parkourlrc/pcb-yilv1982--duck-robot-89dbc81d6d/docs/schematics/README.md

# 已确认硬件原理图档案

> **2026-10-31 IMU 更新**：新制 v0.3 双口板已上线；AP2210 推荐输入上限 13.2V、绝对最大 15V，旧“只能 5V”说明已纠正。原厂手册、BOM 与 5V/7.4V 现象分析见[专题](../references/惯性单元输入电压复核/research.md)。

存放本项目在手硬件的原理图/设计源文件；**实物修订已对应与仅有同源参考须按每行依据区分**。每块板一个子目录，来源与版本钉死在上游提交。查证分析记录另见 `docs/references/`（那里保留研究过程，这里只放权威文件副本）。

| 子目录 | 硬件 | 确认依据 | 权威文件 | 上游来源与版本 |
|---|---|---|---|---|
| `imu-to-dxl-scrapmeta-v0.3/` | 绿色 IMU 板（imu_to_dxl v0.3，32×22mm，STM32G031F8P6 + LSM6DSV16X） | 2026-10-09 用户确认对应 [ScrapMeta/microduck-diy](https://github.com/ScrapMeta/microduck-diy/tree/main/imu_to_dxl) | `*.eprj2`（嘉立创EDA专业版工程，真源） | `main @ aa4c32d`（hardware/ 最后改动，2026-09-10）；MIT |
| `microduck-hat-v1.0-sch/` | 白色鸭图案 HAT（实物丝印 **V1.2**，2026-10-10 照片更正；Radxa Zero / Pi Zero 形态） | 2026-10-09 用户供图并确认 | `SCH_..._2026-10-06.pdf`（5 页原理图，图版本 **V1.0**） | 社区改绘版（嘉立创EDA，原理图 V1.0，2026-09-03~09-20）；派生自官方 pollen-robotics/elec_RPI_Robot_HAT（Apache-2.0）。⚠️ V1.2 与 V1.0 未逐网对应（背面 MCU 类器件未对应，超级电容说法已撤回）；[10-27 共总线分析](../references/扩展板双口惯性缺答复核/research.md)核到 DATA 串阻 1 kΩ 对比官方 150 Ω，实装待核 |

**上游设计资料已取得、实物修订对应仍待核的硬件**：

| 硬件 | 来源与边界 |
|---|---|
| [Pollen HAT C1 / D1 PCB 参考](pollen-hat-pcb-reference/README.md) | 2026-10-27 沿用户提供的 ScrapMeta 地址取得：其文档锁定官方 C1 `88d51fa`，已下载 KiCad PCB/工程/原理图、PCB PDF、Gerber、BOM/POS；另有 D1 `6de8628` PCB/装配图。**都未核准对应白色鸭图案 V1.2**；官方 R33=150Ω 不能直接映射实物。 |
| [kissqy HAT REVA 工程](kissqy-hat-reva-reference/README.md) | **2026-11-02用户确认本机HAT/IMU来源**；实物EH2.5/AMP2.0版仍待核。11-04已取得上游411878f当前工程，TH1改0Ω、U6改C23654，旧发布BOM未同步；[元件/成本与版本核查](../references/自主扩展板与社区版成本比较/research.md)。旧旁路定位图仅对应存档版本，不能据新远端修改推定实物。 |
| jyg9 / community-kit 单 3P GD32 IMU（10-31 已下线，旧故障存档） | 本地只读参考目录已有[KiCad 工程](../../references/microduck-community-kit/hardware/imu_to_dxl/imu_to_dxl.kicad_pro)、[PCB 布局](../../references/microduck-community-kit/hardware/imu_to_dxl/imu_to_dxl.kicad_pcb)、[原理图](../../references/microduck-community-kit/hardware/imu_to_dxl/imu_to_dxl.kicad_sch)。KiCad 9，布局标 `imu2dxl 0.2 / 2026/9/27`；2026-10-26 上游 API 亦确认文件存在，但当前上游 blob 与本地快照不同，未同步覆盖。实物修订尚未逐网核对，来源、指纹及生产文件入口见[记录](../references/惯性单元三版来源对比/research.md#single-port-pcb-20261026)。 |
| 微雪 Waveshare Bus Servo Adapter (A)，实物丝印 v1.1 | 2026-10-25 从官方 Wiki 取得[含 CH343P/USB 的单页原理图](../references/舵机网页工具惯性显示/waveshare-bus-servo-adapter-a-schematic-20261025.pdf)；图中未标版本号，不能宣称已与实物逐件对应。供电网络核对、SHA256 及旧无 USB 图的区别见[供电研究](../references/舵机网页工具惯性显示/research.md#waveshare-usb-20261025)。更正此前“无公开原理图”的记录。 |

**尚未取得原理图的到位硬件**（只留定位信息）：

| 硬件 | 说明 |
|---|---|
| 黑色降压模块（XT60，丝印 7.2-16V） | 通用商品模块，无公开原理图；用前实测输入下限/输出（见 PROGRESS 待办） |

> 同源参考：fanhao375 replica 的 imu_to_dxl 原理图 PDF（STM32G031 同引脚布局的另一块板）在参考库 `references/microduck-replica/hardware/imu_to_dxl/imu_to_dxl-原理图.pdf`，可作对照，但**不是本档案板的图**。
