parkourlrc/pcb-yilv1982--duck-robot-89dbc81d6d/docs/references/README.md

# 调研专题索引

本目录是**证据库**，不是教程。共 70 个专题（61 个现行、9 个归档），另有 1 份参考库导入记录。
先读本页的「说明」，再打开专题的 `research.md`；正文保留原始证据、勘误与未收口项。

- **现行**：结论仍可作为当前依据，引用前仍要看日期与勘误。
- **未收口**：问题没有最终结论，原文保留证据与下一步。
- **讨论稿**：流程或设计建议尚未确认，不代表已经实现或验收。
- **归档**：已被后续报告取代，只作历史追溯，不用于接线、下单或当前结论。

> **2026-11-05 起，自主扩展板线路已暂停**；扩展板设计/制造类专题保留为证据，不代表仍在推进。

旧目录名见[目录改名对照](目录改名对照.md)（2026-11-05 改名）。

## 扩展板设计与制造

| 专题 | 说明 | 状态 | 更新 | 体积 |
|---|---|---|---|---|
| [自主扩展板阶段复盘](自主扩展板阶段复盘/research.md) | 自主HAT阶段复盘与通用研发流程提炼 | 现行 | 2026-11-05 | 14 KB |
| [扩展板全现货改版](扩展板全现货改版/research.md) | 自主HAT：嘉立创全现货改版调研 | 现行 | 2026-11-04 | 2.1 MB |
| [扩展板乙版降本](扩展板乙版降本/research.md) | 自主HAT Rev B.0：降本实施记录 | 现行 | 2026-11-04 | 129 MB |
| [两套扩展板订单与报价](两套扩展板订单与报价/research.md) | 两套HAT各5片含贴片：订单与报价进度 | 现行 | 2026-11-04 | 2.9 MB |
| [社区作者仓库完整核查](社区作者仓库完整核查/research.md) | kissqy完整仓库：头部IMU与HAT版本核查 | 现行 | 2026-11-04 | 747 KB |
| [自主扩展板与社区版成本比较](自主扩展板与社区版成本比较/research.md) | 自主HAT与kissqy HAT元件及成本比较 | 现行 | 2026-11-04 | 4.4 MB |
| [自主扩展板下单记录](自主扩展板下单记录/research.md) | 自主HAT：5块含贴片下单执行 | 现行 | 2026-11-03 | 13.7 MB |
| [扩展板邮票孔与电源修复](扩展板邮票孔与电源修复/research.md) | HAT：邮票孔、BMI088电源支路与双联规则继承修复 | 现行 | 2026-11-02 | 10.8 MB |
| [扩展板嘉立创询价](扩展板嘉立创询价/research.md) | HAT A.1 嘉立创询评提交记录 | 现行 | 2026-10-31 | 161 KB |
| [扩展板电路仿真工具](扩展板电路仿真工具/research.md) | HAT 仿真工具选择与 ngspice 下载 | 现行 | 2026-10-29 | 419 MB |
| [扩展板设计来源盘点](扩展板设计来源盘点/research.md) | HAT 设计盘点与首版需求依据 | 现行 | 2026-10-28 | 11 KB |
| [自主设计扩展板流程](自主设计扩展板流程/research.md) | 自设计 HAT → 嘉立创制板流程 | 现行 | 2026-10-28 | 6 KB |
| [扩展板焊盘脱落修复](扩展板焊盘脱落修复/research.md) | HAT R31 拆除后两侧焊盘脱落：修复分支 | 未收口 | 2026-10-27 | 129 KB |
| [扩展板双口惯性缺答复核](扩展板双口惯性缺答复核/research.md) | HAT 双 3P 口接入舵机后 IMU 缺答：原理图复核 | 未收口 | 2026-10-27 | 45.0 MB |
| [扩展板舵机总线排障](扩展板舵机总线排障/research.md) | HAT→舵机总线联调排障（2026-10-16/17） | 现行 | 2026-10-16 | 6 KB |
| [白色扩展板原理图查证](白色扩展板原理图查证/research.md) | Microduck-Hat-for-Radxa-Zero 原理图查证记录 | 现行 | 2026-10-06 | 883 KB |

## 电源 / 惯性 / 总线

| 专题 | 说明 | 状态 | 更新 | 体积 |
|---|---|---|---|---|
| [瞬态电压电流测量](瞬态电压电流测量/research.md) | 激烈运动时的瞬态电压/电流测量方案（2026-11-02） | 现行 | 2026-11-02 | 8 KB |
| [惯性单元输入电压复核](惯性单元输入电压复核/research.md) | IMU v0.3：7.4V 正常、两路 5V 接法失败的电气复核 | 现行 | 2026-10-31 | 10.2 MB |
| [单口惯性单元五伏供电](单口惯性单元五伏供电/research.md) | jyg9 imu_to_dxl（板②）BOM/原理图电源分析——5V 供电可否 | 现行 | 2026-10-26 | 24 KB |
| [惯性单元固件代码分析](惯性单元固件代码分析/research.md) | imu_to_dxl 固件 v1 代码分析 | 现行 | 2026-10-26 | 28 KB |
| [社区惯性单元通讯核查](社区惯性单元通讯核查/research.md) | Microduck 复刻项目 IMU 通讯故障与修复记录核查 | 现行 | 2026-10-26 | 3.6 MB |
| [惯性单元嘉立创下单](惯性单元嘉立创下单/research.md) | 双口 IMU 板（imu_to_dxl v0.3）嘉立创开板下单调研（2026-10-25） | 现行 | 2026-10-25 | 12 KB |
| [总线风暴与惯性闪断](总线风暴与惯性闪断/research.md) | 总线风暴与 IMU 闪断排查（2026-10-25，硬件根因未隔离） | 未收口 | 2026-10-25 | 23 KB |
| [舵机堵转烧板风险](舵机堵转烧板风险/research.md) | 问题是否存在：舵机堵转过流会烧 HAT 吗？ | 现行 | 2026-10-10 | 19 KB |
| [供电与扩展板实物复核](供电与扩展板实物复核/research.md) | 当前供电与 HAT V1.2 实物复核 | 现行 | 2026-10-10 | 18 KB |
| [配电与保护方案对比](配电与保护方案对比/research.md) | EH 接口与其他方案的配电/保护对照 | 现行 | 2026-10-10 | 27 KB |
| [惯性单元三版来源对比](惯性单元三版来源对比/research.md) | imu_to_dxl 三版来源对比查证记录 | 现行 | 2026-10-09 | 46 KB |
| [电池取电结构查证](电池取电结构查证/research.md) | Microduck NP-F550 取电结构：GitHub 查证记录 | 现行 | 2026-10-08 | 173 KB |

## 整机 / 舵机 / 软件适配

| 专题 | 说明 | 状态 | 更新 | 体积 |
|---|---|---|---|---|
| [众灵总线舵机替代评估](众灵总线舵机替代评估/research.md) | 众灵 10kg 总线舵机能否替代飞特 HD-1910-C001（2026-11-06） | 现行 | 2026-11-06 | 8 KB |
| [舵机编号对齐上游](舵机编号对齐上游/research.md) | 舵机 ID 对齐上游 microduck_feetech（EEPROM 改号 + 软件层回退，2026-10-24） | 现行 | 2026-10-24 | 13 KB |
| [舵机网页工具惯性显示](舵机网页工具惯性显示/research.md) | servo-web 3D 里 IMU 无表现的原因核查（2026-10-24） | 未收口 | 2026-10-24 | 7.7 MB |
| [舵机网页工具校准下垂](舵机网页工具校准下垂/research.md) | servo-web CAL 后读数不是 2048 的问题诊断（2026-10-23） | 现行 | 2026-10-23 | 9 KB |
| [舵机网页工具关节映射](舵机网页工具关节映射/research.md) | servo-web 数据来源与关节映射核查（2026-10-22） | 现行 | 2026-10-22 | 24 KB |
| [整机装配与中位校准](整机装配与中位校准/research.md) | 机械装配与中位校准调研（2026-10-17；2026-10-20 复核） | 现行 | 2026-10-17 | 347 KB |

## 训练 / 仿真

训练相关的 5 个专题（本机训练环境、自主训练平台、强化学习训练流程拆解、动作训练软件研究、真机训练与仿真迁移）已于 2026-11-10 迁至 [duck-robot-training](https://gitee.com/yilv1982/duck-robot-training/tree/main/docs/references)。

| 专题 | 说明 | 状态 | 更新 | 体积 |
|---|---|---|---|---|
| [飞特策略模型上机核对](飞特策略模型上机核对/research.md) | 飞特已训练模型盘点与上机核对 | 现行 | 2026-10-24 | 62.9 MB |
| [物理仿真查看工具优化](物理仿真查看工具优化/research.md) | MuJoCo 实时查看工具优化：实施记录与原方案 | 现行 | 2026-10-21 | 554 KB |
| [乐鑫芯片跑多层感知机](乐鑫芯片跑多层感知机/research.md) | ESP32 能否跑 microduck 的 MLP 策略 | 现行 | 2026-10-14 | 7 KB |
| [运行时策略模型调研](运行时策略模型调研/research.md) | runtime 策略模型调研：是不是 MLP、和 VLA 有什么区别 | 现行 | 2026-10-13 | 7 KB |

## 环境 / 工具 / 流程

| 专题 | 说明 | 状态 | 更新 | 体积 |
|---|---|---|---|---|
| [项目目录结构治理](项目目录结构治理/research.md) | 项目目录结构分析与治理建议 | 现行 | 2026-11-05 | 11 KB |
| [全量提交与托管同步](全量提交与托管同步/research.md) | 2026-11-02 全量提交与 Gitee 同步检查 | 现行 | 2026-11-02 | 4 KB |
| [代码编辑器安装记录](代码编辑器安装记录/research.md) | Windows VS Code 安装记录 | 现行 | 2026-11-01 | 3 KB |
| [电路设计工具智能插件](电路设计工具智能插件/research.md) | KiCad PCB 设计 Agent Skill / MCP 调研 | 现行 | 2026-10-30 | 19 KB |
| [串口桥接瑞莎调试口](串口桥接瑞莎调试口/research.md) | FT232H 转接板 ↔ Radxa Zero 3W 串口接线与使用（2026-10-16） | 现行 | 2026-10-16 | 7 KB |
| [调试器连接故障定性](调试器连接故障定性/research.md) | DAPLink（克隆）"总连不上"故障定性（2026-10-14） | 现行 | 2026-10-14 | 8 KB |
| [两款瑞莎开发板对比](两款瑞莎开发板对比/research.md) | Radxa Cubie A7Z 与 Zero 3W 对比调研 | 现行 | 2026-10-14 | 3 KB |
| [两种串口桥芯片区别](两种串口桥芯片区别/research.md) | FT232H 与 FT232RL 区别调研（2026-10-14） | 现行 | 2026-10-14 | 7 KB |
| [瑞莎开发板软件环境](瑞莎开发板软件环境/research.md) | Radxa Zero 3 机器人软件环境核查（2026-10-14） | 现行 | 2026-10-14 | 8 KB |
| [瑞莎开发板系统镜像](瑞莎开发板系统镜像/research.md) | Radxa Zero 3 系统镜像核查（2026-10-14） | 现行 | 2026-10-14 | 2 KB |
| [智能终端运行时升级](智能终端运行时升级/research.md) | DSH 运行时更新：0.1.6-alpha.1 → 0.2.1-alpha.2（2026-10-14） | 现行 | 2026-10-14 | 7 KB |
| [瑞莎开发板存储卡烧录](瑞莎开发板存储卡烧录/research.md) | Radxa Zero 3W 系统烧录记录（2026-10-13） | 现行 | 2026-10-13 | 5 KB |
| [瑞莎开发板存储线刷](瑞莎开发板存储线刷/research.md) | Radxa Zero 3W eMMC 线刷记录（路线 A，2026-10-13） | 现行 | 2026-10-13 | 90 KB |
| [进展与计划复核](进展与计划复核/research.md) | 进展与计划复核（2026-10-12） | 现行 | 2026-10-12 | 6 KB |
| [上游参考资料目录整理](上游参考资料目录整理/research.md) | 上游参考资料目录整理 | 现行 | 2026-10-10 | 5 KB |
| [雷蛇八岐大蛇V2无线连接](雷蛇八岐大蛇V2无线连接/research.md) | Orochi V2 双模：蓝牙不占 USB 口、2.4G 才需接收器 | 现行 | 2026-11-09 | 3.5 KB |

## 外部调研 / 采购

| 专题 | 说明 | 状态 | 更新 | 体积 |
|---|---|---|---|---|
| [端子压接采购调研](端子压接采购调研/research.md) | EH 压接端子采购调研（2026-10-12） | 现行 | 2026-10-12 | 7 KB |
| [消费电子玩具市场研究](消费电子玩具市场研究/research.md) | 全球消费电子玩具：行业中立商业机会研究 | 现行 | 2026-10-10 | 4.9 MB |

## 归档

已被后续报告取代，只作历史追溯。

| 专题 | 说明 | 状态 | 更新 | 体积 |
|---|---|---|---|---|
| [归档扩展板钢网分窗审查](归档扩展板钢网分窗审查/research.md) | HAT：U301分窗设计、制造规格选择及双联审查包 | 归档 | 2026-11-02 | 9.5 MB |
| [归档扩展板钢网与裸露焊盘](归档扩展板钢网与裸露焊盘/research.md) | HAT：TI裸露焊盘/钢网核对与印刷几何检查 | 归档 | 2026-11-02 | 20.0 MB |
| [归档扩展板机械适配复核](归档扩展板机械适配复核/research.md) | HAT机械适配：官方参考CAD、J301朝向修复和板间距 | 归档 | 2026-11-02 | 84.6 MB |
| [归档扩展板极性与装配资料](归档扩展板极性与装配资料/research.md) | HAT：极性标记完成与原厂装配资料补齐 | 归档 | 2026-11-02 | 14.6 MB |
| [归档扩展板嘉立创规则自查](归档扩展板嘉立创规则自查/research.md) | 嘉立创国内规则自查与HAT制造问题勘误 | 归档 | 2026-11-02 | 4.1 MB |
| [归档扩展板热焊盘回写](归档扩展板热焊盘回写/research.md) | HAT 22个热焊盘修复正式回写 | 归档 | 2026-11-02 | 6.0 MB |
| [归档扩展板贴片规范复查](归档扩展板贴片规范复查/research.md) | HAT：SMT规范复查、双联拼板及工艺修复 | 归档 | 2026-11-02 | 16.4 MB |
| [归档扩展板贴片与层叠复核](归档扩展板贴片与层叠复核/research.md) | HAT：剩余热焊盘、物料工艺与层叠复核 | 归档 | 2026-11-02 | 14.8 MB |
| [归档扩展板音频芯片焊盘](归档扩展板音频芯片焊盘/research.md) | U701.7焊接面铜盘收敛与正式回写 | 归档 | 2026-11-02 | 11.7 MB |

## 参考库导入记录

- [microduck-replica-import.json](microduck-replica-import.json) — 固定上游提交、哈希与迁移记录（2026-09-28；116 KB）。

---
维护：目录名用纯中文、不加日期；新增专题时在对应分类加一行，日期写入 research.md 与「更新」列；归档专题放进「归档」表；改名时同步更新本页与《目录改名对照》。
