parkourlrc/pcb-yilv1982--duck-robot-89dbc81d6d/docs/schematics/microduck-hat-v1.0-sch/README.md

# Microduck-Hat-for-Radxa-Zero — 原理图存档（图版本 V1.0）

- **实物**：白色鸭图案 HAT，PCB 丝印 **V1.2**（2026-10-10 照片更正，此前误记 V1.1；正反面照片与元件标注见 `../../photos/`，hat-v1.2-*.jpg）
- **原理图**：`SCH_Microduck-Hat-for-Radxa-Zero_2026-10-06.pdf`（5 页，2026-10-06 导出，图版本 **V1.0**——**与实物 V1.2 图物差异大**：背面 MCU 类器件未在旧图对应；正面圆柱件标记 10/50V，旧“超级电容”误判已撤回，接线/上电前须向板卡来源索取 V1.2 图或改动说明）
- 结构：官方 RPI Robot HAT 的嘉立创EDA 派生版（Radxa Zero 3W 适配 + 新增 BNO085）；逐页分析见 `../../references/白色扩展板原理图查证/research.md`

- **2026-10-27 DATA 复核**：V1.0 两口共用 R31=1 kΩ/F1 的 DATA 路径；官方图对应 R33=150 Ω。V1.2 实装未核，详见[原理图对比与缺答分析](../../references/扩展板双口惯性缺答复核/research.md)。

- **2026-10-27 PCB 检索**：沿用户提供的 ScrapMeta 地址取得其文档引用的[官方 C1 PCB 工程、Gerber 与 BOM](../pollen-hat-pcb-reference/README.md)，固定 `88d51fa`。**当时尚未找到这块白色 V1.2 的专用工程。**
- **2026-11-02 用户确认来源**：本机在用的 HAT 与 IMU 均来自 [kissqy/Microduck-kissqy hardware](https://github.com/kissqy/Microduck-kissqy/tree/main/hardware)（HAT REVA，10-07 EH2.5 / 10-15 AMP2.0 两版，实物版本待核）。因此本目录的 V1.0 PDF **不是当前板的图纸**，只能作拓扑参考，不能用于针序/供电判断；见[kissqy 参考工程](../kissqy-hat-reva-reference/README.md)。
