parkourlrc/pcb-yilv1982--duck-robot-89dbc81d6d/hardware/custom_hat/panels/README.md

# HAT 制造拼板工作区

2026-11-03当前86654c03，[r18](a1-smt-2up-20261102-r18/README.md)。新增BMI088 0.5mm/0.2mm F.Cu电源支路；邮票孔居中、X108/160分板带局部退铜；修复第二单元Power映射。原生主板/拼板全0，两个0.175mm探针均被Power0.2规则拒绝。旧r1～r17退出制造入口；实际工艺/制造/完整机械与首板未验。见[证据](../../../docs/references/扩展板邮票孔与电源修复/research.md)。

**旧r1～r17及其制造副本均不作当前制造依据**。第二单元Power映射不足，原DRC0不能说明规则等价；旧r14完整PCBA ZIP保留历史，不覆写。旧单板资料按源SHA审查，无B2错误。

所有文件均是制造准备/候选，不授权下单或上电。源板未解决的问题不会因为复制进拼板而消失。
