parkourlrc/pcb-yilv1982--duck-robot-89dbc81d6d/hardware/custom_hat/panels/a1-smt-2up-20261102-r12/README.md

# HAT A.1同源双联r12

> **2026-11-03撤出现行，仅历史。** 此拼板缺第二单元Power类别映射；旧DRC0不代表规则完整。使用[r18](../a1-smt-2up-20261102-r18/README.md)并见[勘误](../../../../docs/references/扩展板邮票孔与电源修复/research.md)，本目录及派生文件不再用于制造。

2026-11-02，源9daf71d88e45a442966ac42eb058be4cbe444ffce6327bc2b79c6cdb19b470b5。J301改为B面后焊，针孔/针网/铜不变，丝印注明1:2S+、2:GND；不可复用旧r11装配面。

85×82mm、8mm边、R2角、双面PFID、4定位孔和40邮票孔。原生DRC0/未连接0，原焊盘/线网、单元隔离、逐层via和位号实际绘制样式核查通过。

实际SMT准备副本为[fabrication-candidate-bmi81-mechanical](fabrication-candidate-bmi81-mechanical/manifest.json)：116拟装/104SMT/12THT/12POFV，BMI08832开口81%，C307/B2_C307 DNP/无Paste。附材料矩阵和工序说明；J301/B2_J301为B面THT，两面SMT结束后装。

用户尚未锁高度；参考名义11.6～13.33mm板间距筛查不含公差/线束/头壳，不作为实装通过或隔离柱采购值。来源与剩余项见[报告](../../../../docs/references/归档扩展板机械适配复核/research.md)。未制造放行。
