parkourlrc/pcb-yilv1982--duck-robot-89dbc81d6d/hardware/custom_hat/panels/a1-smt-2up-20261102-r14/README.md

# HAT A.1同源双联r14

> **2026-11-03勘误／仅历史阶段：** 当前源86654c03/r18见[现行报告](../../../../docs/references/扩展板邮票孔与电源修复/research.md)。旧r1～r17拼板漏继承第二单元Power规则，旧“DRC0/完整复制”不作现行交付依据；旧r14 PCBA包已撤出，原件保留。下文源版本、待办与检查仅指当时阶段。U301设计选择已定，主单板本身不含B2规则问题。

源b610f1dcd136f6266f21e1568da76f2457573475137de31431d06c72c5eafc3a，拼板SHA256：5a39680007cab13338a7751e92153bfe9f702d3d8c832817ba34165b114ceb69。

85×82mm/8mm边/双面PFID、4定位孔/40邮票孔；J301/B2_J301仍B面后焊。原生DRC0/未连接0，原连接/隔离/逐层via/位号样式复制通过。

[制造副本](fabrication-candidate-bmi81-buck4/manifest.json)保留104SMT/12THT/12POFV；U301四窗69.63%、U701四窗、U702十六窗、BMI08832开口81%，C307/B2_C307不装无Paste。全双联402个Paste flash，名义钢网0.125mm，几何比值筛查通过。

[完整双联PCBA审查包](../../release-review/HAT-A1-JLC-PCBA-b610f1dcd136-20261102.zip)另含12THT/116全坐标、含DNP的全位号映射、清晰源单元装配图及制造规格。材料矩阵按单板列，BOM按双联；不混淆数量。

未制造放行，U301方案为项目工艺选择，实际焊接/供料/工厂接受/完整机械和首板未验。来源与边界见[本轮报告](../../../../docs/references/归档扩展板钢网分窗审查/research.md)。
