parkourlrc/pcb-yilv1982--duck-robot-89dbc81d6d/hardware/custom_hat/panels/a1-smt-2up-20261102-r7/README.md

# HAT A.1 当前双联制造候选 r7

> **2026-11-03撤出现行，仅历史。** 此拼板缺第二单元Power类别映射；旧DRC0不代表规则完整。使用[r18](../a1-smt-2up-20261102-r18/README.md)并见[勘误](../../../../docs/references/扩展板邮票孔与电源修复/research.md)，本目录及派生文件不再用于制造。

主板源`3b1d903c776ec0975a15524962775c9ae288800421b583ea9c7e7ae0e592f145`。85×82mm，8mm边、R2角、四个2mm定位孔、双面各3不对称Mark、8组0.6mm邮票孔。原生DRC0、未连接0；两单元原焊盘/走线/连接和逐层via直径复制通过，单元之间无电气串接。

使用`fabrication-candidate-bmi81-final-r2/`：RS-274-X、PTH/NPTH、116拟装件BOM、104SMT坐标、12THT、12POFV与单位映射。C307/B2_C307不装；BMI08832开口面积81%；U701两单元B面via铜盘0.25mm、其它层0.35mm，孔0.15mm，CSV逐层记录且要求填孔盖铜。此前导出子目录为历史，不能混用说明或钢网。

**候选未制造放行。** C305/C310热平衡、全部物料/极性/层叠及实物功能仍未完成。每单元6通孔件双面回流后后焊；MEMS清洗/二次回流限制见[工艺说明](ASSEMBLY-NOTES.txt)。不可因DRC0直接下单或宣称实测通过。

[完整修复与验证](../../../../docs/references/归档扩展板音频芯片焊盘/research.md)；主板变化后须重生成并核同源关系。r5/r6对应旧源，不能当本版。
