parkourlrc/pcb-yilv1982--duck-robot-89dbc81d6d/hardware/custom_hat/release-review/HAT-A1-JLC-RS274X-0263ba2110ca-20261102-smt/README.md

# HAT A.1：两电容热连接及极性补标版

源SHA256：0263ba2110caf0b65c01bbe57da508f84549e9c0c64422bdc816ba0851697347。单板65×30mm，四层，标称1.6mm；这是制造准备资料，尚未放行。

C305移至F面(138.5,108.5)mm，C310移至B面(147.32,112.65)mm；两地焊盘0.25mm热连接臂、0.2mm间隙，原22项保持。仅修改两RESET段端点并新增一条9.18768mm、1.2mm宽的C305供电支路。U301补“1”、D301补“K”；其余极性推荐尺寸仍有细化空间。

层叠设计参考官方JLC041611-7628：外铜35µm、内铜30µm；两层PP各0.203mm，芯介质1.030mm，结构合计1.566mm，官网标成品1.57mm±10%。这是公开结构选型基线，不代表实际接单或实测。Dk/Df未取得，PCB默认Gerber Job不作为此结构的厂家确认。

U701.7贯通孔0.15mm，F/In1/In2铜盘0.35mm，B铜盘0.25mm；焊接面名义环宽0.05mm，处公开最小组合。U301五个热孔与U701.7共6处必须填孔并电镀盖帽，不用普通盖油代替。PTH159/NPTH4，逐孔CSV列明坐标和各层铜盘。

58拟装件，52SMT、6THT；C307不装且无锡膏。该单板包的BMI088原生Paste仍100%，实际SMT候选使用同源双联r8的81%开口制造副本。底面装配图镜像，坐标、Gerber和钻孔不再镜像。

U702精确料号为75支管装，需匹配送料方式；U701与U702均MSL2，不能统一当MSL1。具体35个MPN工艺依据及缺口见material-process-matrix.csv。尚无整板回流实测曲线、来料批次或新板实物，不下单、不付款、不上电。
