parkourlrc/pcb-yilv1982--duck-robot-89dbc81d6d/hardware/custom_hat/release-review/HAT-A1-JLC-RS274X-153bd0dbb225-20261102-smt-final/README.md

# HAT A.1：153bd0db最后C310修正版

PCB SHA256：153bd0dbb225da81893b6ed492aec6e907bc77ac9cd045918129621ae76d7495。65×30mm、四层、标称1.6mm。仅制造准备，尚未放行。

C305为F面(138.5,108.5)mm，C310为B面(147.6,114.4)mm；24个地焊盘采用热连接，原连接和I2S参考铜保持。U301新增1脚文字，D301新增K。0263ba21/r8中间版存在C310吸锡风险，已经撤出候选，不混用。

层叠设计参考JLC041611-7628：外铜35µm、内铜30µm，两PP各0.203mm，芯介质1.030mm；结构1.566mm，官网标成品1.57mm±10%。未接单，无成品测量，Dk/Df未知；默认Gerber Job不作已确认层叠。

U701.7孔0.15mm，F/In1/In2铜盘0.35mm、B铜盘0.25mm；B面名义环宽0.05mm为公开极限。U301五个热孔与U701.7共6处填孔并电镀盖帽，不能用普通盖油替代。159PTH+4NPTH，逐孔CSV含各层铜盘尺寸。

58拟装件：52SMT、6THT；C307不装且不印锡膏。单板原始BMI088开口仍100%；实际SMT准备用同源双联r9的81%开口副本。双联116拟装件、104SMT、12THT及12处填孔盖铜。

U702为75支管装，需管料送料/转托盘/人工贴装；U701/U702为MSL2、260C分类，按实物标签管理。各MPN完整回流窗口及整板曲线尚有未核项。6个THT每单元后焊；底面装配图镜像，原生坐标/Gerber/钻孔不再次镜像。

没有新板实物，尚有极性尺寸、材料曲线、实际层叠及实装验收事项。不据此下单、付款或上电。
