parkourlrc/pcb-yilv1982--duck-robot-89dbc81d6d/hardware/custom_hat/release-review/HAT-A1-JLC-RS274X-3b1d903c776e-20261102-padstack/README.md

# HAT A.1 当前分层via铜盘版：RS-274-X准备资料

PCB SHA256：3b1d903c776ec0975a15524962775c9ae288800421b583ea9c7e7ae0e592f145。65×30mm、四层、标称1.6mm；内外层1oz为准备意向，实际层叠未锁定。此包尚未制造放行。

U701.7仍为0.15mm机械贯通孔并要求填孔盖铜；F/In1/In2铜盘0.35mm，B面铜盘0.25mm，B面名义环宽0.05mm。原QFN焊接land0.875×0.25mm不变，B面via盘在其内部。其它99via规则不降。逐孔CSV新增各层铜盘列，必须按文件而不是全层统一0.35mm理解。

6处填孔盖铜：U301五个热孔+U701.7；树脂/铜浆填孔且电镀盖帽，普通盖油不替代。独立PTH/NPTH钻孔159/4。22个地焊盘已改0.25mm热连接臂，C305/C310尚直接接铜。

58拟装件（52SMT+6THT），C307不装且不印锡膏。此单板原生Paste未缩BMI088，最终SMT请用同源拼板的81%开口制造副本。底面装配图镜像，CPL/Gerber/钻孔不再次镜像。

当前局部规则/原连接/参考铜检查通过不代表完整装配、材料或实际功能通过。不得混用旧源包，不直接下单、付款或安排生产。
