parkourlrc/pcb-yilv1982--duck-robot-89dbc81d6d/hardware/custom_hat/release-review/HAT-A1-JLC-RS274X-4440b22f542e-20261102-stencil/README.md

# HAT A.1：4440b22f TI中央land/钢网版

源4440b22f542e3af735c1a8d0ffcd272cac5cb8e9fdb9d668ff0c7cd77c589149。65×30mm四层、标称1.6mm，未制造放行。

U701 EP3.45mm/R0.05，四个1.49mm窗；U702按TI示例十六窗、取消可选中间脚Paste。原针网/走线保持；J301为B面插接，B面40P孔在上时左端pin1，标1:2S+/2:GND。旧9daf/r12不能作当前钢网。

单板58拟装=52SMT+6THT，C307不装无Paste。单板BMI088原始100%开口不作最终SMT钢网，实际使用同源双联r13的81%副本；双联104SMT/12THT/12POFV。设计钢网基线0.125mm，实际印刷/回流未验；U301单大开口工艺仍需处理。

6POFV每单元保持，U701.7贯通孔0.15、F/In1/In2盘0.35、B盘0.25mm；159PTH/4NPTH，逐层CSV明确。官方层叠设计基线JLC041611-7628外35/内30µm，官网成品1.57mm±10%；未接单/实测，Dk/Df未知。

附材料矩阵和装配执行依据。实际供料/曲线/机械及新板功能未验，未外发/下单/付款/上电。
