parkourlrc/pcb-yilv1982--duck-robot-89dbc81d6d/hardware/custom_hat/release-review/HAT-A1-JLC-RS274X-86654c03b6c1-20261103-panel-edge/README.md

# HAT A.1：86654c03 BMI088电源支路与拼板边缘修正版

PCB SHA256：86654c03b6c1c8f51f7d5a4bef469aceed2ddfc73433b3e50426940c2a23164a。单板65×30mm，四层，未制造放行。

U301保持四个1.45×1.10mm/R0.05窗，铜land覆盖69.63%；这是项目选择，不是Diodes原厂专属钢网。相对前版主板只加BMI088 0.5mm/0.2mm的同网F面支路，原线和针网不变；制造拼板额外在分板带局部退铜。U701/U702的TI中央窗口及J301 B面保持；不可混用旧r13钢网。

58拟装=52SMT+6THT，C307不装无Paste。单板BMI088原始100%不可直接作为实际钢网；使用同源双联r18的81%开口副本，104SMT/12THT/12POFV。名义钢网0.125mm，实际印刷/回流未验。

本包新增明确制造选项：FR-4四层、标称1.6mm、JLC041611-7628基线、沉金/绿色阻焊/白字、6处/单元树脂塞孔+盖铜。详见manufacturing-spec.md/JSON；不是订单接受或付款。U701.7孔0.15mm、B盘0.25/其余0.35mm保持。

J301为B面后焊，B端子视角40P孔在上时pin1在左，标1:2S+/2:GND。工艺、供料、SH应用回流、线束/机械和首板功能仍待实际条件验证。未外发/建单/付款/上电。

本次关键勘误：r18将40个邮票孔中心放在单元名义边线上，连接带中心X=108/160mm，每组5孔，孔边到孔边0.4mm。仅在分板带缩进约0.6mm清除zone铜，全部原焊盘/走线不变，孔铜/连接/I2S参考铜核查通过。两单元Power类别完整复制；旧r17及以前拼板不能作为当前合格交付。
