parkourlrc/pcb-yilv1982--duck-robot-89dbc81d6d/hardware/custom_hat/release-review/HAT-A1-JLC-RS274X-96dcce92ca42-20261102-polarity-r2/README.md

# HAT A.1：96dcce92极性标记版制造准备

PCB SHA256：96dcce92ca42bbfcee423ef8590e3e1318c5e10c660d5d688f634b0924fa7036。65×30mm、四层，标称1.6mm。当前仅制造准备，未放行下单或上电。

18个方向器件已有明确外侧标记，IC圆点1mm（SOT-23为0.8mm）、连接器“1”高1mm、D301“K”高1.27mm。只改丝印，9个非丝印层与153bd0db源绘图一致；C305/C310、24热连接、针网和分层via不变。

U701.7贯通孔0.15mm；F/In1/In2铜盘0.35mm，B铜盘0.25mm，B面名义环宽0.05mm处公开极限。与U301五热孔合计6处填孔盖铜，普通盖油不能代替。159PTH+4NPTH，CSV列各层尺寸。

官方结构设计基线JLC041611-7628：外35µm、内30µm，两PP各0.203mm，芯介质1.030mm；结构合计1.566mm、官网成品1.57mm±10%。不是实际接单或成品测量，Dk/Df未知，默认Job不作为已确认层叠。

58拟装=52SMT+6THT，C307 DNP/无Paste。单板BMI088原始Paste100%；实际SMT准备使用r11同源双联81%开口副本，104SMT、12THT、12POFV。r10因复制文字角度失败，r8因C310吸锡风险撤出，都不用于制造。

U702为管装，U701/U702为MSL2；精确原厂工艺依据及缺口见附带物料矩阵和装配执行依据。THT后焊，MEMS不超声/干冰清洗；完整回流工艺需按实际锡膏和来料/热容量评估。底面装配图镜像，CSV/Gerber/钻孔不再次镜像。无新板实物，未外发、建单、付款。
