parkourlrc/pcb-yilv1982--duck-robot-89dbc81d6d/hardware/custom_hat/release-review/HAT-A1-JLC-RS274X-9daf71d88e45-20261102-mechanical/README.md

# HAT A.1：9daf71d8外侧电源接口版

PCB SHA256：9daf71d88e45a442966ac42eb058be4cbe444ffce6327bc2b79c6cdb19b470b5。65×30mm、四层、标称1.6mm，尚未制造放行。

**J301由F面改为B面安装**，同8个针孔/针网不变。B插接面40P孔在上时，J301针1在左端、针2向右；标签1:2S+、2:GND。F焊尾面方向相反。不可混用96dcce92/r11旧装配面。其它THT座保持F面，全部THT安排双面SMT后焊。

本轮只改J301安装面和3条丝印，四铜/双Mask/Paste/板框几何不变；24热连接、C310避孔、U701分层via以及原针网保持。159PTH+4NPTH，6处填孔盖铜；U701.7孔0.15mm，F/In1/In2盘0.35mm、B盘0.25mm。

58拟装件=52SMT+6THT，C307不装无Paste。单板BMI088原生100%开口不作实际钢网；实际SMT采用r12的81%开口副本，104SMT/12THT/12POFV。附35MPN工艺矩阵与装配执行依据。

官方层叠基线JLC041611-7628：外35/内30µm，两PP各0.203mm、芯介质1.030mm，官网成品1.57mm±10%；未接单或实测，Dk/Df未知。默认Job不作为实际层叠。

板间距尚未锁定；参考名义筛查11.6～13.33mm不含线材弯曲、公差和附件，未指定隔离柱。实际回流/保持、供料、机械与首板功能仍待验。不下单、付款或上电。
