parkourlrc/pcb-yilv1982--duck-robot-89dbc81d6d/hardware/custom_hat/release-review/HAT-A1-JLC-RS274X-b369f9fc2cfb-20261102-thermal-r2/README.md

# HAT A.1 热焊盘版：RS-274-X准备资料

日期2026-11-02，PCB SHA256 b369f9fc2cfbe7ff64dc2a4aa62fac9a6fa7a2c2f6c7bce5a0347e3479dbf738。

65×30mm、四层、标称1.6mm、内外层1oz意向；72封装、1130线段、100贯通via。单板58拟装件（52SMT+6THT），C307不装，两个F.Paste开口已去掉。22个阻容地焊盘改为0.25mm热连接臂，其余铜/针网不变。

本包为RS-274-X准备资料，独立PTH/NPTH圆孔159/4。6处填孔盖铜仍按via-process-requirements.csv逐孔要求；不能把普通盖油作为替代。底面装配图镜像，CSV/Gerber/钻孔不再次镜像。

此单板内部原生Paste尚保留BMI088的100%开口，因此不作为最终SMT钢网；符合Bosch建议的81%开口将在同源拼板制造副本中提供。实际工艺入口见项目panels/README.md。U701扇出、C305/C310热平衡及完整物料/层叠/装配验证未完成，当前不可直接投产，未上传/下单/付款。
