parkourlrc/pcb-yilv1982--duck-robot-89dbc81d6d/hardware/custom_hat/release-review/HAT-A1-JLC-RS274X-b610f1dcd136-20261102-buck4/README.md

# HAT A.1：b610f1dc U301分窗版

PCB SHA256：b610f1dcd136f6266f21e1568da76f2457573475137de31431d06c72c5eafc3a。单板65×30mm，四层，未制造放行。

U301仅Paste由单大开口改四个1.45×1.10mm/R0.05窗，铜land覆盖69.63%；这是项目选择，不是Diodes原厂专属钢网。所有铜/Mask/板框/其他Paste/原针网与走线保持。U701/U702的TI中央窗口及J301 B面保持；不可混用旧r13钢网。

58拟装=52SMT+6THT，C307不装无Paste。单板BMI088原始100%不可直接作为实际钢网；使用同源双联r14的81%开口副本，104SMT/12THT/12POFV。名义钢网0.125mm，实际印刷/回流未验。

本包新增明确制造选项：FR-4四层、标称1.6mm、JLC041611-7628基线、沉金/绿色阻焊/白字、6处/单元树脂塞孔+盖铜。详见manufacturing-spec.md/JSON；不是订单接受或付款。U701.7孔0.15mm、B盘0.25/其余0.35mm保持。

J301为B面后焊，B端子视角40P孔在上时pin1在左，标1:2S+/2:GND。工艺、供料、SH应用回流、线束/机械和首板功能仍待实际条件验证。未外发/建单/付款/上电。
