parkourlrc/pcb-yilv1982--duck-robot-89dbc81d6d/hardware/custom_hat/rev_b/quote-84362651/README.md

# Rev B.0 焊接空间调整版：5片全焊重新报价资料

**2026-11-05 自主HAT线路暂停：** [用户确认] Y10／SMT2611051346已付款，84362651版5片，等待收货。最后合并支付页金额891.79元（含运费5.50）；未另核支付回执或发货状态。停止继续降本、设计修改、订单操作及主动跟进，等待用户明确恢复；首板尚未验收，原750元目标未达成。 以下内容保留为暂停前历史记录，其中未付款及下一步指示不再作为现行操作要求。

日期：2026-11-05。PCB SHA256：`84362651a5dc57338a24f6b0d7a642267d32f4bc81888ccc2809bb129fc1bcf0`。

本包用于**重新报价及工厂审核**，不是制造放行，也未支付。全部69件（63 SMT＋6 THT）、30组BOM保持；不能沿用旧Y9的Gerber或CPL，也不能只把旧订单的间距选项改成“≥3mm”便称新布局已报价。

- [Gerber与钻孔ZIP](CUSTOM-HAT-B0-84362651-5PCS.zip)
- [BOM.csv](BOM.csv) / [CPL.csv](CPL.csv)
- [顶面装配图](../review-output/assembly-top.svg) / [底面装配图](../review-output/assembly-bottom.svg)
- [源与导出校验](quote-manifest.json)
- [布局、空间和验证报告](../../../../docs/references/扩展板乙版降本/layout-spacing/research.md)

原生ERC/DRC/未连接/原理图一致性均0。按当前Fab包络与高度类别计算，低件最紧3.31mm、高件最紧5.46mm；工厂须按实物模型、焊锡与治具核实工艺接受和费用。3mm/5mm筛查不代替热、电气、线束/母座机械及首板验收。

旧`quote-99ecc45d/`只对应旧Y9快照。新布局的完整报价、贴插费是否取消、治具费及备损/库存变化仍待确认。

本包Gerber已在2026-11-05上传，平台生成Y10，PCB初步33元、待审核未付。根据解锁后的页面记录，BOM.csv与CPL.csv均已显示；当前由用户继续核对5片全焊设置并进入物料匹配，完整新报价待取得。本目录BOM.csv及配套CPL.csv为当前Y10报价文件；详见[询价停止点及回执](../../../../docs/references/扩展板乙版降本/layout-spacing/y10-quotation-status.md)。
