parkourlrc/pcb-yilv1982--duck-robot-89dbc81d6d/hardware/custom_hat/rev_b/review-output/README.md

# Rev B.0审查输出：禁止下单或制造

此处是同源审查件，成本和制造准入尚未验收，**不是可付款/可制造交付包**。`manifest.json`记录源哈希、69个拟装件、30个归并组和检查状态。

- `gerbers/`为两层RS-274X、钻孔及当前制造层，用于DFM复查。未完成最终工厂接单和封装/丝印核准，不上传旧Y6/Y7/Y8替换文件。
- `bom-grouped.csv`按精确MPN/C编号/封装/厂商归并，功能单独列；数量为每板数量，下单数量仍5片。30组中尚有精确货号/厂商规范待复核，不代表锁料。
- `cpl-all-fitted.csv`包括63个SMT和6个THT的全部69位号；THT含底面J101母座，需工厂在SMT后插装焊接。不能把同一面SMT坐标等同于经济型接单批准。
- `schematic.pdf`为主图加8个功能页；`erc.json`、`drc.json`为原生检查报告。
- 数量、备损、最低上机数、焊接工序、税费和价格必须由新B版完整报价确认。无付款授权；自由文本备注留空。
