parkourlrc/pcb-yilv1982--duck-robot-89dbc81d6d/hardware/custom_hat/release-review/HAT-A1-CAM-review-90f270910175-status-confirmed/README.md

# HAT Rev A.1 CAM与装配评审资料（未生产放行）

设计身份：A.1；PCB SHA256：90f27091017525a22f45c8818c973c317ed6262387a98fdf06bdc26337dac2a6。
本包在本机准备，未发送；用途是制造/装配可行性评估，不是生产、采购或付款指令。

- fabrication/含同版Gerber、独立PTH/NPTH钻孔、BOM、坐标、装配图及6处POFV要求。
- 58拟装件、52 SMT、6 THT；C307 DNP，当前钢网已排除其两个开口。
- A.1 J502为1=GND、2=3V3、3=SDA、4=SCL，旧Rev A不同。工程文件名保留rev_a系列。
- 板面标识DUCK HAT A.1。底面装配图已镜像，CPL/CAM坐标不再次镜像。
- 未附不明确层叠的默认Gerber Job，也未附临时候选、旧钢网或私有本机运行路径。

请按CAM-QUESTIONS.csv逐项反馈接受、条件接受或需修改，并给出条件/理由。
尤其核0.15mm机械孔、0.1mm名义环宽、6处填孔盖铜及QFN联合land。
当前BOM按MPN给出，料源/库存/贴装服务未确认，不能默许替代器件或直接形成贴装订单。

原生规则、连通与一致性检查通过不等于制造接受或实物功能验证。
整板供电/热/并发负载、保护/线束、实际音频/I2S/TTL/IMU/ToF与装配仍待验证。
需要实物才能完成的验收在制造之后进行，不能提前标为通过。
MANIFEST.json记录包内文件SHA，仅用于身份/完整性核对。
