parkourlrc/pcb-yilv1982--duck-robot-89dbc81d6d/software/servo-web/poses/upstream-2026-09-20/README.txt

上游 servo-web 2026-09-20 的原始读数，关节名按上游 20-24=左腿。
不是本机姿态，勿发到本机舵机；留作来源记录。
