parkourlrc/pcb-yilv1982--duck-robot-89dbc81d6d/docs/power-architecture-v2.md

# 整机供电架构 v2（飞特路线，2026-10-10 更新）

> **2026-11-01 当前装机更新**：新单 3P 口 IMU 已换上，软件身份为 ft6/legacy；servo-web 混合 SYNC_READ 已通过只读验收，见[当前记录](references/飞特策略模型上机核对/restore-mixed-sync-read-20261101.md)。下文旧 GD32/v0.3 的电气、固件和故障数据只适用于所标版本，不自动套给新板；本轮未更改供电、刷写或做动作。

> **2026-10-31 历史更新**：当时为新制 v0.3 双口板，用户确认 3P 直挂 7.4V 正常。原厂 AP2210 VIN/EN 推荐上限 13.2V、绝对最大 15V，原“只能 5V”限制撤回；补充条件：DATA/GND 始终接总线；pin4 5V 使主控启动不了，DAPLink 5V 则因只接正极、未接自身 GND 而缺明确负极回路（实际间接地路径未核），两个窗口分开解释。见[原理图与参数复核](./references/惯性单元输入电压复核/research.md)。下方单口 GD32 板通信排障属于此前窗口；不要求重跑已完成的基础测试。

> **用户决定（2026-10-10）：继续按 v2 推进，先做基础测试，实际发现问题再评估调整。** 不预先增加配电板，不把理论最坏电流当作已发生的烧板问题。实物 V1.2、存档图纸 V1.0，基本针序/电源网络需先确认；路线确定不等于已通过整机上电或带载验收。
> **2026-10-26 历史实物接法**：用户确认单口 GD32 IMU 已接回 HAT 的另一个口；00:11 只读快照显示 servo-web 运行，缺答待定位，下一步 FT232H 读 H1 日志，见[计划](./references/舵机网页工具惯性显示/debug-plan-20261026.md)。微雪台架为历史窗口，独立舵机也无字节，未证明其正常。其他支路、电源入口及当前电压未完整重核，不以旧意向图代替实物；历史首版 [v1](./power-architecture-v1.md) 不再作为操作依据。

## 当前执行安排

1. **2026-10-10 的 v2 连接图是历史意向**：图中曾画电池取电/保护 → HAT A 口、B 口 → 单条舵机链 → 末端 IMU、C 排母 → Radxa。10-25 单口 IMU 移口后曾接微雪，10-26 已回 HAT 另一个口；不将口述位置直接映射为旧图 A/B。微雪只用于台架，独立稳压板不作为整机必需件。
2. **暂不新增架构任务**：dxl_hub、电子保险或独立动力支路都是备选，不因前述风险讨论自动采购或实施。
3. **问题驱动排查**：10-26 单口板换口后严重缺答是历史结果；10-31 新 v0.3 在 7.4V 下已恢复可用，两路 5V 接法失败另见顶部专题。不因此重跑已完成的基础检查或新增改造。
4. **问题驱动排查**：若发现持续限流、明显压降/重启、异常发热、动作异常，或已确认负载超过实际通路额定，停止本阶段、查明原因，再决定修线/参数/配电等措施；不以“试到烧坏”为依据。
5. **测试范围分清**：基础检查用于排除明显错误和供电/通信问题，不保证堵转、故障短路或所有步态峰值都安全；不做故意堵转/短路，不未经回读擅改保护。

## 风险判断先于配电改造（2026-10-10 补充）

**目前没有证据证明本机 HAT 会因一次短促堵转烧坏。** 舵机电流按现有图纸走电池直通接头/铜箔，不经过 5V/2A 降压输出；EH 的参考额定也不是瞬时烧毁阈值。损坏取决于总电流、持续时间、重复率及实际通路耐受，不能只用 3A 与社区 3–5A 比较作结。

更直接的待核点：HD-1910-C001 厂商规格书明确过流保护**出厂默认关闭**，描述为超阈值持续 2s 后关输出，且新位置指令可清除标志；社区回读与工具默认配置也说明不能假定过流卸载已经启用。这不是用户实物回读结果。先核实保护位/阈值/延时/运行模式及 V1.2 电流路径，暂不把加 hub 当作既定任务。详见[堵转风险核查](./references/舵机堵转烧板风险/research.md)。

## 2026-10-10 用户所述流程（历史意向，已被 2026-10-24 实物描述取代）

**当时的功能拓扑评估（2026-10-10）**：电池原电压进入 HAT 的电池网络；HAT 接舵机链和链末 IMU；HAT 背面 40P 对插主控并提供 5V 与 UART 链路。该评估针对当时的单链意向，不是对 2026-10-24 外部分叉焊点的验收结论。

当时“直接进 HAT”仅指**不经过独立稳压器**，不是省略取电连接、合适的线材/接头和保护；当时的候选接法将一个 SERVOS 口用作电源入口，不代表当前已核对电池接入位置。

## 历史意向图：拟采用的两口分工（不是当前实物图）

```
NP-F550 2S 电池（满电 8.4V；型号/能力待实测）
  │ + / −
banana_pcb 取电 → 适配线材、接头及保护（正极保险靠近电池）
  │ + / −；不接 DATA
  ▼
HAT 的 SERVOS A 口（候选入口；针序和载流待确认）
  ├─ 电池网络 → 板内降压 → 5V → 40P C 排母 → Radxa Zero 3W
  │                              同时连接 UART 等逻辑信号
  └─ SERVOS B 口 → 舵机 1 → 舵机 2 → … → 舵机 15 → IMU J1
                    共用 +BATT / GND / DATA            │
                                               U3 → 3.3V
                                               J3 留空
```

- A/B/C 是示意图编号，不是实物 CN 编号或出厂输入/输出定义。只有核验两座电源同网、针序一致及路径合格，才可交换 A/B。
- V1.0 图上 SERVOS 是 1=GND、2=+BATT、3=DATA。**本图没有根据照片指定上/下针的极性**，不同插合视角分别核清。电池两线仅接已确认的 +BATT 与 GND；DATA 留空、绝缘。
- 舵机虽物理串成菊花链，电气负载是并联、数据按 ID 寻址；末端不用返回 HAT。IMU 放末端避免其小板承载整条舵机链电流。
- 电池不能接主控 USB、HAT 40P 的 5V、IMU J2 的 3V3 或 DATA。两组 4Pin 空焊位本方案不用，不凭照片认定为备用电池入口。

## 与社区原方案的区别

上述单链是本会话针对用户流程的最小功能意向，**不是社区 C 已公布的配电路径**。社区实际 README 使用 `电池 → banana_pcb → dxl_hub → 头部/左右腿/IMU`；本轮 PCB 核对确认 hub 有独立两线 J3 电源焊盘，但未见板载保险，载流/温升报告仍缺。若 HAT 入口额定不足，优先评估独立动力配电，让 HAT 不再承担全舵机电流；**这不要求把微雪/独立稳压板装回去**。不可把普通小 3Pin 输入分线板当作已解决总入口瓶颈，详见[方案比较](./references/配电与保护方案对比/research.md)。

## 各件的角色

| 对象 | 功能与当前判断 |
|---|---|
| banana_pcb、U6068 与取电线 | 保留；只取出电池原电压，不是稳压/充电/BMS。插针、极性、绝缘及载流需验证。 |
| HAT V1.2 | 拟同时承担主控降压供电与 UART 半双工总线适配。存档 V1.0 为 AP63205 5V/2A 与 74LVC 驱动；实物对应性和可用电流需验证。2A 是芯片级额定，不保证实际板子满载可用。 |
| Radxa Zero 3W | 断电后正确对插 40P，防反向/错位；从 HAT 5V 取电。未核准 OR-ing/防倒灌前，不同时 USB 供电。 |
| HD-1910-C001 ×15 | 工作电压规格 4–8.4V，2S 直供在范围内；不是通过 HAT 5V 降压给舵机。手头型号/线序仍待核实。 |
| IMU 板②（已下线） | jyg9 GD32 社区成品版，另一套开关降压前端；不与 AP2210 参数混用，旧故障尚未唯一定位。 |
| 新制 v0.3（当前使用；旧板①损伤保留） | J1/J3 VBATT 经 AP2210K-3.3 转 3.3V；原厂推荐输入上限 13.2V，7.4V 未超限。实装料号/温升未独立复测；J2 的 3V3 不是电池入口。 |
| 微雪 Bus Servo Adapter (A) | HAT 数据链通过后不装入正常整机；保留用于单舵机设置/台架调试或另行设计的替代方案。 |
| BUS SERVO POWER SUPPLY V1.3 | 不再需要其稳压功能，可从整机删除；仅在转接方便时可选用 PWR OUT，但不能据空载测试认定其载流或保护合格。 |
| 保护、匹配充电器 | 电池过流保护须核验，但**外置主保险不预设必需**：先查电池内置 BMS/保护的短路与过流切断规格，确认能保护外部取电线束后可不另加；无或不明再评估外置保险。充电器规格也待核对；不用 HAT/USB 给 NP-F550 充电。 |

## 过流保护入口

先闭环确认电池输出的短路/过流保护：**若电池内置保护的阈值、响应和切断能力经资料核实足以保护外部取电线束，可不另加主保险；若没有或无法确认，再考虑电池正极近端串外置保险**，之后接已核准的电源入口，负极接 GND。当前收到的 NP-F550 电池品牌、准确型号及 BMS 规格尚未登记，因此暂不买保险，也不能据此认定可以无保险接入。外置保险安数、动作曲线与最弱通路尚未完成协调，不能直接指定 5A，也不能靠保险升级 3A 接头的载流。详情见[过流保护方案](./overcurrent-protection.md)与[必要性复核](./references/供电与扩展板实物复核/research.md#2026-10-12-主保险是否必要)。

## 待核风险：入口电流与持续时间

**10-24 旧接法中，HAT 单口到外部分叉的 V/G 路径承载两腿与 IMU 支路合计电流；10-25 晚 IMU 已移至第二口。** 两腿若仍沿用原公共线，该段仍承载两腿合计电流，但本次未完整核对其他线束变化。EH 约 3A 与社区“正常 3–5A”只是待核线索，不是本机实测或瞬时损坏判据；须结合实物连接器、线材和电流波形判断，本轮没有做带载验证。

HD-1910-C001 规格书 7.4V 工况：单颗静态 20mA、空载运行 ≤210mA、额定负载 900mA、堵转 2A±10%。15 颗简单相加分别为 0.30A、≤3.15A、13.5A、名义 30A；**不代表实际步态电流，也不是 8.4V 的测量值**，还未计主控。

- 若实际连接器/主入口能力不足，先换成经核准的配电或大电流输入设计；“保留独立稳压板”不自动改善最后经过的 HAT 小接头。
- 不把两个 HAT 口直接并接当作安全增流办法，也不能在 A 已作电池入口时再画成“两口各一条舵机链”。
- 主保险 5A 仅是原候选值，若最终确需外置保险，必须重新匹配最弱导线/接头、正常峰值和动作曲线；不是超过 5A 就立即断开，不能保证保护 3A 座。
- 电池 BMS 及过流阈值尚未验证，所以目前既不能声称整机已有充分保护，也不能断定一定需要另加保险。V1.0 的 F1/D3 位于数据链而非动力链，不能当电源保险；V1.2 元件及网络另核。
- 未找到 robotd 将整机限制在 5A/6A 的硬限流证据；扭矩使能/降低 Kp 不替代硬件保护。
- 同源电压跌落可能令主控/IMU 复位。6.6V 仅是沿用的待校准低电量阈值，不是电池天然最低电压；需测启动/动态压降及低电量停机。

## 接线与版本边界

1. 照片只确认两个已焊接 SERVOS 3Pin 口和背面 40P 排母；未识别出独立 BAT/VIN 座。八焊盘对应两组 4Pin 空位，网络待核；圆柱电容不能称为超级电容。
2. C001 厂商规格书写 AMP2.0-3P，而旧记录写 5264；实际系列/批次与 HAT EH 的转接线逐针核对，不靠“试插能进”判断兼容。
3. 2026-10-31 已取得 AP2210 原厂 PDF，确认 VIN/EN 推荐上限 13.2V、绝对最大 15V；3.3V 版线性调整率覆盖 4.3–13.2V。此前“手册未取得”为历史状态，“5.5V 上限”错误已撤回；仍不将芯片额定当作整板/整机全工况验收。
4. 主控 +3V3 可能反向供给 HAT 总线驱动，空 HAT 未接主控时 DATA 不必已是 3.3V；相关验证顺序见测试单。

## 验证顺序

断电确认网络/针序 → HAT 空板台架限流测 5V → 对插主控测启动及逻辑轨 → 单独 IMU 取电/刷机验收 → 单舵机通信 → 在核准额定内逐级测负载/保护。**单节点 ping 通不等于整机载流通过。**

## 版本与原始数据

- v1：历史首版，包含已撤回的 IMU 5.5V 限制与 HAT F1 位置判断，不作施工依据。
- v2 初版：改为总线原压、IMU 板载 LDO；独立稳压板退为可选。
- 2026-10-10 实物复核：入口未知时不直接要求两个口分两支；撤回八焊盘独立入口与超级电容推断。
- 2026-10-10 接线图更新：将用户提出的简化流程画为 A 进电 / B 单链+末端 IMU / C 对插主控的**条件式方案**，独立列出载流验收与 HAT 功能验收。
- 电源模块原始空载测量仍见 [buck-module-test.md](./buck-module-test.md)；这些测量与 v1 历史文件保留，不改写为整机实测。
