parkourlrc/pcb-yilv1982--duck-robot-89dbc81d6d/docs/references/扩展板邮票孔与电源修复/design-review.md

# HAT A.1 / r18 kicad-happy审查

日期：2026-11-03 +08:00；当前源86654c03，拼板fd6cd170。固定工具版本2fd9aa0fe2d620f36627d9221e8b1393987ae38e。结论：文件侧本轮修复通过；制造与实物验收未完成，不能直接下单或上电。

续查已明确6THT/单元在双面SMT及支撑切断分板后逐点手工焊接，不使用整板波峰焊或通孔再流焊；每个连接器均存在5mm内反面SMT。20261103-assembly包仅更新工序附件，13份Gerber/钻孔与先前包逐字节一致，kicad-happy最终包Gerber复审仍4项相同告警；证据见depanel-package-comparison.json、gerbers-pcba-r18-assembly.json。当前元件间距统计为27对而非早期25对，最小Fab框0.405mm；手焊/吸嘴真实可达性仍未验收。

## 覆盖与验证依据

新增实际Mask专项见[mask-review.md](mask-review.md)：642个导出开窗的几何/外扩与原生pad匹配；最小间隙0.228554mm，无异网铜或未填孔外露；12个开窗内孔与POFV清单一致。这是自动kicad-happy报告之外的原生/制造文件交叉检查，不改变其已有告警统计，也不冒充成品LDI对位或桥宽实测。

已运行schematic、PCB full、cross、EMC、thermal、单板Gerber、SPICE、schematic delta；最终PCBA Gerber另跑。前轮器件身份未变，沿用lifecycle.json的2026-10-31审计：35项全部unknown、没有可用生命周期数据源；不是35项有生命周期问题，也不是现售状态确认。原理图/PCB/cross/EMC finding集合相对b610无增删，见review-delta-summary.json；本轮布局变化见独立几何核对。

主板72封装、1132线段、100via、65×30mm，原生完整工程规则加载有效、DRC/ERC/parity/未连接/网表全0。拼板85×82mm、两单元同Power规则；逐对象/网络复制、隔离、参考铜、钻孔/坐标另核。不能依赖工具自评high代替证据分级。

原厂资料仍归档在metadata-repair、passive/footprint、mechanical、stencil、buck-stencil等专题，材料汇总见material-process-matrix.csv。自动capability_mode显示提取覆盖0、LLM deep review disabled；DS-002仍出现。资料URL字段100%不等于脚本读过原厂PDF；自动电气/热/引脚结论按一致性提示处理，只有具体人工核对项沿用对应原厂页依据。

## 告警统计与裁决

| 分析 | 原始结果 | 本轮判读 |
|---|---|---|
| schematic | 0 error / 3 warning / 41 info | DS-002为自动资料提取缺口；+5V_FB是反馈节点、SERVO_VBAT经铜跳线供电，不能以source检测缺口宣布无电源 |
| PCB full | 3 error / 15 warning / 41 info | 边缘FID/J101包络与通用边距提示不等于铜/板边违规；实际上机使用工艺边PFID，机械实装仍待验 |
| cross | 2 error / 2 warning | +3V3/+5V plane split提示不能当DC断线；原生连接与实际参考铜已核，完整高频回流仍未实测 |
| EMC | 8 error / 33 warning / 13 info，score7 | 启发式回流、换层、端口滤波、时钟位置、buck热回路提示保留，未取得EMI/波形验收 |
| thermal | 自动0告警、仅评估2件 | 默认负载得到0.028W与26.8°C不是实板功耗/温升；不作为额定或热通过 |
| SPICE | 12/12算例pass | 仅支持对应理想子电路，不覆盖完整IC控制环、回流、电源瞬态、音频或实际负载 |
| 单板Gerber | 2 warning | GR-004铜flash与Paste数量不可一比一：via/THT不印锡、DNP排除、EP窗口独立 |
| 最终PCBA Gerber | 0 error / 4 warning | 两个GR-002为各层覆盖范围差异，两个GR-004为同类铜/Paste数量提示；按原生对象和导出契约裁决 |
| lifecycle | 35 unknown | 未取得可用状态，保留采购阶段核验，不写当前库存/可采购通过 |

## 关键电路与真实剩余风险

电源路径仍为2S输入→AP64350 Buck→5V主控/负载；同一输入经R309铜跳线到舵机，Buck保护不覆盖该直通支路。+3V3从主控进入本板，LP38691提供codec1.8V。输入保护、配对线束、并发负载与5V使用判据仍按供电专题边界，不以单器件目录电流叠加整板额定。USB与HAT带电双源并供不在支持范围。

原针网/所有旧焊盘、走线及via均保持，新增BMI088 0.5mm支路只改善制造重铺条件下的明确连通。此前R308.2↔U701.7、I2C上拉、TTL/功放去耦、RESET通路、Qwiic针序等修复均保留；固定软件产物重新绑定当前PCB，未实机加载。J504低阻耳机用途未确认，不能凭假定新增功能验收或宣称已满足。

## 误报与保留项

- VS-002“无地孔”与原生17个POWER_GND孔不符，属于命名/识别局限；真实高频阻抗仍未测。
- TV-001按通用封装面积要求U701 9孔/U702 18孔，不能覆盖具体TI封装/功耗依据；U701分析器“1孔”计数不是原生EP内同网热孔，原生核对仍0。没有据该计数盲目加孔。
- DFM通用0.125mm环宽/0.2mm孔径阈值不等于国内公开最小能力。U701.7为0.15mm孔、F/内0.35与B0.25铜盘；B单边0.05处最小边界，6POFV/单元必须填孔盖铜，实际制造成品仍需验收。
- GR-002比较Edge85×82、外铜77×74和内铜64.2×61.2的范围，外层含PFID，内层不铺工艺边，尺寸不同是设计内容差异；原生各层焊盘中心与Gerber、全部370孔与Excellon另行比对，排除整体坐标偏移。此检查不等于逐多边形CAM全验收。
- GR-004最终F124/B278共402开口，与同源单板F62/B139的双倍一致；32 BMI08881%开口、U3018窗/U7018窗/U70232窗及2个DNP排除均有导出证据。几何筛查不替代印刷锡量、空洞或焊接质量。
- EMC GP/RP/IO/CK/SW/DP类全部原始记录保留。原生DC连通与4421点参考铜保持只能排除已检查几何退步，不能排除耦合/串扰/线束噪声；实际负载、走线参考和模型简化是尚未分离的因素，未当已发生故障或全误报清除。

## 装配、制造与未执行项

35MPN/58件材料矩阵、104SMT/12THT全坐标和装配面、12POFV及402Paste齐备；U30169.63%是项目选择，非Diodes认证钢网。0.125mm只是名义设计，实际厚度/孔壁/锡膏与回流条件未测。J301为B面，其余5THT为F面，全部THT后焊；B面SMT先回流、F面后回流。

未执行：自动结构化datasheet deep review；有效实时生命周期/库存审计；整板场求解、EMI/温升/波形；工厂生产稿接受、来料MSL、实际回流/SPI/空洞；完整线束/头壳试装；首板供电/I2S/音频/TTL/IMU/ToF。没有用本轮新增铜线重跑无关软件功能测试，也没有部署或上电。

本轮可交付的是有同源证据的本地审查包。仍需实际制造准备和首板条件，见remaining-actions.md；旧拼板r1～r17不恢复使用。
