parkourlrc/pcb-yilv1982--duck-robot-89dbc81d6d/docs/references/扩展板邮票孔与电源修复/requirements-status.md

# 嘉立创22项SMT规范：当前源覆盖表

2026-11-03 +08:00，当前86654c03…；原文全部已在归档扩展板嘉立创规则自查/sources归档，编号对应实际文章。**文件检查、设计选择、实际制造验收分开。** “设计侧完成”不代表工厂已执行或新板实测通过。

| 条款 | 当前事实与处置 | 剩余条件 |
|---|---|---|
| 62681工艺边 | 同源r18、85×82双联，8mm四周边、R2角、4定位孔 | 实际夹具/板翘过程验收 |
| 62691 Mark | 双面各3非对称全局点，1mm铜/2mm窗、距边4mm、3mm周边铜筛查 | 机器识别与成品质量 |
| 62703 V割 | 本拼板不用V割，采用铣槽/邮票孔 | 不套V割铜距规则 |
| 62704邮票孔 | 40个0.6mm孔居中、5孔/组、0.4mm孔边距、2mm槽；局部退铜保持原连接/参考铜。8切线距SMT Fab框最小5.32635mm，先支撑切断分板再装THT，不手掰 | 实际刀具/夹具、板弯/振动、毛刺与机械实装；距离筛查不等应变合格 |
| 62692镂空/加强 | 无单板大开窗，拼板框/桥按候选形成 | 回流平整度未实测 |
| 62705极性 | 18方向器件尺寸/避让已核，J301 B面数字明确 | 来料本体标记、贴装偏移与印字成品 |
| 62731封装一致性 | 58件35MPN有来源；TI中央land/Paste与U301项目分窗已明确 | 实际批次封装和替代料仍须对应 |
| 62694焊盘间距 | 原生不同网及封装规则保持；实际642个Mask开窗已核，最小名义间隙约0.229mm，无异网铜或未填孔外露；未套QFP/BGA到所有QFN | 实际Mask/钢网制造公差和生产稿，不以名义值担保成品 |
| 62741盘中孔 | 6处/单元POFV清单，U701焊接面盘收进land；C310新增风险已修 | 实际填孔/盖铜/平整度 |
| 62751热连接 | 24处0.25mm臂/0.2mmgap采用，原连接与I2S参考铜保持 | 焊接热平衡和良率未实测 |
| 62761机械干涉 | 59THT孔对反面SMT Fab框最小0.809mm，6个连接器均有<5mm邻近件；明确双面SMT后逐点手工焊接，禁整板波峰/通孔再流；J301朝外 | 烙铁可达性/热影响、线束/公差/附件/头壳和首板实装 |
| 62744器件间隔 | 当前86654c03重新筛查为27对低于1/3mm参考值，最小Fab框0.405mm，无<0.3mm；旧25对统计不作现行值 | 该脚本按U位号粗筛，不能代精确本体/吸嘴/返修包络；小于建议值不是已测冷焊，也非全部已接受 |
| 62771大重件 | L301在第二回流F面；THT全部后焊，不计回流悬挂重量 | 第一面U702/SH保持与必要工装须实际工艺决定 |
| 62772半孔 | 无镀铜半孔，不适用；鼠咬NPTH不是半孔 | 无新增条件 |
| 62712引脚氧化/变形 | 精确料号/供料形式已列，尚无来料 | 实际批次外观/共面度验收 |
| 62745湿敏 | U701/U702 MSL2，其余按具体原厂资料；未列不自填MSL1 | 来料标签/开封/储存/烘烤记录 |
| 62781耐温 | Diodes/TI/Bosch/Vishay/AVX/JST原件矩阵已补 | SH精确窗口或应用评估、整板实测profile |
| 62746清洗 | MEMS禁超声/干冰；电感免清洗优先，材料相容明确 | 实际助焊剂/清洗剂/干燥工艺 |
| 62801备损 | 数量未下单，BOM双联104SMT+12THT已核 | 按未来批次数量计算，不能虚构已备损 |
| 62802双面固定脚 | SMT无贯穿固定脚；6THT回流后后焊，避免顶钢网 | 尾针/成品装配检验 |
| 62811包装 | U702管装、SH顶插1500/reel等具体形式已核，不伪报全编带 | 实际送料/转托盘/短带余量及库存 |
| 62841原厂/翻新 | 设计MPN与来源保留，未采购 | 渠道、批次和实际物料真实性 |

钢网补充：U701约75%四窗、U702十六窗已按精确TI图；BMI08881%在SMT副本。0.125mm为设计基线，几何比例筛查不等SPI/回流通过。U301已选择四窗69.63%项目方案，原铜保持；未将该选择冒充Diodes专属工艺或已测良率。沉金/绿油/白字/树脂盖铜等已写为明确本地制造规格；实际工厂过程、来料与首板未完成。

具体制造选择见[规格](manufacturing-spec.md)，设计已定与真实阶段未完成分列在[剩余事项](remaining-actions.md)。

本轮勘误与规则负对照见[报告](research.md)：r1～r17拼板的第二单元Power映射不完整，已退出现行；不以旧DRC0恢复使用。两单元规则、局部填铜差异与制造包同源检查均有记录，实际过程验收仍需真实条件。
