parkourlrc/pcb-yilv1982--duck-robot-89dbc81d6d/docs/specs/20261028-custom-hat/design-plan.md

# 设计方案：KiCad 自设计 HAT 首版

> **2026-10-29 续接审计停用：下文整体为历史草案，不作现行制造、采购或上电指导。** 原需求与阶段批准保留；实施中出现电路、封装和状态偏差，现行修复步骤已另行形成。下方包含已取消的功能及旧候选，仅供追溯。 现行见 [修复方案](recovery-plan.md) 和 [审计证据](../../references/扩展板电路仿真工具/audit-20261029/review.md)。

## 历史正文（已失效）

- 日期：2026-10-28
- 状态：**方案草案，待用户批准后进入原理图阶段**。
- 范围：只产出可评审的电路/接口/机械/验证方案；本轮不画原理图、PCB，不下单，不上电。
- 需求来源：[spec](./spec.md)、[HAT 设计盘点](../../references/扩展板设计来源盘点/research.md)。

## 1. 推荐总体架构

以 Radxa ZERO 3W 的 40P 作为低速控制、音频和 SPI 的信号入口；动力舵机仍走电池电压支路，主控和逻辑由独立 5V 降压供电。**[推断/待核]** 头部 IMU 与 ToF 可候选共用一条 I2C 总线，但器件地址尚未确认；若地址冲突，再评估第二条 I2C（复用和 Linux 支持也尚未确认）或地址选择，不在未核对前并联。

**2026-10-29 变更：摄像头与屏幕已由用户决定去掉，本节保留为历史记录，不再作为实施依据。** 摄像头不通过 40P GPIO“模拟”。**[官方文档]** Radxa 官方资料显示 ZERO 3W 有一个 4-lane、22-pin、0.5 mm pitch MIPI CSI 接口，支持 OV5647、IMX219 和 Radxa Camera 8M（IMX219）。**[推断/待核]** 可候选在 HAT 上设置一个同规格 22P CSI 连接器，并用一条短的 22P FPC 将 Radxa 主板 CSI 引到 HAT，再由 HAT 的另一段可插拔 FPC 接到摄像头。该中继需要双连接器、FPC 链路、差分阻抗/SI 和机械验证；在这些验证完成前不算可制造方案，也不写成“直接兼容任意摄像头”。如果 HAT 叠装会遮挡 Radxa 原生 CSI，必须在机械评审时确认转接 FPC 的弯折半径和接触面方向。

**2026-10-29 变更：屏幕已去掉，本节保留为历史记录。** 屏幕建议采用 **LCDwiki MSP3525 无触摸版 3.5-inch IPS SPI Module ST7796** 作为首版候选。其资料列出 320×480、4-wire SPI、5 V 输入、约 95 mA 背光、14P 0.5 mm FPC 与 14P 2.54 mm 排针；无触摸 SKU 为 MSP3525。它是带控制板的模块，不是裸 LCD；HAT 只放与模块相配的 14P FPC 座和必要的 SPI/控制/5 V/地，不把裸屏针序混用。该候选需在投板前取得固定版本规格书、确认 FPC 接触面/插座方向和 3.3 V 信号兼容性；若资料或供货批次不一致，暂停屏幕部分投板。触摸相关的 CTP 引脚留空，不设计触摸电路。

屏幕型号仍是**[推断/候选]**，投板前必须固定模块版本、FPC 接触面和逻辑电平。

## 2. 建议管脚分配（待原理图逐网核对）

| Radxa ZERO 3W 40P | 复用信号 | 首版用途 | 备注 |
|---|---|---|---|
| 8/10 | UART2_TX/RX_M0 | 现有飞特 TTL/外置 IMU 半双工总线 | 官方标为默认 U-Boot/调试串口；保留是为兼容本机现状，必须在软件阶段核对关闭 console/启动日志，不宣称可直接当普通 UART |
| 19/21/23/24 | SPI3_MOSI/MISO/CLK/CS0_M1 | 3.5 寸屏幕 SPI（CS、SCK、MOSI；MISO 可选） | 屏幕另需 DC、RST、背光使能 GPIO；CS0 可作为屏幕片选。若使用 MISO 不够或冲突，屏幕读回可不接 |
| 29/31 | I2C5_SCL/SDA_M0 | 头部 IMU + ToF/I2C 扩展主总线 | 地址、上拉、电平和总线电容须在原理图阶段核对；扩展座不默认与头部 IMU 同址 |
| 12/13/35/38/40 | I2S3_SCLK/MCLK/LRCK/SDI/SDO 复用组 | 音频编解码器/功放数字音频链 | 实际声卡方向、I2S 主从和驱动需软件验证；麦克风/扬声器模拟部分按选定 codec 资料设计 |
| 11、15、22、33（候选） | GPIO3_A1、GPIO3_B0、GPIO3_C1、GPIO3_C3 | 屏幕 DC、RST、背光 EN、头部 IMU INT/ToF INT 等控制 | 只是候选 GPIO；需查设备树占用、电平和启动状态后定稿 |
| 27/28 | I2C4_SDA/SCL 或可改 USB2 DP/DM | 预留第二 I2C/调试扩展，不作为首版屏幕/相机必需信号 | Radxa 文档说明默认未启用 USB 功能且有电阻改装步骤；避免依赖此复用完成首版核心功能 |
| CSI 22P（非 40P） | MIPI CSI RX D0–D3、CLK、I2C2、PDN、CLKOUT、3V3 | 摄像头通道 | 按官方 22P/0.5 mm 针序布置，差分阻抗、等长、参考平面、ESD/连接器方向须由 PCB 阶段核验；不从 40P 引出 |

**串口边界：** UART2_M0 是本机现有 HAT 的兼容背景，但 Radxa 官方不建议把它作为普通 UART。方案批准前要决定软件是否关闭 U-Boot console；若不能关闭，应为舵机/IMU 总线寻找可行 UART 复用并重新审核。

## 3. 电源与保护边界

- 电池入口按当前 2S 背景设计为“动力母线输入”，实际最低/最高电压、连接器载流、保险与线宽必须以实物和器件数据核算。
- 动力母线直通舵机接口；5 V 降压给 Radxa、屏幕模块（若其 5 V 输入确认）和音频功放等负载。另设 3.3 V LDO/DC-DC 给头部 IMU、I2C 上拉和必要逻辑。
- AP63205、LM5050-1 等仅作为官方 C1 的候选参考，不把 C1 额定或本机负载能力当成已验证结论；最终器件必须按输入范围、峰值电流、热、布局和 JLC 可供性复核。
- 用料事实（2026-10-29 核）：官方 C1 的 U9 与 kissqy REVA 都是 **AP63205（2 A，TSOT-26）**；**用户已选定 AP64350（3.5 A，SO-8EP，40 V）**作为本板 5 V 降压，取代早期候选 AP64501。SO-8EP 同封装但第 4 脚不同（AP64501=SS，AP64350=RT/CLK），原理图与 PCB 必须按新引脚重画。模型与仿真边界见[电源芯片对比](../../references/扩展板电路仿真工具/research.md)。
- 估算预算仅用于方案排序：Radxa 5 V 约 2 A 级建议按官方“5V/2A 或更高适配器”作为起点；屏幕模块背光资料给出约 95 mA；音频功放属于独立的功率负载，其峰值和供电压降尚未核定。首版不把屏幕/音频峰值并入已证实的总额定，须在原理图/BOM阶段补齐。
- 首版保留入口、5 V、3.3 V、GND、UART DATA 测试点；不设计充电、UPS、RS485、识别 EEPROM。

## 4. 头部 IMU 与音频建议

- 头部 IMU 首选 BMI088（官方 C1 原理图/功能参考较完整），接口优先 I2C；若需要更高频率再评估 SPI。D1 的 LSM6DSV16XTR 只作为第二候选，不能把 D1 PCB 当可直接复用的完整原理图。
- 选型必须提供安装方向、量程、ODR、INT 引脚和 Linux 驱动/用户态读取路径。若 Radxa 现有镜像没有所选器件驱动，需在投板前改为可用器件或明确自写驱动工作量。
- 音频沿用官方 C1 的 codec+功放分块作为参考，候选 TLV320AIC3104 + PAM8406；该组合的 I2S 管脚、模拟麦克风偏置、扬声器阻抗和软件声卡配置未在本轮验证，不得宣称即插即用。

## 5. 机械、层数与生产文件

- 首版用 4 层 PCB：顶层放连接器，内层连续地和电源，底层放低速与局部器件；音频与开关电源分区，避免跨分割。屏幕与 CSI 已去掉，2 层也可评估。
- 机械基线沿现有 HAT 外形、Radxa 40P 孔位和装配高度；在 KiCad 中建立 Radxa 板外形、40P 排母、CSI FPC、屏幕 FPC、音频/舵机插座的 3D/禁布区。现有白色 V1.2 的实际孔位和连接器方向仍需照片/卡尺确认。
- 方案获批后交付：KiCad 工程、锁定符号/封装库、原理图 PDF、PCB、DRC/ERC 报告、Gerber/钻孔、BOM、CPL、装配图、DNP/自焊清单、线束针序表和验收单。嘉立创贴片前必须锁定具体屏幕模块和所有 FPC 接触方向。

## 6. 实施顺序与验收门

1. 锁定 Radxa 40P 与 CSI 官方针序、板框/孔位和连接器方向。
2. 锁定屏幕模块 MSP3525 的版本、14P FPC 规格、5 V/逻辑电平和 Linux SPI 驱动路径；若不能核实，保留屏幕专用转接小板方案，不投裸屏口。
3. 锁定头部 IMU 与音频器件、供电峰值和软件支持边界。
4. 画原理图并完成 ERC；逐网复核 UART、I2C、SPI、I2S、CSI、供电和所有未连接脚。
5. 画 PCB，完成机械检查、阻抗/差分/间距规则、热和回流路径检查，再做 DRC。
6. 先只导出生产文件做离线审阅；用户确认后再交嘉立创。
7. 到货按现行 HAT 最短测试单：目视针序/极性→限流上电→5 V 轨→主控单节点；随后按功能顺序接头部 IMU、屏幕、摄像头、音频、舵机/外置 IMU，总线功能与整机同时运行作为最后验收，不做堵转测试。

## 7. 阻塞项与回退

- **投板阻塞（2026-10-29 更新）：** UART2 启动串口冲突未解决；2S 输入和 5 V/3.3 V 负载预算未完成；头部 IMU/音频驱动未确认。**屏幕模块与 CSI 转接已不再是阻塞项（两项功能已去掉）。**
- **回退：** ~~屏幕转接小板 / 摄像头直插~~ 已随功能去掉而失效；头部 IMU 先放可替换连接器，保留 BMI088/LSM6DSV16X 两种封装评估；音频先保留接口与测试点，待软件核实后贴装。

## 8. 仿真与模型可用性（2026-10-29）

本轮查找厂商模型后的可用范围，详见[模型与工具记录](../../references/扩展板电路仿真工具/research.md)：

| 功能块 | 模型状态 | 可做的验证 |
|---|---|---|
| TTL 缓冲（SN74LVC1G125 候选） | TI PSpice + IBIS 已取得，ngspice 最小检查通过 | 缓冲器级电平/三态；不等于整条舵机总线 |
| 音频 codec 数字侧（TLV320AIC3104 候选） | TI IBIS 已取得，未运行 IBIS 仿真 | 数字 I/O 电气特性；不含 ADC/DAC 与驱动 |
| 5 V 降压（AP64501 候选） | 无公开模型；TPS565201 备选模型在 ngspice 不收敛 | 暂无器件级仿真，只能实测 |
| 音频功放（PAM8406 候选） | 无公开模型；TI 备选为加密格式 | 暂无器件级仿真，只能实测 |
| 头部 IMU（BMI088） | 无模型，且 SPICE 不适用 | I²C 时序/寄存器与实机采样 |
| ToF | 无模型 | 接口规则检查与实机验证 |

这条限制直接影响验收口径：**首版的电源与音频不能宣称“已通过仿真”**，只能按“实测兜底”处理；是否需要换用有可运行模型的电源/功放型号，待用户选定后再改方案。

本方案已获用户批准并进入 KiCad 原理图阶段；它不构成投板或上电许可，投板阻塞项见第 7 节。
