parkourlrc/pcb-yilv1982--duck-robot-89dbc81d6d/docs/specs/20261028-custom-hat/recovery-plan.md

# HAT Rev A 修复计划（2026-10-31 更新）

本轮用户授权：先核对历史问题真实性、更新文档，再实施确有必要的流程改进。原功能范围沿用 [spec](spec.md)，不再征集已确认需求；主会话执行，不用 subagent。

**[用户确认] 无新板，高度未定，先列范围。** 当前86654c03/r18。新增BMI088 0.5mm/0.2mm F.Cu电源支路；邮票孔居中、X108/160分板带局部退铜；修复第二单元Power映射。原生主板/拼板全0，两个0.175mm探针均被Power0.2规则拒绝。旧r1～r17退出制造入口；实际工艺/制造/完整机械与首板未验。既有U301方案、制造选项及机械基线保持，见[报告](../../references/扩展板邮票孔与电源修复/research.md)。

## 依据与已经完成的修正

[现行复核及原始数据](../../references/扩展板电路仿真工具/audit-20261030/review.md)逐项列出证据。旧[10-29 审计](../../references/扩展板电路仿真工具/audit-20261029/review.md)仅描述当时文件，不能忽略后续第46–56节直接套用。

| 项目 | 已核实状态 | 仍需区分 |
|---|---|---|
| U301 | EP已有5个同网热孔，C303移近VIN，FB/COMP改为邻近顶层短线 | 真实热能力、有效电容/稳定性及额定载流未完成 |
| U501 | 已改 Bosch LGA-16、CSB2 DNC，C319/C320及keepout修复已完成 | 本板I2C上拉已补；外部并联上拉、实际波形/去耦回流仍待核 |
| TTL/动力 | U801/U802、R309、EH 1=GND/2=VBAT/3=DATA 已补 | GPIO 控制 DXL_DIR；通信方向时序尚未验证 |
| 音频 | I2S_SDO/U701.7已连，LDO与本地去耦已修，I2C5上拉/麦克风/功放已补，Pin33可控RESET已接，原R308/C310 RC保留 | 当前驱动、实际RESET波形、播放/录音与J504负载仍待核 |
| 机械与测点 | 65×30 mm、pin1参考依据、TP802板内位置及文件冲突已修 | 装配高度、实体配接与堆叠仍待验 |
| 平面 | F/B地、In1地、In2 +3V3四铜区保留，原生连接检查通过 | 高频回流与介质层叠尚未核准 |

现行版本以[Rev A入口](../../../hardware/custom_hat/rev_a/README.md)为准。通孔及有效规则修复保留；已完成补偿公式的理想网络核对、J301输入标识及保护职责说明。当前仍需实际主控/外围负载、输入配对/线束条件、制造工艺接受及首板验证，不因缺完整SPICE模型反复阻塞已可按手册推进的部分。见[现行电源复核](../../references/扩展板电路仿真工具/power-acceptance-20261031/research.md)。

## 本轮确认改进的流程

详细方案与验收见 [workflow-improvement.md](workflow-improvement.md)。

1. 完整副本包含工程设置、规则、原理图和库；记录源指纹、工具版本、执行命令。
2. pipeline 默认检查副本，不重建主 PCB、不自动补孔、不放宽规则。
3. 自动路由显式请求、独立目录；校验 DSN/SES 本次产生、返回码及导入结果，失败不覆盖。
4. 原理图导出网表是连接核对依据；停止旧双来源生成器默认改板，契约仅用于比对期望。
5. 分别记录违规、未连接、一致性；每次新报告，命令失败即报失败，不拿旧报告凑“通过”。
6. 现行入口只留确认问题；历史记录保留并标出适用状态。

## 流程落实后的设计任务

- D01：**已完成局部修复**，移除两段错误顶层短线和一个禁布区过孔，无新增违规或焊盘连接丢失；见 [U501检查点](../../references/扩展板电路仿真工具/u501-repair-20261030/research.md)。
- D02：**已完成局部修复**，J506保持型号/朝向移动至已核对区域，两条喇叭线重接，无新增违规/焊盘连接丢失；见 [J506检查点](../../references/扩展板电路仿真工具/j506-repair-20261030/research.md)。
- D03：**文件连通已完成**，原焊盘连接无丢失。原通过微孔闭合的U701.7现已在D13改为同尺寸贯通孔；当前工艺事项是小机械孔/POFV接受，不再要求激光盲孔。历史尝试见[U701.7复核](../../references/扩展板电路仿真工具/u701-power-20261030/research.md)。
- D04：悬空线/孔及丝印已处理；双面 fiducial 已加入并通过 DRC，剩余装配厂工艺确认。
- D05：**已完成文件级修复**，107项parity清零、同版生产审查包重出；关键IC MPN与U702型号已修，功能铜几何及连接保留。
- D06：反馈/补偿、Buck/LDO电容及支路阻尼已改，C307保持DNP，C311并联已计入。U701直流孤岛误判已澄清；此前补回局部参考铜，原I2S线路保持。几何分片/完整回流不能仅由PadGroup合一关闭；入口/载流/保护、热、电气与首板验收仍需继续。
- D07：共用电池入口及SERVO_VBAT主路径已由0.6mm加宽至1.2mm；接口/板边避让通过，其他原连接保留，铜损模型范围已写明。后续主控5V路径已在D08处理；整板额定、保护与制造条件仍不能仅由加宽推定。
- D08：主控5V公共主干、排母入口及pin2→pin4线已改1.2mm；R301反馈支路及原连接保持，模型明确未计接触/回程/瞬态。官方V1.11供电图已核，本自设计HAT不支持USB带电并供。该阶段发现的C323远置缺口已在D09处理；旧+5V断网info另有原生反证，二者不混同。
- D09：已把C323移近并改22µF，新增C328=2.2µF、局部VDD/地通孔与短线；全部原连接保留，U803去耦告警消失但实际性能未测。图纸显示、阻容标注与装配资料已改；板内BMI088/AIC3104地址已补核，无需凭默认地址猜测改总线。
- D10：按TI资料新增100nF C329/C330与局部地孔，VCC线3.135/1.441mm；原有铜对象、焊盘、连接和I2S参考铜取样保留，原生检查全0，U801去耦告警消失。完整平面高频回流与TTL实物性能未验，不把局部地线长度冒充整个回路。
- D11：补DUCK HAT Rev A丝印并避开FID3开窗，原生检查全0；制造门禁的数量差异按10个board-only件与1个DNP澄清，原始FAIL保留。新增0402立碑提示需结合钢网/回流工艺判断，未当作实际故障或自动删件。
- D12：按公开制造文字要求修正板名/位号及间距，采用工程内置限制并用故意违规副本验证实际拦截；C309仅改图形分配并同步本地库。铜/焊盘/连接不变，原生全0；指定孔距预核通过，送审参数提案已形成但未发送。
- D13：**原尺寸贯通方案已采用**。保留U701.7位置/铜盘/孔径，以公开小机械孔能力制定严格限定的0.35/0.15mm、0.1mm环宽规则；其它99孔仍≥0.125mm。全连接及尺寸反例已核，100via均贯通；QFN land/POFV加工仍需接受。
- D14：修复DRU缺单位的解析错误，pipeline用临时完整副本的9mm孔径哨兵证明加载成功，回写要求新证明与DRU哈希一致。旧CLI零计数不能代表全部自定义规则通过；align_rules默认入口已禁用。
- D15：对照确认U501 courtyard规则会影响整片zone，退役两条原型规则，恢复Default 0.15mm/Power 0.2mm；按孔型明确0.20/0.30/0.25mm孔铜距。652项名义几何检查通过，I2S取样与c6c09b33版一致；旧“铺铜增加”不当作回流改善。
- D16：已核图27理想反馈/补偿网络，Eq12印刷系数不作为选值依据；14k/3.3n符合名义选值基线，未宣称真实环路/瞬态通过。J301 2S+/GND标识及8P针序说明已补，保护职责分开列出；输入/负载情景不升级为整板额定，不因未测风险默认新采购。
- D17：已补J101.33/GPIO3_C3至CODEC_RST的可控复位通路，原R308=10k/C310=100nF保持，撤回漏读C310的“只有上拉”描述。复位线43.787mm、F层3.3V补连8.772mm，无新via，原铜/连接及5条I2S参考铜取样保持，原生全0。Pin15/36及无供电补连方案是拒绝历史；不能以搜索失败要求扩板。当前内核/复位波形未验，主控只读连接超时。
- D18：J101及TTL电源/OE/地/DATA/连接器显示已整理，网表契约未变，原生图已查看；生成器默认入口已拒绝执行且源指纹不变。完整工程内加载/保存避免丢失项目设置的流程已记录。[同版复审](../../references/扩展板电路仿真工具/codec-reset-20261031/review.md)与生产审查包完成；制造/实物边界继续保留。
- D19：已核历史内核同版本官方nocsf包的驱动缺项，按精确源码/headers补codec模块和I2C5/I2S3/Pin33声卡overlay，完成离线ABI/两种官方DTB合并核验。当前主控状态、ALSA mixer和实际音频仍未验收，未自动部署。
- D20：已补BMI088双端点Linux I2C适配代码/ARM64静态程序，固定本板0x19/0x68，先双ID再配置并读回；原生针序/源SHA与7项host错误路径核验通过。初始100Hz是诊断设置，不是整机性能合同或硬件同步；目标执行、六轴数据/安装方向与首板仍待验证，见[适配记录](../../references/扩展板电路仿真工具/bmi088-adapter-20261031/research.md)。
- D21：已提供音频mixer工具和78项精确源控件目录；70项实际使用控件写前匹配、4组先静音、设置路由/增益后再启用，错误或中断尝试静音。主扬声器L+R混音、J504立体声和LINE1L差分录音均有计划，10项host模拟/8种组合及原生针网绑定通过。真实ALSA控制、PCM/时钟及声学效果仍未验证，详见[路由记录](../../references/扩展板电路仿真工具/audio-routing-20261031/research.md)。
- D22：已修C307 DNP钢网遗漏。原生绘图副本只移除其2个F.Paste成员，原铜/阻焊保留，其余开口及同基线9个非paste层几何一致。BOM总审计加入实际Gerber/DNP名单对照，不能靠改manifest字段伪通过。
- D23：已核并修J502标准针序，A.1为GND/3V3/SDA/SCL；5段旧B线换6段，一枚普通3.3V via移0.1mm，无元件/板框/规则变化。非目标连接、I2S取样、全部原生检查通过；源90f27091…，已重出并复审。旧Rev A不可混用，制造/实测仍待外部证据，见[A.1记录](../../references/扩展板电路仿真工具/qwiic-pinout-20261031/research.md)。

设计按功能回路布局、关键电源地/去耦/扇出优先、普通信号随后。保留四层65×30作为已确认起点；有限候选搜索失败不能推出必须六层、删音频或从零重排。需要改变功能/尺寸/接口时再说明实际冲突。

制造工艺、器件型号/采购、载流边界、装配高度、驱动和首板功能属于交付核查，不自动升级为已知故障。最终严重DRC和未连接清零、一致性差异解决或有明确解释后，才从同一版生成生产资料。默认不提交、不下单、不上电。
