parkourlrc/pcb-yilv1982--duck-robot-89dbc81d6d/docs/specs/20261028-custom-hat/spec.md

# Spec：KiCad 自设计 HAT 首版

- 日期：2026-10-28。
- 状态：**持续推进，整板未完成**。A.1已通过原生文件检查并创建5片Y6订单，最后回执未付款；2026-11-04用户要求全部嘉立创现货，[A.2改版方案](../20261104-hat-jlc-stock-redesign/spec.md)已准备待批准实施。制造/首板验收仍未完成；本spec后续历史段落只描述对应检查点，当前源及任务状态从[HAT入口](../../../hardware/custom_hat/README.md)进入。
- 用户明确需求：用户不会画板、已有 KiCad，希望自行设计 HAT 并走通嘉立创制板全流程；本轮要求先盘点现有参考设计并整合一版需求。
- 当前授权（2026-10-30）：用户先要求核实旧问题并改进流程，随后分别对U501及J301/J506局部修复回复“继续”。依下方方案完成局部PCB修改及验证；既有功能、原理图和制造规则不变，不使用subagent。流程记录见 [workflow-improvement.md](workflow-improvement.md)。
- 依据：[HAT 设计盘点](../../references/扩展板设计来源盘点/research.md)、[现行项目概览](../../../README.md)、[进度](../../../PROGRESS.md)、[BOM](../../../BOM.md)。

## 目标与边界

### 2026-10-31 Rev A.1接口与钢网

继续按用户持续修复授权，核实旧J502与既有Qwiic/STEMMA类接口意图不一致，以及C307 DNP仍出锡膏开口的问题。A.1仅纠正该4针顺序、局部引线及必要via间距，保留板框/接口型号/元件位置/其它功能，不把标准针序当成任意外设都兼容。板面修订标记和图纸rev用于区分旧版本。钢网在完整绘图副本中只排除DNP paste，不删原铜/阻焊。候选按原规则、非目标连接、I2S参考铜和原生预览验收后回写，再重出同版包并用kicad-happy复审；详见[记录](../../references/扩展板电路仿真工具/qwiic-pinout-20261031/research.md)。[用户确认，2026-10-31] 尚未送厂、没有自主新板实物；原“制造状态待答复”已失效。未上传或下单。

### 2026-10-31 主控驱动缺项修复

继续执行用户“解决所有已知问题”的授权，核实到本机历史内核同版本官方包未编入AIC3104/BMI088驱动。针对真实缺项增加离线codec模块构建与设备树候选，不换芯片、不改PCB接口、不用上游整套固件覆盖主控。匹配源码/headers、ARM64/vermagic/符号CRC以及官方DTB合并/引脚核验是本轮离线验收范围；当前主控版本、加载、音频功能与BMI088实际运行仍单列未完成。成果与来源见[驱动记录](../../references/扩展板电路仿真工具/driver-compatibility-20261031/research.md)，不自动安装、重启、提交或操作实物。

后续已补BMI088的Linux i2c-dev双端点适配：固定本板0x19/0x68，先读两ID再配置/回读，初始100Hz、±6g/±500°/s诊断配置，输出原始值/SI量与各自读取时间区间；不假定同步、机器人坐标或标定完成。已严格编译ARM64静态程序并用host虚拟系统调用核7项错误身份/传输防护，原厂源码及许可保留。此步骤解决“没有适配代码”，不将未实施的目标板运行或六轴实测替换为编译成功，见[适配记录](../../references/扩展板电路仿真工具/bmi088-adapter-20261031/research.md)。

音频mixer步骤也已补出：按已锁定驱动源码与原生PCB，提供主扬声器L+R混音、J504独立立体声、J505 LINE1L差分录音配置。默认只生成计划，真实应用须先匹配声卡/控件、保存新报告，先静音/再配置/最后启用；异常或Ctrl-C尝试静音并报告结果。已做10项host模拟及8种组合核查，没有真实ALSA/PCM测试；没有定义J504低阻负载为已支持，也未添加功放GPIO或改板。见[路由记录](../../references/扩展板电路仿真工具/audio-routing-20261031/research.md)。

### 2026-10-31 codec复位与图纸整理

用户持续授权解决已确认问题、不中途停下并使用kicad-happy复审；本轮在完整副本中增加空闲Pin33/GPIO3_C3至CODEC_RST，保留R308/C310 RC及现有功能，未扩大板框、降低制造规则、下单或操作实物。先前“只有上拉”的分析漏读C310，已更正为“原RC存在、实际时序待验、新增可控复位能力”。候选增加复位线及同网3.3V补连，保留全部原铜/连接与I2S参考铜取样；40P/TTL纯显示调整通过原网表契约。原生检查、图像审阅和同版kicad-happy复审后已回写，详见[证据](../../references/扩展板电路仿真工具/codec-reset-20261031/research.md)。实际内核、复位波形与新板功能尚未验证，默认不提交/推送。

### 2026-10-30 +3V3与地连接修复

用户对继续处理剩余+3V3和地连接回复“继续”。保持元件位置、原理图、引脚/网络、板框和制造规则；先在完整副本重铺铜核连通组，修旧电容错层短线，再以有几何依据的短引线/过孔连接现有平面或同网已连对象。每个候选经同规则DRC判定，无新增违规且未连接减少才保留；不凭总数忽略新错误。最终核全板原有焊盘连接保留，图像和差异审核后保存检查点；未通过部分如实保留，不下单、不上电。

实施：接受25个小步骤，修4段旧短线、供电扇出及两个地岛；为落地孔局部绕开BCLK/MCLK和+1V8_CODEC短段，未改网络端点或器件。全板193个有网焊盘原连接保留，无新增普通DRC/parity；未连接22→1，warning15→11。最后U701.7联动规划未成功，未采用；已验证部分源指纹核对后更新主PCB。[证据与限制](../../references/扩展板电路仿真工具/power-repair-20261030/research.md)，未提交/推送。

### 2026-10-30 I2S_SDO及相邻扇出修复

用户对继续处理I2S_SDO回复“继续”。保留原理图、引脚/器件位置与制造规则，完整副本内完成U701.4到J101.40。几何搜索确认现有SDI/LRCK/BCLK扇出挤占出线区，允许这些相关网络联动重布，但必须保留各自端点连接；不改其他网络。候选采用现有规则允许的0.15 mm线、0.5/0.3 mm过孔，经约束搜索后简化为45/90°路径，再由完整工程重铺铜DRC及焊盘连通性验收；无新增违规、I2S_SDO未连接消失、原有连接不丢失后才审阅回写。有限搜索失败不作为“板面无空间”的结论；0.5 mm孔盘符合当前工程但不等于新制造工艺已放行。

实施：四网联动候选通过完整DRC和连接分组核验，I2S_SDO两端连通、193个有网焊盘原连接无丢失；普通warning16→15，未连接23→22，parity101不变。元件/其他铜对象不变；源摘要核对后已回写主PCB。[完整证据](../../references/扩展板电路仿真工具/i2s-sdo-repair-20261030/research.md)保存搜索失败、采用路径和前后报告；未提交/推送。

### 2026-10-30 J301/J506 局部修复

用户对继续处理连接器冲突回复“继续”。按现有几何，J506为垂直SH 2P座，保持B.Cu、0°朝向与型号/针序，中心由(113.43,126.05)移至(113.0,122.3)；courtyard范围(110.055,119.655)–(115.945,124.945)，避开J301通孔、R309及相邻底层器件，J402位于另一面，仅其贯穿孔/铜作为底层障碍。移动同时修改SPK_P/SPK_N接座短线，保留其他网络。先完整副本同规则检查，不增加短路/间距/机械问题或焊盘连接丢失，层图检查后再决定回写主板。该局部布局不代表整机装配高度已验证。

实施：第一条SPK_N斜线碰固定焊盘，候选拒绝；改走插座两固定焊盘间通道后通过。普通DRC从24降至16（无普通error），23未连接与101一致性项不变，193个有网焊盘原有连接均保留。源指纹核对后已回写主板；[证据与失败记录](../../references/扩展板电路仿真工具/j506-repair-20261030/research.md)。

### 2026-10-30 U501 局部修复授权与方案

用户在确认下一步为 U501 局部修复后回复“继续”。本轮实施 D01：在完整副本核对几何后，仅移除 U501 周边两段错误 F.Cu 短线和一个 keepout 内 GND 过孔；保留 +1V8_CODEC 的 B.Cu/内层路径，不改元件、网络、规则或其他区域。验收为同规则重铺铜后消除对应短路/keepout/间距问题，不新增违规或未连接，原理图/焊盘赋网无新增差异；检查层图并保存检查点。通过后审阅差异，源指纹未变才更新主PCB；否则仅保留候选。无需重新确认已有功能或实物操作。

实施结果：删除3个对象（24行），消除4个error及1个悬空线warning，未新增DRC问题；193个有网络焊盘原连接均保留。一个未连接报告的端点UUID变化已核为同一连通组，不是新增断线。验证和图像复核后已更新主PCB，源SHA256等于候选；[检查点](../../references/扩展板电路仿真工具/u501-repair-20261030/research.md)保留前后文件、报告及图。未提交/推送。

目标候选：为当前 C 线 Radxa Zero 3W、HD-1910-C001 舵机和外置 GD32 IMU 设计一块可制造、可装配、可测试的 HAT。以现有 HAT 功能为参照，用 KiCad 交付完整设计与嘉立创生产文件。

不承诺复刻未知 V1.2 全部电路，也不把新板视为现有 IMU 缺答的已验证修复。只读参考库不修改；不在需求阶段指定保护器件安数、电源线宽、阻值或最终层数。现行 v2 供电决定继续有效，新板路线不自动变更现有设备接线或采购。

## 首版功能需求

2026-10-28 用户对需求汇总回复“这些不用。确认”，明确排除 RS485、识别 EEPROM、充电和 UPS。汇总中的基础功能与新增需求作为后续方案基线；具体芯片、电路参数和实现方式尚未批准。

用户于 2026-10-28 表示需求已提完。此后不要求用户补齐芯片、接口、分辨率等专业选型参数；由设计方在后续资料核对与方案中给出建议。以下按用户最新确认更新，不把本次确认扩展为其他额外功能的删减或实施授权。

| 编号 | 功能需求 | 建议范围 | 设计前需确认 |
|---|---|---|---|
| R01 | Radxa Zero 3W 40P 对插与机械安装 | 汇总确认保留 | 逐针 UART/I2C/I2S 复用；排母朝向/高度、孔位、头壳/排线干涉；不能只看 40P 外形 |
| R02 | 电池输入与主控 5V 稳压 | 汇总确认保留，沿当前 2S 使用背景 | 输入最低/最高电压、主控+外围功耗、连接器和铜箔电流预算；不借官方宽输入宣传推定整板额定 |
| R03 | 舵机/外置 IMU 半双工总线 | 汇总确认保留；一条 UART 总线、至少两个 3P 插座为待核方案 | 飞特与当前 IMU 报文/波特率、物理电平、接口系列/针序；两插座不等于独立两路 |
| R04 | 音频播放与录音 | 汇总确认保留 | 板载/外接麦克风、扬声器、声道、座型与 Radxa 驱动/I2S 适配由方案明确 |
| R05 | ToF/其他 I2C 外设扩展 | 汇总确认保留 | 传感器型号、接口数量、供电/电平/针序；接口不包含 ToF 模块本体 |
| R06 | HAT 板载头部 IMU | **用户已确认需要（2026-10-28）** | 不代替身体 IMU；器件型号、接口、安装方向、采样需求和驱动在后续阶段确定 |
| R07 | RS485 舵机口 | **用户明确不需要（2026-10-28）** | 首版不设计此功能 |
| R08 | 掉电检测、反向电流控制与保护边界 | 建议保留必要功能并核实 | 区分掉电提示/自动关机/持续供电；USB/HAT 同供条件；反接和过流保护职责，不默认额外改配电 |
| R09 | 电源指示和测量点 | 建议加入便于调试 | 入口、5V、GND、UART/DATA 测点的位置，避免相邻大焊点引起误短接 |
| R10 | HAT 识别 EEPROM | **用户明确不需要（2026-10-28）** | 首版不设计此功能 |
| R11 | 板载充电/UPS | **用户明确不需要（2026-10-28）** | 首版不设计这两项功能；电量计与额外控制 MCU 未被提出为需求，仍不默认加入，不将其冒充本次明确排除项 |
| R12 | 摄像头排线接口 ×1 | **已取消（2026-10-29 用户决定去掉摄像头）** | 本条不再实施；原待确认项（型号、协议、针数、驱动）不再跟进 |
| R13 | 3.5 寸屏幕排线接口 ×1 | **已取消（2026-10-29 用户决定去掉屏幕）** | 本条不再实施；原待确认项（型号、分辨率、接口）不再跟进 |

## 交付与验收草案

1. 可在约定 KiCad 版本打开的工程：原理图、PCB、所需自定义符号/封装、来源和许可说明；工程放本项目可写目录，路径待方案阶段确定。
2. 生产文件同版本导出：Gerber/钻孔、BOM、贴片坐标（选择 SMT 时）、装配图与明确 DNP/自焊清单；元件替代不能仅凭封装一致批准。
3. 制造前必要核查：电源和接口逐网核对、封装/1 脚/极性核对、机械适配、ERC/DRC 的严重问题处理；制造规则按选定工艺确定。
4. 到货验收：先目视极性/短路风险、单板限流上电与 5V 轨，再接主控和单节点；若定义整机替代目标，则最终在批准条件下验证 15 舵机+当前 IMU 共线通信。成功判据与时长待方案阶段明确；不做整机堵转。
5. 若选音频、ToF、板载 IMU 等功能，将对应实际功能验收写入后续方案；不将“有器件”当“已能使用”。
6. ~~摄像头与屏幕须作为可工作的接口验收~~ **已取消（2026-10-29）**：两项功能移出范围，不再作为验收项。

## 后续方案需解决的事项

- 功能范围（2026-10-29 更新）：基础供电/总线、音频、ToF 扩展、头部 IMU；**摄像头与屏幕已去掉**；RS485、识别 EEPROM、充电、UPS 明确不做。
- 摄像头/屏幕：2026-10-29 用户决定整体去掉，选型与接口讨论终止。
- 接口方向：继续兼容现有 EH 线束，或统一到实物核准的飞特接口；后者会涉及线束变化。
- 装配：嘉立创 SMT 或用户焊接；预算/尺寸优先级及层数在功能范围确定后细化。

## 已确认的汇总与设计依据

- 已明确：使用 KiCad 自设计 HAT、走通嘉立创制板流程；头部 IMU。（摄像头与屏幕已于 2026-10-29 去掉。）
- 汇总确认的基础功能：Radxa Zero 3W 适配、主控 5V 供电、飞特舵机及外置身体 IMU 总线、音频播放/录音、ToF/I2C 扩展。具体接口数量、保护电路与测量点作为后续方案内容。
- 明确排除：RS485、识别 EEPROM、充电、UPS。电量计及额外控制 MCU 未被提出为需求，不默认增加。
- 现有依据：官方 C1 可作为完整 KiCad 参考，社区 V1.0 用于 Radxa 映射线索、kissqy 用于精简设计参考；白色 V1.2 尚缺准确完整工程。摄像头与屏幕接口可行性尚未核定，不能以加插座替代信号来源/驱动核对。
- 预计涉及文档：本 spec、docs/specs/README.md、PROGRESS.md；后续方案再确定工程目录、生产文件及装配说明。只有功能或采购状态实际变化时才同步根 README/BOM，当前不新增采购。
- 需求汇总已确认；下一步形成器件/接口/机械/电源与验证的具体修改方案，核对并注明待确认资料，方案获批后画板；不自动提交或下单。

## 2026-10-29 续接结论

[审计](../../references/扩展板电路仿真工具/audit-20261029/review.md)及 2026-10-30 KiCad CLI 核查表明：当前主 PCB 已有实验性布线，但 AP64350/BMI088/TTL/音频修复后的布局仍未收敛，存在 `I2S_SDO`、+3V3、U501 keepout、J301/J506 机械冲突和 DRC 未连接。建议按 [修复方案](recovery-plan.md) 做同一主文件的局部重排/重布线，不默认升六层。当前未制造、未上电、未提交。

## 阶段记录（历史，不能代替上方现状）

2026-10-28：完成参考设计盘点与第一版需求草案。推荐以官方 KiCad C1 学习/核对模块、结合 Radxa 适配图与 kissqy 两层精简版评估，但未批准最终基线。文档确认、修改方案、画板与生产均未开始。

提交：未提交，保留工作区。

2026-10-28 追加：用户明确要求保留头部 IMU，并询问 RS485 与识别 EEPROM 的用途。本轮仅确认 R06；RS485/EEPROM 的解释和建议见[研究补充](../../references/扩展板设计来源盘点/research.md#rs485-eeprom)。未默认视为用户同意删减其他功能。

2026-10-28 再追加：用户要求增加一个摄像头和一个屏幕的排线口，记录为 R12/R13 必需功能。尚未指定器件型号或接口协议，未承诺可通过主控 40P 直接实现，也未默认需要桥接芯片；本轮只更新需求，不画板或新增采购。

2026-10-28 屏幕需求补充：用户指定 3.5 寸小屏，显示简单表情，不支持触摸。更新 R13，不据尺寸或用途直接选定分辨率、接口或屏幕型号；尚未开展选型或画板。

2026-10-28 需求征集结束：用户表示需求已提完。完成汇总确认稿，将具体选型留给后续方案；保留未明确同意的功能取舍，尚未启动画板。

2026-10-28 汇总确认：用户对“RS485、识别 EEPROM、充电和 UPS”批注“这些不用。确认”。更新首版范围和状态，需求汇总已确认；尚未批准具体电路方案或开始画板。此前待确认记录仅作历史过程。

2026-10-28 设计方案草案：见 [design-plan.md](./design-plan.md)。推荐 CSI 22P 中继、SPI 无触摸屏模块接口、I2C 头部 IMU/ToF、保留 UART2 兼容现有总线但先解决启动串口冲突；RS485、识别 EEPROM、充电、UPS 明确排除。用户批准后已生成 Rev A 功能页接口草案，但尚未进入 PCB 或投板。

2026-10-28 用户批准方案后进入编码：在 `hardware/custom_hat/rev_a/` 建立独立 KiCad 10 工程，生成 Radxa、屏幕、电源、TTL、BMI088/ToF、CSI、音频、测试点八个功能页和 `net-contract.json`。KiCad 10.0.7 CLI ERC 已执行：报告 171 条违规，当前不能视为通过；主要为生成页坐标/连接器占位和孤立接口标签。Rev A 尚无 PCB、封装锁定、BOM、CPL、DRC 或 Gerber。
