parkourlrc/pcb-yilv1982--duck-robot-89dbc81d6d/docs/specs/20261101-restore-mixed-sync-read/spec.md

# 回滚记录：单口 IMU 恢复混合 SYNC_READ

- 日期：2026-11-01。
- 状态：已交付通信回滚与真实 servo-web 只读验收；新板动作未测试。
- 用户指示：把 IMU 和舵机恢复到一起 SYNC_READ，先用 servo-web 测试，回滚此次相关外部修改；用户随后确认已换上新的单口板。
- 范围：撤回 v0.3 的主机通信适配，恢复已留存原件；不是新增通信方案。包括 servo-web 的单播分拆、v0.3 状态位自动分流、配套页面版本，以及 robotd 的单播/改序实验源码与部署二进制。保留原端口锁、错误检查、舵机标定、模型、Studio 数据显示适配；固件不刷写。
- 现状证据：servo-web 本地三个文件相对 Git HEAD 的差异仅为上述 0.15.4 修改，板上 0.15.3 备份哈希可核对；robotd 存在固定 control.47 原版备份，SHA256 `725b74cd93660a312970a44879abe5b75e8becf108499a1b8798961e48ca5f00`。WSL 是无 Git 的解包工作副本，必须按已存逐文件哈希撤回，不能使用仓库整体 reset。
- 执行方案：先保存当前源码/哈希与运行状态；确认现有 robotd 报卸力、无动作后停止 Studio 和 robotd；安装回滚文件并启动 servo-web，保持原 10 Hz/20 ms/端口锁/降级判据。通过真实 WebSocket 采集约 30 秒，打开现有总线日志开关，核对一条请求是否同时包含 200 和 15 舵机，以及成功数、校验/超时、IMU 状态。不会发舵机目标或上力。
- robotd：部署恢复原版但本轮保持停止，先交由 servo-web 验收；WSL 工作源码恢复原件，旧补丁/实验日志和二进制备份作为历史保留，不再作为当前构建入口。原来自动启动设置本轮不变，避免另增常驻服务冲突。
- 验收：本地/远端回滚 SHA 一致，原始 SYNC_READ 请求包含全体 IDs；真实页面回读而非只测离线解析；只读结果不能升级为站姿/模型验收。
- 说明：本次按用户指定原版本执行排障回滚，需求与回滚方式已明确授权，不另创功能或扩大系统变更；若原件不匹配则暂停该文件覆盖并记录。
- 提交：未提交，保留工作区。

## 首轮验收后的补充回滚

- [实测] 30 秒混读无超时或坏校验，但页面把新板连续返回的 `0x08` 解释成 kit 的 sensor_err。
- [源码核验] 原始 servo-web 的状态判据为 legacy：bit0=未就绪、bit1/2=故障、bit3=读取慢；当前 `imu_bus.py` 还残留 10-24 的 kitbits 补丁。新板身份为 `06 00 00 00 f2`，与原 robotd 的 Ft6 身份匹配；不能把旧单口板的 kit 状态定义套给新板。
- 按用户“相关外部修改全部回滚”的范围，继续撤回 kitbits 解析及相应 Fake 数据改动，逐段恢复只读参考库原有判据；页面 ready/configured 修复、日志、统计保留。单纯恢复已有原件，不增加自动识别或新固件分支。之后重做真实网页只读验收；原始失败窗口保留。

## 交付结果

本地/板侧恢复一致，robotd 原版 binary 与 WSL 原源码已恢复；第二轮 30 秒真实采集 296/296 帧舵机全在线、IMU live 约 9.9 Hz，0 超时/坏校验/错 ID。保留 servo-web 运行，Studio/robotd 停止，自启配置不变。完整统计边界、首轮 kitbits 误判、依赖不齐导致旧单测未能启动及未做动作的边界见[验收记录](../../references/飞特策略模型上机核对/restore-mixed-sync-read-20261101.md)。
