parkourlrc/pcb-yilv1982--duck-robot-89dbc81d6d/docs/specs/20261101-servo-first-imu-read/spec.md

# 2026-11-01 先舵机后 IMU：三次复现与顺序对照

> **历史任务**：2026-11-01 换上新单口板后，相关通信补丁已撤回，见[当前回滚 Spec](../20261101-restore-mixed-sync-read/spec.md)。以下实验、安装与验收按原日期保留；环境及 Studio 显示适配不在撤回范围。

## 需求与授权

用户当轮明确要求：“先再试三次……对比跟 servo-web 在等待时间和判错的逻辑……然后尝试跟 servo-web 一样，先发舵机的，再发 IMU 的。”沿用此前已托稳的现场条件。本指示已明确给出三次基线、比较内容和修改方向，作为本任务需求、文档依据及具体顺序修改的授权，不重复询问已授权步骤。

目标：在原 robotd 上再采三次 `hold-home`，核对失败阶段和原始校验字节；随后仅把 v0.3 遥测顺序换成舵机 SYNC_READ → IMU 单播 READ，做一次同样原生动作对照。

不扩大：不改变零位、HOME、方向、扭矩/位置写法、3 秒过渡、50 Hz、20 ms 总遥测截止、错误后卸力条件、固件或接线；暂不照搬 servo-web 放宽后的逐帧等待和缺失容忍。三次基线后先分析；对照只授权本任务必要的一次，遇异常结束并卸力。

验收：所有尝试有独立防重复标记、原始串口记录、RPC 结果、前后诊断与卸力回读；报告是否同阶段/同字节，并区分样本事实和独立性限制。新顺序通过相关传输测试及构建后部署，先检查启动状态，动作结束确认卸力和 Studio 可用；若对照无改善则恢复已知旧版，并保留试验补丁/二进制来源记录。

## 文档与现行事实

- [研究记录](../../references/飞特策略模型上机核对/research.md)：11:51 一次原生动作在两次插值后，收到 21 字节坏帧，0.867 ms 内已到主机，最终等待超时卸力；取消回复计数无增量。
- [原生补丁](../../../software/robotd-v03/patches/v03-unicast.patch)：当前 IMU 先读、舵机后读；同一 control 线程，20 ms 共用截止。
- [servo-web](../../../software/servo-web/feetech.py)、[轮询实现](../../../software/servo-web/server.py)：逐事务 `_io` 锁、舵机先读、IMU 后读；每次底层读取有独立 timeout，坏校验即报错，外围记录缺失。
- 原安装 SHA256 `9f9fa71723339b80f97d7be065dec04855bb0d31a3ed7c5978e8605c22db3e5b`；参考库只读，构建使用既有可写 WSL 副本与固定依赖。

## 修改方案

1. 基线三次复用已执行的一次性 RPC 采集器，仅输出名／授权计数不同；每次前后原始 READ 回读与服务恢复，必要失败即中止，不重跑已发送尝试。
2. 在 v0.3 专用 `imu_to_dxl_telemetry` 的严格完整读取入口（当前 commissioning / read-only 实际路径）中先发舵机 `sync_read_window`，随后发 `imu_to_dxl_read`；两半共享原始 started/deadline。合并双方统计，最终只有完整且满足现有数据检查的结果可用。**保留允许部分舵机反馈的另一路旧顺序**：该路原先可在预算末尾接受缺舵机，若直接倒序会在预算耗尽后才读 IMU，混入保护语义变化；当前站姿复现不走它。不将部分/坏帧变成成功，不改其他板分支。
3. 使用独立增量补丁与 build 标识，留存原版；只运行覆盖顺序、坏帧、超时/统计的必要测试及 arm64 编译。服务停启和程序替换在卸力状态执行。
4. 新顺序做一次 bounded `hold-home` 对照，保持和基线相同采集。若没有改善则恢复旧版；成功一次也只报告样本成功，不宣称可靠性验收。

## 状态

- 需求／文档／顺序方案：用户当轮具体指示已授权，已按上列边界落盘。
- 编码／实验：已完成，真机故障未修复，已恢复原单播版 `duck-v03.1`。
- 三次基线已完成：分别在第 2、3、2 次起身插值目标后收到坏帧，实收 checksum 为 4C、41、56；完整数据见关联研究。顺序试验仅覆盖当前实际严格读取路径，是为避免修改未启用的部分反馈策略逻辑而做的实现收窄。
- 改序对照已执行一次：15 颗舵机反馈先完整收齐，随后 IMU READ 在第一次插值目标后收到 21 字节坏帧（checksum 期望 8C、实收 0C），原生报超时并卸力。只改变顺序未解决此次故障，没有继续动作尝试。
- 验证：传输测试 7/7 通过，arm64 编译通过；全部四次都有 15 颗卸力回读。12:31 最终只读核对两服务 active/enabled、Studio health 200、commissioning/ready/off；配置和标定 SHA 前后不变，10 份远端原始记录与本地一致。服务在线不代表通信零错误，后台仍有失败。
- 交付：[实验增量补丁](../../../software/robotd-v03/patches/v03-servo-first-experiment.patch)、[部署与回退记录](../../references/飞特策略模型上机核对/servo-first-deployment-20261101.json)、[对比汇总](../../references/飞特策略模型上机核对/hold-repetitions-comparison-20261101.json)、[最终状态](../../references/飞特策略模型上机核对/hold-repetitions-final-20261101.json)。WSL 可写源码保留实验，板上已回退；实验补丁不作为生产修复。
- 提交：默认保留工作区，不 commit/push。
