parkourlrc/pcb-yilv1982--duck-robot-89dbc81d6d/docs/specs/20261104-hat-jlc-stock-redesign/spec.md

# Spec：自主HAT Rev A.2嘉立创全现货改版方案

- 日期：2026-11-04（Asia/Shanghai）。
- 状态：**方案待补充选料并待用户批准实施；尚未修改原理图、PCB或工厂订单资料。** 11-04与kissqy逐料号核价发现C308/C309/C328仍有C编号误匹配，原“全现货”覆盖不成立，详见下条及[成本对比](../../references/自主扩展板与社区版成本比较/research.md)。
- 同日实际报价后的补充：本方案偏重缺料替代，**不是已完成降本的方案**；现仍保留0.15mm孔、6POFV、内层1oz、沉金以及高价连接器。用户询问优化后已建立[降本优先级](../../references/两套扩展板订单与报价/cost-optimization.md)，尚未批准其功能/布局范围；不可直接据旧表宣称低成本或全部现货。
- 用户决定：全部使用嘉立创现货，准备改版方案。目标仍为5块HAT、双面SMT；外采/邮寄路线不采用。
- 基线：`hardware/custom_hat/rev_a/custom_hat_rev_a.kicad_pcb`，SHA256 `86654c03b6c1c8f51f7d5a4bef469aceed2ddfc73433b3e50426940c2a23164a`；当前自主A.1为Y7，旧Y6保留未付历史单，不作为现行支付/改版入口；kissqy比较单为Y8，两PCB单待付款且SMT只有草稿，见[订单记录](../../references/两套扩展板订单与报价/research.md)。
- 依据：[本轮调研与原厂证据](../../references/扩展板全现货改版/research.md)、[此前逐料号替代审查](../../references/自主扩展板下单记录/substitution-review.md)。
- 提交：未提交，保留工作区；方案批准不包含付款或上电。

## 需求、范围与验收

将9组缺料改成嘉立创国内SMT库现货料，并让所有拟装物料有明确C编号和5板加备损的供料记录。保持65×30mm、4层、Radxa40P和外部接口位置/针序、TTL、BMI088、I2C/ToF、codec、麦克风和扬声器功能。目标不是增加5V输出电流，不扩大板框、不删功能，不降低DRC阈值或用豁免消除新违规。

**新增待补选料组（2026-11-04）**：C308/C309/C328锁定KEMET C0805C225K5RACTU，旧草稿C377773却是Samsung CL21A225KBQNNNE/X5R。精确KEMET在本轮SMT搜索未找到自营结果，不能沿用¥0.24或其库存。需补查精确现货替代并重新核C308/C309有效容量、C309＋R703＋C311联合ESR以及C328旁路；未批准直接换三星。下表10组原方案仍是候选，不能据此宣称全部58件已具备现货。

“全部嘉立创现货”同时纳入6件/板THT连接器的供料核对。其原工序仍是双面SMT、支撑切断分板、再逐点手焊；有库存不等于已确认嘉立创完成全部THT。实施阶段须把工厂手焊承接及费用纳入成品报价，不把裸SMT板称为全装成品。

实施验收：原生ERC/DRC/未连接/原理图PCB一致性均无新增或残留错误；逐针网表契约、非目标电路、钢网及机械范围核对通过；BOM/CPL/Gerber源哈希一致；所有实际使用料库存满足5板及网页明确备损；kicad-happy按适用项目复审并区分启发式误报、计算与实测边界。完整首板功能/温升只能在制造后验收。

## 推荐选料

以下库存为2026-11-04国内嘉立创SMT元件库页面观察，未锁货。安装数量为5板净用量，备损必须在新版SMT草稿按精确型号重新取得；不把净用量当最终采购数量。

| 位号 | 拟用型号 / 嘉立创编号 | 5板净用量 | 页面库存 | 改动 |
|---|---|---:|---:|---|
| U301 | **AP64351SP-13 / C3192339** | 5 | 34 | 代替AP64350；4脚由RT/CLK改SS，固定570kHz |
| 原R303位置 → C331 | **C0805C223K5RACTU / C452753** | 5 | 1231 | 200kΩ调频电阻换22nF/50V/X7R/0805软启动电容，不能保留R303装配项 |
| U803 | **PAM8302AASCR / C113367** | 5 | 2977 | 原SOIC-8改MSOP-8，同功能、同针号，局部重布线 |
| C301 | C0805C332J5GACTU / C2181569 | 5 | 28 | 3.3nF/50V/C0G/±5%/0805保持 |
| R304 | ERJ6ENF1402V / C2077244 | 5 | 9153 | 14kΩ/±1%/0805保持 |
| C303/304/305/306/323 | GRM32ER71E226KE15L / C21397 | 25 | 70360 | 22µF/25V/X7R/±10%/1210，已核典型DC偏压与尺寸 |
| L301 | IHLP4040DZER5R6M01 / C845079 | 5 | 52 | 同焊盘5.6µH；温度上限155→125°C，DCR最大17.6→19.3mΩ |
| U702 | LP38690DT-1.8/NOPB / C2862452 | 5 | 17 | 同NDP0003B/1.8V；保持codec专用负载边界 |
| R703 | WSLP0603R0500FEB / C2094520 | 5 | 100 | 47→50mΩ电容支路阻尼，同结构封装/0.4W |
| C317/318 | GRJ155R60J106ME11D / C469527 | 10 | 17304 | 10µF/6.3V/X5R/0402；仍按高阻线输出用途 |

拟装总数预计仍为52SMT＋6THT＝58件/板；R303移除、C331新增一换一。位号/组数须以实施后的实际导出核准，不从表格推定全部制造文件已经一致。

原7组候选的资料限制继续有效：电容联合偏压/温度/老化和闭环稳定性没有实测；R304当前IPC焊盘与厂商示例不同但端子覆盖有依据；L301温度范围降低；U702限流较高，不能把1A芯片额定作为整板新增供电能力。详细证据见此前审查及本轮调研。

## 电路与布局改法

### 1. 降压支路

选择AP64351而不是前轮AP64500。依据Diodes DS41977 Rev4-2：AP64351峰值限流4.25/5/5.75A，与原AP64350同档；AP64500上限9.2A会明显改变故障条件。本轮选AP64351，保留原3.5A级芯片能力与既有板级功率限制。

U301外形及SO-8EP焊盘尺寸相同，1BST/2VIN/3EN/5FB/6COMP/7GND/8SW/9EP-GND保持。**4脚改SS，BUCK_RT改为BUCK_SS；移除R303=200kΩ，新增C331=22nF到地。** 不能只换U301型号；若留下200kΩ，4µA名义电流在该电阻上仅形成约0.8V，启动行为不符合新芯片要求。

C331优先放在原R303的F面(126.0,122.5)mm区域，使用真实0805电容焊盘并接到SS/POWER_GND；必要时只缩短该局部路径。22nF按4µA/0.8V估算软启动约4.4ms，厂家最低10nF/2ms；该值是设计计算，非实测启动时间。软启动不声称解决未知电池/主控带载问题。

先保留52.3k/10k反馈、14k＋3.3nF外部补偿和5.6µH；名义电压4.984V。固定频率从约500→570kHz，最低频率/抖频/电感容差及偏压条件重新核算；补偿模型常数仍gm0.15mS、RT0.089V/A，但不能据常数相同宣称全环路稳定。实现时复算电源/纹波/损耗与启动边界，确需变更补偿数值则回到方案记录，不静默采用厂商示例中不同的反馈阻值。

保留当前5个EP热孔、4窗69.63%锡膏设计的几何基线；复核AP64351手册焊盘与输出的对应关系后再沿用。库存34颗较少，准备实施/上传前再次查5板加备损，不先买整盘锁货。

### 2. 音频功放支路

PAM8302AASCR与原AADCR是同器件不同封装，采用原厂MSOP-8推荐焊盘：pitch0.65mm、每盘1.35×0.45mm、两侧总跨度5.30mm，项目库拟命名`duck:Diodes_MSOP8_PAM8302A`，不是把原SOIC焊盘整体缩放。

U803保持B面，优先以原中心(147.72,126.05)mm为起点，逐针重接1=AUDIO_AMP_EN、2=NC、3=AUDIO_AMP_INP、4=AUDIO_AMP_INN、5=SPK_P、6=+5V、7=POWER_GND、8=SPK_N。保留逻辑使能、codec路由、差分BTL输出及J506针序；核B面镜像和CPL角度，禁止用软件翻板补偿错误针序。

C323/C328继续就近供电旁路；按新pin6/7回路复核或调整局部via和短线。保持SPK输出离麦克风输入有界分离，检查附近C325/C326/C327等非目标网络，无理由不移动其它接口或全板重铺布局。

MSOP热阻手册值180°C/W，原SOIC为115°C/W。**同芯片不代表同散热能力。** 2.5W输出/85%效率情景算得约0.441W耗散、MSOP约79°C温升，只是热阻示意，非本板预测或保证。保留音频功能，首板需核实际音量/负载温升；不承诺2.5W持续低失真输出。0.125mm钢网下矩形面积比估算1.35、宽厚比3.6，仍须按圆角/开口实物导出重核，不能仅据此宣称生产通过。

### 3. 其余选料、版本与工厂文件

同步修改原理图/PCB的Value、MPN、Manufacturer、Datasheet、LCSC编号及备注，R703必须同时改值为0.05Ω；L301/U702物理不变但库名/描述与适用型号一致。C331采用新位号，BOM排除R303，网表契约显式记录BUCK_RT→BUCK_SS。板面和图纸修订拟升级**Rev A.2**以区分已上传A.1。

继续使用工作目录`hardware/custom_hat/rev_a/`，不因为板面修订另造Git分支。在完整隔离副本完成并通过检查后再回写；原A.1资料作为停用历史保存，不覆盖唯一证据。

## 六件THT供料

| 位号 | 原MPN保持 / C编号 | 5板净用量 | 本轮SMT库观察 |
|---|---|---:|---:|
| J101 | SSW-120-01-G-D / C6302732 | 5 | 8 |
| J301 | TSW-108-07-G-S / C3335496 | 5 | 134 |
| J401/J402 | B3B-EH-A(LF)(SN) / C160259 | 10 | 83852 |
| J403 | TSW-103-07-G-S / C3335811 | 5 | 1862 |
| J802 | TSW-102-07-G-S / C7402729 | 5 | 1285 |

J101只有8件；原C0402C105K4PACTU/C172740也仅43颗，旧草稿需39颗。两者标为最终备料检查点，不能提前承诺全部料已锁定。后续成本对比已逐项核价并发现上文C377773误匹配，撤回未改物料可直接沿用旧匹配表的假定；新版提交前必须按真实C编号完整复核MPN、实际库存及系统备损。

## 实施文件、核查与交接顺序

1. 在隔离副本改`power.kicad_sch`、`audio.kicad_sch`、项目符号/封装库、`custom_hat_rev_a.kicad_pcb`、`net-contract.json`；先核U301.4、C331和U803八脚，后做局部重布线。更新板修订和相关电源模型参数。
2. KiCad10 CLI在完整副本重填铜，运行ERC、DRC、未连接和schematic parity；逐项比对新旧网表及非目标pad/net，不放宽规则。检查5V功率路径、局部地回流、音频去耦、丝印、贴装边界及3D/高度。
3. 重出单板Gerber/钻孔/POFV、BOM/CPL、双面装配图、THT工序和钢网；保持5个成品口径、0.15mm孔/6POFV/既定4层层叠/沉金/0.125mm钢网，核BMI08881%、C307 DNP与U301/U701/U702窗口。新增功放封装使旧钢网和CPL失效。
4. 用固定版本aklofas/kicad-happy完成适用schematic、pcb、cross、Gerber、EMC、thermal、SPICE及与前版delta审查，明确模型范围，不以自动分数替代手册/原生检查。若需因设计变化扩大范围，先更新方案。
5. 本地包合格且获得相应实施/上传授权后，以当前自主Y7为入口更新为新哈希A.2（以网页是否支持修改为准）；旧Y6保持历史地位，kissqy Y8不改。若只能重建，先明确处理旧单并避免重复生产；不上传未完成方案。
6. 重新上传精确MPN BOM及原生B面CPL、复核全料现货/备损和6THT手焊承接，核工厂实际拼板及钢网稿、取得PCB＋器件＋SMT/THT＋运费的新总报价；旧¥820.47/¥1859.60不能作为新版应付价。费用确定后按既有约定再确认付款。

## 回退及阶段

本轮仅准备方案；主PCB及已上传资料均保持原SHA。用户此次已明确供料目标和允许准备改版方案，足以完成以上调研和文档；按项目AGENTS.md第四节第8条“修改方案经用户批准后方可编码”，**需批准本具体方案后才实施CAD和制造文件改动**。实施失败只舍弃隔离候选，保留原A.1证据；未通过新版核查前不混用旧订单和新BOM。
