parkourlrc/pcb-yilv1982--duck-robot-89dbc81d6d/docs/specs/20261104-hat-revb-cost/spec.md

# Spec：自主HAT Rev B.0，5片全包不超过750元

- 日期：2026-11-04，Asia/Shanghai。
- 状态：2026-11-05用户确认已付款、等待收货，并明确暂停自主HAT线路；停止继续实施与降本，等待用户明确恢复。原实施授权及下列预算/验收条款保留追溯，未达成项不标完成。
- 数量/成本：5块工厂全部焊好的成品；PCB、元件、备损、贴片、插件、必要工程/钢网/税合计≤750元，运费另列。不依赖临时优惠券，不减少数量或缺装达标。
- 工程：继续自主KiCad路线，建立独立`hardware/custom_hat/rev_b/`；A.1源86654c03及生产文件保持历史可追溯。不是直接使用kissqy EDA工程替代KiCad交付。
- 功能：以公开kissqy 411878f HAT为参考，保留Radxa40P、双总线口、ToF/I2C、板载/外接麦克风和扬声器；删板载BMI088及专用外围/焊盘/中断口，保留I2C外扩；删独立线输出、额外UART/电源排针。接口调整以兼容线束、针序和机械为前提。
- 电源：AP63205WU-7＋6.8µH，按2A级器件设计核算；舵机动力从电池母线取电。保留LM5050＋MOS的5V防反灌路线，1.8V改小封装LDO，避免原大电感、外补偿、TO252及散热填孔结构。
- 音频：TLV320AIC3104优先，若明确不能经济型或超预算，可更换codec并适配软件；保持所需音频功能，不以驱动支持代替新硬件验收。
- 制造：首选2层/1.6mm/1oz/绿白/常规孔；过孔目标0.3/0.6mm，无0.15mm或焊盘内填孔；优先OSP，必要时经济型允许的无铅喷锡。全部SMT同面，通孔连接器工厂后焊。
- 装配准入：必须核实全BOM的经济型支持、温度/潮敏/插件要求；codec为MSL2，不据“单面”直接宣布经济型可用。优先基础库和正常现货，核实际备损/最低数量，排除私有库0库存与预订整盘。
- 预算分配：PCB50、物料300、全部加工350、余量50；分项可调，总额不超过750。
- 执行：先核产线/BOM→锁具体料号及预算→改电路及布局布线→同源生产资料→实际完整报价。超过预算按换料组/连接器/工序/codec顺序优化，仍失败则报告真实最低价和差额，不付款。
- 验收：原生ERC/DRC/未连线/一致性干净，不放宽规则凑通过；物理40P镜像针序、电池极性、反灌、功率铜路、codec电源/时钟与I2C逐项复核；适用kicad-happy审查，区分计算和实测；资料同源、库存足够、全工序报价≤750元。
- 边界：不修改/支付旧Y6/Y7/Y8，不操作实机，不使用subagent；默认不commit/push。

## 当前依据

- [实单/草稿记录](../../references/两套扩展板订单与报价/research.md)：旧A.1 3076.10元/5片、kissqy 1160.39元/5片，均含缺料限制。
- [完整kissqy核查](../../references/社区作者仓库完整核查/research.md)：公开HAT无板载IMU，头部BMI088代码继承自官方，不是新板实装证据。
- [降本归因](../../references/两套扩展板订单与报价/cost-optimization.md)：旧制造/物料费用，不是B.0实际报价。
- 计划阶段实读Y8加工费：工程300、SMT焊盘13.70、插件焊盘6、包装3.02、插件工程20、钢网100、换料256、治具100、特殊器件2.50、DFM确认3、钢网确认20，合计824.22元。是否能消除各项需根据新文件重新计价。

## 实施台账

- **2026-11-05暂停决定：** 用户确认Y10／SMT2611051346已付款，等待收货；最后展示金额891.79元含运费5.50，付款依据为用户确认而非支付回执。5片84362651版，未确认发货、未收货验收。自主HAT线路暂停，不继续订单操作、降本/设计修改或自动跟进；原750元目标仍未达成，待用户明确恢复。下列未付款和继续实施文字均为暂停前阶段记录。

- **2026-11-05平台续接：** 新Gerber通过Y9重传入口生成Y10，PCB初步33元、待审核未付；SMT入口显示5片。用户解锁后页面已显示BOM.csv及CPL.csv；用户随后停止界面控制并选择自行操作，待核对全焊设置和物料匹配。未取得新SMT完整报价或免贴插费确认，见[当前状态](../../references/扩展板乙版降本/layout-spacing/y10-quotation-status.md)。

- **2026-11-05最新：** 已完成用户确认的焊接空间调整。新源84362651保留69件/30组，28个对象移动或旋转；3/5mm空间及额外0.2mm名义余量筛查通过，原生ERC/DRC/未连接/一致性全0。40P、4安装孔、板框、局部焊盘/针网和规则均保持，VBATT/GND各1.6mm、5V主干1.0mm路径连续性已核；同源报价包、CPL及装配图已导出。未付款或制造放行；新工厂报价及贴插费是否免除仍待确认。下列11-04报价过程仅对应99ecc45d，不能当作新版本完成记录。详见[本轮结果](../../references/扩展板乙版降本/layout-spacing/research.md)。

- 方案已获用户明确实施授权，不再重复询问同一阶段批准。
- 已建立独立B.0候选；原生ERC/DRC/未连接/一致性全0，同源审查导出与音频离线配置已完成。续接Y9已取得并保存30组/69位号全部拟装的SMT草稿1107.71元，含工厂极性复核10元；加此前PCB初步33元暂合计1140.71元，超目标390.71元。未提交正式SMT、未付款、未制造放行。
- 订单料号/位号/5板净量与备损、最低用量已核，页面元件266.44元；目录净量238.1055元保留历史比较。仅顶层1057.11元排除J101，已恢复全层并保存30/30核对状态。经济型提示钢网确认不支持，不直接归因codec。
- 下一步沿既有授权处理贴插间距、治具与换料，必要时替换codec；当前CAD包络筛出J101的19个焊盘及J401/J402各1个＜3mm，须核真实高度后设计3mm/5mm空间再重报价。即使假设贴插233.50与治具100全部免除，仍暂计807.21元，尚超57.21元；不把假设节省写成新报价。详见[报价与降本依据](../../references/扩展板乙版降本/y9-quotation.md)。
- 复审余项仍包括目标TTL/音频实测、MLCC有效容量/2A级热预算、线束机械互配和工厂装配审核。11-04源99ecc45d在当次报价核对前后不变，未重复运行无关原生/纯软件测试。
- 工作记录见[Rev B.0研究](../../references/扩展板乙版降本/research.md)。

## 提交

## 2026-11-04 贴插焊接空间调整（用户已确认实施）

用户明确选择“通过调整布局、留出焊接空间来争取消除费用”，承接既有已批准的降本实施方案。需求：调整B.0布局，保留全部69拟装器件/功能、40P物理针序与位置、板框/安装孔，按元件真实高度核通孔焊接面3mm/5mm间距；在独立候选内移动与重布受影响器件，检查通过后才替换现行源。无换codec、改电路拓扑、缺装、付款或实机操作；继续不使用子代理。

基线为99ecc45d，现有BOM/原图/网页选项和空间筛查已核；旧报价包保留追溯。实施验收为：实际本体/焊盘空间筛查无未解释违规、原生DRC/未连接/一致性通过，器件与网络/40P和安装孔对照一致，同源生产资料与装配图重新导出；费用是否消除以新资料重新计价为准，不先扣掉旧费用。实施记录在现有成本专题的`layout-spacing/`，重要结果同步现行入口。

未提交，保留工作区。
