parkourlrc/pcb-yilv1982--duck-robot-89dbc81d6d/hardware/templates/pcb-project/requirements.md

# PCB 模块需求卡

> 填完本页即可启动流程；不确定项写“待确认”，不要留空。

## 1. 项目
- 模块/版本：
- 日期/负责人：
- 宿主/系统版本：

## 2. 功能
- 必须功能：
- 明确不做：
- 验收标准（首板）：
- 不覆盖条件：

## 3. 接口
- 连接器/针序/观察方向：
- 电平/通信/时钟/复位：
- 输入电源/电流/保护/上下电顺序：

## 4. 机械
- 板框/孔位/高度：
- 插拔/线束/工具/治具空间：

## 5. 制造
- 数量：
- 装配范围：PCB only / SMT / 全焊（含 THT）
- 层数/铜厚/表面处理/特殊工艺：
- 整批预算（含 PCB/元件/加工/运费/税费口径）：

## 6. 证据与风险
- 参考工程/手册/许可：
- 关键未知：
- 用户确认（日期）：
