parkourlrc/pcb-yilv1982--duck-robot-89dbc81d6d/docs/references/飞特策略模型上机核对/hd1910-spec-power-excerpt-20261101.txt

Source: references\microduck-replica\tools\FeeTech_HD1910M_Servo\HD-1910-C001串型规格书20260907.pdf
PDF page 3, printed page 2/7
深圳飞特模型有限公司          
SHENZHEN FEETECH RC MODEL CO.,LTD.
版本EDITION：
A/0
型号/MODEL:
HD-1910-C001
产品规格书
PRODUCT SPECIFICATION
日期/Date：
2026-09-07
页    码 Page：2/7
1.使用环境条件 Apply Environmental Condition：
No. 项目(Item) 规格(Specification)
1-1 保存温度Storage Temperature Range -30℃～80℃
1-2 运行温度Operating Temperature Range -20℃～60℃
2.测试环境 Standard Test Environment：
No. 项目(Item) 规格(Specification)
2-1 温度 Temperature Range 25℃ ±5℃
2-2 湿度 Humidity Range 65%±10%
3.安全特性与认证 Secure Performance and Certificate
No. 项目/Item 认证Certificate 备注（remarks）
3-1 ASTM F963 No 美国玩具检测标准
3-2 EN71 No 欧盟市场玩具类产品的规范标准
3-3 FCC No 对电子、电器中的电磁干扰，管理和控制无线电频率范
围，保护电信网络、电器产品的正常工作。
3-4 ROHS Yes 电子，电器设备中对人体有害物质的含量。
3-5 REACH NO 欧盟法规《化学品的注册、评估、授权和限制》
4.外观检查 Appearance Inspection：
No. 项目(Item) 规格(Specification)
4-1 外观尺寸OutlineDrawing 尺寸见附件(第9项) See the appendix
4-2 外观Appearance 无损坏，不允许影响功能
No damage and mustn’t affect functions.
5.电气特性 Electrical Specification
No. 项目(Item) 规格(Specification)
5-1 工作电压范围 Working Voltage Range 4V-8.4V
5-2 典型工作电压 Operating Voltage 4.8V 6V 7.4V
5-3 空载速度 No Load Speed±10% 0.137sec/60°
(73RPM)
0.109sec/60°
(92RPM)
0.088sec/60°
(113RPM)
5-4 空载电流 Running Current ( no load) ≤160mA ≤180mA ≤210mA
5-5 堵转扭力±10% Stall Torque (at locked)
9kg.cm 12kg.cm 15kg.cm
124.99oz.in 166.65oz.in 208.32oz.in
5-6 堵转电流±10% Stall Current (at locked) 1.2A 1.6A 2A
5-7 静态电流 Idle Current (at stopped) 20mA 20mA 20mA
5-8 额定负载 Rated Torgue 2.2kg.cm 3kg.cm 3.7kg.cm
5-9 额定电流 Rated Current 500mA 690mA 900mA
5-10 Kt常数 7.5kg.cm/A

PDF page 5, printed page 4/7
深圳飞特模型有限公司          
SHENZHEN FEETECH RC MODEL CO.,LTD.
版本EDITION：
A/0
型号/MODEL:
HD-1910-C001
产品规格书
PRODUCT SPECIFICATION
日期/Date：
2026-09-07
页    码 Page：4/7
7-2. 控制特性Control Specification：
No. 项目(Item) 规格(Specification) 备注（remarks）
7-11 电子保护 Electronic Protection
过流 Over Current
运行中电流大于0.5A并持续
2s后，关闭输出并进入过流保
护，重新发位置指令，会清除过
流保护标志,可自定义设定电流
值和持续时间
(出厂默认关闭)
过压 Over Voltage
大于10V或者小于4V进入保护，
电压恢复正常范围后，自动解除
保护,可自定义设定电压值范围
(出厂默认关闭)
过热 Over Hot 大于80℃关闭扭矩输出
(出厂默认开启)
7-12 运行模式 Operating Modes
模式0：角度伺服模式 0-360度绝对位置可基于目标电
流进行限力控制
模式1：电机恒速模式 电机恒速模式，随负载增加，速
度维持不减速。
模式2：电机恒流模式 电机恒流模式，随负载增加，电
流维持不减
模式3：PWM开环调速度模式 占空比调压调速，无速度闭环，
转速随负载波动，无恒速特性
模式4：纯位置PD模式 
（Sim2Real )
采用比例-微分（P-D）位置闭环
控制(出厂默认此模式)
7-13 多圈模式 Multi-Loop Mode
最高精度下可以正负7圈绝
对位置控制，但掉电圈数不
保存
扩大分辨率，圈数可翻倍
