parkourlrc/pcb-yilv1982--duck-robot-89dbc81d6d/docs/references/舵机网页工具惯性显示/waveshare-bus-servo-adapter-a-schematic-20261025.txt

1
1
2
2
3
3
4
4
D D
C C
B B
A A
GND A1/B12VBUS A4/B9
CC1 A5DN2 B7DP1 A6DN1 A7
SBU1 A8
GND A12/B1
VBUS A9/B4
CC2 B5
DP2 B6
SBU2 B8
GND MTB
GND
C7
10uF
GND
IP1
IP0
R2 5.1K
R3
5.1K
GND
VDDUSB
VDDUSB
1
2
3
H3
1
2
3
H5
GND
DATA
GND
DATA
DC_IN0
DC_IN0
GND
TXD4
RXD5
UD+7
UD-8
GND0
V36
GND2
CTS 15
DTR 12
DCD 11
DSR 14
RI 16
VDD53
VIO1
VBUS 9
RTS 13
ACT# 10
U1
CH343P
GND
GND
3V3_OP
3V3_OP
CH_TXD
CH_RXD
VBUS
3V3_OP
C6
104
C2
1uFGND
GND
DTR
RTS
C1
1uFGND
C5
104
GND
USBD_N
USBD_P
USBD_N
USBD_P
G1
Vo2
Vi3
U2 AMS1117-3.3
GND
VDDUSB 3V3_OP
C3
10uF
C4
10uF
GND GND
1
2
3
DC1
DC005 5.5*2.1mm
1
2
H1
KF350-2P
GND
GND
DC_IN0
TXD
RXD
GND
R4
10K
R8
10K
Q1
MMBT3906R6
10K
R7
20K
GND
3V3
U1TXD
TXEN
3V3
R5
10K
OE1
A2
GND3 Y 4
VCC 5
U4
SN74LVC1G125DBV
U1TXD
TXEN
GND
DATA
TXEN
DATA
GND
U1RXD
3V3
3V3
C8
0.1uF
C9
0.1uF
GND
OE1
A2
GND3 Y 4
VCC 5
U3
SN74LVC1G126DBV
C10
1uF
MAX:6A
3V3
1
3
5
2
4
6
H4
1
2
3
H2
TXDRXD
U1TXDU1RXD
CH_TXDCH_RXD
S 1
S 2
S 3
G 4D5 D6 D7 D8
AO4407
M1
R1
2K
GND A1 K 2 D1 BZT52C6V8S
1 2
D4
B5819WS
1 2
D3
B5819WS
5V
DC_IN0
11
LS1
11
LS2
11
LS3
11
LS4
1 2
D2
B5819WS
Bus Servo Adapter (A)
VDDUSB
R9
1KΩ
A K
LED1
Red 0402
GND3V3
C14
0.1uF
C11
1uF
R10
10R
R11
56K
R14
10K
C1522uF/10V
4.7UH
L1
10uF/25V
C12
FB1:0.8V
C16
0.1uF
R12
100K
SWPA6020S4R7MT
SW 2
Vin1
GND3
BST 4
FB 6EN5
U5
R13
25K
C13
10pF
GND
GND
GND
DC_IN0 5V
C17
1uF
GND
1 2
D5
SMAJ15CA
GND
DC_IN0
PIC101PIC102COC1
PIC201PIC202COC2PIC301
PIC302
COC3
PIC401
PIC402
COC4
PIC501
PIC502COC5
PIC601
PIC602COC6
PIC701
PIC702
COC7
PIC801
PIC802
COC8
PIC901
PIC902
COC9
PIC1001
PIC1002
COC10
PIC1101
PIC1102COC11
PIC1201
PIC1202COC12
PIC1301
PIC1302COC13PIC1401
PIC1402
COC14
PIC1501
PIC1502COC15
PIC1601
PIC1602COC16
PIC1701
PIC1702
COC17
PID101
PID102
COD1
PID201
PID202
COD2
PID301 PID302
COD3
PID401 PID402
COD4
PID501
PID502
COD5
PIDC101
PIDC102
PIDC103
CODC1
PIH101
PIH102
COH1
PIH201
PIH202
PIH203
COH2
PIH301
PIH302
PIH303
COH3
PIH401 PIH402
PIH403 PIH404
PIH405 PIH406
COH4
PIH501
PIH502
PIH503
COH5
PIL101 PIL102
COL1
PILED10A PILED10K
COLED1
PILS101
COLS1
PILS201
COLS2
PILS301
COLS3
PILS401
COLS4
PIM101
PIM102
PIM103
PIM104PIM105
PIM106
PIM107
PIM108
COM1
PIQ101
PIQ102
PIQ103
COQ1
PIR101
PIR102
COR1
PIR201PIR202
COR2
PIR301PIR302
COR3
PIR401
PIR402
COR4 PIR501
PIR502
COR5
PIR601 PIR602
COR6
PIR701
PIR702
COR7 PIR801
PIR802
COR8
PIR901PIR902
COR9
PIR1001
PIR1002
COR10
PIR1101
PIR1102
COR11
PIR1201
PIR1202
COR12
PIR1301PIR1302
COR13
PIR1401
PIR1402
COR14
PIU100
PIU101
PIU102
PIU103
PIU104
PIU105PIU106PIU107PIU108
PIU109
PIU1010
PIU1011
PIU1012
PIU1013PIU1014PIU1015PIU1016COU1
PIU201PIU202PIU203
COU2
PIU301
PIU302
PIU303 PIU304
PIU305
COU3
PIU401
PIU402
PIU403 PIU404
PIU405
COU4
PIU501
PIU502
PIU503
PIU504
PIU505
PIU506
COU5
PIÌùÆ¬Ä¸×ù type C 16P0A10B12
PIÌùÆ¬Ä¸×ù type C 16P0A40B9
PIÌùÆ¬Ä¸×ù type C 16P0A5
PIÌùÆ¬Ä¸×ù type C 16P0A6
PIÌùÆ¬Ä¸×ù type C 16P0A7
PIÌùÆ¬Ä¸×ù type C 16P0A8
PIÌùÆ¬Ä¸×ù type C 16P0A90B4
PIÌùÆ¬Ä¸×ù type C 16P0A120B1
PIÌùÆ¬Ä¸×ù type C 16P0B5
PIÌùÆ¬Ä¸×ù type C 16P0B6
PIÌùÆ¬Ä¸×ù type C 16P0B7
PIÌùÆ¬Ä¸×ù type C 16P0B8
PIÌùÆ¬Ä¸×ù type C 16P0MTB
COÌùÆ¬Ä¸×ù type C 16P
PIC101
PIC201
PIC401
PIC602
PIC802PIC902PIC1002
PIQ102
PIR401
PIR502
PIR802
PIR902
PIU101
PIU103
PIU106
PIU202
PIU305
PIU405
NL3V30OP
PIC1302
PIC1502PIC1602
PID301
PIL102
PIR1101
PIH405
PIU105NLCH0RXD
PIH406
PIU104NLCH0TXD
PIH301
PIH501
PIR501PIU304
PIU402
NLDATA
PIC1202PIC1401
PID102
PID202
PID502PIDC101
PIH302
PIH502
PIM101
PIM102
PIM103
PIR1202
PIU501
PIU1012 NLDTR
PIC1301PIR1102
PIR1302
PIR1401
NLFB1:008V
PIC102
PIC202
PIC302 PIC402
PIC501
PIC601
PIC702
PIC801PIC901PIC1001
PIC1201PIC1402
PIC1501PIC1601
PIC1702
PID201
PID501
PIDC102
PIDC103
PIH101
PIH201
PIH303
PIH503
PILED10K
PIR102
PIR201
PIR301
PIR701
PIR1402
PIU100
PIU102
PIU201
PIU303
PIU403
PIU503
PIÌùÆ¬Ä¸×ù type C 16P0A10B12
PIÌùÆ¬Ä¸×ù type C 16P0A120B1
PIÌùÆ¬Ä¸×ù type C 16P0MTB
NLGND
PIR302PIÌùÆ¬Ä¸×ù type C 16P0A5NLIP0
PIR202PIÌùÆ¬Ä¸×ù type C 16P0B5NLIP1
PIC301PIC1701
PID302
PID402
PIU203
PIC1101
PIL101
PIU502
PIC1102PIR1001
PID101
PIM104
PIR101
PIH102
PIM105
PIM106
PIM107
PIM108
PILED10APIR901
PILS101 PILS201 PILS301 PILS401
PIQ101 PIR601
PIR1002
PIU504
PIR1201PIU505
PIR1301PIU506
PIU1010
PIU1011
PIU1014PIU1015PIU1016
PIÌùÆ¬Ä¸×ù type C 16P0A8
PIÌùÆ¬Ä¸×ù type C 16P0B8
PIU1013
NLRTS
PIH202
PIH401
NLRXD
PIH203
PIH402 NLTXD
PIQ103
PIR702
PIU301
PIU401
NLTXEN
PIH403
PIR801PIU404 NLU1RXD
PIH404
PIR402PIR602
PIU302NLU1TXD
PIU108
PIÌùÆ¬Ä¸×ù type C 16P0A7
PIÌùÆ¬Ä¸×ù type C 16P0B7
PIU107
PIÌùÆ¬Ä¸×ù type C 16P0A6
PIÌùÆ¬Ä¸×ù type C 16P0B6
PIC502
PIC701
PID401
PIU109
PIÌùÆ¬Ä¸×ù type C 16P0A40B9
PIÌùÆ¬Ä¸×ù type C 16P0A90B4
NLVBUS
