parkourlrc/pcb-yilv1982--duck-robot-89dbc81d6d/docs/references/扩展板电路仿真工具/qwiic-pinout-20261031/external-dependencies.md

# 外部依赖核查（2026-10-31）

> **2026-11-03状态更新：** 本页整体为历史审计/依赖记录；当前86654c03/r18与20261103-assembly包见[全目标审计](../../扩展板邮票孔与电源修复/full-goal-audit.md)、[22项](../../扩展板邮票孔与电源修复/requirements-status.md)与[真实剩余](../../扩展板邮票孔与电源修复/remaining-actions.md)。旧r1～r17拼板及b610/r14不作现行交付。历史blocked轮次不继承为当前计数，最新实际进展为Mask专项；不能以本页旧待办或旧审核状态覆盖当前。

## 当前阻塞及本轮分类

原目标仍为解决全部已知问题，包含制造条件和新板实际功能，不能只以CAD修复作为完成标准。

| 连续目标轮 | 工作分类 | 阻塞条件 |
|---|---|---|
| 1：用户确认状态后的整理轮 | 有进展：更新未送厂/无新板状态，补首板草案，生成只更新说明的CAM包 | 未落实工厂接受/装配条件，无新板；制造文件保持不变 |
| 2：外部依赖复核轮 | 无进展：公开资料补查未解决GPIO 5V电压窗口，已询问送审方式 | 没有新增工厂接受材料、实测或送审授权 |
| 3：本次阻塞审计 | 无进展：重新检查本地入口/包记录和当前对话，PCB及ZIP身份未变，送审问题仍未答复 | 同一外部条件未变；仍无新板，无可继续执行的已授权制造/实测步骤 |

同一真实外部条件已连续出现三个目标轮，且当前没有可独立推进的必要设计修复，满足blocked门槛；目标不能标为完成。没有已确认存活的制造、连接或实测任务句柄，因此这些轮次不计“已验证等待”。状态复述、写审计日志或重复相同CAD检查不计进展。本次将目标置为blocked，待实际输入变化后恢复；不是缩减目标，也不是认定剩余事项已通过。

历史上曾向用户请求选择送审方式；现已收到仅向嘉立创提交固定A.1包询评的明确授权，沿用即可，不重复询问。具体文件见[本地CAM包入口](../../../../hardware/custom_hat/release-review/README.md)；不将该授权扩大到建单、付款、公开发布或其他接收方。

首板实际功能还需要制造后的新板和实际供电/负载条件。现有白色HAT V1.2的测试不能代替A.1验证；此前两个SSH目标已终态超时，没有理由重复轮询或重新启动同一查询。

## Radxa官方页面补查

来源：[Radxa ZERO 3 hardware interface](https://docs.radxa.com/en/zero/zero3/hardware-design/hardware-interface)，2026-10-31读取，定位为Power、Debug Serial Port、GPIO voltage及GPIO interface。另核[资源下载页](https://docs.radxa.com/en/zero/zero3/download)Hardware Design段。来源类别为厂商公开文档，不是本机实测。两页原HTML归档为radxa-interface-20261031.html、radxa-download-20261031.html；HTTP 200、URL、SHA及定位摘录见[external-source-probe.json](external-source-probe.json)。

1. Power段写USB-C 1供电、仅支持5V，建议5V/2A或更高供电能力；没有在该段给出输入电压公差。不能把建议电源的电流额定当成本HAT输入端的台架限流设定。
2. GPIO表将pin2/4列为+5.0V；GPIO voltage段3.3V/3.63V针对逻辑GPIO，不能当作5V电源针的允许范围。
3. Debug Serial Port段再次确认UART2_M0兼作默认U-Boot console；这支持首板草案先核实际占用的要求，不说明用户现行系统仍占用，也不授权更改bootloader。
4. 资源页同时列3W V1.11与V1.12 AIC8800版图纸，不能只由网页推定用户板版本。本轮不重新下载或声称逐页核验这些PDF。

检索`site:docs.radxa.com "ZERO 3" "4.75"`、`site:radxa.com "ZERO 3W" "5.25"`及官方GPIO供电资料，网页工具未给出可用的补充电压窗口证据；后续直接读取以上两个厂商页面成功。此前“工具未返回页面”的失败记录仍作为当时历史事实，现行证据缺口应表述为“成功读取官方页面，仍未取得明确电压窗口”，不能再说所有网页均不可访问。没有据此声称已搜遍所有资料。

## 恢复推进所需的实际变化

当前无需恢复全量人工咨询：已修的窄land/拼板/格式不再列待办，继续核精确料号工艺缺口和极性尺寸，落实实际制造选择。新板到手后按最短验收执行，模拟和工艺自查不替代实物功能。
