parkourlrc/pcb-yilv1982--duck-robot-89dbc81d6d/docs/references/扩展板电路仿真工具/qwiic-pinout-20261031/review.md

# Rev A.1最终文件审查：J502与钢网

日期2026-10-31。PCB：`90f27091017525a22f45c8818c973c317ed6262387a98fdf06bdc26337dac2a6`。KiCad 10.0.7；kicad-happy固定提交`2fd9aa0fe2d620f36627d9221e8b1393987ae38e`。

**结论：[文件/原厂图/工具核对] J502针序和C307钢网遗漏已修正，A.1同版输出通过原生与逐项审计。制造/装配接受及实物功能仍未放行。** 下述自动告警有误报、条件风险和未验事项，不能把数量或分数直接当真实缺陷数。

## 本轮关闭的实际问题

1. 原J502为3V3/GND/SCL/SDA，不能当标准Qwiic直插。现改为GND/3V3/SDA/SCL，依据SparkFun原图第1/2页的直角/垂直接口针号，均已打开核对。四针连到J101/codec/BMI088正确网络，旧版与A.1有明确板面标记区别。
2. C307虽为DNP，旧F.Paste仍有两个开口。现按不贴装意图排除它们；同一A.1基线的其它拟装开口、铜/阻焊/丝印/板框输出几何保持。不能将这项“仅改paste”的比较误说成J502改线也没有铜变化。

旧连接检查已明确允许J502四针改网、5段局部旧线移除、6段新线和一枚3.3V via移动0.1mm。其它焊盘/元件位置、旧铜对象、旧焊盘连接、项目/DRU及6处POFV要求保持；I2S参考铜逐点无损失且覆盖长度差均0。当前72封装、1130线段、100贯通via，17地via，无盲/埋/微孔。

## 运行与核查清单

| 项目 | 结果 | 覆盖范围/限制 |
|---|---|---|
| KiCad完整工程 | DRC0、未连接0、parity0、ERC0、netlist mismatch0 | 重铺铜保存，DRU哨兵加载证据/规则SHA匹配 |
| 原生几何/连接 | 通过 | 除明确J502修改外，原对象/非J502连接保持；不代表实际阻抗 |
| schematic analyzer | 44项：0 error/3 warning/41 info | 与前次相同，不能检查接口标准是否选错 |
| PCB full | 59项：3 error/15 warning/41 info | 主要剩余项与前次相同，后述分类 |
| cross | 2 warning | 平面图与地via的近似识别限制保持 |
| EMC | 53项：7 error/33 warning/13 info | 与前次相同，是风险提示而非EMI测量 |
| thermal | 无自动告警，模型0.028W | 只涉及两个元件且负载假设不足，不能作为整板热验收 |
| Gerber | 2 warning | F paste比例从61/225变为59/225；DNP去开口导致，不是拟装件漏印 |
| SPICE/ngspice | 12个理想子电路pass | 不覆盖整体稳压环、实际RESET/I2S、功放/传感器功能 |
| 生命周期 | 相同35个MPN身份复用既有unknown结果 | 没有新查询或库存/在产保证 |
| prior delta | 已运行 | 自动发现计数未捕获全部针网变化，四针差异以原生契约/原厂图对照为准 |
| fab gate | 10 pass/1 warn/1 fail | 原始数量口径FAIL与工艺warn保留，不能当生产放行 |
| 钻孔 | 163圆孔逐项匹配，159 PTH+4 NPTH | 包含本次普通via移动，6处POFV坐标保持 |
| BOM/装配/源绑定 | 58拟装、38组、35唯一MPN；52 SMT+6 THT，C307 DNP | 由final-audit.json核字段、坐标、源/产物SHA与钢网策略；不等于实装 |

已运行全部上述适用分析器；deep_review记录本轮接口/钢网发现。原器件型号/数值、主电源架构和其它关键管脚没有改动，既有[电源分析](../power-acceptance-20261031/research.md)、[制造规则](../npth-clearance-20261031/research.md)和[此前复审](../codec-reset-20261031/review.md)按相同条件继续作为依据，不冒称本轮重新逐页验证所有元件。

deep_review gate接收2项、0隔离；该gate只核证据锚点/脚本路径等，不代表工厂或硬件通过。原厂接口图、原生图纸、双面装配图与C307前后锡膏局部均已打开检查。

## 自动提示分类与剩余边界

- **DS-002**：PDF在专题sources目录，工具默认datasheets目录未识别。人工声明只覆盖实际核对的资料/页码，不能用MPN覆盖率替代电气验证。
- **RS-001**：+5V_FB为反馈分压，SERVO_VBAT由铜跳线供电，不由缺power_out符号判成真实断电。
- **PS-002/VS-002**：原生3.3V焊盘同组，17地via存在；不按近似岛数/“没有stitch”说电源断网，也不把直流同组当高频回流通过。
- **CC-002**：0.15mm信号线符合现行规则。需按信号/负载判断，不机械改所有细线以清除通用提示。
- **DFM-001/002**：codec唯一0.15mm机械小孔、0.1mm名义环宽和6处POFV是真实工艺条件，待工厂接受；其余99via常规规则不降低。
- **PM-002**：FID/排母等距边触发工具默认阈值；原生边距规则和已核实体外形分别成立，夹持/拼板/实装高度仍待接受。
- **TV-001**：不对codec/TO-252套用统一5/18孔最低数。真实功耗与温升仍待验证。
- **GR-004**：当前F59/B128开口已逐项与原native图去DNP后对照，拟装件未丢失。225个F铜flash包含via/THT/其它对象，比例不是SMT覆盖率。
- **EMC error/warning**：仍保留参考铜/外部接口/层转换风险；Class-D扬声器对不能只按普通数据差分对评分判坏。没有EMI试验或场求解。
- **fab gate数量**：原理图/PCB因board-only件及DNP统计口径不同；逐位号/坐标对照无缺失。门禁原始FAIL保留，不修改计数或关闭规则来伪造放行。

## 软件适用性

J101、U701、U501及音频模拟链没有改网，变化仅在外部J502四针及其局部引线。旧软件审计保留于software-before-a1/；codec overlay已重新核当前net-contract，模块、IMU及音频路由工具的只读适用性审计绑定A.1完整源指纹和原生检查。编译/ABI/模拟场景不升级为实际加载或功能验收。

## 尚未完成

制造商对孔/land/POFV/层叠/铜厚及装配的接受，输入配对/保护/并发负载条件，实际主控环境、I2S/RESET波形、音频/TTL/IMU/ToF/供电/温升与装配验证仍缺实际证据。R05仅是外设扩展，不含板载ToF模块本体；J504耳机用途未确认，不当作已明确的性能要求或已测故障。

[用户确认，2026-10-31] 自主HAT尚未送厂、没有新板实物；此答复替代此前待确认状态。原目标核对见[完成情况审计](completion-audit.md)，制造后验收见[最短首板草案](../../../specs/20261028-custom-hat/first-article-a1.md)。没有发出上传/下单/上电操作，本次改动保留工作区，未提交或推送。
