parkourlrc/pcb-yilv1982--duck-robot-89dbc81d6d/docs/references/社区惯性单元通讯核查/sources/jyg9--hardware--imu_to_dxl--README.md

# "imu_to_dxl" IMU转舵机协议板

> "imu_to_dxl"固定在电池背面，提供精确的机器鸭身体姿态反馈数据

3d view

功能如下：
- **供电电压**：5~36V
- **通讯方式**：舵机单总线TTL串口，3.3V电平
- **电源转换效率**：>90%

对应固件在firmware/v1目录下

## 其他信息
 - 使用KiCAD 9设计。
