parkourlrc/pcb-yilv1982--duck-robot-89dbc81d6d/docs/references/扩展板电路仿真工具/metadata-repair-20261030/sources/radxa_zero_3w_schematic_v1.11_20250116.txt

PAGE 1
Radxa ZERO 3W
V1.11
Schematic

PAGE 2
5
5
4
4
3
3
2
2
1
1
D
D
C
C
B
B
A
A
01.cover
02.Index
03.Block Diagram
04.RK3566_SARADC/GPIO
05.RK3566_USB/PCIe/SATA PHY
06.RK3566_OSC/PLL/PMUIO
07.RK3566_Power/GND
08.RK3566_DDR PHY
09.RK3566_VI Interface
10.RK3566_VO Interface_1
11.RK3566_VO Interface_2
12.RK3566_Audio Interface
13.RK3566_Flash/SD
14.LPDDR4_1X32bit
15.SPI Flash/eMMC
16.MicroSD Card
17.TYPEC_USB3.0
18.HDMI2.0 TX
19.WIFI/BT-SDIO
20.CONNECTOR
21.Power_PMIC
22.Power_DC IN
Table of Content
Size
REV
Date:
Sheet
of
Title:
Page Name:
Index
V1.11
 Zero 3W
A4
02
22
Thursday, September 21, 2023
Size
REV
Date:
Sheet
of
Title:
Page Name:
Index
V1.11
 Zero 3W
A4
02
22
Thursday, September 21, 2023
Size
REV
Date:
Sheet
of
Title:
Page Name:
Index
V1.11
 Zero 3W
A4
02
22
Thursday, September 21, 2023

PAGE 3
5
5
4
4
3
3
2
2
1
1
D
D
C
C
B
B
A
A
SDMMC0 x 4bit
5V DC IN
RK817-5
PMIC+Codec
32.768KHz
Power for RK3566
WIFI/BT
USB2_OTG
Micro 
TF Card
eMMC
UART2
LPDDR4
HDMI2.0 
TX
MICRO HDMI2.0 TX 
ROCK 3 Zero W Ref Block Diagram
Rockchip
RK3566
MIPI
DSI
TX0
MIPI
CSI
RX
VCCIO6
PMUIO1
PMUIO2
OSC
SDMMC1
USB2
OTG
VCCIO3
VCCIO4
VCCIO2
DDR
DQ8-15
_B
DDR
DQ0-7
_B
DDR
PHY 
CA/CLK
DDR
DQ0-7
_A
DDR
DQ8-15
_A
USB2
HOST2
HDMI
24MHz
USB
HOST3
32.768KHz OUT
I2C0/Sleep/INT
RESETn
x 8bit
22PIN FPC
4 Lane MIPI CSI _RX
PCIE2.0
USB
HOST1
40pin Connecting Base
I/O
USB2.0
OTG
USB3.0
I/O
TYPEC
USB3.0
SS
MIPI_CSI_RX
40MHz
Size
REV
Date:
Sheet
of
Title:
Page Name:
Block Diagram
V1.11
Zero 3W
A3
03
22
Thursday, January 16, 2025
Size
REV
Date:
Sheet
of
Title:
Page Name:
Block Diagram
V1.11
Zero 3W
A3
03
22
Thursday, January 16, 2025
Size
REV
Date:
Sheet
of
Title:
Page Name:
Block Diagram
V1.11
Zero 3W
A3
03
22
Thursday, January 16, 2025

PAGE 4
5
5
4
4
3
3
2
2
1
1
D
D
C
C
B
B
A
A
RK3566_K(VCCIO4 Domain)
RK3566_O(SARADC/OTP)
RK3566_N(VCCIO7 Domain)
BOM_ID
HW_ID
VCCA_1V8
VCCA_1V8
VCC_3V3
VCCIO_WL
VCCA_1V8
VCCA_1V8
VCC_3V3
VCC_1V8
SDMMC1_CLK
GPIO4_D1_3V3
HDMITX_SCL
HDMITX_SDA
SDMMC1_D0
SDMMC1_D1
SDMMC1_D2
SDMMC1_D3
SDMMC1_CMD
UART1_RX_M0
UART1_TX_M0
UART1_CTSn_M0
I2S2_SCLK_TX_M0
I2S2_LRCK_TX_M0
I2S2_SDO_M0
I2S2_SDI_M0
SARADC_VIN1
SARADC_VIN2
UART1_RTSn_M0
GPIO4_C2_3V3
GPIO4_C3_3V3
GPIO4_C5_3V3
GPIO4_C6_3V3
SARADC_VIN1
SARADC_VIN2
SARADC_VIN0_KEY/RECOVERY
Size
REV
Date:
Sheet
of
Title:
Page Name:
RK3566_SARADC/GPIO
V1.11
Zero 3W
A3
04
22
Thursday, September 21, 2023
Size
REV
Date:
Sheet
of
Title:
Page Name:
RK3566_SARADC/GPIO
V1.11
Zero 3W
A3
04
22
Thursday, September 21, 2023
Size
REV
Date:
Sheet
of
Title:
Page Name:
RK3566_SARADC/GPIO
V1.11
Zero 3W
A3
04
22
Thursday, September 21, 2023
R9
NC
C53
100nF
10V
SARADC
OTP
Recovery/
RK3566
U1O
SARADC_VIN0
1D17
SARADC_VIN1
1C17
SARADC_VIN2
1B18
SARADC_VIN3
1A19
SARADC_AVDD_1V8
1D16
OTP_VCC18
1D15
C55
1nF
TP1
R90728
NC
R25
10K
1%
C54
100nF
10V
C56
100nF
10V
R24
22R
VCCIO7 Domain
Operating Voltage=1.8V/3.3V
HDMITX_SDA
PWM13_M1
/
I2S3_SCLK_M1
PWM12_M1
I2S3_MCLK_M1
I2S3_SDO_M1
/
/
UART9_RX_M1
/
/
/
/
/
I2C5_SCL_M1
/
HDMITX_CEC_M0
/
I2S3_SDI_M1
/
/
PWM14_M1
SPDIF_TX_M2
/
/
/
EDP_HPDIN_M0
SPI3_CLK_M1
/
/
/
HDMITX_SCL
SPI3_CS1_M1
I2S3_LRCK_M1
SPI3_CS0_M1
SPI3_MISO_M1
/
SATA0_ACT_LED
/
/
SPI3_MOSI_M1
/
SATA2_ACT_LED
/
PWM15_IR_M1
/
SATA1_ACT_LED
UART9_TX_M1
/
I2C5_SDA_M1
/
RK3566
U1N
GPIO4_C2_d
1U7
GPIO4_C3_d
AP12
GPIO4_C4_d
1V6
GPIO4_C5_d
1U6
GPIO4_C6_d
1T6
GPIO4_C7_u
AR12
GPIO4_D0_u
AP11
GPIO4_D1_u
1V5
VCCIO7
1N8
R28
10K
1%
R27
51K
1%
Operating Voltage=1.8V/3.3V
VCCIO4 Domain
SPI2_CLK_M0
I2C4_SDA_M1
/
/
SPI2_CS0_M0
/
/
SDMMC1_PWREN
/
I2S2_LRCK_RX_M0
UART6_RTSn_M0
/
/
/
/
/
SPI2_CS1_M0
SPI1_CS1_M0
UART8_CTSn_M0
UART6_RX_M0
/
/
SDMMC1_D3
I2S2_SDI_M0
UART9_RX_M0
SPI1_MOSI_M0
UART9_CTSn_M0
SPI2_MOSI_M0
/
/
/
I2C4_SCL_M1
/
UART6_TX_M0
/
CLK32K_OUT1
UART1_TX_M0
SDMMC1_CMD
SDMMC1_D0
/
/
/
UART1_RX_M0
/
SPI2_MISO_M0
SDMMC1_D1
UART9_RTSn_M0
/
/
UART9_TX_M0
UART6_CTSn_M0
/
UART7_RTSn_M0
SDMMC1_D2
I2S2_MCLK_M0
SPI1_CLK_M0
I2S2_SCLK_TX_M0
UART8_RX_M0
SDMMC1_CLK
UART7_CTSn_M0
I2S2_SDO_M0
/
UART7_RX_M0
I2S2_LRCK_TX_M0
SPI1_CS0_M0
UART8_TX_M0
UART1_CTSn_M0
UART1_RTSn_M0
/
/
SPI1_MISO_M0
/
UART8_RTSn_M0
/
/
UART7_TX_M0
SDMMC1_DET
/
I2S2_SCLK_RX_M0
/
/
/
/
/
/
/
/
/
/
/
/
/
/
/
/
/
/
/
/ ETH0_REFCLKO_25M
RK3566
U1K
GPIO2_A3_u
1C19
GPIO2_A4_u
1E18
GPIO2_A5_u
1D18
GPIO2_A6_u
1A20
GPIO2_A7_u
B35
GPIO2_B0_d
B37
GPIO2_B1_d
A35
GPIO2_B2_u
B34
GPIO2_B3_u
1C20
GPIO2_B4_u
F38
GPIO2_B5_u
F37
GPIO2_B6_u
G37
GPIO2_B7_d
D38
GPIO2_C0_d
A37
GPIO2_C1_d
B36
GPIO2_C2_d
C37
GPIO2_C3_d
1D19
GPIO2_C4_d
1B20
GPIO2_C5_d
D37
GPIO2_C6_d
B38
VCCIO4
1E16
C65
NC
10V
R10
0R
R30
NC
1%
R29
51K
1%

PAGE 5
5
5
4
4
3
3
2
2
1
1
D
D
C
C
B
B
A
A
RK3566_U
RK3566_V
USB3_AVDD_1V8
USB3_AVDD_3V3
USB3_AVDD_0V9
VDDA_0V9
VCCA_1V8
VCC_3V3
VDDA_0V9
VCCA_1V8
USB3_AVDD_1V8
USB3_AVDD_0V9
USB3_AVDD_3V3
USB_OTG0_DP
USB_OTG0_DM
USB_OTG0_VBUSDET
USB3_HOST1_DP
USB3_HOST1_DM
USB3_HOST1_SSTXP
USB3_HOST1_SSTXN
USB3_HOST1_SSRXP
USB3_HOST1_SSRXN
USB_OTG0_ID
USB2_HOST2_DP
USB2_HOST2_DM
Size
REV
Date:
Sheet
of
Title:
Page Name:
RK3566_USB/PCIe/SATA PHY
V1.11
Zero 3W
A4
05
22
Thursday, September 21, 2023
Size
REV
Date:
Sheet
of
Title:
Page Name:
RK3566_USB/PCIe/SATA PHY
V1.11
Zero 3W
A4
05
22
Thursday, September 21, 2023
Size
REV
Date:
Sheet
of
Title:
Page Name:
RK3566_USB/PCIe/SATA PHY
V1.11
Zero 3W
A4
05
22
Thursday, September 21, 2023
R19
1R 1%
R21
0R
C44
100nF
10V
C46
100nF
10V
C49
DNP
10V
USB2.0 OTG_0
HS/FS/LS
USB2.0 Power
HS/FS/LS
USB2.0 HOST_1
(Download Port)
MULTI PHY U_S
MULTI PHY P_S
MULTI PHY Power
(DP/DM for USB3.0 HOST)
(SS for USB3.0 HOST or SATA3_1)
(PCIE2.0 or SATA3_2)
(for OTG_0 and HOST_1)
(for MULTI PHY U_S and P_S)
RK3566
U1U
USB_OTG0_DP
R37
USB_OTG0_DM
R38
USB_OTG0_VBUSDET
T38
USB_OTG0_ID
T37
USB_HOST1_DP
1J19
USB_HOST1_DM
1J20
USB_AVDD1_0V9
1J17
USB_AVDD1_1V8
1H16
USB_AVDD1_3V3
1H18
USB3_HOST1_SSTXp/SATA1_TXp
W37
USB3_HOST1_SSTXn/SATA1_TXn
W38
USB3_HOST1_SSRXp/SATA1_RXp
V38
USB3_HOST1_SSRXn/SATA1_RXn
V37
MULTI_PHY_AVDD_0V9
1K16
MULTI_PHY_AVDD_1V8
1K17
PCIE20_TXp/SATA2_TXp
AA37
PCIE20_TXn/SATA2_TXn
AA38
PCIE20_RXp/SATA2_RXp
AB37
PCIE20_RXn/SATA2_RXn
AB38
PCIE20_REFCLKp
1K19
PCIE20_REFCLKn
1K20
C50
DNP
10V
R20
1R 1%
USB2.0
(for HOST_2 and HOST_3)
RK3566
U1V
USB_HOST2_DP
V2
USB_HOST2_DM
V1
USB_HOST3_DP
Y2
USB_HOST3_DM
Y1
USB_AVDD2_0V9
1J4
USB_AVDD2_1V8
1J3
USB_AVDD2_3V3
1J2
C45
100nF
10V
C47
100nF
10V
C48
DNP
10V
C51
100nF
10V
C52
100nF
10V

PAGE 6
5
5
4
4
3
3
2
2
1
1
D
D
C
C
B
B
A
A
RK3566(OSC/PLL/PMUIO1/2)
VCCA1V8_PMU
VDDA0V9_PMU
VDDA_0V9
VCCA_1V8
PMUIO1
VCC3V3_PMU
VDDA0V9_PMU
VCCA1V8_PMU
VCCA1V8_PMU
VCCA1V8_PMU
VCC3V3_PMU
VCCA1V8_PMU
VCC3V3_PMU
VCC3V3_PMU
RESETn
FLASH_VOL_SEL
PMIC_SLEEP_H
PMIC_INT_L
SDMMC0_DET_L
I2C0_SCL_PMIC
I2C0_SDA_PMIC
PMIC_32KOUT_SOC
USER_LED2
WIFI_WAKE_HOST_H_GPIO2_B2
WIFI_REG_ON_H_GPIO2_B1
BT_REG_ON_H_GPIO2_B7
BT_WAKE_HOST_H_GPIO2_C0
USB3.0_EN_H
HOST_WAKE_BT_H_GPIO2_C1
UART2_RX_MO
UART2_TX
UART2_TX_MO
FLASH_VOL_SEL
UART2_RX_MO
UART2_RX
UART2_TX_MO
WIFI_IO
WIFI_RESET
Size
REV
Date:
Sheet
of
Title:
Page Name:
RK3566_OSC/PLL/PMUIO
V1.11
Zero 3W
A3
06
22
Thursday, September 21, 2023
Size
REV
Date:
Sheet
of
Title:
Page Name:
RK3566_OSC/PLL/PMUIO
V1.11
Zero 3W
A3
06
22
Thursday, September 21, 2023
Size
REV
Date:
Sheet
of
Title:
Page Name:
RK3566_OSC/PLL/PMUIO
V1.11
Zero 3W
A3
06
22
Thursday, September 21, 2023
R2
0R
ED2
BTR04G02
R8
2.2K
C39
100nF
10V
ED1
BTR04G02
Q2
2SK3018
3
1
2
R4
1M
R11
10K
C30
100nF
10V
R14
10K
R104
10K
R3
22R
Q1
2SK3018
3
1
2
C34
100nF
10V
R6
0R
R7
2.2K
C37
100nF
10V
R12
22K
R15
22K
R106
NC
R5
0R
R13
100R
C41
1uF
10V
C35
1uF
10V
C32
100nF
10V
C28
18pF
50V
C31
1uF
10V
C36
100nF
10V
C33
1uF
10V
Y1
24MHz
X1
1
GND
2
X2
3
GND
4
C27
100nF
10V
C40
100nF
10V
R16
100R
C38
1uF
10V
C29
18pF
50V
/
/
/
TSADC_SHUT_M0
SDMMC0_DET
/
/
REFCLK_OUT
FLASH_VOL_SEL
SATA_MP_SWITCH
TSADC_SHUT_M1
/
/ SATA_CP_DET
/
SATA_CP_POD
/
TSADC_SHUT_ORG
SDMMC0_PWREN
/
PCIE20_CLKREQn_M0
/
/
PCIE20_WAKEn_M0
UART0_TX
I2C0_SDA
/
SPI0_CLK_M0
MCU_JTAG_TRSTn
I2C1_SCL
/
/
/
GPUAVS
UART0_CTSn
NPUAVS
SPI0_CS0_M0
MCU_JTAG_TCK
/
/
/
MCU_JTAG_TDI
/
/
UART2_RX_M0
SPI0_MOSI_M0
UART2_TX_M0
/
CPUAVS
/
CLK32K_OUT0
MCU_JTAG_TDO
I2C1_SDA
/
/
/
I2C2_SCL_M0
/
SPI0_MISO_M0
/
PCIE20_PERSTn_M0
/
/
I2C0_SCL
I2C2_SDA_M0
PCIE20_BUTTONRSTn
/
SPI0_CS1_M0
UART0_RX
/
UART0_RTSn
VOP_PWM_M0
/
/
/
/
MCU_JTAG_TMS
HDMITX_CEC_M1
CLK32K_IN
/
PMU PLL
SYS PLL
OSC
PMUIO1 Domain
Operating Voltage=3.3V Only
PMUIO2 Domain
Operating Voltage=1.8V/3.3V
PMIC_SLEEP
Operating Voltage=0.9V
PMUIO1/2/OSC Domain Logic Power
/
/
/
/
EDP_HPDIN_M1
/
/
PWM2_M1
PWM1_M1
PWM3_IR
PWM4
PWM7_IR
PWM2_M0
PWM5
PWM0_M1
PWM0_M0
PWM1_M0
PWM6
/
/
/
/
/
/
/
/
/
/
/
/
/
/
/
/
/
/
/
/
/
GPU_PWREN
(PMUPLL_AVDD_1V8)
Operating 
Voltage
=1.8V Only
RK3566
U1G
XOUT24M
AD38
XIN24M
AD37
PMUPLL_AVDD_0V9
1P17
PMUPLL_AVDD_1V8
1N18
PMUPLL_AVSS
1N17
SYSPLL_AVDD_0V9
1H5
SYSPLL_AVDD_1V8
1H4
nPOR_u
AG38
TVSS
1M18
SYSPLL_AVSS
1J5
GPIO0_A7_u
AF38
GPIO0_A0_d
1P18
GPIO0_A1_z
1R20
GPIO0_A2_d
1P19
GPIO0_A3_u
1R19
GPIO0_A4_u
AF37
GPIO0_A5_d
AG37
GPIO0_A6_d
AJ38
PMUIO1
1P16
GPIO0_B0_u
1T20
GPIO0_B1_u
AJ37
GPIO0_B2_u
AK38
GPIO0_B3_u
AK37
GPIO0_B4_u
AM38
GPIO0_B5_u
1U20
GPIO0_B6_u
1R16
GPIO0_B7_d
1R17
GPIO0_C0_d
1T19
GPIO0_C1_d
1R18
GPIO0_C2_d
AM37
GPIO0_C3_d
AN38
GPIO0_C4_d
AN37
GPIO0_C5_d
1U19
GPIO0_C6_d
1T18
GPIO0_C7_d
1V20
GPIO0_D0_u
1V19
GPIO0_D1_u
1U18
PMUIO2
1N15
PMU_VDD_LOGIC_0V9
1N16
GPIO0_D3_d
1N19
GPIO0_D4_d
1M19
GPIO0_D5_d
1N20
GPIO0_D6_d
1P20
XOUT24M
XIN24M
DFTJTAG_TRSTn_d
TSADC_SHUT_M0
I2C0_SCL_PMIC
I2C0_SDA_PMIC

PAGE 7
5
5
4
4
3
3
2
2
1
1
D
D
C
C
B
B
A
A
RK3566_ABCDE
(Power&GND)
VDD_CPU
VDD_LOGIC
VDD_GPU_NPU
VDD_GPU_NPU
Size
REV
Date:
Sheet
of
Title:
Page Name:
RK3566_Power/GND
V1.11
Zero 3W
A4
07
22
Thursday, September 21, 2023
Size
REV
Date:
Sheet
of
Title:
Page Name:
RK3566_Power/GND
V1.11
Zero 3W
A4
07
22
Thursday, September 21, 2023
Size
REV
Date:
Sheet
of
Title:
Page Name:
RK3566_Power/GND
V1.11
Zero 3W
A4
07
22
Thursday, September 21, 2023
RK3566
U1C
VSS_51
1E17
VSS_52
1F6
VSS_53
1F7
VSS_54
1F8
VSS_55
1F9
VSS_56
1F10
VSS_57
1F15
VSS_58
1F16
VSS_59
1G3
VSS_60
1G6
VSS_61
1G7
VSS_62
1G8
VSS_63
1G9
VSS_64
1G10
VSS_65
1G11
VSS_66
1G12
VSS_67
1G14
VSS_68
1H1
VSS_69
1H2
VSS_70
1H6
VSS_71
1H11
VSS_72
1H12
VSS_73
1H13
VSS_74
1J1
VSS_75
1J6
VSS_76
1J8
VSS_77
1J9
VSS_78
1J11
VSS_79
1J12
VSS_80
1J13
VSS_81
1K2
VSS_82
1K3
VSS_83
1K4
VSS_84
1K5
VSS_85
1K6
VSS_86
1K8
VSS_87
1K9
VSS_88
1K11
VSS_89
1K12
VSS_90
1K13
VSS_91
1K14
VSS_92
1K15
VSS_93
1L3
VSS_94
1L6
VSS_95
1L10
VSS_96
1L11
VSS_97
1L12
VSS_98
1L13
VSS_99
1L14
VSS_100
1L15
C12
22uF
6.3V
C4
4.7uF
6.3V
RK3566
U1A
VDD_CPU_1
1C12
VDD_CPU_2
1D11
VDD_CPU_3
1D12
VDD_CPU_4
1E11
VDD_CPU_5
1E12
VDD_CPU_6
1E13
VDD_CPU_7
1F11
VDD_CPU_8
1F12
VDD_LOGIC_1
1H7
VDD_LOGIC_2
1H8
VDD_LOGIC_3
1H9
VDD_LOGIC_4
1H10
VDD_LOGIC_5
1J7
VDD_LOGIC_6
1J10
VDD_LOGIC_7
1K7
VDD_LOGIC_8
1K10
VDD_LOGIC_9
1L7
VDD_NPU_1
1G15
VDD_NPU_2
1H14
VDD_NPU_3
1H15
VDD_NPU_4
1J14
VDD_NPU_5
1J15
VDD_GPU_1
1L8
VDD_GPU_2
1L9
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
CIF_D13
/
/
/
/
/
GMAC1_RXD1_M1
/
VOP_BT656_D0_M1
SDMMC2_CMD_M0
CIF_D3
CIF_D9
/
ISP_FLASHTRIGOUT
/
/
/
/
EBC_SDCLK
/
EBC_SDDO8
/
GMAC1_RXD3_M1
EBC_SDCE2
/
/
/
SDMMC2_PWREN_M0
UART1_RX_M1
UART9_TX_M2
/
/
CIF_D5
/
/
CIF_D0
/
/
/
/ VOP_BT656_CLK_M1
RK3566
U1M
GPIO3_C6_d
1T2
GPIO3_C7_d
1U1
GPIO3_D0_d
AP1
GPIO3_D1_d
AN2
GPIO3_D2_d
AM2
GPIO3_D3_d
AM1
GPIO3_D4_d
1R2
GPIO3_D5_d
1T1
GPIO3_D6_d
AL2
GPIO3_D7_d
AL1
GPIO4_A0_d
AK2
GPIO4_A1_d
1P2
GPIO4_A2_d
1R1
GPIO4_A3_d
AJ2
GPIO4_A4_d
1N2
GPIO4_A5_d
AJ1
GPIO4_A6_d
AH2
GPIO4_A7_d
1N1
GPIO4_B0_d
1L2
GPIO4_B1_d
AG2
GPIO4_B2_d
AF2
GPIO4_B3_d
AE2
GPIO4_B4_d
AF1
GPIO4_B5_d
AD1
GPIO4_B6_d
1L1
GPIO4_B7_d
AC2
GPIO4_C0_d
AB2
GPIO4_C1_d
AB1
VCCIO6_1
1L4
VCCIO6_2
1L5
C61
100nF
10V
J7
FPC-22P-0D5MM
GND1
1
DN0
2
DP0
3
GND2
4
DN1
5
DP1
6
GND3
7
CN
8
CP
9
GND4
10
DN2
11
DP2
12
GND5
13
DN3
14
DP3
15
GND6
16
GPIO0
17
GPIO1
18
GND7
19
I2C_SCL
20
I2C_SDA
21
VCC
22
GND9
23
GND8
24
R35
2.2K
R38
2.2K
C57
100nF
10V
R130
FB120R
C58
100nF
10V
R36
2.2K
R37
2.2K
C225
1uF
MIPI CSI RX
RK3566
U1P
MIPI_CSI_RX_D0p
AP18
MIPI_CSI_RX_D0n
AR18
MIPI_CSI_RX_D1p
AR17
MIPI_CSI_RX_D1n
AP17
MIPI_CSI_RX_D2p
AP15
MIPI_CSI_RX_D2n
AR15
MIPI_CSI_RX_D3p
AR14
MIPI_CSI_RX_D3n
AP14
MIPI_CSI_RX_CLK0p
1V9
MIPI_CSI_RX_CLK0n
1U9
MIPI_CSI_RX_CLK1p
1V8
MIPI_CSI_RX_CLK1n
1U8
MIPI_CSI_RX_AVDD_0V9
1N9
MIPI_CSI_RX_AVDD_1V8
1P9
I2C2_SDA_M1
I2C2_SCL_M1

PAGE 10
5
5
4
4
3
3
2
2
1
1
D
D
C
C
B
B
A
A
RK3566_T(eDP/DP TX)
RK3566_S(MIPI_DSI_TX1/LVDS_TX1)
RK3566_R(MIPI_DSI_TX0/LVDS_TX0)
RK3566_Q(HDMI2.0 TX)
VDDA_0V9
MIPI_AVDD_1V8
VDDA_0V9
VCCA1V8_IMAGE
VCCA1V8_IMAGE
VDDA_0V9
MIPI_AVDD_1V8
VDDA_0V9
VCCA1V8_IMAGE
HDMI_TX_HPDIN
HDMI_TX2N_PORT
HDMI_TX2P_PORT
HDMI_TX1N_PORT
HDMI_TX1P_PORT
HDMI_TX0N_PORT
HDMI_TX0P_PORT
HDMI_TXCLKN_PORT
HDMI_TXCLKP_PORT
Size
REV
Date:
Sheet
of
Title:
Page Name:
RK3566_VO Interface_1
V1.11
Zero 3W
A3
10
22
Thursday, September 21, 2023
Size
REV
Date:
Sheet
of
Title:
Page Name:
RK3566_VO Interface_1
V1.11
Zero 3W
A3
10
22
Thursday, September 21, 2023
Size
REV
Date:
Sheet
of
Title:
Page Name:
RK3566_VO Interface_1
V1.11
Zero 3W
A3
10
22
Thursday, September 21, 2023
L5
BCMF062P120T
R76
NC
MIPI DSI TX1
RK3566
U1S
MIPI_DSI_TX1_D0p
AP24
MIPI_DSI_TX1_D0n
AR24
MIPI_DSI_TX1_D1p
AR23
MIPI_DSI_TX1_D1n
AP23
MIPI_DSI_TX1_D2p
AP21
MIPI_DSI_TX1_D2n
AR21
MIPI_DSI_TX1_D3p
AR20
MIPI_DSI_TX1_D3n
AP20
MIPI_DSI_TX1_CLKp
1V11
MIPI_DSI_TX1_CLKn
1U11
MIPI_DSI_TX1_AVDD_0V9
1N10
MIPI_DSI_TX1_AVDD_1V8
1R10
R75
NC
C70
DNP
10V
C62
100nF
10V
C63
100nF
10V
R49
1.62K
1%
L6
BCMF062P120T
MIPI DSI TX0/LVDS TX0
RK3566
U1R
MIPI_DSI_TX0_D0p/LVDS_TX0_D0p
AP30
MIPI_DSI_TX0_D0n/LVDS_TX0_D0n
AR30
MIPI_DSI_TX0_D1p/LVDS_TX0_D1p
AR29
MIPI_DSI_TX0_D1n/LVDS_TX0_D1n
AP29
MIPI_DSI_TX0_D2p/LVDS_TX0_D2p
AP27
MIPI_DSI_TX0_D2n/LVDS_TX0_D2n
AR27
MIPI_DSI_TX0_D3p/LVDS_TX0_D3p
AR26
MIPI_DSI_TX0_D3n/LVDS_TX0_D3n
AP26
MIPI_DSI_TX0_CLKp/LVDS_TX0_CLKp
1V16
MIPI_DSI_TX0_CLKn/LVDS_TX0_CLKn
1V15
MIPI_DSI_TX0/LVDS_TX0_AVDD_0V9
1P11
MIPI_DSI_TX0/LVDS_TX0_AVDD_1V8
1P12
C71
100nF
10V
C72
100nF
10V
C69
DNP
10V
R72
NC
HDMI2.0 TX
RK3566
U1Q
HDMI_TX_D2p
AP36
HDMI_TX_D2n
AR36
HDMI_TX_D1p
AR35
HDMI_TX_D1n
AP35
HDMI_TX_D0p
AP33
HDMI_TX_D0n
AR33
HDMI_TX_CLKp
AR32
HDMI_TX_CLKn
AP32
HDMI_TX_HPDIN
1V17
HDMI_TX_REXT
1U16
HDMI_TX_AVDD_0V9_1
1N14
HDMI_TX_AVDD_0V9_2
1N13
HDMI_TX_AVDD_1V8
1P13
R64
NC
eDP_TX
RK3566
U1T
EDP_TX_D0p
J37
EDP_TX_D0n
J38
EDP_TX_D1p
K38
EDP_TX_D1n
K37
EDP_TX_D2p
M37
EDP_TX_D2n
M38
EDP_TX_D3p
N37
EDP_TX_D3n
N38
EDP_TX_AUXp
1H19
EDP_TX_AUXn
1H20
EDP_TX_AVDD_0V9
1H17
EDP_TX_AVDD_1V8
1G17
C64
1uF
10V
C74
4.7uF
6.3V
L4
BCMF062P120T
R40
1R
1%
R74
NC
C66
100NF
10V
R34
NC
R73
NC
L3
BCMF062P120T
C67
100NF
10V
C68
100nF
10V
R50
NC
C73
1uF
6.3V
HDMI_TX_REXT

PAGE 11
5
5
4
4
3
3
2
2
1
1
D
D
C
C
B
B
A
A
RK3566_L(VCCIO5 Domain)
VCC_3V3
VCC_3V3
GPIO3_A1_3V3
GPIO3_A2_3V3
GPIO3_A3_3V3
GPIO3_A4_3V3
GPIO3_A5_3V3
GPIO3_A6_3V3
GPIO3_A7_3V3
GPIO3_B0_3V3
GPIO3_B1_3V3
GPIO3_B2_3V3
GPIO3_B3_3V3
GPIO3_B4_3V3
I2C3_SCL_M1
I2C3_SDA_M1
GMAC1_RSTn_GPIO3_C0
GPIO3_C1_3V3
GPIO3_C2_3V3
GPIO3_C3_3V3
GPIO3_C4_3V3
GMAC1_INT/PMEB_GPIO3_B7
Size
REV
Date:
Sheet
of
Title:
Page Name:
RK3566_VO Interface_2
V1.11
Zero 3W
A4
11
22
Thursday, September 21, 2023
Size
REV
Date:
Sheet
of
Title:
Page Name:
RK3566_VO Interface_2
V1.11
Zero 3W
A4
11
22
Thursday, September 21, 2023
Size
REV
Date:
Sheet
of
Title:
Page Name:
RK3566_VO Interface_2
V1.11
Zero 3W
A4
11
22
Thursday, September 21, 2023
R53
2.2K
R52
2.2K
Operating Voltage=1.8V/3.3V
VCCIO5 Domain
I2S3_SDO_M0
UART4_TX_M1
PDM_SDI3_M2
/
GMAC1_TXCLK_M0
UART5_RX_M1
/
/
SDMMC2_CMD_M1
/
/
GMAC1_RXD2_M0
I2S1_SDO3_M2
I2S1_SCLK_RX_M2
I2S1_LRCK_RX_M2
/
/
SPI1_CLK_M1
PWM8_M0
/
GMAC1_RXER_M0
PDM_SDI2_M2
/
GMAC1_MDIO_M0
GMAC1_TXD1_M0
SDMMC2_D3_M1
GMAC1_RXD0_M0
PWM9_M0
PCIE20_PERSTn_M1
SDMMC2_D1_M1
GMAC1_RXD1_M0
I2S3_SDI_M0
PDM_CLK1_M2
/
/
UART7_RX_M1
/
SPI1_CS0_M1
GMAC1_TXD3_M0
I2S3_LRCK_M0
SDMMC2_PWREN_M1
SDMMC2_DET_M1
/
PDM_SDI0_M2
/
PWM15_IR_M0
I2S3_SCLK_M0
/
/
/
VOP_PWM_M1
/
GMAC1_TXEN_M0
/
/
SPDIF_TX_M1
/
/
/
/
GMAC1_RXCLK_M0
PWM14_M0
GMAC1_MDC_M0
/
PWM12_M0
/
UART5_TX_M1
/
/
/
/
/
/
/
/
/
/
/
UART3_RX_M1
PWM13_M0
/
ETH1_REFCLKO_25M_M0
SDMMC2_D0_M1
/
/
PDM_SDI1_M2
/
/
/
UART7_TX_M1
/
/
/
SPI1_MISO_M1
UART3_TX_M1
/
/
GMAC1_RXDV_CRS_M0
PWM10_M0
PWM11_IR_M0
SDMMC2_CLK_M1
/
/
/
SPI1_MOSI_M1
I2S3_MCLK_M0
/
/
/
/
/
/
/
/
/
GMAC1_TXD2_M0
/
/
/
SDMMC2_D2_M1
I2S1_SDO2_M2
/
/
GMAC1_TXD0_M0
/
/
/
/
GMAC1_MCLKINOUT_M0
/
UART4_RX_M1
GMAC1_RXD3_M0
/
/
/
/
/
I2C3_SCL_M1
I2C5_SDA_M0
/ I2C3_SDA_M1
/
/
I2C5_SCL_M0
/
VOP_BT1120_D0
VOP_BT1120_D1
VOP_BT1120_D2
VOP_BT1120_CLK
VOP_BT1120_D3
VOP_BT1120_D4
VOP_BT1120_D12
VOP_BT1120_D10
VOP_BT1120_D11
/
/
VOP_BT1120_D5
/ VOP_BT1120_D7
VOP_BT1120_D8
/
VOP_BT1120_D6
VOP_BT1120_D9
VOP_BT1120_D15
VOP_BT1120_D14
VOP_BT1120_D13
RK3566
U1L
GPIO3_A2_d
AR10
GPIO3_A3_d
AP10
GPIO3_A4_d
AR9
GPIO3_A5_d
AP9
GPIO3_A6_d
1U4
GPIO3_A7_d
1V3
GPIO3_B0_d
AR7
GPIO3_B1_d
AP7
GPIO3_B2_d
AR6
GPIO3_B3_d
AP6
GPIO3_B4_d
1U3
GPIO3_B5_d
1T4
GPIO3_B6_d
1V2
GPIO3_B7_d
AP5
GPIO3_C0_d
AR4
GPIO3_C1_d
AP4
GPIO3_C2_d
AP3
GPIO3_C3_d
AR2
GPIO3_C4_d
1P3
GPIO3_C5_d
1P4
VCCIO5_1
1N5
VCCIO5_2
1N6
GPIO3_A1_d
1U5
C75
100nF
10V
I2C3_SCL_M1
I2C3_SDA_M1

PAGE 12
5
5
4
4
3
3
2
2
1
1
D
D
C
C
B
B
A
A
RK3566_H(VCCIO1 Domain)
VCCIO_ACODEC
VCCIO_ACODEC
GPIO1_A1_3V3
GPIO1_A4
GPIO1_A0_3V3
I2S1_MCLK_M0_PMIC
I2S1_SDI0_M0/PDM_SDI0_M0_PMIC
I2S1_SCLK_TX_M0_PMIC
I2S1_LRCK_TX_M0_PMIC
PDM_CLK0_M0_PMIC
I2S1_SDO0_M0_PMIC
Size
REV
Date:
Sheet
of
Title:
Page Name:
RK3566_Audio Interface
V1.11
Zero 3W
A4
12
22
Thursday, September 21, 2023
Size
REV
Date:
Sheet
of
Title:
Page Name:
RK3566_Audio Interface
V1.11
Zero 3W
A4
12
22
Thursday, September 21, 2023
Size
REV
Date:
Sheet
of
Title:
Page Name:
RK3566_Audio Interface
V1.11
Zero 3W
A4
12
22
Thursday, September 21, 2023
C76
100nF
10V
R55
2.2K
VCCIO1 Domain
Operating Voltage=1.8V/3.3V
UART4_CTSn_M0
/
SPDIF_TX_M0
I2C3_SDA_M0
PCIE20_WAKEn_M2
UART3_RTSn_M0
/
PDM_CLK0_M0
/
UART4_RX_M0
/
/
/
I2S1_LRCK_TX_M0
I2S1_SDI1_M0
/
/
I2S1_SDO3_M0
UART3_CTSn_M0
/
/
PDM_CLK1_M0
PDM_SDI1_M0
/
I2S1_SDO1_M0
SCR_CLK
/
UART4_TX_M0
I2S1_SDI2_M0
/
I2S1_MCLK_M0
I2S1_SDI0_M0
/
/
/
/
/
I2S1_SCLK_TX_M0
/
/
PDM_SDI3_M0
/
/
UART4_RTSn_M0
/
PCIE20_CLKREQn_M2
PDM_SDI2_M0
/
/
PCIE20_PERSTn_M2
I2C3_SCL_M0
PDM_SDI0_M0
/
I2S1_LRCK_RX_M0
/
/
/
I2S1_SCLK_RX_M0
I2S1_SDO2_M0
/
I2S1_SDO0_M0
UART3_RX_M0
I2S1_SDI3_M0
/
/
/
SCR_IO
SCR_RST
UART3_TX_M0
/
/
/
/
/
/
/
/
AUDIOPWM_ROUT_n
AUDIOPWM_ROUT_p
AUDIOPWM_LOUT_p
AUDIOPWM_LOUT_n
/
/
SCR_DET
RK3566
U1H
GPIO1_A0_u
A22
GPIO1_A1_u
B22
GPIO1_A2_d
A23
VCCIO1
1D13
GPIO1_B1_d
A26
GPIO1_B2_d
B26
GPIO1_B3_d
1B14
GPIO1_A7_d
B25
GPIO1_B0_d
1B13
GPIO1_A5_d
B24
GPIO1_A6_d
1A14
GPIO1_A3_d
B23
GPIO1_A4_d
1A13
R54
2.2K
GPIO1_A0_3V3
GPIO1_A1_3V3

PAGE 13
5
5
4
4
3
3
2
2
1
1
D
D
C
C
B
B
A
A
RK3566_I(VCCIO2 Domain)
RK3566_J(VCCIO3 Domain)
VCCIO_FLASH
VCCIO_SD
VCC_1V8
VCC_3V3
VCCIO_FLASH
eMMC_CLKOUT/FLASH_DQS
eMMC_DATA_STROBE/FLASH_CLE
SDMMC0_D0
SDMMC0_D1
SDMMC0_D2
SDMMC0_D3
SDMMC0_CMD
SDMMC0_CLK
eMMC_D0/FLASH_D0
eMMC_D1/FLASH_D1
eMMC_D2/FLASH_D2
eMMC_D3/FLASH_D3
eMMC_D4/FLASH_D4
eMMC_D5/FLASH_D5
eMMC_D6/FLASH_D6
eMMC_D7/FLASH_D7
eMMC_CMD/FLASH_WRn
eMMC_RSTn/FSPI_D2/FLASH_WPn
Size
REV
Date:
Sheet
of
Title:
Page Name:
RK3566_Flash/SD
V1.11
Zero 3W
A4
13
22
Thursday, September 21, 2023
Size
REV
Date:
Sheet
of
Title:
Page Name:
RK3566_Flash/SD
V1.11
Zero 3W
A4
13
22
Thursday, September 21, 2023
Size
REV
Date:
Sheet
of
Title:
Page Name:
RK3566_Flash/SD
V1.11
Zero 3W
A4
13
22
Thursday, September 21, 2023
R68
NC
C140
4.7uF
10V
C221
NC
10V
R17
22R
Operating Voltage=1.8V/3.3V
VCCIO3 Domain
/
/
UART5_RTSn_M0
ARM_JTAG_TCK
/
UART2_RX_M1
UART5_RX_M0
/
SDMMC0_CLK
UART5_TX_M0
UART6_TX_M1
SDMMC0_D0
SDMMC0_CMD
/
/
/
/
UART6_RX_M1
/
UART2_TX_M1
/
SDMMC0_D3
/
/
/
SDMMC0_D2
SDMMC0_D1
/
TEST_CLKOUT
ARM_JTAG_TMS
/
UART5_CTSn_M0
/
/
PWM8_M1
PWM9_M1
PWM10_M1
/
/
/
RK3566
U1J
GPIO1_D5_u
1E20
GPIO1_D6_u
1F19
GPIO1_D7_u
1D20
GPIO2_A0_u
1F18
GPIO2_A1_u
1E19
GPIO2_A2_d
G38
VCCIO3
1F17
R69
0R
VCCIO2 Domain
Operating Voltage=1.8V/3.3V
Default is determined by Pin
FLASH_VOL_SEL/GPIO0_A7_u:
L:VCCIO2 must supply 3.3V
H:VCCIO2 must supply 1.8V
FLASH_D2
FLASH_D6
/
FLASH_D5
/
FLASH_WPn
/
FSPI_D3
/
/
/
FSPI_D1
FLASH_D3
/
FSPI_CS1n
FLASH_RDY
/
/
/
/
FSPI_D0
EMMC_D1
/
FLASH_CLE
EMMC_D3
EMMC_CLKOUT
EMMC_D5
FLASH_D7
FLASH_WRn
/
/
FSPI_D2
FLASH_ALE
/
FSPI_CS0n
FSPI_CLK
/
/
/
EMMC_RSTn
FLASH_DQS
EMMC_D2
/
/
/
FLASH_D4
FLASH_RDn
/
EMMC_D6
/
EMMC_D4
/
/
/
FLASH_D0
/
FLASH_CS1n
/
EMMC_D7
/
/
/
/
EMMC_D0
/
EMMC_CMD
FLASH_CS0n
/
/
/
FLASH_D1
EMMC_DATA_STROBE
RK3566
U1I
GPIO1_B4_u
A32
GPIO1_B5_u
B27
GPIO1_B6_u
B32
GPIO1_B7_u
B29
GPIO1_C0_u
B33
GPIO1_C1_u
A30
GPIO1_C2_u
B30
GPIO1_C3_u
A33
GPIO1_C4_u
A27
GPIO1_C5_d
A29
GPIO1_C6_d
1A16
GPIO1_C7_d
1B16
GPIO1_D0_d
1A15
GPIO1_D1_u
1A17
GPIO1_D2_u
1A18
GPIO1_D3_u
1B17
GPIO1_D4_u
1C15
VCCIO2
1C13
R18
22R
C94
NC
10V
C42
100nF
10V
C43
100nF
10V

PAGE 14
5
5
4
4
3
3
2
2
1
1
D
D
C
C
B
B
A
A
VCC1V8_DDR
VCC_DDR
VCC0V6_DDR
VCC_DDR
VCC0V6_DDR
VCC_DDR
VCCA1V8_PMU
VCC1V8_DDR
VCC0V6_DDR
LPDDR4_RESETn
12
LPDDR4_ODT0_CA_B
12
LPDDR4_CS0n_B
12
LPDDR4_CS1n_B
12
LPDDR4_ODT0_CA_A
12
LPDDR4_CS0n_A
12
LPDDR4_CS1n_A
12
LPDDR4_DM1_A
12
LPDDR4_CKE0_A
12
LPDDR4_A2_A
12
LPDDR4_A1_A
12
LPDDR4_A3_A
12
LPDDR4_A4_A
12
LPDDR4_A5_A
12
LPDDR4_A0_A
12
LPDDR4_CLKN_A
12
LPDDR4_CLKP_A
12
LPDDR4_CKE1_A
12
LPDDR4_CKE0_B
12
LPDDR4_A2_B
12
LPDDR4_A1_B
12
LPDDR4_A3_B
12
LPDDR4_A4_B
12
LPDDR4_A5_B
12
LPDDR4_A0_B
12
LPDDR4_CLKN_B
12
LPDDR4_CLKP_B
12
LPDDR4_CKE1_B
12
LPDDR4_DQ10_A
12
LPDDR4_DQ8_A
12
LPDDR4_DQ13_A
12
LPDDR4_DQ11_A
12
LPDDR4_DQ9_A
12
LPDDR4_DQ15_A
12
LPDDR4_DQ14_A
12
LPDDR4_DQ12_A
12
LPDDR4_DQS1P_A
12
LPDDR4_DQS1N_A
12
LPDDR4_DQ7_A
12
LPDDR4_DQ0_A
12
LPDDR4_DQ1_A
12
LPDDR4_DQ2_A
12
LPDDR4_DQ5_A
12
LPDDR4_DQ6_A
12
LPDDR4_DQ3_A
12
LPDDR4_DQ4_A
12
LPDDR4_DQS0P_A
12
LPDDR4_DQS0N_A
12
LPDDR4_DM0_A
12
LPDDR4_DQ6_B
12
LPDDR4_DQ2_B
12
LPDDR4_DQ3_B
12
LPDDR4_DQ0_B
12
LPDDR4_DQ5_B
12
LPDDR4_DQ7_B
12
LPDDR4_DQ1_B
12
LPDDR4_DQ4_B
12
LPDDR4_DQS0P_B
12
LPDDR4_DQS0N_B
12
LPDDR4_DQ14_B
12
LPDDR4_DQ8_B
12
LPDDR4_DQ11_B
12
LPDDR4_DQ10_B
12
LPDDR4_DQ15_B
12
LPDDR4_DQ9_B
12
LPDDR4_DQ12_B
12
LPDDR4_DQ13_B
12
LPDDR4_DQS1P_B
12
LPDDR4_DQS1N_B
12
LPDDR4_DM0_B
12
LPDDR4_DM1_B
12
Size
REV
Date:
Sheet
of
Title:
Page Name:
LPDDR4X_1X32bit
V1.11
Zero 3W
A3
14
22
Thursday, September 21, 2023
Size
REV
Date:
Sheet
of
Title:
Page Name:
LPDDR4X_1X32bit
V1.11
Zero 3W
A3
14
22
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
22
Thursday, September 21, 2023
D14
BTR04G02
D19
BTR04G02
R137
10K
D16
BTR04G02
R138
10K
Q3
MMBT3904M
1
2
3
D13
BTR04G02
D18
BTR04G02
R90723
0R
R90731
NC
D15
BTR04G02
J6
TFP09-2-12B
CD/DATA3
2
CMD
3
VDD
4
CLK
5
VSS
6
DATA0
7
DATA1
8
CD
9
G1
10
DATA2
1
G2
11
G3
12
G4
13
C227
100nF
10V
D17
BTR04G02

PAGE 17
5
5
4
4
3
3
2
2
1
1
D
D
C
C
B
B
A
A
OE (0=EN)
SEL  (0=SW1,1=SW2)
VCC_SYS
AO_5V_B
AO_5V_B
VCC_3V3
VCC_3V3
VCC_SYS
AO_5V_B
VCC_3V3
VCC_3V3
VCC_3V3
VCC_3V3
USB3_HOST1_DP
USB3_HOST1_DM
USB3_HOST1_SSRXP
USB3_HOST1_SSRXN
USB3_HOST1_SSTXN
USB3_HOST1_SSTXP
USB3.0_EN_H
I2C3_SDA_M1
TYPEC_INT
I2C3_SCL_M1
Size
REV
Date:
Sheet
of
Title:
Page Name:
USB Port
V1.11
Zero 3W
A4
17
22
Thursday, September 21, 2023
Size
REV
Date:
Sheet
of
Title:
Page Name:
USB Port
V1.11
Zero 3W
A4
17
22
Thursday, September 21, 2023
Size
REV
Date:
Sheet
of
Title:
Page Name:
USB Port
V1.11
Zero 3W
A4
17
22
Thursday, September 21, 2023
R47
2.2K
U11
SY6280AAC
OCB
3
GND
2
VOUT
1
EN
4
IN
5
R79
0R
N-CH
Q4
2SK3018
1
3
2
C209
100nF
16V
R48
10K
C208
100NF
16V
6C1
100NF
6C6
100NF
J9
USB_TYPEC_115H0
GND1
A1
SSTX1_P
A2
SSTX1_N
A3
VBUS_1
A4
CC1
A5
DP1
A6
DM1
A7
SBU1
A8
VBUS_2
A9
SSRX2_N
A10
SSRX2_P
A11
GND2
A12
GND4
B12
SSRX1_P
B11
SSRX1_N
B10
VBUS_4
B9
SBU2
B8
DM2
B7
DP2
B6
CC2
B5
VBUS_3
B4
SSTX2_N
B3
SSTX2_P
B2
GND3
B1
GND_E1
E1
GND_E2
E2
GND_E3
E3
GND_E4
E4
GND_E5
E5
GND_E6
E6
HOLE_1
H1
HOLE_2
H2
C203
220pF
50V
6C2
100NF
R77
0R
D2
BTR04G02
U12
CH482d
EN
1
SSA-N
2
SSA-P
3
GND1
4
NC1
5
SSB-N
6
SSB-P
7
SEL
8
VDD2
9
GND3
10
SSB1-P
11
SSB1-N
12
SSA1-P
13
SSA1-N
14
SSB0-P
15
SSB0-N
16
SSA0-P
17
SSA0-N
18
GND2
19
VDD
20
PAD
21
R43
NC
C202
220pF
50V
6C3
100NF
R70
4.7K
1%
6C5
100NF
D1
BTR04G02
R71
10K
6C4
100NF
R78
0R
U6
ET7301B
CC2_1
1
VBUS
2
VDD
3
VDD
4
INT#
5
SCL
6
SDA
7
GND
8
GND
9
CC1_10
10
CC1_11
11
VCONN_12
12
VCONN_13
13
CC2_14
14
ePAD
15
L1
BCMF122P900H
1
3
2
4
C210
22uF
10V
R44
NC
6R8
1K
R51
0R
6R7
0R
USB3.0_TXP
USB3.0_TXN
USB3.0_RXP
USB3.0_RXN
USB3.0_TXP2
USB3.0_TXN2
USB3.0_RXP2
USB3.0_RXN2
CC1
CC2
CC2
CC1
USB3.0_TXN2
USB3.0_RXP
SEL
USB3.0_RXP2
USB3.0_RXN2
USB3.0_TXP2
USB3.0_TXP
USB3.0_TXN
USB3.0_RXN

PAGE 18
5
5
4
4
3
3
2
2
1
1
D
D
C
C
B
B
A
A
HDMI TX HPD
MICRO HDMI output 
VCC5V0_HDMI
VCC_3V3
VCC_3V3
GND
VCC5V_MIDU
VCC5V0_HDMI
HDMI_TX2N_PORT
HDMI_TX2P_PORT
HDMI_TX1N_PORT
HDMI_TX1P_PORT
HDMI_TX0N_PORT
HDMI_TX0P_PORT
HDMI_TXCLKN_PORT
HDMI_TXCLKP_PORT
GPIO4_D1_3V3
HDMITX_SDA
HDMITX_SCL
HDMI_TX_HPDIN
HDMI_TX2N_PORT
HDMI_TX1P_PORT
HDMI_TX0N_PORT
HDMI_TXCLKP_PORT
HDMI_TXDDC_SCL_PORT
HDMI_HPD
HDMI_TX2P_PORT
HDMI_TX1N_PORT
HDMI_TX0P_PORT
HDMI_TXCLKN_PORT
HDMI_TXDDC_SDA_PORT
HDMI_TX_CEC_PORT
HDMI_HPD
Size
REV
Date:
Sheet
of
Title:
Page Name:
HDMI2.0 TX
V1.11
Zero 3W
A4
18
22
Thursday, September 21, 2023
Size
REV
Date:
Sheet
of
Title:
Page Name:
HDMI2.0 TX
V1.11
Zero 3W
A4
18
22
Thursday, September 21, 2023
Size
REV
Date:
Sheet
of
Title:
Page Name:
HDMI2.0 TX
V1.11
Zero 3W
A4
18
22
Thursday, September 21, 2023
D6
1N5819WT
1
2
U17
TPD4E05U06
IN1
1
IN2
2
IN3
4
IN4
5
OUT4
6
OUT3
7
OUT2
9
OUT1
10
GND1
3
GND2
8
C240
1uF
C0201
ED11
BTR04G02
J10
HDMI_MICRO
1
2
3
4
5
6
7
8
9
10
11
12
13
14
15
16
17
18
19
20
21
22
23
C232
100nF
ED10
BTR04G02
R140
1K
6R1
NC
U15
UM3204H
A2
B3
A3
C3
A4
D3
A1
A3
GND
D2
B2
B1
B3
C1
VCCB
A2
B1
A1
VCCA
B2
B4
D1
OE
C2
R141
100K
ED9
BTR04G02
U16
TPD4E05U06
IN1
1
IN2
2
IN3
4
IN4
5
OUT4
6
OUT3
7
OUT2
9
OUT1
10
GND1
3
GND2
8
ED12
BTR04G02
HDMI_TX2N_PORT
HDMI_TX0N_PORT
HDMI_TXCLKN_PORT
HDMI_TX1N_PORT
HDMI_TX1P_PORT
HDMI_TXCLKN_PORT
HDMI_TXCLKP_PORT
HDMI_TX2P_PORT
HDMI_TX0P_PORT
HDMI_TX1N_PORT
HDMI_TX0N_PORT
HDMI_TX2N_PORT
HDMI_TXCLKP_PORT
HDMI_TX2P_PORT
HDMI_TX1P_PORT
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
63
SNSP
62
VREF
46
GNDREF
47
ePAD
69
VCC_RTC
45
XIN
50
XOUT
51
SDA
2
SCL
1
INT
7
SLEEP
49
CLK32K
68
RESETB
67
PWRON
52
C344
1uF
10V
R135
100R
C320
22uF
10V
C86
1uF
6.3V
Y6
32.768KHz
1
2
3
C335
22uF
10V
C346
1uF
10V
SW1
SW2
SW4
SW3
SNSN
SNSP
VCC_1P8D
VCC_CPVSS
VCC_CPVDD
VCC_1P8A
PMIC_CLK32KOUT

PAGE 22
5
5
4
4
3
3
2
2
1
1
D
D
C
C
B
B
A
A
DC 5V IN
VCC_3V3 (Power OFF under SLEEP)
VDD_CPU_EXT
VCC_SYS
+5V_INPUT
VCC_SYS
VCC3V3_PMU
VCC_SYS
VDD_CPU
VDD_CPU
VCC3V3_SYS
VCC_3V3
USB_OTG0_DP
USB_OTG0_DM
USB_OTG0_ID
USB_OTG0_VBUSDET
I2C0_SDA_PMIC
I2C0_SCL_PMIC
PMIC_SLEEP_H
PMIC_SLEEP_H
Size
REV
Date:
Sheet
of
Title:
Page Name:
Power_DC IN
V1.11
Zero 3W
A4
22
22
Thursday, September 21, 2023
Size
REV
Date:
Sheet
of
Title:
Page Name:
Power_DC IN
V1.11
Zero 3W
A4
22
22
Thursday, September 21, 2023
Size
REV
Date:
Sheet
of
Title:
Page Name:
Power_DC IN
V1.11
Zero 3W
A4
22
22
Thursday, September 21, 2023
C80
22uF/10V
D4
BTR04G02
C148
22uF/10V
R112
NC
C79
100nF
10V
R109
NC
Q5
WPM3407-3/TR
1
2
3
C149
100nF
R111
2.2K
R56
51K
R66
10K
L9
BCMF122P900H
1
3
2
4
6R10
5.1k
R110
22R
C81
22uF/10V
C152
100nF
16V
C89
22uF
6.3V
6R9
5.1k
J2
USB_TYPEC_115H0
GND1
A1
VBUS_1
A4
CC1
A5
DP1
A6
DM1
A7
SBU1
A8
VBUS_2
A9
GND2
A12
GND4
B12
VBUS_4
B9
SBU2
B8
DM2
B7
DP2
B6
CC2
B5
VBUS_3
B4
GND3
B1
GND_E1
E1
GND_E2
E2
GND_E3
E3
GND_E4
E4
HOLE_1
6
HOLE_2
7
C78
22uF/10V
C3
2.2NF
C77
100nF/10V
C90
22uF
6.3V
C150
100nF
ED6
AZ5825-01F
C91
100nF
10V
C82
100nF
10V
R31
75R
L2
0.24uH
D3
SMF5.0CA
1
2
R67
10K
C151
22uF/10V
R57
100R
R65
100K
R33
4.3K
R108
NC
R107
FB120/3A
U3
RK860-0
VIN_1
D1
VIN_2
D2
VIN_3
E1
VIN_4
E2
SW_1
D3
SW_2
D4
SW_3
E3
SW_4
E4
GND1
B2
GND2
B3
GND3
C1
GND4
C2
GND5
C3
GND6
C4
VSEL
A1
EN
A2
SDA
B1
AGND
B4
SCL
A3
VOUT
A4
D5
BTR04G02
