parkourlrc/pcb-yilv1982--duck-robot-89dbc81d6d/PROGRESS.md

# 进度记录

> **2026-11-10 训练拆分**：训练代码、训练流程/环境登记文档、训练记录与产物已迁至同级独立仓库 [duck-robot-training](https://gitee.com/yilv1982/duck-robot-training)；本仓 `training/` 与相关 `docs/specs`、`docs/references` 已移出。下方历史条目中的旧训练链接指向已移动的路径，仅作历史记录；现行训练见训练仓。

**[2026-11-10 训练环境登记与启动自识别]** [用户确认] 环境登记只落本地配置，平台启动时按 hostname+GPU+WSL 发行版识别当前环境，不在代码里写死“本机”名。[本机实测] 公司工作机识别为 `desktop-4080-16G`；每个环境生成独立探测脚本（GPU/docker/镜像/env/venv/work_root），启动、60 秒复测、刷新按钮与训练启动前执行，desktop-4080-16G、spark1、spark2 均就绪；未登记主机显示“未登记主机”并拒绝本机训练，不可达显示离线。v3 任务按当前源码刷新哈希后恢复 ready；前端未改，未启动训练。按用户要求环境名统一为 `desktop-4080-16G` 与 `laptop-5090-24G`（原 4080-16g / MSI-laptop）。见[训练环境登记 Spec](docs/specs/20261110-训练环境登记/spec.md)。

**[2026-11-10 回放加载优化，首帧61–81秒降至约5–9秒]** [本机实测] 回放冷启动约95%耗时在Python导入：同一依赖栈 `/mnt/c` 导入42.8–49.6 s，WSL ext4 仅6.0–9.3 s。训练venv已迁 `/root/venvs/duck-wsl`，工作台与`play-mujoco.ps1`改用新位置，旧仓库内`.venv-wsl`暂留回退；API创建回放首帧4.6/4.8 s（热缓存）、9.1 s（drop_caches 冷缓存），关闭后GPU 0 MiB。同轮修复回放完成后worker滞留GPU（曾达4 h53 min）与带BOM控制文件被静默忽略：新增`--idle-timeout`默认300 s、控制文件按UTF-8 BOM容错。播放步进性能仍约0.37×实时，本次未改。该规则已写入训练流程第③步“环境组装与登记”的强制规则及验收场景7，并在训练记录目录要求第③步引用环境登记。见[Spec](docs/specs/20261110-回放加载优化/spec.md)、[训练流程](docs/specs/20261105-自主训练平台/spec.md)与[环境记录](docs/references/本机训练环境/research.md)。本轮修改未提交。

**[2026-11-10 本地训练节点命名]** [用户确认] `laptop-5090-24G` 机器的训练节点命名为 `laptop-5090-24G`；已同步工作台配置、资源显示回退名和[本机训练环境登记](docs/references/本机训练环境/research.md)。节点仍为 Windows + Ubuntu-24.04 WSL2，未改变训练参数或运行路径。

**[2026-11-09 训练工作台配色交付]** [本机实测] 工作台采用深海军蓝/蓝灰面板、冰青主交互和少量电紫图表色；状态保留语义，布局、训练逻辑、后端、API、预算、物理参数及3D模型材质未改。Chrome桌面/窄屏8个视图无页面/HTTP错误，23个图表正常，最低文字对比度6.40:1；未启动训练或回放。见[配色Spec与证据](docs/specs/20261109-训练工作台配色/spec.md)。本轮修改未提交。

**[2026-11-09 本机训练工作台启动]** [软件实测] `88e4a507` 下8766首页HTTP 200、Windows/WSL监控connected、67字段及49条本机历史记录可读；修复16个v3来源的工作区CRLF后v3 ready，冻结v1 ready，旧v2仍受来源不匹配限制。未启动训练或重跑GPU验收，训练源码无Git内容差异；[当日更新与启动证据](docs/references/本机训练环境/research.md)。本轮记录未提交。

**[2026-11-09 训练档案与复训]** [用户确认] 全历史分级导入、训练/奖励可调物理锁定、从零与接权重建立新实验；[软件实测] 后端合同检查10项通过（无训练），GPU最小scratch1轮＋原状态续训1轮＋warm1轮合计96转换通过，actor/归一化继承和其余状态重置已核验；仅工具验收，不代表行为达标。交叉审查已修正同步重试、源完整性与历史奖励来源；浏览器视觉受限未验，远端历史未完整盘点，双Spark新路径未真跑。大产物入`training/artifacts/`，源码/配置与摘要留版本库；未提交。见[实施记录](docs/specs/20261109-训练档案与复训/implementation-record.md)。

**[2026-11-08 足部奖励四组百轮完成，20mm局部改善]** [实测，仿真] 四组各100更新，dev9共36回合全部完整无跌倒，但四组均0/9行为通过；三场子步诊断与50fps视频均已归档。固定Kp25/Kd2及物理层，20mm足部组在2/3场景形成32/42、34/42次有效起落，交替86.3%/89.3%，左右膝逐周期中位摆幅约15.3°/10.8°；第三场仍静止，前速与偏航未达标。10mm、仅raw渐进平滑及组合组均无合格迈步，小摆幅尚未稳定解决，未追加配对种子。首次日志错误的失败消耗保留，本轮合计105,906,176转换。见[完整结果、图与视频](docs/references/自主训练平台/足部奖励百轮对照-20261107.md)。下一轮[独立航向罚项提案](docs/specs/20261107-步幅参数优化/航向约束下一轮提案.md)待确认，未编码或训练；未提交。

**[2026-11-09 双足训练恢复核查]** [文件核验] 昨日四组正式重试的 WSL 原始目录仍在，四组均有完整 `final_000100` rank0 权重、`complete=true/resumable=true` manifest，27/27 项冻结源码 SHA 匹配，rank0 文件 SHA 也已复核；诊断轨迹和50fps视频可继续回放。[迁移完成] 四组已登记到 `training/records/`，冻结源码、检查点、诊断和运行证据复制到 `training/artifacts/runs/`，重启工作台后可浏览和回放。原100轮预算已耗尽，尚未执行续训验收；原始 WSL 目录保留。档案仍标为部分完整，缺失项没有补造。详见[恢复核查](docs/references/自主训练平台/足部奖励百轮对照-20261107.md)。

**[2026-11-07 HD-1910-C001参数来源勘误]** 用户确认实机HD-1910-C001。[源码核验] 飞特公开M6确取自HD1910/7.4V目录，但固定快照122个文本/源码文件未检出C001标注，具体适用性待确认。C线作者采用Luwu另一份M6，控制器实现及拟合值不同，不能据此认定硬件型号不同。已撤回“不是同一颗舵机的两种拟合”和“重训优先官方版”的无充分证据判断，并更正原参数表及研究。见[来源核对与证据](docs/references/自主训练平台/训练物理参数来源核对-20261107.md)。未换模型或启动训练，未提交。

**[2026-11-07 固定物理参数，Kd试验已停止]** 用户明确Kd不参与步幅优化。四组Kd变化训练已在19/11/10/22更新边界保存退出，未完成百轮；相关排队组合取消、监督器停止，alpha0.1/Kd2尚未启动。[文件核验] 昨天双Spark和今天基线均采用自选IdealPD（Kp25/Kd2），仅沿用部分Luwu公开HD1910参数的简化映射，未使用飞特官方完整BAM，也不是本机动力学辨识结果。详见[参数来源核对](docs/references/自主训练平台/训练物理参数来源核对-20261107.md)及[对照记录](docs/references/自主训练平台/百轮参数对照-20261107.md)。原物理模型及训练源未改；未提交。

**[2026-11-07 本机百轮基线完成，小摆幅仍在]** [实测] RTX 5090 Laptop 单卡、4096 环境、rollout 64、seed 42 完成 100 更新/26,214,400 转换，连评估保存约 17 分钟；dev9 全部完整且无跌倒，但行为 0/9 通过。独立 0.06 m/s 回放平均实际前速 0.0061 m/s，左右膝峰峰范围 1.54°/3.85°，两脚几何最低点均未离地超过 2 mm；确定性 raw 裁剪 0%。[权重及源码核验] manifest/SHA 通过，Windows 镜像在 `training/logs/amplitude-baseline-20261107/`，原 WSL 账本保留。见[记录、视频及证据](docs/references/自主训练平台/本机百轮步幅基线-20261107.md)与[步幅优化 spec](docs/specs/20261107-步幅参数优化/spec.md)。现行训练实现未改，后续参数对照已批准并在独立副本执行；未提交。

**[2026-11-07 本机训练环境已配置]** [软件实测] RTX 5090 Laptop 24 GB / WSL2 Ubuntu-24.04，复用 Python 3.12.3 / torch 2.13.0+cu129 / mjlab 1.3.0，修正 torchvision 版本冲突；Windows 独立网页环境安装完成。16 环境 × 64 步、1 预热 + 3 计时更新共 4096 转换通过，无非有限值；仅环境短验证，不是正式第二轮或策略达标。工作台 `http://127.0.0.1:8766` 已启动，local 节点连接正常、locomotion v2 可用；7 文件 CRLF 哈希问题已恢复为 HEAD 原始 LF，本仓库禁用自动 CRLF 转换。详见[环境登记与原始证据](docs/references/本机训练环境/research.md)，未连接 Spark/机器人，未提交。

**[2026-11-06 Studio回放模型来源已恢复]** [用户确认] 第⑤步工具使用Studio的3D显示模型，不用MuJoCo简模。[文件核验] 沿部署源包记录，从固定提交3952471恢复[模型与加载源码](software/studio/model-source-2026103101/README.md)，六文件Git blob哈希匹配；本地servo-web网格完全一致，Studio JSON多两个servo_joint标记，已保留Studio原版。此前把主控离线视为取模型阻塞的处理已更正，见[来源记录](docs/specs/20261106-训练可视化工具/studio-model-source.md)。当前板侧未重新比对不妨碍本地方案设计；未修改设备、训练代码或提交，新增文件为来源存档。

**[2026-11-06 第⑤步训练可视化工具验收完成]** 用户批准的[修改方案](docs/specs/20261106-训练可视化工具/implementation-plan.md)已实现并独立审查。[文件核验] 旧v1冻结、9项合同SHA核对；现行支持独立保存/评估、单/双rank、完整回合统计、真实位姿回放、网页及监督执行器。[实测] 本地GPU/单Spark/双Spark新建、停止、恢复和预算退出合计576转换通过，见[三模式证据](docs/specs/20261106-训练可视化工具/checks/backend-e2e-summary.json)。旧100/1000检查点23秒真实回放、四窗、刷新接回、关闭释放通过；服务重启后cp100恢复983帧历史曲线，Windows/WSL/Spark资源卡及WSL持久JSONL通过，见[最终验收与四截图索引](docs/specs/20261106-训练可视化工具/checks/final-browser-check.json)。completed不代表策略行为达标，未扩大训练预算或操作实物。详细证据及边界见[实施记录](docs/specs/20261106-训练可视化工具/implementation-record.md)及[运行时记录](docs/specs/20261106-训练可视化工具/runtime-implementation.md)。[启动入口](training/dashboard/README.md)默认8766，原8765服务保持；未提交。

**[2026-11-06 第⑤步失败诊断]** [实测] 首轮日志动作std从约0.30增至约20044.84，末轮随机raw动作99.9957%越过[-1,1]并被执行层裁剪；第100/1000轮同场景确定性回放分别0%/100%越界，最终均值输出也异常。两段23秒物理模型视频、轨迹与原始trace已保存，见[诊断及下一版建议](docs/specs/20261105-原地转圈策略/step5-diagnosis.md)。[假设] 无界熵/裁剪、方向奖励弱及平滑罚项饱和可能共同影响，尚无消融证明唯一原因。提出固定std/固定学习率的小预算稳定化方案，待用户确认；未改训练源码、未重训、未追加预算，未提交。

**[2026-11-06 第⑤步首轮执行结束，行为未达标]** 双Spark按既定4096环境/64步完成1000更新、262144000转换，预算耗尽后两容器exit0。10次dev9均0/9通过，90个开发回合完整但未达行为门槛，始终阶段一，未进入转向阶段或full96。`train_loop`耗时85.034分钟、合计2.834468节点小时（不含准备/初始化）；账本无pending，最终两rank模型SHA核对通过，见[运行记录](docs/specs/20261105-原地转圈策略/step5-training-run.md)。未追加预算、未改奖励、未重启、未操作机器人或部署，未提交。

**[2026-11-06 第④步完成]** 已按用户确认实现双Spark4096全局环境、rollout64、两阶段合计1000更新；包含版本化课程、dev9/dev22/full96评估、日志、预算预扣及各rank完整保存/分发恢复，见[实施记录](docs/specs/20261105-原地转圈策略/step4-implementation.md)。[软件实测] 15项合成评估、环境GPU回归、CPU两进程恢复/异常协调、最终本地GPU与双Spark64/4096环境短检查通过；4096环境完成2＋1更新累计786432转换、恢复一致。源码SHA一致、独立审查无阻塞。真实23秒评估管线通过但行为未达标；课程切换以合成通过报告验证机制。第⑤步正式训练未开始，未部署、未提交。

以下11月6日讨论条目为实施前历史：参数现已定稿、入口与恢复已实现，不再以条目中的“待确认/待实现”作为当前指导；运行验证以顶部记录及实施记录为准。

**[2026-11-06 第④步参数定稿]** 用户确认[清单中的三组参数](docs/specs/20261105-原地转圈策略/step4-confirmation-checklist.md)：双Spark4096全局环境、rollout64、两阶段合计1000轮；阶段一全直走，阶段二30/30/20/15/5新回合抽样；每100轮保存/评估、200轮诊断、连续两次直走9/9通过晋级及退步/覆盖不足暂停。确认记录已同步，后文同日“待确认”为此前状态。正式课程、入口、评估、双机保存恢复尚待实现验证，第④步整体未完成，第⑤步未开始；未训练、未提交。

**[2026-11-06 训练恢复机制确认]** 用户在用途说明后确认训练存档恢复：中断续训、阶段能力继承、必要时回退检查点；保留学习状态，仿真从HOME新回合开始，不涉及实物起身。已同步[课程细化方案](docs/specs/20261105-原地转圈策略/training-curriculum-detail.md)和输入记录；具体保存/恢复实现未完成，未进行运行验证或正式训练，第④步仍进行中，未提交。

**[2026-11-06 课程细化建议，待确认]** 已给出[采样、切换和恢复v1](docs/specs/20261105-原地转圈策略/training-curriculum-detail.md)：阶段一全直走，阶段二30/30/20/15/5五类新回合采样；连续两个计划评估点直走9/9通过再晋级，保留模型/归一化/optimizer/当前LR，同阶段续训与退步回退分别管理。检查发现旧弧线脚本含原地转，课程实现需拆清场景而非只改概率。文档配比与JSON检查通过，未实现或训练，第④步仍进行中。

**[2026-11-06 原地转训练范围确认]** 用户确认原地转圈同时作为最终目标和阶段二训练内容，覆盖静止直接起转、移动减速停稳后起转两种入口；两个顶层阶段、单一模型及5cm验收保持不变。已同步[课程](docs/specs/20261105-原地转圈策略/training-curriculum.md)、Spec和输入记录；具体采样/恢复方案尚待实现，预算未因本次确认扩大。第④步进行中，第⑤步未开始，本轮无训练或代码修改，未提交。

**[2026-11-06 用户确定两阶段训练]** 先正常前进，阶段验收通过后再加入移动中转向，见[课程方案](docs/specs/20261105-原地转圈策略/training-curriculum.md)。同一模型继续学习，双Spark及最终减速/原地转/停止目标保留；旧从第一轮混合五族的训练方式已退出当前指导。9回合直走门槛为建议，课程采样/恢复尚未实现；候选1000轮为两阶段合计，不自动翻倍。第④步进行中、第⑤步未开始，本轮仅同步方案，未训练或提交。

**[2026-11-06 双Spark预算推荐，待确认]** 用户确定双Spark后要求推荐规模及预算，已给出[4096全局环境/1000轮首轮方案](docs/specs/20261105-原地转圈策略/training-budget-dual-spark.md)：262144000转换，每200轮诊断/100轮保存。约58分钟仅为短吞吐线性外推；不是达标保证，比旧819.2万预算大32倍。参数仍属建议，未修改可执行配置或启动训练，第④步未完成。

**[2026-11-06 用户确定双Spark]** 第④步计算环境选择完成：正式训练采用spark1＋spark2，已更新[训练方案](docs/specs/20261105-原地转圈策略/training-plan.md)及输入记录。后文单Spark建议和64环境/2000轮为此前历史方案；当前并行规模与配套预算待定稿，推荐候选为全局4096、每台2048环境，不能自动扩大总经验预算。正式入口、日志及保存续训仍待实现验证，第④步整体进行中，第⑤步未开始；本轮只同步决定，未运行远端或训练，未提交。

**[2026-11-06 第④步扩大工作量对照]** 用户要求加大工作量后，[256/1024/4096全局环境短测速](docs/specs/20261105-原地转圈策略/benchmark-scale-runbook.md)均完成，2预热＋5计时；单Spark补跑加载与双机相同env文件。三档双/单吞吐比分别1.042/1.173/1.629；4096下本地/单Spark/双Spark41040.05/46332.98/75490.74转换/秒。无OOM，正式任务/奖励/接口未改，未生成正式策略。数据、各rank日志及软件/采样差异已归档；当前正式64环境/2000轮预算保持不变，第④步整体仍进行中、第⑤步未开始，未提交。

**[2026-11-06 联合策略第④步方案与短测速]** 已形成[训练方案v1](docs/specs/20261105-原地转圈策略/training-plan.md)及[输入核对](docs/specs/20261105-原地转圈策略/training-input-check.json)：PPO、actor/critic各61维MLP、64并行×64步、2000轮上限8,192,000转换。用户随后授权[三方同任务短测速](docs/references/自主训练平台/Spark与本地训练比较.md)，本地/单Spark/双Spark实测1704.66/2889.35/2931.29转换每秒，建议当前64环境用单Spark；双机仅多1.45%，短窗不足认定稳定优势。已运行2预热＋3计时PPO更新并隔离准备Spark依赖，未输出策略候选；软件版本与分布式统计差异已记录。正式入口、分族日志/保存续训与相关检查仍未完成，第④步整体进行中、第⑤步未开始；未正式训练/部署/提交。后面的“第④步未开始”为此前历史。

## 当前状态（2026-11-05）

- **整机**：M1 已完成（用户确认 2026-11-05）：新单 3P 口 IMU 已换装、15 颗舵机标定完成；IMU 间歇缺答/行走摔倒转可靠性跟踪。
- **自主 HAT**：B.0 / 84362651 已付款5片；工厂新增MK701/Y701方向确认，已核对并拟好回复，待用户提交；研发继续暂停，未确认发货，首板未验收，原750元目标未达成。[核对记录](docs/references/扩展板乙版降本/engineering-feedback/research.md)
- **PCB 全流程**：M3 进行中，B.0 / 84362651、Y10／SMT2611051346 已付款，等待回寄与上机测试。
- **训练**：M2 已完成（官方模型上机+基本动作，用户确认）；M4 进行中，自训策略尚未上机。
- **里程碑**：M1/M2 已闭环；M3 PCB 全流程进行中（已下单，待回寄/上机）；M4 自训进行中；见 [MILESTONES](MILESTONES.md)。
- **下一步**：以本页最新日期条目和 [BOM](BOM.md) 为准；接线/上电前仍按 AGENTS 的安全边界核对。

## 阅读说明

**[2026-11-05 联合策略第③步实现]** 用户确认[联合环境方案v2](docs/specs/20261105-原地转圈策略/environment-plan.md)后已实现独立mjlab环境：61维观测/14动作、联合命令/奖励、150s上限、固定原地锚点与逐子步计量。[本机软件运行] CUDA2环境5控制步/50物理子步及必要合成检查通过，见[检查记录](docs/specs/20261105-原地转圈策略/environment-runtime-check.json)；独立代码审查通过，第③步环境接口完成。训练6s/20cm探索与严格3s/5cm区分，96场景只完成清单检查。未训练、未部署、未提交，第④步未开始；以下同日旧状态是历史。

**[2026-11-05 联合策略第②步文档完成]** 已核对[任务定义v2](docs/specs/20261105-原地转圈策略/task-definition.md)及[验收参考v2.1](docs/specs/20261105-原地转圈策略/acceptance-reference-v2.md)：行为、速度范围、测量口径、行走/减速/转弯/停止判据及96回合参考集已齐备。第②步“任务定义与验收标准”完成，数值仍标来源与待验证状态，不等于模型通过。下一步第③步联合环境/奖励方案；未编码、训练、部署或提交。

**[2026-11-05 联合策略验收参考v2.1]** 用户要求助手推荐；已补[前速与行走/减速/转弯验收](docs/specs/20261105-原地转圈策略/acceptance-reference-v2.md)：前进建议0～0.10 m/s，3/6/10 cm/s三档；直走/弧线3 s启动+20 s稳态；3 s内确认停稳、减速路径≤15 cm；停车后原地5 cm保持。新增数值为未验证参考，不是实物能力。96回合联合参考集已定义，未执行；第②步首版建议形成，第③步联合环境/奖励方案待补，未编码/训练/提交。以下“前进上限待定”是提出本建议前的历史状态。

**[2026-11-05 首个策略改为单模型前进/减速/转向]** [用户确认] 同一模型同时完成行走、减速和转圈；只前进，不后退/侧移。vx>0可同时左右转，vx=0且wz≠0原地转，两者0为停止站立；减速时允许持续转向。61维字段保持，命令改为[vx>=0,0,wz]；停车稳定后建立5 cm原地锚点，减速距离另验。第①步核心范围已修订，前进速度上限待定；原双模型交接与仅转圈环境退出现行方案，旧文件已归档。第②/③步需扩展奖励/命令/验收，未编码或训练；见[联合需求](docs/specs/20261105-原地转圈策略/spec.md)。以下同日“转圈”“交接”“第②步已完成”条目为变更前历史，现行状态以本条及联合Spec为准。

**[2026-11-05 转圈状态估计输入已核对]** [用户确认] 已装配并上机飞特模型的当前整机足部无传感器。[归档/源码核验] 已有实际关节位置/速度、IMU姿态/角速度和反馈新鲜度；现行IMU总线包无原始加速度，电流物理单位未验证。接触及机身速度需新算法，不能用缺帧置零判停稳。见[输入核对清单](docs/references/自主训练平台/本机状态估计输入核对.md)。第②步过渡参数继续修订，第③步输入字段核对子项完成；未运行新采集、动作或估计器。

**[2026-11-05 转圈切入速度估计方向确认]** [用户确认] 采用独立组件融合实际关节反馈、IMU与接触判断估计水平速度，供入口分档与停稳判定；61维观测不变。先做仿真真值对照，核验误差/延迟后确定阈值，5 cm仍用独立位置数据验收。输入来源/接触方法和具体实现方案待补，未实现或验证；见[任务定义](docs/specs/20261105-原地转圈策略/task-definition.md)。

**[2026-11-05 转圈新增移动切入需求]** [用户确认] 移动中收到请求后平滑切换到原地转圈，停车稳定后记录起点，转圈全过程仍≤5 cm，减速距离单独验收。现返回第②步补入口速度、减速距离/时限、停稳条件及交接验收；第③步61维选择保留，静止入口方案需扩展，未编码/运行。详见[任务定义](docs/specs/20261105-原地转圈策略/task-definition.md)。以下此前第②步完成记录仅指原静止入口版本。

**[2026-11-05 训练流程通知规则优化]** [用户要求] 每个步骤开始与完成时明确编号、名称、做什么和作用；完成时报告产物、输入/输出检查及下一步状态。见[平台流程规范](docs/specs/20261105-自主训练平台/spec.md)。原地转圈第②步定义文档已完成、第③步环境组装进行中，具体方案已形成待确认；未编码、训练或部署，未提交。

**[2026-11-05 首个自训策略：原地持续双向转圈]** [用户确认] 同策略可调速左/右/停、平滑反向，目标±30°/s、漂移≤5 cm；沿用平地站姿及每方向60 s默认基线。第②步[任务定义](docs/specs/20261105-原地转圈策略/task-definition.md)已完成，第③步[环境/接口方案](docs/specs/20261105-原地转圈策略/environment-plan.md)采用用户确认的原walk 61维观测，保留14动作及逐子步检查；环境其余实现方案待确认。速度槽为[0,0,平滑转速]，头颈/躯干命令为0，上一动作使用原始网络输出，位置仅供奖励/验收。[本机输入检查] WSL依赖/CUDA可用，原模型HOME forward已查，未做动力步进或新任务运行。第③步整体仍进行中，第④步未开始；未编码、训练或实物操作，M4不变，见[Spec](docs/specs/20261105-原地转圈策略/spec.md)。

**[2026-11-05 自主训练平台流程方案 v1 已确认]** [用户确认] 方案讨论完成，先采用本版，后续在实际跑流程时优化。基线为策略需求入口、选择优先/无选项提供参考、逐步输入输出验证及受影响下游重新验证；见[通用输入记录](docs/references/自主训练平台/research.md)与[流程方案 Spec](docs/specs/20261105-自主训练平台/spec.md)。首个策略和具体判据在相应步骤填写，技术实现另行细化；未编码、未训练或部署，M4 状态不变。

**[2026-11-05 嘉立创工程方向反馈]** [原厂资料＋文件核验] 84362651源哈希及报价包BOM/CPL/ZIP一致；按工程截图顶视，MK701的1脚在左上、Y701的1脚在左下，与原厂定义及PCB对应。已提供仅针对这两项的回复草稿，未替用户提交或确认工厂放行；截图已脱敏归档，研发暂停保持。见[证据与回复](docs/references/扩展板乙版降本/engineering-feedback/research.md)。

以下保留 2026-11 的原始记录、证据等级和限制；2026-10 及以前已归档到 [docs/archive/progress-2026-10.md](docs/archive/progress-2026-10.md)。当前结论以本节、最新日期条目和对应专题为准。

**[2026-11-05 新增 M3：PCB 全流程]** 在 M2 后插入“PCB 自动化设计、打板、贴片、下单、生产、回寄上机验证”里程碑；当前 B.0 / 84362651、Y10／SMT2611051346 已下单付款，等待回寄与首板测试，验收尚未完成。原自训、物理参数、语音、视觉、记忆里程碑顺延为 M4–M8。见 [MILESTONES](MILESTONES.md)。

**[2026-11-05 M1/M2 按用户口径闭环]** [用户确认] M1（装配、主控、15 舵机标定、IMU、上电）与 M2（官方模型上机+基本动作）完成。M1/M2 的验收闭环不等于所有可靠性问题解决：IMU 间歇缺答、行走摔倒/停机、起身恢复的稳定性/承重完善、全部动作完整运行继续按 M4/M5/可靠性跟踪；`deployment_verified=false` 仍是单模型自动标志，不替代用户验收。详见 [MILESTONES](MILESTONES.md)。

**[研发流程补充：第一版成本经验]** 按用户要求，将高成本经验落实到[自主模块研发流程](docs/hardware-module-development-workflow.md)：按整批金额审查高价料、布线前确定制造基线、新增特殊工艺复核整板费用、前期估算与最终同源报价分别检查、明确超预算处理，并补入一页任务卡。沿用已有历史证据，未重新询价；自主HAT继续暂停，文档修改未提交Git。

**[2026-11-05 自主模块研发流程复盘]** 按用户要求汇总HAT从需求到付款的过程，提炼[可复用研发流程](docs/hardware-module-development-workflow.md)及[有来源的阶段复盘](docs/references/自主扩展板阶段复盘/research.md)。重点前移完整成本、机械/工艺和软件支持，保留完整工程/规则/报告/订单的版本对应，分开记录设计、付款与实物验收。仅总结已有资料，自主HAT仍为用户确认已付款、等待收货、线路暂停；未重开设计、工厂操作或硬件测试，未提交Git。

**[2026-11-05 用户确认已付款，自主HAT线路暂停]** 用户明确“已付款，等待收货，这条线暂停”。Y10／SMT2611051346，84362651版5片；最后合并支付页显示891.79元（含运费5.50），付款状态依据用户确认，未另查支付回执。当前记为已付款、等待收货、线路暂停；未确认已发货或收到实物。停止降本、设计修改、订单操作及主动跟进，等待用户明确恢复。以下当日未付/询价/继续核查指示均为暂停前历史记录，不继续执行；首板未验收，原750元目标未达成，不标任务全部完成。见[订单状态](docs/references/扩展板乙版降本/order-status.json)。

**[2026-11-05 Y10合并支付价确认]** [实测：用户截图] PCB33＋元件265.52＋SMT加工587.77＋运费5.50＝891.79元；此前853.29仅为元件＋加工，不含PCB。不含运费886.29元，超750目标136.29元。新增10元位于加工项，具体服务未核；未付款、未制造放行。见[合并支付原图与记录](docs/references/扩展板乙版降本/layout-spacing/y10-quotation-status.md)。

**[2026-11-05 Y10已生成SMT订单]** [实测：用户截图] SMT2611051346于11:17:19创建，关联Y10/84362651，5片顶底层，在线支付价853.29元，待支付、有确认按钮、未做DFM图片。此前“未提交正式SMT”状态更新为已生成订单，尚未付款/制造放行。新增10元项目及“合并合同”是否含PCB须看详情；按PCB历史33元另计的条件暂算886.29元，非最终总价。见[订单截图与费用边界](docs/references/扩展板乙版降本/layout-spacing/y10-quotation-status.md)。

**[2026-11-05 Y10导出PDF核对完成]** [文件核验] PDF全部30组C编号与69个位号和84362651报价BOM一致，缺项/额外/错配/重复均0；5片、顶层＋底层、843.29元预估与前图一致。PDF预览为空，未核器件方向；也不含逐组用量/库存、基础扩展分类，216元换料费无法逐项归属。下一步由用户勾选BOM核对并进入服务/极性确认页，仍不提交付款；未修改物料或PCB。原件本地保留、脱敏派生图及核对JSON已归档，见[核对报告](docs/references/扩展板乙版降本/layout-spacing/y10-pdf-review-20261105.md)。

**[2026-11-05 Y10治具说明已核对]** [实测：用户截图] 平台以一面贴片、另一面插件为由收治具100元；[官方说明] 插件焊接面有SMT器件需遮蔽保护。[推断] 本板J101与顶面SMT配置符合该条件，间距调整不构成免治具依据；保留100元预算。下一步待用户下载完整物料匹配PDF，核30组及换料费；尚未提交或付款。见[截图、官方来源与判断限制](docs/references/扩展板乙版降本/layout-spacing/y10-quotation-status.md)。

**[2026-11-05 Y10用户操作续接]** [实测：用户截图] 84362651物料匹配页已选5片全贴、顶层＋底层、标准型、单板；30组、最近全表核对0/30。元件265.52＋加工577.77＝SMT预估843.29元，其中治具100、换料216；J101底面C2977589用量5与BOM一致。[推算] 加此前PCB初步33暂算876.29元、超750目标126.29元，非最终报价。待治具说明、其余物料及后续服务核对；未确认免贴插费，未提交正式SMT、未付款。三张截图已归档（含一张脱敏副本）。见[截图与当前下一步](docs/references/扩展板乙版降本/layout-spacing/y10-quotation-status.md)。下方布局记录的“进入物料匹配”步骤已完成。

**[2026-11-05 自主HAT Rev B.0焊接空间调整]** 现行开发源84362651保留63 SMT＋6 THT、30组BOM，28个对象移动/旋转；原生ERC/DRC/未连接/一致性均0，40P/安装孔/板框和局部焊盘针网不变。3/5mm空间筛查及额外0.2mm名义余量均通过，最紧3.31/5.46mm；舵机VBATT/GND各1.6mm、5V主干1.0mm路径连续性已核，同源Gerber/BOM/CPL/装配图已导出；Gerber已上传并生成Y10，PCB初步33元、等待审核、未付。已进入5片SMT入口，据解锁后页面记录，BOM/CPL已上传，待用户核对全焊设置并继续物料匹配。旧Y9基于99ecc45d，11-04保存的5片全焊暂合计1140.71元只作历史比较；新布局未重新报价，未确认免贴插费或达成750元目标。未提交正式SMT、未付款、未操作实机、未用子代理、未提交Git。详见[调整报告](docs/references/扩展板乙版降本/layout-spacing/research.md)、[新报价包](hardware/custom_hat/rev_b/quote-84362651/README.md)、[成本闸门](docs/references/扩展板乙版降本/cost-gate.md)。

## 硬件来源确认：HAT 与 IMU 均为 kissqy 设计（2026-11-02）

- [用户确认，11-02] 手上有 **kissqy DXL HUB V2**（4×AMP2.0 3P + 2P 输入 + 背面 1000µF/16V），但**尚未接入电源链路**（台供仍直接进 HAT），因此 1000µF 当前不生效；列为电压问题的优先整改项，接入前需核极性、接口版本与上电冲击。
- [归档，11-02] 旧白色 V1.2 HAT 与 jyg9 GD32 单口 IMU 的历史照片已移入 [docs/photos/archive](docs/photos/archive/README.md)，照片索引登记行链接同步更新；两套均标为历史，不用于当前接线。
- [用户确认] 当前整机在用的 **HAT 与 IMU 都来自 [kissqy/Microduck-kissqy hardware](https://github.com/kissqy/Microduck-kissqy/tree/main/hardware)**；记录时 `main` 提交 `d4d21c1`（2026-11-02），本地存档副本固定在 `7c5fba9`（2026-10-27）。HAT 提供 EH2.5（10-07）与 AMP2.0（10-15）两版，实物是哪版待按接口核对。作者 AMP2.0 BOM 中 HAT无48脚MCU（最高引脚数IC为TLV320AIC3104 QFN-32，另有PAM8406等），与 10-10 旧照片里的“F303 LQFP48”不一致，旧照片可能是另一块板，需重拍当前实物。[来源与待核项](docs/schematics/kissqy-hat-reva-reference/README.md)。 2026-11-04上游411878f同名工程已更新TH1/U6及局部布局，旧JSON未同步；本机实装不因此推定变化，见[新版核对](docs/references/自主扩展板与社区版成本比较/research.md)。

## 第二次行走摔倒：主控在线，反馈大量中断（2026-11-02 01:08–01:11）

- [实测] 同一 boot、robotd PID367/Studio PID480 均持续运行，无重启；01:08:34 开始走，01:08:38 起出现 IMU200 缺答，之后陈旧数据与超时交替，日志连续失败计数最高90。不能沿用上一事件的低压关机推断。
- [实测] 对比00:04基线，SYNC_READ超时增加1323、IMU重复块增加2172，ID200及多个舵机都有缺答；01:09:47网页“停下”明确关闭策略。没有本次robot.recover请求或8秒恢复会话。
- [源码核验／推断] 连续失败超3周期暂停模型并保持实测姿势，恢复反馈后继续；这会严重影响起身，但物理摔倒与通信故障的因果顺序未确认。电压偏低，供电/连接/IMU更新/总线接收原因尚待分离。
- [实测，01:11] 策略关闭，**扭矩仍开启并确认**；倾角77.82°，IMU及15关节反馈恢复。CPU83.888°C，未出现本次热关机；41个受保护文件哈希不变。本轮只读、未动作。[完整日志与分析](docs/references/飞特策略模型上机核对/walk-fall-second-20261102.md)。未提交。
- [复核，11-02] 两起事件的电压数据与 15 颗舵机供电预算已对照：静置 7.10～7.11 V，负载反复跌到 6.55～6.92 V，最深 5.92 V 出现在恢复请求期间；日志无电流读数，3 A 限流与路径压降尚未分离。见[电压不足复核](docs/references/飞特策略模型上机核对/voltage-sag-review-20261102.md)。

## 行走摔倒后停机调查（2026-11-01 事件，11-02 取证）

- [用户确认] 7.4 V／3 A 台式电源，行走摔倒后自行翻身数次、突然停止；用户随后手动重启。
- [实测] 23:54:20 舵机电压遥测从约 7.11 V 降到 5.92 V，15 颗为 5.7～6.6 V；23:54:49 开始走获接受，约 17.45 秒后 Studio 与用户会话有序停止。四次更早的显式躺姿恢复均很快结束，原生原因缺失。
- [源码核验] 实际配置未写 `battery_empty_shutdown`，原生默认 true、EMA≤6.6 V 自动关机；Studio 却将缺项显示为只警告。[推断] 低压自动关机最吻合，但故障 boot 的系统/robotd journal 未保留，缺直接触发证据；限流、配电压降及过热均未定因。
- [实测，11-02 00:04] 用户重启后 robotd/Studio 已自启 active/enabled，策略及扭矩关闭，IMU ready，六模型加载，41 个受保护文件哈希不变。本轮只读取证，未改配置、未追加动作。[完整调查与原始日志](docs/references/飞特策略模型上机核对/walk-crash-investigation-20261101.md)。未提交。

## 躺姿起身入口部署时的只读验收（2026-11-01 23:49–23:50）

- [来源核验] 已装walk联合模型的导出配置包含倒地初始化课程及恢复奖励，env.yaml与包内声明、ZIP原件哈希一致；本机起身未测试。普通网页“站起来”只回HOME，“开始走”要求直立。参考版本已退役旧stand_test teacher，LB迁移为左踢，纠正此前“只是未配置”的说法。
- [源码核验／离线实测] 按用户批准方案实现独立“躺姿起身”入口，直接使用Net::Walk，零速度恢复／保持，具备8秒上限、取消和断连退出；普通起步保护与混合SYNC_READ未改。ARM64构建、恢复与会话测试、原始包补丁重放通过；一项旧测试在原始源码也失败，已单独记录。[交付及验收](software/robotd-recovery/README.md)、[Spec](docs/specs/20261101-webpad-walk-recovery/spec.md)。
- [实测] 用户随后要求“部署”；23:49安装完成，23:50网页只读验收通过。robotd PID843、Studio PID851，均active/enabled，六模型已加载；41个受保护文件哈希未变。页面恢复按钮可用，恢复idle、无request_id、策略关闭且扭矩确认关闭；没有起身或行走测试。现场备份与原始数据见[部署记录](docs/references/飞特策略模型上机核对/webpad-recovery-deployment-20261101.md)。未提交。
- [实测历史] 最近一次已归档回包为上力保持、策略关闭，IMU推算倾角约90.77°、HOME起步保护未通过；不是本次执行时的即时状态。本轮未发动作、未改配置。与之前部署结束时卸力状态区分。见[研究](docs/references/飞特策略模型上机核对/getup-availability-20261101.md)。

## 网页手柄与六模型已接通，部署结束时卸力（2026-11-01）

- [用户确认／实测] 用户已完成正式标定，15 个 `calibrated=true`、`zero_raw=2048`、IMU 已验证，主程序为 `motion/control`。网页手柄无需蓝牙配对；六模型文件哈希一致。经用户确认托稳，仅将 `[policy] enabled` 改为 true 并重启，六模型已加载、五个按键绑定无错误；robotd PID 1567、Studio PID 973 均 active/enabled，部署结束时确认卸力、动态动作开关关闭，未运行站姿或模型动作。首次因助手误读扭矩状态字段触发回退，修正验收后部署通过，原始记录保留。
- 网页入口 `http://192.168.1.35:8000/#/pad`；图中 A=捡取、X=前滚翻、LB/RB=左右踢、十字键下=起坐，行走使用摇杆/键盘。当前技能置灰原因为尚未站起/开始走，不是缺少模型。
- [实测] 加载前主控 85°C、816 MHz，最终降至 408 MHz；卸力循环约49.97 Hz，模型动作的实时性能尚未验证，正式行走前需关注散热。记录和单字段差异见[研究](docs/references/飞特策略模型上机核对/webpad-models-check-20261101.md)、[Spec](docs/specs/20261101-webpad-policy-enable/spec.md)。未提交。

## Studio 第 3 步交接配置修正与预览（2026-11-01 早期记录；正式写入已完成）

- **[实测／修正前]** 用户截图报“主程序的标定模式不是镜像设的，不敢自动切”，helper 返回 `foreign`；主程序在线、15 个零位为 2048。定位时用户站姿保持、编码器目标误差 1.67°，不等于无支撑平衡验收。迁移开始前已卸力，助手没有发卸力或动作命令。
- **[实测／已部署]** 用户批准后，基础 service 去掉 `--read-only`、临时 commissioning 覆盖迁入正式文件名，旧覆盖归档。只 daemon-reload，robotd/Studio PID 1067/973、启动时刻、有效参数均未变，两服务 active/enabled；标定、pending、模型主配置和全部相关保护文件 SHA 不变。
- **[实测／验收]** helper 识别为 commissioning，原生 dry-run 与网页实际 `calib.op/preview` 均通过；HTTP 200、页面准备状态 `ready=true`。迁移前后均 commissioning/ready/off，当时未正式提交标定、未运行模型；用户随后已在网页完成正式写入，现状见上节。见[研究与证据](docs/references/飞特策略模型上机核对/studio-commit-mode-error-20261101.md)及[Spec](docs/specs/20261101-studio-calibration-handover/spec.md)。

## Studio 两个站姿入口的零位已对齐，物理效果待验证（2026-11-01）

- **[用户反馈]** 新单口板下舵机页站姿能站住，IMU 页站姿角度异常。
- **[实测／源码计算]** 15 颗 Studio 中位校准记录齐全；无另存站姿，方向均 −1，共同 HOME 弧度相同。修正前主程序使用参考机零位，舵机页使用 2048；左膝、颈、右踝计算目标分别相差 57.66°、42.01°、38.41°。现已仅对齐 15 个零位，共同 14 个目标计算一致；嘴的命令范围按各入口保留。
- **[实测／已部署]** 用户确认托稳并批准后，基于停服后的最新文件仅改 `zero_raw=2048`，原生 `calibration-status` 回读全部通过；最新 IMU 安装四元数、完成标志和动作保护保留。robotd/Studio active/enabled、HTTP 200，servo-web inactive/disabled，commissioning/ready/off、策略关闭；本轮未试站姿或模型。首次因网页检查早于 Studio 就绪而自动回退，补齐有限等待后重试成功，两次证据均保留。
- **限制**：零位修正后已有用户触发的保持回读（见上节），没有助手实物量角或无支撑平衡验收；新板 ID 200 缺答仍独立保留。正式交接启动配置已在上节修正并通过预览，实际提交随后已由用户完成，现状见本页顶部；零位修正本身不作为整套交接验收。见[完整对照与部署证据](docs/references/飞特策略模型上机核对/studio-home-target-mismatch-20261101.md)与[Spec](docs/specs/20261101-studio-home-zero-alignment/spec.md)。

## Windows 安装 VS Code（2026-11-01）

- **[实测]** 按用户要求通过 WinGet 安装当前用户版 VS Code **1.143.1 x64**，安装包哈希校验及安装成功；CLI 版本、开始菜单快捷方式和用户 PATH 已核对。见[安装记录与验证输出](docs/references/代码编辑器安装记录/research.md)。

## 站姿使能因 IMU 超时停止（2026-11-01，未修复）

- **[实测／断电后自启确认]** 用户报告刚断电并要求 robotd/Studio 开机自启；检查时两者已 enabled/active，再执行 `systemctl enable` 固化并核对 multi-user.target 链接。本次启动后约 8.3/9.8 秒分别启动 robotd/Studio，Studio HTTP 200；servo-web disabled/inactive。本轮未重启服务、未重启主控或发动作。见[自启核对](docs/references/飞特策略模型上机核对/robot-studio-autostart-confirmed-20261101.json)。

- **[实测／最新服务切换]** 用户要求关闭 servo-web、启动 robotd/Studio。因回读 15 颗仍上力，经用户确认托稳后完成切换；robotd/Studio active，servo-web inactive，Studio HTTP 200，原版 robotd commissioning/ready、已卸力、策略关闭。自启配置未改，未执行站姿或模型动作；见[最终回读](docs/references/飞特策略模型上机核对/robot-studio-switch-result-20261101.json)。

- **[实测／服务再次启动]** 用户要求打开 servo-web 服务；核对 robotd 已卸力、策略关闭后停止 robotd/Studio，启动 servo-web，页面 HTTP 200、15/15 舵机在线。自启配置未改，未做动作；见[启动回读](docs/references/飞特策略模型上机核对/servo-web-service-start-20261101.json)。

- **[用户最新决定／回滚验收]** [用户确认] 新单 3P 口 IMU 已到货并换上。[实测] 主机通信已回滚为 IMU＋15 舵机同组 SYNC_READ；servo-web 30 秒 296/296 帧舵机完整、IMU 约 9.9 Hz，0 超时/坏校验/错 ID。robotd 已恢复原版；只读验收后已按用户要求切回 robotd/Studio（运行中），servo-web 已停止；此前助手只做过新板只读验收；此前两页站姿零位差已修正，用户已正式写入标定；模型已加载、动作未测试。 原单口板人为损坏的电阻位号/日期未核；双口 v0.3 的波形/SWD 根因排障继续暂缓。参考标定、模型和 Studio 显示适配保留。见[当前回滚记录](docs/references/飞特策略模型上机核对/restore-mixed-sync-read-20261101.md)。

### 此前排障证据与暂缓方案

- **[用户暂停／接探头方法补充]** 根因任务当前暂停。本轮只核对小焊盘固定：建议先两通道，TX 用短细绝缘线引出并固定绝缘段和探头电缆；DATA/GND 可改用已核对的 J1/J3 大接口焊点，不让小焊盘承受探头拉力。尚未接探头或动作；见[同网测点与固定方法](docs/references/飞特策略模型上机核对/root-cause-investigation-20261101.md)。

- **[实测，13:33 根因任务]** 用户确认已固定、可做短时对照。4000 周期卸力只读对照未出现完整坏 checksum 帧；原 robotd 临时 10 Hz 的一次站姿仍在首次插值后收到坏帧（5A 应有、5E 实收），上一目标写至 READ 已间隔 **91.277 ms**，固件取消／收发错误计数无增量。已恢复 50 Hz、15 颗卸力、原生产配置 SHA；实验覆盖文件已删除。[推断] 降频未解决，下一步需要 MCU TX／外部 DATA／主控接收的同步证据。示波器已确认是 SDS814X HD 并经 USB 枚举；13:59 USB PnP 已恢复正常；暂停前 VISA 仍在安装，仪器查询尚未通过，未采波形。见[根因任务及原始数据](docs/references/飞特策略模型上机核对/root-cause-investigation-20261101.md)。
- **[源码核验／虚拟时序，IMU＋robotd 联合分析]** 主机 2 ms 只用于 `ppoll`，不会重配、重发或清掉半包；固件另有 500 µs 请求字节超时、50 µs 应答延迟、应答迟到 2 ms 后取消。两应用均无 `tcdrain`／明确包间静默，读取先后改变不等于发送节奏一致。原固件代码 28 个虚拟时序场景未生成坏 checksum，超时／插字节表现为不应答；不含板级 UART，不能排除真实回切问题。[推断] 继续并列查发包间隔、50 µs 回答与硬件回切、自身回显恢复边界，不能因坏包早到排除所有时序。见[完整分析](docs/references/飞特策略模型上机核对/imu-robotd-timing-analysis-20261101.md)。本轮只读源码／既有抓包，未追加动作或改参数。
- **[实测／源码核验，坏帧离线分析]** 原始包在主机 `read()` 取得时已校验无效；三次基线分别发现状态高位 `80`、ID `EC`、状态高位 `80` 等违反 replica 0.2.0 固定字段的候选字节。将前次＋本轮共 5 个坏包交给 servo-web 原样校验函数，5/5 同样拒收，34 个相邻有效包全部接受。正常固件采样、快照组包及发送同步执行，未找到采样覆盖 TX 缓冲的常规路径；IMU UART／CRC 计数监测接收端，不能证明自身回包正确。[推断] 下一步优先分段比较 IMU 总线 TX、共用 DATA、HAT RX 与主机字节，具体物理或固件机理仍待确认；本轮未连真机、未动作、未改保护。见[分析与证据](docs/references/飞特策略模型上机核对/research.md)及[离线回放结果](docs/references/飞特策略模型上机核对/hold-corruption-analysis-20261101.json)。
- **[实测，12:21–12:31 三次复现＋一次改序]** 用户要求的三次基线均在 Ramping 失败，失败前分别写了 2／3／2 次插值目标，21 字节坏帧实收 checksum 为 4C／41／56，非固定周期或校验值。先舵机后 IMU 实验在第一次插值后仍收到坏帧（期望 8C／实收 0C），当周期已先收齐 15 颗有效舵机反馈；仅改顺序未解决该次故障。7/7 传输测试和 arm64 编译通过，失败后已恢复 `duck-v03.1`，四次均有 15 颗卸力回读。12:31 最终核对两服务 active/enabled、Studio health 200、commissioning/ready/off；后台仍有通信失败，未改等待/卸力保护、配置、标定或固件。10 份远端原件与本地 SHA 相同。见[研究与等待判错对比](docs/references/飞特策略模型上机核对/research.md)、[汇总证据](docs/references/飞特策略模型上机核对/hold-repetitions-comparison-20261101.json)及[实验 Spec](docs/specs/20261101-servo-first-imu-read/spec.md)。
- **[源码核验／实测，11:59 端口锁复查]** robotd 的 IMU READ 和舵机 SYNC_READ 由同一个 control 循环顺序执行，前者失败即跳过后者；11:51 坏帧窗口没有交叉舵机读取。11:59 `/proc` 只发现 robotd 的 FD 11 占用 ttyS2，内核显示 `FLOCK ADVISORY WRITE`；旧 servo-web inactive。现有证据不支持“缺少线程锁使两路请求并发”的解释，不能据此排除电气回切／异常设备发包。两程序实际遥测顺序相反、默认频率和失败处理不同。仅只读核对，未改运行行为或追加动作；见[锁、顺序及限制](docs/references/飞特策略模型上机核对/research.md)。
- **[实测，11:51 一次原生动作复现]** 用户确认托稳后，按 Studio 原样 `hold-home`（15 个 −1、3000 ms）执行一次：预载和上力成功，15 颗扭矩回读 1；发送两次起身插值后，下一 ID 200 READ 在 **0.867 ms** 返回 21 字节，**checksum 错误（期望 0x8C、实收 0x5D）**。原生丢弃后等到截止时间报 `response timeout`，然后主动卸力，15 颗回读 0。因此这次“超时”不是完全无字节。前后取消回复、UART/CRC/溢出计数无增量；坏帧产生位置尚未查明，不归因于限流或取消回复。原生采集共 54 次 IMU READ，53 成功、1 次上述错误。结束已恢复两服务、commissioning/ready/off；一次动作授权已用完，没有追加动作或修改生产代码。见[完整时序、原始帧与限制](docs/references/飞特策略模型上机核对/research.md)及[解析结果](docs/references/飞特策略模型上机核对/hold-home-replay-summary-20261101.json)。
- **[实测，11:11–11:19 新证据]** 113 字节目标写包后 ID 200 无应答，53 字节包也复现；最后窗口主控 TX 队列已空、15 颗舵机应答有效，稍后 IMU 帧存在坏校验。**写前扭矩为 0，写目标后 15 颗回读为 1**，因此撤回“卸力时原样写目标等于无动力测试”的假设，两份写包诊断脚本已禁用。服务已恢复 active/enabled、commissioning/ready、off。用户确认台式电源 7.4 V/3 A；最新数次尝试未见限流、显示电流一直低于 1 A，限流假设已降低优先级，不能作为已查明原因。另有卸力时固件取消回复和主机超时路径，不能把全部错误归于一个原因。见[原始数据与限制](docs/references/飞特策略模型上机核对/research.md)。
- **[用户确认/实测]** 用户指出每次点击站姿使能都会变软，现按动作触发问题排查，撤回此前笼统“偶发”描述。日志已记录 10:53:31、10:56:30 两次同样失败。11:00 核对运行进程 SHA 与单播补丁构建一致：ID 200 仍用 READ（0x02）单独读 56/15，随后 15 舵机 SYNC_READ（0x82）；两段合计 20 ms，无 IMU 请求重发，未切回旧混读。见[读取方式证据](docs/references/飞特策略模型上机核对/imu200-read-method-20261101.json)及[源码定位](docs/references/飞特策略模型上机核对/imu200-read-source-20261101.json)。
- **[实测]** 10:53:31 用户点击站姿使能，应用返回 `hold-home stopped: ... imu_to_dxl ID200 response timeout`；10:55 主程序仍在线、处于卸力。固定源码在起身阶段遇一次读失败即取消并卸力；已站稳阶段另为连续 25 次失败阈值。
- **[实测/边界]** 10:55 快照 5272 周期中 2 次 IMU 超时，不能称连接恢复后站姿已验证，也不能按总周期统计弱化每次动作失败。IMU 粗校允许在卸力、手扶稳时采数，站姿使能不是必经条件；坏帧机理和标定写入适配仍待处理。10:55 阶段仅只读；随后实验写过目标，11:51 又经用户授权调用一次原生站姿入口，不能将整轮称为只读。保护阈值未改。见[诊断与源码](docs/references/飞特策略模型上机核对/research.md)及[早期原始日志](docs/references/飞特策略模型上机核对/studio-stand-limp-20261101.json)。

## Studio 机器人连接恢复，主程序自启已补齐（2026-11-01）

- **[实测]** 10:48 排障发现 robotd 未启动且 disabled，旧 servo-web 自启占串口。已停止并取消 servo-web 自启，启动 robotd 并启用自启；Studio 保持 enabled。网页接口已回读主程序在线、15/15 颗舵机在线。
- **[实测/用户确认]** 用户随后在 Studio 调舵机、执行站姿，舵机会话接管总线并暂停 robotd，离页保持 14 颗导致 IMU 粗校缺少主程序。用户确认托稳后，已通过 Studio 正常交还流程卸力、释放串口并恢复 robotd。
- **[实测/10:53:39]** robotd PID 1191、Studio PID 483 均 active/enabled；servo-web inactive/disabled；15 颗卸力、策略关闭、IMU 数据有效，安装方向仍未验证。约 50.02 Hz、1025 周期 1 次通信失败，配置与标定 SHA 未变。IMU 粗校前须交还舵机会话；标定写入的模式适配缺口尚未修改。见[记录](docs/references/飞特策略模型上机核对/research.md)及[最终回读](docs/references/飞特策略模型上机核对/studio-connect-restored-20261101.json)。

## Studio 开机自启已确认（2026-11-01）

- **[实测]** 北京时间 10:47 核查，`microduck-studio.service` 原已启用开机自启，当前 active/running、PID 483；本次系统启动约 9.83 秒后进入运行，`/healthz` 返回 HTTP 200、`ok=true`。现有配置满足用户要求，本轮无需修改或重启。
- 访问地址 `http://192.168.1.35:8000/`；10:47 这次仅核查 Studio，随后机器人连接问题与 robotd 自启已在上节处理。见[自启记录与边界](docs/references/飞特策略模型上机核对/research.md)及[当时回读](docs/references/飞特策略模型上机核对/studio-autostart-20261101.json)。

## Studio 标定完成提示排障（2026-11-01）

- **[实测/00:03–00:07 排障时服务]** robotd 已于 00:02:12 启动，PID 4276；Studio PID 4179，两者 active/running。原生 `commissioning/ready`、约 50 Hz，15 颗有反馈、扭矩关闭、策略未启用。当时“主程序说标定没做完”并非服务未启动；Studio 后续启动状态见上节。
- **[实测/标定状态]** Studio 已记录 15 颗中位校准完成；主程序 TOML 仍是之前的参考配置，15 个完成标志和 IMU 方向验证标志仍为 false。实际网页提示“新零位尚未写入主程序”，IMU 方向为准备页未通过项；不要求重复舵机校准。
- **[实测/交接缺口]** 只读 helper 返回 `mode=foreign`：当时临时 commissioning 覆盖未接入 Studio 自动交接；后续配置已修正，用户已正式写入，见本页顶部。该次只做排障。见[现状与证据](docs/references/飞特策略模型上机核对/research.md)。

---
2026-10 及以前记录已归档到 [docs/archive/progress-2026-10.md](docs/archive/progress-2026-10.md)。
# 训练记录目录清理（2026-11-09）

[本机实测] 训练工作台已收敛到 `training/records/`：只有训练流程生成的 `record_kind=training-run` 文档会被读取，启动时不再扫描 `docs/specs/`、`docs/references/` 或 `training/logs/`。历史平台副本按检查点内的冻结源码哈希合同和 rank0 检查点判定，保留 1 条可回放记录，清除 48 条不可回放/不可复原副本；原始专题材料未删除，台账见 [`training/records/cleanup-20261109.json`](training/records/cleanup-20261109.json)。

[本机实测] 使用保留的 `history-0c644bb9471038a9fd18` 检查点在 RTX 5090 CUDA 回放进入 `playing`，累计 1008 帧后停止，证据见 [`replay-validation.json`](docs/specs/20261109-训练档案与复训/checks/replay-validation.json)。这只验证回放链路，不代表策略行为达标；9 条历史记录均未核验原状态续训、接权重或从零复训合同。
