parkourlrc/pcb-yilv1982--duck-robot-89dbc81d6d/MILESTONES.md

# 项目里程碑

更新：2026-11-05（Asia/Shanghai）。状态口径：**已完成（用户确认）/ 进行中 / 未开始 / 阻塞**。里程碑以“验收标准 + 证据 + 用户确认”判定；单项测试通过不等于里程碑完成。

## 总览

| ID | 里程碑 | 状态 | 完成日期 | 证据入口 |
|---|---|---|---|---|
| M1 | 硬件组装、主控运行、舵机标定、IMU 工作、上电无显问题 | 已完成（用户确认，已闭环） | 2026-11-05 | [PROGRESS](PROGRESS.md)、[装配与中位校准](docs/references/整机装配与中位校准/research.md) |
| M2 | 官方模型上机并完成基本动作 | 已完成（用户确认，已闭环） | 2026-11-05 | [模型清单](training/MODELS.md)、[上机核对](docs/references/飞特策略模型上机核对/research.md) |
| M3 | PCB 自动化设计、打板、贴片、下单与回寄上机验证 | 进行中（已下单，待回寄/上机） | — | [运行手册](docs/pcb-production-runbook.md)、[VERSIONS](hardware/custom_hat/VERSIONS.md)、[rev_b](hardware/custom_hat/rev_b/README.md)、[PROGRESS](PROGRESS.md) |
| M4 | 自训环境搭建，至少一个自训策略跑通训练并上机 | 进行中 | — | [training](training/README.md)、[训练研究](docs/references/动作训练软件研究/research.md) |
| M5 | 物理参数重新优化，重训官方动作并完整运行 | 未开始 | — | [物理参数表](docs/references/动作训练软件研究/physical-params.md) |
| M6 | 语音识别、指令识别与声纹 | 未开始 | — | 硬件/方案待定 |
| M7 | 视觉识别与自主调用指令 | 未开始 | — | 硬件/方案待定 |
| M8 | 自学习能力与本地记忆 | 未开始 | — | 依赖 M6/M7 |

## M1 硬件组装与整机可用

**验收标准**

1. 15 颗 HD-1910-C001 完成装配、ID 对齐与整机线束连接。
2. 主控 Radxa Zero 3W 正常启动，robotd/Studio（或当时对应服务）可运行，总线可通信。
3. 15 颗舵机完成本机中位标定：`calibrated=true`、`zero_raw=2048`，回读通过。
4. IMU 正常出数；上电检查无冒烟、异常发热、明显过流/欠压或极性错误。
5. BOM、照片、接线/标定证据和已知问题已登记。

**状态与证据**：用户确认 2026-11-05 完成。装配与标定记录见 [装配与中位校准](docs/references/整机装配与中位校准/research.md)、[PROGRESS](PROGRESS.md) 2026-10-20/11-01 条目；当前物料见 [BOM](BOM.md)。

**已知遗留（不否定 M1 的用户口径，转入后续）**：IMU 间歇缺答/总线异常与行走摔倒转入可靠性/M5 跟踪（问题本身未结案）；自主 HAT B.0 未到货/未装机，当前装机板为 kissqy HAT；旧板损伤与维修经过见 [扩展板焊盘脱落修复](docs/references/扩展板焊盘脱落修复/research.md)。

## M2 官方模型上机与基本动作

**验收标准**

1. 官方/外部已训练模型在板侧可加载，文件哈希与清单一致（当前 6 个普通足部模型）。
2. 至少一个模型在真机上完成一类基本动作（站立、起坐或行走中的至少一类），动作命令与安全停止可用。
3. 模型来源、哈希、部署参数、标定前提和失败记录可追溯，不把“加载成功”写成“动作验收通过”。

**状态与证据**：用户确认 2026-11-05 完成。6 个普通足部模型已导入板侧，SHA 6/6 一致；见 [training/MODELS.md](training/MODELS.md)、[上机核对](docs/references/飞特策略模型上机核对/research.md)、[PROGRESS](PROGRESS.md) 10-31/11-01 条目。

**口径边界**：本里程碑的“基本动作”按用户口径指官方模型已在真机执行过基本动作；行走稳定性、全部动作完整运行归 M5。起身恢复已达到基本完成要求（用户确认 2026-11-05），其稳定性/承重与不完美项归 M5。已知行走约 17.45 秒后停止、第二次摔倒见 [停机调查](docs/references/飞特策略模型上机核对/walk-crash-investigation-20261101.md) 与 [第二次事件](docs/references/飞特策略模型上机核对/walk-fall-second-20261102.md)，这些记录保留、不随 M2 关闭。

## 闭环记录（2026-11-05）

- **M1 闭环**：用户确认整机装配、主控运行、15 颗舵机中位标定、IMU 出数与上电检查按 M1 标准完成。闭环范围是“整机可装配、可上电、可标定、可通信”；不把 IMU 间歇缺答或行走稳定性算作 M1 未完成。
- **M2 闭环**：用户确认官方模型已上机并完成基本动作。闭环范围是“模型可加载、哈希一致、至少一类基本动作在真机执行”；`deployment_verified=false` 是单模型自动标志，不替代用户验收，也不等于稳定/完整动作通过。附加：躺姿起身恢复入口已达到基本完成要求（用户确认），不完美项归 M5。
- **转出（不随 M1/M2 关闭）**：IMU 间歇缺答/总线异常、行走摔倒/停机、起身恢复的稳定性/承重完善、全部动作完整运行、自主 HAT B.0 到货与首板验收，继续在 PROGRESS 与对应专题跟踪。

## M3 PCB 自动化设计、打板、贴片、下单与回寄验证

**目标**：从可编辑 PCB 工程走通“设计/检查 → 同源 Gerber/BOM/CPL → 嘉立创下单 → 打板/贴片 → 回寄 → 上机测试”的全流程。

**验收标准**

1. 设计源、规则、检查报告与 Gerber/BOM/CPL 同源绑定，哈希可追溯；报价、付款、制造放行、回寄、验收分开记录。
2. PCB 与 SMT/PCBA 订单完成，订单号、付款、物流/回寄状态可查。
3. 回寄后完成外观、极性、关键网络与上电前检查，按 [AGENTS](AGENTS.md) 的安全边界上电。
4. 首板上机测试通过：至少主控供电、HAT→IMU/舵机通信与基本功能可用；失败项、返修与复测记录在案。
5. 全流程证据完整：版本→源哈希→包→订单→回寄→测试→结论。

**当前状态**：进行中。B.0 / `84362651`，Y10／SMT2611051346，5片已付款；[工厂MK701/Y701方向确认](docs/references/扩展板乙版降本/engineering-feedback/research.md)已完成本地核对，待用户回复，未确认发货；首板未验收。见 [VERSIONS](hardware/custom_hat/VERSIONS.md)、[rev_b](hardware/custom_hat/rev_b/README.md)、[PROGRESS](PROGRESS.md)。

**边界**：下单完成不等于制造放行、回寄或上机通过；HAT 线路暂停期间只跟踪已下单批次，不重开设计/降本。可与 M4 自训并行。

**执行**：按 [PCB 运行手册](docs/pcb-production-runbook.md) 的 Stage 0–10 和 G1–G5 门禁执行；新项目从 [模板](hardware/templates/pcb-project/README.md) 复制需求卡。

## M4 自训环境与首个自训策略上机

**验收标准**

1. 自建物理模型、任务环境、PPO 训练入口可复现；训练命令、配置、随机种子和依赖已记录。
2. 至少一个自训策略通过预设仿真验收指标，导出 ONNX 并记录哈希、观测/动作契约。
3. 该策略上机执行一类基本动作；记录 `deployment_verified` 与失败边界。
4. 训练、导出、部署链路有可复现记录，不混用外部模型权重。

**当前状态**：进行中。`training/` 已有自建环境与 23 组 checkpoints，`training/logs/rsl_rl/duck_walk/` 保留运行，`model_9999.pt` 仍在；尚无自训策略上机记录。见 [training/README.md](training/README.md)、[training/MODELS.md](training/MODELS.md)、[real2sim2real 计划](docs/real2sim2real-toolchain-plan.md)。

**下一步**：选定一个动作（建议先站立或行走），定义仿真验收指标，完成导出/契约/上机只读与带保护动作测试。

## M5 物理参数优化与官方动作重训

**验收标准**

1. 质量、惯量、摩擦、BAM/执行器参数按本机数据重新辨识，记录来源与不确定度。
2. 以新参数重训官方 6 个普通足部动作（起坐、行走、前滚翻、左右踢、地面捡取）；每个动作在定义测试流程下完整运行，无摔倒/异常停止。
3. 新旧模型的仿真与真机回归对比、失败样例和模型哈希/契约已记录。
4. 完善躺姿起身恢复的稳定性、承重与异常回退（M2 已基本完成，不完美项在 M5 收口）。

**状态**：未开始，依赖 M4。参考 [物理参数表](docs/references/动作训练软件研究/physical-params.md)、[BAM m6 参数](training/params/hd1910_bam_m6.json)。

## M6 语音识别与声纹

**验收标准（建议，硬件选型后定阈值）**

1. 唤醒词与至少 5 条安全指令在安静/噪声环境下可识别，延迟满足交互要求。
2. 声纹能区分授权用户与非授权用户；记录 FAR/FRR/EER 测试方法与结果。
3. 指令映射到安全动作，带确认/取消/急停；识别失败不触发动作。
4. 麦克风硬件、离线/在线方案、隐私与录音留存策略已确认。

**状态**：未开始；麦克风与算法方案未定。

## M7 视觉识别与自主调用

**验收标准（建议）**

1. 摄像头采集与目标/场景识别可用，记录分辨率、帧率与延迟。
2. 视觉结果能自主调用已注册指令；带置信度门槛、失败回退与安全门控。
3. 识别错误不直接触发危险动作；人工接管和停止可用。

**状态**：未开始；摄像头与算力方案未定，依赖 M2/M5 的动作接口稳定。

## M8 自学习与本地记忆

**验收标准（建议）**

1. 本地记忆可存储/检索任务经验、环境与用户偏好，重启后保留。
2. 能从新经验改进一个定义任务，且有防灾难性遗忘/回滚机制。
3. 记忆的隐私、保留期限、清除与导出方式明确。

**状态**：未开始；依赖 M6/M7 的感知与交互输入。

## 依赖与推进顺序

M1 → M2；M3（PCB 全流程）与 M4（自训）可并行；M5 依赖 M4；M6、M7 可在 M2 后预研、在 M5 后集成；M8 依赖 M6/M7。IMU 间歇缺答、行走稳定性等可靠性问题继续在 [PROGRESS](PROGRESS.md) 跟踪，不因里程碑标记完成而关闭。

## 维护规则

- 状态变化只改本页与 PROGRESS 的当前摘要，并附证据链接；不删除历史失败记录。
- 里程碑完成需用户确认；未确认前最多标“进行中/待确认”。
- 新增/拆分里程碑在此表登记，保持 M1–M8 编号稳定。
