parkourlrc/pcb-yilv1982--duck-robot-89dbc81d6d/docs/references/目录改名对照.md

# 目录改名对照（2026-11-05）

> 2026-11-10：表中的「动作训练软件研究」「强化学习训练流程拆解」「真机训练与仿真迁移」「自主训练平台」「本机训练环境」等训练专题已迁至 [duck-robot-training](https://gitee.com/yilv1982/duck-robot-training/tree/main/docs/references)；本表只保留旧目录名对照。

| 旧目录名 | 现目录名 |
|---|---|
| `assembly-check-20261017` | `整机装配与中位校准` |
| `b-feetech-policy-deployment-20261024` | `飞特策略模型上机核对` |
| `bus-storm-power-20261025` | `总线风暴与惯性闪断` |
| `c-motion-training-20261015` | `动作训练软件研究` |
| `consumer-electronic-toys-market-20261010` | `消费电子玩具市场研究` |
| `daplink-connectivity-20261014` | `调试器连接故障定性` |
| `dsh-runtime-20261014` | `智能终端运行时升级` |
| `eh-crimp-purchase-20261012` | `端子压接采购调研` |
| `emmc-flash-radxa-zero3w-20261013` | `瑞莎开发板存储线刷` |
| `esp32-mlp-deployment-20261014` | `乐鑫芯片跑多层感知机` |
| `ft232h-ft232rl-20261014` | `两种串口桥芯片区别` |
| `ft232h-radxa-serial-20261016` | `串口桥接瑞莎调试口` |
| `hardware-module-retrospective-20261105` | `自主扩展板阶段复盘` |
| `hat-buck-stencil-20261102` | `归档扩展板钢网分窗审查` |
| `hat-codec-padstack-20261102` | `归档扩展板音频芯片焊盘` |
| `hat-design-inventory-20261028` | `扩展板设计来源盘点` |
| `hat-imu-shared-bus-20261027` | `扩展板双口惯性缺答复核` |
| `hat-jlc-inquiry-20261031` | `扩展板嘉立创询价` |
| `hat-jlc-self-check-20261102` | `归档扩展板嘉立创规则自查` |
| `hat-jlc-stock-redesign-20261104` | `扩展板全现货改版` |
| `hat-kissqy-cost-comparison-20261104` | `自主扩展板与社区版成本比较` |
| `hat-mechanical-20261102` | `归档扩展板机械适配复核` |
| `hat-order-20261103` | `自主扩展板下单记录` |
| `hat-panel-edge-20261102` | `扩展板邮票孔与电源修复` |
| `hat-polarity-materials-20261102` | `归档扩展板极性与装配资料` |
| `hat-remaining-smt-20261102` | `归档扩展板贴片与层叠复核` |
| `hat-revb-cost-20261104` | `扩展板乙版降本` |
| `hat-self-design-workflow-20261028` | `自主设计扩展板流程` |
| `hat-servo-bus-debug-20261016` | `扩展板舵机总线排障` |
| `hat-simulation-tools-20261029` | `扩展板电路仿真工具` |
| `hat-smt-compliance-20261102` | `归档扩展板贴片规范复查` |
| `hat-stencil-20261102` | `归档扩展板钢网与裸露焊盘` |
| `hat-thermal-adoption-20261102` | `归档扩展板热焊盘回写` |
| `hat-two-orders-20261104` | `两套扩展板订单与报价` |
| `imu-fw-v1-code-analysis-20261026` | `惯性单元固件代码分析` |
| `imu-jyg9-power-5v-20261026` | `单口惯性单元五伏供电` |
| `imu-to-dxl-variants-20261009` | `惯性单元三版来源对比` |
| `imu-v03-input-voltage-20261031` | `惯性单元输入电压复核` |
| `imu-v03-jlc-order-20261025` | `惯性单元嘉立创下单` |
| `kicad-agent-skills-20261030` | `电路设计工具智能插件` |
| `kissqy-full-review-20261104` | `社区作者仓库完整核查` |
| `microduck-battery-20261008` | `电池取电结构查证` |
| `microduck-hat-20261006` | `白色扩展板原理图查证` |
| `microduck-imu-community-20261026` | `社区惯性单元通讯核查` |
| `mjlab-task-training-walkthrough-20261103` | `强化学习训练流程拆解` |
| `mujoco-viewer-optimization-20261021` | `物理仿真查看工具优化` |
| `pcb-pad-repair-20261027` | `扩展板焊盘脱落修复` |
| `power-distribution-comparison-20261010` | `配电与保护方案对比` |
| `power-review-20261010` | `供电与扩展板实物复核` |
| `power-transient-measurement-20261102` | `瞬态电压电流测量` |
| `progress-review-20261012` | `进展与计划复核` |
| `project-structure-governance-20261105` | `项目目录结构治理` |
| `radxa-a7z-vs-zero3w-20261014` | `两款瑞莎开发板对比` |
| `radxa-env-check-20261014` | `瑞莎开发板软件环境` |
| `radxa-system-check-20261014` | `瑞莎开发板系统镜像` |
| `reference-layout-20261010` | `上游参考资料目录整理` |
| `repository-sync-20261102` | `全量提交与托管同步` |
| `robot-training-routes-20261015` | `真机训练与仿真迁移` |
| `runtime-policy-model-20261013` | `运行时策略模型调研` |
| `sd-flash-radxa-zero3w-20261013` | `瑞莎开发板存储卡烧录` |
| `servo-id-align-20261024` | `舵机编号对齐上游` |
| `servo-web-cal-droop-20261023` | `舵机网页工具校准下垂` |
| `servo-web-imu-3d-20261024` | `舵机网页工具惯性显示` |
| `servo-web-mapping-20261022` | `舵机网页工具关节映射` |
| `stall-hat-risk-20261010` | `舵机堵转烧板风险` |
| `vscode-install-20261101` | `代码编辑器安装记录` |
