parkourlrc/pcb-yilv1982--duck-robot-89dbc81d6d/docs/references/众灵总线舵机替代评估/research.md

# 众灵 10kg 总线舵机能否替代飞特 HD-1910-C001

**日期**：2026-11-06
**结论**：**不能直接替代**。单颗补件不成立（协议不同、装不上）；整机换用也不成立（更重、更弱、反馈更少），等于换一套执行器方案重做结构与训练。
**范围**：只回答"能不能替代现用飞特舵机"，不评估购买渠道与价格；未取得实物，未实测。

> 证据等级沿用项目规则：[实测] 本机原始数据 · [规格书]/[手册] 厂商文件 · [项目] 本项目既有记录 · [推断] 由数据推算 · [待确认] 尚未核实。

## 1. 对象

- **现用**：飞特 **HD-1910-C001**，15 颗（含嘴）装机于 C 线整机；STS 内存表、SCS 二进制协议、1 Mbps、与 IMU 板（ID 200）同总线。
- **候选**：淘宝"众灵科技企业店"商品截图 —— **总线舵机 10KG【塑料壳】**，通用 270/180/90 度，电压 5–9 V，单轴/双轴，赠品含舵盘与线；推荐理由写"明文串口指令/PWM 双控制方式/高精度/高稳定性/金属齿轮"。
- 众灵 = **杭州众灵科技**。其 2020 年《众灵科技舵机使用手册》里的总线型号为 **ZX361S（单轴）/ ZX361D（双轴）**，15 kg·cm、5–8.4 V、ASCII 指令、默认 115200。截图这款"10 kg 塑料壳"的具体型号未在图中给出，按同系列推断。

## 2. 结论摘要

| # | 阻断点 | 性质 |
|---|---|---|
| 1 | 飞特是 **SCS/STS 二进制**（1 Mbps，同步读 0x82/同步写 0x83）；众灵是 **ASCII 明文**（默认 115200，逐台点名读） | 协议层，硬阻断 |
| 2 | IMU 板以 **ID 200、飞特从站人格、1 Mbps** 挂在同一条总线上，且与 15 颗舵机在**同一笔 sync_read** 里读 | 换协议必须同时改 IMU 接入 |
| 3 | 控制环 **50 Hz**，每个 tick 一次同步读（位置/速度/电流）+ 一次同步写；众灵**没有同步读**，也**不回读速度/电流**，**没有 Kp/Kd 寄存器** | 控制层，硬阻断 |
| 4 | HD-1910 为 **21±2 g / 34×20×23 mm**；众灵同系列 **60±1 g / 40×20×40.5 mm** | 机械与质量，硬阻断 |
| 5 | 力矩 **15 → 10 kg·cm（−33%）**，整机质量 **+585 g（约 +75%）** | 性能不成立 |
| 6 | 伺服模式**最大 270°**，覆盖不了 head_yaw 的 **±170°（340°）** | 行程不够 |

用一句话说：这不是"换舵机"，是**换一档执行器**——众灵这款属于 STS3215 的重量级（约 60 g/40 mm 级），本项目参考文档里对同档舵机的结论是"换它等于换一台机器人"（[执行器选型](../../../references/microduck-replica/docs/执行器选型.md)）。

## 3. 参数对照

| 项 | 飞特 HD-1910-C001（现用） | 众灵 10 kg 总线（截图 + 同系列手册） | 影响 |
|---|---|---|---|
| 重量级 | 20 g 级高力矩舵机 | 40 mm 标准尺寸级 | 不同档 |
| 质量 | **21 ± 2 g** | **60 ± 1 g**（ZX361S/D；10 kg 款待称） | 15 颗 **+585 g** |
| 外形 | **34 × 20 × 23 mm** | **40 × 20 × 40.5 mm** | 现有舵机腔装不进 |
| 堵转力矩 | **15 kg·cm @7.4 V**（1.47 N·m） | **10 kg·cm**（页面；测试电压未标） | **−33%** |
| 电压 | 4–8.4 V，过压 10 V/欠压 4 V | 5–8.4 V（手册）/ 5–9 V（页面） | 2S 满电 8.4 V 都在范围内；众灵无保护参数说明 |
| 堵转电流 | 2.0 A @7.4 V（额定 900 mA） | 1.8 A @6 V / 2.0 A @6.6 V（15 kg 同系列） | 单颗相近，15 颗总量不变 |
| 减速比/回差 | 320:1 / ≤0.5° | 310:1 / 未标 | 回差待测 |
| 分辨率 | 12 bit 磁编码，**4096/圈（0.088°/格）** | 控制量 **500–2500 对应 270°（0.135°/格）** | 粗 1.5 倍 |
| 协议 | SCS/STS 二进制（FF FF 帧、校验和） | **ASCII**：`#000P1500T1000!`、`#000PRAD!` | 不能共用 |
| 波特率 | **1 Mbps**（寄存器 6 = 0） | **默认 115200**，可设到 1 Mbps（BD 参数 7） | 默认差 8.7 倍 |
| 反馈 | 位置、速度、电流、电压、温度、负载 | 位置、温度、电压（手册指令表） | **缺速度/电流/负载** |
| 增益 | RAM **Kp 50 / Kd 51** 可写 | 无对应寄存器 | `limp_fall` 与逐关节整定失效 |
| 行程 | 4096/圈（360° 可表示） | 伺服模式 **270°/180°**（可设） | head_yaw 340° 不够 |
| 舵盘 | 凸出式（与 XL330 不同） | 25T/5.8 | 是否通用待核 |
| 保护 | 过流保护默认关、阈值可设；OVP/UVP | 宣传"防堵转"，规格未给 | 待核 |
| 总线节点 | 15 + IMU(200) | 最多 255，ID 0–254，出厂 0 | 数量够，ID 规则不同 |
| 连接器 | 规格书 AMP2.0-3P；HAT 侧 EH | 常见 2.54 3P（按截图目测，待核） | 需转接并核针序 |

> 表中众灵数据：质量/尺寸/力矩/电流来自 2020 年手册的 **ZX361S/D（15 kg 版）**；"10 kg" 是页面标称，除力矩外其余按同系列推，**以实物与卖家协议文档为准**。

## 4. 逐项分析

### 4.1 协议与总线：不能共存于现有总线

- 现用总线：飞特 **SCS/STS**，`FF FF ID LEN INSTR ... CHK`，1 Mbps；`sync_read 0x82` 一次读 IMU + 15 颗舵机，`sync_write 0x83` 一次写 15 个目标位置（[飞特补丁说明](../../../references/microduck-community-kit/firmware/v1/patches/README.md)）。
- 众灵总线：单线半双工 TTL，ASCII 指令，每条命令以 `#IDP...!` 形式**逐台点名**，回读位置要单独发 `#000PRAD!`；默认 115200（[手册副本](https://www.renrendoc.com/paper/99607126.html)，2020-10-24，第二章）。
- 物理层其实同类（都是单线半双工 TTL），**电气上能接**；但两套协议、两种默认波特率不能由现有 robotd 同时驱动。
- 更关键的是 **IMU 板本身就是这条总线上的飞特从站**（ID 200，1 Mbps，回答 15 字节块）。众灵默认 115200 时 IMU 完全读不到；把众灵逐台改到 1 Mbps 后理论上可"双协议共线"，但没有现成实现，IMU 固件对 ASCII 噪声的容忍、总线仲裁与错误帧处理都**未验证**。

### 4.2 50 Hz 控制环预算：默认波特率下连一帧都放不进

按 8N1、每字节 10 bit 估算（[推断]）：

| 操作 | 字节数 | @115200 | @1 Mbps |
|---|---|---|---|
| 读 1 台位置（命令 12 B + 回显 12 B + 应答 13 B） | 37 B | **3.2 ms** | 0.37 ms |
| 读 15 台 | 555 B | **≈48 ms** | ≈5.6 ms |
| 写 15 台目标（组命令约 250 B） | 250 B | **≈22 ms** | ≈2.5 ms |

- 默认 115200 下，**单是写 15 个目标就超过 20 ms 的 tick**，更不用说读；控制频率会掉到 10–20 Hz。
- 改到 1 Mbps 后理论可压到约 8 ms/tick，但需要逐台改 EEPROM、没有同步读、每条命令还要等回显与舵机处理，**实际延迟未测**。
- 飞特方案是一个事务读完全部节点（含 IMU），本项目实测能跑满 **50.0 Hz**（[补丁说明](../../../references/microduck-community-kit/firmware/v1/patches/README.md)）。

### 4.3 反馈与增益：观测与安全层都缺输入

- 训练/运行观测是 **61 维 = omega3 + gravity3 + q14 + dq14 + 上一步动作14 + 命令3 + 保留10**（[locomotion_checkpoint.py](../../../training/mjlab_duck/locomotion_checkpoint.py)）；其中 **dq14 是关节速度**。
- 飞特一次读回 15 字节块，含位置/速度/电流/PWM；众灵手册的指令表只有位置（RAD）与温度+电压（RTE），**没有速度、电流、负载**。若用位置差分代替速度：0.135°/格量化 + 50 Hz 采样，速度噪声会明显大于现在，**策略输入分布改变**。
- 飞特可写 **Kp/Kd**（RAM 50/51），`limp_fall` 靠把增益从 200 降到 50 做软着陆；众灵没有增益寄存器，只有"释放/恢复扭矩"（ULK/ULR），**只能整只卸力**，做不到可调刚度。
- 没有 `0x08` 重启指令，robotd 的 `reboot_motors`/换件收养流程需要重写。

### 4.4 机械与质量：15 颗多出 585 g

- 单颗 60 g vs 21 g，15 颗 **+585 g**；整机从约 780 g（737 g 基线 + HD-1910 比 XL330 多的 45 g）增到约 **1.37 kg（+75%）**（[推断]，按标称质量相加；10 kg 款实称后需重算）。
- 力矩密度：15/21 = **0.71 kg·cm/g** → 10/60 = **0.17 kg·cm/g**，**降到约 1/4.3**；同时整机更重，关节需求力矩上升，**净余量大幅恶化**。
- 项目自己的横向对比：STS3215 档（55–60 g、19 kg·cm）做出的 Open Duck Mini v2 是 **2.1 kg / 42 cm**，而 MicroDuck 是 737 g / 25 cm——"这不是换个舵机，是换一台机器人"（[执行器选型](../../../references/microduck-replica/docs/执行器选型.md)）。
- 外形高 40.5 mm vs 23 mm：腿、颈、头的舵机腔、舵盘高度、走线与重心都要重做；塑料壳在跌倒冲击与螺钉预紧下的耐久性**未验证**（不作为主要判据，但有风险）。

### 4.5 行程与分辨率

- 伺服模式 270°（可设 180°），即中位两侧各 135°；项目 `head_yaw` 的安全范围是 **±170°（340°）**（[HD-1910训练前数据清单](../../../references/microduck-replica/docs/HD-1910训练前数据清单.md)）。要么改限位并重训，要么这个关节不能用这款。
- 2000 格 / 270° = **0.135°/格**，比飞特的 0.088°/格粗 1.5 倍；对位置保持影响有限，对差分速度影响更大。

### 4.6 标定、工具与训练

- 中位：飞特 **2048**，众灵 **1500**（500–2500）；标定命令、限位、方向都要重做。
- servo-web 调试器、Studio 显示、`servo-web` 的 CAL/EEPROM 流程都按飞特寄存器写；换协议要另写一套工具。
- 训练用的 BAM M6 执行器参数（Kt、摩擦、回差、延迟、电压模型）是**针对 HD-1910 辨识/标定**的；换舵机后这组参数失效，策略要重新训练与验证（[HD-1910-M6参数来源](../../../references/microduck-replica/docs/HD-1910-M6参数来源.md)）。

## 5. 如果坚持要换：改造清单

| # | 改造 | 代价/风险 |
|---|---|---|
| 1 | 在 `duck-control` 新写 ASCII 后端（组帧、回显、超时、组命令、ID/波特率设置），替换 `FeetechIo` | 中高；需重跑总线单测与真机 |
| 2 | 把 IMU 从这条总线拆走（独立 UART/端口），或给 IMU 固件加第二协议 | 高；HAT 两口是否同网需先核实，可能要改板/改线 |
| 3 | 重新设计 50 Hz 调度并实测 1 Mbps 往返；不达标就降频 | 高；降频意味着策略重训 |
| 4 | 观测层用位置差分补 dq，重新训练/验证 | 高；输入分布改变 |
| 5 | 安全层重做：无电流、无增益，只能整只卸力 | 中高；软着陆行为退化 |
| 6 | 重做标定（1500 中位、500–2500、270°）与 servo-web 工具 | 中 |
| 7 | 重画 15 个舵机腔、舵盘、走线，重新配重 | 高；等于新结构 |
| 8 | 重新辨识执行器参数并重训策略 | 高 |
| 9 | 重新核对供电/堵转保护（15 颗 × 2 A 峰值） | 中 |

## 6. 未确认（需向卖家/实物确认）

1. 截图这款"10 kg 塑料壳"的**具体型号与固件版本**（手册是 2020 年，可能已更新协议）。
2. 是否支持**多机同步读**（组命令写手册已有）；1 Mbps 下连续通信是否稳定。
3. 是否回读**速度/电流/负载**；是否有可写 **Kp/Kd**。
4. **7.4 V 下的堵转力矩与电流**、单颗质量、外形图/舵机腔图。
5. 过压/堵转保护的具体行为（"防堵转"是宣传语，手册未给阈值）。
6. 连接器型号与针序（S/+/−），是否与 HAT 的 EH 可直接转接。
7. 价格（截图未显示，未做成本比较）。

> 建议向店家索取：《通信协议》PDF、7.4 V 规格页、尺寸图、同步读说明。拿不到就不要按"可替代"评估。

## 7. 建议

- **只是坏了一颗**：买同型号 **HD-1910-C001**；先把那颗"嫌疑坏"隔离排查（线/ID/机械），不要混入异协议舵机。
- **想降本/换型**：这款属于 STS3215 重量级，走它等于走 Open Duck Mini v2 路线（2.1 kg / 42 cm），要重做结构、电控与训练，不是"换个舵机"。
- **做机械臂/慢速多关节**：可以用，但要用它自己的协议与控制器，**不要接飞特总线**。

## 8. 来源与图片登记

| 来源 | 用途 | 等级 |
|---|---|---|
| [HD-1910训练前数据清单.md](../../../references/microduck-replica/docs/HD-1910训练前数据清单.md)（L112–L141，引《HD-1910-C001 串型规格书》A/0） | 飞特电压/力矩/编码器/电流/尺寸 | [规格书]摘录 |
| [硬件方案逆向.md](../../../references/microduck-replica/docs/硬件方案逆向.md)（L505–L506） | 21±2 g / 34×20×23 mm 旁证 | [项目] |
| [飞特补丁说明](../../../references/microduck-community-kit/firmware/v1/patches/README.md) | 1 Mbps、sync_read/write、IMU ID 200、50 Hz、Kp/Kd 寄存器 | [项目实测/代码] |
| [执行器选型.md](../../../references/microduck-replica/docs/执行器选型.md) | STS3215 档换型的质量后果 | [项目] |
| [locomotion_checkpoint.py](../../../training/mjlab_duck/locomotion_checkpoint.py) | 61 维观测含 dq14 | [项目] |
| [众灵科技舵机使用手册（第三方上传副本）](https://www.renrendoc.com/paper/99607126.html) | ZX361S/D 参数、ASCII 指令表、115200、500–2500/270° | [手册副本]（2020-10-24，45 页；原文应向厂商索取） |
| [MagicCube/serial-bus-servo](https://github.com/MagicCube/serial-bus-servo) | ZX361S/ZX01S Arduino 库：命令格式、回显读取 | [第三方代码] |
| 用户提供淘宝截图（2026-11-06） | 商品型号/电压/角度/单双轴/宣传语 | [用户提供] |

**图片登记**

| 文件 | 收到日期 | 来源 | 对象 | 说明 |
|---|---|---|---|---|
| `众灵10kg总线舵机-淘宝截图-20261106.png`（待归档） | 2026-11-06 | 用户提供 | 众灵 10 kg 总线舵机商品页 | 淘宝"众灵科技企业店"；含 10KG 塑料壳、270/180/90 度、5–9 V、单/双轴、赠品与"明文串口/PWM"推荐语；原附件 SHA-256 `354041462442d52f94016d90e9735d8c1e951bc7a16ea02daa9003291be47313`（1822×1516）。**本轮未能复制进仓库**：本机沙箱限制，命令行进程无法写入仓库子目录（文件工具只能写文本），原图仍在会话附件中，待归档；重新归档时按上面的 SHA-256 校验。 |

**未取得/未验证**：淘宝商品详情页（未登录，无法抓取完整参数）；linux.do 讨论帖（Cloudflare 403）；小红书"避雷众灵总线舵机"帖（未打开，仅搜索标题，不作为证据）；众灵官网/官方协议 PDF（未找到公开下载）。
