parkourlrc/pcb-yilv1982--duck-robot-89dbc81d6d/docs/references/两套扩展板订单与报价/kissqy-y8-connector-mpn-check.txt

												3443 text 型号： A1251WV-2P
											3444 text 编号： C5333427 品牌： CJT(长江连接器) 封装： 插件,P=1.25mm ECCN： - 1 + ： ¥ 0.344 100 + ： ¥ 0.28 300 + ： ¥ 0.247 2000 + ： ¥ 0.196 4000 + ： ¥ 0.178 10000 + ： ¥ 0.169 您的私有库存：0 PCS 可用库存数 ： 8578  PCS 损耗数量： 4 PCS 最小贴装数量： 2 PCS
