parkourlrc/pcb-yilv1982--duck-robot-89dbc81d6d/docs/references/两套扩展板订单与报价/research.md

# 两套HAT各5片含贴片：订单与报价进度

日期：2026-11-04（Asia/Shanghai）。用户先要求生成订单看实际报价、不要填写备注，随后明确“两套都生成，比较实际报价”。授权两套资料分别提交嘉立创获取订单/报价，先不付款。自主板使用实际A.1文件，A.2尚未改版，不把其BOM混入A.1；kissqy用已核411878f当前工程。

**同日降本分析**：[差价归因与优化优先级](cost-optimization.md)。元件与PCB占差价97.36%；首选核22µF电容、40P及排针，再做U701.7常规孔/散热填孔和制造选项优化。费用暴露不等于已保证可省金额，A.2原方案主要解决供料，不是已完成降本设计。本轮只分析，未改订单/CAD。

**头部IMU版本边界补充**：用户指出kissqy另有新增头部陀螺仪的HAT。完整仓库与历史已下载核查：软件目标为BMI088，且驱动与声明的官方版本逐字节相同；公开HAT PCB仍未含IMU，Y8亦不包含。**本页报价不能代表该未知新版本**，待其真实工程/实装资料匹配，见[完整核查](../社区作者仓库完整核查/research.md)。本轮未改变订单文件。

## 当前状态（2026-11-04 13:53，Asia/Shanghai）

| 项目 | 自主HAT A.1 | kissqy HAT AMP2.0 |
| --- | --- | --- |
| 资料版本 | PCB SHA256前缀86654c03，实际A.1 | 上游411878f，PCB2 |
| PCB订单 | **Y7，已创建，待付款** | **Y8，已创建，待付款** |
| 数量 | 5片 | 5片 |
| 可核对PCB金额 | **820.80元** | **48.42元** |
| 装配范围 | 58件/板，52SMT＋6THT | 86件/板，81SMT＋5THT |
| SMT网站草稿 | **2255.30元**，已保存 | **1111.97元**，已保存 |
| 草稿元件费 | 1380.48元 | 287.75元 |
| 草稿加工费 | 874.82元 | 824.22元 |
| PCB＋SMT草稿合计（不含运费） | **3076.10元/5片，615.22元/片** | **1160.39元/5片，约232.08元/片** |
| 付款/制造放行 | 均未进行 | 均未进行 |

**已取得两套网站实际生成的报价草稿，但尚无可完整供料的最终PCBA应付价。** 以上含欠料参考价，自主还含已知误匹配；SMT未生成正式订单，未确认备料完成、未付款、未制造放行。自主草稿比kissqy高1915.71元/5片，其中PCB高772.38、元件高1092.73、加工高50.60元；这不是已锁定的最终节省金额。

两套均为标准型双面装配、含原设计全部拟装位号及THT。元件费用含网页备损/最低贴装数量，不能直接与前次五板净材料目录价比较。两套PCB工艺不同：自主为四层/沉金/0.15mm孔/树脂盖铜/内外1oz；kissqy为两层/无铅OSP/0.3mm普通孔/1oz，不能把全部差价归因于层数。两单都保留确认生产稿3元、不加客编10元、默认品质赔付10元。

客户中心最新显示两PCB单待付款：合计869.22元，网页汇总运费预估5.50元、含运费874.72元；完整PCBA发货费用仍未核定，因此比较表不计运费。Y8标有包邮，但页面同时沿用“不包含运费”说明，不能用它宣称整套PCBA永久免运费。

原Y6的1859.60元是含误匹配且欠料、未含6THT/板的历史SMT草稿，退出本次比较。此次授权不等于批准Rev A.2改板或物料替代。

## 网页事实与旧单

- 自主PCB原单Y6已存在，5片/四层/1.6mm/绿油/沉金，未付款；新观察价格**820.80元**，不含运费（旧表单820.47不是最终此时显示价）。
- 审核回复时间2026-11-03 18:45：要求确认能否忽略备注、按下单选择工艺制作。当前状态“文件审核有问题”，不是通过。
- 原订单修改入口不能编辑工程备注，重新上传还会继承旧备注，因此另建Y7；Y6未取消、未付款，作为旧单保留，**不再作为本轮报价/后续支付入口，不应与Y7重复支付**。
- 费用详情：喷镀101.37、阻焊覆盖101.46、内铜100.49、生产稿确认3.00、四线测试100.78、品质赔付10.00、特价150.00、指定板材20.29、大面积沉金0.33、最小孔径/外径202.93、过孔沉铜20.15、不加客编10.00，合计820.80元。
- 客户中心实读：Y7创建时间2026-11-04 12:18:51，文件CUSTOM-HAT-A1-86654c03-5PCS，价格820.80元，已从等待审核变为待付款；Y6创建于2026-11-03 18:26:47，仍文件审核有问题。Y8创建时间2026-11-04 13:30:47，价格48.42元，待付款。未点击付款或生产确认。

## 无备注处理与上传

网页原单“修改订单”不提供工程备注编辑；“重新上传文件下单”明确仍继承旧备注，要求改备注时在线下新单。因此另建CUSTOM-HAT-A1-86654c03-5PCS报价订单，未支付旧单。上传ZIP只移出ORDER-NOTES.txt和工艺清单CSV，13个Gerber/钻孔成员逐字节不变，源文件不改；树脂盖铜、0.15mm、内外1oz及层叠等仍通过结构化工艺选项选择。

备注框不写任何自由文本；网站在清空/失焦后自动重新生成“内层铜厚1盎司/我的文件中已有层压顺序”两项结构化标记，不能伪称这两段也已删除。未再填写原来的特殊要求长备注。

历史尝试：kissqy单独.epro2未进入上传列表，外包ZIP自动解析失败。此途径已弃用；本轮改用官方EDA客户端生成Gerber/BOM/CPL并一键传递，成功创建Y8，不再把原解析失败作为当前阻塞。

## 自主Y7贴片资料

- `custom-bom-all58.csv`与`custom-cpl-all58.csv`均已上传，恢复Y7时页面显示对应文件名；数量5片全贴、顶底全贴、标准型、消费电子。
- 选择人工确认DFM（3元，不允许系统自动确认）及钢网确认（20元）；特殊服务保持无要求，没有手写工艺备注。这是报价表单，未将其描述为满足全部生产条件。
- 净用料290件，6THT为J101/J301/J401/J402/J403/J802；排除C307 DNP与fiducial。哈希与来源见`custom-assembly-quote-manifest.json`。
- 网页跳转超时后改用已安装嘉立创下单助手，成功进入Y7物料匹配页，取得2255.30元草稿价并实读“保存成功”。这仍是草稿，不是正式SMT订单。
- 逐表核到58/58位号、顶24/底34、6THT、38匹配行，无遗漏/重复；“全部元件38”是网页匹配行数，不是每板仅38件。
- 当前9行供料不足：C301被自动分配到私有库存0（需9，供料方式也不符合全嘉立创现货）；C317/C318、C303/C304/C305/C306/C323、R703、R304、U702、L301、U803为0库存；U301/AP64350库存1、需5。C308/C309/C328仍自动匹配C377773，实际是Samsung X5R，设计锁定KEMET C0805C225K5RACTU，不予核准。报价包括错误电容价格且私有库存供料未解决，不能当精确原BOM最终总价。

## kissqy官方EDA导出与检查

- 原件SHA256：33586ff3a5b40f06b6f28866ad92987a00918c1d39f654ee5f13ad9b2a553adf，851886字节。源文件未修改，参考库只读。
- 已导入官方网页版EDA个人工作区副本`KISSQY-HAT-411878f-QUOTE-20261104`，工程ID为95abcc13bef144a3ae19c7166e267776，PCB2 UUID为9d00f144890fd6bb；导入时未自动关联封装和3D库。
- **[软件检查回执]** 2026-11-04 12:29:11，官方EDA完成141项DRC、5秒、0问题。仅代表该次规则检查，不等于电气功能、工厂DFM或实物验收通过。
- 官方客户端导出`KISSQY-HAT-411878f-Gerber.zip`已保存，137166字节，SHA256为646db549f8d2d000c293202be7130b45d9c49bba2ced9416329a48cf5cd93804。网页导出未返回本地文件的历史失败已解决。
- 同源EDA一键下单解析为6.5×3.09cm、2层、5片。Y8文件名`KISSQY-HAT-411878f-QUOTE-20261104_PCB2_20261104_132459`；1.6mm、外1oz、绿色白字、无铅OSP、0.3mm普通孔、TG135、AOI＋飞针全测，手动确认订单及生产稿2次，备注框提交前实读为空。48.42元拆分：工程20、板费5.42、确认稿3、品质赔付10、不加客编10。
- EDA同时传入BOM与坐标，客户端进入Y8双面标准贴片并保存1111.97元报价草稿。逐表核到86/86位号、顶85/底1、5THT、70匹配行，无遗漏/重复；70行不是70件或70个唯一型号。
- C8/C9=C156398、C15=C76666、TH1=C21189、U6=C23654均在当前匹配表，与411878f源一致。
- **供料勘误**：J1/J2/J9的源C225090被网站映射到C5333427。搜索实读同为**CJT(长江连接器) A1251WV-2P**，库存8578；源DEVICE也为该厂该MPN。这属于同厂同型号的另一货号，撤回“该型号没有嘉立创现货”的当前表述，不把它当新机械替代已验证。
- 当前明确不足的仅两组：D1/BAT54SW C78606库存0、网页含备损需10；J13/J14/A2007WV-3P C225336库存1、含备损需13（净用10）。没有选择“只贴当前库存”，没有删器件凑成已备料。

## 当前剩余问题

两套PCB实单均待付款，SMT草稿均保存。选择正常交期并点击“备料完成，下一步”时，两套均收到**“校验失败”**，没有正式SMT单号；页面没有给出可独立归因的详细错误，因此不把某一欠料项断言为该提示的唯一原因。匹配核对进度为0/38和0/70，未勾选未经完整核准的物料来跳过校验。完整供料与匹配/贴装方向审核尚未完成，未宣称5片完整成品已下单。自主A.1先解决9行供料不足与3颗误匹配；kissqy先解决两组缺料，再完成贴装核对。全部现货A.2方案仍需用户批准后才能改PCB；本轮未实施。

页面钢网提示另说明：选择“确认钢网”后，钢网生产稿制作完成24小时仍未确认会自动确认；这与DFM明确选择“不允许系统自动确认”不同。本轮未付款/制造放行，不把这项服务误写为无时限人工确认。

## 已解决的操作障碍（历史）

12:48桌面锁屏，用户随后回复“已解锁”。解锁后网页SMT跳转仍出现超时，证明不能直接把网页异常归因于锁屏；改用嘉立创下单助手完成两套匹配、官方EDA制造文件导出与一键下单。网页可读取既有匹配页面及订单列表。客户端页面跳转/加载与即时AX快照有延迟，后续截图核实后再操作。

继续办理时复用Y7/Y8及已保存草稿，不重新建PCB单。原Y6只作历史证据，不误付或重复支付。现有价格为2026-11-04页面快照，后续库存/报价应在付款前刷新。

## 证据索引与限制

- 订单来源：`https://www.jlc.com/newOrder/#/pcb/pcbOrderList`与`https://www.jlc-smt.com/order`可见网页；EDA来源：`https://pro.lceda.cn/editor`上述工程/PCB2的DRC、导出和下单弹窗。
- `custom-y7-created.jpg`：自动化保存的Y7接续表单早期截图，只有文件名与5片数量；早于BOM/CPL填入，不包含820.80元或订单编号，不能作为完整价格截图。
- `pcb-y7-y8-unpaid-redacted.png`：两PCB订单编号、金额、待付款状态截图；遮去抬头/收货姓名，截图脚本为`audit-quote-rows.py`。
- `custom-y7-smt-draft-fees.jpg`、`kissqy-y8-smt-draft-fees.jpg`：两套网站SMT草稿及元件/加工费用明细，非最终应付单。
- `custom-y7-validation-failed.jpg`、`kissqy-y8-validation-failed.jpg`：尝试继续SMT时保存的页面；校验失败文字以当时AX回执为证，短暂提示可能未留在截图中。
- 两套`*-auto-match-rows.txt`、`*-auto-match-cells.json`为可见物料表原文；`quote-row-audit.json`为位号/面别/THT/缺料和源货号对照；`kissqy-y8-connector-mpn-check.txt`为同型号新货号核对。
- `order-comparison-status.json`：本轮脱敏状态汇总。未保存凭据、收货信息或跟踪查询串。
- 未付款、未取消旧单、未改PCB/物料、未使用subagent、未commit/push。
