parkourlrc/pcb-yilv1982--duck-robot-89dbc81d6d/docs/references/乐鑫芯片跑多层感知机/research.md

# ESP32 能否跑 microduck 的 MLP 策略

- 日期：2026-10-14
- 问题与范围：microduck 的 ~0.2M 参数 MLP 策略（`61→512→256→128→14`，50 Hz）能否在 ESP32（经典款 / S3）上实时推理并顺带承担总线循环？性能、内存、带宽定量推算 + 业界实证。
- 性质：桌面调研与纸面推算，无本机实测。结论不改变当前 C 线主控选型。

## 一、结论（先答后证）
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
