parkourlrc/pcb-yilv1982--duck-robot-89dbc81d6d/docs/photos/hat-c1-r33-reference-20261027.png

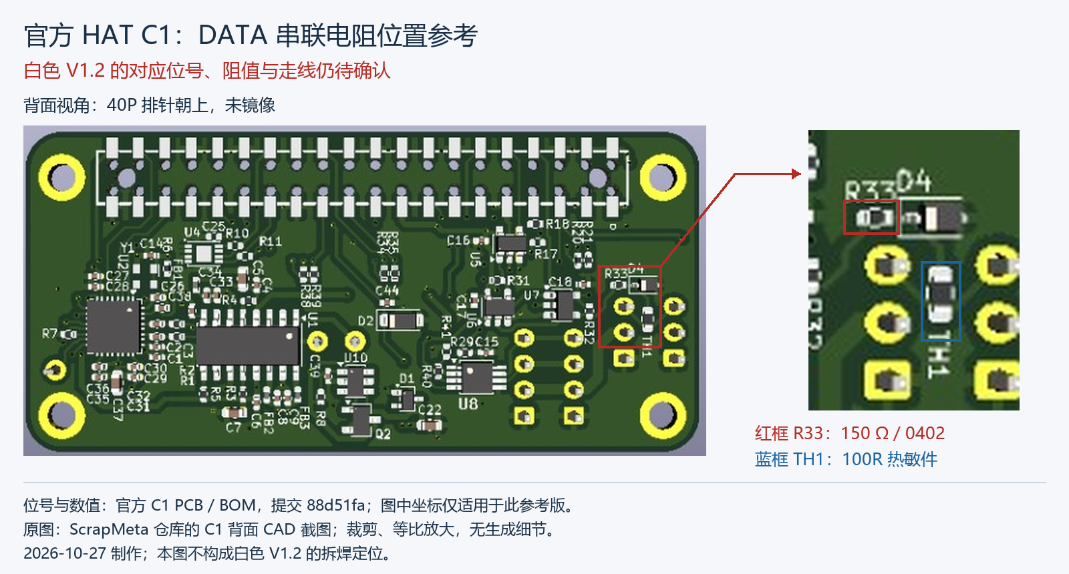
docs/photos/hat-c1-r33-reference-20261027.png
