parkourlrc/pcb-yilv1982--duck-robot-89dbc81d6d/docs/photos/hat-resistor-user-circle-crop-20261027.png

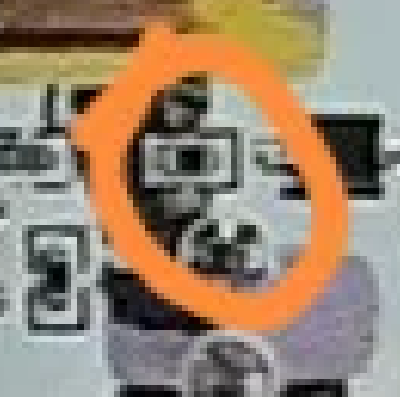
docs/photos/hat-resistor-user-circle-crop-20261027.png
