parkourlrc/pcb-yilv1982--duck-robot-89dbc81d6d/docs/photos/hat-v1.2-data-region-crop-20261027.png

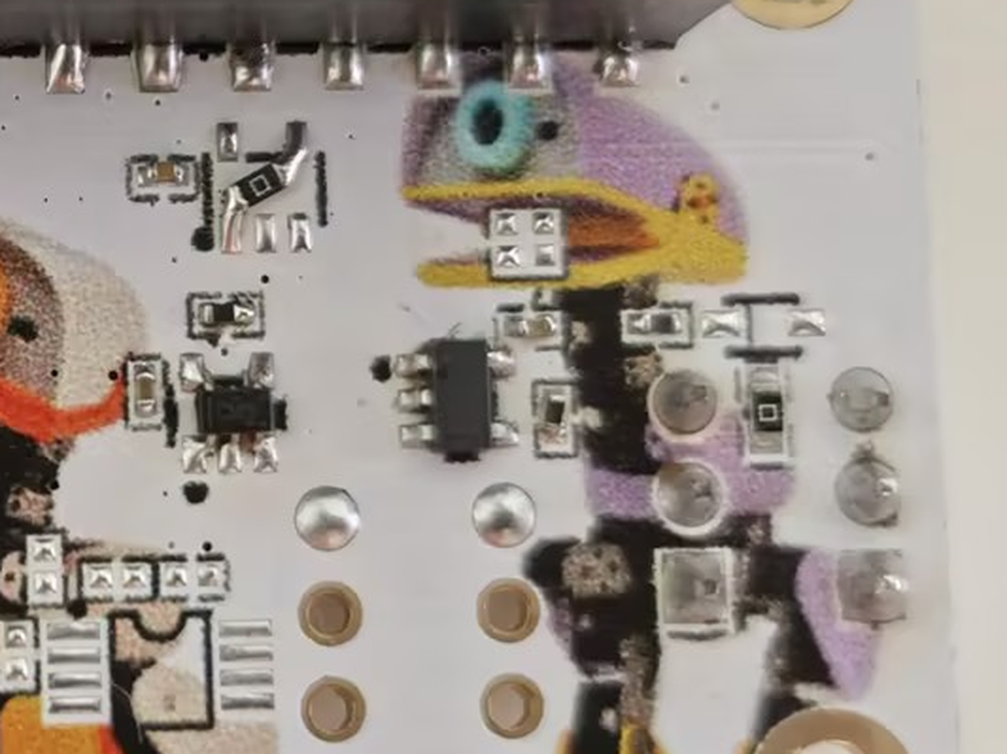
docs/photos/hat-v1.2-data-region-crop-20261027.png
