parkourlrc/pcb-yilv1982--duck-robot-89dbc81d6d/docs/photos/imu-single-port-data-front-end-crop-20261027.png

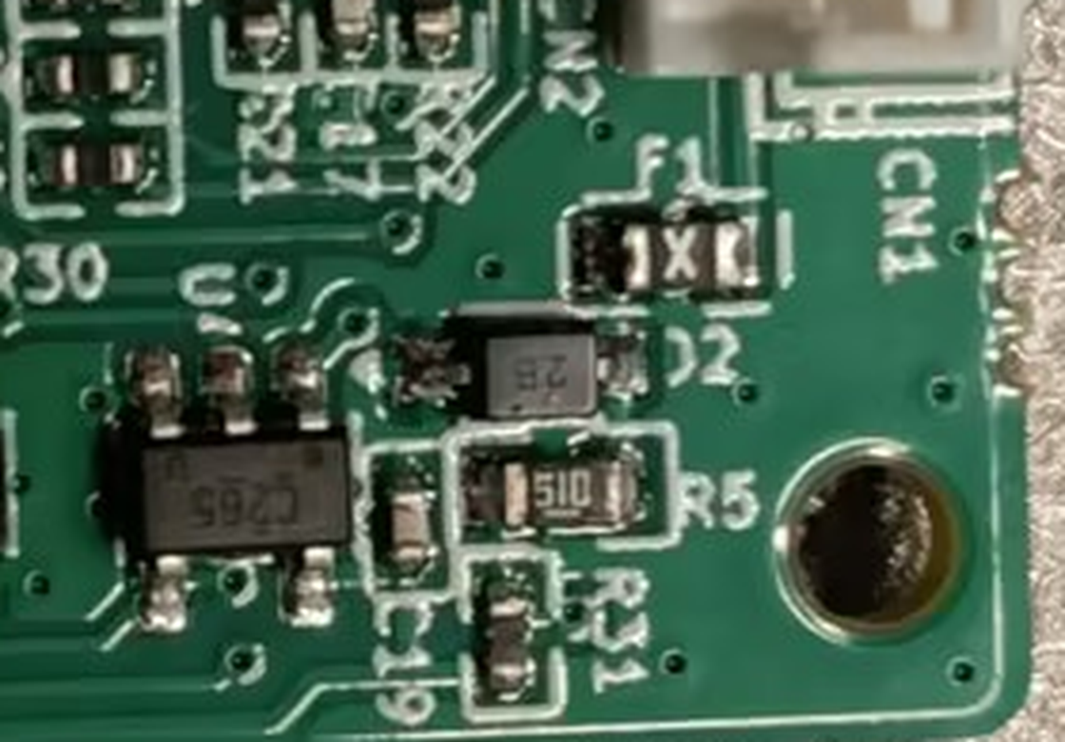
docs/photos/imu-single-port-data-front-end-crop-20261027.png
