parkourlrc/pcb-yilv1982--duck-robot-89dbc81d6d/docs/photos/imu-single-port-h1-location-20261026.png

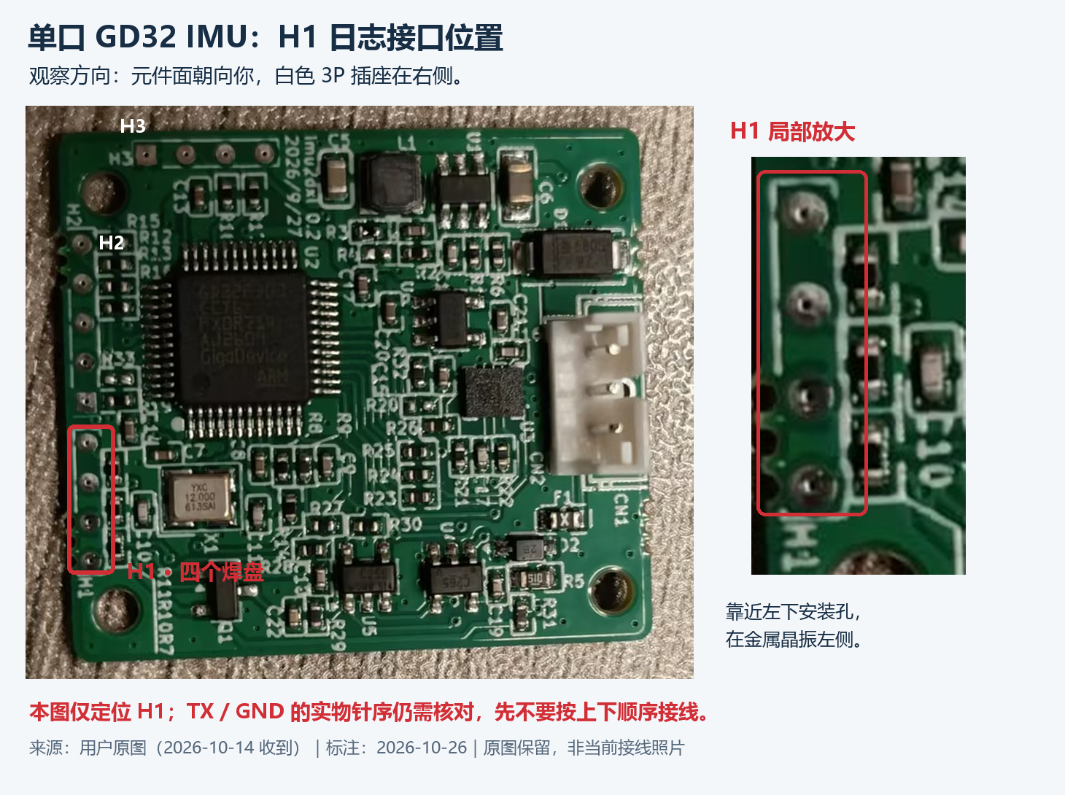
docs/photos/imu-single-port-h1-location-20261026.png
