parkourlrc/pcb-yilv1982--duck-robot-89dbc81d6d/docs/photos/imu-single-port-r31-r5-f1-location-20261027.png

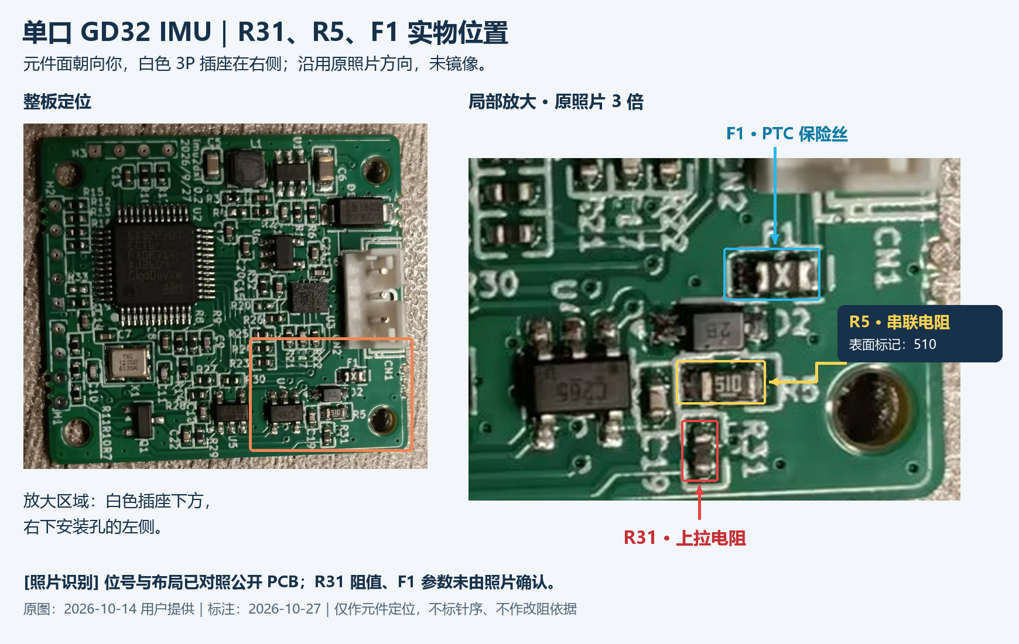
docs/photos/imu-single-port-r31-r5-f1-location-20261027.png
