parkourlrc/pcb-yilv1982--duck-robot-89dbc81d6d/docs/photos/kissqy-hat-r33-bypass-reference-20261027.png

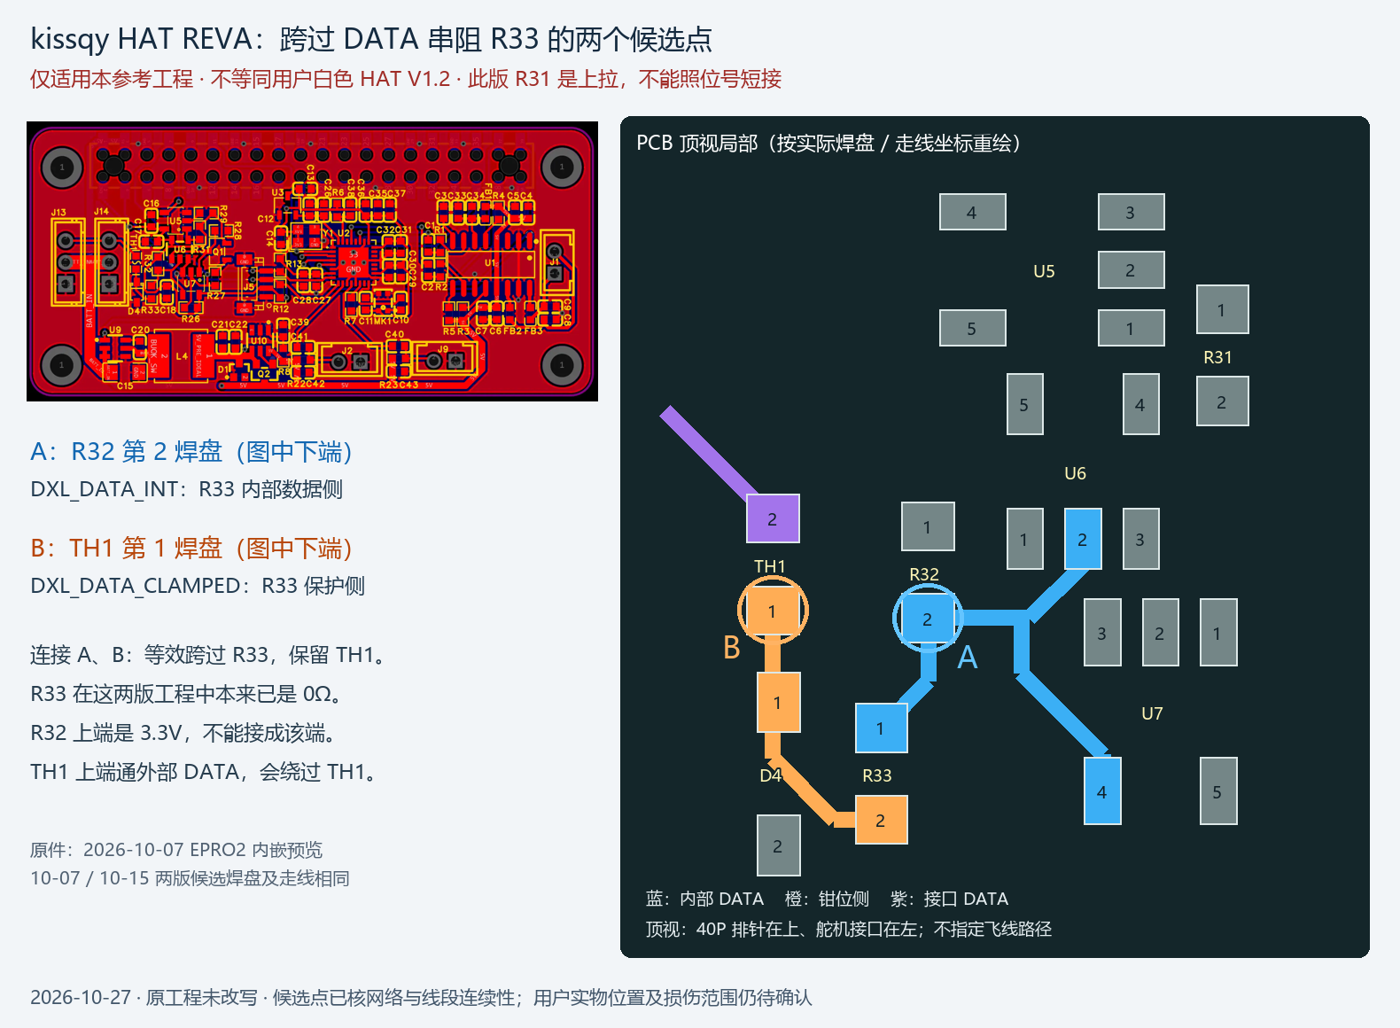
docs/photos/kissqy-hat-r33-bypass-reference-20261027.png
