parkourlrc/pcb-yilv1982--duck-robot-89dbc81d6d/docs/references/两套扩展板订单与报价/kissqy-y8-smt-draft-fees.jpg

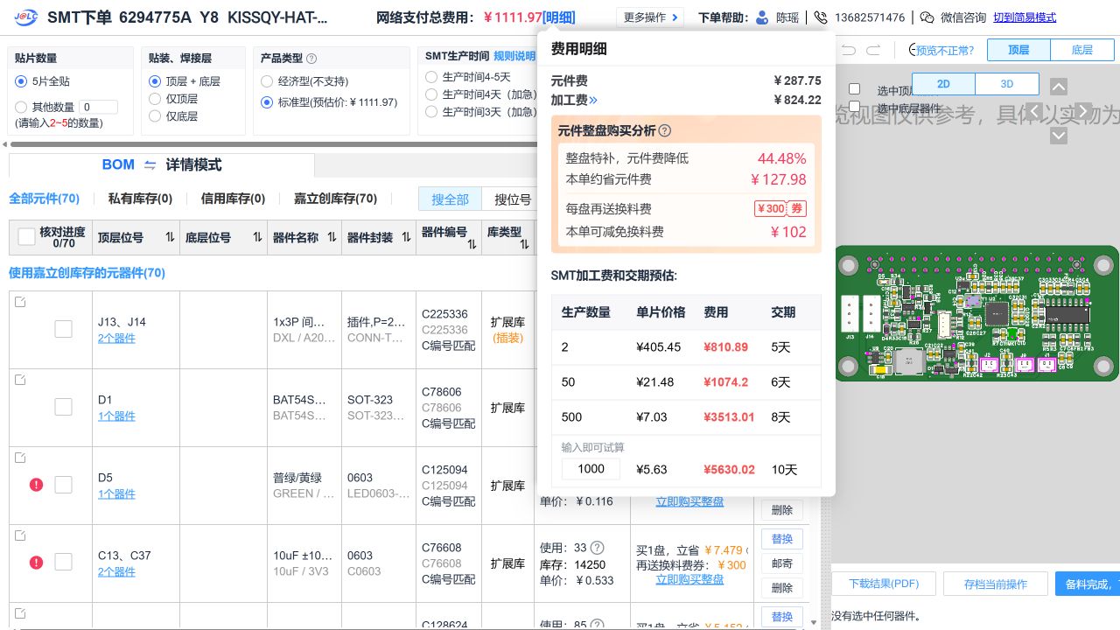
docs/references/两套扩展板订单与报价/kissqy-y8-smt-draft-fees.jpg
