parkourlrc/pcb-yilv1982--duck-robot-89dbc81d6d/docs/references/两套扩展板订单与报价/pcb-y7-y8-unpaid-redacted.png

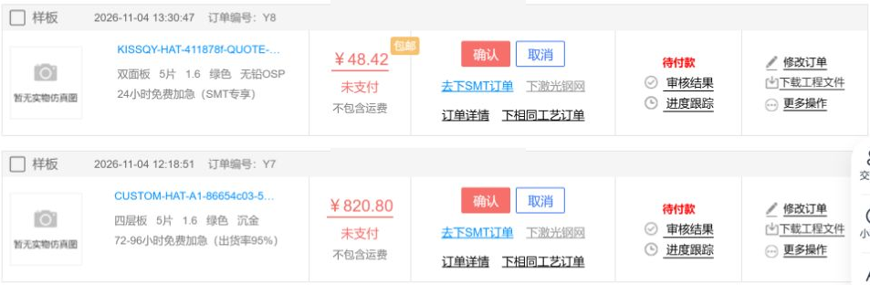
docs/references/两套扩展板订单与报价/pcb-y7-y8-unpaid-redacted.png
