parkourlrc/pcb-yilv1982--duck-robot-89dbc81d6d/docs/references/惯性单元输入电压复核/sources/imu-v03-schematic.png

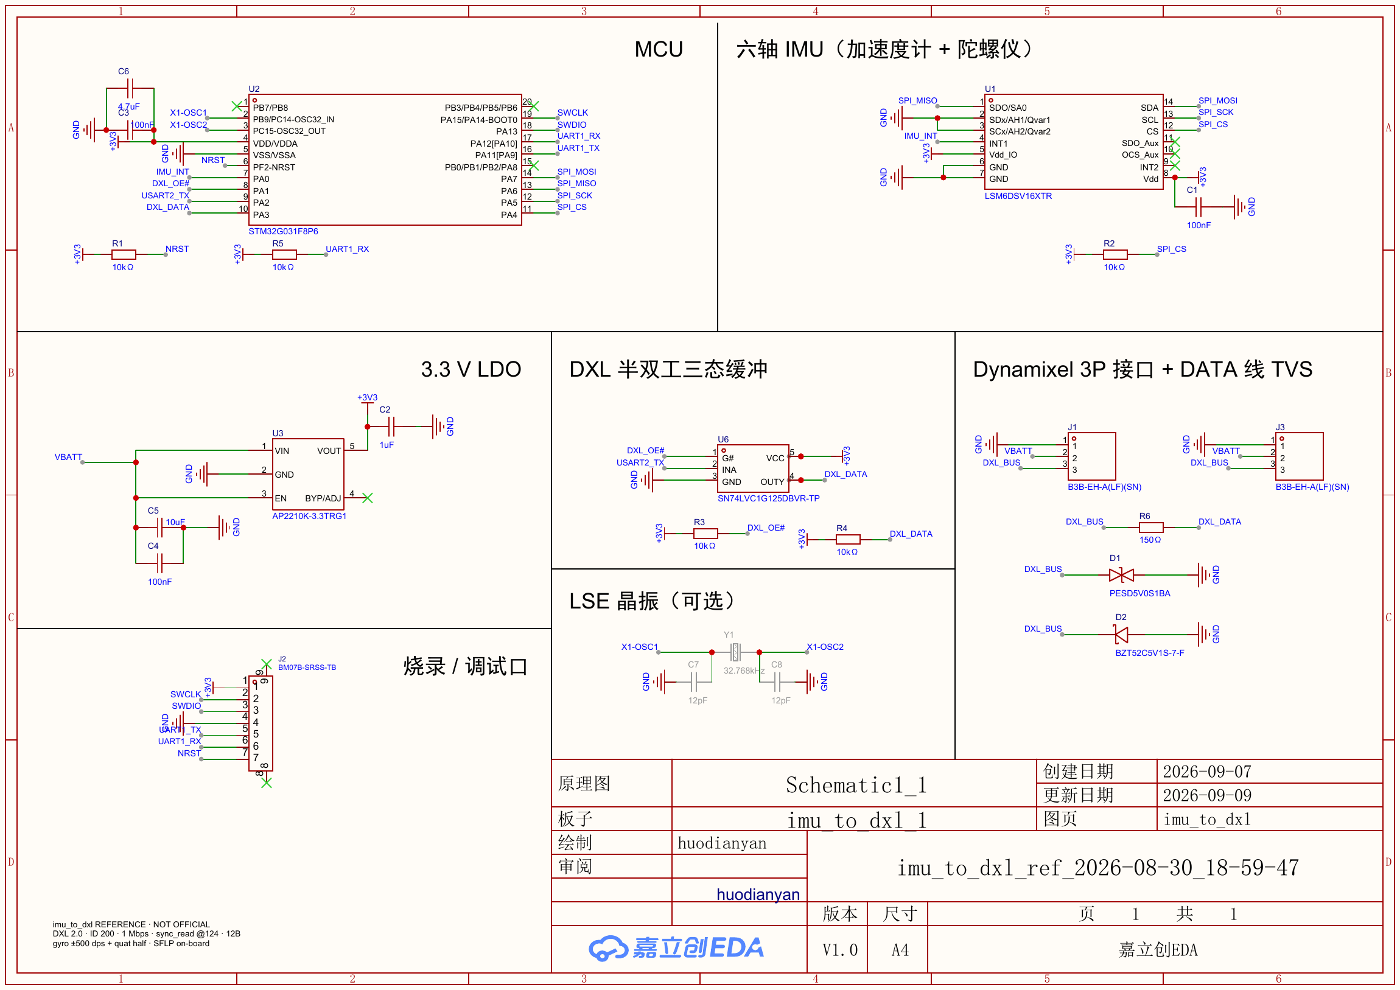
docs/references/惯性单元输入电压复核/sources/imu-v03-schematic.png
