parkourlrc/pcb-yilv1982--duck-robot-89dbc81d6d/docs/references/惯性单元输入电压复核/sources/techpublic-page3.png

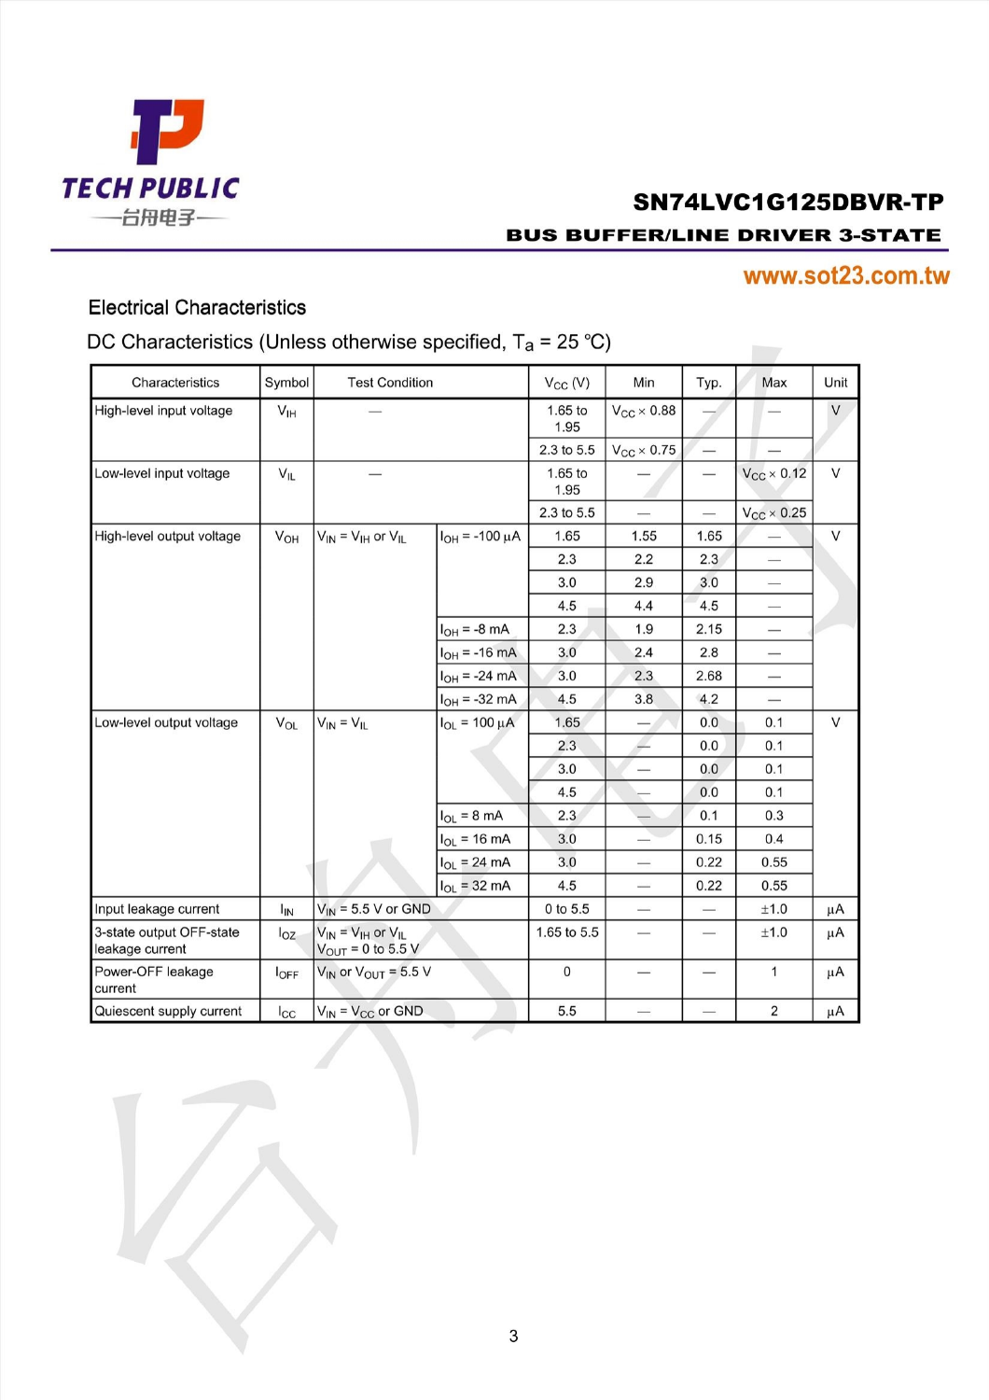
docs/references/惯性单元输入电压复核/sources/techpublic-page3.png
