parkourlrc/pcb-yilv1982--duck-robot-89dbc81d6d/docs/references/扩展板乙版降本/engineering-feedback/mic-c7587901-page5.png

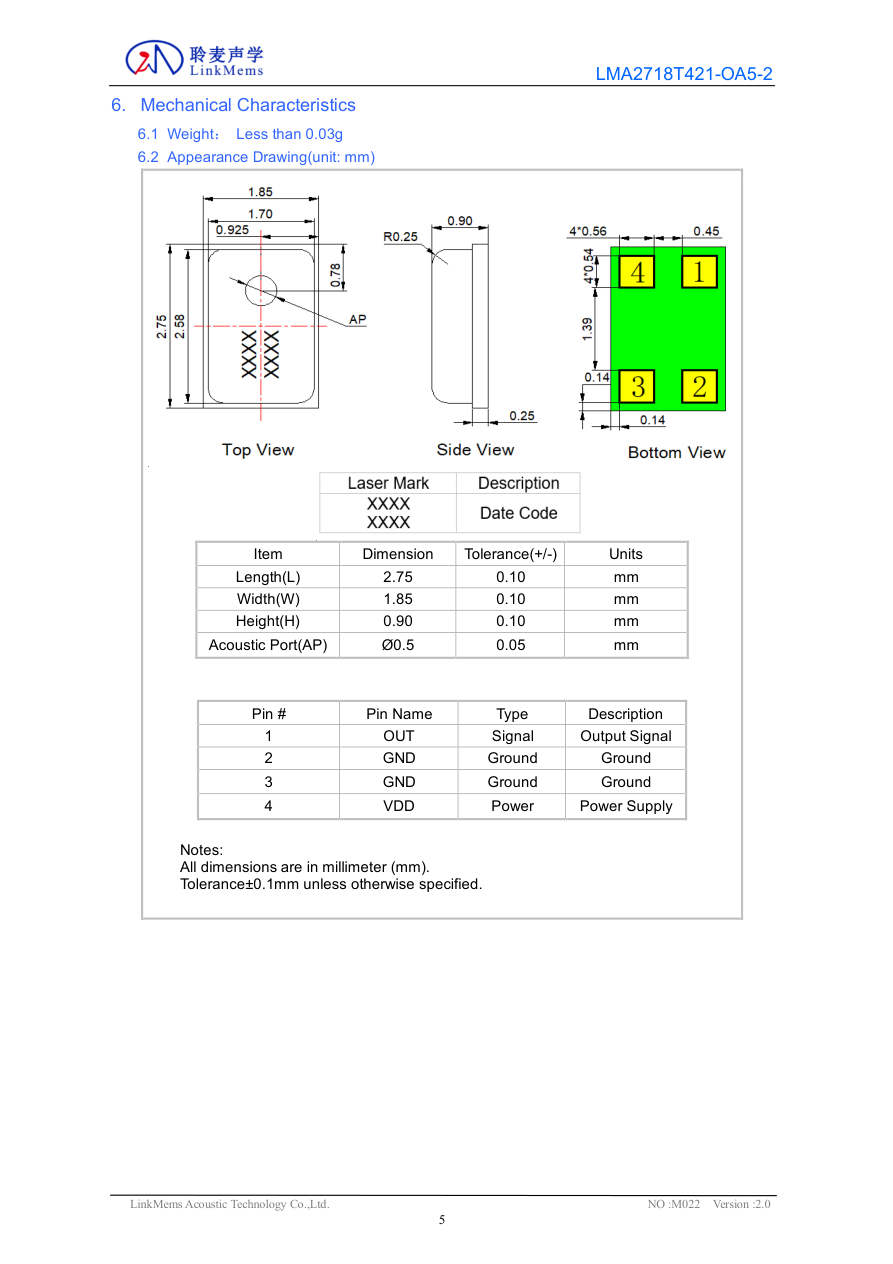
docs/references/扩展板乙版降本/engineering-feedback/mic-c7587901-page5.png
