parkourlrc/pcb-yilv1982--duck-robot-89dbc81d6d/docs/references/扩展板乙版降本/schematic-codec-6.png

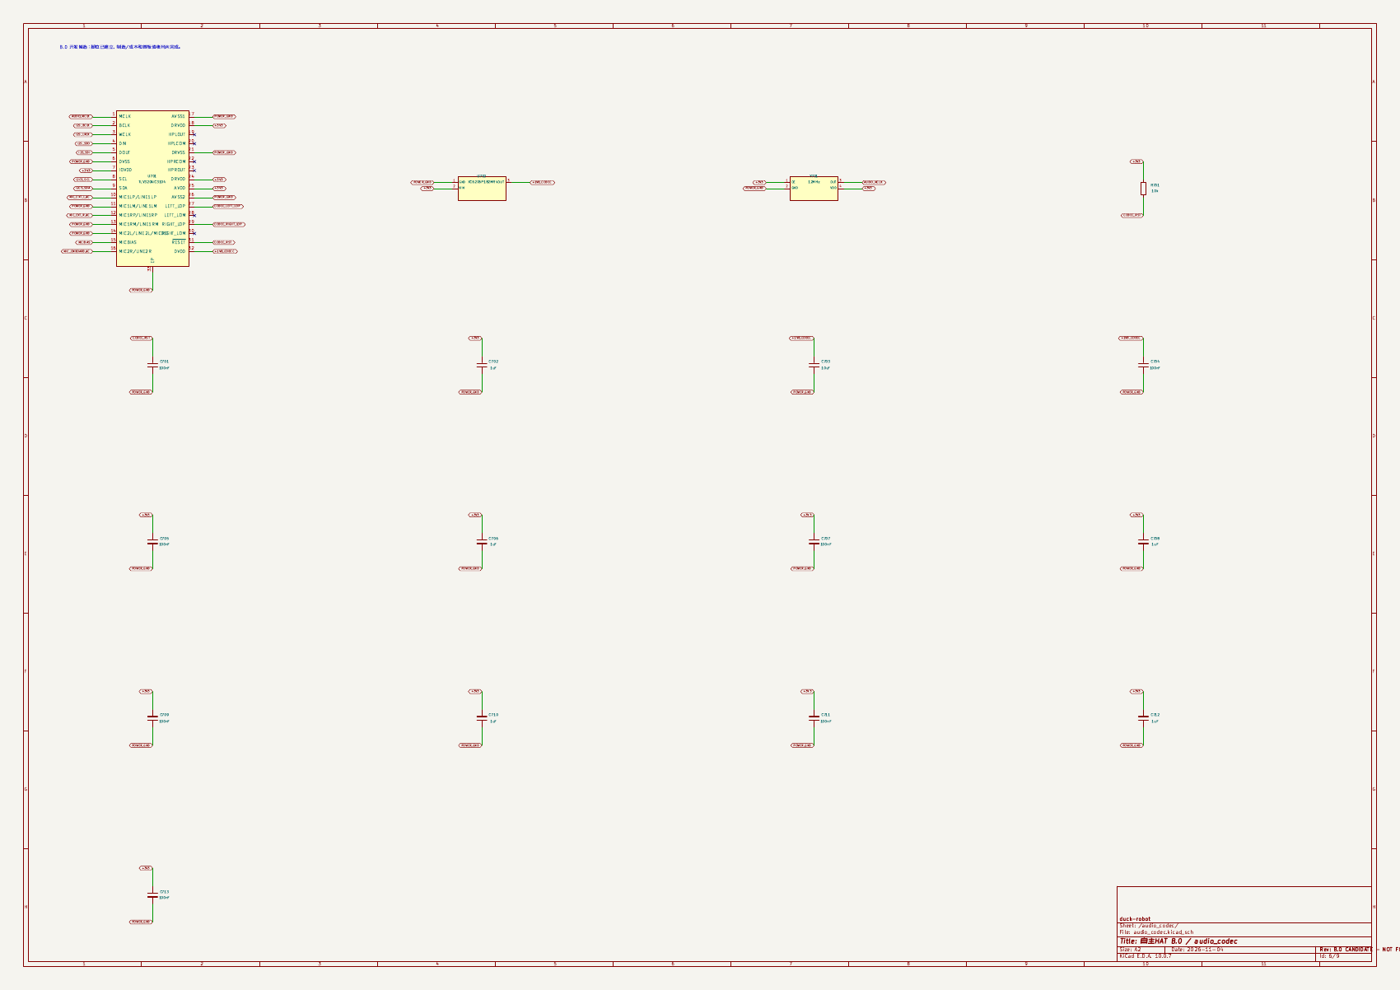
docs/references/扩展板乙版降本/schematic-codec-6.png
