parkourlrc/pcb-yilv1982--duck-robot-89dbc81d6d/docs/references/扩展板乙版降本/sources/header-c2977589-1.png

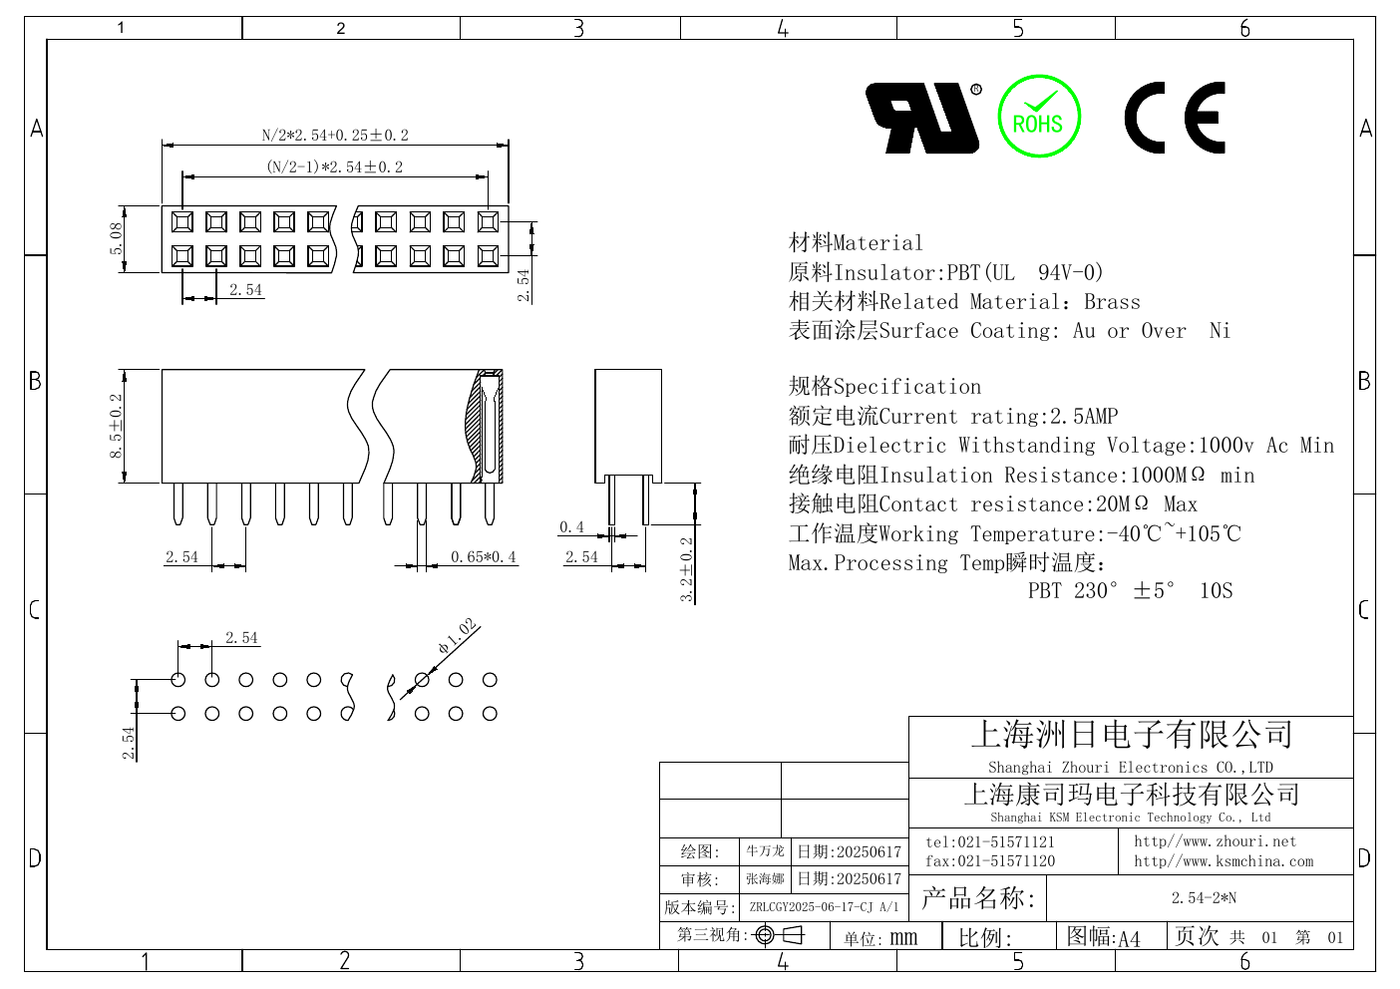
docs/references/扩展板乙版降本/sources/header-c2977589-1.png
