parkourlrc/pcb-yilv1982--duck-robot-89dbc81d6d/docs/references/扩展板乙版降本/sources/jlc-current-fees.png

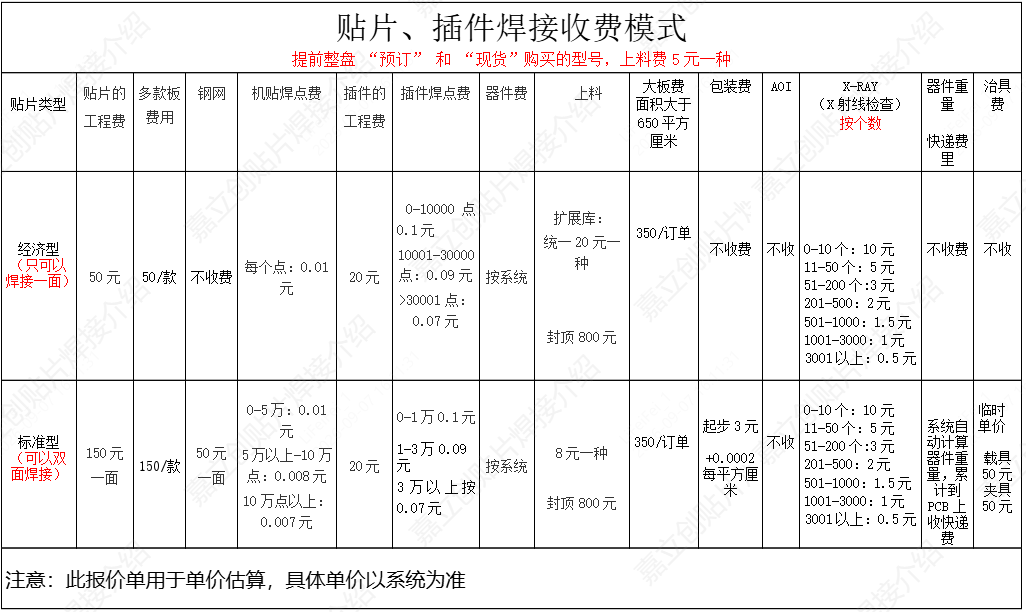
docs/references/扩展板乙版降本/sources/jlc-current-fees.png
