parkourlrc/pcb-yilv1982--duck-robot-89dbc81d6d/docs/references/扩展板乙版降本/sources/mic-c7587901-02.png

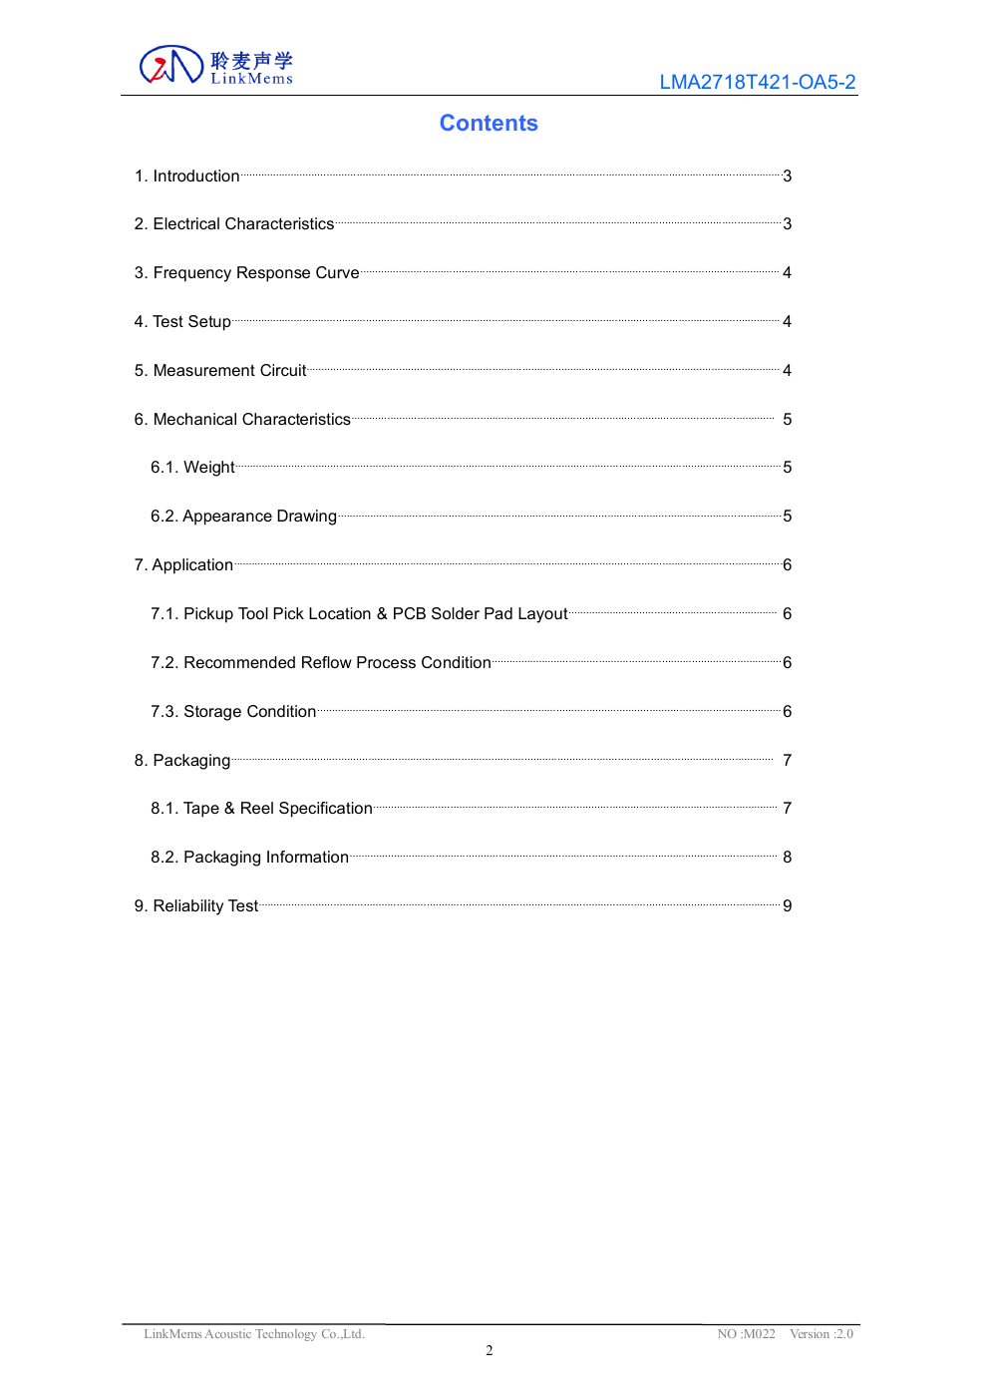
docs/references/扩展板乙版降本/sources/mic-c7587901-02.png
