parkourlrc/pcb-yilv1982--duck-robot-89dbc81d6d/docs/references/扩展板乙版降本/sources/smbj-vishay-1.png

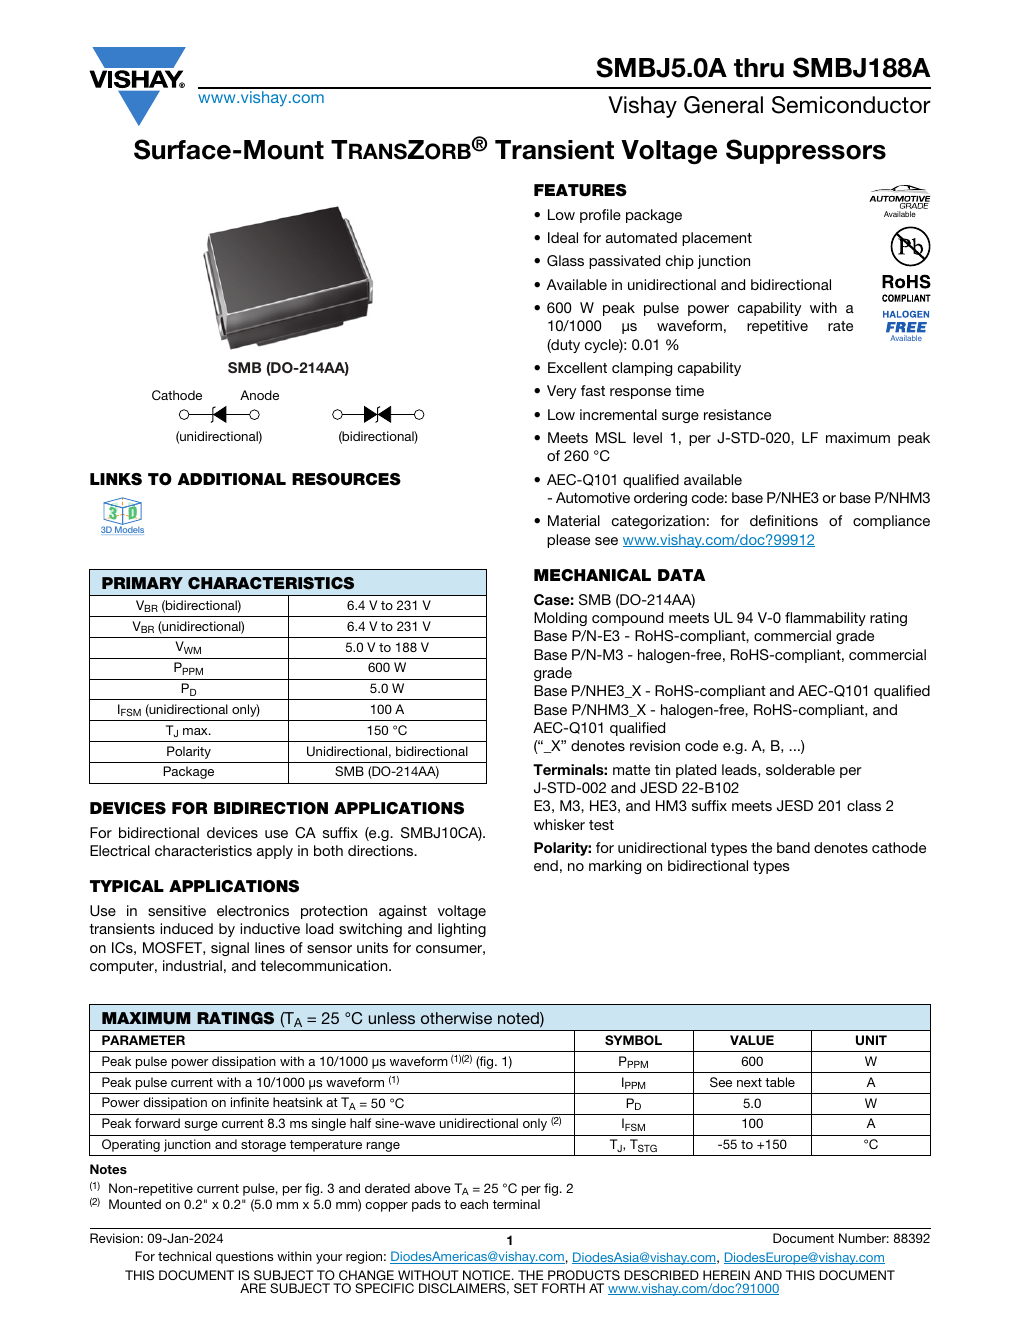
docs/references/扩展板乙版降本/sources/smbj-vishay-1.png
