parkourlrc/pcb-yilv1982--duck-robot-89dbc81d6d/docs/references/扩展板乙版降本/user-y701-active-oscillator-warning-20261104.png

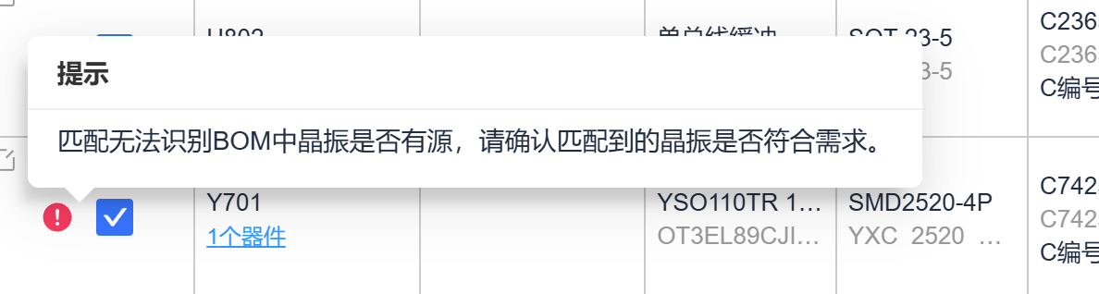
docs/references/扩展板乙版降本/user-y701-active-oscillator-warning-20261104.png
