parkourlrc/pcb-yilv1982--duck-robot-89dbc81d6d/docs/references/扩展板全现货改版/ap64351-pinout.png

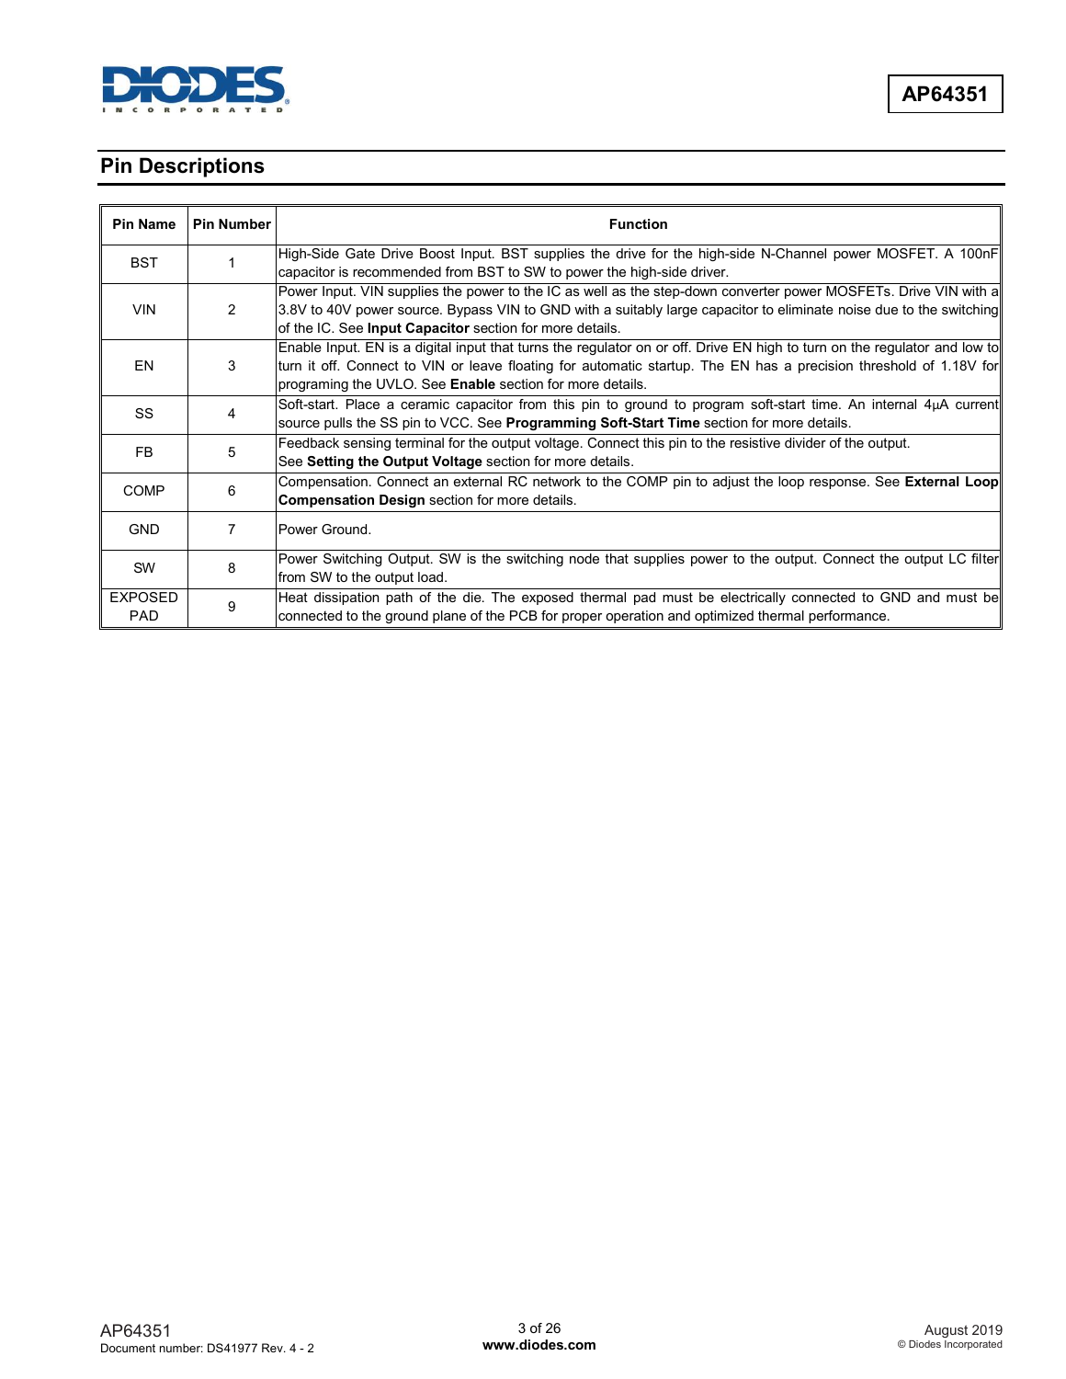
docs/references/扩展板全现货改版/ap64351-pinout.png
