parkourlrc/pcb-yilv1982--duck-robot-89dbc81d6d/docs/references/扩展板全现货改版/pam8302-msop-lands.png

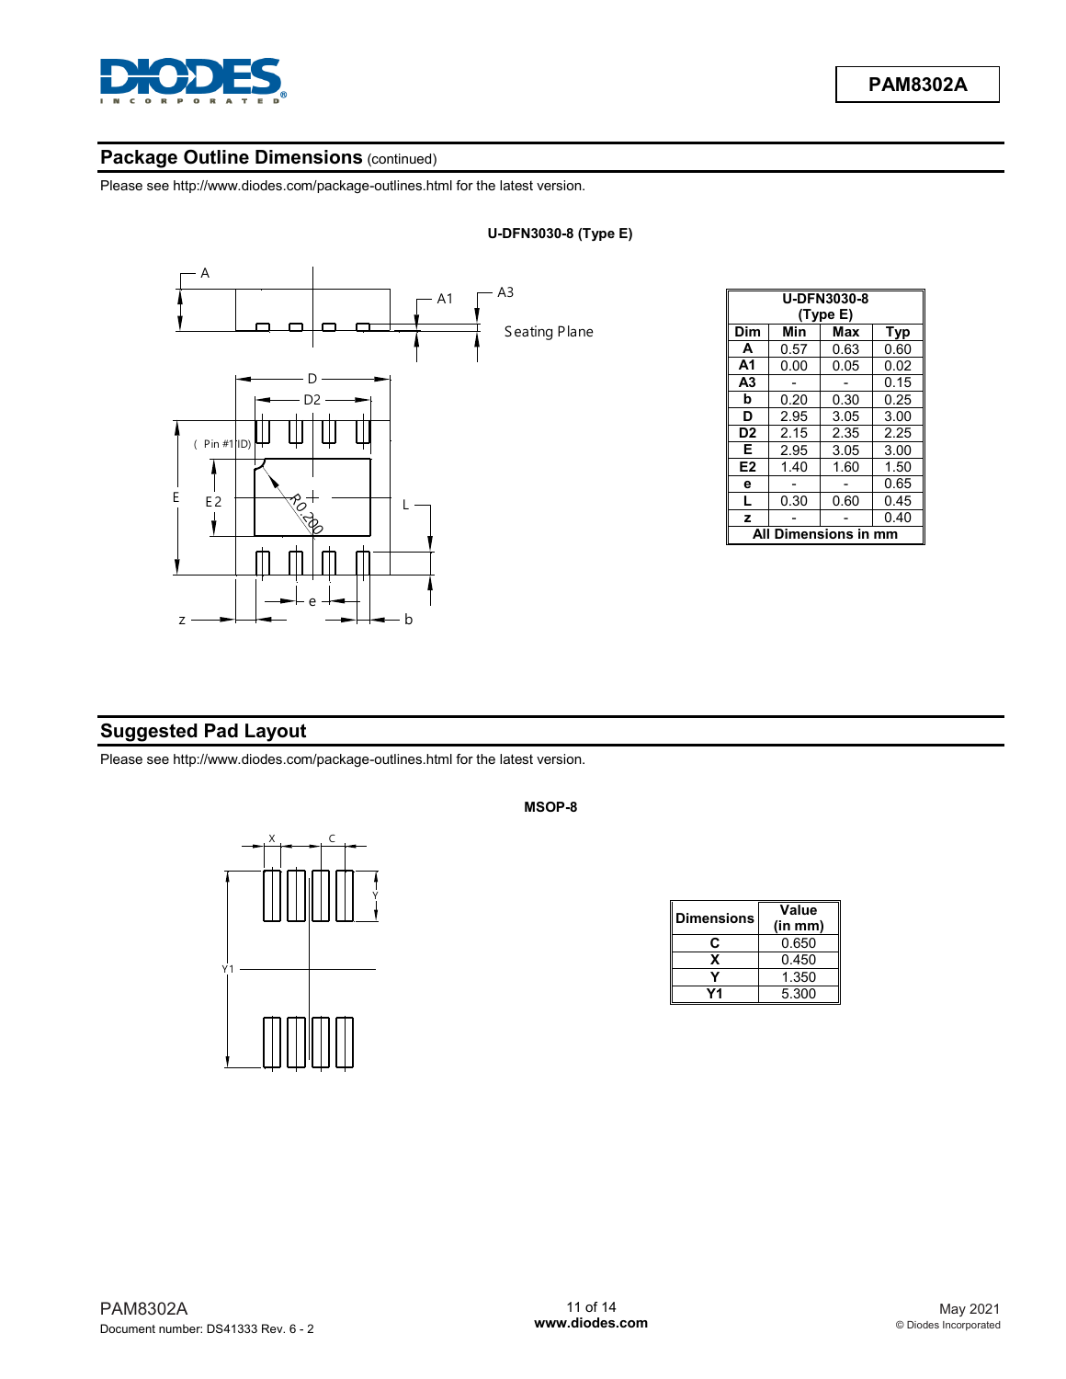
docs/references/扩展板全现货改版/pam8302-msop-lands.png
