parkourlrc/pcb-yilv1982--duck-robot-89dbc81d6d/docs/references/扩展板双口惯性缺答复核/hat-servo-crop.png

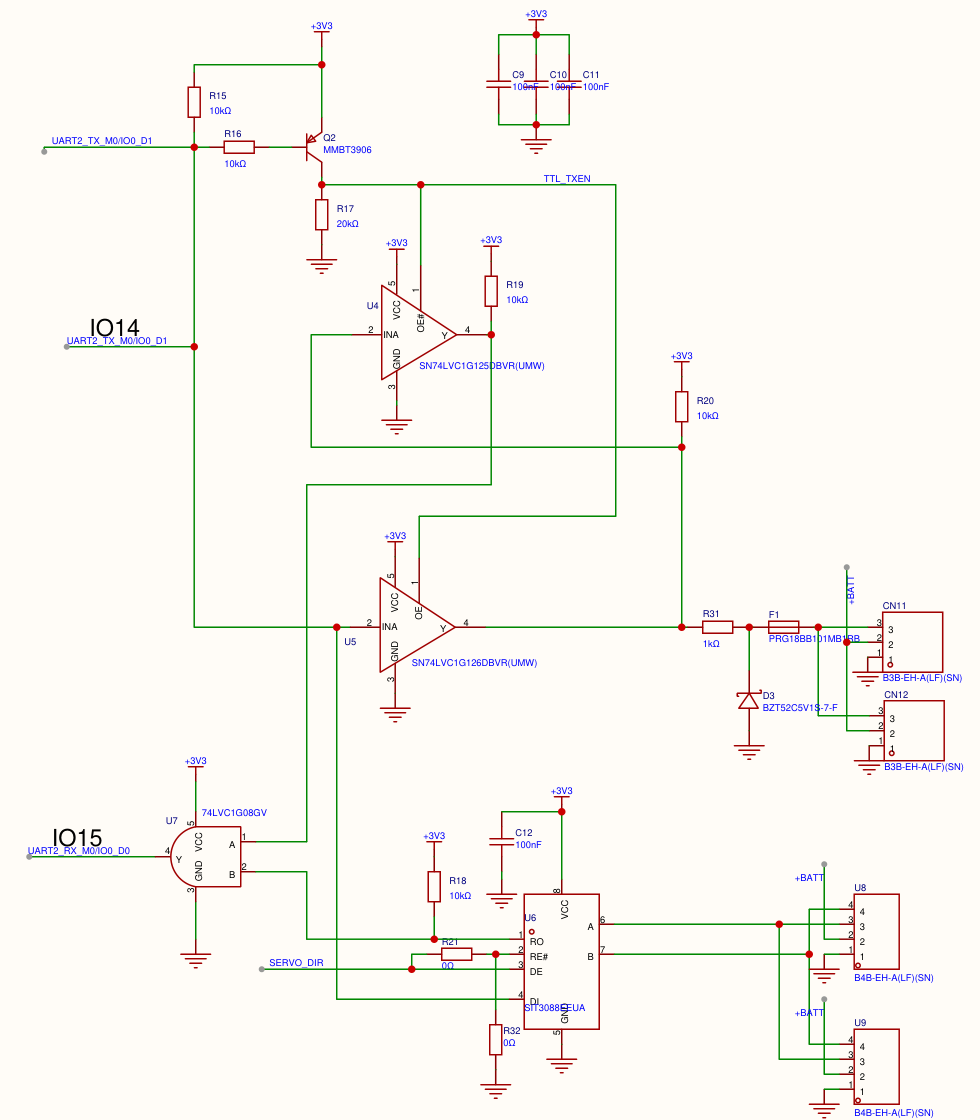
docs/references/扩展板双口惯性缺答复核/hat-servo-crop.png
