parkourlrc/pcb-yilv1982--duck-robot-89dbc81d6d/docs/references/扩展板双口惯性缺答复核/sources/murata-prg-series-r31-20261027-p3.png

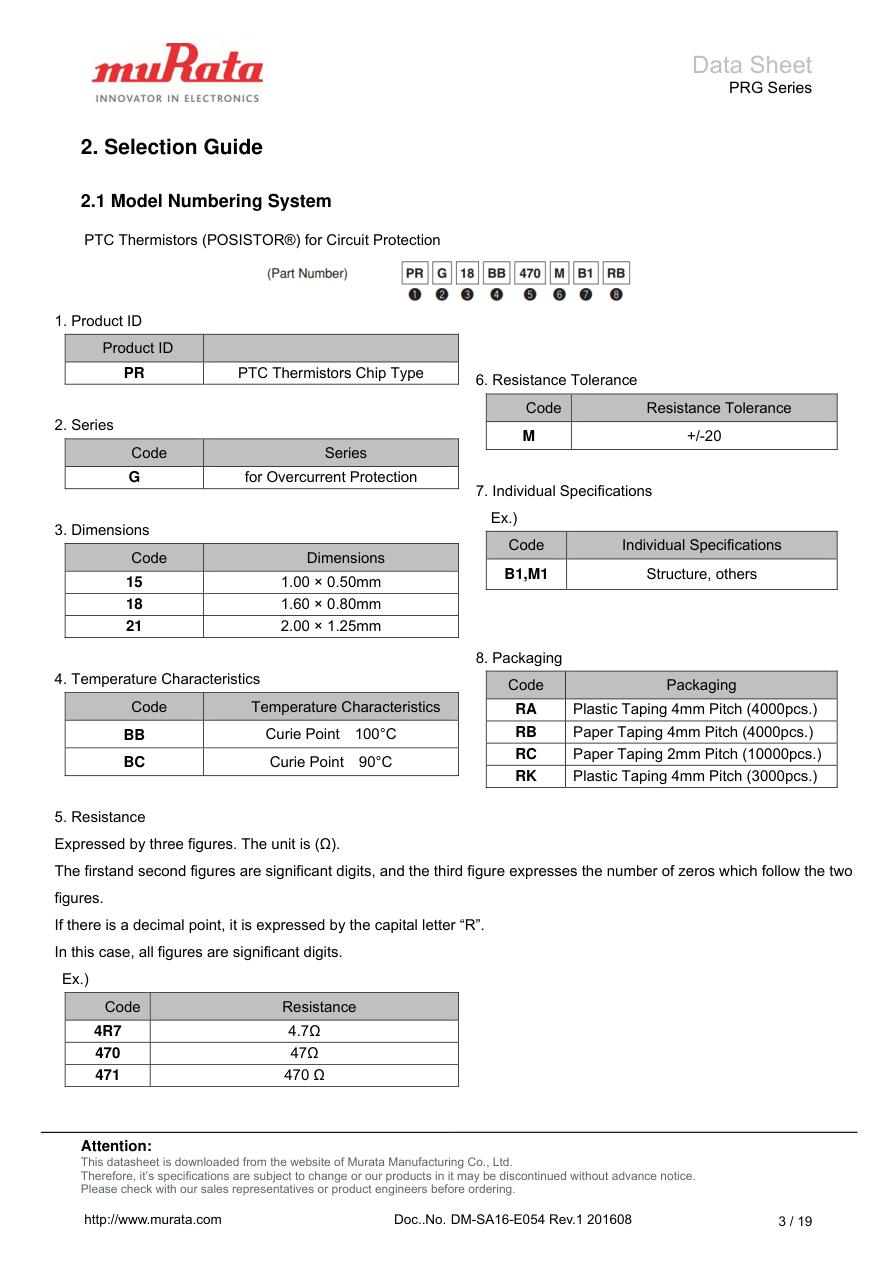
docs/references/扩展板双口惯性缺答复核/sources/murata-prg-series-r31-20261027-p3.png
