parkourlrc/pcb-yilv1982--duck-robot-89dbc81d6d/docs/references/扩展板嘉立创询价/official-pcb-contact.jpg

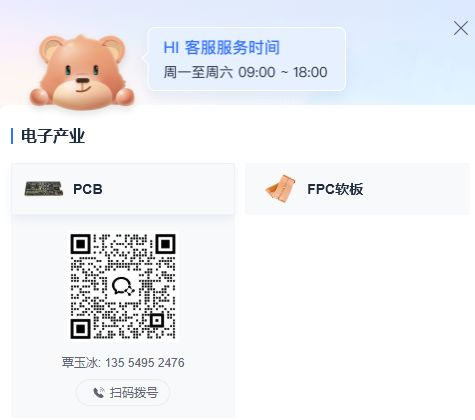
docs/references/扩展板嘉立创询价/official-pcb-contact.jpg
