parkourlrc/pcb-yilv1982--duck-robot-89dbc81d6d/docs/references/扩展板电路仿真工具/audit-20261029/bst-bmi088-ds001-page52.png

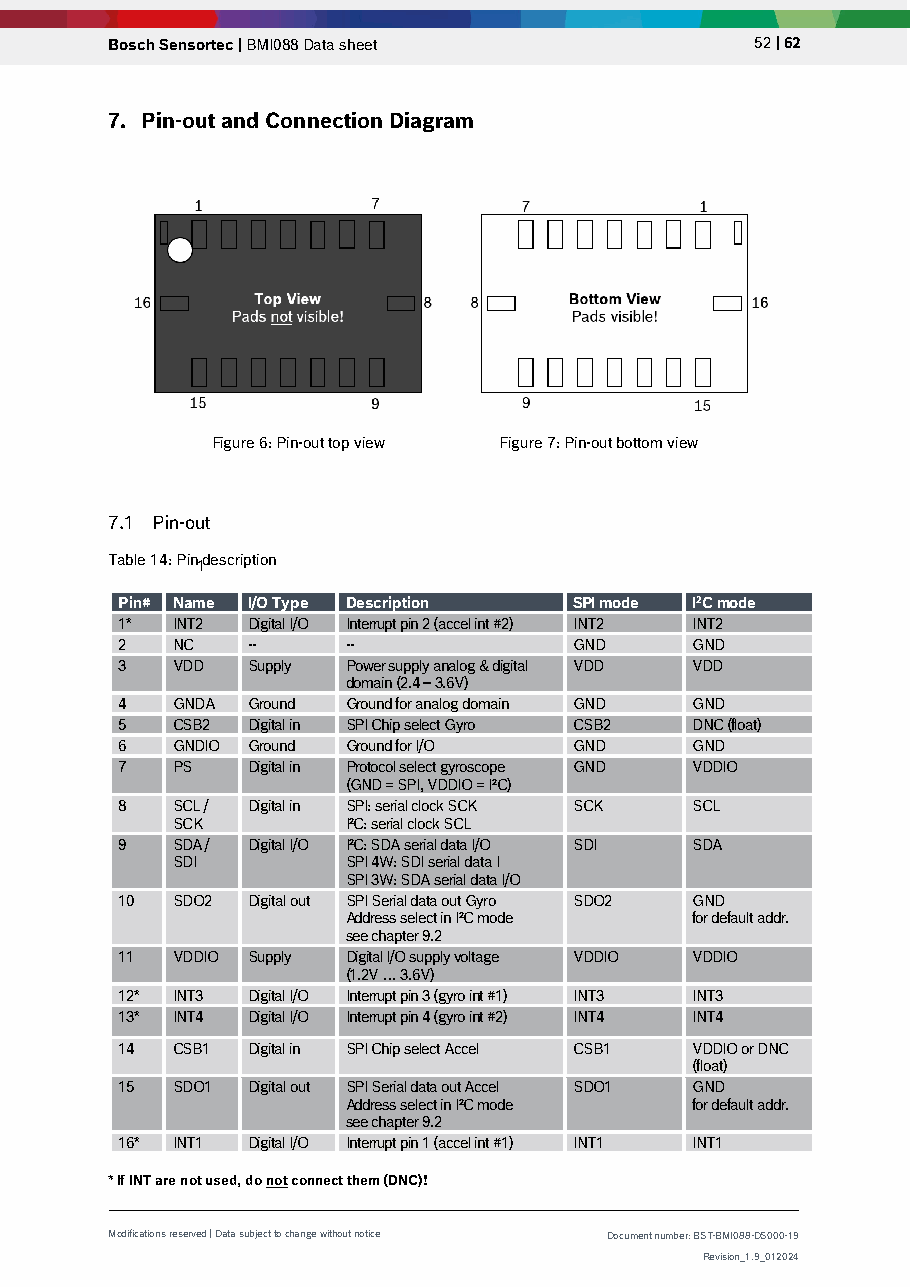
docs/references/扩展板电路仿真工具/audit-20261029/bst-bmi088-ds001-page52.png
