parkourlrc/pcb-yilv1982--duck-robot-89dbc81d6d/docs/references/扩展板电路仿真工具/capacitor-models-20261031/sources/AP64350-p18.png

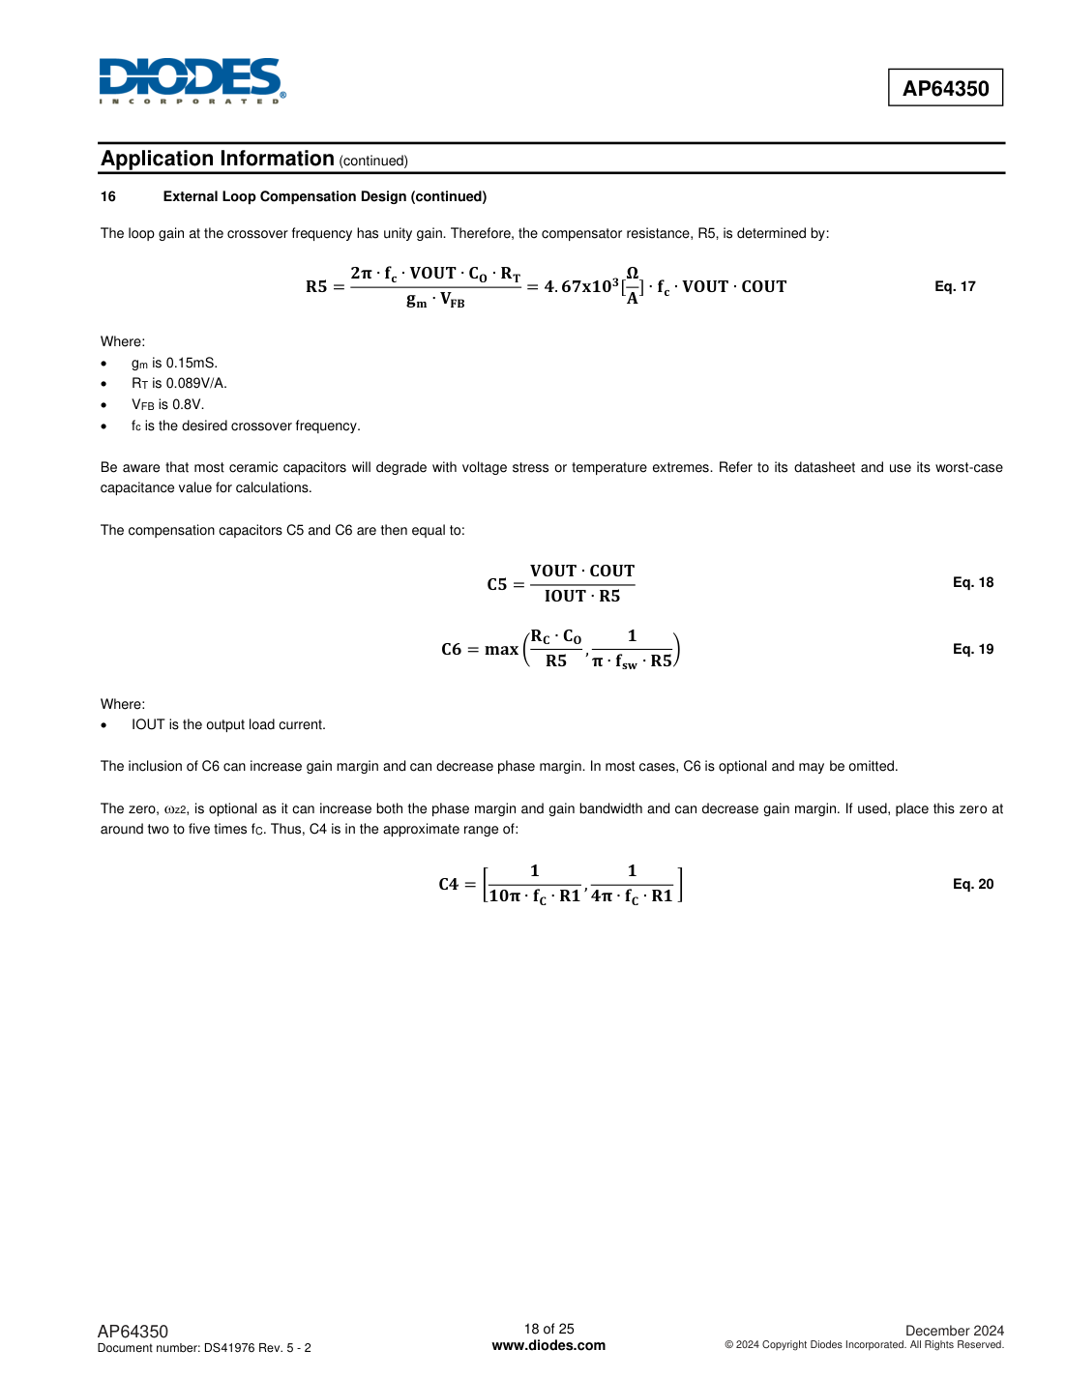
docs/references/扩展板电路仿真工具/capacitor-models-20261031/sources/AP64350-p18.png
