parkourlrc/pcb-yilv1982--duck-robot-89dbc81d6d/docs/references/扩展板电路仿真工具/capacitor-models-20261031/sources/C1206C106K3RACTU-dc-bias.png

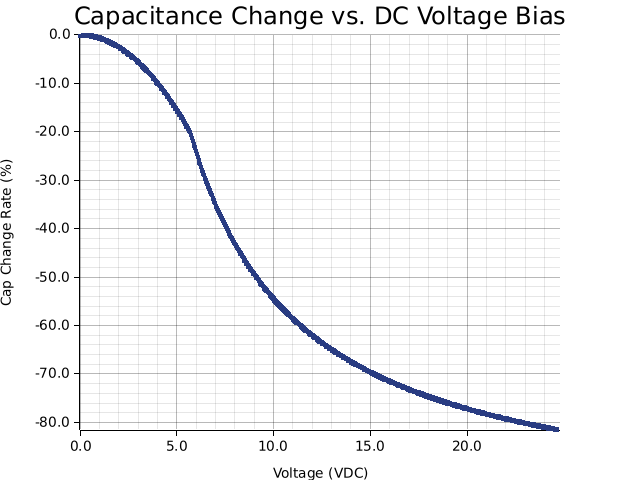
docs/references/扩展板电路仿真工具/capacitor-models-20261031/sources/C1206C106K3RACTU-dc-bias.png
