parkourlrc/pcb-yilv1982--duck-robot-89dbc81d6d/docs/references/扩展板电路仿真工具/capacitor-models-20261031/sources/C1210C226K3RACTU-impedance-esr.png

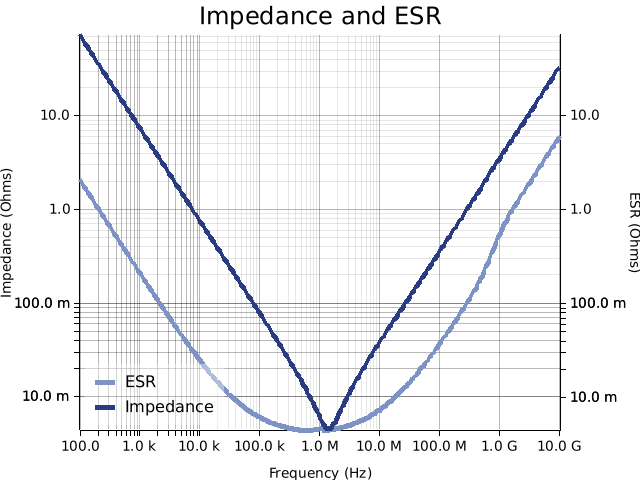
docs/references/扩展板电路仿真工具/capacitor-models-20261031/sources/C1210C226K3RACTU-impedance-esr.png
