parkourlrc/pcb-yilv1982--duck-robot-89dbc81d6d/docs/references/扩展板电路仿真工具/codec-reset-20261031/reset-board-In2.Cu.png

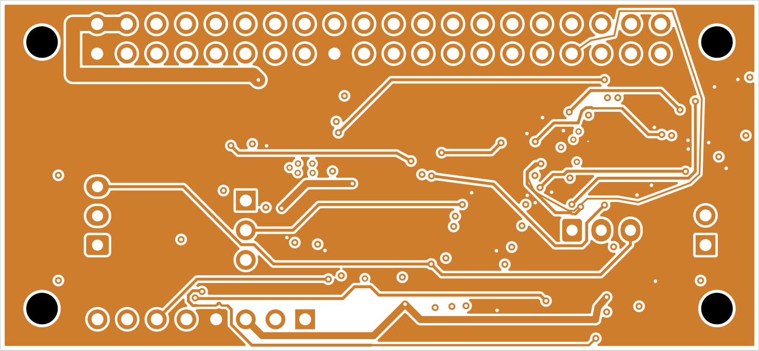
docs/references/扩展板电路仿真工具/codec-reset-20261031/reset-board-In2.Cu.png
