parkourlrc/pcb-yilv1982--duck-robot-89dbc81d6d/docs/references/扩展板电路仿真工具/connectors-20261031/sources/samtec-ssw-spec-p2.png

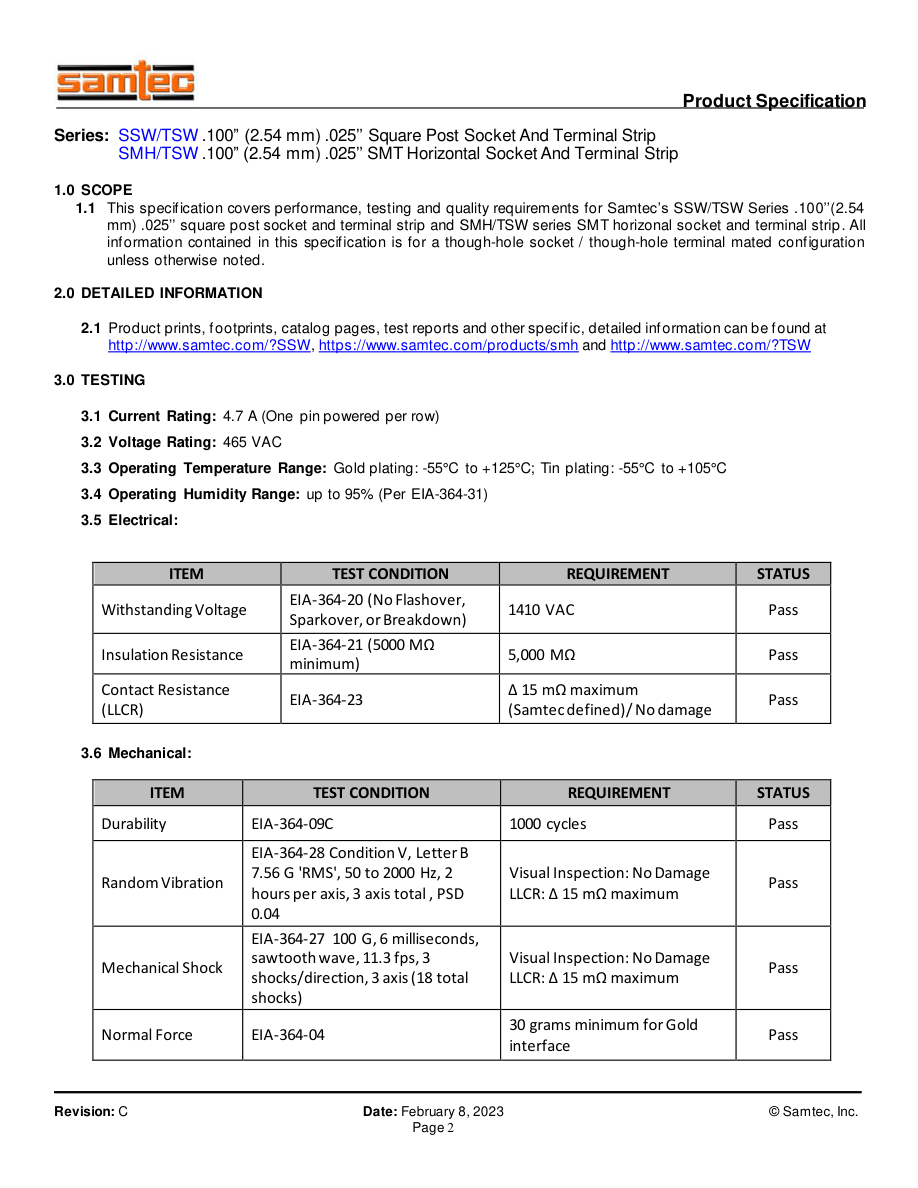
docs/references/扩展板电路仿真工具/connectors-20261031/sources/samtec-ssw-spec-p2.png
