parkourlrc/pcb-yilv1982--duck-robot-89dbc81d6d/docs/references/扩展板电路仿真工具/five-volt-paths-20261031/board-In2.png

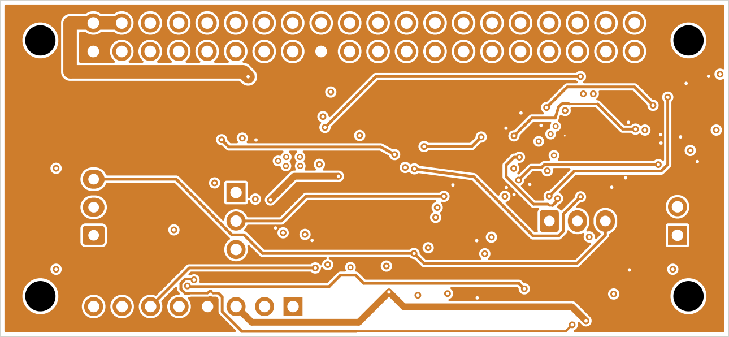
docs/references/扩展板电路仿真工具/five-volt-paths-20261031/board-In2.png
