parkourlrc/pcb-yilv1982--duck-robot-89dbc81d6d/docs/references/扩展板电路仿真工具/i2s-reference-stitch-20261031/reference-stitch-review.png

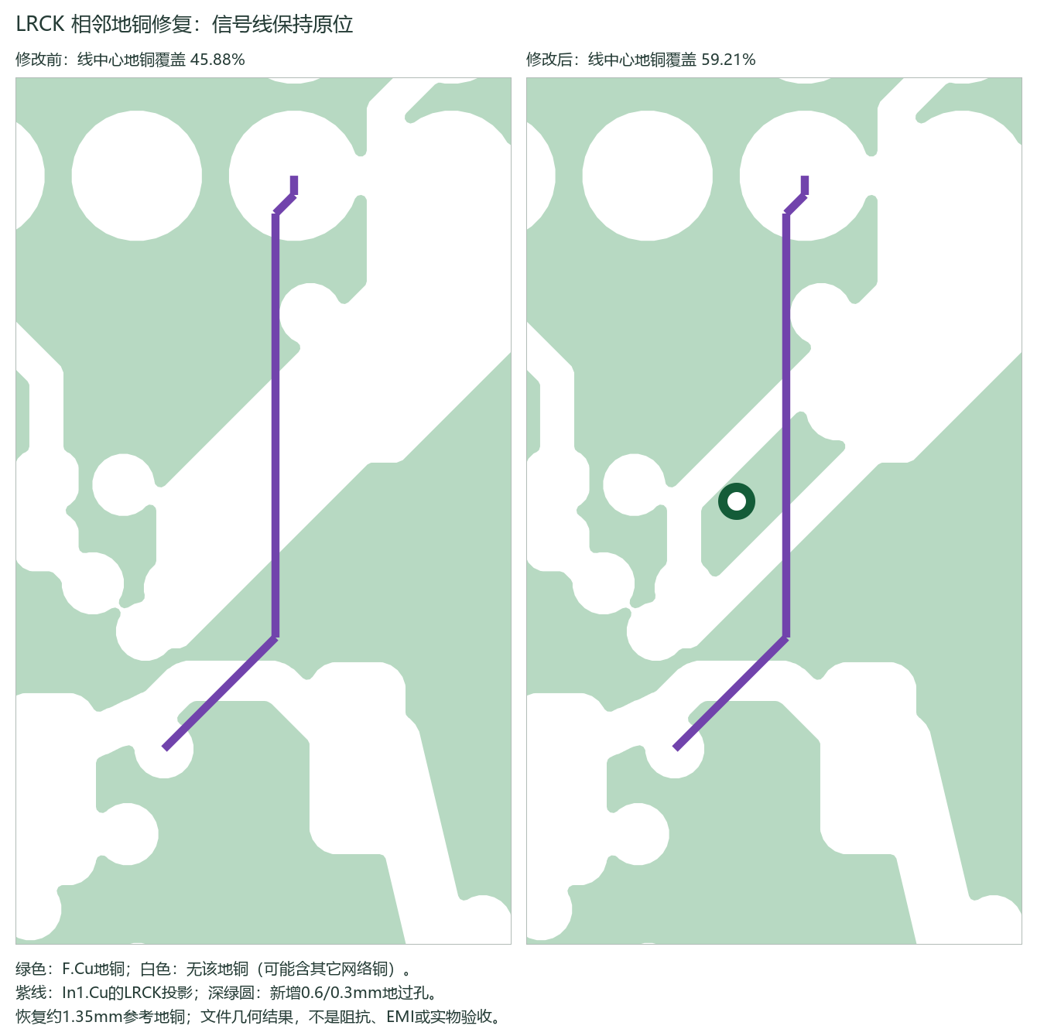
docs/references/扩展板电路仿真工具/i2s-reference-stitch-20261031/reference-stitch-review.png
