parkourlrc/pcb-yilv1982--duck-robot-89dbc81d6d/docs/references/扩展板电路仿真工具/power-acceptance-20261031/j301-input-detail.png

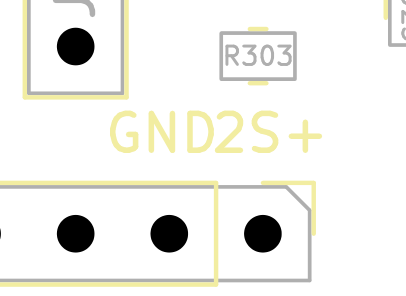
docs/references/扩展板电路仿真工具/power-acceptance-20261031/j301-input-detail.png
