parkourlrc/pcb-yilv1982--duck-robot-89dbc81d6d/docs/references/扩展板电路仿真工具/power-paths-20261031/power-path-review.png

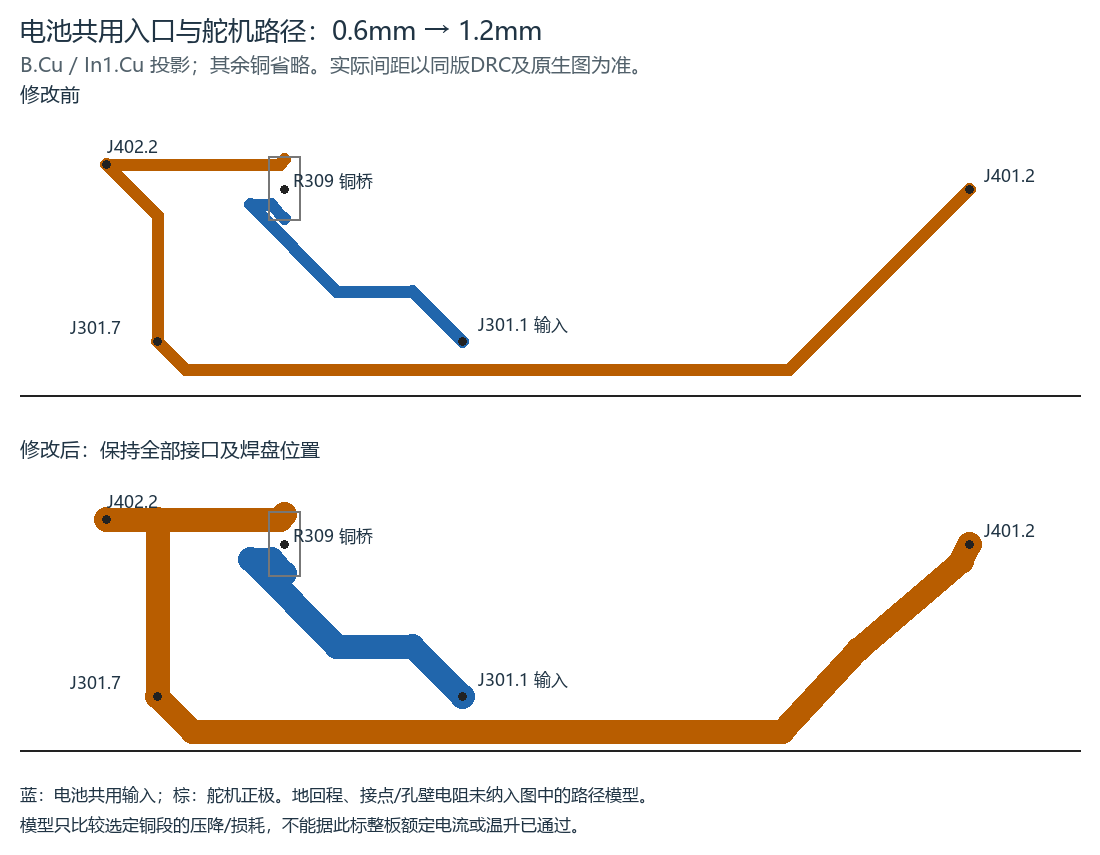
docs/references/扩展板电路仿真工具/power-paths-20261031/power-path-review.png
