parkourlrc/pcb-yilv1982--duck-robot-89dbc81d6d/docs/references/扩展板电路仿真工具/qwiic-pinout-20261031/c307-paste-before.png

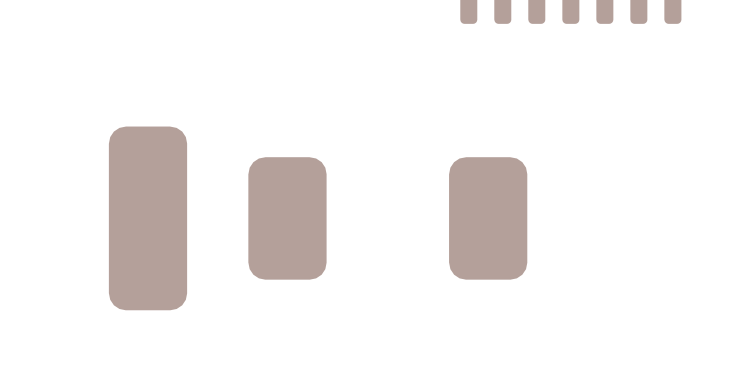
docs/references/扩展板电路仿真工具/qwiic-pinout-20261031/c307-paste-before.png
