parkourlrc/pcb-yilv1982--duck-robot-89dbc81d6d/docs/references/扩展板电路仿真工具/ttl-bypass-20261031/ttl-1-detail.png

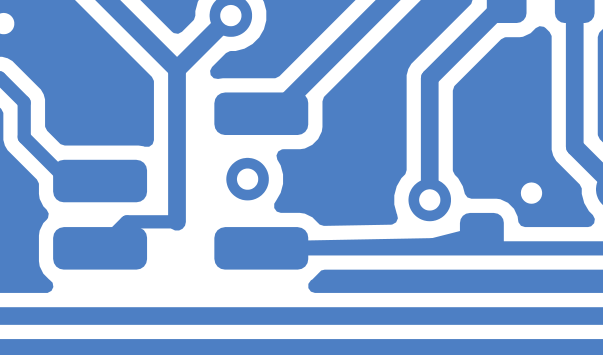
docs/references/扩展板电路仿真工具/ttl-bypass-20261031/ttl-1-detail.png
