parkourlrc/pcb-yilv1982--duck-robot-89dbc81d6d/docs/references/扩展板邮票孔与电源修复/bmi-bridge-detail.png

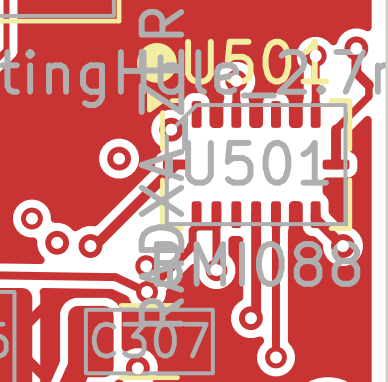
docs/references/扩展板邮票孔与电源修复/bmi-bridge-detail.png
