parkourlrc/pcb-yilv1982--duck-robot-89dbc81d6d/docs/references/扩展板邮票孔与电源修复/panel-r18-front.png

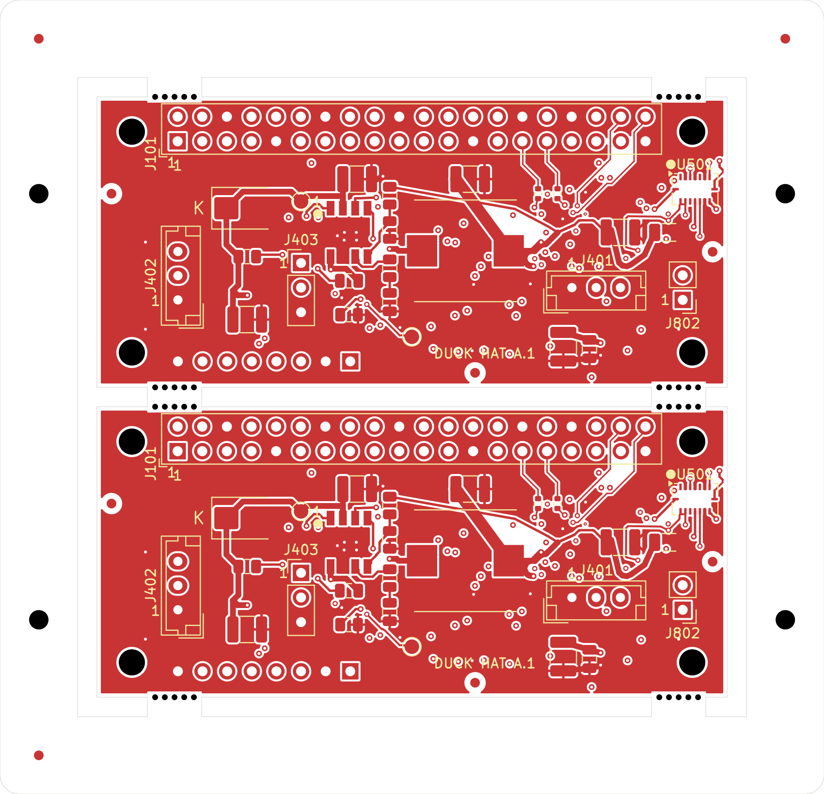
docs/references/扩展板邮票孔与电源修复/panel-r18-front.png
