parkourlrc/pcb-yilv1982--duck-robot-89dbc81d6d/docs/references/自主扩展板下单记录/smt-price-breakdown.jpg

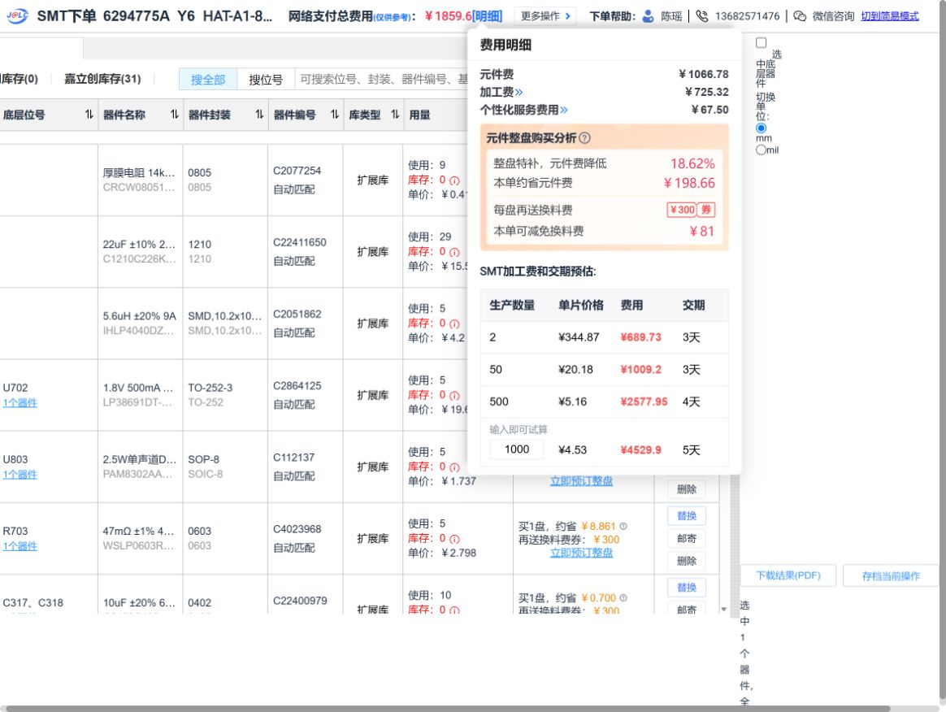
docs/references/自主扩展板下单记录/smt-price-breakdown.jpg
