parkourlrc/pcb-yilv1982--duck-robot-89dbc81d6d/docs/references/自主扩展板下单记录/substitution-sources/eaton-mfl-dimensions.png

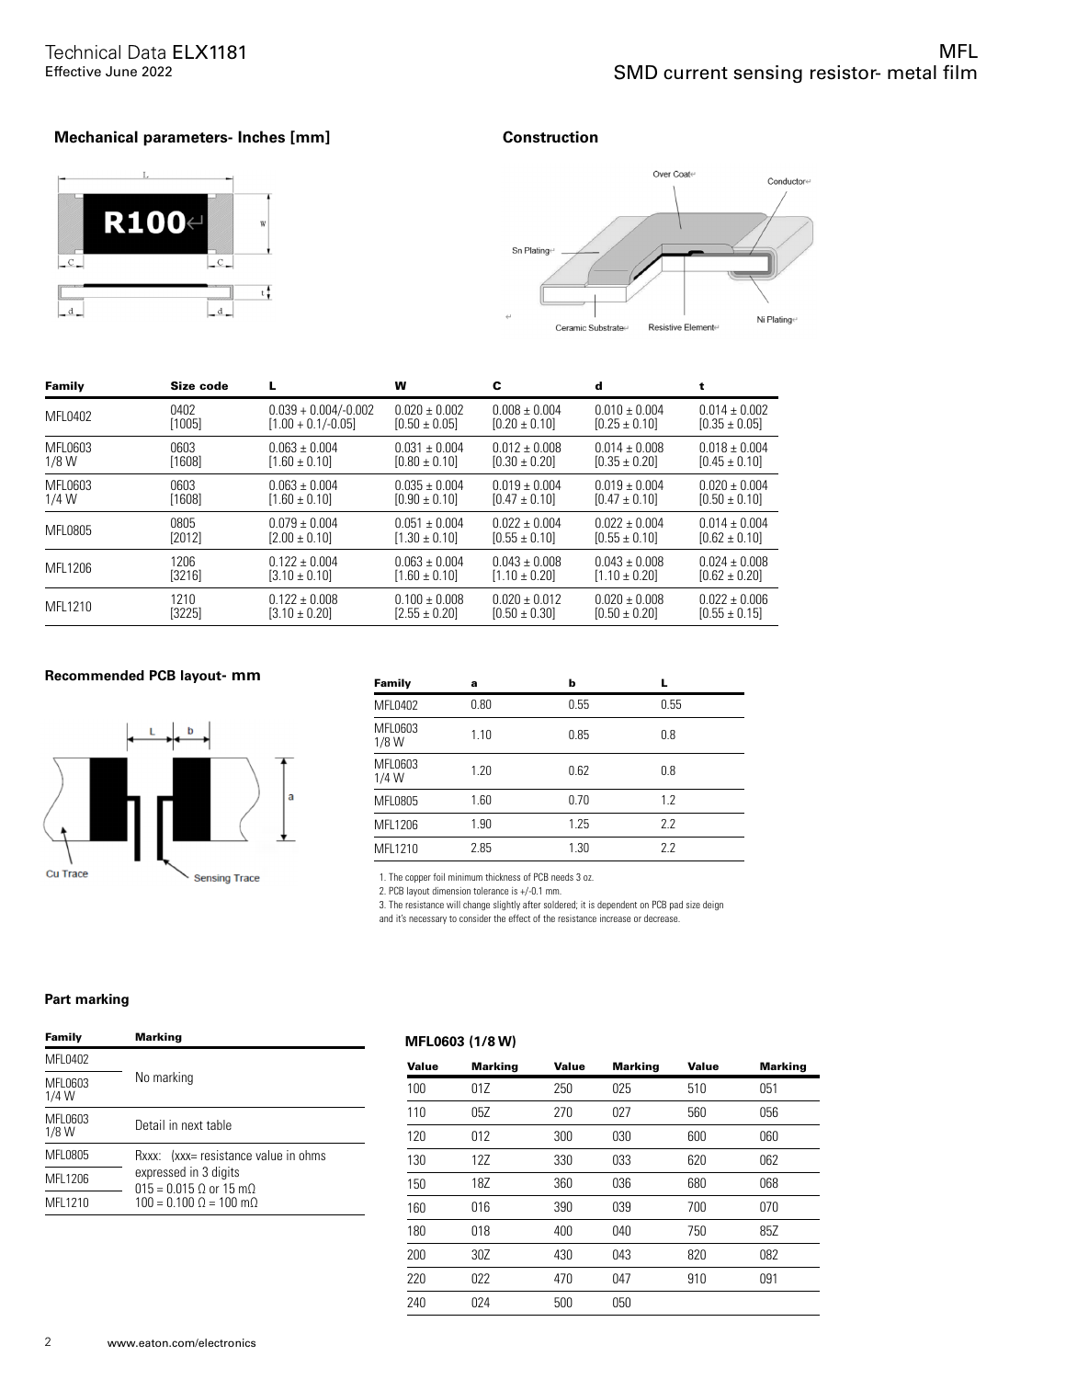
docs/references/自主扩展板下单记录/substitution-sources/eaton-mfl-dimensions.png
