parkourlrc/pcb-yilv1982--duck-robot-89dbc81d6d/docs/references/自主扩展板下单记录/substitution-sources/lp38690-pinout.png

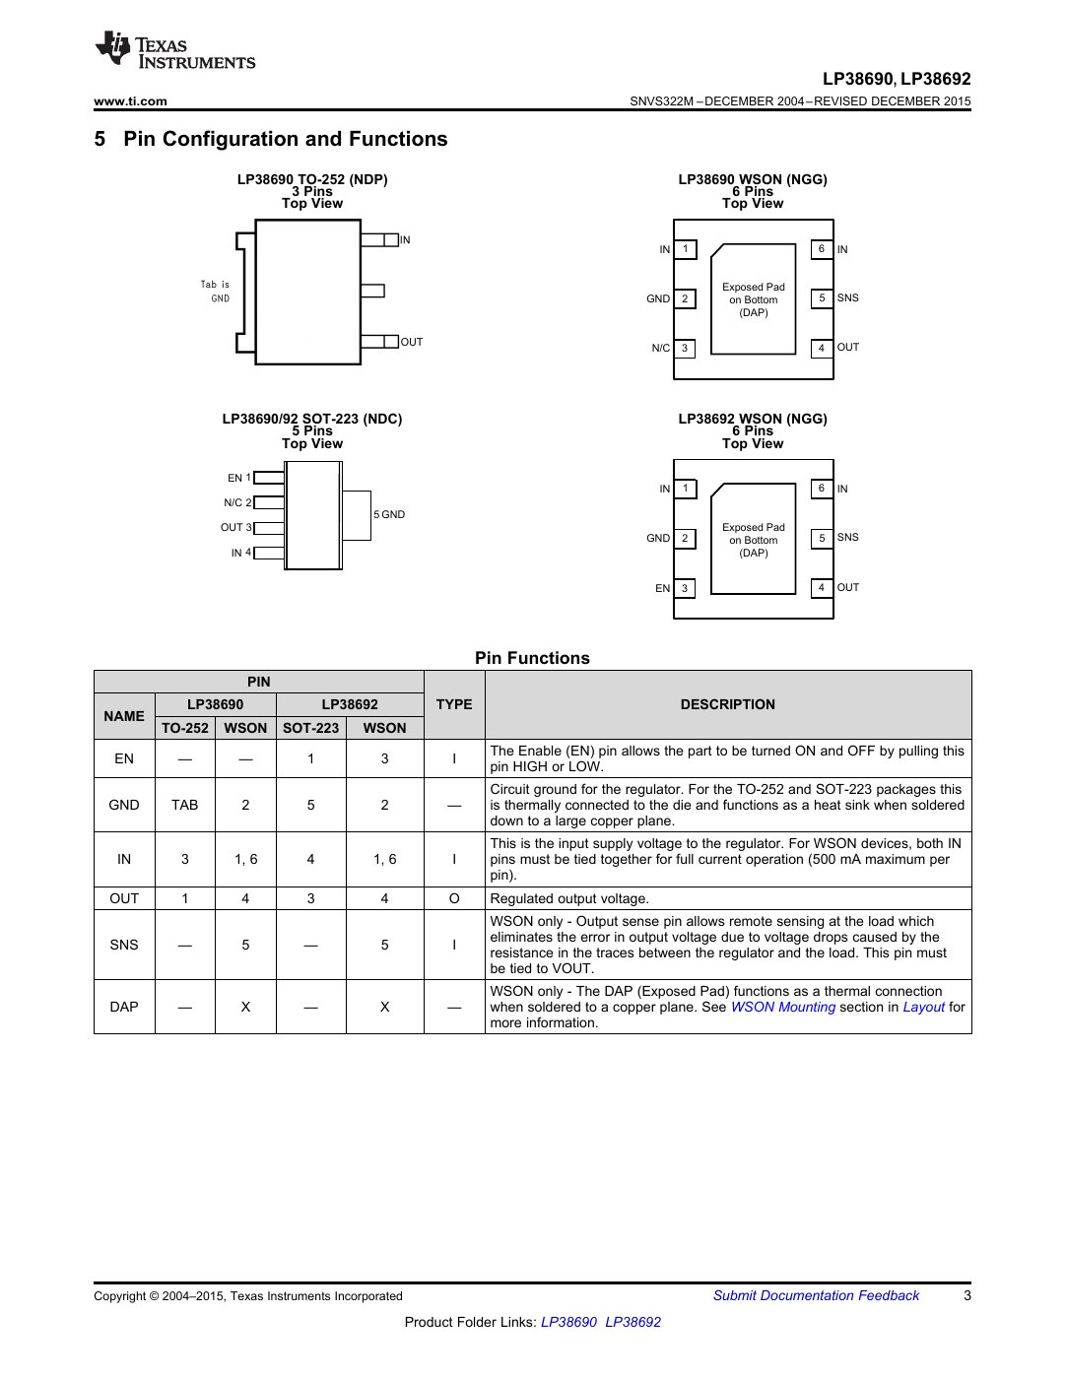
docs/references/自主扩展板下单记录/substitution-sources/lp38690-pinout.png
