parkourlrc/pcb-yilv1982--duck-robot-89dbc81d6d/docs/references/舵机网页工具惯性显示/waveshare-bus-servo-adapter-a-schematic-page1-20261025.png

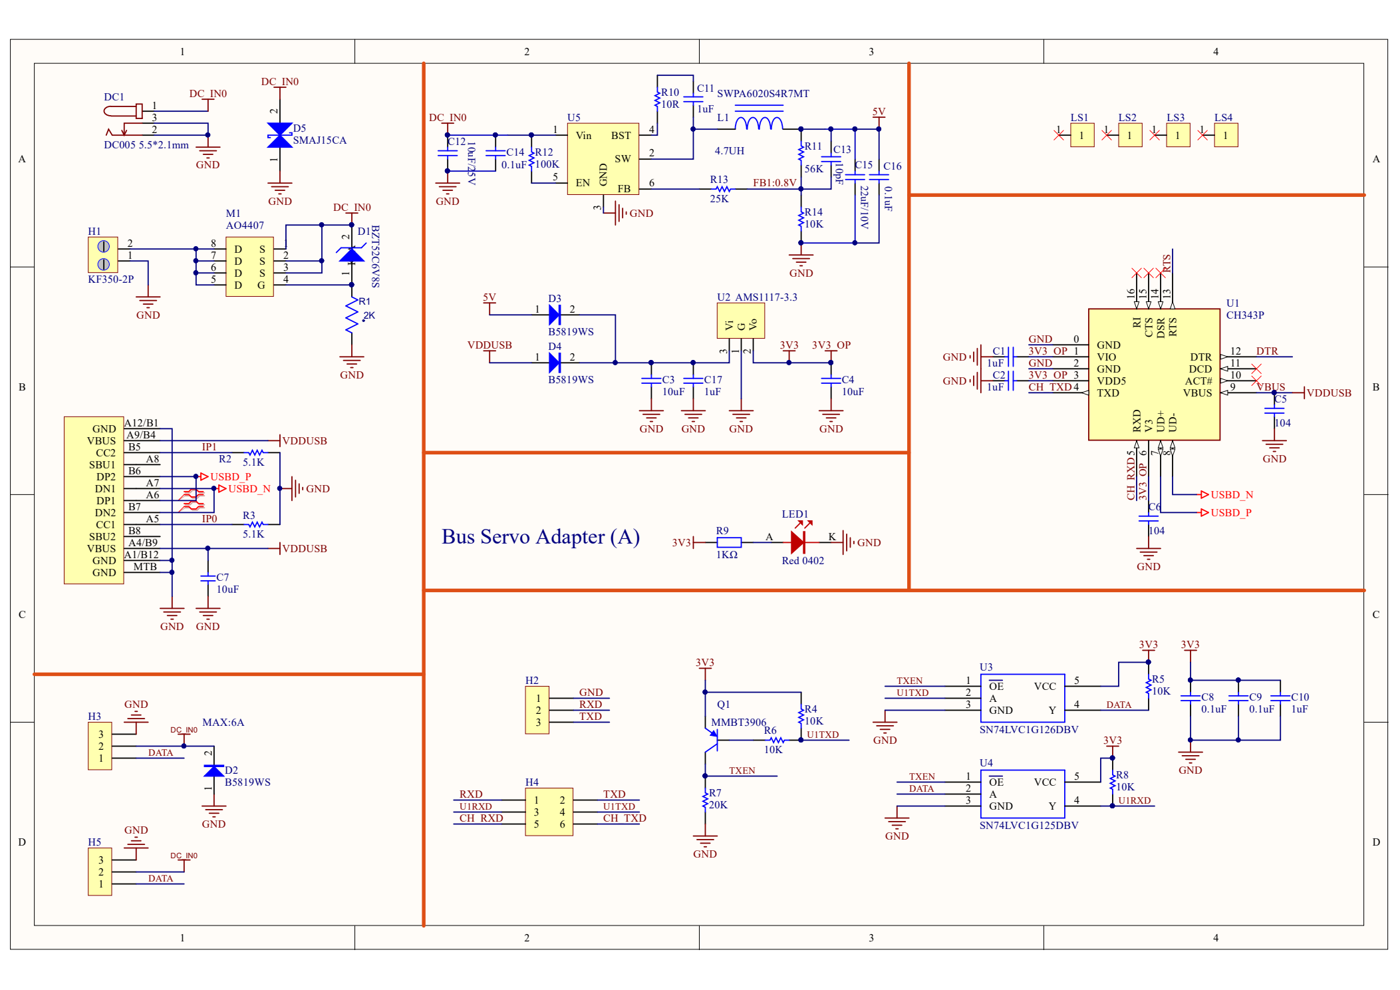
docs/references/舵机网页工具惯性显示/waveshare-bus-servo-adapter-a-schematic-page1-20261025.png
