parkourlrc/pcb-yilv1982--duck-robot-89dbc81d6d/docs/references/飞特策略模型上机核对/imu-v03-probe-map-20261101.png

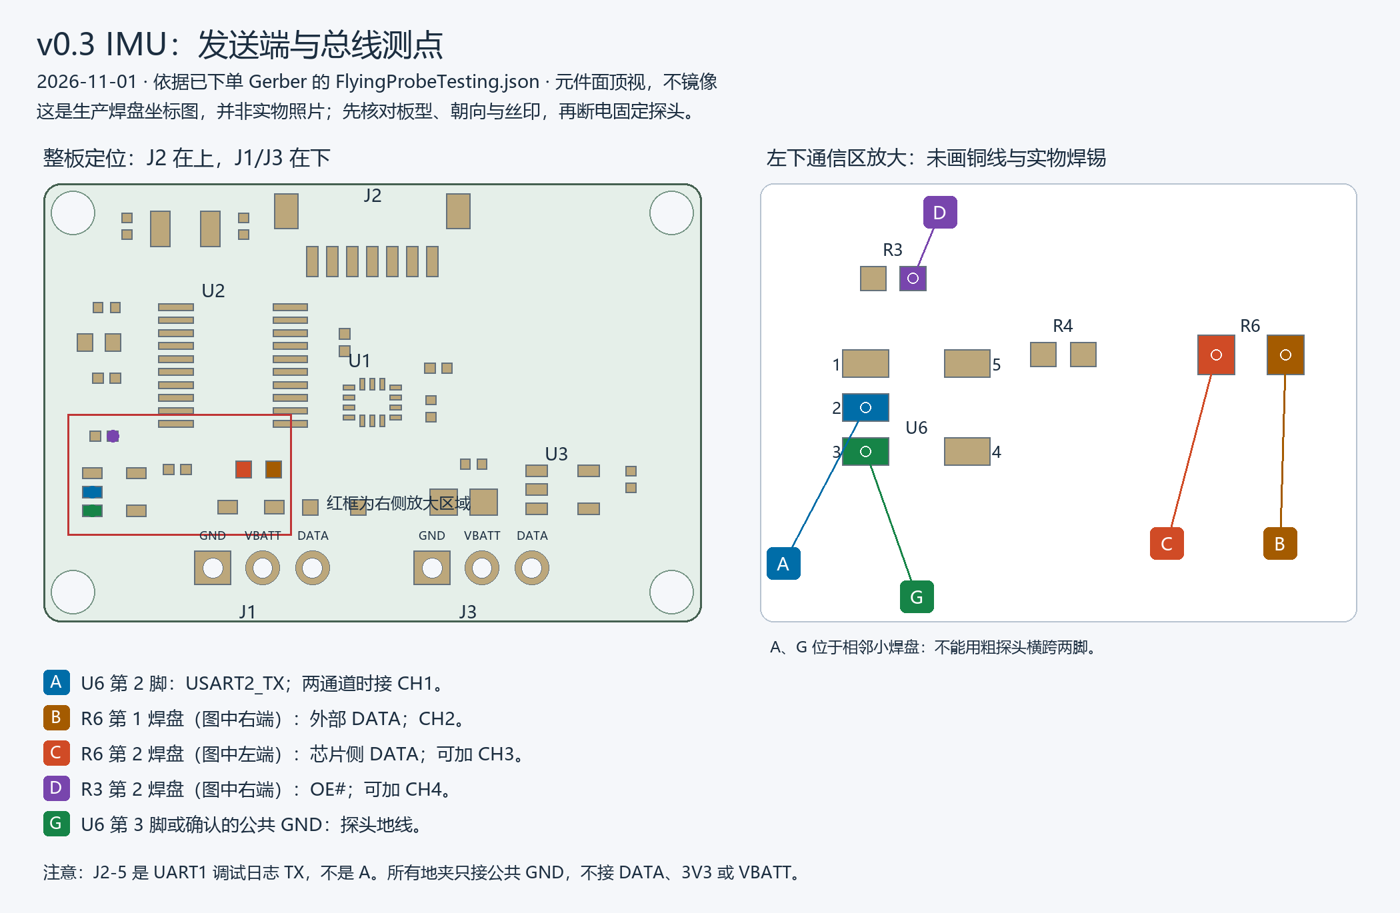
docs/references/飞特策略模型上机核对/imu-v03-probe-map-20261101.png
