parkourlrc/pcb-yilv1982--duck-robot-89dbc81d6d/docs/schematics/kissqy-hat-reva-reference/pcb-preview-2026-10-07.webp

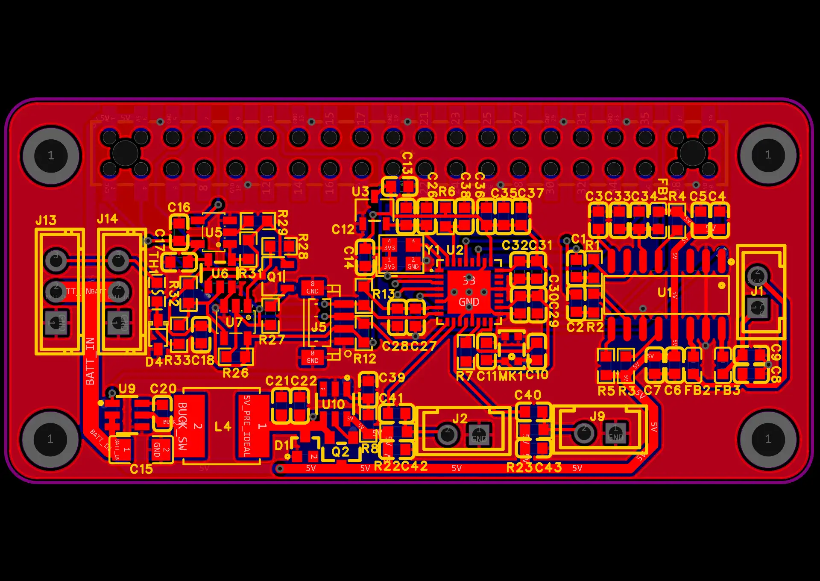
docs/schematics/kissqy-hat-reva-reference/pcb-preview-2026-10-07.webp
