parkourlrc/pcb-yilv1982--duck-robot-89dbc81d6d/docs/schematics/pollen-hat-pcb-reference/c1-pcb-page1.png

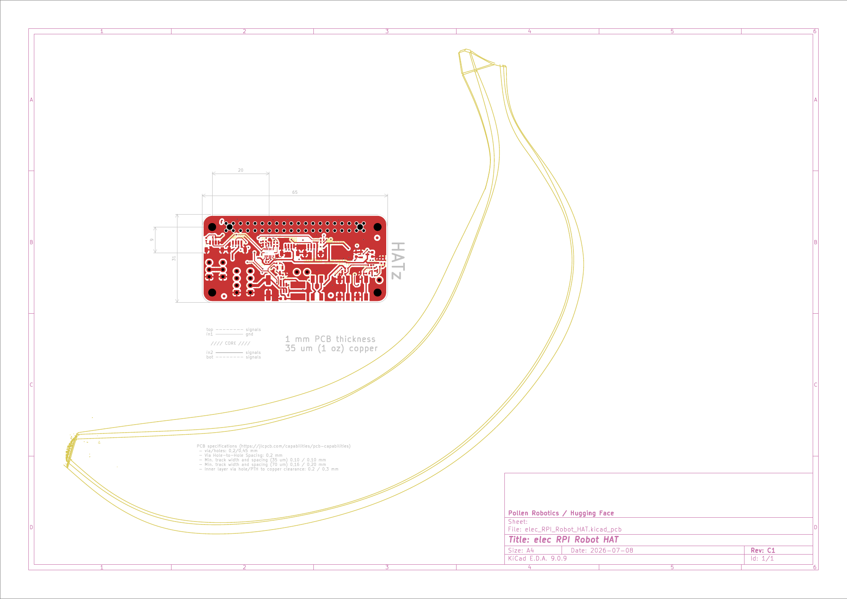
docs/schematics/pollen-hat-pcb-reference/c1-pcb-page1.png
