parkourlrc/pcb-yilv1982--duck-robot-89dbc81d6d/docs/schematics/pollen-hat-pcb-reference/d1-ass-page2.png

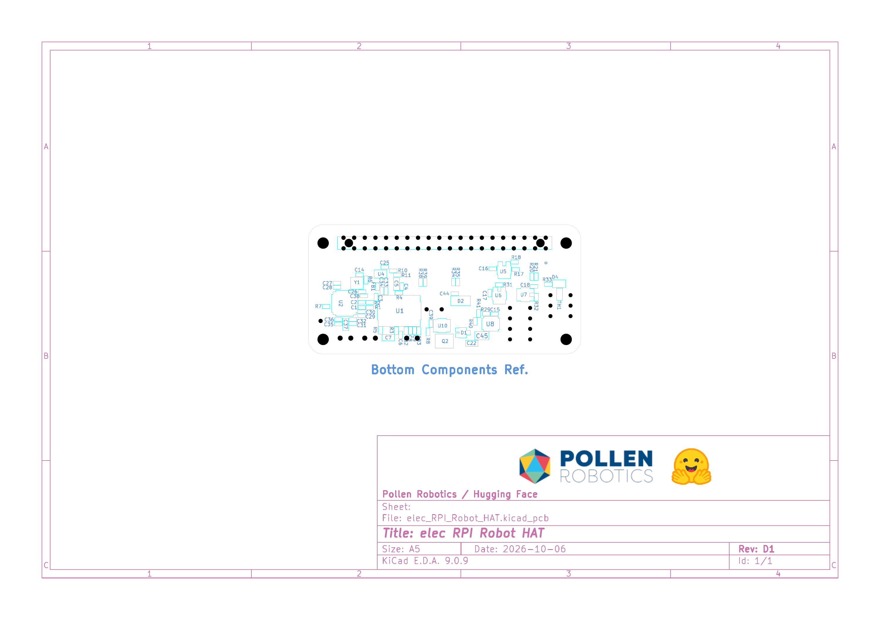
docs/schematics/pollen-hat-pcb-reference/d1-ass-page2.png
