parkourlrc/pcb-yilv1982--duck-robot-89dbc81d6d/BOM.md

# BOM 采购清单（当前路线：C · 飞特）

**2026-11-05 自主HAT状态：** [用户确认] Y10／SMT2611051346已付款，84362651版5片；[工厂MK701/Y701方向确认](docs/references/扩展板乙版降本/engineering-feedback/research.md)已完成本地核对，待用户回复，未确认发货。最后合并支付页金额891.79元（含运费5.50），未另核支付回执。研发继续暂停，本次仅响应用户提供的工程反馈；首板尚未验收，原750元目标未达成。

> **2026-11-04 自主HAT成本勘误**：[同渠道目录计算] 5板净用量下kissqy当前HAT材料约¥49.35/板，自主A.2已核55/58件¥189.94/板；均不含制造/贴片/备损。C308/C309/C328的C377773错误对应Samsung X5R而非设计KEMET X7R，剔除错误价格，现货方案须补充。作者¥16.72是历史EH2.5手焊材料摊销，不能直接比较工厂小批总价。见[比较与逐项明细](docs/references/自主扩展板与社区版成本比较/research.md)。

> **2026-11-04 HAT五片实单报价（与现有装机板分开）**：自主A.1 **Y7，PCB¥820.80＋SMT草稿¥2255.30＝¥3076.10/5片**；kissqy **Y8，PCB¥48.42＋SMT草稿¥1111.97＝¥1160.39/5片**，均不含最终运费。两PCB单待付款，贴片草稿已保存，尚无正式SMT单号；自主9行供料不足及3颗KEMET误匹配、kissqy D1与J13/J14缺料仍未解决，以上不是可完整供料的最终应付价。J1/J2/J9已核到CJT A1251WV-2P同型号新货号C5333427现货，不再列为该型号无现货。未填自由文本备注、未付款，均不计入在途/到货；旧Y6不作为现行支付入口。见[两单报价与物料核对](docs/references/两套扩展板订单与报价/research.md)。全现货[Rev A.2方案](docs/specs/20261104-hat-jlc-stock-redesign/spec.md)仍待补充及批准实施；旧SMT¥1859.60退出本次报价比较。

> **2026-11-01 替换板已到货／换装**：[用户确认] 新单 3P 口 IMU 已到货并换上。[实测] 主机通信已回滚为 IMU＋15 舵机同组 SYNC_READ；servo-web 30 秒 296/296 帧舵机完整、IMU 约 9.9 Hz，0 超时/坏校验/错 ID。robotd 已恢复原版；只读验收后已按用户要求切回 robotd/Studio（运行中），servo-web 已停止；此前助手只做过新板只读验收；此前两页站姿零位差已修正，用户已正式写入标定；模型已加载，用户已尝试动作，摔倒及恢复异常见最新排障记录。 新批次、价格未核；旧单口板损伤及双口 v0.3 库存分别保留。见[记录](docs/references/飞特策略模型上机核对/restore-mixed-sync-read-20261101.md)。

> **2026-10-31 [用户确认]：硬件部分已完成。** 当前推进[已训练模型与真机接入准备](docs/references/飞特策略模型上机核对/research.md)。下方物料数量/版本和旧测试记录用于追溯，不把历史未勾选项自动转成新增采购或重复硬件前置任务；维修经过和逐项参数未在本轮补测。

> **2026-10-10 重写**：2026-10-09 路线定稿「主参考 = community-kit 飞特路线」（HD-1910-C001 + HAT + imu_to_dxl 总线从站，见 [PROGRESS](./PROGRESS.md)「方案方向」）。本文件替换原根目录 A 线清单（XL330 + OpenRB + Pi Zero，2026-09-28 编写），A 线清单原样存档于 [docs/bom-route-a-20260928.md](./docs/bom-route-a-20260928.md)——仅当回退 A 线时使用。
>
> 状态口径：`[x]` 到货并登记 · `[~]` 在途/已下单 · `[ ]` 未购或待定。供电按 [v2 架构](docs/power-architecture-v2.md) 与实际板型区分：主控 5V 由 HAT 转换；2026-11-01 新单口板已换装，本轮没有变更供电或刷固件。下列旧 GD32 与 v0.3 参数仅适用于所标版本，新批次不能只按外形套用。

> **当前执行决定（2026-10-12 更新）**：按 v2 推进，先做[基础测试](./docs/hat-v1.2-test.md)，实际问题再排查。暂不为理论风险新增 dxl_hub、独立动力配电或电子保护板采购；**不先购买独立主保险**，先核实已到货电池自身的短路/过流保护规格：若该保护足以保护外部取电线束，则不另加保险；若缺失或无法确认，再评估外置保险。正常整机不加入微雪板和独立稳压板。

## 核心件

**2026-10-27 HAT 损伤历史**：用户拆下 R31 并在短接尝试中使两侧焊盘脱落。2026-10-31 已确认硬件完成，不再将该旧条目列为当前待修阻断；具体维修/替换经过尚未补齐，见[原始记录](docs/references/扩展板焊盘脱落修复/research.md)。

| 状态 | 物料 | 数量 | 用途 | 状态说明 |
| :---: | :--- | :---: | :--- | :--- |
| [x] | 单 3P 口 IMU 替换板（用户称旧板同款；厂商/新批次待核） | 1 | 当前装机姿态从站 | 2026-11-01 用户确认已换上；软件身份 `06 00 00 00 f2` / ft6，原出厂固件。servo-web 混合 SYNC_READ 只读通过；用户反馈 Studio 两页站姿不同后，主程序零位已对齐 2048 并回读通过，用户随后正式标定完成并有站姿保持回读；新板历史 ID 200 缺答记录保留，用户已尝试模型动作，摔倒及恢复异常待查、价格未核 |
| [x] | 飞特舵机 HD-1910-C001 | 15（含嘴） | 关节 | 2026-10-17 完成 ID 初始化，10-24 改号对齐上游；10-31 用户确认硬件完成。11-01 核对 Studio 已有 15 颗中位校准记录，经用户批准将 robotd 的参考机零位替换为 2048，其他标定与保护保留，本次未写 EEPROM、未试动作；见[零位修正](docs/references/飞特策略模型上机核对/studio-home-target-mismatch-20261101.md)。历史方法见[装配与 CAL 调研](./docs/references/整机装配与中位校准/research.md)。另有一颗“嫌疑坏”舵机隔离，不计入装机批 |
| [x] | 白色鸭图案 HAT | 1 | 主控适配 + 总线物理层（74LVC 半双工 + UART2/ttyS2） | 实物丝印 **V1.2**（10-10 照片确认）；存档原理图为 V1.0，图物有差异（背面多 MCU 类器件；圆柱电容不再认作超级电容），**V1.2 图纸待向板卡来源索取**；2026-10-27 [共总线复核](./docs/references/扩展板双口惯性缺答复核/research.md)发现 V1.0 DATA 串阻 1 kΩ、官方对应 150 Ω；V1.2 实装待核。10-27 [用户转述] ScrapMeta 曾建议圈选电阻非 0Ω 时更换或短接，用户确认圈选件为 HAT R31；后续拆除时焊盘损伤已另行归档，不能将早期建议当作现行施工指令；见[作者记录](docs/references/扩展板双口惯性缺答复核/research.md#author-bug-search-20261027) |
| [x] | IMU 板② imu_to_dxl（jyg9 GD32 单 3P 成品版，**2026-10-31 已下线**） | 1 | 姿态总线从站（ID 200，双协议免刷） | 2026-10-14 照片判别 + 2026-10-26 官方 0.2 BOM/原理图析毕：GD32F303 + ETA2845S2G，**≥6.5V 冷启动 / ≈5.93V 维持（EN 分压），5V 必不启动（不损坏）**，7.4~8.4V 正常直挂链末；EH 座针序 1=GND 2=V+ 3=DATA 图纸确认；电源正极无保险，反接必烧（见 [电源分析](./docs/references/单口惯性单元五伏供电/research.md)）。2026-10-25 晚移至 HAT 第二个 3P 口后短测 0/60、完整交错 2/360 仍严重缺答；**2026-10-27 支路 A/B：舵机接入时只查 IMU 6/475，拔支路后 500/500**；示波器已于 2026-11-01 确认 SDS814X HD 到货并接入 USB，USB PnP 已正常，暂停前仪器通信尚未验收；以下为 10-27 历史排障，用户已断电、拔掉全部外接线在板测得 IMU R31=100kΩ、R5=51Ω、F1=25Ω；R31/R5 与公开修订值一致，暂不改阻，撤回孤立测阻；用户当时决定到货后先抓请求/RX/TX/回程波形（现行 v0.3 采集见根因任务），借板替换降为后备；IMU/HAT 动态交互仍未排除；见[共总线分析](./docs/references/扩展板双口惯性缺答复核/research.md)，H1 日志保留为需确认构建开关的后备项；此前微雪台架连独立舵机也无字节，不能据此判 IMU 坏，HAT 旧接法有自然请求 CRC 错误；远端真机丢包诊断与验证工作单另见 [惯性单元固件代码分析](./docs/references/惯性单元固件代码分析/research.md)。此前回读镜像 **1.5.1 / CRC32 0xD9CA0DEF**，与官方包构建指纹未匹配，不等于 Flash 损坏。见[换口记录](./docs/references/舵机网页工具惯性显示/research.md#hat-port2-20261025)与[版本研究](./docs/references/惯性单元三版来源对比/research.md)。2026-10-31 已由新制 v0.3 替换；2026-11-01 用户补充旧单口板此前可用，后来人为损坏一颗电阻，现已损坏，位号/时间未核；上述历史缺答原因不据此全部归因。用户已换上新单口板，见新增替换板行 |
| [x] | ~~IMU 板① imu_to_dxl v0.3（备件）~~ **2026-10-25 测量短接致损** | 1 | ~~备用姿态总线从站~~ | ScrapMeta microduck-diy / STM32G031 双 3P 版；**2026-10-25 在 7.4V 分支上测电压时表笔短接烧损（用户确认；2026-10-31 原厂复核已撤回“5.5V 上限/7.4V 超限”说法）**，若仅 LDO 损坏可换 AP2210K-3.3 修复；修复后再按 J2 焊接 → DAPLink 刷机 → imu200 验收（[flash/README](./flash/README.md) 固件包已备），实物料号/输入规格待核。flash/ 固件与刷机资料保留 |
| [x] | imu_to_dxl v0.3 板（PCB+SMT 一体，已到货） | 5（订单数，余板状态未逐片登记） | 新制在用板/备件 | **2026-10-30/31 到货，至少 1 块 J1/J3 自焊、烧录 0.2.0 后上线替换板②**；用户确认 DATA/GND 不变，7.4V 正常；pin4 5V 时主控无法启动，DAPLink 5V 时 IMU 无 PING 且未接 DAPLink 自身 GND；两个故障分开分析，见[原厂复核](./docs/references/惯性单元输入电压复核/research.md)。以下为下单历史： 裸板单 85849959 用户已取消（未支付）；改走 **PCB+SMT 一体单**（2026-10-25 定向，EDA 一键下单/JLC 网页，金额以订单页为准）：贴 19 个贴片件（含 J2 调试座），J1/J3 EH 插件到货自焊，Y1/C7/C8 维持 DNP。Gerber/BOM/CPL 三件套见[生产文件](./docs/schematics/imu-to-dxl-scrapmeta-v0.3/production/)，下单调研见 [惯性单元嘉立创下单](./docs/references/惯性单元嘉立创下单/research.md)。到货刷机按 [flash/README](./flash/README.md) |
| [x] | BUS SERVO POWER SUPPLY V1.3 降压板 | 1 | **可选**转接件：XT60 ↔ 螺丝端子 | 空载实测完成（6V 档/下限 ≈6.3V/直通可用）。架构 v2 后**降为可选**：VCC 稳压口闲置不动，拿掉它则自制线直连 HAT |
| [x] | 微雪 Bus Servo Adapter (A) | 1 | 半双工总线转接（台架调试） | 2026-10-25 COM4、B 模式、外部 7.4V 下同口独立舵机 PING 仍全无字节，未证明正常；2026-10-26 主排障回到 HAT，微雪留独立支线，不重复扫描。USB 只供逻辑、3P V 取外部 DC。见[接入舵机记录](./docs/references/舵机网页工具惯性显示/research.md#waveshare-servo-ping-20261025)。无需因此加入整机 |
| [~] | banana_pcb ×5 | 5 | 电池触点取电转接 | 订单 85078132，2026-10-12 到货；装配：焊 U6068（已到）→ locker 打印 → 核极性 → 主控支路验证 |
| [x] | DAPLink SWD 调试器 | 1 | IMU 刷机链路 | 2026-10-12 到货（用户确认）；解锁 IMU 刷机链路（J2 焊接 → 烧录 → imu200 验收） |
| [x] | U6068 香蕉头插针（2.5mm PCB 插针） | 2 | banana_pcb 电池触点 | 2026-10-12 到货（用户确认：所称「香蕉插头」「电池座」均指此件） |
| [x] | 2S 电池（NP-F550，8.4V） | 1 | 动力 + 逻辑总电源 | 2026-10-12 到货；待登记化学体系/触点形式，与 banana_pcb 装配一起定供电终案；充电器 2026-10-12 已到货（见供电与充电表），输出规格与 NP-F550（2S 8.4V）匹配性待核对 |

## 供电与充电

| 状态 | 物料 | 说明 |
| :---: | :--- | :--- |
| [x] | **匹配充电器** | 2026-10-12 到货（用户确认）；待核对输出规格与 NP-F550（2S 8.4V）匹配后登记 |
| [ ] | **电池过流保护核验；外置主保险条件采购** | 电池品牌/型号及 BMS 规格尚未登记，暂不购买保险丝和保险座。先查电池是否有适用的短路/过流切断保护；若规格确认足以保护外部取电线束，可不另加保险；若无或无法确认，则需在电池正极近端设计外置保险后再使用电池。旧 5A 仅为候选，不作默认值，也不能保证保护 3A EH 座；见[复核记录](./docs/references/供电与扩展板实物复核/research.md#2026-10-12-主保险是否必要)及[保护方案](./docs/overcurrent-protection.md) |
| [ ] | 直流总开关 / 断电连接件 | 额定待按电流和通断工况选定；按最终保护拓扑串在正极线上，若外置保险确有需要则放在保险之后。开关不是自动过流保护，见[保护方案](./docs/overcurrent-protection.md) |
| [x] | 电池盒 | banana_pcb 取电方案配套；触点形式待登记 |
| [x] | 直流稳压电源 DLX-30V10AMF | 台架供电/实测（30V/10A，限流保护） |

## 线材与小件

| 状态 | 物料 | 说明 |
| :---: | :--- | :--- |
| [x] | 杜邦线 | IMU J2「直焊焊盘」路线材料；走此路线则无需另购座子+线 |
| [ ] | BM07B-SRSS-TB 座 + SH1.0 7P 线 | 仅当 J2 不走杜邦直焊路线时才需购 |
| [ ] | **EH 压接材料包**：EHR-3 胶壳 ×25 + SEH-001T-P0.6 端子 ×100（线规实测后定，细线则 SEH-002T）+ SN-2549 压线钳 | 2026-10-16 端子+胶壳到货（型号/压线钳状态待核）；15 根舵机线的改头安排待核。2026-10-24 描述的 IMU/腿部公共分叉为焊接线束，不据此声称已压 EH；压线步骤见[采购调研](./docs/references/端子压接采购调研/research.md#到货与压线操作2026-10-16) |
| [ ] | 电池两线输入线 + HAT ↔ 舵机 3P 适配线 | 实际系列与插合视角待核：HAT 按 EH，C001 规格书写 AMP2.0-3P，与旧 5264 记录不同；逐针核实 GND/+BATT/DATA，不靠试插判断兼容；电池输入 DATA 留空 |
| [x] | 无头电子线 | banana_pcb 拆电池焊接出线备选；线径须按 3-5A 核对 |
| [x] | 电烙铁 + 焊锡/助焊剂 | IMU J2 焊接、banana_pcb 装配 |

## 工具（到位与在途）

- [x] **示波器：鼎阳 SDS814X HD，2026-11-01 用户确认到货，USB 枚举型号已核对。** 厂家型号规格为 4 模拟通道／100 MHz；13:59 USB PnP 已恢复正常，暂停前 VISA 仍在安装、仪器查询尚未通过；尚未采波形，用户已确认探头未接。用于 IMU 请求／TX／回程定位，见[当前连接与测点记录](./docs/references/飞特策略模型上机核对/root-cause-investigation-20261101.md)及[厂家规格来源](./docs/references/扩展板双口惯性缺答复核/oscilloscope-sources-20261027.json)。

万用表（10-09 到货）、直流电源、电烙铁——照片与用法存档见 [docs/photos/](./docs/photos/README.md)。

2026-10-26 用户再次确认有 **FT232H 与 DAPLink**：FT232H 优先用于单口 IMU H1 UART 日志，DAPLink 留作 H2 SWD 后备。00:25 FT232H 已枚举 **COM5**，驱动状态正常；H1 接线与日志采集尚未完成，不增加采购；接线/模式边界见[调试计划](./docs/references/舵机网页工具惯性显示/debug-plan-20261026.md)。

## 结构件

- [ ] 打印件清点：版本/材料/缺件登记。
- **C 线打印模型以上游独立仓库 [microduck-replica-cad](https://github.com/fanhao375/microduck-replica-cad) 为准**（本地未导入）；A 线的 `references/microduck-build-tutorial/microduck3D打印.3mf` 是 XL330 结构，**不适用 C 线**。
- C 线专属打印件：`banana_pcb_locker`（banana_pcb 到货后打）。

## 安全边界速记（C 线，按架构 v2）

- **旧单口板实物描述（2026-10-27，现已下线）**：IMU 与舵机链分占 HAT 两个 3P 口，舵机支路接入触发 IMU 严重缺答、拔除恢复；分组实验以 PROGRESS 为准。动力入口与端点电压未由本次图纸复核重测，不能由 3P 插拔直接排除供电/地。见[原理图分析](./docs/references/扩展板双口惯性缺答复核/research.md)；旧接线图仍为历史意向。
- **可省去的是独立模块；电池保护须闭环，但不预设要额外装保险**：HAT 电源/通信通过后微雪板与独立稳压板无需进入整机；取电板、适配线和匹配充电器仍需。电池内置保护足够时可不加外置主保险；依据尚未核实前，不使用电池进行整机供电。
- **EH 座待核**：当前资料约 3A，社区常态 3–5A 不是本机波形，不能据此断言瞬时堵转会烧 HAT。先核实实际额定、电流及持续时间；确有不满足再改配电，不能靠 5A 保险或简单两口并接解决。
- **电压分工**：主控由 HAT 提供 5V，舵机接总线动力电源；新单口板本轮沿用已装接法，未做供电改动或核准其批次参数。已搁置 v0.3 的 AP2210 和旧 GD32 的降压前端分别属于对应历史板型，不能套给新板；禁止电池原压接 DATA、3V3 或 40P 的 5V。
- **针序与上电**：两口同网需在 V1.2 实物核验；原理图 pin 编号不能直接当照片上下位置。先台架分板验证，再单节点，最后在核准额定内分级负载测试，不做整机堵转。
- **主控对插**：断电、核方向、防错位；未核准防倒灌前不同时 USB/HAT 供电。
- **舵机保护先读回**：C001 厂商规格注明过流卸载出厂默认关闭，社区工具初始化默认亦关闭。用户实物 19/28/38 及模式需核验，不能假定堵转立即断电；见[风险核查](./docs/references/舵机堵转烧板风险/research.md)。
- **保护待核**：先确认电池 BMS 是否提供足以保护外部线束的短路/过流切断；足够时不需另加主保险，缺失/不明时再设计正极近端保险。存档 V1.0 F1 在数据线上，不是动力保险。软件扭矩开关/降低增益不能代替硬限流。
- **低电量阈值待校准**：6.6V 是历史参考停机值，不是电池天然最低值；独立电源板 VCC 闲置，其空载稳压拐点不能证明整机续航或载流合格。

## A / B 线遗留资产（保留，不适用当前采购）

- A 训练基线与验收：[docs/a-training.md](./docs/a-training.md)；B 线训练（旧机环境）：[docs/b-training.md](./docs/b-training.md)、[.goal/PROJECT_KNOWLEDGE.md](./.goal/PROJECT_KNOWLEDGE.md)
- 回退 A 线时的采购清单：[docs/bom-route-a-20260928.md](./docs/bom-route-a-20260928.md)
