parkourlrc/pcb-yilv1982--duck-robot-89dbc81d6d/docs/references/自主扩展板下单记录/ORDER-NOTES.txt

自主HAT A.1（源86654c03），单板65×30mm，目标数量5块成品，不是5个双联拼板。
四层FR4，标称1.6mm；层序F.Cu/In1.Cu/In2.Cu/B.Cu。设计基线JLC041611-7628，外35um/内30um；沉金、绿油、白字。
有0.15mm机械贯通孔；U701.7该via B面铜盘0.25mm、F/内层0.35mm，请勿按普通孔径替换。
6处/单元必须树脂填孔+电镀盖帽，位置及分层尺寸见via-process-requirements.csv。不得以普通盖油/塞油替代；若必须整板填孔请在工程稿/报价说明。
需求为双面标准SMT。提交的是单片资料，请工厂加上机工艺边/定位孔/Mark及必要拼板，确保总成品数量口径为5块；65×30不能直接作为无工艺边上机尺寸。
采用非V割的支撑切割分板，连接带避开走线/过孔/焊盘/器件，分板带需局部退铜。原r18双联仅可另行作工艺参考，不能据此把数量翻倍。工厂修改后须回传生产稿人工核对再确认生产。
BOM/CPL按每单片52个SMT件，5片共260件（备损另计）；C307不装、不印锡膏。
F/B Paste为实际推荐钢网：BMI08816窗面积81%，U301四窗约69.63%、U701四窗、U702十六窗；钢网名义0.125mm，不改为0.15mm。SMT工厂需核实际转移/曲线，不自动扩大开口。
工序：B面SMT先回流，F面后回流；支撑切断分板与毛刺检查后，6个THT逐点手工焊接。SMT报价需另说明是否承接THT手焊及费用，不能擅改整板波峰或通孔再流。
J301元件B面/焊接F面，其余5THT反向。MEMS BMI088禁整板干冰/超声清洗；SH连接器回流按实际材料/曲线核验。
本包用于用户授权的5片首轮打样下单与工程审核，不声明整机机械/功能/热性能已验收；保持手动确认、未授权自动扣款。
