parkourlrc/pcb-yilv1982--duck-robot-89dbc81d6d/docs/specs/20261028-custom-hat/bom-selection.md

# Rev A BOM 选型建议

> **2026-10-29 续接审计停用：下文整体为历史草案，不作现行制造、采购或上电指导。** 缺少新增音频/TTL/IMU 器件，U301 封装已确认错误，测试点数量过时；禁止作为采购或替代料批准依据。 现行见 [修复方案](recovery-plan.md) 和 [审计证据](../../references/扩展板电路仿真工具/audit-20261029/review.md)。

## 历史正文（已失效）

> LCSC 编号列留空：本轮尝试 LCSC 搜索接口（`wmsc.lcsc.com` 返回 404 / Access Denied，`lcsc.com` 搜索页为前端渲染，抓到的是导航而非商品），无法可靠取到编号与库存。**下单前请按本表型号在立创商城逐项搜索并回填 C 编号。**

## 关键器件

| 位号 | 型号 | 封装 | 关键参数 | 备注 |
|---|---|---|---|---|
| U301 | **AP64350SP-13**（Diodes） | SO-8EP | 3.8–40 V → 5 V，3.5 A，500 kHz | 需 2 oz 铜散热；SO-8EP 焊盘与 KiCad `PowerPAK_SO-8_Single` 需比对 |
| U501 | **BMI088**（Bosch） | LGA-16 4.5×3 mm | 6 轴 IMU，I²C/SPI | 封装为本项目自建，焊盘宽 0.30 mm |
| U701 | **TLV320AIC3104IRHBR**（TI） | VQFN-32 5×5 | 立体声 codec，I²S + I²C | 背面贴装；DVDD 1.8 V 由 U702 供 |
| U702 | **LP38693DT-1.8/NOPB**（TI） | TO-252-3 | 1.8 V / 500 mA LDO | 背面；输入 3.3 V |
| D301 | **SMBJ12A**（Littelfuse / Bourns） | SMB | 12 V 单向 TVS | 输入浪涌防护 |
| L301 | **744325550**（Würth） | 10.2×10.2 mm | 5.5 µH，10.3 mΩ，10 A | 或同参数 12×12 屏蔽电感 |

## 连接器

| 位号 | 型号 | 封装 | 备注 |
|---|---|---|---|
| J101 | 2×20 2.54 mm 排母（或 HAT 专用 SMD 连接器） | PinSocket_2x20 | 高度需与 Radxa 叠装匹配；pin1 已按参考工程定位 |
| J301 | 1×8 2.54 mm 排针 | PinHeader_1x08 | 电源入口，暂用排针 |
| J401 / J402 | **JST EH B3B-EH-A** | 1×3 2.5 mm | 飞特 TTL 总线 |
| J403 | 1×3 2.54 mm 排针 | PinHeader_1x03 | 主机 UART |
| J502 | **JST SH BM04B-SRSS-TB** | 1×4 1.0 mm | ToF 模块；背面贴装 |
| J802 | 1×2 2.54 mm 排针 | PinHeader_1x02 | IMU 中断测试 |
| TP801–TP806 | 贴片测试焊盘 1.5 mm | TestPoint_Pad_D1.5mm | 6 个电源/总线测试点 |

## 阻容

| 位号 | 值 | 封装 | 要求 |
|---|---|---|---|
| R301 | 52.3 kΩ | 0805 | 1%，反馈上分压 |
| R302 | 10 kΩ | 0805 | 1%，反馈下分压 |
| R303 | 200 kΩ | 0805 | 1%，RT 设定 500 kHz |
| R304 | 14 kΩ | 0805 | 1%，COMP |
| R305 | 100 kΩ | 0805 | EN 上拉 |
| C301 | 3.3 nF | 0805 | COMP，X7R |
| C302 | 100 nF | 0805 | BOOT-SW，X7R 50 V |
| C303 / C304 | 10 µF | 1206 | **50 V** X7R（2S 输入） |
| C305 / C306 | 22 µF | 1206 | 16 V X7R，输出 |
| C307 | 22 µF | 1206 | **DNP 不贴**（预留位） |
| C308 / C309 | 1 µF | 0805 | 16 V X7R，LDO 输入/输出 |

## 选型注意

1. **C303/C304 必须 50 V 及以上**：2S 满电 8.4 V，但输入有 TVS 钳位与插拔浪涌。
2. **L301 饱和电流 ≥ 5 A**：AP64350 峰值限流 5 A。
3. **U301 的 SO-8EP 焊盘**要用 Diodes 官方 land pattern 复核，不能直接套 KiCad 的 PowerPAK 封装。
4. **双面贴装**：U701、U702、J502、C308、C309 在背面，下单时要选双面 SMT。
5. 所有器件需确认**立创现货**；缺货时优先替换为同参数、同封装型号，并回写本表。
