parkourlrc/pcb-yilv1982--duck-robot-89dbc81d6d/docs/specs/20261028-custom-hat/order-checklist.md

# Rev A 制造前条件（2026-11-03 修订）

**当前尚未下单或放行生产。** 主源86654c03b6c1c8f51f7d5a4bef469aceed2ddfc73433b3e50426940c2a23164a，U301四窗69.63%项目方案。当前[内部审计](../../../hardware/custom_hat/rev_a/production-20261102-panel-edge-review/README.md)、[完整双联PCBA/单板格式包](../../../hardware/custom_hat/release-review/README.md)及r18同源；制造规格已有明确选择，未成为订单。全目标尚未完成包含制造后的实测，不代表首轮打样必须先有新板实测。

## 下单前的五项确认（2026-11-03分阶段澄清）

| 项目 | 提交/放行前需要明确的内容 | 负责确认 |
|---|---|---|
| 用途、范围与费用 | 首轮台架样板还是直接装机；成品HAT数量（当前每拼板含2块）；仅PCB或PCB+双面SMT，6件/板THT由谁手焊；总报价、备料/备损及交期 | 用户选用途/范围/数量与可接受报价，工程核数量和计费范围 |
| 固定制造版本与选项 | 使用86654c03/r18的20261103-assembly包；四层FR4/标称1.6mm、指定层叠、沉金/绿油/白字，85×82mm双联；0.15mm孔与6处/单元树脂填孔盖铜不能漏选或被普通盖油替代 | 对实际订单选项、特殊说明及生产稿逐项核对，不要求客服重复解释公开能力 |
| 装配实施方式 | 接受既定0.125mm钢网与分窗、C307 DNP；B面SMT→F面SMT→支撑切断分板→THT手焊；SH回流、第一面保持及密集区/手焊可达性由真实工艺承接 | 工厂工程落实，用户无需提供炉温专业参数；工艺不能承接或有改版建议时再处理受影响项 |
| 物料与贴装资料 | 精确35MPN的实际供料、缺料/替代料、管装/编带处理；BOM/CPL/元件面/方向与当前源一致；任何替代不能只按封装相同批准 | 工程对可供料清单与贴装确认稿核验，用户确认追加费用或功能取舍 |
| 机械目标与首板边界 | 若直接装机，核对实际主控、排针/排母、板间距、头壳与线束；若首轮仅台架验证，可将头壳适配明确留后续，不把11.6～13.33mm名义范围当已实装 | 用户确定本批用途；工程完成相应配接核对，并注明供电/完整功能未验收 |

阶段区分：用户决定用途/范围/数量后可准备提交资料和询价；供应商生成实际工程稿、贴装确认稿或给出工艺偏差后，在同意生产前检查这些文件。并不要求尚未生成的生产稿在第一次上传前已经存在。具体付款/审核先后按实际服务流程，不在本清单虚构。

**无需在首次制板前完成的项目**：新板音频/I2S/TTL/IMU/ToF、实际温升/焊点/分板质量、来料开封记录和成品检查。它们各自在备料/加工/收板后执行。台架限流值、实际5V判据与插接极性必须在首次上电前落实；不能把它们误写成已有实物测量是首次制板条件。首轮样板仍存在功能/工艺失败后再改板的可能，不等量产或整机验收。

本次网页工具未返回可核验正文或检索结果，不宣称新取得官网确认，也不猜测超时/反爬原因；制造参数沿用当日已归档官方资料及本地制造规格，来源见[当日来源复核](../../references/扩展板邮票孔与电源修复/sources-recheck-20261103/manifest.json)。既有公开能力支持不等于本包已经获接单或组合报价。以上是清单澄清，不是下单、付款、外发或上电授权。

## 已完成的文件检查

**[用户确认，2026-10-31] 尚未送厂、没有新板实物。** 当前[CAM包入口](../../../hardware/custom_hat/release-review/README.md)为本地评审资料，尚未发送。

- U701.7与R308.2连通；原微孔已改为原尺寸机械贯通孔，100个via均贯通。原焊盘/连接保持。
- 58/58拟装件有MPN，38分组、35唯一MPN；52 SMT、6 THT，C307 DNP。库/封装、字段、坐标与BOM已核对，不能把MPN完整升级为库存或替代料批准。
- 双面各3个fiducial已采用；U301有5个热孔，C305/C309盘中孔已移开，I2C5有4.7kΩ上拉。codec可控RESET新增Pin33，原R308/C310 RC保持。
- 完整工程有效DRU加载后，DRC/未连接/parity/ERC/netlist全0；I2S原参考铜取样保持。kicad-happy的误报/风险已分类，不用自动计数代替判定。
- 同版Gerber、独立PTH/NPTH钻孔、BOM、坐标、DNP/通孔清单和双面装配图已生成；163圆孔逐项匹配，manifest绑定源和输出。默认未知层叠Job已隔离。
- 6件THT均有5mm内反面贴片件，已选双面SMT及支撑切断分板后逐点手工焊接，排除整板波峰焊和通孔再流焊；当前PCBA包以20261103-assembly后缀为准。烙铁头/温度时间/夹具和实际焊点仍待工艺接受。
- J502针号为GND/3V3/SDA/SCL；C307无Paste、U301分窗及U701/U702中央窗口已定。当前[装配依据](../../references/扩展板邮票孔与电源修复/assembly-process-basis.md)、[制造选择](../../references/扩展板邮票孔与电源修复/manufacturing-spec.md)和[22项状态](../../references/扩展板邮票孔与电源修复/requirements-status.md)替代旧全量人工问卷；没有外发或接单事实。

## 制造与使用各阶段的验收条件

| 条件 | 需要的实际依据 | 当前不能代替它的材料 |
|---|---|---|
| 制造工艺 | 已定本地设计选项：FR4四层/1.6mm、JLC041611-7628、沉金/绿油/白字、6POFV树脂盖铜；U701.7逐层尺寸保持 | 同意生产前核实际工程稿/选项；加工后做成品检查，不能倒置为下单前已有收板检验；费用未承诺 |
| 装配方案 | r18完整PCBA资料，U301四窗/U701四窗/U702十六窗/BMI08881%；0.125mm基线筛查通过，6THT后焊 | 实际锡膏/profile/转移/空洞/保持及SH应用评估未执行；真实机械/线束条件未完成 |
| 供电使用边界 | 配对座/线束、输入保护、并发负载及5V入口窗口，保持单源供电 | 官方结构外35/内30µm基线与铜段计算均不是整板额定 |
| 功能可实现性 | 设计/离线适配依据已形成；实际主控内核/DT、I2S3、Pin33时序、BMI088及外接I2C条件在首板接入前核对 | 首轮样板可用于验证这些功能；不能把未做的实机验证写成量产通过，也不要求制造前已有新板功能数据 |
| 最短首板验收单 | [A.1草案已补](first-article-a1.md)，制造后按实装条件填写电源、限流及5V判定范围后执行；本身不要求制板前已有实测 | 旧固定100/300mA、通用4.75V阈值、UART回环及直接全舵机动作流程已停用 |

首板功能在制造后验证，不要求制板前已有实测。65×30mm四层，JLC041611-7628设计基线外35/内30µm、官网成品1.57mm±10%；未成为实际订单或成品测量。Dk/Df未知，默认Gerber Job不作官方层叠。

提交工厂/下单前重新核对主工程与生产包指纹。发生换料、工艺或布局变更时，只重做受影响的审查并重导同版包。旧[首板测试草案](first-article-test.md)仍停用，当前为[A.1首板草案](first-article-a1.md)；本清单不是接线、上电、上传、付款或订单授权。
