parkourlrc/pcb-yilv1982--duck-robot-89dbc81d6d/docs/references/hat-jlc-self-check-20261102/sources/before-order.txt

PCB下单前技术员必看 | 嘉立创帮助文档
嘉立创一站式制造业务官网
在线计价
工艺参数
服务指引
联系我们
帮助文档
电子产业
PCB
下单指引
PCB打样常见问题
PCB打样指导
PCB打样
PCB打样指导
技术指导:下单前技术员必看
技术指导:下单前技术员必看
创建时间：2019-05-30 21:19
更新时间：2026-10-20 15:26
2382641
0
文档错误过时,
我要反馈
感谢您选择嘉立创！
为了让设计与制造融合一致，请您及您的工程师
查阅此技术说明
，了解我司的相关制程与技术规范。
【重要提醒】
★ 重要的事情说一万次：大家批量一定要记住返单（支持返单拼板、更改板厚、油墨颜色，表面喷锡/沉金工艺等）
点击查看详情
★ 第一次制作的样品（小批量）请确认功能正常后再返单，因工程资料导致的错误，只接受投诉第一个（批）订单
★ 原文件尽量发Gerber文件，提供PCB原文件出现软件不兼容的问题，嘉立创与客户各承担50%的pcb本订单货款责任
【服务支持】
① 下单主界面顶部导航栏“技术咨询”中点进新页面输入"关键词"查看以往技术回复，也可以点“我要提问”输入相关技术问题点
……
② PCB技术支持QQ：3001741855 （钢网与SMT的问题请按下面第③点询问您的专属客服专员）
③ 订单服务支持：点击嘉立创官网（
https://www.jlc.com/
）主界面上方“服务指引”－“人工服务”，联系您的专属人工客服
【设计特别提醒： 技术重点中的重点】
1）特别《重要》终极标准：AD等软件外形层及非金属化孔及槽的标准及规范
点击查看详情
2）提供PADS文件下单的，我们只采用HATCH（填充）恢复铺铜，泪滴以实际文件输出为准，请下单前仔细检查好以避免短路或少铜面
点击查看详情
3）最小金属化槽孔0.5mm，最小非金属化槽宽为1.0mm，如果您设计的槽孔小于最小值则会直接加大处理
4）金属化槽的槽长要大于槽宽的两倍，槽长与槽宽一定要设计正确（请勿弄反，
点此查看详情
）
5）我司采用干膜封孔制作，非金属孔周围会掏空0.2MM的焊盘或铜面，建议无铜孔加大焊盘以便焊接，否则焊盘就是一个线圈
6）阻焊开窗层以Solder层为准，Paste用于制作钢网层不用于做PCB（我司工程文件也不包含Paste资料）
..
一、嘉立创制程工艺
..
1、制作工艺参数
点击查看制作工艺参数详情
333
■
目前可以制作
1-64层
的FR4板；
4-32层
的
HDI
板；单面
铝基板
和单/双面热电分离
铜基板
）；双面
高频板
（Rogers和铁氟龙材料）；
1-4层
的
FPC
板
■
暂不制作纸基板、印蓝胶\碳油、裸铜等系统无选项的特殊工艺（
FPC暂不支持OSP
）
2、材料与设备
■
我们采用中国台湾南亚/建滔KB/生益等厂商标准8张布A级带水印板料(铜箔为99.9%以上的电解铜)
点击查看6张布板料危害
■
原材料核心供应商包含云南锡业，南方特铜，长春干膜等，相关材料参数可以在系统中"公共资料"查看
■
生产设备采用国内外知名厂商，大多数为自动化设备，特设直播车间供客户监工
点击查看详情
..
二、客户下单文件类型
..
1、 PCB文件
（支持Protel&AD系列软件和PADS软件），为避免软件不兼容请尽量提供Gerber文件并下单确认生产稿检查!
■
Protel转Gerber方法请
点我
■
AD转Gerber方法请
点我
■
PADS转Gerber方法请
点我
■
Allegro转Gerber方法请
点我
推荐使用国产免费软件“嘉立创EDA”设计，设计方面EDA客服全程服务指导！
2、 Gerber文件
（只接受RS-274-X格式，不支持Gerber X2 Files及RS-274-D格式）
■
常规输出双面板各层如下：
■
常规输出四层板内层如下（六层板比四层板多2个内层）：
..
三、制程工艺要求
..
1、孔径要求
■
常规插件孔(Pad)公差+0.13mm/-0.08mm（孔径严格的可以采用压接孔，公差±0.05mm，仅限多层沉金板圆形孔）
■
过孔(Via)依资料适当调整，不具体管控公差，插件孔请考虑负公差，设计时与过孔勿混用
点击查看说明
■
金属化槽孔（孔壁有铜槽孔）采用钻孔方式加工，常规公差：+0.13mm/-0.08mm
■
非金属化槽孔（孔壁无铜槽孔）采用锣孔方式加工，常规公差：±0.2mm
■
除过孔外的插件孔，孔壁有铜或无铜，最小孔做0.5mm
（少于这个值可能会喷锡堵孔或油墨堵孔，若有更小插件孔请备注好并做沉金）
■
不能制作绝对直角的有铜槽孔，常规正方形孔默认按方孔宽度为直径做成圆孔，需要做成近似直角孔需做包边工艺并备注好
点击查看详情
■
不能制作绝对直角的无铜槽孔，因为锣刀是圆的，直角处锣出来有圆弧度（可添加角孔减少圆弧度）
点击查看详情
■
半孔最小孔径0.5mm（半孔焊盘边到板边≧1MM），半孔板长宽需要大于10MM
点击查看半孔板相关说明
■
过孔孔边与孔边最小间隙0.2mm（插件孔0.45mm），避免因孔间距离过近，钻孔时断钻头和塞孔导致的孔内无铜现象
2、线路制作
■
我司采用干膜工艺，所有无铜孔需要掏空孔外围0.2mm的焊盘（纯单面板工艺不会掏空）
点击查看图例说明
■
插件孔焊盘：建议焊环0.25mm（极限0.18mm）。过小的焊环易破孔，对于要求保证焊盘间隙且允许破孔的，请下单时说明清楚并确认生产稿查看
■
最小BGA焊盘大小：0.25mm
点击查看BGA设计说明
■
线圈板：
线宽线距要求0.254mm（极限0.15mm：仅限线路盖油）。线圈被油墨盖住的，可以做喷锡或沉金工艺。线圈露铜的，只能做沉金工艺
点击查看图例说明
■
为增加电镀均匀及多层板层压填胶均匀性，
我们将对所有多层板的工艺边、空白位及板间大空白位增加铜面
，此操作不会影响原单元板的铺铜布局
点击查看详细说明
■
制作线路采用干膜工艺，为避免干膜碎导致开路的隐患，铺铜尽量铺成实心铜皮。一定要网格铜面的，网格线宽/间距应在0.25mm以上，同网络的两条线夹角间距应在0.25mm以上
■
内层过孔边到线路铜面/导线间隙0.2mm以上（插件孔边到线边0.3mm以上），热焊盘（梅花焊盘）焊盘比钻孔大0.5mm，注意热焊盘不要重叠以免开短路
点击查看图例说明
■
只有一面线路的板叫单面板
（系统下单1层 )：
点击查看单面板相关说明
单面板只能做一面线路，一面阻焊，可以做一面或两面字符。
重点留意：
对于提供文件两面只有焊盘的单面板，默认以顶层焊盘制作（忽略底层焊盘），有线路的依线路面制作。
样品单面板依如下处理方式：
（1）板厚1.0mm 、1.2mm 、1.6mm：成品效果为纯单面板（
单面焊盘，单面油墨
），孔内无铜；
（2）板厚0.4mm 、0.6mm 、0.8mm 、2.0mm：默认拼双面编号，成品效果为孔内有铜；
■
内槽离焊盘/导线的最小距离不得小于0.2mm
■
CNC (锣边)板框线的中心线距离导线的边线或铜皮（焊盘边）的距离不小于0.2mm
■
V-CUT(V割)板框线的中心线距离导线的边线或铜皮（焊盘边）的距离不小于0.4mm（默认双面V割，不做单面V割）
3、阻焊制作
点击查看阻焊设计说明
■
阻焊开窗以Solder层为准，有图案的地方表示不盖油墨（并不代表露铜区），
同一面线路与阻焊重合的地方才会露铜上锡/沉金
■
工厂
自 2025 年 6 月起全面应用 LDI 对位技术，实现高精度对位。新订单可实现阻焊开窗与焊盘等大（1:1）设计，返单仍沿用原生产稿资料
点此查看详情
■
阻焊桥依层次、油墨类型及文件设计制作（开窗的过孔/插件孔焊盘若做阻焊桥，需优先保证焊环足够且符合表格数据才能做出来，
否则不接受投诉
，详见
阻焊设计规范
）
■
过孔焊盘支持过孔开窗，过孔盖油、过孔塞油墨，过孔塞树脂，过孔塞铜浆多种处理方式，过孔孔径尽量小于0.5mm方便塞孔
点击查看详情
■
以下几类情况不能做塞油工艺，可以采用树脂或铜浆塞孔：
11
1）双面开窗的过孔不能做塞油工艺
11
2）
双面板单面开窗，且过孔直径<0.4mm的孔只能做半塞油(可能透光)
11
3
）孔一部分在开窗焊盘上，做半塞油(可能透光)，视具体文件定
4、字符制作
点击查看字符设计说明
■
丝印字符(Silkscreen) 字符线宽与字符高度需协调匀称，字符间保持适当间隙，字符宜采用线性字宽，勿用填充字宽
常规字体：字符线宽
≧
0.15mm，字符高度≧1mm（选择高精字符的支持最小字符线宽0.1mm，最小字符高度0.8mm）
镂空字体：字符线宽≧0.2mm，字符高度≧1.5mm
■
字符不允许上焊盘，字符距离焊盘需不小于0.15mm，字符间隙大于0.15mm，少于此距离的会掏空字符以避免字符上焊盘
【特别说明】
① 对于不符合上述表格数据的请自行调整好，我们仅对常规字体字粗不够0.1mm的加宽到0.1mm，字符在开窗焊盘上的掏掉，其它地方不会特别处理，对于调整后出现超出生产能力而导致字符模糊不清晰或因字符残缺的，不接受此类投诉。
② 为便于分辨，我们默认会在板中丝印层适当位置添加客编，客户在下单时也可以选择指定位置添加客编（或二维码）
点击查看详情
③ 为提供更高价值的服务，我们已开通二维码服务（大小每片板上做上唯一序号的二维码，支持客户定制内容）
点击查看详情
④ 对于类似工艺品超高清晰要求的字符，不能满足要求，字符以IPC二级标准制作验收
5、外形加工
■
目前能加工的最小单板尺寸：3*3MM
■
需要锣出的槽孔/V割标示要放在板子唯一外形层且能有效输出Gerber才能制作出来
点击查看详情
■
外形层需要依软件规则正确放置（不能放在线路阻焊字符等不相关层），槽孔外形不要重叠交叉设计以免引起歧义
点击查看详情
■
AD17以上版本请把槽孔跟外形画在机械一层，画在Keepout层低版本会自动锁住导致不能输出从而漏槽孔
点击查看详情
■
AD软件中Board cutout只做3D参照图，不能转出Gerber元素来加工槽孔，请在Keepout层或者机械1层画出相关形状
点击查看详情
■
有铜槽孔采用先钻孔再沉铜方式，锣出来的槽孔孔壁都是无铜的（需要锣完再沉铜的异形槽孔请选择包边工艺），对于十字交叉异形有铜槽孔请优化设计
点击查看详情
■
为了提高生产效率建议拼板生产，我们支持"按客户资料拼板（可提供
参照图
或
参照文件
）"、"常规微割顺拼"、"非常规人工拼板" 和"AI拼板"
点击查看详情
■
邮票孔拼板：采用直径0.6mm的无铜孔把各种形状板拼出相连（注意：分板后有齿状毛边）
点击查看详情
■
V割（V-CUT）拼板：采用V割刀片把分板位置上下各切削一定深度的V形凹槽便于后续掰开（注意：分板后有丝状纤维丝）
点击查看详情
■
斜边工艺：
主要用于金手指板，把金手指所在边的板边用机器削成梯形，以便金手指板插入卡槽内（比如应用在电脑中的显卡）
点击详见详情
A： 金手指斜边线平齐的其它区域不能有线路、焊盘或铜面等，避免斜边时露铜伤线。多层板金手指位置内层不留铜箔，避免斜边后铜皮外露导致短路
B：
单板交货的金手指边最小长度≧50MM才能斜边
（单板长度不够的可以拼板加宽）
注意：
金手指处一定要开通窗（对于没有开通窗的，嘉立创默认开通窗处理），以避免有油墨，会影响平整性，以及多次插拔磨擦后油墨脱落掉入卡槽内引起连通不良问题。
■
拼板款数：指文件中不同款板的个数，包括且不限于外形线路阻焊字符不一致等，只要有任何不同的都算不同款板，请下单时正确填写好。
重点说明：如果只有细微差别(指的是几个过孔，几根线路或是字符标识等不一样，其它的外形及图案都是一样）的板子拼在一起，下单没有真实的填写拼版款数，最终导致只做了一种板，嘉立创不承担责任!
..
四、设计错误案例
..
■
案例1：
有铜孔设计为无铜孔，导致孔壁无铜两面不导通
■
案例2：
插件孔设计为过孔，导致焊盘盖油不能焊接
■
案例3：
AD/Protel系列软件中槽孔勾选了Keepout（中文版本显示"使在外"），导致漏槽孔（
注意：AD17以上版本没有此选项，请把槽孔和外形都画在机械一层
）
■
案例4：
AD/Protel系列软件槽孔跟外形不在同一层，导致漏槽孔
■
案例5：
AD/Protel系列软件中设计多个外形层，导致漏槽孔（机械层和禁止布线层都有外形，我司优先采用顺序：机械1层>机械2层>…>机械N层>禁止布线层）
注意：AD23高版本新功能有GM层，但低版本打开没有GM层，为保证一致性，不论PCB还是GERBER，我们会忽略GM层，仍按之前规定以机械层或禁止布线层做外形
■
案例6：
AD/Protel系列软件中采用虚拟Board cutout做的槽孔在3D中可以显示出来，实际做不出来的，请优先采用轮廓线或实际粗细线画出来（我司能锣的最小槽宽为1MM）
■
案例7：
外形层的大小圈不同尺寸的槽孔，导致孔径问题（我司优先采用小圈钻孔，避免钻大孔无法返工）
■
案例8：
孔外形设计不规范出现歧义，导致判断不准外形加工问题，请规范设计外形及槽孔
■
案例9：
PADS软件设计覆铜后，因线路调整没有保存好覆铜，导致填充后短路。
Flood命令（重新灌注覆铜）是由设计者执行的，电路板厂仅执行Hatch命令（填充显示覆铜），以避免修改设计者的设计覆铜。因此在设计好后，设计师一定要关掉软件然后再重新打开，采用填充Hatch对覆铜检查好再下单。
■
案例10：
PADS软件中，2D Line是二维线，通常做辅助线。个别客户用此画线路，导致生产漏线路。这种设计思路违背PADS软件设计理念，还是按照Protel软件的设计习惯，PADS软件布线有专门的走线命令（快捷键F2或Route命令）。另外，不需要开槽的2D线千万不要画在top或bottom的线路层，以免输出分孔图开出槽孔。
■
案例11：
阻焊设计错误导致漏露铜上锡。
如果需要某根走线开窗不盖绿油并喷上锡必须另外再添加Solder层，Paste只是钢网层，用于制作钢网，与生产板子没有关系。(线路层有图案的地方做出来就是铜面，阻焊层有图案的地方做出来不盖油，线路层与阻焊层重合的地方才会做出露铜上锡效果的)
AD/Protel系列软件中Multilayer层是复合层，通常用于通孔焊盘（Pad）和过孔（Via）的层设置。在Multilayer层设计图案，只有PAD属性的才会在阻焊层产生开窗，其它的Trace、Fill、Arc属性的设计的只是线路层有图案，而不会是焊盘开窗不盖绿油的效果（这种设计属于个别案例，应避免这种走线设计）。
■
案例12：
PCB设计软件中，默认的Bottom层文字是反的（镜像的），千万不能为了自己看起来方便，而人为将文字显示为正字，否则生产出来的板子Bottom层文字会是反的。
互动评论
0
注意：此留言仅作为嘉立创与客户日常交流之用，回复不是很及时，急切问题请联系我司工作人员处理！
登录
或
注册
后才可以留言哦！
用户热搜
设计优化：钻孔制作案例分析及解决方法
线圈板的设计与表面工艺
技术指导:AD软件内嵌拼板
技术指导:Altium Designer输出Gerber文件步骤
技术指导:PADS输出Gerber文件步骤
设计优化:CAM350另存文件投单不要给审核及CAM工程挖坑
技术指导::AD17及以上版本的 Keep-Out和Mechanical 1正确用法!
设计优化:洞洞板宜做沉金不宜做喷锡
技术指导:AD中画Board cutout不能开槽
设计优化:工艺边上加定位孔制作标准
PCB帮助文档
SMT帮助文档
钢网帮助文档
PCB讨论
SMT讨论
钢网讨论
嘉立创拼版技巧大揭秘
如何查询PCB生产进度及生产基地[PCB生产进度?
嘉立创 PADS 不同文件拼版教程
设计优化:狭窄板边中间钻孔易断裂
设计优化:L异形板倒扣拼板
AD关闭干扰字符步骤
设计优化:厚铜板线宽线隙优化
技术指导:如何制作流锡槽焊盘
在没有付款前如何替换PCB文件,而不需要重新下单?
设计优化:工艺边上加定位孔制作标准
计价下单
PCB下单
SMT下单
钢网下单
FPC下单
服务支持
工艺能力
工厂直播
领券中心
金豆商城
关于我们
企业动态
视频中心
联系我们
加入我们
帮助中心
服务指引
帮助文档
阻抗计算
下单助手
联系我们
服务热线：150-7448-1235
服务时间：周一至周六 9:00-18:00
联系地址：中国·深圳
深圳市福田区莲花街道景华社区商报路2号奥林匹克大厦27层
抖音号
微信公众号
电子产业
嘉立创PCB
嘉立创优选
嘉立创SMT
嘉立创FPC
嘉立创钢网
嘉立创发热片
纸盒包装定制
立创商城
ZXHPCB
机械产业
嘉立创FA
嘉立创3D
嘉立创CNC
嘉立创钣金
MRO商城
铝合金壳体
面板定制
手板复模
工业软件
嘉立创EDA
嘉立创Ican
嘉立创CAM
嘉立创DFM
3D模型查看器
嘉立创云ERP
嘉立创ECAD
嘉立创云CAD
其他服务
嘉立创社区
硬创社
开源硬件平台
嘉立创Layout
第三方服务
Forface 3D
开放平台
关于嘉立创
集团介绍
丨
CEO邮箱
投资者关系联络方式
IR电话 0755-83456516
IR邮箱securities@sz-jlc.com
媒体沟通：pr@jlc.com
© 2026 深圳嘉立创科技集团股份有限公司 - 版权所有
粤ICP备11084592号
粤公网安备 44030402003736号
增值电信业务经营许可证粤B2-20201198
ISO/IEC
营业执照
|
隐私政策
用户协议
站点地图
