parkourlrc/pcb-yilv1982--duck-robot-89dbc81d6d/docs/references/hat-jlc-self-check-20261102/sources/order-operator.txt

下单员必看：下单注意事项汇总 | 嘉立创帮助文档
嘉立创一站式制造业务官网
在线计价
工艺参数
服务指引
联系我们
帮助文档
电子产业
PCB
下单指引
PCB打样常见问题
PCB打样指导
PCB打样
PCB打样指导
下单员必看事项
下单员必看事项
创建时间：2019-05-30 21:19
更新时间：2026-09-15 16:08
1938356
0
文档错误过时,
我要反馈
一：市场部上班时间安排（工厂是24小时上班，周日不休息）
a. 周一至周六：上午9：00一一12：00  下午1：30一一6：00
b.法定节假日上班时间另行通告
二：安排订单时间(订单越早确认越好，因为能更好的保证您的出货时间）:
【样板】
a.双面板12小时加急以及4层板24小时加急，需要在工作日当天18：00前确认支付订单；
b.其它交期订单，上午9:00--下午19:30 前完成确认支付将被安排。
【小批量】
小批量订单，上午9:00--下午19:30 前下的订单，下午19:30 前完成支付的订单都将安排生产
（含普通交期 与 加急交期）
周日不安排订单生产，法定节假日订单安排另行通告。
三：有任何事项，都可以点击您系统左上角的 【专属客服】，里面有您的业务专员的微信及电话，以便联系！
四：下单成功后，在上班时间内，我方将第一时间对您的订单进行审核，审核时间大约为10-60分钟左右，审核好后请第一时间进行确认，因为越早确认，越能尽快安排生产，对您的交期越有保障,也强烈建议安装下单助手,这样能实时收到审核好的信息及发货信息！
五：12小时加急指的是当天下午6点前付款，第二天中午发货（周日除外） ，
24小时加急及48小时加急的定义：24小时指的在正常安排订单日，截止接单前支付的，今天下单明天晚上发货，而非从确认下单（支付）时间就开始计算24小时发货，48、72小时也是如此定义；
六：如是初次合作，下单前，您如果是工程师，请一定要看 【下单前技术员必看】，如果您不是工程师，请把工程师注意事项转发给工程师；
七：取消订单的相关事项：如果您发现您的文件有问题，但订单已经付过款了，需要先核实订单状态，如订单没有安排生产（也就是在wip进度查询没有进度）则可以自行在您的前台点取消或通知我司业务专员取消，但会扣除10元的工程资料费用，如果在wip进度查询有进度，则无法取消订单。如果没上线可以取消的订单，1）您可以直接要求退款； 2）可以要求替换文件，替换文件的时候请注意，在下新单的过程中，有一个下单备注注明是替换文件的，我方会直接帮您审核，进行安排！
八：同一款板（特价范围内的）有意分多次拆单下单，嘉立创有权不接受订单或退单处理！
九：（省外快递寄付相关问题）嘉立创快递费寄付服务，多不退少不补！
十：（省外快递寄付相关问题）同一天有确认多个订单，又要一起发货，请务必选择绑定一起发货 [包邮订单和不包邮订单一起绑定无效]，否则可能会有多收快递费的情况，如果多收，则是不会退还快递费的操作！因我司有多个生产基地，有可能导致同时确认的订单不能绑定在一起发货，敬请注意！
嘉立创集团
最后一次更新 2021年12月11号
互动评论
0
注意：此留言仅作为嘉立创与客户日常交流之用，回复不是很及时，急切问题请联系我司工作人员处理！
登录
或
注册
后才可以留言哦！
用户热搜
FPC下单指引
轻松管理多账号，快捷切换账号使用
3D打印下单流程
钢网下单流程
SMT下单指引
PCB如何返单?
下单员必看事项
PCB帮助文档
SMT帮助文档
钢网帮助文档
PCB讨论
SMT讨论
钢网讨论
设计优化:窄连接边易锣板变形断裂
按标准合同常规处理
技术指导:AD如何设计空心字体
PCB售后处理
BGA封装做喷锡工艺带来的风险及解决方法
技术指导:BGA设计规则
如何查询PCB生产进度及生产基地[PCB生产进度?
常见的EDA专用券使用常见问题
制程工艺:PCB板沉金板和镀金板有什么区别?
技术指导:PROTEL,AD和PADS无铜槽孔设计
计价下单
PCB下单
SMT下单
钢网下单
FPC下单
服务支持
工艺能力
工厂直播
领券中心
金豆商城
关于我们
企业动态
视频中心
联系我们
加入我们
帮助中心
服务指引
帮助文档
阻抗计算
下单助手
联系我们
服务热线：150-7448-1235
服务时间：周一至周六 9:00-18:00
联系地址：中国·深圳
深圳市福田区莲花街道景华社区商报路2号奥林匹克大厦27层
抖音号
微信公众号
电子产业
嘉立创PCB
嘉立创优选
嘉立创SMT
嘉立创FPC
嘉立创钢网
嘉立创发热片
纸盒包装定制
立创商城
ZXHPCB
机械产业
嘉立创FA
嘉立创3D
嘉立创CNC
嘉立创钣金
MRO商城
铝合金壳体
面板定制
手板复模
工业软件
嘉立创EDA
嘉立创Ican
嘉立创CAM
嘉立创DFM
3D模型查看器
嘉立创云ERP
嘉立创ECAD
嘉立创云CAD
其他服务
嘉立创社区
硬创社
开源硬件平台
嘉立创Layout
第三方服务
Forface 3D
开放平台
关于嘉立创
集团介绍
丨
CEO邮箱
投资者关系联络方式
IR电话 0755-83456516
IR邮箱securities@sz-jlc.com
媒体沟通：pr@jlc.com
© 2026 深圳嘉立创科技集团股份有限公司 - 版权所有
粤ICP备11084592号
粤公网安备 44030402003736号
增值电信业务经营许可证粤B2-20201198
ISO/IEC
营业执照
|
隐私政策
用户协议
站点地图
