parkourlrc/pcb-yilv1982--duck-robot-89dbc81d6d/docs/references/扩展板电路仿真工具/final-bom-20261031/research.md

# HAT 全量设计料号与电源器件封装修复（2026-10-31，历史检查点）

> 历史检查点：此后C303～C306、C308/C309已换料，新增R703，当前为55个拟装件；热孔、回流和电流路径也已更新。本页54/54、旧电容料号及源哈希仅描述当时版本，不能作为当前BOM。现行从[问题矩阵](../issue-matrix-20261030.md)进入；原厂来源与未被替换的器件依据继续用于追溯。

## Overview

继续用户“解决所有已知问题”的授权，主会话执行，未用子代理。**[文件/工具核对] 54个拟装器件已全部录入有厂商资料依据的设计MPN，38/38有效BOM分组有料号。** C307仍DNP，3个裸铜测点不采购。BOM字段完整不等于电气、热、制造或采购全部放行。

现行PCB SHA256：335aea311c179be20bfd9f6531bdad8687ba58be211df88c81e49cd5f35471ca。68封装、968线段、97过孔（96通孔+1微孔）、4铜区。原生DRC普通违规、未连接、parity、ERC、netlist mismatch全部0；原工程设置/规则未放宽，原有焊盘连接保留。**整板仍不可投板。**

## Previous Review Delta

| 项目 | 上阶段 | 本阶段 |
|---|---|---|
| 设计MPN | 46/54，8件未选 | 54/54；采购及适用性仍按各自条件验收 |
| L301 | 无厂商料号，5.5µH、通用12×12封装 | IHLP4040DZER5R6M5A，5.6µH±20%，按厂商≥2.2µH版本焊盘 |
| R309 | 通用1206零欧元件，额定未知 | WSL120600000ZEA9铜跳线，匹配原厂推荐焊盘 |
| 6个JST座 | 未录MPN | EH/SH完整料号已填，原焊盘与针序不变 |
| 布线 | 原连接全齐 | 为新电感避让3个via并重接音频支线，原连接仍全齐 |
| 自动缺MPN告警 | SS-002 | 消失；不据此宣称设计完成 |

## Critical Findings

1. **载流预算尚未核准。** EH的3A有AWG22等条件；J301电池入口承载逻辑和舵机之和，Samtec配对条件的接点额定不能当整板额定。须完成接插件/线束/铜箔与正常负载预算，不能用电感/跳线的大电流宣传值放行全板。
2. **电源电容有效参数/稳定性未完成。** 仍需选定MLCC的DC bias、温度、老化、ESR数据与AP64350/LP38691要求逐项核对；自动理想SPICE不替代。
3. **热/回流与HDI未完成。** AP64350真实耗散/热布局、I2S参考层回流、U701.7微孔层叠/介质/填孔待核；96个通孔环宽已修，不再列旧23孔问题。
4. **实际装配/功能尚未测试。** H1/H2排母侧≤4.5mm M2.5圆柱头、无垫圈/六角隔离柱为设计约束；螺钉长度/另一侧堆叠未实核。首板尚未制造。

## Component Summary

| 位号 | 设计MPN | 厂商与直接依据 |
|---|---|---|
| J401/J402 | B3B-EH-A(LF)(SN) | JST官方120E目录PDF p35–36，EH 3P、2.5mm顶插 |
| J502 | BM04B-SRSS-TB(LF)(SN) | JST SH原厂PDF p1–2，4P顶插 |
| J504 | BM03B-SRSS-TB(LF)(SN) | 同上，3P顶插 |
| J505/J506 | BM02B-SRSS-TB(LF)(SN) | 同上，2P顶插，分别麦克风/扬声器 |
| L301 | IHLP4040DZER5R6M5A | Vishay 34315，02-Oct-2026，p1电气、p2订货/尺寸、p4曲线 |
| R309 | WSL120600000ZEA9 | Vishay 30192，24-Aug-2026，p1电气/订货、p2尺寸 |

L301标称由5.5→5.6µH（+1.8%），引脚网络不变；旧5.5µH并无已锁定实装物料。选型采用可取得完整电气与焊盘资料的5A系列；同厂DZ-11表里没有5.6µH，未凭相近名称造料号。ER是该系列允许的500件卷盘代码，不代表本项目会购买整盘。

此前7个IC、11个电阻、23个电容、1个TVS和4个Samtec座的来源沿用相应专题，不把料号字段完整升级为库存或生命周期确认。

## Power Tree

2S入口→AP64350→5V；Radxa 3.3V→LP38691→1.8V codec。R309仍是VBATT_2S_IN到SERVO_VBAT的零欧桥，未改变供电分支或现有机器接线。新板的保护、线束和整板负载条件仍需核定。

## Analyzer Verification

geometry-connectivity-check.json：仅L301和R309的4个焊盘位置/尺寸/形状按计划变化，其他焊盘未变；3个via及其6条相关短线列入允许变更，音频支线新增36段，全部原焊盘连接保留，赋网无变化。2个专用footprint已存入duck.pretty；库比较、parity没有豁免。

候选在完整项目中填铜并保存后核连接；回写后再次prepare/check通过，见post-promotion-summary.json。promotion.json记录前后哈希与备份。原生F/B SVG/PNG已打开检查，底面未镜像。

## Pinout / Footprint Verification

- EH推荐孔为0.9mm及允许正偏差，当前0.95mm；2.5mm针距、三针5mm跨度与原厂图对应。原厂p35视图是**焊接面**，不能和板顶/插合面直接等同。保留本项目1=GND、2=VBAT、3=DATA的接口契约，实物线束仍逐针对应。
- SH按原厂**安装面**焊盘图：信号宽0.6mm、1mm针距，信号长度4.2−2.65=1.55mm；固定焊盘1.2×1.8mm。与现有KiCad铜几何一致；1.8mm是固定焊盘尺寸，不误读为信号焊盘长度。B.Cu翻转视角单独记录。
- L301按34315 p2的“2.2µH及以上”图：铜盘3.124×3.251mm、内间隙5.817mm、中心距8.941mm；不能套≤1.5µH的大端子图。实体10.16mm见方，端子跨距10.795±0.3mm，高度≤4mm。
- R309按30192 p2：铜盘1.57×1.78mm、内间隙0.76mm；保留零欧功能。旧通用1206焊盘不足以直接宣称已按厂家焊盘匹配，因此实际改铜，而非只填MPN。
- L301/R309旧通用3D模型未沿用作准确实体证据，移除不匹配模型；尺寸表/二维封装为本轮依据，三维整机装配仍待核。

## PCB Layout Analysis

新电感铜盘首先与AUDIO_MIC、AUDIO_LINE_L、+3V3三个旧via冲突，未回写失败候选。随后移至(135.1947,113.7772)、(136.9546,115.0494)、(140.39,116.49)；孔型/孔径/环宽不变，相连短线同步重接。

AUDIO_LINE_L的B.Cu支线原直线穿过功放输入via，另做0.25mm同层绕行；没有改变音频端点或串入器件。R309丝印按新焊盘重新缩短。最终所有原生检查和原连接保留通过；布局通过不等于音频噪声/开关耦合已实测。

## Signal Analysis Review

J502仍3.3V I2C扩展，不能连带5V上拉的模块。J504是10µF耦合的音频口，低阻耳机带宽仍未核准；播放主通路是PAM8302A→J506。J506两脚均为桥接输出，**都不是GND**。

SH厂商额定1A（AWG28条件）；理想2.5W/4Ω音频电流约0.791A RMS只是负载计算，不含未知扬声器、PWM/线缆损耗，也不是插座实测。EH的3A（AWG22条件）不默认覆盖15舵机动态峰值或更细线材。

## Power Analysis

计算脚本calculate_final_power_parts.py，结果power-part-calculations.json；**全为计算/假设，不是实测**。AP64350取RT200kΩ±1%对应450–550kHz，Vref0.8V±1%及两只1%反馈电阻，输出容差角4.852–5.119V。

在Vin=6.6/7.4/8.4V的分析窗口、最大3.5A负载、L=5.6µH×0.8容差×0.8额外偏置折减假设下，理想连续模式最坏电感峰值约4.135A，比IC最小峰值限流4.25A约低0.115A。该窗口不是新设电池截止电压；偏置折减是假设，厂商9A/20%下降为25°C典型值，不能说全温保证已通过。

电感DCR最大17.6mΩ@25°C、典型热电流9.3A/温升40°C、典型20%降感电流9A来自原厂p1；本板铜/气流/开关损耗不同。0.115A的限流余量较小，不能直接把3.5A芯片标称值写成整板连续额定。

## PDN Impedance

更换电感/封装后，补偿网络与电源电容的有效参数、PCB寄生仍需复核。本轮计算未覆盖闭环瞬态、核心/开关损耗或带载温升。自动默认ESR/ESL曲线不作为验收。

## Power Budget

R309选定铜跳线最大0.2mΩ，5A时按25°C上限计算约1mV、5mW；这使跳线本体的电流能力有据可查，但**不把其65A元件额定当HAT额定**。J301、EH座、PCB和线束是独立约束；下一阶段需解决整板入口和负载协调，不能用更大跳线掩盖连接器限制。

## Thermal Analysis

已跑热analyzer，但仍只评估2件/0.043W假设，不接受100分。新电感的铜损有独立计算，实际绕组温度/核心损耗、AP64350热焊盘布局仍未验证；不把元件资料中的测试温升套成本板温升。

## EMC / Cross-Domain Analysis

cross/EMC已重跑；保持原地网连通不等于回流路径/EMI完成。局部音频via和路径与开关区域相邻，需随buck/codec布局和真实负载复核。7个地孔及原生连接证据继续用于排除“无地孔”等误报。

## Simulation Verification

ngspice自动子电路12/12 pass，仍为理想/行为模型；自动AP64350反馈0.6V假设错误未拿来放行真实0.8V器件。新电感5.6µH进入原理图，但自动报告不包含厂商非线性磁性/偏压电容与完整控制环。

## Component Lifecycle

本轮对36个唯一MPN重新查询，全部unknown，结果在lifecycle.json；不写在产或库存通过。38个BOM分组因显示值/用途不同含重复料号，不与36个唯一MPN混淆。此前供应商搜索的错误型号匹配已拒绝；完整MPN表不等于渠道匹配完毕。

## Manufacturing / DFM

新[同版生产审查包](../../../../hardware/custom_hat/rev_a/production-20261031-bom-review/README.md)包含Gerber/钻孔/坐标/完整MPN BOM和指纹。96通孔环宽≥0.125mm保持，1个U701.7微孔0.1mm环宽仍需HDI；电容盘中孔仍已移除。本包未制造放行。

## Sources / Acquisition Failures

- JST官方完整120E目录：https://www.jst.fr/doc/jst/pdf/jst-connector-catalogue-vol-120e.pdf，535页，EH用p35–36；保留原PDF/哈希。
- JST SH原厂3页文档的SparkFun镜像：https://cdn.sparkfun.com/assets/0/e/1/5/8/JST-SH_right_angle_PRT-25271.pdf；p1–2图/料号已目视核对，与官方目录的SR通用板座条目交叉核对。
- Vishay 34315与30192原厂PDF直接下载，版本/哈希见sources-manifest.json。
- Bourns CRF及Vishay DZ-11为比较资料，未采用。Würth旧5.5µH候选资料入口仍受403/超时限制，未假称已下载。其数据未代替最终选定Vishay资料。

用computer-use浏览器找到实际可访问镜像，下载Media调用曾超时但暴露了正确URL，随后标准HTTP下载成功；未绕过验证码、登录或安全警告，未在供应网站下单/发消息。脚本记录访问失败，不把网站受限写成器件停产。所有用于结论的图页已归档；界面空白截图没有技术证据价值。

## False Positives / Reviewer Overrides

SS-002已消失是料号字段完整的结果，不是电气通过。DS-002仍因工程同级没有datasheets目录而提示；资料实际按专题归档。RS-001的+5V_FB是反馈点、SERVO_VBAT由R309桥接，不是缺电源。PM-002/热孔计数/Paste比例等既有误判沿用原始交叉证据，不关闭原生规则。

## Analyzers Actually Run

aklofas/kicad-happy提交2fd9aa0fe2d620f36627d9221e8b1393987ae38e；实际跑schematic、pcb --full、gerbers、cross、EMC、thermal、SPICE、lifecycle、prior schematic delta，命令/日志/JSON均在本目录。各阶段来源与此前连接器/环宽报告互相衔接。

## Not Performed / Review Limits

整板载流/供电入口、MLCC偏压/ESR、真实热/回流/HDI工艺、闭环瞬态、EMC认证、首板功能/温升/装配、库存与制造接受未完成。未付款、下单、上电、commit或push；没有把“全量MPN”改写成全部目标完成。

## Final Verdict

已关闭“MPN缺失”和L301/R309通用封装未匹配具体器件的问题，原连接与原生检查通过。下一阶段集中处理电源入口/载流、有效电容/稳定性、热/回流和HDI条件；制造后再做首板必要验收。全目标继续，当前不可投板。

收尾审计见final-audit.json：54个拟装器件MPN非空、36个唯一料号，原理图/PCB的Value、MPN、Manufacturer、Footprint、Datasheet字段一致；BOM位号集合/数量、源/输出指纹和新链接均匹配，git diff --check返回0。所有修改保留工作区，未提交。
