parkourlrc/pcb-yilv1982--duck-robot-89dbc81d6d/docs/references/两套扩展板订单与报价/custom-bom-all58.csv

Comment | Designator | Footprint | Manufacturer | Quantity | Value | MPN | KiCadFootprint
08055A332JAT2A | C301 | 0805 | KYOCERA AVX | 1 | 3.3nF | 08055A332JAT2A | Capacitor_SMD:C_0805_2012Metric
C0805C104K5RACTU | C302 | 0805 | KEMET | 1 | 100nF | C0805C104K5RACTU | Capacitor_SMD:C_0805_2012Metric
C1210C226K3RACTU | C303,C304,C305,C306,C323 | 1210 | KEMET | 5 | 22uF | C1210C226K3RACTU | Capacitor_SMD:C_1210_3225Metric
C0805C225K5RACTU | C308,C328 | 0805 | KEMET | 2 | 2.2uF | C0805C225K5RACTU | Capacitor_SMD:C_0805_2012Metric
C0805C225K5RACTU | C309 | 0805 | KEMET | 1 | 2.2uF | C0805C225K5RACTU | duck:C_0805_2012Metric_LDO_ClearSilk
C0402C104K3RACTU | C310,C312,C319,C320,C327,C329,C330 | 0402 | KEMET | 7 | 100nF | C0402C104K3RACTU | Capacitor_SMD:C_0402_1005Metric
C0402C105K4PACTU | C311,C313,C315,C321,C322,C325,C326 | 0402 | KEMET | 7 | 1uF | C0402C105K4PACTU | Capacitor_SMD:C_0402_1005Metric
C0402C106M9PACTU | C317,C318 | 0402 | KEMET | 2 | 10uF | C0402C106M9PACTU | Capacitor_SMD:C_0402_1005Metric
SMBJ12A-E3/52 | D301 | SMB | Vishay | 1 | SMBJ12A (fitted) | SMBJ12A-E3/52 | Diode_SMD:D_SMB
BM04B-SRSS-TB(LF)(SN) | J502 | JST_SH_BM04B-SRSS-TB_1x04-1MP_P1.00mm_Vertical | JST | 1 | TOF_I2C5 | BM04B-SRSS-TB(LF)(SN) | Connector_JST:JST_SH_BM04B-SRSS-TB_1x04-1MP_P1.00mm_Vertical
BM03B-SRSS-TB(LF)(SN) | J504 | JST_SH_BM03B-SRSS-TB_1x03-1MP_P1.00mm_Vertical | JST | 1 | AUDIO_OUT_SH | BM03B-SRSS-TB(LF)(SN) | Connector_JST:JST_SH_BM03B-SRSS-TB_1x03-1MP_P1.00mm_Vertical
BM02B-SRSS-TB(LF)(SN) | J505 | JST_SH_BM02B-SRSS-TB_1x02-1MP_P1.00mm_Vertical | JST | 1 | MIC_IN | BM02B-SRSS-TB(LF)(SN) | Connector_JST:JST_SH_BM02B-SRSS-TB_1x02-1MP_P1.00mm_Vertical
BM02B-SRSS-TB(LF)(SN) | J506 | JST_SH_BM02B-SRSS-TB_1x02-1MP_P1.00mm_Vertical | JST | 1 | SPEAKER | BM02B-SRSS-TB(LF)(SN) | Connector_JST:JST_SH_BM02B-SRSS-TB_1x02-1MP_P1.00mm_Vertical
IHLP4040DZER5R6M5A | L301 | SMD,10.2x10.8mm | Vishay | 1 | 5.6uH | IHLP4040DZER5R6M5A | duck:IHLP4040DZ_5A_Above2u2
CRCW080552K3FKEA | R301 | 0805 | Vishay | 1 | 52.3k | CRCW080552K3FKEA | Resistor_SMD:R_0805_2012Metric
CRCW080510K0FKEA | R302 | 0805 | Vishay | 1 | 10k | CRCW080510K0FKEA | Resistor_SMD:R_0805_2012Metric
CRCW0805200KFKEA | R303 | 0805 | Vishay | 1 | 200k | CRCW0805200KFKEA | Resistor_SMD:R_0805_2012Metric
CRCW080514K0FKEA | R304 | 0805 | Vishay | 1 | 14k | CRCW080514K0FKEA | Resistor_SMD:R_0805_2012Metric
CRCW0805100KFKEA | R305 | 0805 | Vishay | 1 | 100k | CRCW0805100KFKEA | Resistor_SMD:R_0805_2012Metric
CRCW040210K0FKED | R308 | 0402 | Vishay | 1 | 10k | CRCW040210K0FKED | Resistor_SMD:R_0402_1005Metric
WSL120600000ZEA9 | R309 | 1206 | Vishay | 1 | 0R | WSL120600000ZEA9 | duck:Vishay_WSL1206_Jumper
CRCW0402100KFKED | R310,R311 | 0402 | Vishay | 2 | 100k | CRCW0402100KFKED | Resistor_SMD:R_0402_1005Metric
CRCW04022K20FKED | R312 | 0402 | Vishay | 1 | 2.2k | CRCW04022K20FKED | Resistor_SMD:R_0402_1005Metric
CRCW04024K70FKED | R501,R502 | 0402 | Vishay | 2 | 4.7k | CRCW04024K70FKED | Resistor_SMD:R_0402_1005Metric
WSLP0603R0470FEA | R703 | 0603 | Vishay | 1 | 0.047 | WSLP0603R0470FEA | duck:Vishay_WSLP0603_Damping
AP64350SP-13 | U301 | SO-8-EP | Diodes Incorporated | 1 | AP64350 | AP64350SP-13 | duck:SO8EP_AP64350_Paste4_Project
BMI088 | U501 | LGA-16(3x4.5) | Bosch Sensortec | 1 | BMI088 | BMI088 | Package_LGA:Bosch_LGA-16_4.5x3mm_P0.5mm_LayoutBorder7x1y_ClockwisePinNumbering
TLV320AIC3104IRHBR | U701 | HVQFN-32-EP(5x5) | Texas Instruments | 1 | TLV320AIC3104 | TLV320AIC3104IRHBR | duck:TI_RHB0032E_AIC3104_EP345
LP38691DT-1.8/NOPB | U702 | TO-252 | Texas Instruments | 1 | LP38691DT-1.8 | LP38691DT-1.8/NOPB | duck:TI_NDP0003B_LP38691_PasteGrid
SN74LVC1G126DBVR | U801 | SOT-23-5 | Texas Instruments | 1 | SN74LVC1G126 | SN74LVC1G126DBVR | Package_TO_SOT_SMD:SOT-23-5
SN74LVC1G125DBVT | U802 | SOT-23-5 | Texas Instruments | 1 | SN74LVC1G125 | SN74LVC1G125DBVT | Package_TO_SOT_SMD:SOT-23-5
PAM8302AADCR | U803 | SOIC-8 | Diodes Incorporated | 1 | PAM8302A | PAM8302AADCR | Package_SO:SOIC-8_3.9x4.9mm_P1.27mm
SSW-120-01-G-D | J101 | PTH P2.54mm | Samtec | 1 | RADXA_ZERO_3W_40P | SSW-120-01-G-D | duck:Radxa40P_Samtec_SSW120
TSW-108-07-G-S | J301 | PTH P2.54mm | Samtec | 1 | POWER_AND_RAILS | TSW-108-07-G-S | duck:Samtec_TSW108_07
B3B-EH-A(LF)(SN) | J401 | PTH P2.50mm | JST | 1 | DYNAMIXEL_TTL_1 | B3B-EH-A(LF)(SN) | Connector_JST:JST_EH_B3B-EH-A_1x03_P2.50mm_Vertical
B3B-EH-A(LF)(SN) | J402 | PTH P2.50mm | JST | 1 | DYNAMIXEL_TTL_2 | B3B-EH-A(LF)(SN) | Connector_JST:JST_EH_B3B-EH-A_1x03_P2.50mm_Vertical
TSW-103-07-G-S | J403 | PTH P2.54mm | Samtec | 1 | HOST_UART2 | TSW-103-07-G-S | duck:Samtec_TSW103_07
TSW-102-07-G-S | J802 | PTH P2.54mm | Samtec | 1 | IMU_INT_TP | TSW-102-07-G-S | duck:Samtec_TSW102_07
