parkourlrc/pcb-yilv1982--duck-robot-89dbc81d6d/hardware/custom_hat/rev_b/bom-candidate.csv

Reference | Value | MPN | LCSC | Footprint | Manufacturer
J101 | RADXA_ZERO_3W | 2.54-2*20 | C2977589 | duck:Radxa40P_Zhouri_B | ZHOURI
U301 | AP63205WU-7 | AP63205WU-7 | C2071056 | Package_TO_SOT_SMD:TSOT-23-6 | Diodes
L301 | 6.8uH | SWPA6045S6R8MT | C57254 | Inductor_SMD:L_Sunlord_SWPA6045S | Sunlord
C301 | 10uF35V | C3216X7R1V106KT000E | C76666 | Capacitor_SMD:C_1206_3216Metric | TDK
C302 | 100nF | CC0603KRX7R9BB104 | C14663 | Capacitor_SMD:C_0603_1608Metric | YAGEO
C303 | 22uF25V | GRM32ER71E226KE15L | C21397 | Capacitor_SMD:C_1210_3225Metric | Murata
C304 | 22uF25V | GRM32ER71E226KE15L | C21397 | Capacitor_SMD:C_1210_3225Metric | Murata
U302 | LM5050-1 | LM5050MKX-1/NOPB | C473393 | Package_TO_SOT_SMD:TSOT-23-6 | Texas Instruments
Q301 | AO3404A | AO3404A | C30010 | Package_TO_SOT_SMD:SOT-23 | AOS
R301 | 100R | 0603WAF1000T5E | C22775 | Resistor_SMD:R_0603_1608Metric | UNI-ROYAL
C305 | 100nF | CC0603KRX7R9BB104 | C14663 | Capacitor_SMD:C_0603_1608Metric | YAGEO
D301 | SMBJ12A | SMBJ12A-E3/52 | C1973121 | Diode_SMD:D_SMB | Vishay
J401 | SERVO_AMP2 | CNJM A2007WV-3P | C5151076 | duck:AMP2007_3P_B | CNJM
J402 | SERVO_AMP2 | CNJM A2007WV-3P | C5151076 | duck:AMP2007_3P_B | CNJM
U801 | SN74LVC1G126DBVR | SN74LVC1G126DBVR | C7834 | Package_TO_SOT_SMD:SOT-23-5 | Texas Instruments
U802 | SN74LVC1G125DBVR | SN74LVC1G125DBVR | C23654 | Package_TO_SOT_SMD:SOT-23-5 | Texas Instruments
R401 | 100k | 0603WAF1003T5E | C25803 | Resistor_SMD:R_0603_1608Metric | UNI-ROYAL
R402 | 10k | 0603WAF1002T5E | C25804 | Resistor_SMD:R_0603_1608Metric | UNI-ROYAL
R403 | 10k | 0603WAF1002T5E | C25804 | Resistor_SMD:R_0603_1608Metric | UNI-ROYAL
R404 | 0R | 0603WAF0000T5E | C21189 | Resistor_SMD:R_0603_1608Metric | UNI-ROYAL
D401 | 5.1V | BZT52C5V1S-7-F | C151348 | Diode_SMD:D_SOD-323 | Diodes
C401 | 100nF | CC0603KRX7R9BB104 | C14663 | Capacitor_SMD:C_0603_1608Metric | YAGEO
C402 | 100nF | CC0603KRX7R9BB104 | C14663 | Capacitor_SMD:C_0603_1608Metric | YAGEO
J502 | QWIIC_3V3 | BM04B-SRSS-TB(LF)(SN) | C160390 | Connector_JST:JST_SH_BM04B-SRSS-TB_1x04-1MP_P1.00mm_Vertical | JST
R501 | 10k | 0603WAF1002T5E | C25804 | Resistor_SMD:R_0603_1608Metric | UNI-ROYAL
R502 | 10k | 0603WAF1002T5E | C25804 | Resistor_SMD:R_0603_1608Metric | UNI-ROYAL
U701 | TLV320AIC3104 | TLV320AIC3104IRHBR | C181753 | duck:TI_RHB0032E_AIC3104_EP345 | Texas Instruments
U702 | XC6206P182MR | XC6206P182MR | C347373 | duck:UMW_XC6206_SOT23_B | UMW
Y701 | 12MHz | OT3EL89CJI-111YLC-12M | C7425459 | duck:YXC_2520_YSO110TR_B | YXC
R701 | 10k | 0603WAF1002T5E | C25804 | Resistor_SMD:R_0603_1608Metric | UNI-ROYAL
C701 | 100nF | CC0603KRX7R9BB104 | C14663 | Capacitor_SMD:C_0603_1608Metric | YAGEO
C702 | 1uF | CL10A105KB8NNNC | C15849 | Capacitor_SMD:C_0603_1608Metric | SAMSUNG
C703 | 10uF | C1608X5R1A106KT000E | C76608 | Capacitor_SMD:C_0603_1608Metric | TDK
C704 | 100nF | CC0603KRX7R9BB104 | C14663 | Capacitor_SMD:C_0603_1608Metric | YAGEO
C705 | 100nF | CC0603KRX7R9BB104 | C14663 | Capacitor_SMD:C_0603_1608Metric | YAGEO
C706 | 1uF | CL10A105KB8NNNC | C15849 | Capacitor_SMD:C_0603_1608Metric | SAMSUNG
C707 | 100nF | CC0603KRX7R9BB104 | C14663 | Capacitor_SMD:C_0603_1608Metric | YAGEO
C708 | 1uF | CL10A105KB8NNNC | C15849 | Capacitor_SMD:C_0603_1608Metric | SAMSUNG
C709 | 100nF | CC0603KRX7R9BB104 | C14663 | Capacitor_SMD:C_0603_1608Metric | YAGEO
C710 | 1uF | CL10A105KB8NNNC | C15849 | Capacitor_SMD:C_0603_1608Metric | SAMSUNG
C711 | 100nF | CC0603KRX7R9BB104 | C14663 | Capacitor_SMD:C_0603_1608Metric | YAGEO
C712 | 1uF | CL10A105KB8NNNC | C15849 | Capacitor_SMD:C_0603_1608Metric | SAMSUNG
C713 | 100nF | CC0603KRX7R9BB104 | C14663 | Capacitor_SMD:C_0603_1608Metric | YAGEO
MK701 | MEMS_MIC | LMA2718T421-OA5-2 | C7587901 | duck:LMA2718_B | LinkMems
C721 | 100nF | CC0603KRX7R9BB104 | C14663 | Capacitor_SMD:C_0603_1608Metric | YAGEO
C722 | 1uF | CL10A105KB8NNNC | C15849 | Capacitor_SMD:C_0603_1608Metric | SAMSUNG
J505 | J505_MIC | A1251WV-2P | C5333427 | duck:A1251_2P_B | CJT
J507 | J507_MIC | A1251WV-2P | C5333427 | duck:A1251_2P_B | CJT
R721 | 2.2k | 0603WAF2201T5E | C4190 | Resistor_SMD:R_0603_1608Metric | UNI-ROYAL
R722 | 2.2k | 0603WAF2201T5E | C4190 | Resistor_SMD:R_0603_1608Metric | UNI-ROYAL
C723 | 1uF | CL10A105KB8NNNC | C15849 | Capacitor_SMD:C_0603_1608Metric | SAMSUNG
C724 | 1uF | CL10A105KB8NNNC | C15849 | Capacitor_SMD:C_0603_1608Metric | SAMSUNG
C725 | 100nF | CC0603KRX7R9BB104 | C14663 | Capacitor_SMD:C_0603_1608Metric | YAGEO
U803 | PAM8406DR | PAM8406DR | C86270 | Package_SO:SOIC-16_3.9x9.9mm_P1.27mm | Diodes
C731 | 1uF | CL10A105KB8NNNC | C15849 | Capacitor_SMD:C_0603_1608Metric | SAMSUNG
C732 | 1uF | CL10A105KB8NNNC | C15849 | Capacitor_SMD:C_0603_1608Metric | SAMSUNG
C733 | 1uF | CL10A105KB8NNNC | C15849 | Capacitor_SMD:C_0603_1608Metric | SAMSUNG
C734 | 10uF | C1608X5R1A106KT000E | C76608 | Capacitor_SMD:C_0603_1608Metric | TDK
C735 | 100nF | CC0603KRX7R9BB104 | C14663 | Capacitor_SMD:C_0603_1608Metric | YAGEO
C736 | 10uF | C1608X5R1A106KT000E | C76608 | Capacitor_SMD:C_0603_1608Metric | TDK
C737 | 100nF | CC0603KRX7R9BB104 | C14663 | Capacitor_SMD:C_0603_1608Metric | YAGEO
C738 | 1uF | CL10A105KB8NNNC | C15849 | Capacitor_SMD:C_0603_1608Metric | SAMSUNG
FB701 | 600R@100MHz | BLM18KG601SN1D | C85833 | Inductor_SMD:L_0603_1608Metric | Murata
R731 | 100k | 0603WAF1003T5E | C25803 | Resistor_SMD:R_0603_1608Metric | UNI-ROYAL
FB702 | 120R@100MHz | PE-0603PFB121ST | C2661472 | Inductor_SMD:L_0603_1608Metric | Power Ever
FB703 | 120R@100MHz | PE-0603PFB121ST | C2661472 | Inductor_SMD:L_0603_1608Metric | Power Ever
C739 | 220pF | 0603CG221J500NT | C156398 | Capacitor_SMD:C_0603_1608Metric | FH
C740 | 220pF | 0603CG221J500NT | C156398 | Capacitor_SMD:C_0603_1608Metric | FH
J506 | SPEAKER | A1251WV-2P | C5333427 | duck:A1251_2P_B | CJT
