parkourlrc/pcb-yilv1982--duck-robot-89dbc81d6d/docs/schematics/imu-to-dxl-scrapmeta-v0.3/production/imu_to_dxl_v03_bom_20261025.xlsx

No. | Quantity | Comment | Designator | Footprint | Value | Manufacturer Part | Manufacturer | Supplier Part | Supplier
1 | 2 | 100nF | C1,C3 | C0402 | 100nF | CL05B104KO5NNNC | SAMSUNG(三星) | C1525 | LCSC
2 | 1 | 1uF | C2 | C0402 | 1uF | CL05A105KA5NQNC | SAMSUNG(三星) | C52923 | LCSC
3 | 1 | 100nF | C4 | C0402 | 100nF | CL05B104KB54PNC | SAMSUNG(三星) | C307331 | LCSC
4 | 1 | 10uF | C5 | C0805 | 10uF | GRM21BR61H106KE43L | muRata(村田) | C440198 | LCSC
5 | 1 | 4.7uF | C6 | C0603 | 4.7uF | CL10A475KO8NNNC | SAMSUNG(三星) | C19666 | LCSC
6 | 1 | PESD5V0S1BA | D1 | SOD-323_L1.7-W1.3-LS2.5-BI |  | PESD5V0S1BA | TECH PUBLIC(台舟) | C2827694 | LCSC
7 | 1 | BZT52C5V1S-7-F | D2 | SOD-323_L1.8-W1.3-LS2.5-RD |  | BZT52C5V1S-7-F | DIODES(美台) | C151348 | LCSC
8 | 2 | B3B-EH-A(LF)(SN) | J1,J3 | CONN-TH_B3B-EH-A-LF-SN |  | B3B-EH-A(LF)(SN) | JST | C160259 | LCSC
9 | 1 | BM07B-SRSS-TB | J2 | CONN-SMD_7P-P1.00_BM07B-SRSS-TB |  | BM07B-SRSS-TB |  | C20089159 | LCSC
10 | 5 | 10kΩ | R1,R2,R3,R4,R5 | R0402 | 10kΩ | 0402WGF1002TCE | UNI-ROYAL(厚声) | C25744 | LCSC
11 | 1 | 150Ω | R6 | R0603 | 150Ω | 0603WAF1500T5E | UNI-ROYAL(厚声) | C22808 | LCSC
12 | 1 | LSM6DSV16XTR | U1 | LGA-14_L3.0-W2.5-P0.50-BR |  | LSM6DSV16XTR | ST(意法半导体) | C5267406 | LCSC
13 | 1 | STM32G031F8P6 | U2 | TSSOP-20_L6.5-W4.4-P0.65-LS6.4-BL |  | STM32G031F8P6 | ST(意法半导体) | C529334 | LCSC
14 | 1 | AP2210K-3.3TRG1 | U3 | SOT-23-5_L3.0-W1.7-P0.95-LS2.8-BR |  | AP2210K-3.3TRG1 | DIODES(美台) | C176959 | LCSC
15 | 1 | SN74LVC1G125DBVR-TP | U6 | SOT-23-5_L2.9-W1.6-P0.95-LS2.8-BL |  | SN74LVC1G125DBVR-TP | TECH PUBLIC(台舟) | C3040625 | LCSC
