parkourlrc/pcb-yilv1982--duck-robot-89dbc81d6d/docs/references/扩展板乙版降本/cost-gate.md

# Rev B.0成本闸门（未达标）

2026-11-05更新。用户上限为5块全部焊好≤750元，运费另计。**现行84362651已完成焊接空间调整与同源导出，Gerber已生成Y10（PCB初步33元、待审核未付）；BOM/CPL已上传，SMT全焊设置和物料匹配待用户继续，尚未取得完整新报价。** 11-04保存的旧源99ecc45d/Y9快照为SMT¥1107.71（含10元极性复核）＋PCB初步¥33＝¥1140.71，超目标¥390.71；该旧价不随本地布局完成而自动降低。未提交正式SMT、未付款、未制造放行。详见[调整报告](layout-spacing/research.md)及[历史报价](y9-quotation.md)。以下目录表是此前净材料计算，不是实时价格或新订单用量。

已取得精确MPN匹配目录价的物料组：30/30；这些组5板净用量小计¥238.1055。11-04旧Y9订单实际用量含备损/最低数量，元件费¥266.44；两种口径不能混用。

备损、最低上机数、换料、PCB、钢网、工程/插件/治具/税费均须以新的完整报价为准，不将历史Y7/Y8草稿折半认作B.0报价。

| 位号 | 精确MPN | C编号 | 5板净量 | 单价¥ | 净额¥ | 观察库存 |
|---|---|---|---:|---:|---:|---:|
| J101 | 2.54-2*20 | C2977589 | 5 | 1.857 | 9.2850 | 35211 |
| U301 | AP63205WU-7 | C2071056 | 5 | 2.82 | 14.1000 | 23111 |
| L301 | SWPA6045S6R8MT | C57254 | 5 | 0.525 | 2.6250 | 22497 |
| C301 | C3216X7R1V106KT000E | C76666 | 5 | 2.289 | 11.4450 | 5458 |
| C302,C305,C401,C402,C701,C704,C705,C707,C709,C711,C713,C721,C725,C735,C737 | CC0603KRX7R9BB104 | C14663 | 75 | 0.0502 | 3.7650 | 37842432 |
| C303,C304 | GRM32ER71E226KE15L | C21397 | 10 | 1.92 | 19.2000 | 66601 |
| U302 | LM5050MKX-1/NOPB | C473393 | 5 | 5.17 | 25.8500 | 34408 |
| Q301 | AO3404A | C30010 | 5 | 0.701 | 3.5050 | 13345 |
| R301 | 0603WAF1000T5E | C22775 | 5 | 0.0139 | 0.0695 | 8719393 |
| D301 | SMBJ12A-E3/52 | C1973121 | 5 | 0.835 | 4.1750 | 2763 |
| J401,J402 | CNJM A2007WV-3P | C5151076 | 10 | 0.18 | 1.8000 | 386 |
| U801 | SN74LVC1G126DBVR | C7834 | 5 | 0.423 | 2.1150 | 67781 |
| U802 | SN74LVC1G125DBVR | C23654 | 5 | 0.407 | 2.0350 | 161135 |
| R401,R731 | 0603WAF1003T5E | C25803 | 10 | 0.0176 | 0.1760 | 16825583 |
| R402,R403,R501,R502,R701 | 0603WAF1002T5E | C25804 | 25 | 0.0142 | 0.3550 | 44497352 |
| R404 | 0603WAF0000T5E | C21189 | 5 | 0.013 | 0.0650 | 19977953 |
| D401 | BZT52C5V1S-7-F | C151348 | 5 | 0.216 | 1.0800 | 58494 |
| J502 | BM04B-SRSS-TB(LF)(SN) | C160390 | 5 | 0.959 | 4.7950 | 16910 |
| U701 | TLV320AIC3104IRHBR | C181753 | 5 | 14.94 | 74.7000 | 1834 |
| U702 | XC6206P182MR | C347373 | 5 | 0.128 | 0.6400 | 59942 |
| Y701 | OT3EL89CJI-111YLC-12M | C7425459 | 5 | 3.249 | 16.2450 | 6242 |
| C702,C706,C708,C710,C712,C722,C723,C724,C731,C732,C733,C738 | CL10A105KB8NNNC | C15849 | 60 | 0.0884 | 5.3040 | 12106553 |
| C703,C734,C736 | C1608X5R1A106KT000E | C76608 | 15 | 0.533 | 7.9950 | 14260 |
| MK701 | LMA2718T421-OA5-2 | C7587901 | 5 | 0.651 | 3.2550 | 9767 |
| J505,J507,J506 | A1251WV-2P | C5333427 | 15 | 0.344 | 5.1600 | 8578 |
| R721,R722 | 0603WAF2201T5E | C4190 | 10 | 0.0109 | 0.1090 | 5296273 |
| U803 | PAM8406DR | C86270 | 5 | 2.81 | 14.0500 | 21451 |
| FB701 | BLM18KG601SN1D | C85833 | 5 | 0.11 | 0.5500 | 814663 |
| FB702,FB703 | PE-0603PFB121ST | C2661472 | 10 | 0.314 | 3.1400 | 1597 |
| C739,C740 | 0603CG221J500NT | C156398 | 10 | 0.0517 | 0.5170 | 71865 |

## 下一步

**2026-11-05用户暂停：** 已确认付款、等待收货；自主HAT线路暂停，以下降本/核价安排不再执行，待用户明确恢复。原750元目标未达成，已付款不等于成本验收或首板验收通过。

**2026-11-05合并支付明细更新：** 当前Y10商品小计886.29元（PCB33＋元件265.52＋SMT加工587.77），运费5.50，合计891.79。按运费另计的750目标，差额136.29元；替代以下较早843.29/876.29的阶段预估。未付款、未制造放行，加工新增10元具体服务待核。详见[合并支付费用确认](layout-spacing/y10-quotation-status.md)。

2026-11-05 PDF核验：30组C编号及69个位号与当前BOM一致，5片顶底层、843.29元预估确认；PDF不含逐项基础/扩展分类，216元换料费无法分摊，暂未找到可核实的减费金额。先进入后续服务/极性确认页取得同范围报价。见[PDF核对报告](layout-spacing/y10-pdf-review-20261105.md)。

2026-11-05用户新截图补充：Y10预估元件265.52＋加工577.77＝843.29元；加此前PCB初步33暂算876.29元，非最终总价。治具提示明确一面贴片另一面插件需治具，官方指引36095支持插件焊接面遮蔽要求；100元继续计入预算，不再将其视为已有依据可免的费用。后续优先核验完整匹配表、216元换料费对应物料与服务设置，见[治具证据及限制](layout-spacing/y10-quotation-status.md)。

通孔焊接面间距已完成CAD调整，按新[同源报价包](../../../hardware/custom_hat/rev_b/quote-84362651/README.md)重新核工艺与5片全焊费用，再核治具和换料。旧贴插¥233.50、治具¥100不能直接从旧账扣除；后续局部213.40元截图及页面数量状态也不能混作新5片报价。仅顶层¥1057.11明确漏装J101，继续排除；经济型此前提示钢网确认不支持，不能直接归因于codec。既有草稿不等于全市场最低价。
