parkourlrc/pcb-yilv1982--duck-robot-89dbc81d6d/docs/references/扩展板乙版降本/y9-bom-ui-20261104.txt

Window: "嘉立创下单助手", App: jlc-assistant.exe.
	0 窗格 嘉立创下单助手 Secondary Actions: Raise
			2 文本 SMT下单
			4 文本
			5 文本 Y9
			6 文本
			7 文本 CUSTOM-HAT-B0-99ecc45d-5PCS
			8 文本 网络支付总费用
			9 文本 ：
			10 文本 ￥
			11 文本 1097.71
			12 文本 [明细]
			13 按钮 更多操作
			14 文本 下单帮助：
			18 未加标签的图片
			20 文本 切到简易模式
			21 文本 贴片数量
			22 文本 5
			23 文本 片全贴
			24 文本 其他数量
			26 文本 (请输入
			27 文本 2
			28 文本 ~
			29 文本 5
			30 文本 的数量)
			31 文本 贴装、焊接层
			32 文本 顶层 + 底层
			33 文本 仅顶层
			34 文本 仅底层
			35 文本 产品类型
			37 文本 经济型(
			38 文本 不支持
			39 文本 )
			40 文本 标准型(
			41 文本 预估价:￥1097.71
			42 文本 )
			43 文本 SMT生产时间
			45 文本 生产时间4-5天
			46 文本 生产时间4天（加急）
			47 文本 生产时间3天（加急）
			48 文本 收起
			49 图像 arrowSvg
			50 按钮 BOM change 详情模式
				51 文本 BOM
				52 图像 change
				53 文本 详情模式
			54 文本 全部元件(
			55 文本 30
			56 文本 )
			57 文本 私有库存(
			58 文本 0
			59 文本 )
			60 文本 信用库存(
			61 文本 0
			62 文本 )
			63 文本 嘉立创库存(
			64 文本 30
			65 文本 )
			66 文本 搜全部
			67 文本 搜位号
			68 编辑 (settable, string) 可搜索位号、封装、器件编号、基础库、扩展库等
			69 未加标签的图片
			70 按钮 新增物料信息
			71 表格 ID: resizeTable
				72 custom
					73 标头 核对进度 0/30
						74 复选框
						75 文本 核对进度
						76 文本 0
						77 文本 /
						78 文本 30
					79 标头 顶层位号
						80 未加标签的图片
					81 标头 底层位号
						82 未加标签的图片
					83 标头 器件名称
						84 未加标签的图片
					85 标头 器件封装
						86 未加标签的图片
					87 标头 器件编号
						88 未加标签的图片
					89 标头 库类型
						90 未加标签的图片
					91 标头 用量
						92 未加标签的图片
					93 标头 私有库存
					94 标头 操作
			95 文本 使用嘉立创库存的元器件(
			96 文本 30
			97 文本 )
			98 表格 ID: jlc
				99 custom
					100 项 editIcon
						101 复选框
						102 图像 editIcon
					103 项 R401、R731 2个器件
						104 文本 R401
						105 文本 、
						106 文本 R731
						107 文本 2
						108 文本 个器件
					109 项
					110 项 厚膜电阻 100kΩ ±1% 100mW 0603WAF1003T5E
						111 文本 厚膜电阻 100kΩ ±1% 100mW
						112 文本 0603WAF1003T5E
					113 项 0603 0603
						114 文本 0603
						115 文本 0603
					116 项 C25803 C25803 C编号匹配
						117 文本 C25803
						118 文本 C25803
						119 文本 C编号匹配
					120 项 基础库
						121 文本 基础库
					122 项 使用：20 库存： 16788122 单价：￥0.0176
						123 文本 使用：20
						124 文本 库存：
						125 文本 16788122
						126 文本 单价：￥
						127 文本 0.0176
					128 项 买1盘，立省 ￥0.137 提示 再送换料费券：￥300 立即购买整盘
						129 文本 买1盘，
						130 文本 立省
						131 文本 ￥
						132 文本 0.137
						133 未加标签的图片 提示
						134 文本 再送
						135 文本 换料费券：
						136 文本 ￥
						137 文本 300
						138 文本 立即购买整盘
					139 项 替换 邮寄 删除
						140 按钮 替换
						141 按钮 邮寄
						142 按钮 删除
				143 custom
					144 项 editIcon
						145 复选框
						146 图像 editIcon
					147 项 R402、R403、R501、R502、R701 5个器件
						148 文本 R402
						149 文本 、
						150 文本 R403
						151 文本 、
						152 文本 R501
						153 文本 、
						154 文本 R502
						155 文本 、
						156 文本 R701
						157 文本 5
						158 文本 个器件
					159 项
					160 项 厚膜电阻 10kΩ ±1% 100mW 0603WAF1002T5E
						161 文本 厚膜电阻 10kΩ ±1% 100mW
						162 文本 0603WAF1002T5E
					163 项 0603 0603
						164 文本 0603
						165 文本 0603
					166 项 C25804 C25804 C编号匹配
						167 文本 C25804
						168 文本 C25804
						169 文本 C编号匹配
					170 项 基础库
						171 文本 基础库
					172 项 使用：35 库存： 44442469 单价：￥0.0142
						173 文本 使用：35
						174 文本 库存：
						175 文本 44442469
						176 文本 单价：￥
						177 文本 0.0142
					178 项 买1盘，立省 ￥0.162 提示 再送换料费券：￥300 立即购买整盘
						179 文本 买1盘，
						180 文本 立省
						181 文本 ￥
						182 文本 0.162
						183 未加标签的图片 提示
						184 文本 再送
						185 文本 换料费券：
						186 文本 ￥
						187 文本 300
						188 文本 立即购买整盘
					189 项 替换 邮寄 删除
						190 按钮 替换
						191 按钮 邮寄
						192 按钮 删除
				193 custom
					194 项 editIcon
						195 复选框
						196 图像 editIcon
					197 项 MK701 1个器件
						198 文本 MK701
						199 文本 1
						200 文本 个器件
					201 项
					202 项 MEMSmic硅麦2718 上进音 s-42db±1 LMA2718T421-OA5-2
						203 文本 MEMSmic硅麦2718 上进音 s-42db±1
						204 文本 LMA2718T421-OA5-2
					205 项 SMD-4P,2.8x1.9mm LMA2718_B
						206 文本 SMD-4P,2.8x1.9mm
						207 文本 LMA2718_B
					208 项 C7587901 C7587901 C编号匹配
						209 文本 C7587901
						210 文本 C7587901
						211 文本 C编号匹配
					212 项 扩展库
						213 文本 扩展库
					214 项 使用：9 库存： 9713 单价：￥0.651
						215 文本 使用：9
						216 文本 库存：
						217 文本 9713
						218 文本 单价：￥
						219 文本 0.651
					220 项 买1盘，立省 ￥3.433 提示 再送换料费券：￥300 立即购买整盘
						221 文本 买1盘，
						222 文本 立省
						223 文本 ￥
						224 文本 3.433
						225 未加标签的图片 提示
						226 文本 再送
						227 文本 换料费券：
						228 文本 ￥
						229 文本 300
						230 文本 立即购买整盘
					231 项 替换 邮寄 删除
						232 按钮 替换
						233 按钮 邮寄
						234 按钮 删除
				235 custom
					236 项 editIcon
						237 复选框
						238 图像 editIcon
					239 项 R404 1个器件
						240 文本 R404
						241 文本 1
						242 文本 个器件
					243 项
					244 项 厚膜电阻 0Ω ±1% 100mW 0603WAF0000T5E
						245 文本 厚膜电阻 0Ω ±1% 100mW
						246 文本 0603WAF0000T5E
					247 项 0603 0603
						248 文本 0603
						249 文本 0603
					250 项 C21189 C21189 C编号匹配
						251 文本 C21189
						252 文本 C21189
						253 文本 C编号匹配
					254 项 基础库
						255 文本 基础库
					256 项 使用：20 库存： 19835972 单价：￥0.013
						257 文本 使用：20
						258 文本 库存：
						259 文本 19835972
						260 文本 单价：￥
						261 文本 0.013
					262 项 买1盘，立省 ￥0.094 提示 再送换料费券：￥300 立即购买整盘
						263 文本 买1盘，
						264 文本 立省
						265 文本 ￥
						266 文本 0.094
						267 未加标签的图片 提示
						268 文本 再送
						269 文本 换料费券：
						270 文本 ￥
						271 文本 300
						272 文本 立即购买整盘
					273 项 替换 邮寄 删除
						274 按钮 替换
						275 按钮 邮寄
						276 按钮 删除
				277 custom
					278 项 editIcon
						279 复选框
						280 图像 editIcon
					281 项 C739、C740 2个器件
						282 文本 C739
						283 文本 、
						284 文本 C740
						285 文本 2
						286 文本 个器件
					287 项
					288 项 220pF ±5% 50V 0603CG221J500NT
						289 文本 220pF ±5% 50V
						290 文本 0603CG221J500NT
					291 项 0603 0603
						292 文本 0603
						293 文本 0603
					294 项 C156398 C156398 C编号匹配
						295 文本 C156398
						296 文本 C156398
						297 文本 C编号匹配
					298 项 扩展库
						299 文本 扩展库
					300 项 使用：20 库存： 69775 单价：￥0.0517
						301 文本 使用：20
						302 文本 库存：
						303 文本 69775
						304 文本 单价：￥
						305 文本 0.0517
					306 项 买1盘，立省 ￥0.414 提示 再送换料费券：￥300 立即购买整盘
						307 文本 买1盘，
						308 文本 立省
						309 文本 ￥
						310 文本 0.414
						311 未加标签的图片 提示
						312 文本 再送
						313 文本 换料费券：
						314 文本 ￥
						315 文本 300
						316 文本 立即购买整盘
					317 项 替换 邮寄 删除
						318 按钮 替换
						319 按钮 邮寄
						320 按钮 删除
				321 custom
					322 项 editIcon
						323 复选框
						324 图像 editIcon
					325 项 U301 1个器件
						326 文本 U301
						327 文本 1
						328 文本 个器件
					329 项
					330 项 降压型 2A 3.8V~32V AP63205WU-7
						331 文本 降压型 2A 3.8V~32V
						332 文本 AP63205WU-7
					333 项 TSOT-23-6 TSOT-23-6
						334 文本 TSOT-23-6
						335 文本 TSOT-23-6
					336 项 C2071056 C2071056 C编号匹配
						337 文本 C2071056
						338 文本 C2071056
						339 文本 C编号匹配
					340 项 扩展库
						341 文本 扩展库
					342 项 使用：5 库存： 22480 单价：￥2.82
						343 文本 使用：5
						344 文本 库存：
						345 文本 22480
						346 文本 单价：￥
						347 文本 2.82
					348 项 买1盘，立省 ￥7.200 提示 再送换料费券：￥300 立即购买整盘
						349 文本 买1盘，
						350 文本 立省
						351 文本 ￥
						352 文本 7.200
						353 未加标签的图片 提示
						354 文本 再送
						355 文本 换料费券：
						356 文本 ￥
						357 文本 300
						358 文本 立即购买整盘
					359 项 替换 邮寄 删除
						360 按钮 替换
						361 按钮 邮寄
						362 按钮 删除
				363 custom
					364 项 editIcon
						365 复选框
						366 图像 editIcon
					367 项 U701 1个器件
						368 文本 U701
						369 文本 1
						370 文本 个器件
					371 项
					372 项 用于便携式音频和电话的低功耗立体声音频编解码器 TLV320AIC3104IRHBR
						373 文本 用于便携式音频和电话的低功耗立体声音频编解码器
						374 文本 TLV320AIC3104IRHBR
					375 项 HVQFN-32-EP(5x5) TI_RHB0032E_AIC3104_EP345
						376 文本 HVQFN-32-EP(5x5)
						377 文本 TI_RHB0032E_AIC3104_EP345
					378 项 C181753 C181753 C编号匹配
						379 文本 C181753
						380 文本 C181753
						381 文本 C编号匹配
					382 项 扩展库
						383 文本 扩展库
					384 项 使用：5 库存： 1824 单价：￥14.94
						385 文本 使用：5
						386 文本 库存：
						387 文本 1824
						388 文本 单价：￥
						389 文本 14.94
					390 项 买1盘，约省 ￥31.500 提示 再送换料费券：￥300 立即购买整盘
						391 文本 买1盘，
						392 文本 约省
						393 文本 ￥
						394 文本 31.500
						395 未加标签的图片 提示
						396 文本 再送
						397 文本 换料费券：
						398 文本 ￥
						399 文本 300
						400 文本 立即购买整盘
					401 项 替换 邮寄 删除
						402 按钮 替换
						403 按钮 邮寄
						404 按钮 删除
				405 custom
					406 项 editIcon
						407 复选框
						408 图像 editIcon
					409 项 D301 1个器件
						410 文本 D301
						411 文本 1
						412 文本 个器件
					413 项
					414 项 单向TVS 12V截止 峰值浪涌电流：30.2A@10/1000us SMBJ12A-E3/52
						415 文本 单向TVS 12V截止 峰值浪涌电流：30.2A@10/1000us
						416 文本 SMBJ12A-E3/52
					417 项 SMB(DO-214AA) D_SMB
						418 文本 SMB(DO-214AA)
						419 文本 D_SMB
					420 项 C1973121 C1973121 C编号匹配
						421 文本 C1973121
						422 文本 C1973121
						423 文本 C编号匹配
					424 项 扩展库
						425 文本 扩展库
					426 项 使用：7 库存： 2701 单价：￥0.835
						427 文本 使用：7
						428 文本 库存：
						429 文本 2701
						430 文本 单价：￥
						431 文本 0.835
					432 项 买1盘，立省 ￥2.612 提示 再送换料费券：￥300 立即购买整盘
						433 文本 买1盘，
						434 文本 立省
						435 文本 ￥
						436 文本 2.612
						437 未加标签的图片 提示
						438 文本 再送
						439 文本 换料费券：
						440 文本 ￥
						441 文本 300
						442 文本 立即购买整盘
					443 项 替换 邮寄 删除
						444 按钮 替换
						445 按钮 邮寄
						446 按钮 删除
				447 custom
					448 项 editIcon
						449 复选框
						450 图像 editIcon
					451 项 J401、J402 2个器件
						452 文本 J401
						453 文本 、
						454 文本 J402
						455 文本 2
						456 文本 个器件
					457 项
					458 项 1x3P 间距:2mm 直插 CNJMA2007WV-3P
						459 文本 1x3P 间距:2mm 直插
						460 文本 CNJMA2007WV-3P
					461 项 插件,P=2mm AMP2007_3P_B
						462 文本 插件,P=2mm
						463 文本 AMP2007_3P_B
					464 项 C5151076 C5151076 C编号匹配
						465 文本 C5151076
						466 文本 C5151076
						467 文本 C编号匹配
					468 项 扩展库 (插装)
						469 文本 扩展库
						470 文本 (插装)
					471 项 使用：13 库存： 346 单价：￥0.18
						472 文本 使用：13
						473 文本 库存：
						474 文本 346
						475 文本 单价：￥
						476 文本 0.18
					477 项 买1盘，约省 ￥0.897 提示 立即购买整盘
						478 文本 买1盘，
						479 文本 约省
						480 文本 ￥
						481 文本 0.897
						482 未加标签的图片 提示
						483 文本 立即购买整盘
					484 项 替换 邮寄 删除
						485 按钮 替换
						486 按钮 邮寄
						487 按钮 删除
				488 custom
					489 项 editIcon
						490 复选框
						491 图像 editIcon
					492 项 R721、R722 2个器件
						493 文本 R721
						494 文本 、
						495 文本 R722
						496 文本 2
						497 文本 个器件
					498 项
					499 项 厚膜电阻 2.2kΩ ±1% 100mW 0603WAF2201T5E
						500 文本 厚膜电阻 2.2kΩ ±1% 100mW
						501 文本 0603WAF2201T5E
					502 项 0603 0603
						503 文本 0603
						504 文本 0603
					505 项 C4190 C4190 C编号匹配
						506 文本 C4190
						507 文本 C4190
						508 文本 C编号匹配
					509 项 基础库
						510 文本 基础库
					511 项 使用：20 库存： 5257553 单价：￥0.0109
						512 文本 使用：20
						513 文本 库存：
						514 文本 5257553
						515 文本 单价：￥
						516 文本 0.0109
					517 项 买1盘，立省 ￥0.093 提示 再送换料费券：￥300 立即购买整盘
						518 文本 买1盘，
						519 文本 立省
						520 文本 ￥
						521 文本 0.093
						522 未加标签的图片 提示
						523 文本 再送
						524 文本 换料费券：
						525 文本 ￥
						526 文本 300
						527 文本 立即购买整盘
					528 项 替换 邮寄 删除
						529 按钮 替换
						530 按钮 邮寄
						531 按钮 删除
				532 custom
					533 项 editIcon
						534 复选框
						535 图像 editIcon
					536 项 R301 1个器件
						537 文本 R301
						538 文本 1
						539 文本 个器件
					540 项
					541 项 厚膜电阻 100Ω ±1% 100mW 0603WAF1000T5E
						542 文本 厚膜电阻 100Ω ±1% 100mW
						543 文本 0603WAF1000T5E
					544 项 0603 0603
						545 文本 0603
						546 文本 0603
					547 项 C22775 C22775 C编号匹配
						548 文本 C22775
						549 文本 C22775
						550 文本 C编号匹配
					551 项 基础库
						552 文本 基础库
					553 项 使用：20 库存： 8733977 单价：￥0.0149
						554 文本 使用：20
						555 文本 库存：
						556 文本 8733977
						557 文本 单价：￥
						558 文本 0.0149
					559 项 买1盘，立省 ￥0.108 提示 再送换料费券：￥300 立即购买整盘
						560 文本 买1盘，
						561 文本 立省
						562 文本 ￥
						563 文本 0.108
						564 未加标签的图片 提示
						565 文本 再送
						566 文本 换料费券：
						567 文本 ￥
						568 文本 300
						569 文本 立即购买整盘
					570 项 替换 邮寄 删除
						571 按钮 替换
						572 按钮 邮寄
						573 按钮 删除
				574 custom
					575 项 editIcon
						576 复选框
						577 图像 editIcon
					578 项 U802 1个器件
						579 文本 U802
						580 文本 1
						581 文本 个器件
					582 项
					583 项 单总线缓冲门，带三态输出 SN74LVC1G125DBVR
						584 文本 单总线缓冲门，带三态输出
						585 文本 SN74LVC1G125DBVR
					586 项 SOT-23-5 SOT-23-5
						587 文本 SOT-23-5
						588 文本 SOT-23-5
					589 项 C23654 C23654 C编号匹配
						590 文本 C23654
						591 文本 C23654
						592 文本 C编号匹配
					593 项 扩展库
						594 文本 扩展库
					595 项 使用：9 库存： 159246 单价：￥0.407
						596 文本 使用：9
						597 文本 库存：
						598 文本 159246
						599 文本 单价：￥
						600 文本 0.407
					601 项 买1盘，立省 ￥1.701 提示 再送换料费券：￥300 立即购买整盘
						602 文本 买1盘，
						603 文本 立省
						604 文本 ￥
						605 文本 1.701
						606 未加标签的图片 提示
						607 文本 再送
						608 文本 换料费券：
						609 文本 ￥
						610 文本 300
						611 文本 立即购买整盘
					612 项 替换 邮寄 删除
						613 按钮 替换
						614 按钮 邮寄
						615 按钮 删除
				616 custom
					617 项 editIcon
						618 复选框
						619 图像 editIcon
					620 项 Y701 1个器件
						621 文本 Y701
						622 文本 1
						623 文本 个器件
					624 项
					625 项 YSO110TR 12MHZ 1.8V-3.3V ±10PPM -40~85℃ (±20PPM) CMOS OT3EL89CJI-111YLC-12M
						626 文本 YSO110TR 12MHZ 1.8V-3.3V ±10PPM -40~85℃ (±20PPM) CMOS
						627 文本 OT3EL89CJI-111YLC-12M
					628 项 SMD2520-4P YXC_2520_YSO110TR_B
						629 文本 SMD2520-4P
						630 文本 YXC_2520_YSO110TR_B
					631 项 C7425459 C7425459 C编号匹配
						632 文本 C7425459
						633 文本 C7425459
						634 文本 C编号匹配
					635 项 扩展库
						636 文本 扩展库
					637 项 使用：5 库存： 6242 单价：￥3.249
						638 文本 使用：5
						639 文本 库存：
						640 文本 6242
						641 文本 单价：￥
						642 文本 3.249
					643 项 买1盘，立省 ￥8.508 提示 再送换料费券：￥300 立即购买整盘
						644 文本 买1盘，
						645 文本 立省
						646 文本 ￥
						647 文本 8.508
						648 未加标签的图片 提示
						649 文本 再送
						650 文本 换料费券：
						651 文本 ￥
						652 文本 300
						653 文本 立即购买整盘
					654 项 替换 邮寄 删除
						655 按钮 替换
						656 按钮 邮寄
						657 按钮 删除
				658 custom
					659 项 editIcon
						660 复选框
						661 图像 editIcon
					662 项
					663 项 J101 1个器件
						664 文本 J101
						665 文本 1
						666 文本 个器件
					667 项 【插件】2x20P 间距:2.54mm 直插 2.54-2*20
						668 文本 【插件】2x20P 间距:2.54mm 直插
						669 文本 2.54-2*20
					670 项 插件,P=2.54mm Radxa40P_Zhouri_B
						671 文本 插件,P=2.54mm
						672 文本 Radxa40P_Zhouri_B
					673 项 C2977589 C2977589 C编号匹配
						674 文本 C2977589
						675 文本 C2977589
						676 文本 C编号匹配
					677 项 扩展库 (插装)
						678 文本 扩展库
						679 文本 (插装)
					680 项 使用：5 库存： 35101 单价：￥1.857
						681 文本 使用：5
						682 文本 库存：
						683 文本 35101
						684 文本 单价：￥
						685 文本 1.857
					686 项 买1盘，立省 ￥2.583 提示 立即购买整盘
						687 文本 买1盘，
						688 文本 立省
						689 文本 ￥
						690 文本 2.583
						691 未加标签的图片 提示
						692 文本 立即购买整盘
					693 项 替换 邮寄 删除
						694 按钮 替换
						695 按钮 邮寄
						696 按钮 删除
				697 custom
					698 项 editIcon
						699 复选框
						700 图像 editIcon
					701 项 J502 1个器件
						702 文本 J502
						703 文本 1
						704 文本 个器件
					705 项
					706 项 1x4P 间距:1mm 立贴 BM04B-SRSS-TB(LF)(SN)
						707 文本 1x4P 间距:1mm 立贴
						708 文本 BM04B-SRSS-TB(LF)(SN)
					709 项 SMD,P=1mm JST_SH_BM04B-SRSS-TB_1x04-1MP_P1.00mm_Vertical
						710 文本 SMD,P=1mm
						711 文本 JST_SH_BM04B-SRSS-TB_1x04-1MP_P1.00mm_Vertical
					712 项 C160390 C160390 C编号匹配
						713 文本 C160390
						714 文本 C160390
						715 文本 C编号匹配
					716 项 扩展库
						717 文本 扩展库
					718 项 使用：6 库存： 16580 单价：￥1.556
						719 文本 使用：6
						720 文本 库存：
						721 文本 16580
						722 文本 单价：￥
						723 文本 1.556
					724 项 买1盘，约省 ￥3.582 提示 再送换料费券：￥300 立即购买整盘
						725 文本 买1盘，
						726 文本 约省
						727 文本 ￥
						728 文本 3.582
						729 未加标签的图片 提示
						730 文本 再送
						731 文本 换料费券：
						732 文本 ￥
						733 文本 300
						734 文本 立即购买整盘
					735 项 替换 邮寄 删除
						736 按钮 替换
						737 按钮 邮寄
						738 按钮 删除
				739 custom
					740 项 editIcon
						741 复选框
						742 图像 editIcon
					743 项 C302、C305、C401、C402、C701、C704、C705、C707、C709、C711、C713、C721、C725、C735、C737 15个器件
						744 文本 C302
						745 文本 、
						746 文本 C305
						747 文本 、
						748 文本 C401
						749 文本 、
						750 文本 C402
						751 文本 、
						752 文本 C701
						753 文本 、
						754 文本 C704
						755 文本 、
						756 文本 C705
						757 文本 、
						758 文本 C707
						759 文本 、
						760 文本 C709
						761 文本 、
						762 文本 C711
						763 文本 、
						764 文本 C713
						765 文本 、
						766 文本 C721
						767 文本 、
						768 文本 C725
						769 文本 、
						770 文本 C735
						771 文本 、
						772 文本 C737
						773 文本 15
						774 文本 个器件
					775 项
					776 项 100nF ±10% 50V CC0603KRX7R9BB104
						777 文本 100nF ±10% 50V
						778 文本 CC0603KRX7R9BB104
					779 项 0603 0603
						780 文本 0603
						781 文本 0603
					782 项 C14663 C14663 C编号匹配
						783 文本 C14663
						784 文本 C14663
						785 文本 C编号匹配
					786 项 基础库
						787 文本 基础库
					788 项 使用：85 库存： 37632405 单价：￥0.056
						789 文本 使用：85
						790 文本 库存：
						791 文本 37632405
						792 文本 单价：￥
						793 文本 0.056
					794 项 买1盘，立省 ￥2.226 提示 再送换料费券：￥300 立即购买整盘
						795 文本 买1盘，
						796 文本 立省
						797 文本 ￥
						798 文本 2.226
						799 未加标签的图片 提示
						800 文本 再送
						801 文本 换料费券：
						802 文本 ￥
						803 文本 300
						804 文本 立即购买整盘
					805 项 替换 邮寄 删除
						806 按钮 替换
						807 按钮 邮寄
						808 按钮 删除
				809 custom
					810 项 editIcon
						811 复选框
						812 图像 editIcon
					813 项 C301 1个器件
						814 文本 C301
						815 文本 1
						816 文本 个器件
					817 项
					818 项 10uF ±10% 35V C3216X7R1V106KT000E
						819 文本 10uF ±10% 35V
						820 文本 C3216X7R1V106KT000E
					821 项 1206 1206
						822 文本 1206
						823 文本 1206
					824 项 C76666 C76666 C编号匹配
						825 文本 C76666
						826 文本 C76666
						827 文本 C编号匹配
					828 项 扩展库
						829 文本 扩展库
					830 项 使用：5 库存： 5448 单价：￥2.289
						831 文本 使用：5
						832 文本 库存：
						833 文本 5448
						834 文本 单价：￥
						835 文本 2.289
					836 项 买1盘，立省 ￥6.224 提示 再送换料费券：￥300 立即购买整盘
						837 文本 买1盘，
						838 文本 立省
						839 文本 ￥
						840 文本 6.224
						841 未加标签的图片 提示
						842 文本 再送
						843 文本 换料费券：
						844 文本 ￥
						845 文本 300
						846 文本 立即购买整盘
					847 项 替换 邮寄 删除
						848 按钮 替换
						849 按钮 邮寄
						850 按钮 删除
				851 custom
					852 项 editIcon
						853 复选框
						854 图像 editIcon
					855 项 Q301 1个器件
						856 文本 Q301
						857 文本 1
						858 文本 个器件
					859 项
					860 项 AO3404A AO3404A
						861 文本 AO3404A
						862 文本 AO3404A
					863 项 SOT-23 SOT-23
						864 文本 SOT-23
						865 文本 SOT-23
					866 项 C30010 C30010 C编号匹配
						867 文本 C30010
						868 文本 C30010
						869 文本 C编号匹配
					870 项 扩展库
						871 文本 扩展库
					872 项 使用：7 库存： 13345 单价：￥0.701
						873 文本 使用：7
						874 文本 库存：
						875 文本 13345
						876 文本 单价：￥
						877 文本 0.701
					878 项 买1盘，立省 ￥2.466 提示 再送换料费券：￥300 立即购买整盘
						879 文本 买1盘，
						880 文本 立省
						881 文本 ￥
						882 文本 2.466
						883 未加标签的图片 提示
						884 文本 再送
						885 文本 换料费券：
						886 文本 ￥
						887 文本 300
						888 文本 立即购买整盘
					889 项 替换 邮寄 删除
						890 按钮 替换
						891 按钮 邮寄
						892 按钮 删除
				893 custom
					894 项 editIcon
						895 复选框
						896 图像 editIcon
					897 项 U702 1个器件
						898 文本 U702
						899 文本 1
						900 文本 个器件
					901 项
					902 项 1.8V 250mA 8V XC6206P182MR
						903 文本 1.8V 250mA 8V
						904 文本 XC6206P182MR
					905 项 SOT-23 UMW_XC6206_SOT23_B
						906 文本 SOT-23
						907 文本 UMW_XC6206_SOT23_B
					908 项 C347373 C347373 C编号匹配
						909 文本 C347373
						910 文本 C347373
						911 文本 C编号匹配
					912 项 扩展库
						913 文本 扩展库
					914 项 使用：10 库存： 56492 单价：￥0.128
						915 文本 使用：10
						916 文本 库存：
						917 文本 56492
						918 文本 单价：￥
						919 文本 0.128
					920 项 买1盘，立省 ￥0.569 提示 再送换料费券：￥300 立即购买整盘
						921 文本 买1盘，
						922 文本 立省
						923 文本 ￥
						924 文本 0.569
						925 未加标签的图片 提示
						926 文本 再送
						927 文本 换料费券：
						928 文本 ￥
						929 文本 300
						930 文本 立即购买整盘
					931 项 替换 邮寄 删除
						932 按钮 替换
						933 按钮 邮寄
						934 按钮 删除
				935 custom
					936 项 editIcon
						937 复选框
						938 图像 editIcon
					939 项 C703、C734、C736 3个器件
						940 文本 C703
						941 文本 、
						942 文本 C734
						943 文本 、
						944 文本 C736
						945 文本 3
						946 文本 个器件
					947 项
					948 项 10uF ±10% 10V C1608X5R1A106KT000E
						949 文本 10uF ±10% 10V
						950 文本 C1608X5R1A106KT000E
					951 项 0603 0603
						952 文本 0603
						953 文本 0603
					954 项 C76608 C76608 C编号匹配
						955 文本 C76608
						956 文本 C76608
						957 文本 C编号匹配
					958 项 扩展库
						959 文本 扩展库
					960 项 使用：23 库存： 8666 单价：￥0.533
						961 文本 使用：23
						962 文本 库存：
						963 文本 8666
						964 文本 单价：￥
						965 文本 0.533
					966 项 买1盘，立省 ￥5.213 提示 再送换料费券：￥300 立即购买整盘
						967 文本 买1盘，
						968 文本 立省
						969 文本 ￥
						970 文本 5.213
						971 未加标签的图片 提示
						972 文本 再送
						973 文本 换料费券：
						974 文本 ￥
						975 文本 300
						976 文本 立即购买整盘
					977 项 替换 邮寄 删除
						978 按钮 替换
						979 按钮 邮寄
						980 按钮 删除
				981 custom
					982 项 editIcon
						983 复选框
						984 图像 editIcon
					985 项 D401 1个器件
						986 文本 D401
						987 文本 1
						988 文本 个器件
					989 项
					990 项 BZT52C5V1S-7-F BZT52C5V1S-7-F
						991 文本 BZT52C5V1S-7-F
						992 文本 BZT52C5V1S-7-F
					993 项 SOD-323 D_SOD-323
						994 文本 SOD-323
						995 文本 D_SOD-323
					996 项 C151348 C151348 C编号匹配
						997 文本 C151348
						998 文本 C151348
						999 文本 C编号匹配
					1000 项 扩展库
						1001 文本 扩展库
					1002 项 使用：11 库存： 58478 单价：￥0.216
						1003 文本 使用：11
						1004 文本 库存：
						1005 文本 58478
						1006 文本 单价：￥
						1007 文本 0.216
					1008 项 买1盘，立省 ￥1.081 提示 再送换料费券：￥300 立即购买整盘
						1009 文本 买1盘，
						1010 文本 立省
						1011 文本 ￥
						1012 文本 1.081
						1013 未加标签的图片 提示
						1014 文本 再送
						1015 文本 换料费券：
						1016 文本 ￥
						1017 文本 300
						1018 文本 立即购买整盘
					1019 项 替换 邮寄 删除
						1020 按钮 替换
						1021 按钮 邮寄
						1022 按钮 删除
				1023 custom
					1024 项 editIcon
						1025 复选框
						1026 图像 editIcon
					1027 项 U803 1个器件
						1028 文本 U803
						1029 文本 1
						1030 文本 个器件
					1031 项
					1032 项 5W立体声D, AB类音频功率放大器 PAM8406DR
						1033 文本 5W立体声D, AB类音频功率放大器
						1034 文本 PAM8406DR
					1035 项 SOIC-16 SOIC-16_3.9x9.9mm_P1.27mm
						1036 文本 SOIC-16
						1037 文本 SOIC-16_3.9x9.9mm_P1.27mm
					1038 项 C86270 C86270 C编号匹配
						1039 文本 C86270
						1040 文本 C86270
						1041 文本 C编号匹配
					1042 项 扩展库
						1043 文本 扩展库
					1044 项 使用：5 库存： 21441 单价：￥2.81
						1045 文本 使用：5
						1046 文本 库存：
						1047 文本 21441
						1048 文本 单价：￥
						1049 文本 2.81
					1050 项 买1盘，立省 ￥7.748 提示 再送换料费券：￥300 立即购买整盘
						1051 文本 买1盘，
						1052 文本 立省
						1053 文本 ￥
						1054 文本 7.748
						1055 未加标签的图片 提示
						1056 文本 再送
						1057 文本 换料费券：
						1058 文本 ￥
						1059 文本 300
						1060 文本 立即购买整盘
					1061 项 替换 邮寄 删除
						1062 按钮 替换
						1063 按钮 邮寄
						1064 按钮 删除
				1065 custom
					1066 项 editIcon
						1067 复选框
						1068 图像 editIcon
					1069 项 FB702、FB703 2个器件
						1070 文本 FB702
						1071 文本 、
						1072 文本 FB703
						1073 文本 2
						1074 文本 个器件
					1075 项
					1076 项 120 Ω @ 100MHz 2A PE-0603PFB121ST
						1077 文本 120 Ω @ 100MHz 2A
						1078 文本 PE-0603PFB121ST
					1079 项 0603 0603
						1080 文本 0603
						1081 文本 0603
					1082 项 C2661472 C2661472 C编号匹配
						1083 文本 C2661472
						1084 文本 C2661472
						1085 文本 C编号匹配
					1086 项 扩展库
						1087 文本 扩展库
					1088 项 使用：14 库存： 1573 单价：￥0.314
						1089 文本 使用：14
						1090 文本 库存：
						1091 文本 1573
						1092 文本 单价：￥
						1093 文本 0.314
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
						1288 文本 C708
						1289 文本 、
						1290 文本 C710
						1291 文本 、
						1292 文本 C712
						1293 文本 、
						1294 文本 C722
						1295 文本 、
						1296 文本 C723
						1297 文本 、
						1298 文本 C724
						1299 文本 、
						1300 文本 C731
						1301 文本 、
						1302 文本 C732
						1303 文本 、
						1304 文本 C733
						1305 文本 、
						1306 文本 C738
						1307 文本 12
						1308 文本 个器件
					1309 项
					1310 项 1uF ±10% 50V CL10A105KB8NNNC
						1311 文本 1uF ±10% 50V
						1312 文本 CL10A105KB8NNNC
					1313 项 0603 0603
						1314 文本 0603
						1315 文本 0603
					1316 项 C15849 C15849 C编号匹配
						1317 文本 C15849
						1318 文本 C15849
						1319 文本 C编号匹配
					1320 项 基础库
						1321 文本 基础库
					1322 项 使用：70 库存： 12117126 单价：￥0.0884
						1323 文本 使用：70
						1324 文本 库存：
						1325 文本 12117126
						1326 文本 单价：￥
						1327 文本 0.0884
					1328 项 买1盘，立省 ￥2.827 提示 再送换料费券：￥300 立即购买整盘
						1329 文本 买1盘，
						1330 文本 立省
						1331 文本 ￥
						1332 文本 2.827
						1333 未加标签的图片 提示
						1334 文本 再送
						1335 文本 换料费券：
						1336 文本 ￥
						1337 文本 300
						1338 文本 立即购买整盘
					1339 项 替换 邮寄 删除
						1340 按钮 替换
						1341 按钮 邮寄
						1342 按钮 删除
				1343 custom
					1344 项 editIcon
						1345 复选框
						1346 图像 editIcon
					1347 项 J505、J507、J506 3个器件
						1348 文本 J505
						1349 文本 、
						1350 文本 J507
						1351 文本 、
						1352 文本 J506
						1353 文本 3
						1354 文本 个器件
					1355 项
					1356 项 【插件】1x2P 间距:1.25mm 直插 A1251WV-2P
						1357 文本 【插件】1x2P 间距:1.25mm 直插
						1358 文本 A1251WV-2P
					1359 项 插件,P=1.25mm A1251_2P_B
						1360 文本 插件,P=1.25mm
						1361 文本 A1251_2P_B
					1362 项 C5333427 C5333427 C编号匹配
						1363 文本 C5333427
						1364 文本 C5333427
						1365 文本 C编号匹配
					1366 项 扩展库 (插装)
						1367 文本 扩展库
						1368 文本 (插装)
					1369 项 使用：19 库存： 8568 单价：￥0.344
						1370 文本 使用：19
						1371 文本 库存：
						1372 文本 8568
						1373 文本 单价：￥
						1374 文本 0.344
					1375 项 买1盘，立省 ￥3.110 提示 立即购买整盘
						1376 文本 买1盘，
						1377 文本 立省
						1378 文本 ￥
						1379 文本 3.110
						1380 未加标签的图片 提示
						1381 文本 立即购买整盘
					1382 项 替换 邮寄 删除
						1383 按钮 替换
						1384 按钮 邮寄
						1385 按钮 删除
				1386 custom
					1387 项 editIcon
						1388 复选框
						1389 图像 editIcon
					1390 项 U302 1个器件
						1391 文本 U302
						1392 文本 1
						1393 文本 个器件
					1394 项
					1395 项 高端或-ing FET控制器 LM5050MKX-1/NOPB
						1396 文本 高端或-ing FET控制器
						1397 文本 LM5050MKX-1/NOPB
					1398 项 TSOT-23-6 TSOT-23-6
						1399 文本 TSOT-23-6
						1400 文本 TSOT-23-6
					1401 项 C473393 C473393 C编号匹配
						1402 文本 C473393
						1403 文本 C473393
						1404 文本 C编号匹配
					1405 项 扩展库
						1406 文本 扩展库
					1407 项 使用：5 库存： 34368 单价：￥5.17
						1408 文本 使用：5
						1409 文本 库存：
						1410 文本 34368
						1411 文本 单价：￥
						1412 文本 5.17
					1413 项 买1盘，立省 ￥11.640 提示 再送换料费券：￥300 立即购买整盘
						1414 文本 买1盘，
						1415 文本 立省
						1416 文本 ￥
						1417 文本 11.640
						1418 未加标签的图片 提示
						1419 文本 再送
						1420 文本 换料费券：
						1421 文本 ￥
						1422 文本 300
						1423 文本 立即购买整盘
					1424 项 替换 邮寄 删除
						1425 按钮 替换
						1426 按钮 邮寄
						1427 按钮 删除
			1428 列表
				1429 列表项目 (selectable) 撤销(Ctrl+Z)
				1430 列表项目 (selectable) 重做(Ctrl+Y)
				1431 列表项目 (selectable)
				1432 列表项目 (selectable) 放大(A)
				1433 列表项目 (selectable) 缩小(Z)
				1434 列表项目 (selectable) 适应选中
				1435 列表项目 (selectable) 自适应窗口(K)
				1436 列表项目 (selectable)
				1437 列表项目 (selectable) 自动对齐
				1438 列表项目 (selectable) 板子翻转
				1439 列表项目 (selectable) 整体逆时针旋转
				1440 列表项目 (selectable) 整体顺时针旋转
				1441 列表项目 (selectable) 独立逆时针旋转
				1442 列表项目 (selectable) 独立顺时针旋转
				1443 列表项目 (selectable) 旋转角度
				1445 列表项目 (selectable)
				1446 列表项目 (selectable) 导出图片
				1447 列表项目 (selectable) 修复板框
				1448 列表项目 (selectable) 设置
			1449 按钮 预览不正常？
			1450 文本 顶层
			1451 文本 底层
			1452 复选框 选中顶层器件 ID: smt_preview_select_all_top_devices
			1453 复选框 选中底层器件 ID: smt_preview_select_all_bottom_devices
			1454 文本 切换单位：
			1455 单选按钮 (selectable)
			1456 文本 mm
			1457 单选按钮 (selectable)
			1458 文本 mil
			1459 文本 2D
			1460 文本 3D
			1461 图像 ID: smt-engine-canvas
			1462 文本 选中 1 个器件，全部都在顶层。
			1463 文本 下载结果(PDF)
			1464 文本 存档当前操作
			1465 文本 备料完成，下一步
			1467 文本 嘉立创下单助手
			1468 文本 嘉立创EDA专业版
			1469 文本 机械/电气零部件商城
			1470 文本 嘉立创云ERP
			1471 文本 v5.1.26
			1473 文本 嘉立创客户中心
			1474 文本 SMT贴片下单_PCBA在线下单_SMT贴片报价｜嘉立创SMT
			1475 文本 嘉立创-PCB订单列表
			1476 文本 贴片元器件库
			1477 文本 嘉立创-选择文件下单
			1478 文本 嘉立创SMT贴片加工 | PCBA加工厂家 | 一站式电子组装服务
			1479 文本 嘉立创-PCB订单列表
			1480 文本 嘉立创SMT_一站式PCBA服务平台_SMT贴片_PCBA贴片_SMT工厂_PCBA工厂
		1481 窗格 (disabled)
		1482 窗格
			1483 窗格
				1484 窗格
					1485 窗格
						1486 窗格
							1487 窗格
							1488 窗格
								1489 窗格

Document text: ```
```
