parkourlrc/pcb-yilv1982--duck-robot-89dbc81d6d/docs/references/自主扩展板与社区版成本比较/cost-breakdown.md

# 五片批次目录材料成本明细

2026-11-04；纯板上净用量，含目录标示税价，不含备损、制造/贴装、THT手焊和运费。缺货项仅参考价格，不能购买整套BOM。A.2为未实施方案。

## kissqy AMP2.0当前工程411878f

已取得价格的板上用料：86/86件；每板小计¥49.3464，5板¥246.7320。

| 位号 | MPN | C编号 | 每板数量 | 单价¥ | 每板小计¥ | 观察库存 |
|---|---|---|---:|---:|---:|---:|
| U2 | TLV320AIC3104IRHBR | C181753 | 1 | 14.9400 | 14.9400 | 1834 |
| U10 | LM5050MKX-1/NOPB | C473393 | 1 | 5.1700 | 5.1700 | 34408 |
| J4 | FH-00339 | C2685112 | 1 | 3.6000 | 3.6000 | 11564 |
| Y1 | OT3EL89CJI-111YLC-12M | C7425459 | 1 | 3.2490 | 3.2490 | 6307 |
| U9 | AP63205WU-7 | C2071056 | 1 | 2.8200 | 2.8200 | 23265 |
| U1 | PAM8406DR | C86270 | 1 | 2.8100 | 2.8100 | 21451 |
| C5,C7,C12,C13,C37 | C1608X5R1A106KT000E | C76608 | 5 | 0.5330 | 2.6650 | 14260 |
| C15 | C3216X7R1V106KT000E | C76666 | 1 | 2.2890 | 2.2890 | 6268 |
| C1,C2,C3,C4,C6,C10,C27,C29,C31,C33,C35,C40,C41,C42,C43 | CC0603KRX5R9BB105 | C128624 | 15 | 0.1320 | 1.9800 | 288324 |
| Q2 | SI2312CDS-T1-GE3 | C142518 | 1 | 1.8490 | 1.8490 | 13748 |
| C21,C22 | GRM188R61A226ME15D | C84419 | 2 | 0.5610 | 1.1220 | 197675 |
| J5 | BM04B-SRSS-TB(LF)(SN) | C160390 | 1 | 0.9590 | 0.9590 | 16910 |
| C11,C14,C16,C17,C18,C20,C26,C28,C30,C32,C36,C38,C39 | CC0603KRX7R9BB104 | C14663 | 13 | 0.0502 | 0.6526 | 38105984 |
| MK1 | LMA2718T421-OA5-2 | C7587901 | 1 | 0.6510 | 0.6510 | 9767 |
| FB2,FB3 | PE-0603PFB121ST | C2661472 | 2 | 0.3140 | 0.6280 | 1597 |
| J1,J2,J9 | A1251WV-2P | C225090 | 3 | 0.1880 | 0.5640 | 0 |
| L4 | SWPA6045S6R8MT | C57254 | 1 | 0.5250 | 0.5250 | 22641 |
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
| R501,R502 | CRCW04024K70FKED | C482193 | 2 | 0.0208 | 0.0416 | 56981 |
| R312 | CRCW04022K20FKED | C82680 | 1 | 0.0249 | 0.0249 | 270786 |
| R308 | CRCW040210K0FKED | C71617 | 1 | 0.0204 | 0.0204 | 1773443 |
| C308,C328,C309 | C0805C225K5RACTU | 待纠正 | 3 | 未取得 | 不计入 | 未核 |
