parkourlrc/pcb-yilv1982--duck-robot-89dbc81d6d/docs/references/消费电子玩具市场研究/parts/capital-2026.md

# FIN26｜2026 消费电子玩具投融资证据分片

> 研究窗口：**2026-01-01—2026-10-10（Asia/Shanghai）**；优先 **2026-07-13—2026-10-10**。资料访问日均为 **2026-10-10**。本文件由 FIN26 已获确认的分析结果转 Coder 落盘，写入阶段未再联网搜索。
>
> **C101—C108 是 8 条主要融资披露记录，涉及 7 家公司，不是 8 笔精确落在 2026 年且已验证到账的交割。** 澜存科技天使轮、Pre-A 分开记录；FoloToy 的 Pre-A／Pre-A+ 组合披露不擅自拆笔。C109 为跨年未拆清的观察项，C110 为来源较弱的战略投资观察项；C111、C112 仅作 2025 历史纠错，不增加当年融资或平台销量。
>
> “近日完成”“2026 年新闻发布”不能证明资金在 2026 年到账，尤其年初报道可能回溯上一年。发布日、宣布日、协议签署日、交割日、到账日分别处理；未取得交易合同、银行到账、验资或可确认精确交割的监管文件。除另有说明，国内报道日期按其页面所示日期记录，不推算未标时区的精确时间。
>
> 正文成功访问不等于结论经独立审计。原站／转载、企业／投资方自述与独立证据分开；搜索摘要和 AI 概览只作导航。原始网页、HTTP 响应、截图未另存，本文件是 URL、定位、短引及限制记录，不冒充网页历史快照。所有产品本机未测。

## 一、可供整合的结论

- **镭萌 bibo：**时尚／IP 资源与技术资本共同进入非语言情感机器人。融资主体与 bibo 的关联有报道支持，但产品实际上市日期存在跨来源差异，见 C102，不替换旧 E10 的产品时间线。
- **澜存：**资本进入模组、运行平台、设备管理和模型调用运营能力。属于相关平台／方案资金，不能全算整机或机器宠物融资。
- **珞博：**投资方官网确认参与 Pre-A，将资本与蜂窝模组、全球连接／资费服务联动；7 月新闻回溯年初完成，不是近 90 天新交割。
- **物外智趣：**资本进入儿童主动式陪伴硬件研发；首款偏轻便穿戴，属于相邻消费硬件，不冒称已上市机器宠物。
- FoloToy 和可以科技补充年初披露的研发、产品化和量产资金方向；“近日”不自动归为当年到账。披露的资金用途是计划／意图，不代表已执行成效。
- 不汇总融资金额，不估计行业总融资、平均轮额、同比增速或资本偏好排名；不作投资建议。不把少数新闻推成市场规模。

### 记录导航与时间处理

| 编号 | 对象 | 已核验披露时间 | 金额／轮次原始口径 | 整合处理 |
|---|---|---|---|---|
| [C101](#c101) | 物外智趣 | 10-10 | 数千万元人民币，天使轮 | 近 90 天披露；称近日完成，精确交割／到账日不明 |
| [C102](#c102) | 镭萌科技／bibo | 09-09 | “千万级”，天使轮；未明币种 | 近 90 天宣布完成；不补金额币种或产品实际上市日 |
| [C103](#c103) | 澜存 Pre-A | 已读最早 08-13；08-19 再报道 | 数千万元，Pre-A 股权融资 | 同一轮，不重复计数；具体交割日不明 |
| [C104](#c104) | 珞博 Pre-A | 官网文内 2026 年 4 月；媒体 07-13／14 | 亿元级 Pre-A | 年初完成的报道、4 月官方参与确认、7 月再披露；不是 7 月新交割 |
| [C105](#c105) | FoloToy | 01-30；02-12 后续采访 | 数千万元，Pre-A／Pre-A+ | 合并披露；不能拆成两笔各数千万元；年初“近日”不证明当年到账 |
| [C106](#c106) | 可以科技／KEYi | 已读全文最早 01-06；01-07 补证 | 超亿元人民币，新一轮 | 准确轮次未核；B+ 路演另列计划；年初“近日”不证明当年到账 |
| [C107](#c107) | 澜存天使轮 | 04-08 | 数千万元，天使轮 | 与 C103 不同轮次；领投名称口径差异保留 |
| [C108](#c108) | MOMOTOY 品牌 | 04-03；04-10 后续稿 | 数千万元首轮；投后估值 2.5 亿元 | 品牌受资报道；实际受资法人未核，估值不计融资额 |
| [C109](#c109) | 灵机天赐／Jollybubu | 04-20 | 过去一年两轮合计数千万元人民币 | 跨年未拆，不能全计 2026 新增，观察项 |
| [C110](#c110) | 中软创达 | 08-31；称 08-13 签协议 | 战略投资额未披露；投前估值 USD 1 亿 | 弱来源观察，不列已验证交割，不把估值充融资额 |
| [C111](#c111) | Haivivi／跃然创新 | 2026-09-18 文回溯 2025-08 | 2 亿元 A 轮系列融资 | 仅旧期纠错，排除 2026 新融资 |
| [C112](#c112) | Ropet／萌友智能 | 2026-04-13 文回溯 2025-09／11 | 累计超 USD 10 million | 两批 2025 交割的报道，排除 2026 新资本 |

**币种与交易工具规则：**只写“万元／亿元”的来源原样保留，注明未另明币种，不把境内人民币语境升级成合同币种核验；“千万级”连币种也不补。除 C103 明确写“股权融资”、C104 有投资方参与确认外，多数仅是创投轮融资披露，未拆新股增资、老股转让、可转债、分期到账等工具。不得仅凭轮次就断言全为新增实收股本。本组未取得可核验的债务融资或并购事件，不为了分类或数量填充。

## 二、主要融资披露 C101—C108

### C101｜物外智趣：儿童陪伴硬件的早期研发资金

**来源与访问**

1. [《AI硬件公司物外智趣获数千万元天使轮融资》](https://finance.eastmoney.com/a/202610103891899486.html)，东方财富转载 **科创板日报**。发布 **2026-10-10 14:06**；分析阶段 HTTP 200，快讯全文读取成功。
2. [《理想AI眼镜操盘手创业儿童硬件，已完成千万元天使轮》](http://www.duozhi.com/industry/insight/2026101018877.shtml)，**多知，作者冯玮**。发布 **2026-10-10 14:29:43**；分析阶段 CUA 原站全文读取成功。

**短引与定位：**来源 1 正文首段：“近日完成数千万元人民币天使轮融资”，并列柏睿资本、高秉强教授、高锋耐心资本。来源 2 首段：“上海物外智趣科技有限公司”；产品方向第 3 点：“首款产品为轻便的可穿戴硬件”。

- **主体／产品：**上海物外智趣科技有限公司；融资报道和产品方向关联明确。聚焦 3—8 岁儿童，首款方向为轻便可穿戴硬件、随身早教／认知陪伴。属于儿童陪伴相邻硬件，不是已经验证的毛绒玩具或机器宠物整机。主体来自媒体正文，未另核工商及融资载体。
- **金额／币种／轮次：**数千万元 **人民币**，天使轮，未给精确金额；不是估值或累计销售额。具体股权／可转债工具未披露。
- **投资人：**柏睿资本、天使投资人高秉强、高锋耐心资本；所采正文没有一致明确领投／跟投次序，不补排序。棕榈资本为财务顾问，不是投资方。
- **日期／状态：**10 月 10 日报道“近日完成”；没有精确宣布、签约、交割或到账日。不能把 10 月 10 日直接填写为交割日。
- **用途：**产品研发、AI 体验建设、核心团队扩充。另称持续推进后续融资，后续轮仅为推进方向，不列第二笔已完成。
- **可支持／不可支持：**支持“资本进入儿童主动交互、记忆及陪伴体验研发”；不证明产品已量产、出售、履约或形成长期使用／付费。多知关于前雇主产品的销量不进入本分片，也不移作物外智趣业绩。
- **独立性／缺口：**多知明确综合硬氪对话及岗位信息；科创板日报快讯也未展示交割凭证。两篇补齐主体和方向，不是两份独立资金到账证明。后续仅在需要认定融资工具／实际交割或产品量产时，补正式文件，不因现有研究自动追加搜索。

### C102｜镭萌科技：bibo 引入时尚及技术投资方

**来源与访问**

1. [《36氪首发丨镭萌科技获千万融资，AI陪伴或许还有另一种可能？》](https://eu.36kr.com/zh/p/3975777320284422)，**36氪，果脯1166**。页面正文显示 **2026-09-09 14:30**；分析阶段 CUA 全文成功。页面外层标题为“36氪首发 镭萌科技获千万融资 AI陪伴赛道开辟全新可能性”。搜索曾显示 9 月 8 日，采用实际正文 9 月 9 日。
2. 原文所链接的 [36氪游戏首发公众号入口](https://mp.weixin.qq.com/s/fWN8XWbEPPVhNrV4dXD_kw)：链接从已打开的来源 1 取得，**该公众号原页本轮未另打开**，不声称核验其独立发布时间或版本。

**短引与定位：**首段：“2026年9月9日……在Inclusion外滩大会现场，宣布完成千万级天使轮融资”；同段：“时尚传媒集团与弘颐资管集团联合领投”。产品段称核心产品 bibo “已于2026年6月正式上市”。

- **主体／产品：**正文称“杭州镭萌科技”，bibo 是其核心产品，关联已获媒体正文支持；完整受资法人名称、投资载体及工商关系本轮未核。bibo 为潮玩形态的非语言情感机器人，不是工业／人形作业机器人；融资并不证明其具体生成式模型实现。
- **金额／币种／轮次：**只披露 **“千万级”天使轮**，未给币种或精确数值；不补为确定人民币金额，不换汇。具体股权、可转债或老股交易工具未公开。
- **投资人：**时尚传媒集团、弘颐资管集团联合领投；实际出资法人不明。
- **日期／状态：**2026-09-09 在大会宣布完成；未披露具体签约、法律交割、分期到账时间。
- **用途：**没有单列募集资金分配。公司公布后续方向为全球渠道、bibo 周边开发与供应链备货、IP 合作与衍生品开发；只能写“公司布局方向”，不能升级为已经执行的资金用途。
- **产品日期冲突，不能覆盖旧线索：**现有 [产品分片 E10](signals-2026-products.md#e10) 所引 [《AI陪伴玩具，为什么开始“闭嘴”了？》](https://znyj.ofweek.com/news/2026-09/ART-23013-8420-30705276.html)（霞光社供稿／OFweek，**2026-09-29 17:12**）记录“自2026年7月正式开售至9月1日”，与本融资报道的“6 月正式上市”不一致。写入阶段只读核对了本地 E10，**未重新访问 OFweek**；其成功访问状态属于已有分片记录。可能是上市、渠道开售或批次口径不同，但没有证据裁决。**保留两种报道表述，实际新品日期待核，不替换旧产品线时间，也不据此增加已交付／生成式新品计数。**
- **可支持／不可支持：**支持资本与时尚 IP、内容及技术资源共同进入情感机器人；不证明资源承诺已转化为销售、利润、护城河或留存。文章中的自报互动数据、市场规模和未来爆发预测不作为本分片判断。
- **独立性／缺口：**单一采访及企业披露，非独立到账核验。投资参与、产品关联和产品日期确定性须分开；精确上市日期、融资工具与交割仍待正式资料。

### C103｜澜存科技 Pre-A：模组及运行平台股权融资

**来源与访问**

1. [《澜存科技三个月内连融两轮，重塑物理世界的「神经系统」》](http://news.10jqka.com.cn/20260813/c678920867.shtml)，同花顺转载 **投资界**；发布 **2026-08-13 10:16:54**。分析阶段 HTTP 200，全文成功。
2. [《澜存科技完成数千万元Pre-A轮股权融资》](https://zx.sina.cn/push/2026-08-19/zx-ininvfss8374479.d.html?oid=4072434187081482)，新浪转载 **界面新闻**；发布 **2026-08-19 10:09**。分析阶段 HTTP 200，快讯全文成功。

**短引与定位：**来源 1 开头融资段：“上海澜存科技有限公司……数千万元Pre-A轮股权融资，本轮投资方为锡创投”；来源 2 首段：“本轮投后估值达到1.5亿元”。来源 1“模组＋平台＋确权”段列澜卡 LC.AI、Hardware AI Runtime 和设备运营能力。

- **主体／产品：**上海澜存科技有限公司；标准 AI 模组、硬件 AI 运行平台、设备管理、OTA 与 Token 用量统计计费。AI 玩具／陪伴产品为应用场景之一，也覆盖穿戴、家居等；属于 **相关模组／平台融资**，不能全算整机资金。
- **金额／币种／轮次：**数千万元，**Pre-A 股权融资**为正文明确口径；报道未给精确数值，中文“元”未另明外币／合同币种，原样保留。投后估值 **1.5 亿元**单列，不计融资额。
- **投资人／顾问：**锡创投；拓界资本是独家财务顾问，不是投资人。具体出资基金法人、股比及增资／老股拆分未披露。
- **日期／状态：**已读最早全文为 08-13，称近日宣布完成；08-19 是同一融资再报道，不新增一笔。搜索出现 08-12 数据库线索，但未据此核实交割日，不采用其作为实际交割时间。
- **用途：**下一代 AI 具身智能基座、核心人才、产品矩阵，LC-1.7 标准模组及运行平台产业化迭代。
- **可支持／不可支持：**支持资本进入模型与物理设备之间的平台／方案层；不证明所有资金用于某款玩具，也不证明延迟、情感识别、安全机制已经独立验证。标题“三个月内”的说法原样作为来源题名，不把它推算为两笔精确到账间隔。
- **独立性／缺口：**投资界及界面均围绕企业披露，不能算两份独立资金验证。法律工具虽明确“股权”，实际交割日、到账额和股权结构仍未核。与 C107 天使轮不是同轮；与本条 08-19 报道是同轮。

### C104｜珞博智能 Pre-A：投资方官网确认，7 月不是新交割

**来源与访问**

1. [《广和通战略投资珞博智能》](https://www.fibocom.com/newscenter/info_itemid_10748.html)，**广和通官网，投资方第一手信息**。正文写“2026年4月”，未见独立精确发布日期字段；分析阶段 CUA 原站全文成功。
2. [《珞博智能完成亿元级Pre-A轮融资》](https://m.jrj.com.cn/madapter/24h/2026/07/13135357778697.shtml)，**金融界，引界面新闻**；发布 **2026-07-13 13:53:06**。分析阶段 HTTP 200，全文成功。
3. [《【会员风采】广和通联合领投珞博智能，全方位助力AI陪伴硬件加速出海》](https://finance.sina.com.cn/wm/2026-07-14/doc-inihunry8491356.shtml)，新浪转载 **深圳市汽车电子行业协会**；发布 **2026-07-14 18:48**。分析阶段 CUA 全文成功。该页链接的 [微信公众号来源](https://mp.weixin.qq.com/s/DQSpu8RGHVJTdZaMu9wYKw) 本轮未另行打开。

**短引与定位：**官网首段：“2026年4月……作为联合领投方，参与完成……PreA轮融资”；来源 2 首段：“宣布已于**2026年初完成**亿元级Pre-A轮融资”。官网直接连接 Fuzozo／芙崽、蜂窝模组、全球 SIM 资费与战略投资。

- **主体／产品：**受资公司以珞博智能／Robopoet 对外披露，相关媒体使用上海珞博智能科技有限公司；本轮融资主证据未展开完整交易法人／出资载体，工商及实际交易结构未核。与 Fuzozo 芙崽系列产品的关联由官网直接确认。
- **供应合作产品声明补证：**来源 1 官网另写：“搭载广和通4G通信模组LE270-CN的芙崽随行版已正式发售面世，率先为国内市场提供全域陪伴AI搭子。”该句把供应方、模组型号与具体产品连接起来；主会话于 2026-10-10 独立打开同页复核并交 IN26 记录，本条不新增独立来源或资本事件。**声明无具体发售日，不是用户签收／本机实测，不证明全部量产履约，也不能据此证明任何 `.net` 美国销售站是官方站或授权渠道。**
- **金额／币种／轮次：**亿元级 Pre-A，金额来自媒体，官网没有给广和通具体出资数额。来源写“亿元级”，未提供精确金额／外币币种，不把整轮金额归给广和通一家。
- **投资人：**华映资本、广和通联合领投；涂鸦智能跟投；红杉中国、金沙江创投继续加码。参与清单来自 7 月媒体；官网独立确认的是广和通自己的参与。
- **日期／状态：**媒体回溯年初完成，官网文内为 4 月参与完成，7 月集中披露。只能明确“完成时点早于近 90 天窗口的报道”，没有精确法律交割日／到账日。**4 月与 7 月不拆成两轮，不记 7 月新到账亿元。**
- **性质／用途：**Pre-A 中的战略投资参与，无控股并购或整家公司收购证据；研发及中长期市场增长储备。具体增资／老股、分期及持股比例不据未读搜索摘要补写。
- **可支持／不可支持：**这是通信模组、全球连接／资费与消费陪伴硬件投资联动的较强证据；不证明投入已降低成本、带来盈利或形成不可替代壁垒。投资方为利益相关方，官网不是银行或监管验资材料。
- **独立性／众筹隔离：**官网、协会和新浪转载属于关联信息链，不当独立三重资金核验。来源 3 的 Makuake 众筹表述仅在第四节作分类注记，不加入 Pre-A 金额，也不新增本分片平台销量数据。

### C105｜FoloToy：今年融资披露可用，“五倍”仍属 2025

**来源与访问**

1. [《一家AI玩具公司获数千万元融资，核心产品销量翻五倍｜硬氪首发》](https://www.36kr.com/p/3654915542130816)，**36氪／硬氪，黄楠，编辑袁斯来**；发布 **2026-01-30 09:30**。分析阶段 HTTP 200，全文成功。
2. [《一年销售翻5倍，海外销量过万，这家上海厂商把AI玩具做出了“活人感”》](https://finance.sina.cn/tech/2026-02-12/detail-inhmpyya2943405.d.html)，新浪转载 **界面新闻**；发布 **2026-02-12 16:45**。分析阶段 HTTP 200，全文成功；为用户提供起点。

**短引与定位：**来源 1“融资金额及投资机构”栏：“融资轮次：Pre-A轮／Pre-A+轮”“融资规模：数千万元”；“业务进度”栏：“**2025年产品销量较上一年翻五倍**”。来源 2 首段明确深创投、南山战新投领投，火火兔持续跟投。

- **主体／产品：**上海喜梨信息科技有限公司，FoloToy 品牌；MagicBox 交互系统、模组、自有 AI 玩偶、企业 IP 定制及行业方案。平台＋终端混合业务，不把全部资金视作自有玩具整机投入。
- **金额／币种／轮次：**数千万元，中文“元”未另明币种，原样记录；Pre-A／Pre-A+ 为首发组合披露。**不拆两笔各数千万元，不猜每轮金额、交易工具或交割年份。**
- **投资人／顾问：**深创投、南山战新投领投，老股东火火兔跟投；指数资本为独家财务顾问，不是投资方。实际出资基金／品牌法人未展开。
- **日期／状态：**01-30 已报道“近日完成”；02-12 为后续采访，不是再融一轮。年初“近日”可能回溯此前时期，**只能计 2026 披露，不能自然认定 2026 资金到账**；两轮各自签约／交割／宣布日不明。
- **用途：**加速技术研发、产品持续迭代、量产落地和规模交付。
- **可支持／不可支持：**支持本年公开融资消息与资金用途；不支持 2026 销量同比五倍，也不把历史海外累计销量变成本年新增。原需求分片排除“五倍属今年”的判断，不等于排除这次资本披露。
- **独立性／缺口：**两篇有不同采访叙述，核心融资仍来自企业及相关方，不是两份到账核验。部分技术、自托管、交互和市场规模主张未经本分片测试，不升级为已验证能力或行业规模。

### C106｜可以科技／KEYi：超亿元新一轮，B+ 路演只是计划

**来源与访问**

1. [《独家｜小米、安克看好的AI机器人公司完成新一轮亿元融资，首款家庭宠物机器人销量破10万台》](https://www.163.com/dy/article/KIJ2NUMR0556CAYF.html)，**AING硬迹，网易号承载**；发布 **2026-01-06 09:22:16**。分析阶段 HTTP 200，全文成功；网易为承载平台，不冒称网易独立报道。
2. [《CES 2026：中国机器人企业可以科技在CES发布桌面AI伙伴 进军千亿办公辅助市场》](https://finance.sina.com.cn/roll/2026-01-07/doc-inhfnktt7600868.shtml)，新浪转载 **环球网，记者李文瑶**；发布 **2026-01-07 16:44**。分析阶段 CUA 全文成功。

**短引与定位：**来源 1 首段：“北京可以科技有限公司近日完成新一轮融资，总金额过亿元”；来源 2 融资段：“近日已完成**超亿元人民币新一轮融资**”；同段另写“计划于2026年2月底启动B+轮融资路演”。

- **主体／产品：**北京可以科技有限公司，拥有 Loona 家庭宠物机器人，并发展 DeskMate 桌面办公／情感伙伴。融资主体与两条业务关联明确；后者是成人生产力邻接，不与儿童玩具混为一类。不能把整笔公司融资归给宠物机器人。
- **金额／币种／轮次：**超亿元 **人民币**，新一轮。准确轮次未核准，**不采用数据库摘要“D轮”，也不因计划 B+ 就反推已完成轮为 B 轮**。增资、老股或可转债等工具未公开。
- **投资人／顾问：**吴中金控、元禾太湖湾联合领投；基石资本、黎万强等跟投；蓝驰创投持续加注。庚辛资本为财务顾问。小米、安克等在报道中是历史投资人，**不写成本轮新增投资人**。
- **日期／状态：**本轮已读全文最早为 01-06，称近日完成；确切签约、交割、到账日不明，不能默认到账在 2026 年。检索出现 01-05 快讯但未打开全文，不用其锁定最早宣布日。CES 产品发布发生于美国当地 01-06，不能拿产品发布日代融资交割日。
- **计划隔离：**B+ 路演拟于 02 月底启动，未取得其后来完成证据，不能新增已完成融资记录。品牌升级／更名亦是报道中的计划，不替代本次受资法人。
- **用途：**情感交互模型持续研发、新品量产及推广、AI 高端人才。
- **可支持／不可支持：**支持公司融资披露及机器人业务向桌面伙伴延展；不证明新品交付、盈利、累计销量归属当年，或未来 B+ 已完成。Loona 历史众筹另作非股权类别，不加入本年资本表。
- **独立性／缺口：**AING 与环球网均报道企业信息，非独立财务审计。媒体题名销量与正文累计销量口径不在本分片裁决或使用。

### C107｜澜存天使轮：与 Pre-A 分开，领投名称差异保留

**来源与访问**

1. [《用“AI具身模组”重新定义万物接入大模型时代，澜存科技完成千万级天使轮融资｜饭桌好消息》](https://news.qq.com/rain/a/20260408A04BQ800)，**小饭桌创服官方媒体账号，腾讯承载**；发布 **2026-04-08 12:28**。分析阶段 HTTP 200，全文成功。
2. 回溯补证：[《澜存科技三个月内连融两轮，重塑物理世界的「神经系统」》](http://news.10jqka.com.cn/20260813/c678920867.shtml)，同花顺转载投资界，**2026-08-13 10:16:54**；HTTP 全文成功，与 C103 同一来源，不另加独立来源计数。

**短引与定位：**来源 1 融资段：“上海澜存科技有限公司……数千万元天使轮融资。本轮融资由**小饭桌创投**领投，申冉基金跟投”；来源 2 首段回溯“2026年4月完成**凡创资本**领投、申冉基金跟投的天使轮融资”。

- **主体／产品：**上海澜存科技有限公司，EmoMonte 情感语音智能体、微型／柔性模组与陪伴机器人适配；正文专节为“AI玩具，是最好的第一个落地场景”。属于供应平台／方案，不是已售整机证明。
- **金额／币种／轮次：**正文数千万元、天使轮；未给精确金额，“元”未另明合同币种；不换汇。具体股权／可转债工具未披露。
- **投资人差异：**首发写小饭桌创投，8 月回溯写凡创资本；两品牌与具体投资法人关系未核验。**不写成两家同时领投，不擅自认定同一法人，不因此另造一轮。**申冉基金在两文均为跟投。
- **日期／状态：**04-08 写近日宣布完成，8 月回溯将天使轮完成归为 2026 年 4 月；属于有回溯年份支持的当年完成报道，仍不是已验证精确交割／到账。
- **用途：**核心技术研发、人才团队扩充、产品矩阵深化。
- **可支持／不可支持：**支持平台层连续获得融资披露，且与 C103 不同轮次；不证明模组已满足全部认证／儿童安全要求或性能领先。文中客户合作、CE 认证、延迟及安全能力均未由本分片独立核验。
- **独立性／缺口：**首发账号与领投品牌存在利益关联，应视作利益相关方披露，不是独立投资尽调。投资品牌身份、法律载体和实际资金工具仍需正式材料。

### C108｜MOMOTOY：首轮数千万元，2.5 亿元是投后估值

**来源与访问**

1. [《AI潮玩品牌MOMOTOY完成数千万元融资》](https://www.jiemian.com/article/14206940.html)，**界面新闻快讯**；正文发布 **2026-04-03 13:59**。分析阶段 CUA 全文成功。搜索曾显示 04-02，采用实际页面 04-03。
2. [《成立4个月获数千万融资，MOMOTOY亮相深圳潮玩展，即将登陆2026广交会》](https://www.163.com/money/article/KQ5SH8TE00259I71.html)，网易财经转载 **大京新闻网**；发布 **2026-04-10 16:22:24**。分析阶段 HTTP 200，全文成功。

**短引与定位：**来源 1 正文：“4月3日，AI潮玩品牌MOMOTOY完成数千万元首轮融资。本轮融资由翼朴基金投资，**投后估值2.5亿元**”；来源 2 末段：“本轮融资由翼朴基金独家投资”。

- **主体／产品：**报道以 MOMOTOY 品牌为受资对象，没有披露实际受资法人。后续稿提 AI 墩墩兽等交互产品，但品牌还包括黄金、贵金属和常规潮玩。**品牌资本事件可记录，受资法人未核，不直接等同追觅集团融资，不把全部资金归入机器人／AI模组。**
- **金额／币种／轮次：**数千万元、首轮；中文“元”未另明合同币种，未给精确数额。**2.5 亿元为投后估值，不是融资额、收入或销量。**具体法律工具未披露。
- **投资人：**翼朴基金；“独家”仅由后续稿补充，实际出资基金法人及股比未知。
- **日期／状态：**04-03 页面报道当日完成；以此记新闻事件／披露日，不将其当独立验证的法律交割／银行到账日。04-10 是后续稿，不是新一轮。
- **用途：**AI 情感交互研发、高奢产品矩阵、全球业务拓展；不能全归为算力或机器人研发。
- **可支持／不可支持：**支持 AI 潮玩品牌获得首轮资本的公开披露；不支持所有产品都具备 AI、所有资金用于情感模型，亦不证明宣传中的营收、签约或收藏价值。后续报道中的销售指标不新增至本分片。
- **独立性／缺口：**界面快讯优先用于金额与日期，大京新闻网宣传式稿件补充产品及“独家”说法；均未提供交易文件，受资主体和资金结构仍待核。

## 三、限定观察与旧期纠错 C109—C112

### C109｜Jollybubu：过去一年两轮总额，不能全算 2026

**来源与访问**

1. [《36氪首发｜首创“玩偶+主机”模式，多智能体儿童AI玩具品牌获数千万元融资》](https://36kr.com/p/3774692365206280)，**36氪／硬氪，乔钰杰，编辑袁斯来**；发布 **2026-04-20 12:56**。分析阶段 HTTP 首次仅安全检测页，未读成正文；随后正常 CUA 访问取得完整原文，最终状态为 **CUA 全文成功／HTTP 首次失败**。
2. [《用“主机+玩偶”让AI陪孩子成长行得通吗？该品牌完成数千万元两轮融资》](https://finance.sina.com.cn/tech/roll/2026-04-20/doc-inhvcrna0612140.shtml)，新浪转载 **亿邦动力网**；发布 **2026-04-20 16:02**。分析阶段 HTTP 200，全文成功。

**短引与定位：**来源 1 融资首段：“于**过去一年内完成两轮数千万元人民币融资**”；来源 2 融资段明确“两轮**总计**数千万元人民币”。

- **主体／产品：**北京灵机天赐科技有限责任公司，Jollybubu 主机＋实体玩偶、多智能体角色互动；关联由首发正文直接支持。
- **金额／币种／轮次：**两轮合计数千万元 **人民币**；天使轮及 Pre-A，分轮金额未知，不能把总额分别赋给两轮。
- **投资人／顾问：**天使轮由德联资本领投，小恐龙基金、瑞昇基金跟投；Pre-A 由 Implic Capital 领投。探奇资本为两轮独家财务顾问，不是投资人。具体增资／可转债等工具未公开。
- **日期／状态：**04-20 披露过去一年已完成；窗口覆盖 2025，原文没有各轮交割／到账日期。**只列 2026 披露、跨年待拆分，不计已核实的 2026 两轮新交割。**不采用搜索 AI 摘要中的“2025年6月／2026年3月”补空。
- **用途：**正文介绍产品与硬件销售、新角色内容扩展路线，未明确单列募集资金用途；不能把商业规划自动改成募集资金已支出。
- **可支持／不可支持：**支持实体角色＋主机生态获得资本的披露；不能证明两轮都在 2026、当年融资额、复购成立或产品已按计划发售。文中“5月底发售”是当时计划，不与当前产品分片互相覆盖。
- **独立性／缺口：**两篇报道补充口径但不提供资金凭证，主要源于企业采访。另读的二次改写稿见失败／排除日志，不采用其新增推演、引语或金额拆分。

### C110｜中软创达：战略投资观察项，USD 1 亿只是投前估值

**来源与访问**

[《科大讯飞生态投资中软创达，共拓AI潮玩》](http://www.bkmedia.cn/staff/Index/detail?id=935071134398439424)，**北京科技报网站**，页面标 **“来源：网络”**；发布 **2026-08-31**。分析阶段 CUA 全文成功。

**短引与定位：**首段称 2026-08-13 在深圳“正式签署生态战略投资协议”，并称科大讯飞完成投资；第二段：“本轮融资中软创达**投前估值达1亿美元**”。文末免责声明明确是转载、文字图片由第三方提供。

- **主体／产品：**报道受资名称为“中软创达技术开发有限公司”，声称涉及原创 IP、AI 潮玩、软硬件平台及不同年龄陪伴场景；具体消费产品型号未列清。完整法人与融资关系未获独立工商／正式公告核验；不得与“中科创达”“中软国际”混同。
- **金额／币种／轮次：**战略投资额 **未披露**，没有明确轮次。**USD 100 million 为投前估值，不是融资额。**具体股权比例、增资／老股／其他工具不明。
- **投资人：**稿件称科大讯飞；实际投资载体、签署法人未公开。本轮未取得科大讯飞官网、监管披露或受资方可核验公告作正式确认。
- **日期／状态：**08-31 发布，称 08-13 签协议；虽然稿件写“完成”，仍仅能记 **转载声称完成**。协议签署不等于已验证交割或到账，不能据此判定控股并购。
- **用途：**据稿件为研发、市场拓展、量产和 IP 生态融合；属于第三方供稿声称，不是执行结果。
- **可支持／不可支持：**可保留“出现战略投资报道”的方向线索及估值纠错；不足以列为核心已验证融资，不支持融资 USD 1 亿、并购或产品上市成功。
- **独立性／缺口：**供稿方未明确、宣传性强，页面承载机构不等于独立核验。只作低置信观察；没有为凑近 90 天事件将它升级为强证据。

### C111｜Haivivi：2026 年 9 月新文回溯 2025 年 8 月融资

**来源与访问**

[《从发不出工资到融资，AI玩具进商场验证生意》](https://finance.sina.cn/2026-09-18/detail-inisftxe8489531.d.html)，新浪转载 **第一财经**；发布 **2026-09-18 16:28**。分析阶段 HTTP 200，全文成功；为用户提供的核查起点。

**短引与定位：**BubblePal 产品段后：“**2025年8月，Haivivi宣布完成2亿元A轮系列融资**”，其后列投资方。

- **主体／产品：**Haivivi／跃然创新，既有公司名为深圳跃然创新科技有限公司；本文采访品牌创始人李勇，关联 BubblePal、CocoMate、TapDoki 产品线，不提供完整融资法律结构。本轮未另取工商／交割文件。
- **金额／币种／轮次：**2 亿元，A 轮 **系列融资**；中文元口径，未另核合同币种与每次交割金额。不是 2026 融资额、估值或销量；不拆为单次资金到账。
- **投资人：**中金资本旗下基金、红杉中国种子基金、华山资本、愉悦资本、招银国际等；不把“等”补成完整投资清单。
- **日期／状态：**2026-09-18 是采访发布日期，**融资宣布完成在 2025-08**；具体交割／到账日不明。本轮未取得足以新增 2026 新轮的全文证据，不能由新产品或门店进展重置融资年份。
- **用途／债务边界：**本文未单列旧轮融资款分配；2026 开店和产品扩展不自动视作旧轮已披露的募集资金用途。文中提 2024 年需要银行借款，不是 2026 新增债务融资证据，没有据此新增债务条目。
- **可支持／不可支持：**仅支持旧期融资与当前报道之间的年份纠错；不新增今年资本事件，**不提取或新增平台销量、累计出货或本年销售指标**。
- **独立性／限制：**第一财经采访能核报道时间表，核心融资仍是企业历史披露，不是资金凭证。保留这条是清除旧期信息的当年指导地位，不是删除历史证据。

### C112｜Ropet／萌友智能：2026 新闻实际指向 2025 两批交割

**来源与访问**

1. [《TOPBRAND｜萌友智能完成融资；Nike否认出售Converse传言；蜜雪冰城进入巴西；D&G联合创始人辞任》](https://www.jiemian.com/article/14239845.html)，界面页面，作者账号 **tophereditor**，编辑 **summer**；该条内容尾注明 **品牌方舟**。页内发布时间 **2026-04-13 10:13**（由 HTTP 页内发布字段核对），分析阶段 HTTP 200，正文成功。
2. [Ropet 官网《ABOUT》](https://www.ropetai.cn/about.html)，**公司官网**；未标发布日期。分析阶段 HTTP 200，全文成功；仅作品牌／产品关联补证，不作融资日期或交割证据。

**短引与定位：**来源 1“投资动态”第一条：“官方宣布完成A轮融资，**累计融资金额超千万美元**”；“本轮融资分两批交割：**2025年9月**……；**同年11月**……”。来源 2 公司介绍将 ROPET 与萌友智能及消费级机器宠物定位直接关联。

- **主体／产品：**萌友智能／Ropet；官网证实品牌与机器宠物方向，完整公司名称及实际受资法律主体本次未核实。官网不展示实际股权结构，不把官网视作交割文件。
- **金额／币种／轮次：**正文为 **累计超过 USD 10 million**，宣布 A 轮。标题／小标题“超千万美元A轮”与正文累计口径不完全一致，采用较保守的 **累计**，不写成 2026 单轮新增 USD 10 million，不分配给两批交割。
- **投资人：**首批据报道由北京市人工智能产业投资基金领投、峰瑞资本跟投；第二批峰瑞资本继续加码领投，英诺天使基金、国泰海通跟投。具体基金载体、交易工具和分批金额未披露。
- **日期／状态：**本轮已读该文发布在 2026-04-13，但正文将两批交割明确归 **2025-09、2025-11**；精确日和到账凭证仍未知。不是 2026 新资本，只作旧期纠错。其他摘要出现 A+ 等口径，没有以未核实摘要替换已读正文。
- **用途：**所采用融资段未给明确资金用途；官网使命、产品研发方向不能代替募集资金分配。
- **可支持／不可支持：**支持纠正“2026新文章＝当年新交割”“累计额＝本轮金额”；**不新增平台销量、留存、累计出货或销售事件**，不把官网访问日期当产品发布日期。
- **独立性／限制：**界面此条是品牌资讯汇编并引品牌方舟，不是独立调阅融资文件；官网只补主体产品关系，不能构成第二份交割验证。

## 四、众筹与其他资本类别隔离

- **产品众筹／预售不等于股权融资。** C104 来源 3 在 2026-07-14 转载中自述 Fuzozo 于 2026 年 5 月登陆 Makuake、72 小时众筹额超过 **JPY 35 million**；这是利益相关方业务说法。本分片未重新打开 Makuake 项目页，未核净收款、退款及交付，**不列新资本事件，不加进 Pre-A，不新增平台销售判断**。若其他分片核验过原平台，以其独立证据及口径为准。
- C106 报道里的 Loona 历史 Kickstarter 金额属于产品众筹信息，不录入本年股权金额，不复用媒体标题或累计销售当投资成效。
- C108 的投后 2.5 亿元、C103 的投后 1.5 亿元、C110 的投前 USD 1 亿均为估值口径，不能与融资额相加。
- C106 的 B+ 路演与 C101 的继续推进后续融资是计划，不是新轮完成；C110 的战略投资稿不证明控股并购。C111 的历史银行借款叙述不是 2026 债务事件。
- 本组不对普通合作签约、众筹、投资款、老股交易、营收和估值作混合金额统计。

## 五、访问失败、未采纳及搜索限制日志

以下是分析阶段已经发生的访问与筛选记录；写入阶段没有再次搜索、验证验证码或注册。HTTP 200 只表示响应，不能代表文章全文成功。

| 对象／确切入口 | 已发生的结果 | 处理／剩余缺口 |
|---|---|---|
| [Google 最初检索入口](https://www.google.com/search?q=AI+%E7%8E%A9%E5%85%B7+%E8%9E%8D%E8%B5%84+2026) | 最初 CUA 导航报连接关闭；部分 Google HTTP 检索仅返回跳转／JavaScript 提示页 | 没把空壳当搜索或全文；后续正常后台 CUA 可用，没有绕验证码／付费限制 |
| [Bing 检索](https://www.bing.com/search?q=AI%20%E7%8E%A9%E5%85%B7%20%E8%9E%8D%E8%B5%84%202026)／[国内 Bing](https://cn.bing.com/search?q=AI%E7%8E%A9%E5%85%B7%20%E8%9E%8D%E8%B5%84%202026) | 部分返回宽泛／无关结果，部分请求失败 | 仅作线索，未由摘要补融资金额、实际年份或主体 |
| [搜狗初始检索](https://www.sogou.com/web?query=AI%E7%8E%A9%E5%85%B7%20%E8%9E%8D%E8%B5%84%202026) | 初次取得线索；后续近月、TAKWay、萌友等查询返回验证码 | 停止该渠道，不解码／绕过验证码；使用其他正常公开来源 |
| [百度检索](https://www.baidu.com/s?wd=AI%E7%8E%A9%E5%85%B7%20%E8%9E%8D%E8%B5%84%202026) | HTTP 响应没有可用正文 | 不作证据 |
| [新浪站内检索](https://search.sina.com.cn/?q=AI%E7%8E%A9%E5%85%B7%20%E8%9E%8D%E8%B5%84&c=news&sort=time)／[36氪站内检索](https://www.36kr.com/search/articles/AI%E7%8E%A9%E5%85%B7%E8%9E%8D%E8%B5%84) | HTTP 只读到站名／页题，未取得结果正文 | 不称完成融资检索或文章核验 |
| [36氪 Jollybubu 首发](https://36kr.com/p/3774692365206280) | 首次 HTTP 200 为安全检测页；后来普通 CUA 成功读取全文 | C109 采用成功的 CUA 正文，保留首次失败，不绕检测 |
| [36氪珞博快讯](https://36kr.com/newsflashes/3893598367120129) | HTTP 200 为安全检测页，没有正文 | 不引用其全文；C104 采用官网、金融界及实际打开的协会转载 |
| [雪球珞博转载](https://xueqiu.com/3666749272/399853873) | HTTP 200 实际为 WAF／混淆内容 | 全文失败，未执行返回脚本或绕防护，不充第二独立证据 |
| [TAKWay／零动未来职友集线索](https://www.jobui.com/company/22207119/) | 正常请求被转至验证码页；未取得公司页全文 | 停止，未把检索中的历史投资、预计天使轮当 2026 已完成；未取得可靠当年新轮全文 |
| [Miko 定向检索](https://www.google.com/search?q=Miko+robot+funding+2026) | CUA 检索可读，主要指向 2025 融资及累计融资数据库页面 | 未取得可用 2026 新事件全文，不采用摘要数值、估值或累计轮次；不为凑数量追付费数据库 |
| [二白智能查询](https://www.so.com/s?q=%E4%BA%8C%E7%99%BD%E6%99%BA%E8%83%BD%20%E8%9E%8D%E8%B5%84%202026) | 发现跨年重复报道及天使／A 轮命名冲突，未完成全文交叉核验 | 不纳主要记录，也不新增第三条 2025 背景；不宣布它没有融资 |
| [云漪互动查询](https://www.so.com/s?q=%E4%BA%91%E6%BC%AA%E4%BA%92%E5%8A%A8%20%E8%9E%8D%E8%B5%84%202026) | 仅得到行业概述列举，未取得交易级明细 | 不纳入，不能仅凭行业文章名单锁定当年完成 |
| [《儿童AI玩具「Jollybubu」一年完成两轮数千万融资，德联、Implic Capital领投》](https://m.aitntnews.com/newDetail.html?newId=24708) | HTTP 全文成功；页面 2026-05-04 13:17，署来自公众号“全球创投家”，引用硬氪并大幅改写 | 不作为独立融资来源，不使用其中新增推演、引语或复购假设；C109 以已读首发及亿邦总额口径为准 |
| [原产品线 E10 的 OFweek 文章](https://znyj.ofweek.com/news/2026-09/ART-23013-8420-30705276.html) | 既有产品分片记载此前 CUA 成功；本次写入阶段只读本地记录，没有联网复访 | 仅标 C102 与 E10 的 6 月上市／7 月开售差异；不声称本 Coder 再核全文，不覆盖旧产品线 |

### 数据独立性与去重

1. C103 的 08-13／08-19 是同一 Pre-A；C104 的 4 月／7 月是同一 Pre-A 的不同披露层次；C105 的 01-30／02-12 为同一组合融资后续报道；C108 的 04-03／04-10 为同一首轮。均不按文章数增加事件。
2. C107 天使轮与 C103 Pre-A 轮次不同，但 8 月报道回溯的 4 月部分不另计一笔。领投品牌名称冲突不能靠增加投资人数化解。
3. C109 两轮只披露跨年合计，不制造两个当年金额。C111、C112 均排除当年新增资本，不与主要披露加总。
4. 公司官网、投资方官网、协会转载和同稿媒体具有共同源头；媒体数量不能替代到账证据。FA、合作客户、历史投资人不能混入本轮投资清单。

## 六、交接与核验边界

- **编号：C101—C112，共 12 条证据记录。** C101—C108 为 8 条主要披露，C109—C110 为 2 条限定观察，C111—C112 为 2 条旧期纠错；不是 12 笔当年融资，更不是 8 笔精确已核验的 2026 交割。
- 主报告若只需方向新信息，优先整合 C101—C106；C107—C108 可补平台连续融资和品牌估值口径，不必为凑数量继续搜索。
- 有限比较仅覆盖角色／陪伴消费硬件、模组和平台资金方向；不作行业总融资、份额、均值或投资建议。
- **C102 的融资主体关联已证，但新品实际上市日期仍待核**；本文件只并列现有报道，不改写 E10 或正式产品时间线。
- 本次 Coder 唯一写入路径为 `docs/references/消费电子玩具市场研究/parts/capital-2026.md`；未改根目录、正式研究／证据／产品文件、脚本或只读参考库。按当次授权，写入阶段不运行 Git、不 commit、不 push。
- 操作透明记录：此前 FIN26 分析开头曾误执行只读 `git status --short` 与 `git branch --show-current`，已向用户报告；没有改动 Git 状态。此处如实保留历史偏差，不能把整个分析阶段表述为从未运行 Git。本次转 Coder 阶段未执行 Git。
