parkourlrc/pcb-yilv1982--duck-robot-89dbc81d6d/docs/references/扩展板乙版降本/layout-spacing/y10-bom-user-redacted-20261105.png

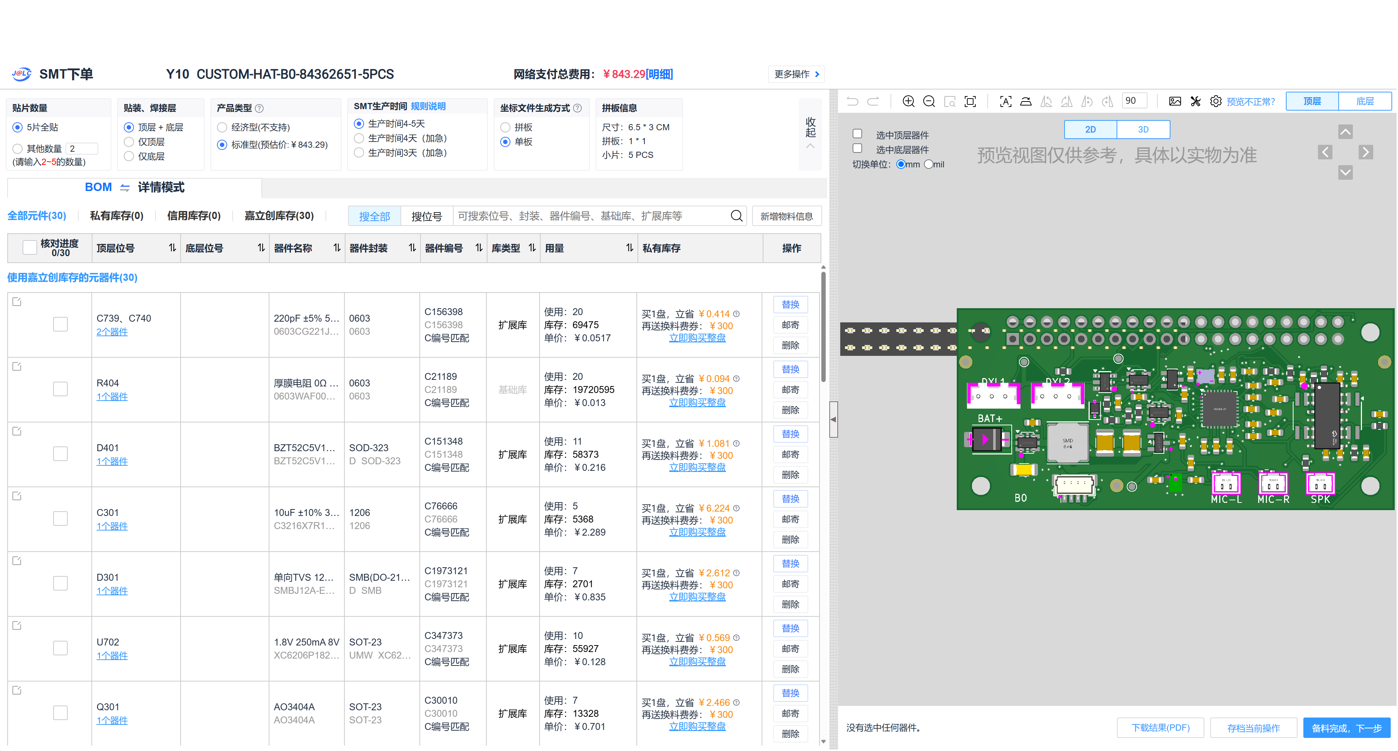
docs/references/扩展板乙版降本/layout-spacing/y10-bom-user-redacted-20261105.png
