parkourlrc/pcb-yilv1982--duck-robot-89dbc81d6d/docs/references/扩展板电路仿真工具/bom-passives-20261031/sources/kyocera-c0g-p3.png

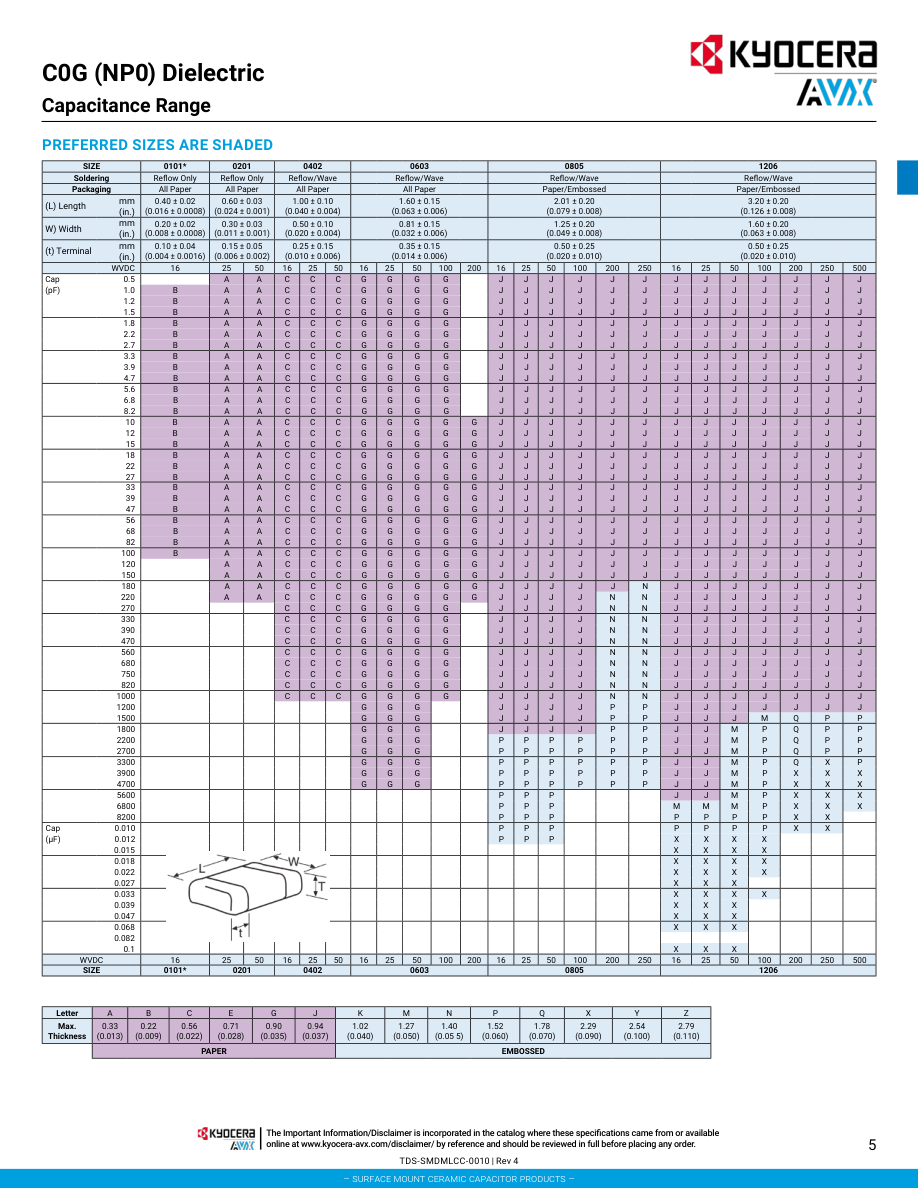
docs/references/扩展板电路仿真工具/bom-passives-20261031/sources/kyocera-c0g-p3.png
