parkourlrc/pcb-yilv1982--duck-robot-89dbc81d6d/docs/references/扩展板电路仿真工具/final-bom-20261031/sources/jst-catalogue-120-p119.png

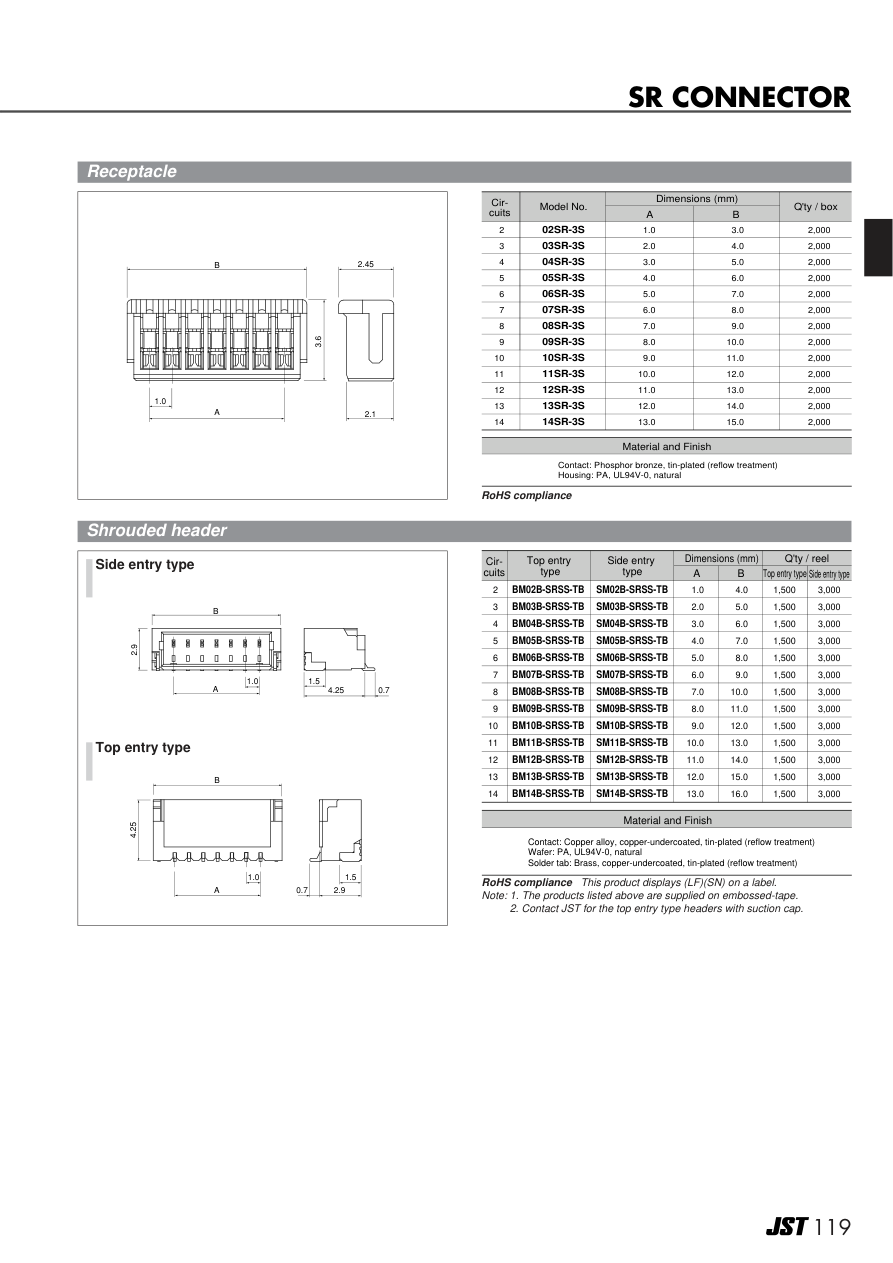
docs/references/扩展板电路仿真工具/final-bom-20261031/sources/jst-catalogue-120-p119.png
