parkourlrc/pcb-yilv1982--duck-robot-89dbc81d6d/docs/references/扩展板乙版降本/jlc-fees-guide.txt

					39 text 嘉立创SMT贴片:可贴工艺\数量\交期\收费介绍
				44 text 嘉立创SMT贴片:可贴工艺\数量\交期\收费介绍
			45 text 创建时间： 2022-10-18 16:43 更新时间： 2026-11-04 10:22 1635541 88 文档错误过时,
				48 text 嘉立创贴片，采用日本雅马哈高速贴机，8台机组成一条流水线，共9条样板流水线； 小批量产线配备:100台全新贴片机，单机为一条生产线，每条线配备了SPI、AOI 等设备确保焊接品质，单独开钢网，单独上线生产。 努力帮用户解决PCB样板、小批量，焊接难、器件难、交期难的问题； 可接 V割拼板、双面贴、插件 ；可接 客供元器件 。
				50 text （1）双面板 支持的尺寸范围：
				51 text 经济型 最小：  10mm X 10mm  ； 单板最大： 590mm X 470 mm； 标准型 最小： 70mm X 70mm ； 单板最大： 510mm X 460 mm；
				53 text 经济型 最小： 10mm X 10mm ； 单板最大：570mm X 470 mm； 标准型 最小： 70mm X 70mm ； 单板最大： 510mm X 460 mm；
				55 text 板厚1.0MM含以下，拼版建议100*150mm 板厚1.2MM，拼版建议150*200mm 板厚1.6MM，拼版建议180*200mm 板厚2.0MM，拼版建议200*200mm 注:拼版宽度的数量建议不超过5片(工艺边对工艺边的方向)，避免因拼板过多造成形变的风险。 拼版尺寸范围内的小板数量不建议超10个，如超10个小板，建议拼板后尺寸控制在100*100MM内。
				57 text a：经济型可接板厚为0.8mm、1,0mm、1.2mm、1.6mm；
				58 text 局限:不支持潮敏、中低温、沉板与夹板式结构，片式元件＜0402、IC pin间距＜0.4mm、BGA球径间距＜0.5mm等精密器件。
				59 text b：标准型所有
				60 text 板厚均可接贴片，没有限制，下单不能选SMT的工艺，请联系嘉立创客服。
				61 text 二、收费模式
				66 text 四、经济型/标准型
				68 text 五：经济型可以接工艺：
			227 text 经济型SMT的四层板只能是7628的层压结构吗？不能使用3313的层压结构吗？
				231 text 尊敬的客户您好！ 经济型SMT的四层板 四层(叠层无要求 默认7628+7628)
			234 text 经济型SMT到底支持OSP吗，这个帖子说2层板1.6板厚支持，另外一个帖子又不支持
			237 text 尊敬的客户您好！经济型  1.6板厚是支持OSP的。
				256 text 您好！经济型的焊点费计算方式： 0-10000点：0.1元 10001-30000点：0.09元     >30001点：0.07元，如果您是 20万个点那么全部是按照0.07/点计算的。
			259 text 自己拼好的板支持经济型吗
			262 text 尊敬的客户您好！您自己用邮票孔拼板就可以支持经济型。
			265 text 经济型换料费20块一种，比标准型还贵怎么办
				269 text 尊敬的客户您好！ 推荐您直接在嘉立创整盘购买物料这样下SMT订单时，使用到整盘购买的器件型号，会自动减免换料费 经济型订单，使用有券的型号每次减免15元: 标准型订单，使用有券的型号每次减免3元，减免后，标准型 和 经济型订单的扩展库换料费都是5元哦！
			278 text 经济型到底支持哪些封装，为什么ESP32模组都不行，还有为什么有的QFN封装可以，但是有的QFN又不行。
			281 text 您好，部分器件 如是经济型车间生产的话，回流焊的温度超过了器件本身的耐温高度，容易损坏，我们就做了限制标准型才能使用。经济型回流焊温度是  255+/-5   标准型回流焊温度是， 240+/-5。
			284 text 经济型不能支持ESP32模组？？？
			287 text 您好，部分器件 如是经济型车间生产的话，回流焊的温度超过了器件本身的耐温高度，容易损坏，我们就做了限制标准型才能使用。经济型回流焊温度是  255+/-5   标准型回流焊温度是， 240+/-5。
