parkourlrc/pcb-yilv1982--duck-robot-89dbc81d6d/docs/references/扩展板邮票孔与电源修复/ASSEMBLY-NOTES.txt

自主HAT A.1双联拼板候选：尚未制造放行，不直接下单。
A1与A2两单元相同；A2坐标位号带B2_前缀，对应原位号丝印，映射见unit-reference-map.csv。
标准型双面SMT，两单元各52个SMT件；C307/B2_C307不装且不印锡膏。
工序为B面SMT、F面SMT、支撑切断分板及毛刺检查、每单元6个THT逐点手工焊接；分板时不装THT，不采用整板波峰或通孔再流焊。
U501/B2_U501为BMI088 MEMS：禁用整板干冰/超声清洗，局部清洗剂和方法需按器件资料核相容性。
BMI088信号焊盘钢网面积按81%导出；Bosch第57页建议70%～90%。全板钢网设计基线0.125mm，实际厚度公差/孔壁/SPI及曲线另核，不按80～150um任意选。
BMI088 MSL1、峰值260℃是器件手册上限，不直接当整板炉温设定；其余器件须核对应包装/耐温及暴露时间。
含L301的F面作为第二回流设计基线；B面U702/SH等保持、曲线及必要治具仍须实际工艺评估。全部THT在分板完成后手工逐点焊接。
设备使用工艺边PFID全局点定位；单元内FID不能替代该组工艺边定位点。
邮票孔列位于单元名义边线，连接带全铜层局部清铜。分板需支撑PCB并切断连接带，不手掰；毛刺/凹口/应力及实际机械配合另验。刀具/夹具参数尚未实测。
U701.7焊接面via铜盘按当前分层padstack为0.25mm，另三铜层0.35mm，机械孔0.15mm；必须填孔盖铜，详见逐层工艺CSV。
C305与C310已移位并采用0.25mm热连接臂及0.2mm隔离；原连接及I2S参考铜保持，焊接良率和电源瞬态尚无实测。
U702精确料号LP38691DT-1.8/NOPB为75支管装，需管料送料、转托盘或人工贴装。
U701与U702为MSL2、260C分类、1YEAR floor life；U801与U802为MSL1；开封和干燥记录按来料标签执行。
层叠设计参考JLC041611-7628：外铜35um、内铜30um；尚未接单或实测。完整材料曲线缺口见本轮物料矩阵。

当前包工序详见depanel-process-notes.md、tht-process-notes.md和tht-soldering-plan.csv；CSV的元件面不同于焊接面。panel-assembly-plan与unit-reference-map的THT工序已同步为分板后手工逐点焊接。
