parkourlrc/pcb-yilv1982--duck-robot-89dbc81d6d/docs/references/扩展板邮票孔与电源修复/assembly-process-basis.md

# 86654c03装配执行依据：未放行生产

2026-11-02启动，2026-11-03 +08:00续核，源86654c03b6c1c8f51f7d5a4bef469aceed2ddfc73433b3e50426940c2a23164a；同源双联r18，104SMT/12THT、12POFV。制造规格选择见manufacturing-spec.md和JSON；料号/包装依据见material-process-matrix.csv。

- U301原铜3.502×2.613mm保持，Paste保持4个1.45×1.10mm/R0.05窗，中心偏移±0.825/±0.65mm，网桥0.20mm，总铜land覆盖69.63%。这是前轮确定的项目工程选择，不是Diodes原厂专属钢网或已测良率。
- U701中央land3.45mm/四个1.49mm窗、U702十六个1.15×1.12mm窗保持；U702可选中间脚无Paste但铜不删。BMI088每单元16开口面积81%，C307/B2_C307 DNP无Paste。
- 名义钢网0.125mm，实际最小面积比约0.683/宽厚比1.8；0.15mm不满足同一几何筛查。实际厚度公差、孔壁和SPI转移仍须核，不能自动扩大开口或改厚度。
- B面SMT先回流，含大电感的F面后回流；第一面的U702/SH等保持/支撑由实际工艺评估。随后支撑切断连接带并检查毛刺，不手掰；分板阶段不装THT。最后全部6件THT逐点手工焊接，不使用整板波峰焊或通孔再流焊；逐件面别及邻近件见tht-soldering-plan.csv，分板条件见depanel-process-notes.md。J301元件在B面、焊接在F面，其余5件相反。J301 B端子面40P孔在上时从左1→8，pin1/2有编号丝印。
- U301五孔和U701.7共6处/单元树脂填孔盖铜，不能普通盖油替代。钢网面积不抵消平整度或空洞问题，实际接合需工艺验收。
- U701/U702按MSL2实物标签管理；U702为75支管装，SH顶插1500/reel。送料/转托盘/开封与替代料记录仍未发生，不提前通过。
- 免清洗为基线，BMI088禁超声/干冰；清洗溶剂需兼容整板。SH原厂没有给统一回流数字，按应用评估与实际热曲线确认，不能把工作温度或引脚焊接温度当整板炉温。
- 板间距名义11.6～13.33mm仅参考刚体筛查，不含公差/线束/附件/头壳；用户未锁定高度。无新板实物，未制造/上电放行。

本次关键勘误：r18将40个邮票孔中心放在单元名义边线上，连接带中心X=108/160mm，每组5孔，孔边到孔边0.4mm。仅在分板带缩进约0.6mm清除zone铜，全部原焊盘/走线不变，孔铜/连接/I2S参考铜核查通过。两单元Power类别完整复制；旧r17及以前拼板不能作为当前合格交付。
