parkourlrc/pcb-yilv1982--duck-robot-89dbc81d6d/docs/specs/20261028-custom-hat/assembly-notes.md

# Rev A 装配说明

> **2026-10-29 续接审计停用：下文整体为历史草案，不作现行制造、采购或上电指导。** 器件数量/面别、测试点、40P 镜像方向、旧 V1.2 功能比较均未完成现行核对；不得照旧表贴装。 现行见 [修复方案](recovery-plan.md) 和 [审计证据](../../references/扩展板电路仿真工具/audit-20261029/review.md)。

## 历史正文（已失效）

> 适用于 `hardware/custom_hat/rev_a`，4 层、65 × 30 mm、双面贴装。本文是装配顺序与人工检查点，不含下单参数（见[下单检查单](order-checklist.md)）。

## 1. 板子构成

| 面 | 器件 | 数量 |
|---|---|---|
| 正面 F.Cu | 40P 座、电源块、TTL 座、ToF/IMU、测试点 | 28 |
| 背面 B.Cu | U701 codec、U702 LDO、J502 ToF 座、C308、C309 | 5 |

背面 5 个器件必须过第二次回流；手工返修时注意正面 40P 座不要被二次加热松动。

## 2. 贴装顺序（工厂侧）

1. **先背面**：U701（VQFN-32）、U702（TO-252）、J502（SH 4P）、C308/C309（0805）。
   - U701 与 U702 有散热焊盘/大焊盘，钢网开孔与回流曲线按工厂标准。
   - QFN 与 TO-252 建议 X-ray 抽检。
2. **再正面**：U301（SO-8EP）、U501（LGA-16）、L301、D301、阻容、连接器。
   - U501 是 0.5 mm 间距 LGA，**必须 AOI/X-ray 检查**；偏移超过 0.1 mm 需返修。
   - D301（SMB TVS）方向：单向 TVS，阴极朝 `VBATT_2S_IN`，装反等于短路保护失效。
3. **最后插件/大件**：J101（40P 座）、J301、J401/J402、J403、J802。
   - **J101 是整板最关键的方向件**：丝印 `1` 为 pin 1，装反会导致 5 V 与 3.3 V 对调。

## 3. 人工检查点

| 检查 | 方法 | 判据 |
|---|---|---|
| J101 方向 | 目视丝印 “1” 与座子缺口 | 与丝印一致 |
| U501 偏移 | 放大镜/AOI | 焊盘中心偏差 < 0.1 mm，无连锡 |
| D301 极性 | 目视色带/丝印 | 阴极朝电池输入侧 |
| U701/U702 背面 | 目视 + X-ray | 无虚焊、无偏移 |
| C307 | 目视 | **不贴**（DNP 预留位） |
| 桥连 | 万用表通断 | 5V/GND、3V3/GND 不短 |

## 4. 手工焊接建议

- 40P 座：先固定对角两脚，再逐脚焊；**不要先焊 J301 等插件**，否则板子放不平。
- JST EH/SH 座：塑料件耐温低，回流后补焊更稳妥；若工厂贴装，确认其耐温等级。
- 测试点 TP801–TP806 是 1.5 mm 焊盘，不需要焊针；调试时用探针或焊短线。

## 5. 与旧 HAT 的差异（装配时容易混淆）

| 项 | 旧白色 V1.2 | 本板 Rev A |
|---|---|---|
| 摄像头/屏幕 | 有（V1.2 视版本） | **已去掉** |
| 电源芯片 | AP63205（2 A） | AP64350（3.5 A） |
| 音频 codec 供电 | 板载 1.8 V | U702 LDO 产生 1.8 V |
| 测试点 | 排针 | 6 个贴片焊盘 |

**不要把旧板的装配习惯直接套过来**：本板没有屏幕座，也没有 CSI 座。
