parkourlrc/pcb-yilv1982--duck-robot-89dbc81d6d/docs/references/扩展板邮票孔与电源修复/sources-recheck-20261103/smt-guide-64042.txt

嘉立创SMT_一站式PCBA服务平台_SMT贴片_PCBA贴片_SMT工厂_PCBA工厂
嘉立创产业服务站群
电子产业
嘉立创PCB
PCB、FPC制造服务
嘉立创SMT
一站式PCBA服务平台
嘉立创激光钢网治具
激光钢网&治具制造
嘉立创EDA
国产PCB设计工具
机械产业
嘉立创FA
机械/电气零部件一站式商城
嘉立创3D打印
树脂、尼龙、金属3D打印服务
嘉立创CNC机械智造
机加件一件起订，3天交货
更多服务
嘉立创CAM
国产线路板CAM软件
Forface 3D
SaaS化3D技术服务平台
硬创社
好玩的硬件交流社区
供应商合作
一站式阳光采购平台
在线下单
BOM备料
SMT元器件
邮寄元器件
私有库管理
SMT工具
DFM(SMT)
PCB转BOM坐标
SMT帮助
帮助文档
技术专栏
技术论坛
工艺参数
更多
DFM(SMT)
PCB转BOM坐标
帮助文档
技术专栏
技术论坛
工艺参数
嘉立创Layout
登录
注册
我的SMT订单
首页
技术专栏
SMT工艺规范说明文档目录
SMT工艺规范说明文档目录
2026-10-13 15:25:07
171400
0
文档结构
文档按生产影响划分为基础篇、进阶篇、优化篇三个层级，检查时依次执行。
第一层级：基础篇（P0，生产准入）。
该层级是SMT生产的最低门槛，所有项目必须全部满足，否则PCB无法进入生产线。
第二层级：进阶篇（P1，良率保障）。
该层级在满足基础篇后用于保障焊接良率和长期可靠性，建议全部满足，以降低偏移、桥连、立碑、虚焊和开裂等风险。
第三层级：优化篇（P2，交期与成本）。
该层级用于优化交期、成本和物料风险，在前两级满足后尽量执行，以减少停线、返工、人工处理和额外费用。
三个层级形成由生产可行性到质量稳定性、再到交付经济性的递进关系。
基础篇（P0：生产准入，必须全部满足）
序号
规范项目
核心检查点
不满足的主要后果
1
工艺边设计规范
宽度5-8mm，最小不低于3mm；配置Mark点、定位孔；器件不得伸出工艺边；小板、薄板需拼板或补强。
无法夹持上线、订单驳回，或出现卡板、撞件、贴装偏移。
2
MARK点（光学定位点）的设置
至少3个，L形不对称分布；铜箔直径1.0mm、开窗2.0mm；中心距板边不小于3.85mm，周围3mm禁布。
无法定位或识别方向，造成整体偏移、偏贴、反向贴装。
3
V-Cut拼板与设计规范
仅走直线；距导线、焊盘不小于0.4mm，距器件不小于5mm；残厚约为板厚1/3；拼板尺寸满足工艺范围。
分板切伤线路、批量断裂、分板困难，拼板无法稳定量产。
4
邮票孔拼板与设计规范
每组5-8个直径0.60mm孔；孔边距0.35-0.40mm；至少对称2组；拼板间隙不小于1.2mm。
连接强度不足、拼板断裂、连孔，或分板应力损伤线路与器件。
5
镂空区域与加强筋设置
板面存在大面积镂空时设加强筋；加强筋宽度不小于5mm，间距建议50-80mm。
传送和回流焊中变形下垂、重心偏移、焊点微裂或卡板。
6
元器件及PCB极性标识规范
本体标识清晰耐久；二极管标K、电容标+、IC标1脚；PCB丝印不覆盖焊盘，线宽不小于0.15mm。
方向判断失误、AOI误判或漏判，导致批量反贴、返修和报废。
进阶篇（P1：良率保障，建议全部满足）
序号
规范项目
核心检查点
不满足的主要后果
1
焊盘与器件封装的一致性
焊盘尺寸、间距及定位结构必须匹配器件封装，并按IPC-7351和器件数据手册设计。
小焊盘配大器件易偏移，大焊盘配小器件易立碑，严重时无法焊接或桥连。
2
器件相邻引脚及焊盘间距
常规相邻焊盘不小于0.2mm；QFP引脚不小于0.3mm；BGA、QFP按数据手册检查局部最小间距。
回流焊连锡桥连，BGA等隐性缺陷可能在客户端才暴露。
3
焊盘上的过孔设计
过孔不应放在贴片焊盘内；优先移出焊盘；高密度设计采用树脂塞孔加电镀填平。
焊膏流入过孔，导致少锡、假焊、锡珠或焊盘不平。
4
焊盘与大面积铜皮直接相连，缺少热阻设计
0603及以上chip元件连接GND或电源大面积铜皮时采用热阻焊盘；连接臂不大于0.25mm。
两端热容量不均，形成立碑、冷焊等小尺寸阻容焊接缺陷。
5
元器件的机械干涉
工艺边不得放置器件；拼板间器件不得碰撞；插件脚与贴片器件保持不小于5mm；贯穿固定脚错开不小于5mm。
轨道撞件、拼板互碰、器件无法贴平或吸嘴碰撞造成批量移位。
6
器件间隔规范
0402-1206阻容及二极管、晶体管间距不小于1mm；IC不小于3mm；发热与热敏器件不小于5mm。
吸嘴无法安全下降、相邻器件冷焊、热敏器件寿命或精度受影响。
7
较大较重器件布局
重器件集中在同一面并优先布置于非贴装面；双面对称布局；过重器件增加点胶固定。
二次回流时器件脱落、PCB变形下垂、周边器件冷焊或受热影响。
8
半孔工艺设计规范
孔边距不小于1mm，孔径和孔间距不小于0.5mm，单边焊环不小于0.25mm；必须选择半孔工艺并采用CNC锣空。
孔壁铜层脱落、铜刺桥连、焊料爬升不足、虚焊开路和电化学迁移。
9
元器件引脚焊端变形或氧化
QFP、SOP和BGA共面度不大于0.1mm；焊端无氧化变色；库存超过2年的器件使用前做可焊性验证。
引脚悬空、润湿不良、虚焊开路，批量生产或使用后集中暴露。
10
湿敏器件（MSD）
优先选用MSL不大于3的器件；MSL3暴露不超过168h；超期按125℃/24h或40℃/192h烘烤。
回流焊时水汽膨胀造成爆米花开裂、内部分层和长期可靠性失效。
11
不耐高温元器件
投产前比对峰值温度和回流焊参数；无参数时抽取10-20件过炉验证；不达标时评估后焊或低温锡膏。
塑料外壳变形、传感器漂移、电池或光学器件失效，工艺窗口失控。
12
无法干冰清洗的元器件
识别含密闭腔体、标签、光学表面和MEMS器件；存在此类器件时禁用整板干冰清洗。
标签脱落、膜片或结构损伤、器件功能失效及清洗残留风险。
优化篇（P2：交期与成本，建议尽量满足）
序号
规范项目
核心检查点
不满足的主要后果
1
PCB及物料备损
低值小件建议备损0.3%-0.5%；中等价值器件0.2%-0.3%且不少于2颗；高价值器件按0损耗处理并单独沟通。
抛料、检料、维修或来料不良耗尽物料，导致停线等待补料和交期延长。
2
避免两面都有固定脚直插的贴片元件
原则上禁止正反两面均有贯穿固定脚的器件；必须使用时错开不小于5mm，脚长不超过板厚。
器件互顶、钢网被顶起、PCB微裂，并增加人工干预、交期和费用。
3
非标准包装元器件
选型和采购优先要求编带包装；管装料通常需装盘或手贴；散料只能手贴。
抛料和引脚变形增加、极性贴错、人工效率低、交期延长且追溯困难。
4
使用了翻新或非原厂元器件
所有物料从授权代理商或原厂采购；检查丝印、引脚颜色和封装尺寸的一致性，并保留批次追溯证明。
参数漂移、可焊性差、批次一致性低，可能导致整批PCBA失效。
文档依据
本目录依据现有SMT技术规范及以下资料整理：
《SMT生产设计规范说明书》及基础篇、进阶篇、优化篇相关技术规范文档。
IPC-7351、IPC-A-610、IPC-2221、IPC-6012等PCB设计与验收标准。
J-STD-001、J-STD-002、J-STD-020、J-STD-033等焊接、元器件及湿敏器件管理标准。
元器件数据手册、供应商工艺资料及SMT行业通用工艺规范。
本目录提炼各文档的关键检查点，具体参数、判定条件和适用范围以对应规范的正式文本及最新版本为准。
文档声明
本目录用于SMT设计评审和生产准备参考，不替代器件数据手册、正式标准文本、客户技术要求及工厂工程审核结论。实际设计和生产应以最新版标准、实际工艺能力及双方书面确认结果为准。因产品结构、物料状态、工艺参数或客户要求不同，使用者应结合具体项目评估适用性；因未按正式工程审核结论执行造成的设计变更、返工、报废、交期延误及费用，相关责任按双方合同或订单约定处理。
点赞
互动评论
0
注意：此留言仅作为嘉立创与客户日常交流之用，回复不是很及时，急切问题请联系我司工作人员处理！
登录
或
注册
后才可以留言哦
下一篇：
FPC工艺规范说明文档目录
SMT服务
在线下单
SMT元器件
BOM备料
工艺能力
关于我们
企业动态
下单帮助
技术专栏
联系我们
联系我们
业务咨询：16620864317 朱女士
服务投诉：18676749535 熊先生
服务热线：0755-82048205（周一至周六 9:00-18:00）
抖音号
微信公众号
电子产业
嘉立创PCB
嘉立创FPC
嘉立创SMT
嘉立创钢网
嘉立创发热片
纸盒包装定制
立创商城
ZXHPCB
机械产业
嘉立创FA
嘉立创3D
嘉立创CNC
MRO商城
面板定制
铝合金壳体
工业软件
嘉立创EDA
嘉立创Ican
嘉立创CAM
嘉立创DFM
3D模型查看器
嘉立创云ERP
嘉立创ECAD
其他服务
嘉立创社区
硬创社
开源硬件平台
嘉立创Layout
第三方服务
Forface 3D
嘉立创开放平台
关于嘉立创
集团介绍
丨
CEO邮箱
投资者关系联络方式
IR电话 0755-83456516
IR邮箱securities@sz-jlc.com
媒体沟通：pr@jlc.com
版权所有 - 深圳嘉立创科技集团股份有限公司
粤ICP备11084592号
粤公网安备 44030002006092号
增值电信业务经营许可证粤B2-20201198
ISO/IEC
|
隐私政策
用户协议
站点地图
