parkourlrc/pcb-yilv1982--duck-robot-89dbc81d6d/hardware/custom_hat/panels/a1-smt-2up-20261102-r11/ASSEMBLY-NOTES.txt

自主HAT A.1双联拼板候选：尚未制造放行，不直接下单。
A1与A2两单元相同；A2坐标位号带B2_前缀，对应原位号丝印，映射见unit-reference-map.csv。
标准型双面SMT，两单元各52个SMT件；C307/B2_C307不装且不印锡膏。
每单元6个通孔件安排在双面回流后后焊，不采用要求插件脚周围5mm净空的整板波峰焊。
U501/B2_U501为BMI088 MEMS：禁用整板干冰/超声清洗，局部清洗剂和方法需按器件资料核相容性。
BMI088信号焊盘钢网面积按81%导出；来源为Bosch手册第57页70%～90%建议。钢网厚度80～150um与实际回流曲线需工艺配套。
BMI088 MSL1、峰值260℃是器件手册上限，不直接当整板炉温设定；其余器件须核对应包装/耐温及暴露时间。
大电感/稳压器面优先作为第二面回流的工序基线；底面保持、曲线和必要治具仍需器件工艺数据，不默认全部可无治具回流。
设备使用工艺边PFID全局点定位；单元内FID不能替代该组工艺边定位点。
邮票孔处分板时支撑PCB，避免对MEMS及陶瓷电容冲击；毛刺及实际机械配合另验。
U701.7焊接面via铜盘按当前分层padstack为0.25mm，另三铜层0.35mm，机械孔0.15mm；必须填孔盖铜，详见逐层工艺CSV。
C305与C310已移位并采用0.25mm热连接臂及0.2mm隔离；原连接及I2S参考铜保持，焊接良率和电源瞬态尚无实测。
U702精确料号LP38691DT-1.8/NOPB为75支管装，需管料送料、转托盘或人工贴装。
U701与U702为MSL2、260C分类、1YEAR floor life；U801与U802为MSL1；开封和干燥记录按来料标签执行。
层叠设计参考JLC041611-7628：外铜35um、内铜30um；尚未接单或实测。完整材料曲线缺口见本轮物料矩阵。
