parkourlrc/pcb-yilv1982--duck-robot-89dbc81d6d/hardware/custom_hat/release-review/HAT-A1-JLC-PCBA-86654c03b6c1-20261103-assembly/depanel-process-notes.md

# HAT A.1 r18：分板顺序与切割区域

2026-11-03，主源86654c03b6c1c8f51f7d5a4bef469aceed2ddfc73433b3e50426940c2a23164a，拼板fd6cd170fc09848e37feb88e10dad3bbf1d21954a8139f7bb0f8a303e4ceb22c。以下是本地设计工序与名义几何筛查，非实际加工通过。

**顺序：B面SMT→F面SMT→支撑切断连接带、毛刺/碎屑检查→6件/单元THT逐点手工焊接。** 不靠手掰断板，不在装好排针/排母后切连接带。工厂需选适配带元件板的刀具和支撑夹具，当前文件不指定未经验证的刀径、夹持点、速度或允许板弯量。

已检查r18全部8条名义切线（X108/160、Y100/130/132/162，各X±2.8mm）。原生116个拟装器件Fab框包含两面与两个单元，逐一计算到切线的平面最短距离；详见depanel-process-check.json。

| 单元局部切线中心mm | 最近SMT（两面合计） | 名义距离mm | 提前装THT时的更近对象 |
|---|---|---:|---|
| 108,100 | D301 | 9.737813 | J101：0.795mm |
| 160,100 | C311/C312 | 7.970000 | J101：0.795mm |
| 108,130 | J506 | 5.751956 | J301：1.360mm |
| 160,130 | C327 | 5.326350 | 第二单元B2_J101：2.795mm |

第二单元在Y方向+32mm，但跨单元最近对象未必就是同位号副本：Y132两行最近SMT分别是上方单元J506/C327，距离7.751451/6.780118mm；完整8条切线见JSON。实际最小SMT距离5.32635mm，没有SMT Fab框进入切线3mm邻域。这里的3mm仅作为连接带局部切割筛查，不冒充62692所有镂空边界、刀具运动包络、零件实体公差或板弯应变已核。

孔/铜避让仍以已有edge-copper-reference-check.json为依据：8个孔组居中、局部退铜、中心线±0.2mm无铜命中；原走线/焊盘保持。器件不在刀口附近不等于不会传递板弯应力，仍须实际支撑、毛刺处理以及邻近陶瓷件/焊点检查。不能用“鼠咬孔”名称推定可以随手折断。

公开依据：嘉立创62704要求避开线路/焊盘/器件，并指出手工大力掰板可使器件震落、密集区应力可致电容开裂；62692说明镂空/加强结构及邻近件风险。原文归档于项目归档扩展板嘉立创规则自查/sources。未引用并未取得的实际工厂刀具或夹具参数。
