parkourlrc/pcb-yilv1982--duck-robot-89dbc81d6d/hardware/custom_hat/release-review/HAT-A1-JLC-PCBA-b610f1dcd136-20261102/assembly-process-basis.md

# b610f1dc装配执行依据：未放行生产

2026-11-02，源b610f1dcd136f6266f21e1568da76f2457573475137de31431d06c72c5eafc3a；同源双联r14，104SMT/12THT、12POFV。制造规格选择见manufacturing-spec.md和JSON；料号/包装依据见material-process-matrix.csv。

- U301原铜3.502×2.613mm保持，Paste改为4个1.45×1.10mm/R0.05窗，中心偏移±0.825/±0.65mm，网桥0.20mm，总铜land覆盖69.63%。这是项目工程选择，不是Diodes原厂专属钢网或已测良率。
- U701中央land3.45mm/四个1.49mm窗、U702十六个1.15×1.12mm窗保持；U702可选中间脚无Paste但铜不删。BMI088每单元16开口面积81%，C307/B2_C307 DNP无Paste。
- 名义钢网0.125mm，实际最小面积比约0.683/宽厚比1.8；0.15mm不满足同一几何筛查。实际厚度公差、孔壁和SPI转移仍须核，不能自动扩大开口或改厚度。
- B面SMT先回流，含大电感的F面后回流；第一面的U702/SH等保持/支撑由实际工艺评估。全部6件THT后焊，J301为B面、其余5件F面。J301 B端子面40P孔在上时从左1→8，pin1/2有编号丝印。
- U301五孔和U701.7共6处/单元树脂填孔盖铜，不能普通盖油替代。钢网面积不抵消平整度或空洞问题，实际接合需工艺验收。
- U701/U702按MSL2实物标签管理；U702为75支管装，SH顶插1500/reel。送料/转托盘/开封与替代料记录仍未发生，不提前通过。
- 免清洗为基线，BMI088禁超声/干冰；清洗溶剂需兼容整板。SH原厂没有给统一回流数字，按应用评估与实际热曲线确认，不能把工作温度或引脚焊接温度当整板炉温。
- 板间距名义11.6～13.33mm仅参考刚体筛查，不含公差/线束/附件/头壳；用户未锁定高度。无新板实物，未制造/上电放行。
