parkourlrc/pcb-yilv1982--duck-robot-89dbc81d6d/hardware/custom_hat/release-review/HAT-A1-JLC-RS274X-4440b22f542e-20261102-stencil/assembly-process-basis.md

# 4440b22f装配执行依据：未放行生产

2026-11-02，源4440b22f542e3af735c1a8d0ffcd272cac5cb8e9fdb9d668ff0c7cd77c589149，同源双联r13，104SMT/12THT、12POFV。

- U701中央铜land3.45mm/R0.05，4个1.49mm/R0.05钢网窗；U702大tab为16个1.15×1.12mm/R0.05窗、1.35×1.32mm节距。U702可选中间短脚不印Paste，铜/网络保持；不能用旧r12钢网。
- BMI088每单元16开口面积81%，C307/B2_C307 DNP无Paste。钢网名义设计基线0.125mm；最小开口面积比约0.683、宽厚比1.8，通过所引用TI几何筛查。0.15mm会低于0.66面积比；实际厚度公差、孔壁工艺、锡膏及转移率另核。
- U301 EP仍为1:1单大开口，尚未取得该SO-8EP精确钢网方案。其锡量/分窗及气泡控制仍需处理，不能因面积比大就认为该项通过。
- J301为B面THT，标1:2S+、2:GND；40P孔在上时B插接面从左1→8，F面相反。其它5THT仍F面；全部THT在双面SMT后装。
- F面含L301，作为第二次回流设计基线；第一面B面U702/SH等的保持/支撑仍待实际工艺确定。不得以软件零违规代替回流验证。
- U701/U702 MSL2、U70275支管装；SH顶插1500/reel。细节见material-process-matrix.csv，按实际来料标签和开封记录执行。
- 免清洗为基线；BMI088禁超声/干冰，电感/JST清洗兼容按原厂。SH公开指南要求应用回流评估，不能补造统一峰温或MSL。
- 板间距未锁，名义11.6～13.33mm筛查仍未含线束/公差/附件/头壳；不据此选择隔离柱或上电。无新板实物，本包不授权下单/付款。
