parkourlrc/pcb-yilv1982--duck-robot-89dbc81d6d/hardware/custom_hat/release-review/HAT-A1-JLC-RS274X-9daf71d88e45-20261102-mechanical/assembly-process-basis.md

# 9daf71d8装配执行依据：未放行生产

2026-11-02，源9daf71d88e45a442966ac42eb058be4cbe444ffce6327bc2b79c6cdb19b470b5。同源双联r12，单元58件=52SMT+6THT，C307不装无Paste；双联104SMT/12THT。

- **J301改为B面THT，针1/2标为1:2S+、2:GND。** 其余J101/J401/J402/J403/J802为F面THT。针孔坐标不变；在B插接面、40P孔在上时，J301从左到右1→8。F面观察相反，禁止复用旧装配面。
- 两面SMT回流后再安装全部6个THT；F面含L301作为第二回流的设计基线。B面U702/SH等的保持/支撑方案由实际工艺确认，J301不参加这两次回流。
- 使用本r12的BMI08881%开口副本；钢网80–150µm与实际锡膏/全部焊盘一起选。单板BMI088原生100%开口不作为实际SMT钢网。
- U702为75支管装，需管料送料/转托盘或人工贴装；U701/U702为MSL2、260℃分类，按来料标签及开封条件管理。SH顶插为1500/reel，不套侧插3000/reel；详细原厂依据见material-process-matrix.csv。
- 6处/单元填孔并盖铜：U301五热孔和U701.7。普通盖油不代替；实际平整度由加工验收。U701仅B铜盘0.25mm，另三层0.35mm，孔0.15mm，逐层CSV明确。
- 免清洗为材料选择基线；BMI088不超声/干冰清洗。电感、连接器与MEMS的清洗相容性单独核，不把一种器件允许IPA当整板随意浸洗许可。
- 本文件不提供炉区温度设定；需要实际锡膏、板铜/器件热容量的温度曲线。SH官方要求应用回流评估，没有统一数字时不编造峰温或MSL。
- 用户尚未确定高度；参考名义板间距筛查11.6～13.33mm不含公差/线束/散热片/头壳，不能作为隔离柱采购尺寸。机械和首板功能未实测。
