parkourlrc/pcb-yilv1982--duck-robot-89dbc81d6d/docs/references/扩展板电路仿真工具/manufacturer-rules-20261031/manufacturing-brief.md

# HAT Rev A 制造参数送审提案（未发送、未获接受）

历史提案：后续已取消盲孔并更新规则，现行使用[普通四层送审参数](../npth-clearance-20261031/manufacturing-brief.md)，不沿用下表的盲孔/PP要求。

对应源PCB：c6c09b3306832200c0c723443a350882a816cb00a92d79b10551363b588d35df。文件见[同版审查包](../../../../hardware/custom_hat/rev_a/production-20261031-manufacturing-review/README.md)。此提案用于核准参数，不能直接作为下单批准。

| 项目 | 本设计/提案 | 尚需返回或确认 |
|---|---|---|
| 板框/厚度 | 65×30mm，CAD标称1.6mm | 实际成品厚度与公差、装配堆叠适配 |
| 层序 | F.Cu / In1.Cu / In2.Cu / B.Cu | 对应可下单的层叠编号、材料及逐层介质/铜厚 |
| 铜分配 | 外层含信号/地；In1地及信号；In2 +3V3及信号 | 不能当成完整无割裂参考平面 |
| 铜厚提案 | 外层1oz、内层1oz；既有电阻模型用35µm | 工艺实际铜厚与公差。公开默认内层0.5oz不能静默替代此模型前提 |
| 当前盲孔 | U701.7，In2–B，(150.3625,112.1)mm，0.35mm铜盘/0.15mm设计孔径 | 正式HDI层叠、孔深/厚径比、填铜及盖铜接受；普通通孔替代尚未采用 |
| 盲孔介质 | 参考公开HDI孔径大于相应PP厚度的条件，当前0.15mm孔径需匹配厂商实际PP | 未指定虚构压合厚度；由厂商返回满足其规则的实际组合 |
| 填孔盖铜 | 5个U301热通孔和上述1个微孔，坐标在via-process-requirements.csv | 填料、盖铜平整度、钢网与回流条件；普通盖油不替代 |
| 装配 | 52 SMT、6 THT，C307不装，双面各3个fiducial | SMT/THT服务范围、拼板/夹持；以BOM和原生坐标为准 |
| 板名/丝印 | DUCK HAT Rev A；内置文字/间距约束已加严 | 其他图形线宽、实际印刷和阻焊桥仍按工程审查核对 |
| 机械限制 | J101排母配接；H1/H2排母侧≤4.5mm圆柱头、无垫圈/六角柱 | 实际螺钉长度、另一侧堆叠和线束/壳体干涉 |

供应商需要返回的是与本设计匹配的正式层叠和孔处理结果；不能只回复“支持4层”或“支持0.15mm”。当前自动生成的默认介质Job已隔离，文件包内不提供该未经核实的层叠。

电气使用条件另列：单源供电，不支持带电USB/HAT并供；入口/线束保护职责与并发负载仍待核准，不能以TVS、铜跳线或连接器的单项额定代替整板额定。制造接受也不等于新板限流上电、温升、音频/I2S/TTL/IMU/ToF功能或实装验收。

此文件没有锁定采购价格、库存、付款或装配订单，也没有授权操作现有v2实物线路。公开依据和适用限制见[本轮研究](research.md)及sources-manifest.json。
