parkourlrc/pcb-yilv1982--duck-robot-89dbc81d6d/docs/references/扩展板电路仿真工具/npth-clearance-20261031/manufacturing-brief.md

# 历史普通四层制造参数提案（未发送）

本页源a65f2ad8…为历史检查点。现行参数及文件身份见[Rev A.1提案](../qwiic-pinout-20261031/manufacturing-brief.md)；不能将本页旧生产包与A.1针序/文件混用。

源PCB：a65f2ad8cab72721944b670dbdb6505533ae60988ce5bb3c6be51be81b3ab0a1。对应[生产审查包](../../../../hardware/custom_hat/rev_a/production-20261031-pth-clearance-review/README.md)。本页是待接受的设计参数，不是下单批准。

| 项目 | 当前要求/意向 | 待确认 |
|---|---|---|
| 板框、层数、厚度 | 65×30mm，普通4层，CAD标称1.6mm | 成品公差、材料与实际层叠 |
| 铜厚 | 外层1oz、内层1oz意向，以维持35µm模型前提 | 不能静默使用默认0.5oz内层并沿用原电阻模型 |
| via | 100个贯通孔，无盲/埋/微孔；99孔按≥0.125mm环宽，1个codec小孔0.35/0.15mm、0.1mm名义环宽 | 0.15mm机械孔及相应工艺选项、实际孔桶/公差 |
| POFV | 5个U301孔与1个U701.7孔均填孔盖铜，坐标见via-process-requirements.csv | 填料、平整度、钢网/回流；不能用普通盖油替代 |
| codec land | 矩形0.875×0.25mm，via铜盘0.35mm，Mask扩展0；B面联合形状保持 | 必须审核该矩形焊盘与盖铜组合，不仅回复“支持0.15mm” |
| 孔铜距 | via≥0.20、PTH器件孔≥0.30、NPTH≥0.25mm项目规则 | 钻刀补偿、制造公差与CAM实际结果 |
| 钻孔分类 | 独立PTH/NPTH文件：159/4个圆孔，毫米绝对坐标 | 不重复导入历史MixedPlating文件或盲孔文件 |
| 坐标 | CSV保留KiCad X/Y，并另列CAM名义X/Y；CAM Y取反，文件有输出量化 | 不再次镜像B面坐标 |
| 装配 | 52 SMT、6 THT，C307不装；双面各3个fiducial | 装配范围、夹持/拼板，实体配接 |
| 安装 | H1/H2排母侧≤4.5mm圆柱头，无垫圈/六角柱 | 螺钉长度与实际堆叠干涉 |

原自动Job的默认介质数据未被采纳，当前包不含该文件。无需再为本设计提供激光盲孔的PP厚径比，但普通四层的层叠/铜厚仍需有明确版本。

电气边界不因制造接受而消失：仅单源，不支持带电USB/HAT并供；整板并发负载、外部保护职责和首板功能仍待核准。没有采购、付款、上传或联系制造商。
