parkourlrc/pcb-yilv1982--duck-robot-89dbc81d6d/docs/references/扩展板电路仿真工具/qwiic-pinout-20261031/manufacturing-brief.md

# Rev A.1制造与装配送审提案（未发送）

设计身份：Rev A.1，PCB SHA256 `90f27091017525a22f45c8818c973c317ed6262387a98fdf06bdc26337dac2a6`。使用[本版生产审查包](../../../../hardware/custom_hat/rev_a/production-20261031-qwiic-review/README.md)，不混入旧Rev A、混合镀层钻孔或默认Gerber Job。本页是等待接受的参数，不是订单、付款或生产授权。

| 项目 | 设计要求/意向 | 需工厂反馈 |
|---|---|---|
| 板框/层数/厚度 | 65×30mm、普通4层，CAD标称1.6mm | 成品厚度、公差、材料与完整实际层叠 |
| 铜厚 | 外层1oz、内层1oz意向，沿35µm模型前提 | 各层成品铜厚/公差；不得默用0.5oz内层并沿用现有电阻模型 |
| 贯通孔 | 共100 via，无盲/埋/微孔；99孔环宽≥0.125mm | 钻孔/孔位公差及实际可制造结果 |
| 唯一codec小孔 | 0.35mm铜盘/0.15mm CAD机械孔、0.1mm名义环宽 | 该尺寸、板厚和公差组合是否接受；说明工艺钻径/成品孔的定义与补偿，不只回复最低孔径 |
| POFV | 5个U301热孔+1个U701.7孔填孔盖铜 | 按via-process-requirements.csv逐孔；填料、盖铜、平整度与回流工艺，普通盖油不可替代 |
| U701 land | 矩形0.875×0.25mm与0.35mm via铜盘联合形状，Mask扩展0 | 联合land/盖铜组合、阻焊及钢网审核；不能只检查孔径 |
| 孔铜距 | via/PTH器件孔/NPTH项目规则0.20/0.30/0.25mm | CAM、公差及钻刀补偿后的接受结果 |
| 钻孔 | 独立159 PTH、4 NPTH圆孔，mm绝对原点 | 只导入本版两份钻孔，不拼接历史文件 |
| C307 DNP | 保留铜/阻焊，当前F.Paste已去掉两个开口 | 不装、不在这两个焊盘印锡膏；以拟装BOM/SMT BOM为准 |
| 装配 | 52 SMT、6 THT，双面各3 fiducial | 服务范围、供料/缺料、钢网/回流、夹持/工艺边/拼板；代换须另核 |
| CPL/图纸 | 底面装配图镜像，CSV/CAM不再镜像 | 预览核原点、面别、旋转和pin1，尤其J101/J502与IC |
| 安装 | H1/H2排母侧≤4.5mm圆柱头，无垫圈/六角柱 | 螺钉长度、对插高度和堆叠/插接空间 |

电气身份：J502只在A.1改为GND/3V3/SDA/SCL；接口针序匹配不等于所有外设/线束兼容。仅单源供电，整板并发负载、外部保护、实际电压/热与首板功能仍需验证。制造接受不能代替这些步骤；首板实测也不是未制造前必须已经完成的前提。

请任何后续审核/报价引用“A.1”及本包身份，并逐项返回接受、条件接受或需更改及其理由。原理图创建日期/文件名中的rev_a不代表旧针序。[用户确认，2026-10-31] 自主HAT尚未送厂、没有新板实物；当前没有厂商回复记录。本状态说明不授权外发、制造或上电。
