parkourlrc/pcb-yilv1982--duck-robot-89dbc81d6d/hardware/custom_hat/panels/a1-smt-2up-20261102-r5/fabrication-candidate-bmi81-r2/ASSEMBLY-NOTES.txt

Unit IDs A1 and A2; second-unit placement reference prefix B2_ maps to the original silkscreen reference.
Standard double-sided SMT. Populate the two units identically. Do not populate C307/B2_C307.
Six THT components per unit are fitted after both SMT reflows; no blanket wave-solder process with 5mm keepout assumed.
U501/B2_U501 BMI088 are MEMS: no whole-board dry-ice or ultrasonic cleaning; compatible local method only.
Second reflow should account for the large inductor and regulator side; final profile and retention need component process data.
Panel is a manufacturing candidate; remaining U701 narrow-land concern and source-board SMT review are not waived.
