parkourlrc/pcb-yilv1982--duck-robot-89dbc81d6d/docs/references/整机装配与中位校准/research.md

# 机械装配与中位校准调研（2026-10-17；2026-10-20 复核）

> **2026-11-05 M1 闭环（用户确认）**：整机装配、主控运行、15 舵机中位标定、IMU 出数与上电检查按用户口径完成，M1 闭环。IMU 间歇缺答、行走摔倒、自主 HAT B.0 未装机作为后续可靠性/里程碑遗留继续跟踪，不否定本页装配与标定结论。

> **⚠️ 2026-10-24 ID 改号提示：本文所有按舵机 ID 记录的实测（行程、限位回填表、14 号踝等）使用的是当时的 ID 排布（10–14=左腿、20–24=右腿、30=head_pitch、31=neck_pitch）。当日已 EEPROM 改号对齐上游（20–24=左腿、10–14=右腿、30=neck_pitch、31=head_pitch），引用本文数据回填限位/参数时须按 [舵机编号对齐上游](../舵机编号对齐上游/research.md) 的合成映射换算 ID（例：旧 23 右膝→现 13，旧 12 左髋 pitch→现 22，旧 14 左踝→现 24）。**

## 现行结论与范围（2026-10-20）

用户问：“先在 FD 转到 2048，再装舵盘，最后扶直 CAL”是否必要；如果不先归中、校准偏移很大，是否危险。本轮核对厂商资料、上游记录和本地工具源码，只更新文档，没有操作舵机、修改工具或进行新测试。当前路线仍为 C 线 HD-1910-C001。

**未装舵盘时，先归中、选最近齿位装盘、再按正确机械零姿态 CAL，是推荐的低成本装配工艺；“先到 2048”不是 CAL 的协议前提，也没有证据支持“不先归中或大 offset 必然烧舵机”。** 已装好的关节不因偏移绝对值大就一律拆装，也不要为补做第一步而盲目驱动到旧坐标的 2048。

| 操作 | 实际作用 | 与装配的关系 |
|---|---|---|
| FD/工具“转到中位 2048” | 写运动目标，让输出轴实际旋转到当前坐标的 2048 | 适合轴未受机构约束时建立装盘参考；不是坐标校准 |
| 扶到机械零姿态后 CAL（`0x0B`，无参数） | 把当前位置重新定义为中位，并改变位置偏移 | 对 C001 的已核上游记录，中位是 2048；不是让轴跑到旧 2048 |
| 恢复扭矩 | 控制器重新执行有效目标 | 校准/手动摆动后须处理旧目标，不能只凭 CAL 应答直接使能 |

先归中能减少装盘后所需的**剩余校准修正**。这以原 offset 已知（通常出厂为 0）、选齿位和结构朝向正确为前提；已有未知偏移时，仅到 2048 不保证最终 offset 的绝对值小。本轮不建议为了追求“小数字”自动清零 offset。

## 本机事实与原装配资料

- **用户确认 / 2026-10-17 历史操作记录**：14 号踝关节曾用工具 mid 转到 2048、保持扭矩装配；遇到舵盘四孔与脚掌朝向“不正”的问题。早期按上游映射称其为右踝；用户实物确认后的现行本机映射为 **10–14=左腿、20–24=右腿，14 号为左踝**，见[本机 ID 映射表](../../servo-id-mapping.md)。用户确认使用飞特版打印件，不能据此宣称全部打印件版本、齿位和关节方向已经验收。
- **本机进度**：15 颗 HD-1910-C001 的 ID 已逐颗初始化为 `10–14 / 20–24 / 30–34`，当时选择“不校准只改 ID”。没有 14 号或全机 CAL 已完成的记录；各关节机械零位仍待校准。另有一颗“嫌疑坏”舵机隔离，不在装机批内。见 [PROGRESS](../../../PROGRESS.md)。
- **并发记录同步**：用户已按上述本机映射完成改号；板上部署副本的关节表经 `swap-hls-jointmap.py` 交换并重启生效，参考库未改。这来自本轮同步读到的既有执行记录，本轮未重新读取设备或运行换表脚本。
- **原资料保留**：[microduck-replica-cad](https://github.com/fanhao375/microduck-replica-cad) 的说明书 PDF、装配 BOM、23 张组件图和 STEP；右踝脚组件图路径 `组件图/15-右踝脚.png`，左侧 `06-左踝脚.png`；[B 站小腿安装视频](https://www.bilibili.com/video/BV1Xppb6tECr/)为原记录中的第 2 集入口。2026-10-17 的记录称 CAD README 摘录了 21 页说明书的“装配前通电归中位再锁紧”，当时 PDF 未取回本地，此来源限制保留。
- **2026-10-20 获取限制**：读取 [CAD README raw](https://raw.githubusercontent.com/fanhao375/microduck-replica-cad/main/README.md) 超时（25 秒），本轮未重新核验 CAD 装配 PDF 或完整观看视频。下述已读的 C001 厂商规格书不是 CAD 装配说明书。
- 本轮没有用户新图；沿用原装配上下文，不新增照片或派生图。

## 来源与定位

厂商在线正文于 2026-10-20 通过[飞特电子手册入口](http://doc.feetech.cn/#/prodinfodownload?srcType=FTServo-emanual-ab4947a479784a71a8cb7928)对应的公开 API 获取，HTTP 均为 200；仅保存 `data.mdcontent` 原字符串为 UTF-8，不加头部、不改换行。来源白名单字段、原文大小和 SHA-256 见 [sources-20261020.json](evidence/sources-20261020.json)，未保存编辑人员信息。

同目录 `.gitattributes` 仅对 `feetech-*.md` 设置 `-text`，防止 Git 在 Windows checkout 时转换换行并改变原文字节；原文行尾空白也原样保留。

两份原文各含一个指向“目录”的厂商站内导航，离线没有对应本地文件；为保持证据原样不改写该链接，在线目录请用上方厂商入口。本项目撰写的文档链接另行检查。

| 编号 / 证据等级 | 来源、版本与定位 | 可支持的结论及限制 |
|---|---|---|
| S1 · 厂商专用规格 | [HD-1910-C001 串型规格书](../../../references/microduck-replica/tools/FeeTech_HD1910M_Servo/HD-1910-C001串型规格书20260907.pdf)，A/0，2026-09-07；实际第 4 页（印刷 3/7）、第 5 页（印刷 4/7） | `No limit`、`12Bits Magnetic Coding`、`25T / OD4.95mm`、2048 中位、`0–4095 = 360°`；出厂 PD 模式 4，多圈掉电不保存，过流/过压保护默认关闭。轴本身无限位不等于机器人机构无碰撞/拉线限制；不是本机保护位回读。 |
| S2 · 厂商通用手册 | [磁编码 HLS 内存表原文](evidence/feetech-hls-memory-v1.0-20261020.md)，annexVer 1.0、version 270；第 32–33、50–51、112 行；[展示页](http://doc.feetech.cn/#/f?q=250689e628d7)、[API](http://longbos.com:9009/workflow/yf-specification/getQr/250689e628d7) | 地址 31 偏移 `−4095…4095`，BIT15 为符号、其余位为幅值；角度限制 9/11 默认 0/4095；相位 BIT4 区分单圈/全角度反馈。通用运行模式表仅列 0–3，缺 C001 模式 4，不能当作专用固件完整验收依据。 |
| S3 · 厂商协议 | [SCS 通信协议原文](evidence/feetech-scs-protocol-v1.0-20261020.md)，annexVer 1.0、version 257；第 297–335 行，§4.9；[展示页](http://doc.feetech.cn/#/f?q=2506ba160b93)、[API](http://longbos.com:9009/workflow/yf-specification/getQr/2506ba160b93) | CAL 功能为“当前位置重校准为设定值”，无参为中位；表列 HLS 固件 ≥3.43、生效条件“无”，支持有参/无参，不支持向扭矩开关写 128 校准。没有“先运动到 2048”的前提。 |
| S4 · 上游装配/调试记录 | [replica 调试记录](../../../references/microduck-replica/调试记录.md)，第 259–276 行；[servo-web README](../../../references/microduck-replica/tools/servo-web/README.md)，第 164–165 行 | 明写先 2048、齿位就近、扶直、中位校准；零姿态与 home/站姿不同。差 30° 以上追加确认、不拦，允许装盘半圈误差由校准纠正；也提示方向反了可呈现约 180° 差。是上游方法/记录，不是本机完成证明。 |
| S5 · 上游实测叙述及修订 | [社区 hls_servo_debugger README](../../../references/microduck-community-kit/software/hls_servo_debugger/README.md)，第 250–264、363–386 行；实验段落标注 HD-1910-C001 / 固件 3.46 | CAL 前位置 72、offset 0，后位置 2048、offset −1976；另有全角度反馈超窗导致整圈回转的叙述。早期“大偏移重锚”解释已被后文收窄，见下节。本地缺对应 `logs/calib` 原始日志，不能独立复算完整实验。 |
| S6 · C 线工具源码 | [protocol.py](../../../references/microduck-community-kit/software/hls_servo_debugger/hls_debugger/protocol.py) 第 629–646 行；[server.py](../../../references/microduck-community-kit/software/hls_servo_debugger/hls_debugger/server.py) 第 477–493、523–530 行；[provision.py](../../../references/microduck-community-kit/software/hls_servo_debugger/hls_debugger/provision.py) 第 28–73、161–179、783–799、881–898、1132–1142 行 | 可核对 CAL、使能、mid 与超窗处理的实现；旧源码注释不能覆盖厂商反馈定义及上游后续修订。完整 `microduck_feetech` 本地缺失，未独立审核其驱动。 |
| S7 · B 线工具源码/修复记录 | [servo-web/server.py](../../../references/microduck-replica/tools/servo-web/server.py) 第 996–1025 行；[README](../../../references/microduck-replica/tools/servo-web/README.md) 第 165 行 | B 线开扭矩前读当前、写目标 42、回读确认后使能；修复记录提到校准/手动展开后甩回旧折叠目标。不能由此声称 C 工具已有同一保护。 |

S2 的 API 修改时间为 **2026-09-29 11:01:00（Asia/Shanghai）**，S3 为 **2026-10-08 19:29:59**；均为正文元数据，不是舵机固件日期。S2 的 `code=FT-HLS-emanual`，`srcType` 含 `FT-HTS`，按返回值原样保留。原有 [SCS 本地副本](../../../references/microduck-replica/docs/飞特资料/SCS通信协议-v1.0-2026-06-09.md)第 290–328 行也有相同 CAL 语义，但文件名日期不代表本次官网更新时间。

## 为什么推荐先归中，但不能把大偏移当作烧机原因

### 装配工艺与机械零姿态

S4 第 271–274 行明确写的是“FD 先转 2048 → 装舵盘，齿位对不准就近 → 扶直 → 中位校准 → 锁紧螺丝”。它包含选近齿位后再校准，不能简化成“孔位能装上就已经完成零位”。

S4 第 264 行的机械零姿态是**腿直、脚平放、脖子竖直、头平视**；第 266 行说明站姿/home 含髋、踝、头颈非零偏角，不能直接校为 2048。踝关节的“脚板跟小腿成直角”也有其 README 第 164 行说明，旧“没有文档依据”的绝对说法不成立。嘴等关节须按自身基准确认，不能套用“腿直”。本机各关节基准仍待逐一确认。

**几何推算**：25T 对应 `360° / 25 = 14.4°/齿`。装配结构允许选最近齿位时，理想残差不超过半齿，即 `7.2° × 4096 / 360° ≈ 82 ticks`。这是几何估计，不是实测、CAL 容差或厂商安全阈值；不能忽略结构朝向、孔位约束和已有 offset。无需把 25 档试遍才判断版本或装法问题。

S3 没有要求先归中；S4 允许半圈装配误差由校准纠回。S5 的 `72 → 2048，offset 0 → −1976` 是约 `1976 × 360 / 4096 ≈ 174°` 修正成功的上游反例，足以否定“大修正必然失败”；它不能保证任意批次、固件、反馈相位和工具流程都安全。

### OFS 是什么，以及公式能说明到哪里

OFS 是位置坐标偏移，不是舵盘相对输出轴的机械安装角，也不是舵机自行识别的“关节直位”。在**一致的反馈窗口与坐标约定**下，可以用 `p = e − OFS` 解释位置读数；这里 `e` 是按同一展开/取模约定表示的编码器坐标，不能把不同圈数/窗口的数值直接混算。

S5 单次 CAL 例子中，原 offset 为 0、位置为 72；令该窗口内 `e=72`，则 `OFS=72−2048=−1976`，与校后位置 2048 相符。这支持该例子的坐标平移解释，**不构成固件跨圈行为的统一公式**，也不能证明写 OFS 会自动同步重算或重解释地址 42 的目标和 9/11 的限制，仍须处理恢复扭矩前的目标对齐。

因此，不采纳“≤一两百计数是已实测可靠区”“零偏大则一侧必顶到原始编码器量程边”的推断；25T 的半齿估计只是几何残差，不是偏移安全阈值。舵机轴的 `No limit` 也不能消除整机结构、线束和运动目标的约束。相关旧论证已原样放入[并发版本归档](archive/research-origin-31d5794.md)，以下证据和反证继续有效。

### 偏移、反馈窗口与实际负载是不同问题

- 地址 31 是位置坐标偏移，不是电流/扭矩设定。偏移大不能直接推出电流大；坐标/目标不一致造成错误运动、机构受阻后，才可能形成持续大负载。S1 注明过流/过压保护默认关闭，不能假定会自动卸载；本机保护位仍按既有安排在带载动作前回读。
- HLS 地址 31 用 **BIT15 符号 + 幅值**，范围 `−4095…4095`，不是二补码。不能因 [replica 飞特资料 README](../../../references/microduck-replica/docs/飞特资料/README.md)第 8 行把 HD-1910 归入 STS，就套用 STS bit11 偏移编码；C001 专用差异仍须结合 S1 与实际固件。
- 9/11 的单圈目标限制与 18 号相位 BIT4 的反馈表示是两件事。**单圈目标限制不等于当前位置反馈永远在 `0…4095` 内。** S5 上游记录 `18=0x34`，手推过整圈后 `head_yaw` 读到 6289，驱动取模后写目标引发整圈回转，并挤压相邻关节触发过流。这是上游叙述，本地无原始日志，不写成本机事故或必现规律。
- 早期“大偏移重锚”实验含 `−4591`，已超出 S2 的 `±4095` 范围，不能证明规范范围内的大偏移必然异常。社区 README 第 363–374 行后来收窄为“显示窗口取模”，且明说公式尚未真机验证；第 370 行“每行位置 + 偏移严格等于 −7687”也不准确，所列值只能支持**模 4096 同余**。本项目不采用旧因果定论，也不据此自动写公式修正。
- 当前 `provision.py` 已按单圈目标和 2048 零点组织流程，并有超窗检查/处理。旧[飞特通讯协议说明](../../../references/microduck-community-kit/docs/飞特通讯协议说明.md)§13.4 末尾推荐多圈的文字不能当作现行整机依据；本轮不切多圈、不改相位，不把上电重启当通用补救。

### 当前工具不能替用户消除旧目标跳动

以下适用范围为本地参考版本；板上部署状态本轮未重新读取。

| 流程 | 已核行为 | 使用含义 |
|---|---|---|
| C 线 CAL 按钮 | `protocol.py:629–646` 关扭矩 → 解锁 → CAL → 上锁；不写目标 42、不重新使能 | 有应答不能替代校后读数确认，也不代表目标已对齐 |
| C 线初始化 CAL 分支 | `provision.py:783–799` 读前后位置/偏移，但未把 `after ≈ 2048` 作为成功判据 | 成功提示主要说明指令流程收到应答，仍应核对结果 |
| C 线扭矩按钮 | `server.py:523–530` 直接写地址 40 使能，没有先对齐目标 | 手动摆动/CAL 后，不能以为点开扭矩会自动保持当前位置 |
| C 线 mid | `provision.py:881–898` 先写模式 0、使能，再写加速度/速度/2048 目标 | 会实际转动，且使能先于新目标；已装机构不能盲点 |
| B 线 `torque_on_aligned` | `server.py:996–1025` 读当前 → 写目标 42 → 回读一致 → 使能 | 只证明 B 工具有此处理，不代表 C 工具已有；本轮不改功能 |

CAL 后坐标已变，旧目标的数值可能还留着；手动摆动也会改变当前位置与目标的差。“校准时没转”与“接着开扭矩不会跳”是不同结论。正确零姿态、当前反馈、目标与机械行程须一致，不能用 offset 大小替代这些条件。

## 2026-10-20 本机追问与实测补充

以下五节为本机当日追问（工具源码/协议查证）与板上 :8765 实测记录，与上文复核结论并存：**"大偏移危险"机理的现行适用范围以节内"适用范围限定"段为准**（仅针对手动写 31 号寄存器凑目标的路径；CAL 路径 OFS 有界、到不了危险区），"齿位就近把 OFS 压到百计数级"属几何推理而非实测安全阈值，与上文"不采纳'已实测可靠区'推断"一致。

### 「转到中位」发的指令序列（2026-10-20 追问，源码查证）

**没有专门指令**——就是一次普通的位置伺服运动，全部由 WRITE(0x03) 写 RAM 寄存器完成。工具 mid 工艺的实现（`provision.py:881 _calibrate_mid`，默认 speed=60/acc=30）：

1. 33 号工作模式写 0（位置伺服）；
2. 40 号扭矩开关写 1；
3. 41 号加速度写 30（1 计数 = 8.7 °/s²）；
4. 46 号运行速度写 60；
5. 42 号目标位置写 2048（BIT15 符号幅值编码，2 字节小端）；
6. 主控轮询 56 号当前位置，误差 ≤ 8 计数（≈0.7°）判到位；
7. **不关扭矩**——位置环持续锁住输出轴停在 2048，装配时"扭矩锁定"即来源于此。

页面「位置控制」按钮走同一机制：`POST /api/move` → `write_pos_ex()` 用**一条 WRITE 从 41 号连写 7 字节**（acc + 位置 + 转矩 + 速度，等价飞特 SDK WritePosEx）；FD 上位机转 2048 同理。与 CAL 的本质区别：CAL 是特殊厂商指令 0x0B 改坐标系（OFS/EPROM，掉电留存）；转到中位只驱动轴、不写任何 EPROM，掉电后除轴停在物理位置外无痕迹。

### 编码器计数不可写（2026-10-20 追问）

协议 12 条指令（PING/READ/WRITE/REG_WRITE/REG_ACTION/RECOVERY/REBOOT/参数备份/SYNC_READ/SYNC_WRITE/RESET/CAL）中**无任何"写编码器"指令**，唯一碰零点的 CAL 写的也是 OFS(31)。内存表中编码器计数值**没有可寻址字段**：56 号"当前位置"属 SRAM 反馈区段、权限 `r` 只读，且是"编码器 − OFS"的派生值；"磁编码器"仅在 18 号 BIT0（类型 0=AS5600/1=MT6701）、19 号 BIT1（故障保护开关）、65 号 BIT1（异常状态位）出现，均非计数值。这正是 OFS 机制存在的理由：硬件测量固件只消费不修改，搬零点只能搬刻度（rewind_position 修复读数出窗也是往 OFS 加减整圈 4096，同一原理）。

### 为什么大偏移危险（2026-10-20 追问；机理综合，证据为上游实测；**当日实测后补充适用范围限定，见节末**）

四层原因，层层递进：

1. **量程几何**：编码器物理量程固定 0~4095；OFS 平移读数窗口（`读数 = 编码器 − OFS (mod 4096)`，单圈折进 [0,4095]）。零点在 2048 + 小 OFS 时关节工作区全在窗口中部（两侧各千计数余量）；大偏移（±2000 级）= 靠硬搬坐标系凑零点，关节工作区必然被窗口边界切开。
2. **边界处读数断裂**：跨边界触发 mod 4096 回绕——上游实测单圈模式 −98→3999、−498→3599、−1998→2099。轴单向连续转，读数在边界跳 4096、看似反向；速度估计/角度差/最短路径全拿错误输入。
3. **显示问题变动作问题**：42/56/9/11 号与位置环全部活在读数坐标系。同族真机案例（上游 2026-10-05）：head_yaw 被手拧过一圈读数 6289，之后任一次写目标 2048，位置环按 4 千计数差值让脖子飞快倒转两整圈——整机场景即绕线/撞限位/甩负载；反向失效：出厂 9/11 夹限下负目标被夹到 0、舵机纹丝不动。
4. **行为未定义**：窗口折叠规则手册未写（协议 12.5 未确认项），"位置 = 编码器 − 偏移 + 取模回绕"系上游四组实测点事后复算；依赖逆向出来的行为，固件升级/批次差异都可能改变。

结论："偏移越小越可靠"是几何必然——小偏移 ⇒ 零点居中 ⇒ 全行程不跨边界 ⇒ 回绕逻辑无触发机会。"先转 2048 装舵盘 + 齿位就近"即把 OFS 压到百计数级、永远留在手册定义的单圈正常区。

**适用范围限定（2026-10-20 当日 30 号 CAL 实测后修正）**：上述"大偏移危险"四层机理针对的是**手动写 31 号寄存器凑目标**的路径；CAL 路径实测证明**到不了危险区**——CAL 以单圈编码器值为基准，产物 OFS 有界 ∈ [−2048, +2047]，且校准后零位必居窗口正中、两侧各 2048 计数余量。叠加单圈模式 9/11 夹限与关节行程远小于余量，**正规流程（CAL 校准 + 程序写行程内目标）下不存在"输入角度导致转一圈多"**。真实发生过的"转一圈多"（head_yaw 6289）根因是**圈计数**而非 OFS：轴被手掰过整圈、读数累积出窗后下指令，位置环按跨圈差值执行。**装配期实用规则：手转过的舵机，下指令前先读 56 号——读数在 0~4095 内随便用；出窗则先 CAL 或手转归位再动**（2026-10-20 30 号手转一圈半读数 −3399 → CAL 后 2048 即安全落地实例）。装机后机械限位使整圈手掰基本不可能，该入口随之封闭。三个入口完整判定（2026-10-20 补全）：① 程序正常驱动（目标 ±180° 内）：单圈闭环差值 ≤ 半圈，圈计数不会累积，绝不多转；② 目标写窗口外：单圈模式被夹到边界，不跨圈执行（多圈模式才会真转大角度，属主动行为）；③ 手掰出窗后下指令：与目标大小无关，按跨圈差值多转——唯一需主动防的入口。手掰后的处置按对象分（2026-10-20 定稿）：**未装机散件** → 手掰→CAL→下指令即安全（CAL 归位 2048 + 清圈计数 + OFS 有界，30 号当日全程实例）；**已装机已校准关节** → 不可随手 CAL（会把"手掰后停住的姿势"重定义成零位、覆盖摆直校准成果），正解 = 手转归位或 rewind（OFS 挪整圈，零位定义保留，即工具 rewind_position 语义）。已装机关节受机械限位保护、整圈手掰基本不可能出窗，该区分主要适用于装配期台面散件。

### 本机抽查：30 号（头颈）编码器/OFS 实测（2026-10-20，板上 :8765 API）

经 `/api/read` 读 30 号：**31 号 OFS = 0**（出厂未校准，符合"只改 ID、校准留装机后"的初始化决定）；**56 号当前位置 = 2047**（≈178.09°，轴停在中位附近，差 1 计数 ≈ 0.09°）。编码器值 = 读数 + OFS = 2047（OFS=0 时读数即编码器值，公式本机印证）。本机实测级别：直接读数。

**用户手动转约一圈半后复读**：OFS 仍 = 0（手转不动 EEPROM，公式再次印证）；当前位置 = **−3399 计数**（raw `47 8D`，BIT15 符号幅值）——读数跑出单圈窗口 0~4095，本机复现上游 head_yaw 6289 案例的"全角度反馈不自动回绕"现象（彼为正向出窗、此为负向）。圈数账：差 −5446 计数 ≈ 1.33 圈，与"一圈半"差约 0.17 圈（61°），手转不准或固件快速跟踪丢步无法区分（待确认）。**注意：此状态下写任何目标位置（如 2048）会让位置环按 5447 计数差值真转约 1.33 圈回正**；恢复路径 = 手转回原位，或工具 rewind（OFS 挪整圈折回单圈窗口）。

**出窗状态下执行 CAL（2026-10-20 本机实测，上游未测过此场景）**：CAL 后 **OFS = −1352、读数 = 2048**。反推：轴当时单圈编码器值 = −3399 mod 4096 = 696，−1352 = 696 − 2048（差 1 计数量化）——**CAL 以单圈编码器值为基准**（若用多圈值应为 −5447，超 31 号字段范围 ±4095 写不进）。三个含义：① CAL 产物 OFS 有界 ∈ [−2048, +2047]，危险的超范围大偏移只能来自手动写寄存器凑目标，CAL 自身到不了；② CAL 顺带清圈计数（读数从 −3399 回 2048，等效自带 rewind）；③ CAL 后"此刻物理位置"必钉在读数 2048 窗口正中（几何必然）。注意：此次把"手转后停住的姿态"钉成了零位，30 号未装机、该零位无机械意义，装机后须在"关节摆直"时重做 CAL；还原出厂 = 解锁 55 → 31 号写 0 → 上锁。

**CAL 后再手转数圈复读**：OFS 仍 = −1352（第四次验证：轴怎么转都不动 EEPROM）；读数 = **−6216**（≈ −540.8°）。相对 CAL 后起点 2048 变化 −8264 计数 = **−2.02 圈**，与"负向转约两圈"吻合（差 72 计数 ≈ 6°，手转正常误差；对比首次"1.5 圈差 698 计数"，支持"快转丢步、慢转跟得住"猜想，仍待系统验证）。**CAL 只清一次圈计数，之后手转照常累积**——再次出窗（−6216 在 ±2 圈显示窗口内、出单圈窗口），处置同前：动之前先 CAL 或手转归位。

### 手掰行程检查首轮记录（2026-10-20，servo-trace 原始数据存档）

工具：`scripts/servo-trace.py` 板上运行 881.5 s / 1769 轮；原始 CSV 与汇总存本目录 `servo-trace-20261020.csv` / `.summary`（另用 3D 数字孪生 `scripts/servo-mujoco-viewer.py` 实时观察，用户关闭窗口退出）。数据质量分析（出窗采样 + >1000 计数跳变检测）：

- **干净可用 11 颗**：10、11、13、14、20、21、22、24、30、31、33（无出窗无跳变）。上下限（相对 2048，°，未含方向系数）：10(−93.7/+44.4)、11(−24.6/+24.0)、13(−159.4/+4.0)、14(−100.4/+46.9)、20(−37.8/+33.2)、21(−23.8/+29.1)、22(−119.6/+74.1)、24(−51.6/+99.6)、30(−94.7/+89.3)、31(−62.6/+155.7)、33(−26.3/+18.7)。
- **出窗污染需重测 1 颗**：23 右膝（3 出窗采样 +1 跳变，span 4022 为伪影）。
- **32 head_yaw 定案（2026-10-20 用户实物确认）**：左右加起来可转约 360° 属**正常设计**（脖子 yaw 近全向自由关节，线束会阻止一个方向的整圈）；用户决策为线束安全起见**软件限制到 270°**——训练回填 range = **±2.356 rad（±135°）**。原记录（min 336/max 4029，1 次出窗采样）与实物能力相符，不需重测。
- **未测到**：34 嘴（全程 8 计数 ≈ 0.7°）。
- **硬件疑点**：12 左髋 pitch 连续无干涉转 323°（144→3818，全程未跨 0/4095 边界、无跳变，非出窗伪影）——待用户实物核查是结构未锁紧还是类似 32 号的自由行程设计（12 号尚未确认）。
- 附带观察：左右腿行程不对称（10 vs 20、14 vs 24 近镜像），可能为装配差异或掰的仔细程度不同；13 号 +4° 上限不对称待确认。
- **回填训练前提**：需先完成重测与硬件核查，再按关节方向系数换算填 `training/params/microduck_geometry.json`。

**左右腿对称性配对分析（2026-10-20，两轮数据合并；判据 = 总行程 + 镜像端点方向，非绝对端点相等）**：① **hip_roll 11/21 对称良好**（48.6° vs 52.9°）；② **ankle 14/24 对称良好**（147.3° vs 151.2°，不对称方向镜像：左 −100/+47、右 −52/+100，符合左右腿镜像装配）；③ **knee 13/23 接近**（≥163° vs ~200°，13 疑未掰满、正向仅 +4° 待确认是否单向弯）；④ **hip_yaw 10/20 数据不完整**（20 两轮基本未掰，10 的 −93.7° 超模型设计 −25°/+30°，需复核）；⑤ **hip_pitch 12/22 严重不一致**（368° vs 144~194°，22 未掰到头，待补）。**待补一轮：20 到头（含 10 复核）、22 到头、13 正向**；补完后回填建议左右同对取公共范围，保持仿真模型左右对称。

### 限位回填表（2026-10-22 起草；规则 = 设计意图 ∩ 实测可达，保守交集）

换算：模型关节角 = −(计数−2048) × 2π/4096（方向 −1，duck-control 约定；与 3D viewer 一致，用户未报反向）。实测取四轮合并可信覆盖；自由关节（12/22/32）按设计/决策值收紧。

| 关节 | 设计 (rad) | 实测可达 (rad) | **回填值 (rad)** | 变化 |
|---|---|---|---|---|
| left_hip_yaw | [−0.436, +0.524] | [−0.782, +1.822] | **[−0.436, +0.524]** | 保持（实测覆盖设计） |
| right_hip_yaw | [−0.524, +0.436] | [−0.747, +0.833] | **[−0.524, +0.436]** | 保持 |
| left_hip_roll | ±0.384 | ±0.430 | **±0.384** | 保持 |
| right_hip_roll | ±0.384 | [−0.509, +0.415] | **±0.384** | 保持 |
| left_hip_pitch | ±1.5708 | 近全向（378°） | **±1.5708** | 保持（自由关节按设计收紧） |
| right_hip_pitch | ±1.5708 | 近全向（386°） | **±1.5708** | 保持（同上） |
| left_knee | ±1.5708 | [−1.570, +2.765] | **±1.5708** | 保持 |
| right_knee | ±1.5708 | [−0.75, +3.037] | **[−0.75, +1.5708]** ⚠️ | 负向收紧至 43°——待用户确认 +43° 到头 |
| left_ankle | ±1.5708 | [−0.820, +1.752] | **[−0.820, +1.5708]** | 负向收紧至 47° |
| right_ankle | ±1.5708 | [−1.735, +0.901] | **[−1.5708, +0.901]** | 正向收紧至 51.6° |
| neck_pitch | [−1.5708, +1.047] | [−1.558, +1.651] | **[−1.558, +1.047]** | 负向微收至 89.3° |
| head_pitch | ±1.5708 | [−1.092, +2.714] | **[−1.5708, +1.092]** | 正向收紧至 62.6° |
| head_yaw | ±2.967 | 全向 | **±2.356** | 用户决策（线束安全） |
| head_roll | ±0.436 | [−0.461, +0.327] | **[−0.461, +0.327]** | 正向收紧至 18.7° |
| mouth | 不建模 | 单向 38.3° | 不回填 | — |

小结：14 关节中 **7 保持设计值**（实测覆盖证明设计可达）、**6 处单侧收紧**（实物比设计窄的方向，策略须避开）、**1 处用户决策放宽收紧**（head_yaw）。待定项：23 号右膝 +43° 端点确认后定稿；12/22 维持 ±90° 设计（若用户想用更大行程需另定并考虑线束）。

**第四轮补测与对称终版（2026-10-20，servo-trace4，原值法全 0 跳变；数据存本目录 `servo-trace4-20261020.csv`）**：① **hip_pitch 对称确认**——22 掰到头后 **386.1°**，与 12（378°）同类，双髋 pitch 均为近整圈自由关节，之前"严重不一致"系 22 未掰到头；② **hip_yaw 真实不对称**——左 [−104,+45]°/右 [−43,+48]°，正向对称、左侧负向多 ~60°（疑线束路径差异，非数据问题）；③ knee 负向对称（−159/−174）、**正向存疑**（13 到 +157°、23 仅 +43°，23 正向是否到头待用户确认）；④ 13 正向实测可达 +157°（第一轮"+4° 即停"系未掰满，勘误）；⑤ 其余（hip_roll/ankle/头颈）维持前轮结论。**行程检查数据至此收官（待 23 正向一问）**，回填采用：对称关节左右取公共范围、自由关节（12/22/32）用设计/安全限位值（32 已定 ±2.356 rad）、实测小于设计的（ankle 正向、head_pitch 负向、head_roll 正向、右 hip_yaw 负向）按实测收紧。

**第三轮重测（2026-10-20，servo-trace3，23/34/12 目标 + 全关节记录）**：原始数据存本目录 `servo-trace3-20261020.csv` / `.summary`。**汇总方法勘误（用户证词触发）**：trace 脚本"折回单圈取 min/max"在从出窗状态出发、转动跨 4096 边界时会制造整圈假象；正确算法为**原始读数差值**（0 跳变=连续跟踪，差值即真实物理转角）。修正后实测：**23 右膝总行程 ≈200°**（两轮 200.6/204.4，与用户"差不多半圈"证词吻合，接近设计 ±90°——正常带机械限位的膝盖，此前"整圈自由关节"判定作废）；**12 左髋 pitch ≈323~368°**（两轮一致，确系近整圈大行程，手感待确认）；13 左膝 ≥163°；22 右髋 pitch 144°（与左髋 368° 严重不对称，右侧可能未掰到头，待补测）；24 右踝 102°；**34 嘴有效：单向张开 38.3°**；32 两轮 360°（用户确认，限 ±2.356 rad）。**修正后分类**：自由大关节仅 **12 与 32**；其余腿/头颈关节均有正常机械限位、可用实测。回填策略：普通关节用实测值，12/32 用安全限位值（12 待定，32 已定）。第一轮窗内无出窗关节数据不受此 bug 影响。本轮插曲：hls 服务运行中僵死（端口占用+无响应），用户态杀掉重启并重连 /dev/ttyS2 后恢复，第二轮 trace 因服务僵死产生全空数据已弃用。

### 舵机电压/过流保护（19 号 BIT0/BIT3）开还是不开（2026-10-20 问答定案）

**结论：不开**（维持出厂 19=4 只开过热，与 15 颗初始化决定一致）。依据：① 19 号语义是"触发即卸载脱力"，整机站立时触发=摔机，防烧能力有限；② **15 号最低输入电压出厂默认 40 计数 = 4.0V**（本机 2S NP-F550 跌到 4.0V 前早断电，开了形同虚设；调阈值则带载电压跌落可能误触发摔机，开前须实测整机带载 sag）；③ 过流只有时间参数可调（38 号默认约 2s），电流阈值不可调，防烧主力按既定路线走硬件保险丝/限流；④ 上游 16 台实测全为 19=4、15 台整机真机保持此配置（ID 10 曾手工 19=13 试验后恢复）。重评时点：带载动作测试（已有"保护位回读"待办）或长时间无人值守运行（届时先台架验证堵转确实触发）。来源：memory_table.py 14/15/38 号字段定义 + hls_servo_debugger README 保护位实测记录。

## 最短建议流程与本机下一步

1. **未装盘且轴未受机构约束**：确认原 offset/坐标状态，先归中到 2048，按正确结构朝向选最近齿位装盘。已有未知 offset 时不自动清零；已装好的不补做盲目驱动旧 2048。
2. **校准**：支撑机身/关节、关扭矩后，扶到该关节机械零姿态并保持，再执行 CAL。孔位可安装与机械零姿态是两个条件；home/站姿不能替代零姿态。
3. **恢复扭矩前**：确认当前读数约为 2048；本机容差未定，不编造阈值。再以校准后的当前坐标对齐目标并回读确认，避免执行旧目标。现有 C 线 CAL/扭矩按钮不会自动完成对齐，未确认时保持关扭矩。
4. **已有装配**：按正确基准 CAL 并处理目标，不因偏移绝对值大就一律拆盘。读数异常/超窗、方向不符或零姿态未知时再针对性排查；本轮不新增整机扫到机械极限、台架测试或通用重启步骤。

待确认项：本机各颗固件/原 offset 与反馈相位、各关节零姿态及校准结果、恢复扭矩前目标对齐的完成情况；本轮均未取得新实机回读。后续按[工具索引](../../bench-tools.md)与 [PROGRESS](../../../PROGRESS.md)继续，不把研究结论记成操作完成。

## 2026-10-17 原判断勘误（2026-10-20 生效）

| 原判断（撤出现行指导） | 修正及理由 |
|---|---|
| “通电归中位再锁紧是上游唯一明文要求” | “唯一”不成立；S4 第 271–274 行还明写选近齿位、扶直、CAL，再锁紧。CAD PDF 未取回的限制保留。 |
| “2048 时脚掌与小腿垂直无文档依据” | 撤回绝对否定：S4 有腿直脚平的零点定义和“脚板跟小腿成直角”说明。未校准时旧 2048 仍不能证明实物已处于正确零姿态。 |
| “孔位对齐即完成对位/零位” | 孔位可装仅说明能连接，不等于模型零位正确，仍需基准姿态与 CAL。 |
| “试遍 25 档才判件/舵盘不匹配” | 无此必要性证据；先核版本、朝向和几何配合，选最近可用齿位。用户已确认飞特版件，不扩大为全部配合已验证。 |
| “后续每颗一律 mid 保持扭矩装结构件” | 收窄为未装盘、轴不受机构约束时的归中工艺；已装机构不盲点 mid，手扶校准须支撑并关扭矩，恢复扭矩前对齐目标。 |

初次提交前已核对两份厂商正文 SHA-256、来源 JSON 和 5 份受改项目 Markdown 的 192 个本地路径链接，项目撰写的文档 `git diff --check` 通过；厂商原文自带的 14 行行尾空白与两个“目录”导航原样保留，不作排版修正。未做软件自检或硬件测试。上游只读文件保持原样，勘误记在本项目文档。

## 并发同步记录（2026-10-20）

本轮初次提交 `bfc385e` 推送被拒，读取远端后发现 `a688bf2`、`58b4ebf`、`31d5794` 三项并发更新。合并保留用户确认的本机左右腿映射和已有执行事实，并把有用的 OFS 定义加上反馈窗口适用条件；旧必要性/跨圈推断原样保存在[远端研究归档](archive/research-origin-31d5794.md)。双方历史均保留，现行装配结论以上文证据为准；本轮未运行远端新增脚本或操作实物。

2026-10-20 晚又一轮同步合并：远端复核三提交（`bfc385e`/`dd428df`/`d34bca2`）与本地校准完成记录（`e62c2b8`，含 15 颗"摆直→CAL"全部完成的点检快照，见 [PROGRESS](../../../PROGRESS.md) 当日条目）并存。本文冲突按"以复核版为底、本机追问/实测五节移入『2026-10-20 本机追问与实测补充』"处理；被复核撤回的"若省略第一步…正踩重锚/回绕坑"段不再保留（归档件内已有）；PROGRESS 两侧条目按时间倒序并存（校准完成 → 组装完毕 → 复核调研）。

已完成普通合并 `dd428df`；合并后首次推送及对同一上游 `origin/main` 的重试（仅临时使用 HTTP/1.1）均因 GitHub 连接重置（`Recv failure: Connection was reset`）失败，本地提交保留，截至本轮未推送。
