parkourlrc/pcb-yilv1982--duck-robot-89dbc81d6d/hardware/custom_hat/release-review/HAT-A1-JLC-PCBA-86654c03b6c1-20261103-assembly/tht-process-notes.md

# HAT A.1 r18：THT后焊方式及间距约束

2026-11-03。源86654c03b6c1c8f51f7d5a4bef469aceed2ddfc73433b3e50426940c2a23164a；r18拼板fd6cd170fc09848e37feb88e10dad3bbf1d21954a8139f7bb0f8a303e4ceb22c。此文件是设计工序选择，不是工厂已接受、已焊接或实物通过。

采用顺序：B面SMT→F面SMT→支撑切断连接带及毛刺检查→全部6件/单元THT局部逐点手工焊接。分板时尚未安装THT，不手掰分板；详见depanel-process-notes.md。禁止把笼统“后焊”解释为整板波峰焊或通孔再流焊。选择性焊接若被提出为替代，需有实际喷嘴/托盘/热影响评估，当前没有自动批准。

嘉立创62761第2节说明，插件引脚5mm内有贴片件无法进行波峰焊。按原生59个钻孔完整圆与反面52个SMT的Fab框筛查，6个连接器均有低于5mm的邻近位置；这是文件包络筛查，不是实际焊接工具可达性或温度测试。

| 单元位号 | 元件面 | 焊接面 | 最近针脚/反面SMT | 孔边到Fab框名义距离mm |
|---|---|---|---|---:|
| J101 | F | B | pin39 / C311 | 4.196832 |
| J301 | B | F | pin5 / C304 | 2.510000 |
| J401 | F | B | pin3 / C326 | 3.035000 |
| J402 | F | B | pin1 / J506 | 2.140033 |
| J403 | F | B | pin3 / R703 | 0.809000 |
| J802 | F | B | pin1 / C315 | 3.445401 |

A2对应B2_前缀、相同朝向/工序。实际双联12件、118个THT针脚；注意118针与装配映射的118项（包含DNP）数值恰好相同但含义不同。tht-soldering-plan.csv与JSON给出逐件/逐针数据、源SHA及官方正文哈希。

手工逐点不等于可以忽略邻近器件：尤其J403.3附近R703，仍需按实际烙铁头、加热时间、焊料与夹具检查可达性和热影响。使用与具体MPN匹配的焊接窗口；本文件不填未经原厂/工艺确认的统一烙铁温度。安装方向、润湿/填孔、桥连、塑料变形、针脚突出与焊后清洁按实际过程验收。没有为逃避几何问题改变元件/网络、扩大板框或减少功能。

官方来源：https://www.jlc-smt.com/technology/detail/62761.html；原文归档于项目docs/references/归档扩展板嘉立创规则自查/sources/smt-rule-62761.txt。JST官方资料也未把普通THT作为pin-in-paste回流器件；沿用回流后安装，不能套SH耐热PA结论到EH通孔座。
