parkourlrc/pcb-yilv1982--duck-robot-89dbc81d6d/hardware/custom_hat/release-review/HAT-A1-JLC-RS274X-96dcce92ca42-20261102-polarity-r2/assembly-process-basis.md

# A.1装配执行依据：尚未成为生产工艺卡

2026-11-02，主源96dcce92…，同源双联r11。单元58拟装件=52SMT+6THT，C307不装无Paste；双联104SMT/12THT。原厂出处/页码见[矩阵](material-process-matrix.csv)，原件在本项目docs/references/归档扩展板极性与装配资料/sources中归档；不存在本板回流实测或物料批次验收。

1. 使用同源r11最终制造副本；BMI088每单元16个开口面积81%，钢网厚度按Bosch80–150µm范围与全部焊盘工艺一起选择。不能用单板100%原始Paste替代。
2. 两面SMT回流完成后，再装6件通孔座。JST官方说明多数通孔壳体不适合回流，不先焊通孔再整板过炉。输入/输出接口针序按A.1契约，SH板端PA与线端PBT分开。
3. 含大电感L301的F面作为第二次回流的工序设计基线；第一次装B面的U702/SH等在第二次回流中位于下方，不能凭目录尺寸保证不会掉件。实际送料/保持或支撑方案须按制造批次确定；不未经依据自动灌胶，避免污染MEMS/连接器。
4. U702 LP38691DT-1.8/NOPB为管装75支，不伪报编带；选可处理管料的供料、转托盘或人工贴装。保持原MPN，不擅换DTX。U701/U702为MSL2、260℃分类/1YEAR floor life，管理按实际来料标签及开封条件；其它器件逐行看矩阵，不统一MSL1或MSL3。
5. 6处/单元填孔并盖铜：U301五热孔及U701.7。普通盖油不代替，表面平整度是实际加工检验；逐层via铜盘尺寸见CSV。
6. 使用免清洗方案作为材料选择基线。BMI088不做超声/干冰清洗；Vishay电感也推荐免清洗，必要清洗须确认溶剂相容、冲洗/干燥与MEMS要求兼容。原厂说“IPA推荐”不能理解成整板随意浸洗许可。
7. 炉温设定尚未给出。元件本体温度不等于炉区温度，必须按锡膏、板铜、器件热容量检查实际profile。公开指南已取得的器件按其适用条件，SH没有统一数字，按其原厂操作规范执行应用评估；嘉立创62781对缺参数的样品过炉建议是制造阶段项，不能把尚未制造状态填成已合格。
8. 最终来料/过炉/装配记录须绑定本源和实际替代料。分板支撑、毛刺与机械堆叠确认在制造后；本文件不授权下单/付款/上电。
