parkourlrc/pcb-yilv1982--duck-robot-89dbc81d6d/docs/references/扩展板乙版降本/layout-spacing/baseline-99ecc45d/review-output/assembly-bottom.png

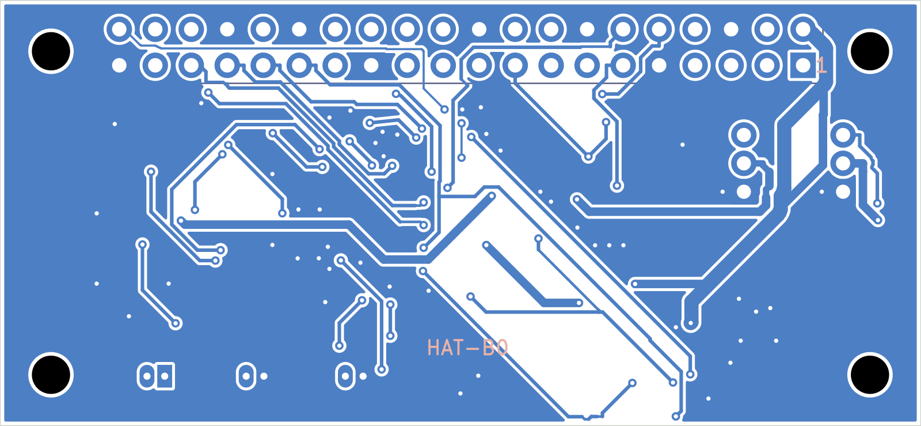
docs/references/扩展板乙版降本/layout-spacing/baseline-99ecc45d/review-output/assembly-bottom.png
