parkourlrc/pcb-yilv1982--duck-robot-89dbc81d6d/docs/references/扩展板电路仿真工具/manufacturer-rules-20261031/assembly-before-tp803-front.png

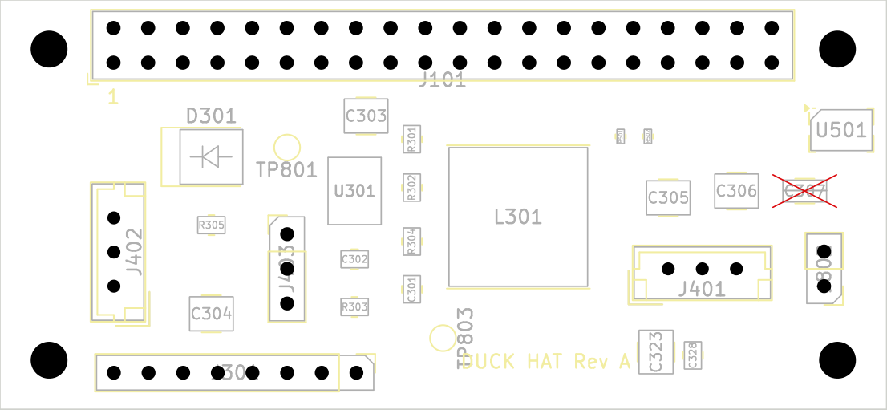
docs/references/扩展板电路仿真工具/manufacturer-rules-20261031/assembly-before-tp803-front.png
