parkourlrc/pcb-yilv1982--duck-robot-89dbc81d6d/docs/hat-v1.2-test.md

# HAT V1.2 接线与分阶段验证单

> **2026-11-02 来源更正（重要）**：用户确认当前整机 HAT 为 [kissqy/Microduck-kissqy](https://github.com/kissqy/Microduck-kissqy/tree/main/hardware) 的 HAT REVA，**不是本页这块白色 V1.2**。本页步骤、针序与受损记录只适用于旧板历史；当前板须按对应版本工程（EH2.5 10-07 / AMP2.0 10-15，实物待核）执行。旧照片已归档至 [photos/archive](photos/archive/README.md)。

> **2026-11-01 当前装机更新**：新单 3P 口 IMU 已换上，软件身份为 ft6/legacy；servo-web 混合 SYNC_READ 已通过只读验收，见[当前记录](references/飞特策略模型上机核对/restore-mixed-sync-read-20261101.md)。下文旧 GD32/v0.3 的电气、固件和故障数据只适用于所标版本，不自动套给新板；本轮未更改供电、刷写或做动作。

> **2026-10-27受损状态更新**：用户已拆下HAT R31并尝试短接，反复操作后两侧焊盘脱落。此板先保持断电，按[修复记录](references/扩展板焊盘脱落修复/research.md)核对剩余网络、修复及排查新增短路后再恢复测试；下方历史步骤不能直接用于当前受损板。示波器定位是维修后的下一阶段，H1日志是否可用另按实际固件构建核对。

> **2026-10-10 修订**：本单取代旧版“扫描背面八焊盘找电池入口”“超级电容”“蜂鸣导通即可过 3–5A”“一颗舵机 ping 通即可整机放行”等不成立的判据。
> 当前只有 V1.0 图纸，实物是 V1.2；未有本机电气验证结果。先取得相符图纸/板卡来源说明，或由具备测量条件者核清网络。**身份或极性不明不接电池、不向未知焊盘送电。**
> **2026-10-16 精简记录**：当时用户要求非必要测试先跳过，以下“最短路径”记录的是旧单链流程。2026-10-24 用户补充实际已改为 HAT 单口外部分叉；本页不构成要求重复执行测试或改线的指令。

接线意向图：[hat-v1.2-wiring-plan.png](photos/archive/hat-v1.2-white-20261010/hat-v1.2-wiring-plan.png)。[供电方案](./power-architecture-v2.md)与[证据记录](./references/供电与扩展板实物复核/research.md)。

> **2026-10-26历史接线记录**：当时用户确认单口GD32 IMU已接回HAT另一个口，00:11 servo-web运行；曾考虑FT232H读取H1日志，现按构建开关条件使用。现行顺序以顶部受损状态及[排障计划](./references/舵机网页工具惯性显示/debug-plan-20261026.md)为准。此前HAT第二口电压已由用户确认无问题，完整读取2/360属历史窗口，不默认重复测压。微雪同口独立舵机也无字节，不能当已知正常主机。下方单链图和“链末接IMU”步骤仅历史意向/异常参考，不代表当前布线。

## 历史执行流程：最短路径（2026-10-16）

**A 段断电核对曾于 2026-10-11 通过**（结果见 [PROGRESS](../PROGRESS.md)），Radxa 环境及 IMU ID 200 也有既往通信记录。以下步骤记录当时的单链意向流程，不代表 2026-10-24 的外部焊接分叉；不因本次文档勘误重复执行。当前布线异常时再按症状参考下文。

| 顺序 | 做什么 | 通过判据 |
|---|---|---|
| 1 HAT 空板验 5V | 限流电源 7.4V / 0.3A，红接背面第 3 排焊盘（+BATT）、黑接第 4 排（GND），接前目视核对极性；量 40P 排母 pin2/pin4 | **5.0V±0.2V、无持续顶限即过**——插 Radxa 前唯一保留的实测门（防 5V 异常烧主控），几分钟的事 |
| 2 插 Radxa | 断电对插 40P，重新上电（限流按主控实际需求放宽，不沿用 0.3A），`ssh radxa` | 稳定启动、ssh 可连、无反复重启 |
| 3 单舵机 ping | 接一颗舵机（杜邦过渡线脚序交叉，接前目视核对；扭矩关闭），板上 `python3 feetech-ping.py scan` | ping 通、ID 确认 |
| 4 挂 IMU 板② | 链末接入（针序目视核对），ping ID 200 | 应答正常 |

**已裁掉的前置项（出问题再查）**：8.4V 满电端点（B3）、空板/主控下 DATA·3.3V 电平核验（B4/C2）、MCU 干扰静置（C5/B6）、舵机保护位只读回查（C4a，**带载动作前再做**，一行命令）、各阶段静置观察与温升记录、IMU 板②台架独立验收单的分步流程（挂链 ping 通即可，13 项深度验收出问题再跑）。串口回环自检本就跳过。

**停止条件（不变）**：持续顶限/电压塌陷、主控或 IMU 反复重启、通信明显恶化、关节卡住/自激、局部快速升温/异味。出现即停，回头按下文 A–D 段排查；不要盲目加大限流或关闭保护来“通过”。

## 异常排查参考（原分阶段清单）

以下为 2026-10-10 版基础检查清单与 A–D 详细核对段，**不再是前置门**，仅按需查阅：

| 顺序 | 做什么 | 通过后才能做下一步 |
|---|---|---|
| 0 断电核线 | 电池/USB/台架全部断开，确认两口实际 GND/+BATT/DATA、线缆两端对应、40P 方向；电池输入 DATA 留空 | 无错位、无裸线短接、无未确认极性/电源网络；不要按照片猜针脚 |
| 1 HAT 空板 | 用现有可限流电源，7.4V、空板 0.3A 作为诊断起点；不插主控、舵机或 IMU，测 40P 的 5V | 输出约 5V 且稳定，无持续顶限、异常温升；输入允许值确认后再单独核验满电 8.4V，不能将空板结果推广为全机载流 |
| 2 主控 / IMU | 分别验证主控启动后的 5V 和 IMU 板自己的 3.3V；对插/换线均断电，USB/HAT 不盲目双供 | 主控稳定启动、IMU 正常供电/应答，无明显压降或反复重启；主控限流按实际需求与路径额定重新设定，不沿用空板 0.3A |
| 3 单舵机 | 先确认 ID、启动行为和扭矩关闭，再 ping/读取反馈及保护配置；安全支撑后做单关节小幅低速动作 | 方向/动作正常，无卡滞、异响或电流持续顶限；只读核查保护，别运行会覆盖参数的批量初始化 |
| 4 整链通信 | 每次断电后增加节点；确认各 ID 唯一、启动不自动运动；全链仅通信/回读，保持扭矩关闭 | 舵机与末端 IMU 均可识别，主控不重启，无持续丢包/异常温升；不得一上来执行全机归位或站立 |
| 5 低负载动作 | 安全支撑、防跌防夹；只使能本次受测关节，先单关节再少量关节、小幅低速动作，逐步增加观察时间 | 输入电流在受测路径允许范围内，远端电压和主控 5V 无明显异常、接头/线/板温升稳定；尚不等于全部关节高负载或自由行走验收 |

## 2026-10-10 v2 接法意向（已被当前用户描述取代；仅作历史排查参考）

- 图中 **A** = 照片左侧 SERVOS 座，拟接电池 +BATT、GND 两线，DATA 脚留空并绝缘。
- 图中 **B** = 相邻 SERVOS 座，三线接舵机链，IMU J1 接链末，J3 留空。
- 图中 **C** = 背面 40P 排母，对插 Radxa Zero 3W。只从 HAT 获取正确的 5V，不给 40P 直接送电池原电压。
- A/B/C 是图示编号，不是丝印或厂家输入/输出定义。核验两座电源同网、针序一致及路径合格后，A/B 才可交换角色。
- V1.0 图定义 SERVOS pin1=GND、pin2=+BATT、pin3=DATA；**不能由正面照片直接认定上下针序**。HAT、线缆两端与舵机/IMU 的插合视角分别核对。

## A. 断电核对（电池、USB、主控、舵机、调试器全部断开）

- [ ] A1 记录 HAT 版本、两座位置、实际连接器系列及观察方向。以已确认的 40P GND 或明确地网络作参考，核实两个 SERVOS 座的 GND；**安装孔不默认接地**。
- [ ] A2 核实候选 +BATT 与板内降压输入网络的关系，以及两座 +BATT/GND 对应连通。检查是否串入开关/保险等元件；未取得图纸时不能仅靠蜂鸣排除其存在。**导通只验证网络，不验证载流。**
- [ ] A3 核实 DATA 与电源没有误接，测量电源对地是否存在可疑持续低阻。电容充电、保护器件会影响表读数，不把“响/不响”单独当结论。
- [ ] A4 背面八个焊盘对应两组 4Pin 空位，不是另发现的电池入口；本方案不用这些焊盘输入。圆柱电容读到“10 / 50V”，不按超级电容或 RTC 电源处理。
- [ ] A5 对电池取电线及舵机转接线逐端确认 +BATT、GND、DATA。电池到 A 只装两根供电导线；杜邦信号线不作整机动力线。电池原压不能接 DATA、IMU J2 的 3V3 或 HAT 40P 的 5V。
- [ ] A6 核验 Radxa 对插方向、pin1、排针高度、间隙与外壳，避免旋转/错位。确认主控 USB 与 HAT 同时供电是否获支持；未确认就只留一种供电路径。

**A 阶段无法确定针序、电压或网络时停止，不能靠上电试错。** 不用表笔扫 MCU 密集引脚来证明“不干扰”；隔着缓冲器/电阻的电路不会因不蜂鸣就不存在。

## B. HAT 空板台架（不是电池直接首次上电）

- [ ] B1 在 A 阶段已核实后，使用可限流台架电源，不接电池、不插主控和舵机；初测采用 7.4V，空板限流 0.3A 作为诊断起点。设定与接线在输出关闭时完成，复核正负再开输出。
- [ ] B2 测 40P 5V 轨初检约 5.0V（以主控和器件规格为最终判据），记录输入电流、供电状态、异常温升。持续顶限/电压塌陷立即关输出排查；可能是浪涌、限流不足或故障，不能直接断言短路，更不能盲目加大限流。
- [ ] B3 验证工作电压范围端点前先确认全部器件允许值，再检查 8.4V 下的 5V 输出；低端测试以实际电池/系统停机阈值为准，6.6V 仅是待校准参考。
- [ ] B4 不用“空板 DATA 必须是 3.3V”作为此阶段判据：V1.0 的 +3V3 可能来自对插主控，空板总线驱动可能未供电。禁止向 DATA 强灌电压。

## C. 逻辑与通信（每次增减插接件先关输出）

- [ ] C1 先断电对插 Radxa，按已确认的主控需求与线材能力重新评估限流；空板 0.3A 不作为主控启动配置。检查启动时 5V 波动、输入电流，确认串口设备与占用状态。
- [ ] C2 主控供电稳定后核验 HAT 的 3.3V 和 DATA 空闲电平、UART2/半双工路径，若与 V1.0 不符先查来源说明。不仅靠万用表平均电压判断协议波形正确。
- [ ] C3 IMU 在独立限流台架确认实物 LDO、VBATT 输入、3.3V 输出及温升，再刷写匹配固件并做 imu200 验收；本步骤需要的 SWD 调试器不属于整机常驻链路。
- [ ] C4 先接一颗 ID/波特率已确认的舵机，初始扭矩关闭，确认可通信且无异常动作；之后连接链末 IMU 验证唯一 ID（IMU 200 不与舵机冲突）。连接器与针序核对优先于软件调试。
  - 主控侧工具：[`scripts/feetech-ping.py`](../scripts/feetech-ping.py)（已部署到板子 `~/feetech-ping.py`）。接线前可先用 `python3 feetech-ping.py loop`（杜邦线短接排针 pin8↔pin10，无需任何供电）验证 ttyS2 收发通路；舵机总线接好后用 `python3 feetech-ping.py scan` ping 舵机（默认扫 ID 0–6、1 Mbps）。前提：/dev/ttyS2 已启用（见 [瑞莎开发板软件环境](./references/瑞莎开发板软件环境/research.md)）。
- [ ] C4a **先只读回查舵机保护**：对应型号/固件核验 19 的 BIT3、28 保护电流、38 延时和 33 模式，并核对运行软件对 RAM 目标电流/限幅的改写；不运行会写默认配置的初始化来代替读取。C001 手册过流出厂默认关闭，社区工具默认亦关闭；没有回读前不声称“堵转瞬时保护有效”，不擅自写保护参数。见[风险核查](./references/舵机堵转烧板风险/research.md)。
- [ ] C5 MCU 功能需板卡说明或信号测试确认；静置无异常或 ping 成功不证明 MCU 永不影响总线。异常动作/总线冲突先停，不据此直接认定 MCU 是根因或自行断脚。

## D. 配电验收（独立于单节点通信验收）

- [ ] D1 查实际 A/B 座及压接端子、线规、banana 触点、电池自身短路/过流保护及 HAT 公共铜箔能力；先依据电池保护资料判断是否需外置主保险（不足/不明则另行设计），A 入口承担主控、舵机和 IMU 的总电流，B 承担下游链电流。
- [ ] D2 当前资料采用 EH 约 3A 额定，而社区整机常态参考 3–5A，是需要核验的潜在不匹配，**不是一次短时过流必然烧毁的证据**。**在额定不满足时先改配电，不通过超额带载去“试是否能扛住”。** 5A 保险不能保证保护 3A 连接器。
- [ ] D3 在已核准额定内逐级增加负载，记录稳态/启动峰值、接头与线材压降、温升以及主控/IMU 是否重启；不做整机堵转测试，台架面板平均电流不能覆盖快速尖峰。
- [ ] D4 保护/入口条件不足时，改用经设计确认的配电或大电流入口。简单保留旧稳压板或把两口并接不能自动解决该瓶颈。

## 收尾判据

记录各阶段测试条件和结果到 [PROGRESS](../PROGRESS.md)。

- A/B/C 通过：只能说明候选连接关系、逻辑供电与受测节点通信可用，**不是整机放行**。
- D 通过且电池过流保护路径（电池内置保护已核实，或必要的外置保护已设计）、接线及低电量处理已核准：才评估整机上电。
- HAT 逻辑链路不适配：微雪板可作台架/替代架构候选，重新设计主控供电，而不是直接照本图替换。
