parkourlrc/pcb-yilv1982--duck-robot-89dbc81d6d/docs/imu-gd32-bench-test.md

# IMU 板②（jyg9 GD32 社区版）台架验收单

> **2026-11-02 用户确认来源更正**：当前装机的新单 3P 口 IMU 是 [kissqy/Microduck-kissqy](https://github.com/kissqy/Microduck-kissqy/tree/main/hardware) 的 `imu_to_dxl RevA V1`（STM32G031F8P6 + LSM6DSV16X，FT6 固件），**不是本页的 jyg9 GD32 板**。本页 GD32 的电气、固件与验收数据只适用于那块历史板，不能套到当前板。见[版本调研](references/惯性单元三版来源对比/research.md)。

> **2026-11-01 当前装机更新**：新单 3P 口 IMU 已换上，软件身份为 ft6/legacy；servo-web 混合 SYNC_READ 已通过只读验收，见[当前记录](references/飞特策略模型上机核对/restore-mixed-sync-read-20261101.md)。下文旧 GD32/v0.3 的电气、固件和故障数据只适用于所标版本，不自动套给新板；本轮未更改供电、刷写或做动作。

> 2026-10-14 建。对象：**单 3P 口**的 IMU 板，照片判别为 jyg9 / microduck-community-kit 成品版（GD32F303 LQFP48 + 降压前端），判别证据与照片存档见 [IMU 版本调研](./references/惯性单元三版来源对比/research.md) 补充节及 [照片索引](./photos/README.md)。
> **2026-10-16 精简（用户指示：非必要测试不做，先跑通有问题再说）**：本板免刷、宽压直挂，现行最短路径 = 接线前目视核对针序（接反会烧板，保留）→ 挂 7.4V 限流总线 → ping 200 应答即可；下文分步台架流程与 13 项深度验收降级为**异常排查参考**，出问题再跑。详见 [HAT 测试单·最短路径](./hat-v1.2-test.md)。
> 与板①（ScrapMeta v0.3）的区别：**本板免刷固件**（出厂 DXL 2.0 + 飞特双协议自动识别，ID 200）；**供电按 0.2 官方图纸需 ≥6.5V 冷启动（EN 分压设定，维持下限 ≈5.93V），5V 必不启动**——该启动判断只针对本单口板；v0.3 的“只给 5V”旧限制已于 2026-10-31 依据 AP2210 原厂手册撤回，5V/7.4V 均在其 LDO 工作范围内，两块板不要套同一份参数（见[复核](./references/惯性单元输入电压复核/research.md)）。Buck=ETA2845S2G（5~38V、OVP 37.5V），电源树与启动电压计算见 [jyg9 电源分析](./references/单口惯性单元五伏供电/research.md)（2026-10-26）。
> **2026-10-26 撤回 5V 过渡方案**：此前"手边只有 5V 可短暂试机看点亮"的说法不再有效——按官方原理图 EN 分压（R3 100K/R4 30K → 0.231×VBATT，阈值 1.5V），**5V 输入时芯片保持关断，板上不可能点亮，5V 试机无意义**；欠压不伤板的判断不变，验收一律 7.4V，撤回"欠压可随便试"和"点亮即可"的旧指导。
> **2026-10-25 供电勘误（保留部分）**：本单口板免刷，ID 200，支持飞特/DXL 2.0，标称输入 **6–24V，台架使用 7.4V**，并非只能恰好 7.4V；不能套用双口 ScrapMeta 板的供电限制。**微雪仅插 USB 不等于 IMU 得到 5V**：官方图的 USB 供逻辑，3P 的 V 接外部 DC 电源轨。应先断电，给微雪 DC 输入接 7.4V，核极性后通电，经已核对的 D/V/G 线给 IMU 供电。单口成品板未见 LED，不以灯亮作为判据。此次 USB-only 无应答不能判板坏，详见[供电核对](./references/舵机网页工具惯性显示/research.md#waveshare-usb-20261025)。
> 本单只做**台架通信验收**，不做整机带载；结果不代表装入整机后的表现。

> **2026-10-26 当前排障**：用户已将单口 IMU 接回 HAT 另一口；此时不要求回微雪重做下表。先核对本机固件构建和日志开关：官方 1.5.1 默认 `DBG_ENABLE=0`，已确认关闭则跳过 H1 监听；启用时再用现有 FT232H 只收日志（实物针序/模式确认后），DAPLink 作为 H2 SWD 后备。见[分阶段计划](./references/舵机网页工具惯性显示/debug-plan-20261026.md)与[社区同类故障调研](./references/社区惯性单元通讯核查/research.md)。微雪独立舵机对照也失败，尚不能作为已知正常工具。

## 前提与物料

| 物品 | 说明 |
|---|---|
| IMU 板②（单 3P 口，用户口头“板一”） | 免刷固件；EH 座针序 1=GND 2=V+ 3=DATA 已获官方 0.2 图纸确认（另有并联 PH 座焊与否待实物核）；2026-10-25 微雪台架 D/V/G 已由用户核对，重新接线仍须核极性，先核后电不变 |
| 德力西可调电源 DLX-30V10AMF | 台架供电，**设 7.4V、限流 0.2A 起步**（6~24V 输入范围内、对齐 2S 电池标称） |
| FE-URT-2（或微雪转接板 B 模式） | URT-2 只过 DATA/GND，IMU 另接 7.4V 并共地；微雪可由 DC 输入接 7.4V、3P 输出给 IMU。USB 负责转换器与数据，不能替代外部电源；不把舵机的电压上限套给单口 IMU |
| 杜邦母头线 / EH 3P 线 | 板座为 JST EH 3P（2.5mm）；过渡用杜邦母头套座针（2.54 兼容 2.5），胶带固定防松 |
| 万用表 | 核针序、核电源空载电压、测通断 |
| 电脑 + `flash/2-查COM口.bat`、`flash/3-验收-imu200.bat` | 可参考相同遥测协议；状态位等判据须与实际固件版本核对，不能直接把双口板全部判据当作单口板已验证契约 |

## 步骤

| 顺序 | 做什么 | 通过判据 |
|---|---|---|
| 0 断电核线 | 全部断开。按 [三板舵机座对比](./photos/board-servo-socket-pinout.png) 核对板座针序（EH 座 1=GND 2=V+ 3=DATA，照片推断 + 官方 0.2 图纸双重一致；板上如焊有并联 PH 2mm 座注意其针序相反 1=DATA 2=V+ 3=GND，**勿混插**）：蜂鸣档确认 GND 脚对板内地网连通、V+ 与 GND 之间无短路；电源输出关闭状态下预设 7.4V / 0.2A，复核正负 | 针序明确、无短路；电源空载输出 7.4V 左右。针序无法确认则停止，不上电试错。⚠️ 板上电源正极无保险，反接只靠 TVS 正向导通兜底必烧——核线不可省 |
| 1 空板供电 | 只接 V+/GND 两线（DATA 悬空），开输出 | 电流稳定在几十 mA 量级、无持续顶限、无异常温升；单口成品板照片与官方设计未见 LED，不以灯亮为判据。顶限或发热立即关输出排查 |
| 2 接总线 | **关输出**，接 DATA/GND 到 URT-2（V+ 仍走可调电源，共地）；URT-2 插电脑 USB，`2-查COM口.bat` 记 COM 号 | 接线完成后再开输出；无异常电流变化 |
| 3 imu200 验收 | 双击 `3-验收-imu200.bat`，输入 COM 号，按实际固件解释检查项 | PASS 只说明本窗口内对应判据满足，不能保证 robotd 整链稳定；保留日志、供电及版本，FAIL 逐项区分版本差异与实测异常 |
| 4 晃动验证 | 验收通过后在工具读数期间轻晃/翻转板子 | 四元数/陀螺读数随姿态连续变化、不冻结、无丢帧突增——确认真 IMU 数据而非静态缓存 |

## 5V 供电不可用（2026-10-26 图纸定案，撤回原过渡方案）

~~2026-10-14 曾允许"手边只有 5V 电源时做冒烟测试"。~~ 已撤回：官方 0.2 原理图 EN 分压（R3 100K/R4 30K）使芯片在 5V 下保持关断，**5V 供电不会点亮也不损坏，试机无意义**；"欠压不伤板"结论保留。判好坏、做验收一律 7.4V（冷启动需 ≥6.5V，详见 [jyg9 电源分析](./references/单口惯性单元五伏供电/research.md)）。已有数据须标明真实供电，不能用于排除供电原因或认定板坏；微雪 USB-only 更不能直接标成"IMU 输入 5V"，IMU 端实际电压尚未实测。

## 停止条件与边界

- **停止条件**：针序不明、上电持续顶限、异常温升/异味、验收中反复掉线。不要盲目加大限流来"通过"。
- **2026-10-26 调试口更正（官方 BOM/图纸核对）**：板上没有 CH340/USB 插座（早期调研"jyg9 版带 CH340"与官方图纸不符，出入关闭），但本地设计预留 H1 UART 日志、H2 SWD、H3 USB 下载焊盘，撤回"没有调试日志可看、判别全靠总线侧"。H1 可作为绕过舵机数据通路的日志排查候选，须先匹配实物焊盘和供电；本机镜像是否启用日志未验。H3 电源脚在图中直连 +BATT，不能把普通 USB 5V 与带电电池轨直接并接；这不是 USB 接线放行。详见[接口核对](./references/惯性单元三版来源对比/research.md#usb-debug-20261026)。固件升级后续走社区 `upgrade.py` 总线在线升级，本单不涉及。
- 2026-10-25 身份窗已回读 **1.5.1 / 槽 A / CRC32 0xD9CA0DEF**；构建指纹未匹配官方包不等于 Flash 损坏，未刷机。出厂固件版本号可在验收日志应答包里找版本寄存器，或后续用社区主机工具读；发现版本过旧再决定升级，不擅自刷写。
- 单独成功窗口不代表整链合格：10-25 已在 HAT 上观察单读和交错读取均缺答，完整条件和未解决项见[排查研究](./references/舵机网页工具惯性显示/research.md)；验收通过只证明"总线从站合格"，装入整机（挂 8.4V 总线末端、与 15 颗舵机同链 sync_read）按 [HAT 验证单](./hat-v1.2-test.md) 第 4 阶段整链通信执行。

## 最少记录

针序核对结果、各阶段输入电压/电流、COM 号、imu200 日志路径、PASS/FAIL 明细、晃动验证现象。
