parkourlrc/pcb-yilv1982--duck-robot-89dbc81d6d/docs/specs/20261028-custom-hat/first-article-test.md

# Rev A 首板测试计划

> **2026-10-29起停用，2026-10-31更新导航：下文整体为历史草案，不作现行制造、采购或上电指导。** 当时电路/封装缺陷已陆续修复，现状见[问题矩阵](../../references/扩展板电路仿真工具/issue-matrix-20261030.md)。旧固定电流/电压阈值、UART回环和直接全舵机动作步骤继续停用；改读[Rev A.1最短首板草案](first-article-a1.md)，其必要供电条件尚待落实。

## 历史正文（已失效）

> 目标：**先保命，再验功能**。前置规则沿用[现行 HAT 最短测试单](../../hat-v1.2-test.md)：只做防烧板检查，纯软件自检能省则省。
> 本计划针对 Rev A（无屏幕、无摄像头、新增 1.8 V 轨与双面贴装）。

## 0. 上电前的三个前提

1. **J101 方向已核对**（丝印 “1”），否则 5 V 会打进 3.3 V 网络。
2. **5V 与 GND、3V3 与 GND 不短**（万用表通断）。
3. **明确供电方式**：本板把 5 V 反送给 Radxa（40P pin 2/4）。
   - **不要同时用 USB-C 给 Radxa 供电又让 HAT 供 5 V**，两路电源会互相灌。
   - 推荐：首板测试阶段由**台架电源经 HAT 的 J301 输入 8.4 V**，Radxa 只从 40P 取电。

## 1. 阶段一：空板限流上电（不插 Radxa）

| 步骤 | 操作 | 判据 |
|---|---|---|
| 1.1 | 台架电源 8.4 V、限流 **100 mA**，接 J301 pin1(+)/pin2(GND) | 电流 < 30 mA |
| 1.2 | 测 `+5V` 对 GND | 4.9–5.1 V |
| 1.3 | 测 `+3V3`、`+1V8_CODEC` | 约 0 V（这两路来自 Radxa，未插时为 0，**正常**） |
| 1.4 | 摸 U301、L301 | 不烫（< 40 °C） |

异常即停：电流突增、5 V 明显偏低、器件发热。

## 2. 阶段二：插 Radxa，验证 3.3 V 与 1.8 V

| 步骤 | 操作 | 判据 |
|---|---|---|
| 2.1 | 断电，把 HAT 插到 Radxa 40P | 对齐、无歪针 |
| 2.2 | 台架 8.4 V 限流 **300 mA** 上电 | Radxa 启动（LED/HDMI） |
| 2.3 | 测 `+3V3` | 3.2–3.4 V |
| 2.4 | 测 `+1V8_CODEC` | 1.75–1.85 V |
| 2.5 | 测 5 V 轨带载 | ≥ 4.75 V |

> 3.3 V 由 Radxa 提供，**HAT 不能反向给它供电**；测到 0 V 说明 40P 未接触或 Radxa 未启动。

## 3. 阶段三：总线与器件

| 项 | 方法 | 判据 |
|---|---|---|
| 头部 IMU | `i2cdetect` 看总线 5 | 出现 `0x19`（加速度）与 `0x68`（陀螺） |
| ToF 座 | 插模块后 `i2cdetect` | 出现模块地址（按模块规格） |
| 音频 codec | `i2cdetect` 看 0x18；`aplay -l` | 识别到声卡 |
| UART2 | 短接 TX/RX 回环（**仅在确认 console 已关闭后**） | 收發一致；未关闭前不要测 |
| 舵机总线 | 接 1 个 HD-1910，低速小角度动作 | 有响应、不过流 |

**UART2 是 U-Boot 调试口**，未关闭 console 前不要把它当普通串口用——这是软件侧遗留阻塞项。

## 4. 阶段四：整机联调

1. 接全部舵机与身体 IMU，低速跑一遍动作序列；
2. 观察 5 V 轨压降与 U301 温度；
3. 记录任何复位、掉线、异常发热。

## 5. 验收判据

| 等级 | 条件 |
|---|---|
| **通过** | 三路电压正常、IMU/ToF/codec 均被识别、舵机总线可通信、无异常发热 |
| **有条件通过** | 功能正常但某路电压偏离 > 5%，需记录并限期复测 |
| **不通过** | 任一电源异常、器件不识别、或出现复位/过热 |

## 6. 记录要求

每次测试记录：日期、板号、供电方式、各路电压实测值、环境温度、异常现象。写入 `docs/references/` 对应专题，不只留在聊天里。
