parkourlrc/pcb-yilv1982--duck-robot-89dbc81d6d/hardware/templates/pcb-project/first-article-test.md

# 首板测试记录

- 项目/版本：
- 订单/生产包哈希：
- 收货日期/数量：

## 1. 来料与外观
- 包装/数量/板号/版本丝印：
- PCBA 位号/连接器方向/损伤：

## 2. 断电检查
- 电源入口/极性/短路：
- 关键网络/THT 焊点/DNP：

## 3. 限流上电
- 限流值/电压：
- 电压轨/静态电流：

## 4. 功能
| 项目 | 条件 | 结果 | 限制 |
|---|---|---|---|
| 主控启动 | | | |
| 总线/IMU | | | |
| 舵机通信 | | | |
| 其他 | | | |

## 5. 结论
- 通过/失败：
- 失败项与返修/ECO：
- 用户验收（日期）：
