parkourlrc/pcb-yilv1982--duck-robot-89dbc81d6d/docs/references/代码编辑器安装记录/verification.txt

Date: 2026-11-01 (Asia/Shanghai)

Pre-install:
winget list --id Microsoft.VisualStudioCode --exact --source winget --accept-source-agreements --disable-interactivity
No installed package found matching input criteria.

Install:
Found Microsoft Visual Studio Code [Microsoft.VisualStudioCode] Version 1.143.1
Successfully verified installer hash
Starting package install...
Successfully installed
Exit code: 0

Post-install code.cmd --version:
1.143.1
e646868227c3e3a9e3f24277c8c7220be42c0be7
x64

Post-install winget list:
Microsoft Visual Studio Code (User) Microsoft.VisualStudioCode 1.143.1

Executable:
C:\Users\elvis\AppData\Local\Programs\Microsoft VS Code\Code.exe

Start Menu shortcut:
C:\Users\elvis\AppData\Roaming\Microsoft\Windows\Start Menu\Programs\Visual Studio Code\Visual Studio Code.lnk

Matching user PATH entries:
C:\Users\elvis\AppData\Local\Programs\Microsoft VS Code\bin
C:\Users\elvis\AppData\Local\Programs\Microsoft VS Code\bin\copilot-shim
