parkourlrc/pcb-yilv1982--duck-robot-89dbc81d6d/docs/references/自主扩展板下单记录/substitution-sources/murata-grj155-characteristics.txt

---PDF PAGE 1---
Chip Multilayer Ceramic Capacitor
                             Electrical Characteristics Data

            Murata Global Part No.            Chip Size Code        Temp.    Cap.Value      Cap.Tol         Rated Volt.    Durability
                                              (mm/inch)             Chara.                                                 (%Rated Volt.)
            GRJ155R60J106ME11                 1005M/0402            X5R      10μF           ±20%            6.3Vdc         100%
                                                                              *Volt. & temp. derating recommended product
     1. Dimension

                                                                             3. Impedance/ESR­Frequency
                                                                                 Equipment:Impedance/Network Analyzer

            L                    W                     T
            1±0.2                0.5±0.2               0.5±0.2

     2. Capacitance, D.F. and I.R.

                            Specifications          Measuring condition
            Capacitance     8μF to 12μF             1kHz / 0.5Vrms
            D.F.            0.1(max.)               1kHz / 0.5Vrms                                            Frequency[Hz]
            I.R.            5 Mohm(min.)            6.3V, 60s                                    |Z|              ESR

     4. Capacitance­DC Bias Characteristics                                  5. Capacitance­AC Voltage Characteristics
         1kHz / 0.5Vrms    Equipment:LCR Meter                                   1kHz     Equipment:LCR Meter

                                        DC Bias[V]                                                           AC Voltage[Vrms]

     6. Capacitance­Temp. Characteristics                                    7. Temperature Rise­Ripple Current
         1kHz / 0.1Vrms    Equipment:LCR Meter                                   Equipment:Temperature Rise ­ Ripple Current Measurement system

                                   Temperature[degC]                                                           Current[Arms]
                                                                                                 80kHz 0.5 Rated Voltage
                                                                                                 400kHz 0.5 Rated Voltage
                                                                                                 800kHz 0.5 Rated Voltage

     This PDF has only typical specifications.
     Therefore, please approve our product specification                                                     Click here to visit
     before ordering. Product specifications in this PDF are as of Nov. 2026.
     They are subject to change or our products in it may be discontinued without advance notice.            Murata WEB site.
