parkourlrc/pcb-yilv1982--duck-robot-89dbc81d6d/docs/references/自主扩展板下单记录/substitution-sources/murata-grm32-characteristics.txt

---PDF PAGE 1---
Chip Multilayer Ceramic Capacitor
                             Electrical Characteristics Data

            Murata Global Part No.            Chip Size Code       Temp.     Cap.Value     Cap.Tol          Rated Volt.    Durability
                                              (mm/inch)            Chara.                                                  (%Rated Volt.)
            GRM32ER71E226KE15                 3225M/1210           X7R       22μF          ±10%             25Vdc          150%
     1. Dimension

                                                                             3. Impedance/ESR­Frequency
                                                                                 Equipment:Impedance/Network Analyzer

            L                    W                     T
            3.2±0.3              2.5±0.2               2.5±0.2

     2. Capacitance, D.F. and I.R.

                            Specifications          Measuring condition
            Capacitance     19.8μF to 24.2μF        120Hz / 0.5Vrms
            D.F.            0.1(max.)               120Hz / 0.5Vrms                                           Frequency[Hz]
            I.R.            2.27 Mohm(min.)         25.0V, 60s                                  |Z|              ESR

     4. Capacitance­DC Bias Characteristics                                  5. Capacitance­AC Voltage Characteristics
         120Hz / 0.5Vrms    Equipment:LCR Meter                                  120Hz     Equipment:LCR Meter

                                        DC Bias[V]                                                          AC Voltage[Vrms]

     6. Capacitance­Temp. Characteristics                                    7. Temperature Rise­Ripple Current
         120Hz / 0.5Vrms    Equipment:LCR Meter                                  Equipment:Temperature Rise ­ Ripple Current Measurement system

                                   Temperature[degC]                                                          Current[Arms]
                                                                                                80kHz 0.5 Rated Voltage
                                                                                                400kHz 0.5 Rated Voltage
                                                                                                800kHz 0.5 Rated Voltage

     This PDF has only typical specifications.
     Therefore, please approve our product specification                                                     Click here to visit
     before ordering. Product specifications in this PDF are as of Nov. 2026.
     They are subject to change or our products in it may be discontinued without advance notice.            Murata WEB site.
