parkourlrc/pcb-yilv1982--duck-robot-89dbc81d6d/docs/references/舵机网页工具惯性显示/根目录日志-20261025/README.md

# 根目录日志（2026-10-25）

2026-11-05 从仓库根目录移入本专题，原文未改写；文件名与日期保留。

| 文件 | 原路径 | 说明 |
|---|---|---|
| `imu-case-test-20261025.log` | 仓库根目录 | 2026-10-25 IMU 用例测试日志，未在本轮重新分析 |
| `imu-reconnect-watch-20261025.log` | 仓库根目录 | 2026-10-25 IMU 重连监视日志 |
| `wiggle-test-20261025.log` | 仓库根目录 | 2026-10-25 线束/摆动测试日志 |

关联：[本专题研究](../research.md)、[扩展板双口惯性缺答复核](../../扩展板双口惯性缺答复核/research.md)、[PROGRESS](../../../../PROGRESS.md)。
