parkourlrc/pcb-yilv1982--duck-robot-89dbc81d6d/docs/references/扩展板电路仿真工具/issue-matrix-20261030.md

# HAT 已知问题现状矩阵（2026-11-03 更新）

当前86654c03/r18，见[BMI088电源/邮票孔/规则勘误](../扩展板邮票孔与电源修复/research.md)。新增BMI088 0.5mm/0.2mm F.Cu电源支路；邮票孔居中、X108/160分板带局部退铜；修复第二单元Power映射。原生主板/拼板全0，两个0.175mm探针均被Power0.2规则拒绝。旧r1～r17退出制造入口；实际工艺/制造/完整机械与首板未验。U301分窗、MPN、方向标记等既有修复保持。

| 项目 | 当前状态 | 证据/处理 |
|---|---|---|
| `R308.2 ↔ U701.7 +3V3` | **连通保持，焊接面铜盘已收敛** | F/内层铜盘0.35mm，B面0.25mm，孔0.15mm并填孔盖铜；B面铜盘已包含原land，不再突出。原连接保持，见[当前修复](../归档扩展板音频芯片焊盘/research.md) |
| 自定义规则未加载 | **已修复并防再发生** | 旧数值缺单位，CLI仍出报告；现有单位、哨兵验证和回写护栏。旧零计数不能代表全部DRU有效执行 |
| 原型规则范围过宽 | **已退役** | U501 courtyard条件曾匹配整片zone，使其它位置也用0.12mm；现恢复Default 0.15/Power 0.2，原线路无需移动 |
| U501 错误铜/keepout | 已关闭 | DRC/连通复核通过 |
| BMI088重铺连接依赖 | **已加明确铜支路** | 退铜拼板情景出现1未连接，旧单板检查仍0；不能倒推一直断网。新增F面0.5mm支路后原生0，原连接/参考铜保持 |
| 拼板Power规则继承 | **r18修复，r1～r17撤出** | B2/+3V3由错误Default0.15改正确Power0.2；两单元0.175mm探针均报错，项目/DRU/edge哈希绑定 |
| 邮票孔/分板退铜 | **r18文件已修** | 40个0.6mm孔居中于单元边线；X108/160局部退铜，每单元4421参考铜点无减少；分板毛刺实物未验 |
| THT“后焊”方式未明确 | **20261103-assembly交付包已明确** | 6件各有5mm内反面贴片件；选择双面SMT及支撑切断分板后逐点手工焊接，禁整板波峰/通孔再流，12件/118针面别完整；真实工具/工艺和焊点未验 |
| J301/J506 机械与扬声器走线冲突 | 已关闭 | 候选通过 DRC 后回写 |
| I2S_SDO 未连通 | 已关闭 | `U701.4 → J101.40` 同网连通 |
| 悬空过孔/丝印 | 已关闭 | 两个悬空孔移除，U301 丝印转 F.Fab |
| 双面 fiducial | 单板错误已修，拼板PFID候选已补 | 双联85×82mm、8mm边、双面各3不对称PFID，1/2mm、边距4mm及3mm铜干扰核查通过；未当作整板制造放行 |
| 地via | 现行共17孔 | 含5个U301热孔、输入/I2S/功放地孔及新增2个TTL地孔；原生检查全0，VS-002识别受限 |
| MPN字段 | **已完整：58/58** | 38/38拟装BOM分组、35唯一MPN；C309丝印变体增加一个分组，器件未增；库存/生命周期与适用性另核 |
| L301/R309具体封装 | **已修** | 5.6µH IHLP4040DZER5R6M5A与WSL120600000ZEA9铜跳线匹配专用焊盘；原连接保留 |
| 整板载流/入口 | **入口/舵机铜已加宽，额定未核准** | 主路径0.6→1.2mm，指定铜段压降模型降低；EH/SH及J301配对/线束条件仍约束并发负载，不能借器件额定放行整板 |
| +5V主输出压降 | **主控主干已加宽，整板端点验收仍待完成** | 原0.45/0.6mm主要内层路径改1.2mm；示例指定铜段压降96.96→44.82mV，未计接点/孔壁/地回程/瞬态，不当主控实际电压 |
| 入口保护 | **职责已说明，实际条件待核准** | U301保护不覆盖R309直通的舵机支路；TVS/铜桥不代替持续过流/反接阻断，未设置2S专用欠压截止；外部保护、线束和并发条件仍未核准 |
| J301输入识别 | **B面插接已明确编号** | 40P孔在上时B端子面从左1→8，1=2S+、2=GND；F面相反。其它不同电压/NC针不作输入，见电源接口说明 |
| USB/HAT并供边界 | **已明确：本设计不支持带电双源并供** | 官方V1.11 p20/22显示GPIO5V与USB VBUS同网；只在HAT串二极管不能隔离HAT到USB的路径，不将并供当已提供功能 |
| U803本地去耦 | **布局缺口已修，实际性能待验** | C323改22µF/F面，新增C328=2.2µF；经成对VDD/GND孔接U803，VDD到旁路平面短线2.947mm，另计孔桶/ESL；未实测THD/PSRR/噪声 |
| TTL缓冲本地去耦 | **布局缺口已修，完整高频回流/实际性能待验** | C329/C330各100nF，B面VCC线3.135/1.441mm，约0.8mm地线接各自地孔；孔连F/In1/B，原铜/连接保留，U801 DC-002消失 |
| J101实体及安装预留区 | **文件已修，实装待核** | 原只镜像焊盘导致实体错位；按Samtec重画，H1/H2排母侧限定≤4.5mm圆柱头、无垫圈/六角隔离柱 |
| Buck电容偏压裕量 | **四颗已升级，完整稳定性待核** | C303～C306改22µF/25V/X7R/1210；输出5.119V时单颗典型16.18µF，非保证下限；C307仍DNP |
| LDO容量/ESR与局部回路 | **布局/裕量改动已实施，完整环路待核** | C308/C309改2.2µF，C309线长2.227mm，R703=47mΩ仅串电容回地；C311并联已计入，不宣称整轨ESR全频≥5mΩ |
| J504低阻负载 | **未确认用途/使用限制，不是已测故障** | 当前可查需求/原始附件未见明确低阻耳机指标，不能把假定用途列为已确认缺陷，也不能由此宣称用户不要耳机；现有交流耦合口仍不能直接按低阻耳机性能放行 |
| 音频mixer路由 | **离线工具已补，现场未验** | [路由工具](audio-routing-20261031/research.md)核78项源控件/使用70项，支持主扬声器L+R混音、J504立体声和LINE1L差分输入；10项模拟场景、8种组合通过，真实控件/PCM/播放录音仍待验证 |
| codec硬件复位 | **可控通路已补，时序待验** | J101.33=GPIO3_C3接CODEC_RST；原来已有R308=10k/C310=100nF，撤回“只有上拉”漏读。旧RC是否满足上电条件未实测，不能称必然失败；新增控制通路仍需当前驱动与波形核验 |
| 主控驱动适配 | **codec及BMI088离线产物已补；现场未验** | 两codec模块通过ARM64/vermagic/55项CRC，overlay在两种官方Zero3W DTB合并核针序/供电；[BMI088双I2C适配器](bmi088-adapter-20261031/research.md)已静态构建、核原生板针序及7项host故障场景。当前内核/占用、真实加载/采样未验，不能由编译判定功能通过；[官方包依据](driver-compatibility-20261031/research.md) |
| FB/COMP跨层长走线 | **布局已修** | FB总长19.96→6.33mm、COMP26.16→4.51mm，均F.Cu，4个控制网via移除；稳定性未验收 |
| AP64350 Eq12系数疑点 | **图示理想网络已独立核对** | 推导及3组301频点仿真一致；印刷式系数与图不一致，未取得厂家勘误，不作为完整IC环路模型；现14k/3.3n保持 |
| 5V瞬态/输入并发预算 | **已形成明确情景，非额定** | 低输入时本地有效电容影响阶跃裕量；0.2V等为分析选择，不是Radxa门槛。双3A+5V2.5A示例需8.228A输入，不能将各端口目录上限相加当整板能力 |
| I2C5 上拉 | **本板缺项已修** | R501/R502各4.7kΩ到+3V3，四个新焊盘全连；初始100kHz/240pF条件、外设并联上拉和波形仍待验 |
| J502针序 | **A.1已修** | 旧Rev A为V/G/SCL/SDA，不能标准Qwiic直插；现为1GND/2VCC3.3/3SDA/4SCL，原生正确连通，未移动接口/扩大板框。板面A.1区分旧版；外设兼容条件/实测另核 |
| 通孔环宽 | **分层尺寸符合公开最小条件** | 99孔≥0.125mm；codec F/In1/In2铜盘0.35、孔0.15→环宽0.1，B面铜盘0.25→0.05，B面处公开极限并非推荐裕量；限定B层规则及三项负对照通过，填孔盖铜保持 |
| U301热孔/输入去耦 | **几何连接缺口已修，热能力待验** | EP内5个同网孔连F/In1/B地铜；C303新增VIN线2.7025mm；不能由孔数推θJA或额定电流 |
| U701/U702热路径 | **按具体功耗/封装评估** | 同网盘内孔仍0；codec热孔可选，TO-252不套WSON要求，不采用通用5/18孔门槛 |
| C305/C309盘中孔 | **已修** | 两通孔移至焊盘开窗外，原线宽及全部焊盘连接保留，VP-001消失 |
| 盘内孔制造要求 | **6孔尺寸符合公开填孔盖帽范围** | 5×0.3mm+1×0.15mm在0.15～0.55mm范围；四层须明确选填孔盖帽并标6处，逐层CSV已写U701的B铜盘0.25mm；不等普通盖油或成品验收 |
| U701.7窄焊盘盘中孔 | **文件几何已修并回写** | B面via铜盘0.25mm同心并完整包含原land，原Mask/Paste不变；另三层0.35mm、孔0.15及填孔盖铜保持。原连接/参考铜/其它层Gerber不变；不等成品加工验收 |
| 嘉立创国内Gerber格式 | **已修为RS-274-X派生包** | 国内说明不接X2；原生no-x2/no-netlist导出11层绘图指令等价，非Gerber文件保持，主板未改；见[包入口](../../../hardware/custom_hat/release-review/README.md) |
| 自动Gerber Job层叠 | **未确认默认值已隔离** | PCB无明确stackup，自动Job却写0.48mm×3介质；现只需普通4层实际材料/铜厚/层叠，不能沿用未确认默认值 |
| `+3V3`断网告警 / I2S回流 | **断网误报已澄清，局部地铜已改善，完整回流待核** | 原生+3V3所有焊盘同组；新增地via加单段音频绕行恢复1.35mm LRCK参考地铜，其他I2S同法取样未退步。层间距/高频回流未验，见[专项修复](i2s-reference-stitch-20261031/research.md) |
| +5V旧断网info | **已澄清，现行不再出现** | 前版C323 via与宽线侧面真实接触，属近似图误判；现已移去远端支路并本地重接，不将改布局说成修复真实断网 |
| 板内I2C地址 | **文件/手册已核，无当前板内冲突** | BMI088 SDO1高选0x19、SDO2地选0x68；AIC3104为0x18，外接ToF地址另核 |
| 原理图连线/标注显示 | **已修** | 连线、39个无源件、J101及TTL的VCC/OE/GND/DATA/连接器字段已整理；DATA连续线/junction通过原网表契约，原生预览已查看，视觉拥挤不当电气短接 |
| 装配资料 | **r18及完整PCBA包同源** | 104SMT/12THT/12POFV、402个Paste开口；补12THT/116全坐标、含DNP的映射、单元装配图和明确制造规格，J301仍B面 |
| BMI088钢网面积 | **拼板制造副本已改81%** | Bosch第57页推荐70%～90%；原100%不再作为最终SMT钢网。32个开口逐项面积核验，非目标开口与9个非paste层保持；主单板源码/旧包未变 |
| chip焊盘直接接地铜 | **24处已回写** | C305/C310移位及0.25mm臂/0.2mm间隙通过连接/参考铜检查；C310中间版未填孔重叠已修，实际回流与电源瞬态未验 |
| C307 DNP锡膏开口 | **已修** | 旧F.Paste仍有2开口；现原生导出副本排除，F61→59、B128保持，所有其它开口/同基线非paste层几何保持；主板铜/阻焊不删 |
| 实际阻焊开窗核对 | **642个开窗文件筛查通过** | r18 F261/B381、最小名义间隙约0.229mm，无异网铜/未填孔外露；12个开窗内孔对应POFV。见[专项](../扩展板邮票孔与电源修复/mask-review.md)，实际生产稿/成品公差未验 |
| 板名/版本及文字制造尺寸 | **已修，并加入有效限制** | 板名1.0mm/0.15mm，工程内置文字及0.15mm丝印间距已加严；负对照能抓住小字。R501/R502/U803位号转Fab，J802移位，C309图形变体匹配本地库 |
| 孔距/孔铜距制造预核 | **名义几何通过，非完整DFM** | 59 PTH/4 NPTH/100via；652项孔铜距通过，via/PTH/NPTH项目规则0.20/0.30/0.25mm；加工公差/供应商接受另核 |
| U701普通小孔替代分支 | **贯通＋分层铜盘方案采用** | 失败局部绕线未采用；现仅B铜盘0.25mm收进原land，F/内层0.35mm、孔0.15mm，限定该B层最小环宽0.05mm，三负对照通过，其他99孔规则不降 |
| 钻孔与工艺坐标 | **已分开并逐孔核对** | PTH/NPTH为159/4孔，无盲孔钻孔文件；CAM Y与KiCad板坐标相反，0.001mm匹配容差内163孔一致，不再声称原始正Y可直接当CAM坐标 |
| fab gate数量不一致 | **统计口径误报已澄清** | 原理图62件，PCB多10个board-only件；gate再减原理图DNP C307，形成61对72。逐位号无缺失，原生parity/网表全0，原始FAIL保留 |
| 音频/I2S/TTL/IMU/ToF/供电/温升/装配 | **待实测** | 离线工具不能替代首板限流上电和功能验收 |
| EMC analyzer error/warning | **风险提示** | 当前54项（8 error/33 warning/13 info）；新增F面+5V平面跨缝来自走线图启发式，本板无+5V zone；真实参考铜另核，不等于EMI实测 |
| 原理图—PCB parity | 已修正107→0 | namespace、32个NC、board-only、PWR_FLAG、DNP与字段同步；没有忽略规则 |
| U702型号 | 已修正 | LP38691DT-1.8/NOPB对应三脚TO-252；原LP38693标识不继续用于采购 |
| 极性标记尺寸/位置 | **18项文件检查通过** | 7IC圆点1mm/SOT0.8mm、10连接器1脚1mm高、D301 K1.27mm；同面、0.3mm焊盘间距及58拟装Fab框避让核过，来料本体标记另验 |
| 物料装配依据 | **35MPN矩阵及原厂指导已更新** | U701/U702 MSL2、U702管装；精确DZ-5A产品页关联34213，Diodes/AVX/SH原件取得。SH公开指导要求应用回流评估，不自行补峰温/MSL数字 |
| J301与主控叠装 | **参考姿态风险已通过B面安装修复** | 旧F面长针在参考完全对插情景进入主控表面；现J301 B面朝外，8孔/网络/铜保持，原生全0；不等用户主控/头壳实测 |
| 板间距/线束范围 | **用户未定高度，已列条件表** | 已核较高刚体名义范围11.6～13.33mm，12/12.5/13mm情景有插深与余隙；未计公差/线束/附件，未选隔离柱 |
| U701中央land/钢网 | **按TI RHB0032E图已修** | EP3.45/R0.05，四个1.49mm窗、中心±0.845，实际圆角覆盖约74.54%；32信号land保持，原连接/参考铜无损 |
| U702中央钢网 | **按TI NDP0003B图已修** | 16个1.15×1.12mm窗口，中心距引脚轴6.665mm；可选中脚去Paste保留铜，大tab铜保持，非宣称来料必无中脚 |
| 钢网印刷几何 | **U301取舍已定，0.125mm基线筛查通过** | U301四窗69.63%为项目方案，非Diodes专属工艺；实际Gerber最小面积比0.683、宽厚比1.8。实际SPI/profile/空洞/保持仍待验 |
| 制造选项与交付范围 | **本地规格已明确，非订单接受** | FR4四层/1.6mm/既有公开层叠、沉金/绿油/白字/6POFV树脂盖铜；完整双联PCBA包含12THT/116全坐标与含DNP的完整映射。实际过程/接单/收料未发生 |

## 当前发布门

**[用户确认，2026-10-31] 尚未送厂、没有自主HAT新板实物。** 已有文件级修复不恢复为待办；“待实测”留在制板后，按[首板草案](../../specs/20261028-custom-hat/first-article-a1.md)进行。原目标逐项核对及制造前/上电前/制造后依赖见[完成情况审计](qwiic-pinout-20261031/completion-audit.md)。

U301设计取舍及表面/填孔/钢网等制造选项已明确，不能重复列同项未决。仍需实际SH应用回流、锡膏/profile/保持、来料与工厂生产稿接受，及完整线束/机械/首板验收；见[分阶段剩余事项](../扩展板邮票孔与电源修复/remaining-actions.md)。
