parkourlrc/pcb-yilv1982--duck-robot-89dbc81d6d/docs/references/舵机网页工具惯性显示/debug-plan-20261026.md

# 单口 GD32 IMU 间歇通信：证据复盘与调试计划

**2026-10-27最新硬件状态**：用户已拆下HAT R31、尝试短接时两侧焊盘脱落。先保持此HAT断电，按[维修记录](../扩展板焊盘脱落修复/research.md)恢复网络并检查新增短路，再恢复下列通信/波形排障；原缺答数据在损伤前，维修后的配置和结果单独记录。

日期：2026-10-26，北京时间。目标是找到可以复现、定位并通过单变量干预验证的原因；本文件是硬件排障计划，不是已完成修复。主证据入口：[历次原始记录](./research.md)。

**2026-10-27 工具与执行更新**：用户已下单示波器（型号待补），IMU 三器件在板测阻已完成；现行顺序见文末及[专题](../扩展板双口惯性缺答复核/research.md#imu-first-no-scope-20261027)。以下 10-26 状态是历史快照，不代表当前连接位置。

**同日内部观测补充**：第②阶段增加UART实际接收、协议校验/丢弃、应答生成/发送的关联证据；已取得对应jyg9工程固定1.5.1源码及Apache-2.0许可。默认输出主要是统计，TRACE另有部分DXL CRC/仲裁事件，仍非完整飞特逐帧抓包。本机构建的编译日志开关与运行级别须分开核对；H1不自动复制DATA字节。示波器检查不以日志开启为前置；见[源码、开关和明确处理分支](../扩展板双口惯性缺答复核/oscilloscope-plan-20261027.md#firmware-source-debug-clarification-20261027)。未开始插桩、刷机或SWD暂停运行。

**同日联网核查更正**：官方 `firmware-1.5.1` 发布说明和标签构建配置均关闭调试打印（`DBG_ENABLE=0`）。先确认本机 `1.5.1 / slot A / CRC32 0xD9CA0DEF` 的构建来源与日志开关；若已确认关闭，跳过 H1 日志路径。公开同源修复还包括回声过滤吞帧头、计时器回绕静默、CRC 运算过慢丢字节及 9-30 电阻修订；前三项已在官方 1.5.1 源码中，不能直接当作本机根因。详见[社区故障与修复调研](../社区惯性单元通讯核查/research.md)。

## 当前条件与已完成检查

- **用户确认**：单口 IMU 已从微雪试验回到 HAT 的“另一个口”，正在运行；用户先回答有 3.3V USB 转 TTL，随后具体说明有 **DAPLink 和 FT232H**。不假设还有第三个适配器。不把“另一个口”直接对应旧图 A/B 或具体 CN 位号。当前供电数值、线束与 10-25 是否完全一致未重新说明，不回填旧参数为新实测。
- **本机只读快照，00:11:41–00:11:43**：[当前状态 JSON](./hat-current-state-20261026.json)。Radxa uptime 约 11 分钟；不能由此判断重启原因。`duck-servo-web.service` active，PID 605 独占 `/dev/ttyS2`，命令含 `--imu-bus`。没有正在运行的 imu-viewer；旧 8766 页面/日志不能代表当前程序。
- 最近服务日志有舵机合法回包、00:11:27 目标位置写入/扭矩开启记录，以及每约 2 秒一条 IMU 200 PING；选取的近期日志窗口未见 IMU 应答。该窗口不能算新的完整零应答统计，也不证明所有 15 舵机当前都正常。动作记录来自已运行的应用，**本轮只读检查没有发这些写指令**。
- `feetech.py`、`server.py`、`imu_bus.py` SHA256 与 10-25 取证版本相同，见快照。软件环境不能假定是旧“服务关闭、查看器运行”；本文已更正现行入口。本轮没有停服务、另开串口、改参数、重启或刷机。

## 症状重新解释

| 已有证据 | 支持的判断 | 不能推出的结论 |
|---|---|---|
| 10-25 早期单读三组各 100/100；随后同窗交错单读 47/60、先 15 舵机 53/60 | 单独也会漏，故障随时间/状态变化；舵机查询不是必要条件 | “单读永远正常”“必定是混读冲突” |
| 同窗 65 次缺答均 0 字节，100ms 窗口无晚答；清缓存、flush、1/5ms 间隔对照均未根治 | 单纯主机缓存/等待策略不能解释全部现象 | 从机绝不会在别的窗口迟答；主机所有行为完全无关 |
| 正确 DXL2 请求得到 9 次自然 `0x20`，另一次对照前又有 1 次；请求及错误回包自身 CRC 重算正确 | 某些失败发生在“请求传输→从机接收/组帧/校验”环节；本机该错误含义由人为坏 CRC 对照印证 | 波形一定正确；某根线或某段固件已被定罪；每次飞特超时都是同一原因 |
| 主机 UART 错误计数未增长；同时舵机应答正常 | HAT 主机侧并非一直完全失效 | IMU 输入波形/从机 UART 正常；端点电源正常 |
| 换到 HAT 第二口后的完整交错仅 2/360，但中间有有效 PING | 不是永久物理断路，换口未恢复 | 第二口必坏；新旧不同时间窗口是严格 A/B |
| 微雪 USB-only 没有正常外部供电；补 7.4V 后 IMU 0/180、双协议 0/40；拔 IMU 同口舵机也全无字节 | 微雪尚未成为已知正常的对照主机，其失败不依赖 IMU 在场 | IMU 已被独立主机证明损坏；微雪失败与 HAT 间歇必定同因 |
| 本机身份 1.5.1 / slot A / CRC32 0xD9CA0DEF，不同于已归档官方包指纹 | 本机对应构建仍需匹配，公开源码只能作为核对依据 | Flash 损坏；直接刷新版就能修复 |
| 开源设计有 H1 UART 日志引出，源码有运行/采样/串口统计 | 可以增加从机侧观察，避免只看主机超时 | 本机必然启用这些日志或输出所有内部统计 |

优先排查两类：**IMU 支路电源/接触及物理收发异常**、**从机 UART 接收/回声抑制/组帧异常**。主机显示/混读解析单独作为根因的解释力较弱；IMU 传感器采样自身故障也难单独解释 PING 请求 CRC 错误，但仍通过采样日志检查。此为调试优先级，不是概率或定论。

## 条件路径与判据（现行先后顺序见文末）

### 0. 现有工具分工与准备

| 工具 | 本次角色 | 核对与限制 |
|---|---|---|
| FT232H | 日志启用时的 H1 UART 被动接收器 | 用户已插电脑，00:25 已枚举 **COM5**、FTDI 驱动、ProblemCode 0，见[快照](./ft232h-usb-enumeration-20261026.json)。[10-16 照片](../../photos/ft232h-breakout-20261016.jpg)为 Adafruit USB-C 兼容板，UART 模式 D1=RX、D0=TX；实物 VCCIO、I2C 开关与 H1 接线仍须核对，未实际采集。 |
| DAPLink | H2 SWD 后备，日志不足且需要内部状态时再评估 | [历史实测](../调试器连接故障定性/research.md)在 1.5 Mbps 串口出现丢字/挂起，不能因此断言 115200 也不可用；10-25 CMSIS-DAP 本身曾握手成功，不等于当前 GD32 目标可调试。本轮不接 SWD、不 halt/reset、不用一键烧录脚本。 |

**FT232H 开关勘误**：Adafruit USB-C 原版的 I2C 开关会连通 D1 与 D2；UART 中 D1 是 RX、D2 是 RTS，故用于 UART 前应断电确认 **I2C OFF，即 D1/D2 不被开关短接**。撤回旧记录“只控制上拉，任意位置”的指导。兼容板实际开关方向不能只照原版猜测；照片不能证明当前位置和内部接线。本条是防止新测量链引入问题，不是之前 IMU 故障的已验证原因。

来源：Adafruit 官方 [Serial UART](https://learn.adafruit.com/adafruit-ft232h-breakout/serial-uart) 的引脚/模式/驱动段与 [Overview](https://learn.adafruit.com/adafruit-ft232h-breakout/overview) 的 2020 USB-C 修订说明；[本轮抓取与失败记录](./ft232h-official-check-20261026.json)。网页工具无可用正文，urllib 成功读取两页；Markdown 地址 HTTP 403、尝试的 pinouts 地址 HTTP 404，未当成功证据。

**枚举进展**：00:17:43 未列出相关设备的[历史快照](./debug-adapters-present-20261026.json)已不代表当前状态。用户插入 FT232H 后，00:24:17 初次识别为 `Single RS232-HS`、暂时 Error/无 COM，未抓到当时 ProblemCode；后续自动呈现 `USB Serial Converter` 与 **USB Serial Port (COM5)**，两者 ProblemCode 0、FTDI 2.12.36.20，设备 ID `0403:6014`。没有手动安装或变更驱动，不能把插入初期状态定为工具故障。只证明枚举正常，未打开串口验证通信。详见[00:25 快照](./ft232h-usb-enumeration-20261026.json)。前次宽泛 `DAP` 正则误命中 Adapter 的记录保留作历史勘误。

### 1. 先确认日志配置，启用时再用 H1 被动读取

官方 1.5.1 默认关闭日志是为修复每 2 秒打印阻塞主循环约 53 ms 的问题；只看 `main.c` 有统计打印不能证明成品镜像包含它。本机固件指纹尚未匹配，优先从构建资料或供板者确认开关；已确认关闭则跳过本节，不为看日志直接重刷。若开关仍未知、接线已经核对，可短时被动监听，但空输出不能证明 MCU 故障。

**准备**：根据现有 PCB 文件、用户实物正反面和适配器型号确认 H1 的位置、针序及真实 3.3V RX 电平。实物与本地设计修订未逐项匹配前，不按纸面编号直接焊接；如需焊线，在断电状态完成。H1/H2/H3 不能混用，详见[接口核对](../惯性单元三版来源对比/research.md#usb-debug-20261026)。

用户表示不确定 H1 位置，已用 10-14 原图生成并查看[H1 定位图](../../photos/archive/imu-gd32-single-port-20261014/imu-single-port-h1-location-20261026.png)：元件面朝向观察者、白色 3P 座朝右时，H1 在左下安装孔上方、金属晶振左侧，为竖排四焊盘。该图仅定位接口，没有标照片上下针序；当前焊接情况尚未确认，需要 H1 局部近照再核对 TX/GND。

首次仅监听，以下为**逻辑网络关系，不是实物数针图**：

| 单口 IMU | FT232H | 说明 |
|---|---|---|
| H1 DEBUG_TX（设计 pad 4，PB6 经 R11） | D1 / RX | 只接收 IMU 日志，不接 3P 总线 DATA |
| H1 GND（设计 pad 2） | Gnd | 共地 |
| H1 DEBUG_RX、3.3V | 不接 | FT232H D0/TX、3V/5V、RTS/DTR 等其他线均不接 |

IMU 继续用已确认的 HAT 电源；电脑 USB 只给适配器供电。不使用 H3 USB 下载口，不改变启动跳线。现有照片能辨认 H1 区域，但不能据此宣称当前焊接、针序/修订已完成现场核对；不拿松动探针临时顶在带电焊盘上。

满足上述条件时，以公开源码日志串口配置的 **115200、8N1、无流控**读取 30–60 秒，保留原始字节和接收时间，同步保存 servo-web 日志。此波特率不表示默认启用日志。HAT 原有总线程序继续独占，不另开 ttyS2。开始捕获后记录连接事件和已知人工断电，不能把准备接线产生的启动横幅当自然复位。既有 `tools/serial-log.py` 默认 1.5 Mbps 且解码后写文本，不能直接把它的输出叫原始字节证据；正式采集须显式设 115200，并另存原始 bytes/hex，乱码不经替换后再作协议判断。

应观察：运行时间 `t` 是否持续、`samples` 是否增长；`sensor/present/qvalid`；配置 ID/波特率/协议锁；**uart1** 的 `rx/tx/dropped/err/echo/frames/answered`，以及 `lost/gaps/ignored`。uart0 是调试口，不与 uart1 总线计数混淆。如果实际日志格式不同，按实际版本建立字段解释。

**边界**：本地 `main.c:143–175` 确实打印上述字段；`bus_stats_t` 有 `bad_crc`，但默认 `stats_print` **没有直接打印 bad_crc**。不能许诺串口日志一定给出逐字节请求或每次 CRC 原因；本地 `uart_port.c` 的 `err` 主要计 ORERR 溢出，并非所有模拟信号/帧错误的全集。字段与计数解释见[源码快照](./imu-diagnostic-observability-20261026.json)。

**若无日志**：只检查 H1/接收器/地/波特率和本机日志是否关闭，不据此判 MCU 死机，也不为开日志直接刷机。没有可用日志时进入硬件观测或有限单变量替换分支。

### 2. 只在取得日志后，做一轮能对应到从机计数的短请求

先看被动日志是否已揭示持续复位等明确分支；有明确分支就跳过不相关实验。若仍需分辨接收/应答阶段，安排一个不发动作的短窗口：记录服务/扭矩当前状态，避免与用户动作同时进行，暂停现有串口持有者后由一个诊断进程独占。结束恢复测试前的应用状态，不自动开启其他查看器、重启板子或改变扭矩。

保持接线和电源不变、线路 1 Mbps 不变，从**单个 ID 200 PING**开始：约 1Hz 10 次，若仍有区分价值再约 10Hz 20 次。每次完整监听至少 100ms，保存主机 TX/RX 和 H1 同期计数；请求频率与串口波特率是两个不同变量，不同时改变。只有 PING 稳定而读取异常时，才增加一种 READ；不再重复之前六组混读大矩阵。

若需要利用 `0x20` 区分静默丢弃，可再用少量正确 DXL2 PING。切协议前确保总线至少 300ms 无其他请求，并检查实际固件协议锁；不写协议锁、不发送人为坏 CRC、不把切换粘滞期误当硬件丢包。先前已经取得 CRC 错误证据，本轮不以再次复现它作为所有分支的强制门槛。

主机与 H1 以本机单调时间/UTC对齐，并利用稀疏请求窗口关联；USB 日志时间不当作微秒级物理时间。初次不打开逐字节 TRACE，避免改变接收时序。记录计数增量而非只看累计总值；共线其他节点与自身回声也可能增加 rx，不能直接把 rx 当“收到的本节点请求数”。

### 3. 根据观察结果选择一条后续路径

| 同步观察 | 下一项区分实验 | 能定位到哪里 |
|---|---|---|
| 没有人工断电却重复启动、运行时间清零 | 同时观察 IMU 入口和板内 3.3V、复位原因；若有压降，固定电源与线束逐项 A/B/A | 压降先于复位支持供电；电压稳定仍复位则查看门狗/异常/复位脚，不能看到复位就断言电源坏 |
| MCU/采样持续，独占请求窗口 `uart1 rx` 无相应增长 | 核对日志中实际 ID/波特率/端口，再观察 HAT DATA、IMU 接头 DATA 与 MCU RX | 请求可能没有到达有效接收通路，也可能 UART 配置/统计本身不符；用信号证据区分 |
| rx 增长，frames/answered 不相应增长，或 err/echo/gaps 异常增长 | 对比 MCU RX 脚实际收到的字节与主机 TX；检查 UART 溢出、回声屏蔽、字节间隔及协议解析 | MCU 脚前已变形/丢字节→物理链路；输入正确但固件丢帧→固件接收路径嫌疑增强，需对应构建确认 |
| frames/answered/tx 增长但主机无字节 | 观察 MCU TX、半双工使能与总线回包，再追到 HAT RX | 统计只能说明尝试/排队发送；MCU 发出但总线没出→板上发送/方向；总线有而主机无→返回路径/主机接收 |
| PING 一直正常，传感器采样/四元数冻结或特定 READ 异常 | 查 SPI/IMU 状态与寄存器/固件布局，保持电气链不变 | 转向传感器或读取契约问题，而不是继续把所有缺答都归给总线 |

**设备限制**：目前确认 FT232H 与 DAPLink。FT232H 在本方案中只读 UART 日志，DAPLink 用作 SWD 后备；二者都不能直接替代示波器证明幅度、振铃、短脉冲或电源瞬态，也不能把 FT232H 的 GPIO 功能当作已经验证的 1 Mbps 总线分析仪。在接线点确认并具备合适工具时才执行波形分支，不要求现在带电拿表笔碰密集针脚。万用表正常值只能记录直流，不能排除瞬态。

旧换线/换位建议已被 10-27 多位置对照更新，不再优先重复；只有某条线出现明确接触异常时，才使用已知正常、针序相同的线缆/接头做一次单变量对照；端口互换不能顺带移动未知电源入口或切断舵机电源。每次都记录 H1 uptime，区别“换线改善”与“断电重启暂时改善”。仅某次重插后恢复属于线索，不足以定案；若不能安全保留其他条件，不强做该对照。

### 4. 只在定位证据指向后处理固件或板件

- 固件路径：先取得本机对应构建来源/日志身份，与可复现的接收异常对应。公开源码曾讨论回声屏蔽吞帧头、500μs 字节间隔等机制，只是核对点，不能在未匹配本机二进制前当作已命中缺陷。必要时再制定最小诊断固件方案、保留原镜像和恢复路径；本轮不刷 1.6.0、不盲目升级。
- 硬件路径：有某条电源轨/接头/收发节点的异常证据，再维修/换线/换板；不先采购配电改造。微雪问题暂作为独立支线，只有它能读已知正常舵机后，才重新用来交叉验证 IMU。
- 验证应回到故障原条件：修复前能复现，单项修改后失败消失或显著下降，再恢复原条件可重现（适合且安全时）。复测单读和正常舵机查询场景，分开统计零字节、错误应答、坏校验、迟到和复位；不是仅看页面连续亮。建议每条件至少 1000 请求并覆盖先前故障时间尺度；零失败只描述该窗口，不承诺长期绝对可靠。

## 本轮交付与下一步

已完成：证据复盘、现场只读快照、日志字段源码核对、两件工具历史记录与官方 FT232H 文档核对、FT232H COM5 枚举和 H1 定位标注；硬件接线、H1 采样及受控请求尚未执行。**现行 IMU 三器件测阻已完成，撤回继续孤立测阻，用户决定到货后先抓三阶段波形，换板留后备；H1 只有确认日志开启后才核对位置和接线。**已有整板原图，无需重复索要整套照片。无需回微雪，也不要求用户重做已经完成的 HAT 直流测压。

网页工具本轮打开上游 `uart_port.c` 返回空正文，分析以本地源码及先前归档证据为依据。SSH 完成、JSON 有效，Windows 关闭 socket 后的 pending 提示不当成设备异常。更改默认留工作区，未提交/推送；只读参考库未改动。

收尾检查：4 份本轮 JSON 可解析，37 个本轮相关本地链接/指定锚点有效，`git diff --check` 通过（Git 仅提示部分工作区文件换行符转换）。只读参考目录没有本轮变更。没有追加硬件采样或运行无关测试；失败的通配路径/旧源码路径检索未作为证据，已使用实际目录与已归档源码快照。

## 2026-10-27 现行推进：示波器已下单，按三阶段定位

用户确认示波器已下单但型号/到货待补；多位置均出现多节点缺答，电源 7.4V CV/限流3A，DATA 万用表读数不是位级波形。**优先检查 IMU 不等于已经排除 HAT、固件或局部供电。**

已完成 IMU R31/R5/F1 照片定位及断电、拔掉全部外接线后的在板测阻，读数分别为100kΩ/51Ω/25Ω；R31/R5与公开修订值一致，F1具体型号/允许范围仍未知，暂不改这三颗，继续孤立测阻已撤回，到货后先按请求到达、IMU内部响应、回程传输抓波形；用户补测两种条件供电均 >7.1V，暂按 IMU 入口理解，入口持续欠压降为低优先级，不重复测入口。板内 3.3V/瞬态未核，不把它们自动增列为前置任务；有正常兼容 IMU 时可单变量替换。H1 日志先确认构建开启，确认关闭则跳过；不自动刷诊断固件、不重复换口/长扫。四通道配置建议、逻辑测点和结果处理分支见[示波器计划](../扩展板双口惯性缺答复核/oscilloscope-plan-20261027.md)。

此前“板②/第二口无罪、B1/B2退场、换回中段分叉可恢复”的判断撤销；分组、单ID和换位对照已经完成，不再作为待做任务。旧排序另存[历史记录（已撤销）](debug-plan-superseded-reasoning-20261027.md)。研究中提到联系卖家只代表可由用户发送的核对项，未授权也未代发消息。
