parkourlrc/pcb-yilv1982--duck-robot-89dbc81d6d/docs/references/调试器连接故障定性/research.md

# DAPLink（克隆）"总连不上"故障定性（2026-10-14）

## 问题与范围

用户的 DAPLink SWD 调试器（**克隆**，`VID_C251&PID_F001`，USB iSerial `LU_2022_8888`，CDC 串口 + CMSIS-DAP HID 复合设备）在 Radxa Zero 3W 串口抓取场景反复"连不上"。本文把散在 [eMMC 线刷记录](../瑞莎开发板存储线刷/research.md)、`PROGRESS.md` 和 `serial-logs/` 里的现象汇总定性，区分四种被混称为"连不上"的不同故障，并给出对策。SWD 刷机（IMU 板，[flash/](../../../flash/README.md)）用的是同一颗物理设备，枚举类问题同样适用。

## 结论速览：四种不同的"连不上"

| # | 故障 | 根因 | 证据等级 | 对策 |
|---|---|---|---|---|
| 1 | 插上完全没反应（设备管理器无新设备） | 仅充电线 / 仅充电 USB-C 口——数据根本没到主机 | **本机实测**（2026-10-13：两根线+笔记本 C 口全不枚举，换口换线后 COM3 正常） | 用手机"传文件"验证过的数据线 + 确认是数据口的 USB 口（优先台式机后置 USB-A） |
| 2 | 设备在、口打不开，脚本一直"串口未就绪"重试 | **COM 口被前一会话占用**（Windows 串口独占；`serial-log.py` 每实例打开后不释放） | **事后推定（高置信）**：昨晚 22:25 会话持有 COM3 直到 00:07:40（其日志无结束行、23:40/23:47/00:07 仍在收数据），23:34:23/23:35:44/23:36:53 三个新会话日志各自只有头一两行，与"open 被拒→2s 重试循环"吻合；当时屏幕报错原文未捕获 | 开新抓取前确认旧窗口已 Ctrl+C（查任务栏与任务管理器 python.exe）；一次只开一个实例 |
| 3 | 灯正常、设备在，但彻底不吐数据（"假在线"） | 克隆 CDC 固件挂死（USB 挂起/恢复处理缺陷是这类克隆的通病） | **本机实测**（PROGRESS 记录"多次假在线挂死需拔插"） | 只能拔插 USB 恢复；缓解：电源选项关"USB 选择性暂停"、插 USB 2.0 口或经 USB2 HUB、别让电脑睡眠 |
| 4 | 连上了、口也开着，就是没数据 → 被误判成"连不上" | **不是故障**：Radxa 串口控制台只在启动窗口有输出，系统跑起来后无 getty（2026-10-14 凌晨 SSH 实证 `console=ttyFIQ0,1500000n8` 存在但无串口登录） | **本机实测** | 想看输出就抓重启（DDR banner 从上电第 1 秒就有）；验证链路活：拔 RX 线碰一下 GND 应出乱码，或直接重启板子 |

另有一条常被混在一起但**不是连接问题**的现象：1500000 波特率下乱码/丢字符。**机制（2026-10-14 修正——此前版本误算为"15Mbit/s 超 USB 带宽"，错了 10 倍，勘误如下）**：1.5Mbaud 线速率即 1.5Mbit/s，8N1 下数据量 150KB/s，仅占 USB 2.0 全速（约 1MB/s 有效吞吐）的 ~15%，**带宽根本不是瓶颈**。真瓶颈是克隆固件的实时性：1.5M 波特下串口每 **6.67µs** 到一个字节，克隆 MCU 无硬件 FIFO/DMA，纯靠中断把字节搬进缓冲，还要同时伺候 CMSIS-DAP HID 通道；任何一段代码卡超过 6.67µs 就 UART 过载（overrun）丢字节——启动突发输出时连续丢，表现为乱码/断行。持续过载风暴还会把固件状态机彻底搞死（即故障 #3 假在线）。115200 波特下字节间隔 **86.8µs**，13 倍裕量，固件延迟毛刺咬不到它，故稳定。

## 2026-10-14 本机实时核查

- pyserial 枚举：**无任何 COM 口**。
- `Get-PnpDevice`：`VID_C251&PID_F001`（复合设备 / COM3 / HID ×2）四个 devnode 全部 `Status=Unknown`（= 仅剩历史记录、当前不在位）；无在位问题设备。
- 判读：**诊断当时 DAPLink 未插或未枚举**。若插着仍如此，即故障 #1 再现，直接换线/换口。

## 枚举成功的判别标准（复用）

设备管理器出现 **"USB 串行设备 (COMx)"**（Win10/11 自带 usbser 免驱绑定）+ DAPLink **红灯常亮、绿灯闪**（2026-10-13 已记录的正常态）。真 mbed DAPLink 官方 ID 为 `VID_0D28&PID_0204`，本颗冒用 Keil VID（C251）——克隆常见做法，不影响使用（常识判读）。

## 限制与下一步

- 故障 #2 的定性是事后时间线推定（未捕获当时报错原文）；下次复现时把屏幕上"串口未就绪"后的括号报错（`PermissionError`/`拒绝访问` vs 设备不存在）抄下来即可一锤定音。
- 1.5M 波特率要可靠逐字节交互（不止看启动日志）时，建议添一颗 CP2102/FT232 类专用串口适配器；**仅为建议，未下单、未列入 BOM**，等串口工作常态化再定。
- SWD 刷机侧对策已在 [flash/README.md 排障表](../../../flash/README.md) 链接本文，无需重复维护。

**结论（2026-10-14 晚修正）：判死过早，设备当日复活。** 拔插无效的那轮，疑似拔插间隔太短、板卡电容未放净，MCU 未真正断电重启；后续一次较长时间断电后 CDC 与 HID 双双复活（OpenOCD 握手全过、FW Version 1.0）。**操作守则更正：挂死时拔下等 ≥10 秒再插。** 但 1.5M 下随机丢字/挂死的固有问题不变（复活当日串口登录演示中再次双向丢字），**可靠串口交互仍需换适配器**——只是从"紧急"降为"择期"。SWD 通道复活意味着 IMU 刷机功能不受影响。当日"报废"段落如下保留作过程证据：

> ## （已被上段修正的过程记录）终局：设备报废（2026-10-14 上午）

当日进一步恶化并判死刑，全过程（本机实测）：

1. 上午 08:48 拔插后尚能双向工作（完成登录会话验证与 echo 交互）；
2. 09:06 起，累计输出 ~150-200 字节即挂死（探测命令第二、三条即死）；
3. 09:09-09:11 拔插+换 USB 口后，**开袋即死**：COM 口可打开、Windows 状态 OK，但写 2-30 字节超时（仅偶发接受一次 2 字节）；逐字节×8 重试滴灌全败；
4. **SWD/HID 通道同死**：`openocd -f interface/cmsis-dap.cfg` 报 `CMSIS-DAP command CMD_INFO failed`——不只是 CDC，整颗 MCU 固件挂死，拔插无法复活。

**结论：该克隆 DAPLink 报废，更换，不再投入排障时间。** 后续角色分配：串口控制台已降速 115200（见 [eMMC 线刷记录](../瑞莎开发板存储线刷/research.md)），任何正常 USB 串口适配器均可胜任；SWD 刷机（IMU 板）仍需一颗能用的 CMSIS-DAP/DAPLink 或 ST-Link。替换选型（新 DAPLink / FT232H / ST-Link）待用户决定。

## 来源

- 本机记录：[eMMC 线刷记录](../瑞莎开发板存储线刷/research.md)「DAPLink 连接排障」条目、`PROGRESS.md` 2026-10-13 条目（假在线、线×口教训）。
- 本机原始数据：`../瑞莎开发板存储线刷/serial-logs/serial-20261013-222523.log`（22:25–00:07 会话，无结束行）、`serial-20261013-233423/233544/233653.log`（三个只有头的重试会话）。
- 2026-10-14 实时查询：pyserial `list_ports`、PowerShell `Get-PnpDevice`（本机执行，见上节）。

## 2026-10-25 状态抽检（本机实测）

DAPLink 克隆当前插在本机，`tools/scan-usb.ps1` 枚举正常：CDC = **COM3**（`VID_C251&PID_F001&MI_00`）、CMSIS-DAP HID 在位（`MI_02`）、iSerial `LU_2022_8888` 与本档案一致，设备状态全 OK、无异常设备。仅确认枚举，未做串口收发或 OpenOCD 握手测试。

**同日 SWD 探测（用户把双口 IMU（imu_to_dxl v0.3）接在 DAPLink 后）**：CMSIS-DAP 通道工作正常（`Interface Initialised`、FW 1.0），但 **SWD 目标无应答**——`Error connecting DP: cannot read IDR`，100/200 kHz 设速均同（该克隆 FW 实际恒报 clock speed 2000 kHz，忽略设速值；本档案 2026-10-14 亦记录过 SWD 复活后 OpenOCD 握手可全过，故此次无应答指向目标侧而非调试器侧）。待查（按序）：①v0.3 板 J1/J3 是否已给 5V 供电（J2-1 对 GND 应 ~3.3V；5V 为该次台架示例；“只允许 5V”已于 2026-10-31 被原厂手册纠正，见[复核](../惯性单元输入电压复核/research.md)）；②J2 线序 J2-2→SWCLK / J2-3→SWDIO / J2-4→GND / J2-1→VTref，CLK/DIO 是否接反；③无效再接 J2-7(RST)→NRST。探测只做了 init/targets，未烧录。
