parkourlrc/pcb-yilv1982--duck-robot-89dbc81d6d/docs/specs/20261028-custom-hat/remaining-fixes.md

# Rev A 剩余未连接清单（自动生成）

> 历史实验快照，已失效，不逐项照修。当前完整工程为23项未连接（含I2S_SDO），详见 [2026-10-30 原始报告](../../references/扩展板电路仿真工具/audit-20261030/drc-refilled.json)及[现行清单](../../references/扩展板电路仿真工具/audit-20261030/review.md)。以下24对仅保留追溯。

共 24 对，坐标为板内 mm（原点 = 板左上角）。

| # | X | Y | 项 | 另一端 |
|---|---|---|---|---|
| 1 | 0.40 | 0.40 | Zone [POWER_GND] on B.Cu, priority 0 | Zone [POWER_GND] on B.Cu, priority 0 |
| 2 | 0.40 | 0.40 | Zone [POWER_GND] on B.Cu, priority 0 | Zone [POWER_GND] on B.Cu, priority 0 |
| 3 | 0.40 | 0.40 | Zone [POWER_GND] on F.Cu, priority 0 | Zone [POWER_GND] on B.Cu, priority 0 |
| 4 | 8.32 | 4.59 | PTH pad 1 [+3V3] of J101 | Pad 2 [+3V3] of R311 on B.Cu |
| 5 | 25.18 | 16.43 | Track [+3V3] on B.Cu, length 1.8100 mm | Pad 2 [+3V3] of R311 on B.Cu |
| 6 | 26.17 | 17.42 | Track [+3V3] on B.Cu, length 1.4001 mm | PTH pad 4 [+3V3] of J301 |
| 7 | 26.17 | 17.42 | Track [+3V3] on B.Cu, length 1.4001 mm | Pad 1 [+3V3] of TP803 on F.Cu |
| 8 | 28.64 | 4.59 | PTH pad 17 [+3V3] of J101 | Track [+3V3] on B.Cu, length 2.0188 mm |
| 9 | 32.48 | 24.78 | Pad 1 [+3V3] of TP803 on F.Cu | Pad 5 [+3V3] of U801 on B.Cu |
| 10 | 34.89 | 27.00 | Pad 5 [+3V3] of U801 on B.Cu | Pad 5 [+3V3] of U802 on B.Cu |
| 11 | 43.43 | 15.89 | Pad 1 [+3V3] of C319 on B.Cu | Track [+3V3] on B.Cu, length 4.1675 mm |
| 12 | 43.43 | 15.89 | Pad 1 [+3V3] of C319 on B.Cu | Pad 5 [+3V3] of U802 on B.Cu |
| 13 | 46.96 | 10.81 | Track [+3V3] on B.Cu, length 0.2548 mm | Pad 7 [+3V3] of U701 on B.Cu |
| 14 | 47.24 | 15.89 | Pad 1 [+3V3] of C313 on B.Cu | Pad 1 [+3V3] of C319 on B.Cu |
| 15 | 50.36 | 14.10 | Pad 3 [I2S_LRCK] of U701 on B.Cu | PTH pad 35 [I2S_LRCK] of J101 |
| 16 | 55.24 | 12.10 | Pad 18 [+3V3] of U701 on B.Cu | Pad 7 [+3V3] of U701 on B.Cu |
| 17 | 55.24 | 12.10 | Pad 18 [+3V3] of U701 on B.Cu | Track [+3V3] on B.Cu, length 0.7161 mm |
| 18 | 55.24 | 15.10 | Track [+3V3] on B.Cu, length 0.3002 mm | Pad 18 [+3V3] of U701 on B.Cu |
| 19 | 56.13 | 23.51 | Pad 1 [+3V3] of C315 on B.Cu | Track [+3V3] on B.Cu, length 0.5477 mm |
| 20 | 59.70 | 9.26 | Track [+3V3] on B.Cu, length 1.7911 mm | Pad 3 [+3V3] of U501 on F.Cu |
| 21 | 60.19 | 10.80 | Pad 15 [+3V3] of U501 on F.Cu | Track [+3V3] on B.Cu, length 0.7161 mm |
| 22 | 60.19 | 10.80 | Pad 15 [+3V3] of U501 on F.Cu | Pad 14 [+3V3] of U501 on F.Cu |
| 23 | 60.69 | 10.80 | Pad 14 [+3V3] of U501 on F.Cu | Pad 11 [+3V3] of U501 on F.Cu |
| 24 | 63.19 | 8.28 | Pad 7 [+3V3] of U501 on F.Cu | Track [+3V3] on B.Cu, length 1.3970 mm |
