parkourlrc/pcb-yilv1982--duck-robot-89dbc81d6d/docs/references/扩展板焊盘脱落修复/sources/circuitrework-conductor-repair.txt

4.0 Conductor Repair Procedures
SERVICES
GUIDES
BLOGS
TECH PAPERS
PRODUCTS
CONTACT
🔎
22 Parkridge Road
Haverhill, MA 01835 USA
www.circuitrework.com
4.0 Conductor Repair Procedures
Comprehensive conductor repair procedures for restoring damaged PCB traces, lands and planes. Covers epoxy, film adhesive, jumper and wire methods aligned with industry-accepted rework practices.
REQUEST FOR QUOTE
GUIDES INDEX
Conductor Repair Procedures
QUICK QUESTION?
Have a general inquiry?
Send us a message below.
NEED A FORMAL QUOTE?
Submit a quote request using our quote form.
First Name *
Last Name *
Email *
Phone Number
Job Title
Company Name *
How Can We Help? *
File Upload
To upload multiple files, select them together using Ctrl-click on Windows or Command-click on Mac.
Upload images, PDFs, Gerbers, data sheets, or other relevant files.
CAUTION
Do not submit Controlled Unclassified Information (CUI) through this form.
FORM SECURITY
Our forms are hosted with Amazon Web Services in the United States and use an industry-leading web application firewall.
Data and uploads are encrypted at rest using AES-256 block-level storage encryption.
We use a minimum of TLS 1.2 to encrypt network traffic between your web browser and our forms.
4.1.1 Lifted Conductor Repair, Epoxy Method
Repair lifted or separated conductors using controlled epoxy bonding techniques. Learn surface preparation, alignment and curing practices to restore adhesion and electrical integrity.
4.1.2 Lifted Conductor Repair, Film Adhesive Method
Rebond lifted conductors using film adhesive methods for precise, uniform adhesion. Includes surface preparation, heat control and pressure application for reliable trace restoration.
4.2.1 Conductor Repair, Foil Jumper, Epoxy Method
Restore damaged PCB traces using foil jumper and epoxy techniques. Covers pattern matching, bonding and finishing steps to maintain conductor width and current capacity.
4.2.2 Conductor Repair, Foil Jumper, Film Adhesive Method
Repair open or damaged traces using precision foil jumpers bonded with film adhesive. Learn alignment, lamination and finishing methods for consistent conductor restoration.
4.2.3 Conductor Repair, Welding Method
Reconnect damaged conductors using micro welding techniques. Covers equipment control, alignment and inspection practices for permanent electrical restoration.
4.2.4 Conductor Repair, Surface Wire Method
Repair open circuits using surface wire techniques for reliable electrical continuity. Includes routing, attachment and strain relief practices to protect long-term performance.
4.2.5 Conductor Repair, Through Board Wire Method
Restore through-board connections using wire repair methods when plated vias are missing or damaged. Covers drilling, wire insertion and termination techniques for dependable conductivity.
4.2.6 Conductor Repair, Inner Layer Method
Repair damaged inner layer conductors using precision access and reconstruction techniques. Includes material removal, conductor replacement and laminate restoration practices.
4.2.7 Conductor Repair, Surface Plane, Film Adhesive Method
Rebuild damaged surface planes using copper bonded with film adhesive. Learn controlled lamination and finishing techniques to maintain shielding and current capacity.
4.3.1 Circuit Cut, Surface Circuits
Perform controlled surface circuit cuts to isolate or modify PCB traces. Covers precision cutting techniques and inspection methods to prevent unintended damage.
4.3.2 Circuit Cut, Inner Layer Circuits
Isolate inner layer connections using controlled access and cutting techniques. Includes laminate entry, trace interruption and restoration procedures.
4.3.3 Deleting Inner Layer Connection at a Plated Hole, Drill Through Method
Remove unwanted inner layer connections at plated holes using precision drill-through methods. Covers alignment, depth control and inspection practices.
4.3.4 Deleting Inner Layer Connection at a Plated Hole, Spoke Cut Method
Delete inner layer connections at plated holes using spoke-cut techniques. Learn controlled cutting methods to isolate connections without damaging surrounding circuitry.
4.4.1 Lifted Land Repair, Epoxy Seal Method
Restore lifted lands using epoxy sealing techniques to secure and protect the pad. Includes preparation, bonding and curing methods to maintain solderability.
4.4.2 Lifted Land Repair, Film Adhesive Method
Repair lifted lands using film adhesive bonding for uniform adhesion and durability. Covers alignment, lamination and finishing steps for reliable pad restoration.
4.5.1 Land Repair, Epoxy Method
Reconstruct damaged or missing lands using epoxy and replacement copper patterns. Learn bonding and finishing techniques to restore solderable pad geometry.
4.5.2 Land Repair, Film Adhesive Method
Restore damaged lands using replacement copper patterns bonded with film adhesive. Learn alignment, lamination and finishing practices to produce durable, solderable repair sites.
4.6.1 Edge Contact Repair, Epoxy Method
Repair worn or damaged edge contacts using epoxy bonding and contact replacement techniques. Covers preparation and finishing to restore electrical interface integrity.
4.6.2 Edge Contact Repair, Film Adhesive Method
Procedure covers method to repair damaged edge contacts on circuit board assemblies using dry film adhesive.
4.6.3 Edge Contact Repair/Rework, Plating Method
Rework edge contacts using selective plating methods to rebuild contact surfaces. Covers preparation, masking and plating control for durable electrical performance.
4.7.1 Surface Mount Pad Repair, Epoxy Method
Repair damaged surface mount pads using epoxy-bonded replacement patterns. Includes pad alignment, bonding and finishing practices to restore solderable surfaces.
4.7.2 Surface Mount Pad Repair, Film Adhesive Method
Replace surface mount pads using film adhesive bonding for precise placement and durability. Covers lamination and trimming techniques for consistent results.
4.7.3 Surface Mount, BGA Pad Repair, Film Adhesive Method
Restore damaged BGA pads using film adhesive bonding and precision replacement patterns. Learn alignment and finishing methods to maintain pad spacing and reliability.
4.7.4 Surface Mount, BGA Pad Repair with Integral Via
Repair BGA pads with integral vias using controlled reconstruction techniques. Covers via integrity, pad geometry and finishing practices for dependable repairs.
4.7.5 Surface Mount, BGA Pad Repair, Integral Via, Circuit Extension Method
Rebuild BGA pads with integral vias using circuit extension techniques. Includes via restoration, trace reconstruction and pad alignment for high-density assemblies.
4.7.6 Surface Mount Pad Repair, Film Adhesive Method, Butt Joint Method
Repair surface mount pads using film adhesive and butt joint techniques for precise conductor integration. Covers alignment and bonding for reliable electrical continuity.
We're Here To Help.
CONTACT US
Haverhill, MA 01835 USA
Phone: 978-374-5000
Email: info@circuitrework.com
About Us
|
Careers
|
Directions
|
News
Services
BGA Reballing
|
BGA Rework
Coating/Marking
Component Salvage
Component Trim and Form
Damage Repair
ECO/Modification
SMT/PTH Rework
Tinning Services
Resources
Blogs
|
Guides
Conflict Minerals
Newsletters
REACH
|
RoHS
Tech Papers
Toxic Substance Statement
General Info
Account Update
Contact Us
Copyright/Disclaimer
Frequent Questions
Operation and Delivery
Quote Request
Circuit Technology Center is ISO 9001:2015 Certified
Circuit Technology Center
is ITAR Registered
IPC member since 1986
First-aid Kits for Circuit Boards ©
Copyright © Circuit Technology Center, Inc. All Rights Reserved. |
Privacy Policy
|
Terms of Use
