parkourlrc/pcb-yilv1982--duck-robot-89dbc81d6d/docs/references/扩展板焊盘脱落修复/sources/circuitrework-pad-repair.txt

4.5.1 Land Repair, Epoxy Method
SERVICES
GUIDES
BLOGS
TECH PAPERS
PRODUCTS
CONTACT
🔎
22 Parkridge Road
Haverhill, MA 01835 USA
www.circuitrework.com
4.5.1 Land Repair, Epoxy Method
Reconstruct damaged or missing lands using epoxy and replacement copper patterns. Learn bonding and finishing techniques to restore solderable pad geometry.
REQUEST FOR QUOTE
GUIDES INDEX
Land Repair, Epoxy Method
Remove the defective land and remove soldermask from the connecting circuit.
❚❚
Select a replacement land that matches the missing land.
❚❚
Cut out the replacement land.
❚❚
Apply epoxy to the back surface and hold in place using hight temperature tape.
❚❚
Completed repair.
❚❚
SLIDESHOW STARTING
❮
❯
QUICK QUESTION?
Have a general inquiry?
Send us a message below.
NEED A FORMAL QUOTE?
Submit a quote request using our quote form.
First Name *
Last Name *
Email *
Phone Number
Job Title
Company Name *
How Can We Help? *
File Upload
To upload multiple files, select them together using Ctrl-click on Windows or Command-click on Mac.
Upload images, PDFs, Gerbers, data sheets, or other relevant files.
CAUTION
Do not submit Controlled Unclassified Information (CUI) through this form.
FORM SECURITY
Our forms are hosted with Amazon Web Services in the United States and use an industry-leading web application firewall.
Data and uploads are encrypted at rest using AES-256 block-level storage encryption.
We use a minimum of TLS 1.2 to encrypt network traffic between your web browser and our forms.
Outline
This method is used to replace damaged and lifted lands. The damaged lands are replaced with new lands. The new lands are bonded to the circuit board surface using epoxy.
Caution:
This method is used to replace a damaged or missing land, but the new land will not have an intermetallic connection to the remaining plated hole. The solder joint of the replaced component will restore the electrical connection.
Caution:
It is essential that the board surface be smooth and flat. If the baseboard is damaged, see appropriate procedure.
Note:
This method uses new lands that are fabricated from copper foil. They are available in hundreds of sizes and shapes and are generally supplied solder plated. If a special size or shape is needed, it can be custom fabricated.
Minimum Skill Level - Advanced
Recommended for technicians with soldering and component rework skills and exposure to most repair/rework procedures, but lacking extensive experience.
Conformance Level - Medium
This procedure may have some variance with the physical character of the original and most likely varies with some of the functional, environmental and
serviceability factors.
Procedure References
1-0
1.0 Foreword
2-1
2.1 Handling Electronic Assemblies
2-2
2.2 Cleaning Procedures
2-5
2.5 Baking and Preheating
2-7
2.7 Epoxy Mixing and Handling
Tools and Materials
Circuit Bond Epoxy
Clear, superior strength epoxy in two-compartment plastic packages.
Circuit Frames
Circuit Frames for surface mount pad, BGA pad and conductor repair.
Cleaner
General purpose cleaner for removing contamination.
Flex-Rack PCB Holder
Sturdy rack for PCBs used for rework and positioning.
High Temp Tape Discs
High temperature polyimide tape discs, .50" diameter.
Knife with #16 Blades
A must-have tool for precise cutting, scraping and trimming.
Microscope
Precision microscope with stand and lighting for work and inspection.
Oven
General purpose oven for drying, baking and curing epoxies.
Precision Tool Set
Nine precision-crafted tools for detailed circuit board work.
Repair Skills Practice Kit
Training kit to practice circuit board repair skills prior to testing for certification.
Scraper, Curved Tip
Hardened stainless steel tip for scraping solder mask and removing defects.
Soldering Iron
Properly maintained soldering iron and properly sized soldering iron tips.
Tweezers
Multiple sizes and tip configurations of tweezers for various small parts handling needs.
Wipes
Nonabrasive, low-linting wipes for cleanup.
Procedure
Procedure
Clean the area.
Remove the defective land and a short length of the connecting circuit, if any. (See Figure 1)
Use the knife and scrape off any epoxy residue, contamination, or burned material from the board surface.
Caution:
Abrasion operations can generate electrostatic charges.
Scrape off any solder mask or coating from the connecting circuit. (See Figure 1)
Clean the area.
Apply a small amount of liquid flux to the connection area on the board surface and tin with solder. Clean the area. The length of the overlap solder connection should be a minimum of 2 times the circuit width.
The area for the new pad on the board surface must be smooth and flat. If internal fibers of the board are exposed or if there are deep scratches on the surface, they should be repaired. Refer to the appropriate procedure.
Select a replacement land that most closely matches the land to be replaced. (See Figure 2)
Cut out and trim the new land. Cut the length to provide the maximum allowable circuit overlap for soldering. Minimum two times the circuit width. (See Figure 3)
Note:
The new replacement land may be trimmed from a copper sheet.
Mix the epoxy and apply a small amount to the surface where the new land will be placed.
Place a piece of High-Temperature Tape over the top surface of the land. Place the new land into position on the circuit board surface using the tape to aid in alignment. (See Figure 4)
Cure the epoxy per Procedure 2.7 Epoxy Mixing and Handling.
After the epoxy has cured, remove the High-Temperature Tape used for the alignment. Carefully clean the area and inspect the new land for proper alignment.
If the new land has a connecting circuit apply a small amount of liquid flux to the lap solder joint connection area and solder the circuit from the new land to the circuit on the circuit board surface. Use minimal flux and solder to ensure a reliable connection. Tape may be placed over the top of the new land to prevent excess solder.
Note:
If the configuration permits, the overlap solder joint connection should be a minimum of 3.00 mm (0.125") from the related termination. This gap will minimize the possibility of simultaneous reflow during soldering operations. Refer to 7.1 Soldering Basics.
Remove the tape and clean the area.
Mix the epoxy and coat the lap solder joint connections. Cure the epoxy per Procedure 2.7 Epoxy Mixing and Handling.
Note:
Additional epoxy can be applied around the perimeter of the new land to provide additional bond strength.
Caution:
Some components may be sensitive to high temperatures.
Carefully remove any excess epoxy inside the plated hole using a ball mill or drill bit. Turn the ball mill or drill bit by hand to prevent damage to the wall of the plated through hole.
Install the proper component and solder in place.
Note:
This method is used to replace a damaged or missing land, but the new land will not have an intermetallic connection to the remaining plated hole. The solder joint of the replaced component will restore the integrity of the electrical connection, or an eyelet or buss wire may be used. See Plated Hole Repair Procedures.
Apply surface coating to match prior coating as required.
Evaluation
Visual examination.
Measurement of new pad width and spacing.
Electrical continuity measurement.
Images
Land Repair, Epoxy Method
Remove the defective land and remove soldermask from the connecting circuit.
Select a replacement land that matches the missing land.
Cut out the replacement land.
Apply epoxy to the back surface and hold in place using hight temperature tape.
Completed repair.
Related
We're Here To Help.
CONTACT US
Haverhill, MA 01835 USA
Phone: 978-374-5000
Email: info@circuitrework.com
About Us
|
Careers
|
Directions
|
News
Services
BGA Reballing
|
BGA Rework
Coating/Marking
Component Salvage
Component Trim and Form
Damage Repair
ECO/Modification
SMT/PTH Rework
Tinning Services
Resources
Blogs
|
Guides
Conflict Minerals
Newsletters
REACH
|
RoHS
Tech Papers
Toxic Substance Statement
General Info
Account Update
Contact Us
Copyright/Disclaimer
Frequent Questions
Operation and Delivery
Quote Request
Circuit Technology Center is ISO 9001:2015 Certified
Circuit Technology Center
is ITAR Registered
IPC member since 1986
First-aid Kits for Circuit Boards ©
Copyright © Circuit Technology Center, Inc. All Rights Reserved. |
Privacy Policy
|
Terms of Use
