parkourlrc/pcb-yilv1982--duck-robot-89dbc81d6d/docs/references/扩展板双口惯性缺答复核/author-bug-search/kissqy-followup-sources.md

# kissqy 飞特版补充来源

取得日期：2026-10-27（北京时间）。GitHub API `https://api.github.com/repos/kissqy/Microduck-kissqy/commits/main` 返回固定提交 `c5f015f974ae55a7cc6e77f7aa2cde5584be824e`。以下文件由 PowerShell `Invoke-WebRequest` 读取固定 raw URL，SHA256 为下载后本机计算。此前 source-manifest.json 的八份来源保持原记录，本表登记本次新增三份。

| 本地原文 | 固定来源 URL | SHA256 |
|---|---|---|
| [kissqy-IMU-TIMELINE.md](kissqy-IMU-TIMELINE.md) | https://raw.githubusercontent.com/kissqy/Microduck-kissqy/c5f015f974ae55a7cc6e77f7aa2cde5584be824e/hardware/IMU-TIMELINE.md | `3037d0a5cf26ad696462c1a51923d87974c4bae9b4f8164b287e39973af6726f` |
| [kissqy-IMU-FIRMWARE.md](kissqy-IMU-FIRMWARE.md) | https://raw.githubusercontent.com/kissqy/Microduck-kissqy/c5f015f974ae55a7cc6e77f7aa2cde5584be824e/hardware/IMU-FIRMWARE.md | `a6829d3beb489dad0a5accd4f6854323c85779883b16e17c3c94192ffdc001a3` |
| [kissqy-README_FT6_SYNC15.md](kissqy-README_FT6_SYNC15.md) | https://raw.githubusercontent.com/kissqy/Microduck-kissqy/c5f015f974ae55a7cc6e77f7aa2cde5584be824e/microduck-hd1910/firmware/firmware/imu-source/README_FT6_SYNC15.md | `6b7278676cae3f012c6acf95c4c113572dde9acd943b189ce5b621ea1602f218` |

检索限制：web.run 请求无可用正文输出，以上 HTTPS 获取成功。只核这些说明页，未进行源码差分审计、未取得上游 3000/3000 或 7 万多轮的原始日志。原文包含作者烧录/供电操作说明，仅作资料快照，适用其 STM32 RevA 板，不是本机 GD32 板操作单。
