parkourlrc/pcb-yilv1982--duck-robot-89dbc81d6d/docs/references/扩展板电路仿真工具/metadata-repair-20261030/sources/jlc-hdi-faq.txt

(function(w,i,g){w[g]=w[g]||[];if(typeof w[g].push=='function')w[g].push(i)})(window,'GTM-W8FT5ZR','google_tags_first_party');
(function(w,d,s,l){w[l]=w[l]||[];(function(){w[l].push(arguments);})('set','developer_id.dNmEwOT',true);var f=d.getElementsByTagName(s)[0],j=d.createElement(s);j.async=true;j.src='/iqfd/';f.parentNode.insertBefore(j,f);})(window,document,'script','dataLayer');

JLCPCB HDI PCB Capabilities & FAQ Guide
window.__apmbl = {
        url: 'https://overseas-datasink.jlcpcb.com/monitor/logs',
        bid:'overseas-pcb',
        siteId:'ov-pcb',
        appId: 'overseas-pcb-pc',
        appName: 'overseas-web-app',
        env: 'prd',
        apmConfig: '/monitor-config.json',
        domains: [],
        getUserId: function() {
          try {
            var store = window.$nuxt && window.$nuxt.$store
            if (store && store.getters['user/info'] && store.getters['user/info'].casAccountCode) {
              return store.getters['user/info'].casAccountCode
            }
          } catch(e) {}
          return ''
        },
        autoInstrument: false
      }
window.dataLayer = window.dataLayer || []
      function gtag() {
        dataLayer.push(arguments)
      }

      gtag('consent', 'default', {
        analytics_storage: 'denied',
        ad_storage: 'denied',
        ad_user_data: 'denied',
        ad_personalization: 'denied',
        wait_for_update: 500,
        region: ['AT', 'BE', 'BG', 'HR', 'CY', 'CZ', 'DK', 'EE', 'FI', 'FR', 'DE', 'GR', 'HU', 'IE', 'IT', 'LV', 'LT', 'LU', 'MT', 'NL', 'PL', 'PT', 'RO', 'SK', 'SI', 'ES', 'SE', 'GB']
      })

      gtag('set', 'ads_data_redaction', true)
try {
        var cc = document.cookie.match(/(?:^|;\s*)jlcpcb_consent=([^;]*)/)
        if (cc && cc[1]) {
          var data = JSON.parse(decodeURIComponent(cc[1]))
          if (data && data.preferences) {
            var p = data.preferences
            if (p.analytics) { gtag('consent', 'update', { analytics_storage: 'granted' }) }
            if (p.targeting) {
              gtag('consent', 'update', {
                ad_storage: 'granted',
                ad_user_data: 'granted',
                ad_personalization: 'granted'
              })
            }
          }
        }
      } catch(e) {}
window.__deferred_gtm_scripts = ["\n      (function (w, d, s, l, i) {\n        w[l] = w[l] || [];\n        w[l].push({ 'gtm.start': new Date().getTime(), event: 'gtm.js' });\n        var f = d.getElementsByTagName(s)[0],\n            j = d.createElement(s), dl = l != 'dataLayer' ? '&l=' + l : '';\n        j.async = true;\n        j.src = 'https://www.googletagmanager.com/gtm.js?id=' + i + dl;\n        f.parentNode.insertBefore(j, f);\n      })(window, document, 'script', 'dataLayer', 'GTM-W8FT5ZR');\n    ","\n      if (typeof gtag === 'function') { gtag('config', 'G-XDWD4D52RC'); }\n      else { window.dataLayer = window.dataLayer || []; function gtag() { window.dataLayer.push(arguments); } gtag('js', new Date()); gtag('config', 'G-XDWD4D52RC'); }\n      (function (w, d, s, l, i) { w[l] = w[l] || []; var f = d.getElementsByTagName(s)[0], j = d.createElement(s); j.async = true; j.src = 'https://www.googletagmanager.com/gtag/js?id=' + i; f.parentNode.insertBefore(j, f); })(window, document, 'script', 'dataLayer', 'G-XDWD4D52RC');\n    "];
(function(){if(navigator.userAgent.indexOf('Electron')>-1){document.documentElement.classList.add('is-helper-env')}})()
This website requires JavaScript.

function reportJlcApmError(e,t){var n=new XMLHttpRequest;n.open("POST","https://overseas-datasink.jlcpcb.com/datacollect/dataAccess/logs"),n.setRequestHeader("Content-Type","application/json"),n.send(JSON.stringify({data_type:"error",event_type:e,page_url:location.href,os:navigator.platform,user_agent:navigator.userAgent,screen_height:window.screen.height.toString(),screen_width:window.screen.width.toString(),lib_type:"Js",timezone_offset:(new Date).getTimezoneOffset().toString(),app_id:"overseas-pcb-pc",event_time:Date.now(),event_detail:JSON.stringify(t)}))}function reportJlcApmInitError(e){!1===window.jlcTrack.init&&reportJlcApmError("js",{msg:"初始化APM失败",target:e.getAttribute("src")})}function reportJlcApmLoadError(e){reportJlcApmError("resource",{msg:"加载APM失败",target:e.getAttribute("src")})}window.jlcTrack={cacheData:[],init:!1,client:{bindUser:function(e){window.jlcTrack.cacheData.push({key:"bindUser",value:e})},notify:function(e){window.jlcTrack.cacheData.push({key:"report",value:e})},startTrack:function(){},finishTrack:function(){},use:function(){},updateOptions:function(){},unBindUser:function(){},enableLogger:function(){},disableLogger:function(){}},bindUser:function(e){window.jlcTrack.cacheData.push({key:"bindUser",value:e})},report:function(e){window.jlcTrack.cacheData.push({key:"report",value:e})},exposePlugin:function(){window.jlcTrack.cacheData.push({key:"exposePlugin"})},setJlcModuleName:function(e){window.jlcTrack.cacheData.push({key:"setJlcModuleName",value:e})},setJlcPageTitle:function(e){window.jlcTrack.cacheData.push({key:"setJlcPageTitle",value:e})},getJlcPageTitle:function(){},getJlcModuleName:function(){},reportReactError:function(){},reportVueError:function(){}}

Account Restriction Notice

Get Coupon Here

Coupons

Country / Region

Language

undefined

Currency

USD $

The currency you select is for reference only, payments must be made in US dollars.

Save

Language Coming Soon

Ship to

JLCPCB

PCB Service

FR-4 PCBs

Flexible PCBs

Metal Core PCBs

High-Frequency PCBs
PCBA Service

PCB Assembly

Parts Library
More

SMT Stencil

PCB Layout

Mechanical Services

JLC3DP - 3D Printing
JLCCNC - CNC Machining
JLCCNC - Sheet Metal
JLCMC - Mechanical Components
Tools

EasyEDA - PCB Design Tool
JLCDFM -  DFM Check
Impedance Calculator
PI Stiffener Calculator
More

OSHWLAB - Open Source Hardware
JLCPCB - Flexible Heater

Services

Rigid PCB Capabilities

Stencil Capabilities

Flex PCB Capabilities

PCB Layout Capabilities

PCBA Capabilities

Flexible Heaters Capabilities

Capabilities

Contact Us

Online Chat>

Mon-Fri: 24 hours, Sat: 9am-6pm, GMT+8

Email Us>

Mon-Fri: 24 hours, Sat: 9am-6pm, GMT+8

WhatsApp>

Mon-Fri: 24 hours, Sat: 9am-6pm, GMT+8

Support

Help Center

Get instant answers. 24/7 Available.
Blog

Community

Support

About Us

JLCPCB delivers one-stop electronic and mechanical manufacturing solutions to empower hardware innovators worldwide.

Explore Us

Why JLCPCB?
Quality Assurance
How We Work
Certifications
Company News

About Us

Search

0

Order Now

Sign In

Sign In

Help Center

Help Center

PCB Capabilities & Instructions

HDI High-Density Interconnect PCBs Officially Launched

Help Center

Get Started

Register
Know Before Ordering
Account Setting

Ordering

PCB Ordering
PCB Assembly Ordering
PCB Stencil Ordering

PCB Manufacturing

PCB Files Preparation
PCB Capabilities & Instructions
PCB Technical Guidelines

PCB Assembly

PCB Assembly FAQs
PCBA Price Details
PCBA Parts Sourcing
PCBA Capabilities & Instructions
PCBA Technical Guidelines
PCBA Files Preparation
PCBA Lead Time
PCBA After-Sale

FPC Manufacturing

FPC Materials & Options
FPC Design Guidelines

SMT Stencil

Stencil Ordering
Stencil Technical Guidelines

PCB Layout

PCB Layout Ordering
PCB Layout FAQs

JLCDFM Tool

DFM Tool Help
DFM FAQs

JLCONE

JLCONE FAQs
JLCONE Download and Installation

Shipping & Delivery

Shipping Policies
Shipping Instructions

Payment & Invoice

Payments

Collab & Activities

JLCPCB API
Coupons & Promotions

Policies & Certifications

Policies
Certifications

Information

Notice

Flexible Heater

Flexible Heater Ordering

HDI High-Density Interconnect PCBs Officially Launched

Last updated on Oct 26, 2026

High-Density Interconnect (HDI) PCBs are a core building block of modern electronic products. With high routing density, miniaturized design, and excellent electrical performance, they are driving rapid innovation in consumer electronics, communication equipment, automotive electronics, and other fields. As 5G, artificial intelligence, and IoT technologies become more widespread, advances in signal integrity, thermal efficiency, and multilayer stack-up technology have made HDI boards a key solution for high-frequency, high-speed transmission. Driven by the wave of digitalization and intelligence, and in response to customers' urgent demand for efficient, stable, and customized solutions, we are officially launching HDI High-Density Interconnect PCBs. This launch is not only a milestone in technology advancement, but also a practical result of our customer-centered philosophy.
HDI Board Features and Applications
Advantages:
1. Optimized routing. Smaller line width/spacing, pads, and microvias improve design efficiency.
2. Better materials and advanced production processes provide improved reliability and stability.
3. Smaller dimensions and footprint, making HDI boards well suited to advanced packaging technologies.
4. Multilayer interconnection supports high standards for electrical performance and efficiency.
Limitations:
The process is complex, repair is difficult, the price is higher, and the lead time is longer.
Application Fields:
1. Smartphones, tablets, digital cameras, MP3 players, MP4 players, and more.
2. Automotive electronics, aerospace, and medical equipment.
3. Communication equipment and network equipment.
Basic Structure of JLCPCB HDI Boards
Blind via:
A via that connects the top or bottom layer to an inner layer without passing through the entire board. It is formed by laser drilling and supports 1st-order, 2nd-order, and 3rd-order HDI.
Buried via:
A via that connects only traces between inner layers. Neither end of the hole extends to an outer layer, so the via is fully buried inside the board.
Through via:
A via that passes through the full board thickness, from the top layer to the bottom layer, and is made by mechanical drilling.
Stacked via:
Blind and buried vias aligned at the same vertical position, with copper plating between vias. Different laminated structures are manufactured according to the via type.
Skip via:
A blind via that skips across two or more layers. During production, it is split into stacked blind and buried vias.
JLCPCB HDI Board Manufacturing Process

Name

Parameter

Description

Blind Via Diameter (A)

0.075–0.15 mm

Laser drilled; the corresponding pad diameter should be at least 0.15 mm larger than the blind-via diameter.

Buried Via Diameter (B)

0.15–0.55 mm

Mechanical drilling; the corresponding pad diameter should be at least 0.15 mm larger than the buried-via diameter.

Through-Hole Diameter (C)

≥ 0.15 mm

Mechanical drilling; the corresponding pad diameter should be at least 0.10 mm larger than the through-hole diameter.

Hole-to-Board-Edge Clearance (D)

≥ 0.35 mm

Distance from the edge of a blind via to the routed board edge.

Hole-to-Trace Clearance (E)

≥ 0.15 mm

Distance from the edge of a via (including blind, buried, and through vias) to the edge of a trace.

Hole-to-Hole Spacing (F)

≥ 0.13 mm

Minimum spacing from the edge of a blind via to the edge of a blind / buried / through via on the same net.

≥ 0.24 mm

Minimum spacing from the edge of a blind via to the edge of a blind / buried / through via on different nets.

Min. Trace Width / Spacing

3 mil / 3 mil

Minimum trace width (W) and minimum trace spacing (S) for inner/outer layers. The limit can reach 2.7 / 2.7 mil.

Blind-Via Dielectric Thickness (G)

0.05–0.127 mm

Dielectric thickness across the blind-via span (blind-via diameter > dielectric thickness).

Buried-Via Core Thickness (H)

≥ 0.30 mm

Core thickness across the buried-via span; this is the thinnest inner core board thickness requiring via plugging and plating.

Finished Board Thickness (T)

0.5–2.4 mm

Delivered finished board thickness (0.5 mm thickness is limited to 4-layer boards).

Important Notes

Currently supports 4-24 layer blind/buried-via boards (1st-, 2nd-, and 3rd-order HDI); minimum size: 5 × 5 mm, maximum size: 576 × 469 mm.

HDI Board FAQ
1. Q: What laser-drilled hole sizes can JLCPCB make for HDI boards? Are blind and buried vias plugged or filled?
A: The default laser-drilled hole diameter is 0.1 mm. Laser-drilled holes from 0.075 mm to 0.15 mm can be processed.
A: Blind and buried vias are filled. Blind vias are filled and planarized by electroplating, while buried vias are resin plugged and capped with plating.
2. Q: What is the hole diameter tolerance for JLCPCB HDI boards?
A: PTH component hole tolerance is controlled at +/-0.076 mm. NPTH component hole tolerance is controlled at +/-0.05 mm. Via hole diameters are not controlled. Details are as follows:
A: Laser blind vias are filled and planarized by electroplating. Mechanical buried vias use resin plugging.
3. Q: What is the minimum panel size for JLCPCB HDI boards?
A: With V-cut processing, the minimum panel size is 30 x 60 mm. Panels smaller than this can use stamp-hole panelization.
4. Q: What materials are available for JLCPCB HDI boards, and what are the common PP specifications and thicknesses?
A: We use Shengyi and Nanya laminates. The relevant PP parameters are as follows:
5. Q: If the PP layer between L1 and L2 is required to be 0.1 mm thick, can a 0.075 mm blind via be designed?
A: No. The blind-via thickness-to-diameter ratio must be <= 1:1. In other words, with a 0.1 mm dielectric thickness, the minimum blind-via diameter is 0.1 mm.
6. Q: What is the maximum thickness for an HDI board, and what is the corresponding minimum through-hole size?
A: The aspect ratio for mechanical buried vias and through vias must be <= 16:1. We can process HDI boards up to 2.4 mm thick, with a corresponding minimum through-hole size of 0.15 mm.
7. Q: What is the tolerance for impedance control? What is the impedance tolerance for 45 ohms?
A: When the impedance value is >= 50 ohms, the tolerance is +/-10%. When the impedance value is < 50 ohms, the tolerance is +/-5 ohms. For example, the tolerance for 45-ohm impedance is 45 +/-5 ohms.
8. Q: How are 1st-order, 2nd-order, and similar HDI boards distinguished?
A: The distinction between 1st-order to 3rd-order PCB structures is mainly based on the number of lamination cycles and laser drilling operations. 1st-order means one lamination cycle and one laser drilling operation; 2nd-order means two
lamination cycles and two laser drilling operations; 3rd-order means three lamination cycles and three laser drilling operations, and so on. The PCB order is determined by two key indicators:
(1) Number of lamination cycles: the number of interlayer bonding processes during PCB manufacturing;
(2) Number of laser drilling operations: the number of processing operations used to form blind and buried vias by laser technology;
9. Q: Compared with standard PCBs, what should be considered when designing HDI boards?
A: Please note the following:
1) Blind vias are formed by laser drilling, so the hole diameter cannot be too large. The diameter should be within 0.075-0.15 mm and must also match the corresponding PP layer thickness.
2) The annular ring for blind and buried vias should be at least 0.075 mm, meaning the pad diameter should be at least 0.15 mm larger than the hole diameter. The hole-edge spacing between different nets should be >= 0.24 mm.
3) The minimum line width/spacing is 3/3 mil. When there is enough space, please design at 3.5/3.5 mil. In tight spaces, we support an extreme line width/spacing of 2.7/2.7 mil, but this will increase difficulty and cost.
10. Q: When ordering an 8-layer board, the stack-up structure option includes "JLCH081611Y2-1078A". How are these HDI board stack-up structures named?
A: Please refer to the following:

Online Chat >

Chat with our live agent for fast reply.

Mon-Fri: 24 hours, Sat: 9am-6pm, GMT+8
Email Us >

Contact us at support
jlcpcb.com

Typically reply within hours.
Help Center >

Get instant answers.

24/7 Available.

Products

FR-4 PCBs
Flexible PCBs
Metal Core PCBs
High-Frequency PCBs
PCBA Service
PCB Layout
SMT Stencil
Flex Heater
Support

Help Center
Contact Us
Community
Shipping & Delivery
Payment Methods
How to Order
How to Track
After-Sales Service
Blog
Company

About Us
Quality Assurance
How We Work
Certifications
Security
Environment
JLCAPI
News
Cooperation
Electronics

EasyEDA
JLCPCB
JLCDFM
LCSC
OSHWLAB
Mechanical

JLC3DP
JLCCNC
JLCMC

CONNECT WITH US

© 2026 JLCPCB.COM All Rights Reserved.

Privacy Policy

Terms & Conditions

Cookies Policy

Get Coupon >

Live Chat >

Home

Cart

Files

Message

Me
