parkourlrc/pcb-yilv1982--duck-robot-89dbc81d6d/docs/references/扩展板电路仿真工具/i2s-sdo-repair-20261030/inspection.png

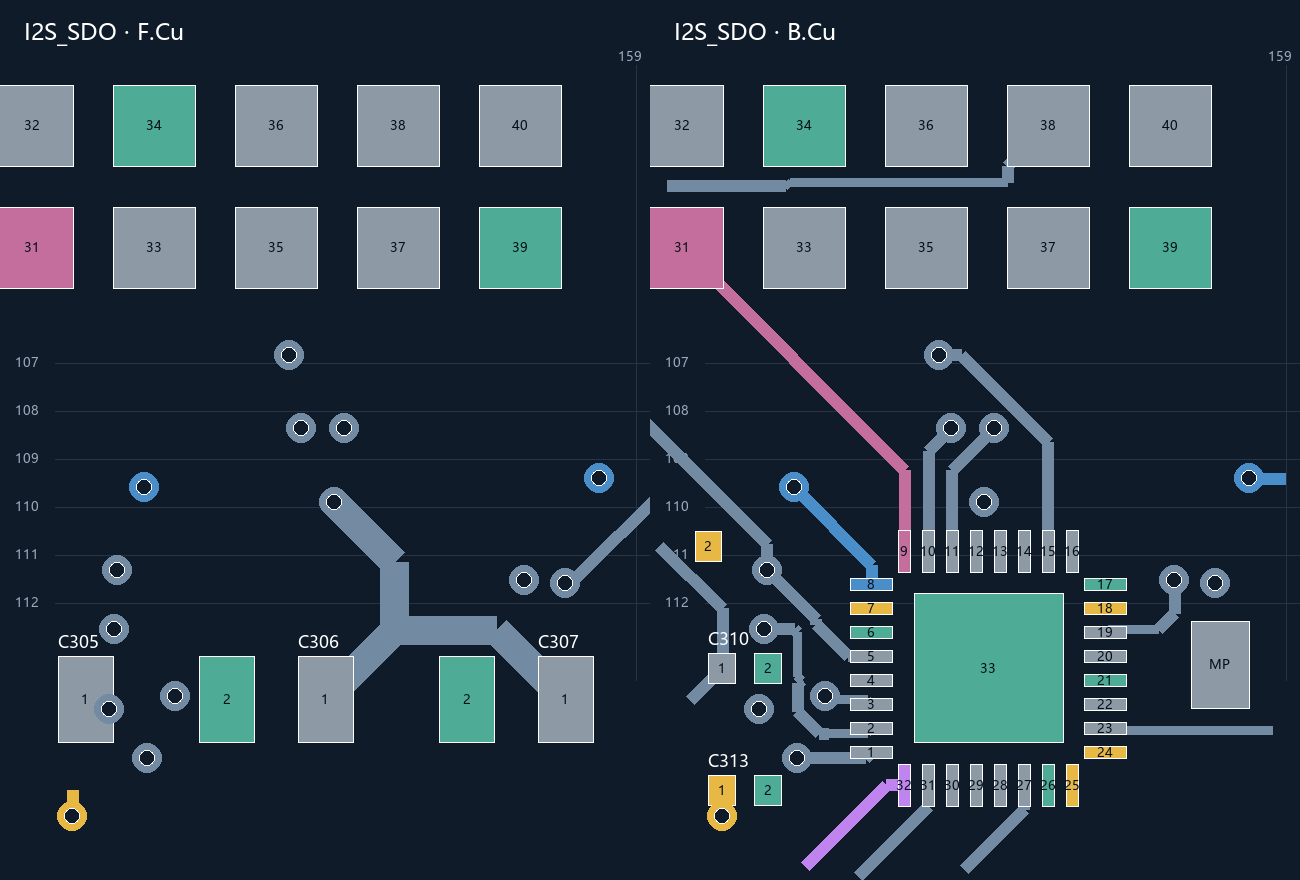
docs/references/扩展板电路仿真工具/i2s-sdo-repair-20261030/inspection.png
