parkourlrc/pcb-yilv1982--duck-robot-89dbc81d6d/docs/references/扩展板电路仿真工具/j506-repair-20261030/j506-before-after.png

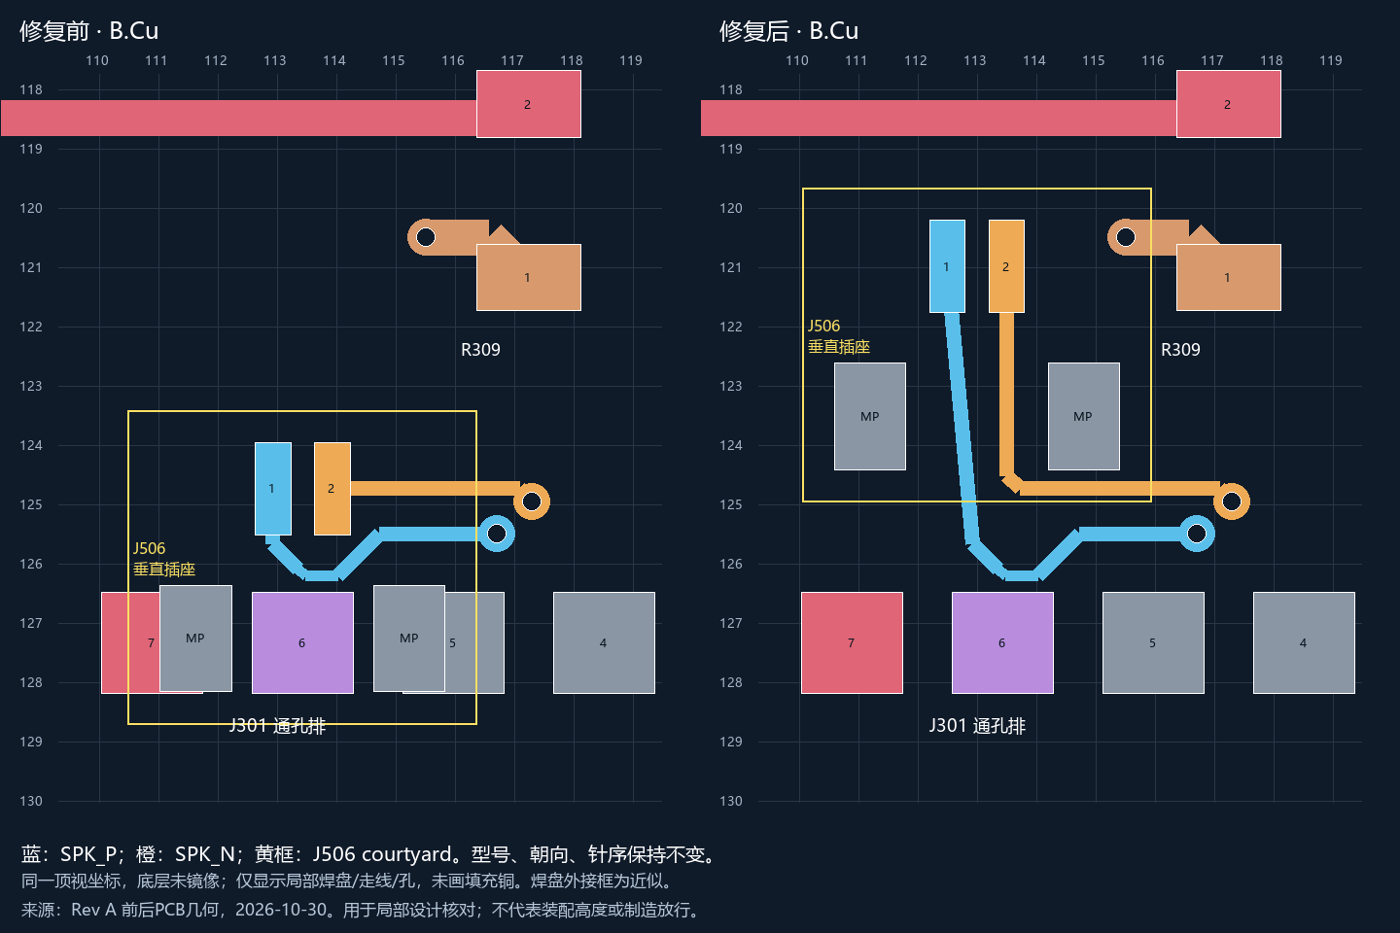
docs/references/扩展板电路仿真工具/j506-repair-20261030/j506-before-after.png
