parkourlrc/pcb-yilv1982--duck-robot-89dbc81d6d/docs/references/扩展板电路仿真工具/metadata-repair-20261030/sources/radxa-page11.png

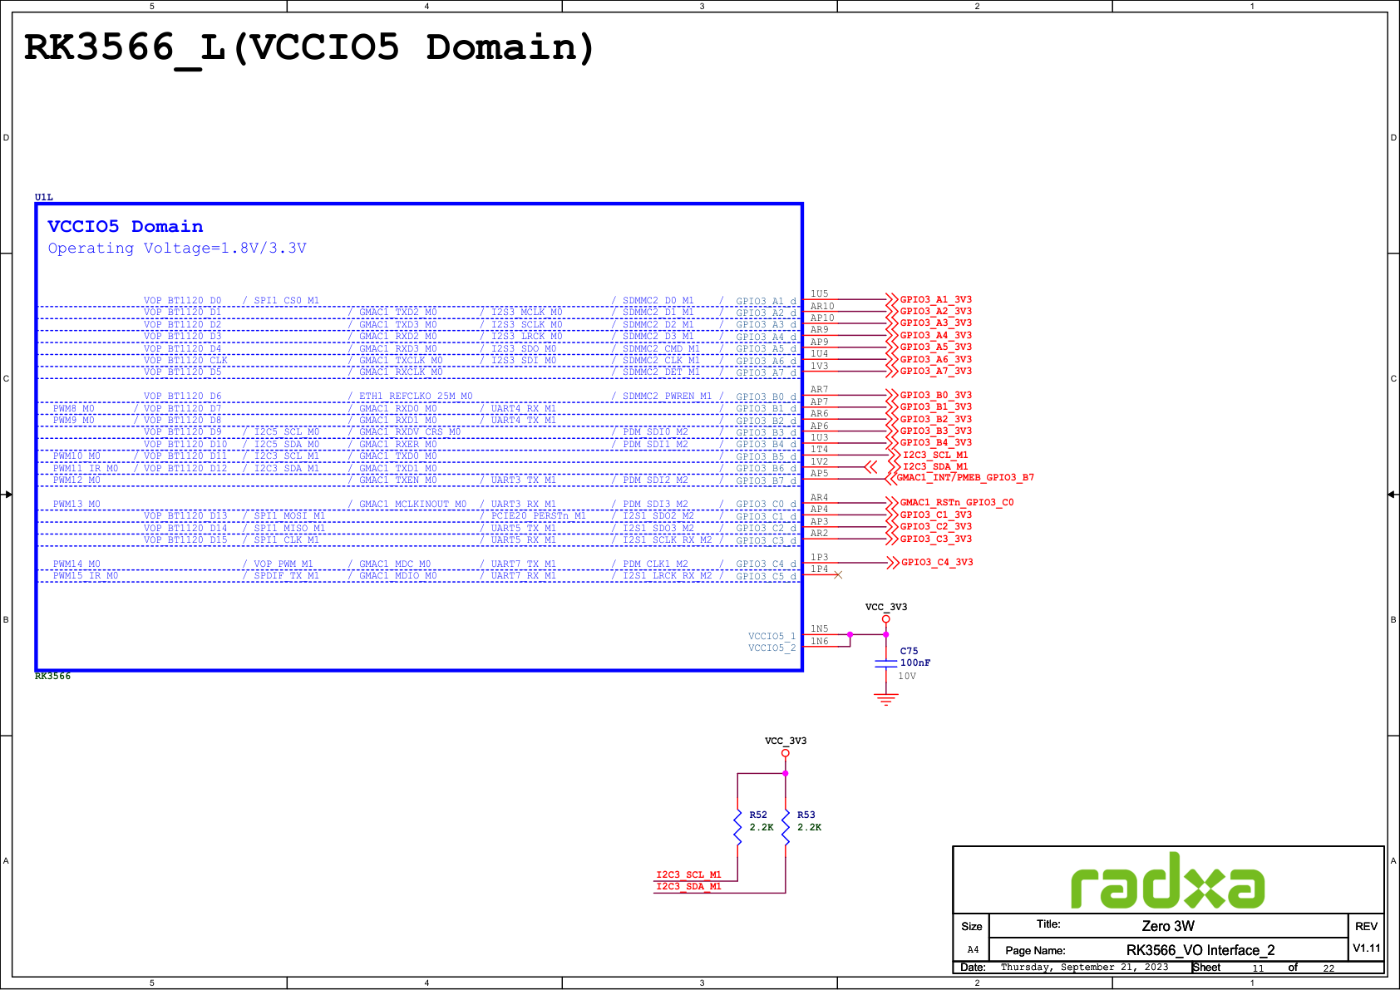
docs/references/扩展板电路仿真工具/metadata-repair-20261030/sources/radxa-page11.png
