parkourlrc/pcb-yilv1982--duck-robot-89dbc81d6d/docs/references/扩展板电路仿真工具/power-repair-20261030/power-route-review.png

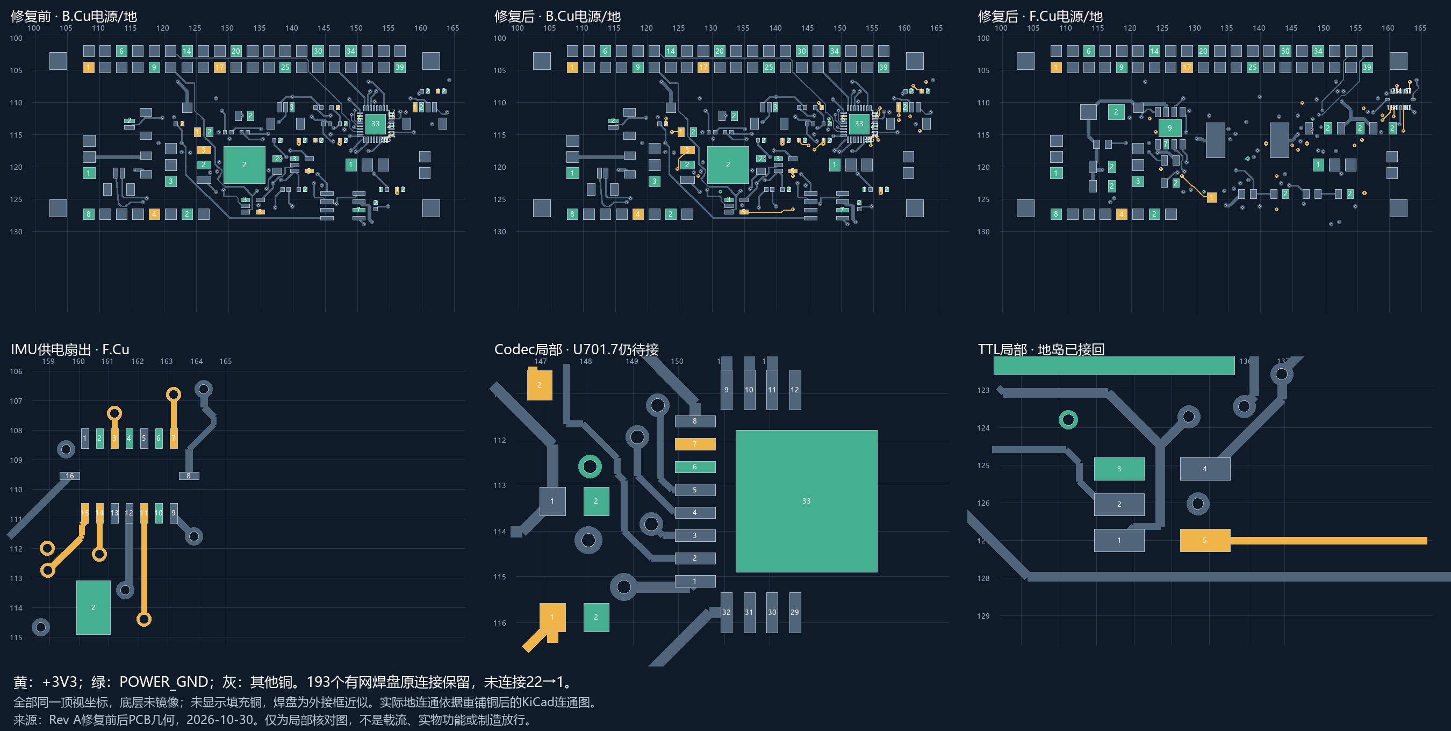
docs/references/扩展板电路仿真工具/power-repair-20261030/power-route-review.png
