parkourlrc/pcb-yilv1982--duck-robot-89dbc81d6d/docs/references/扩展板电路仿真工具/u501-repair-20261030/u501-before-after.png

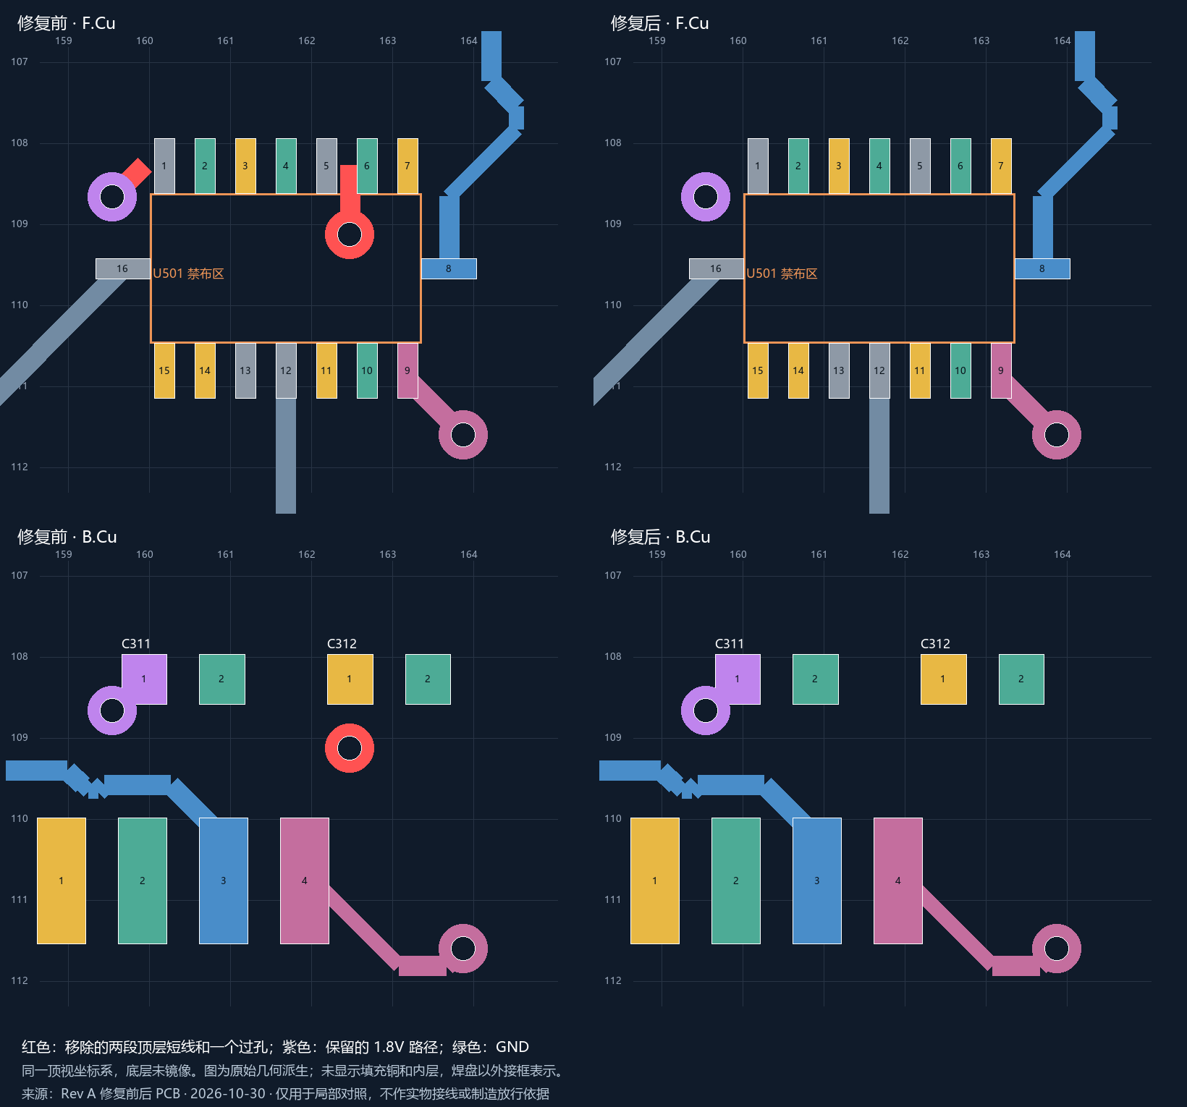
docs/references/扩展板电路仿真工具/u501-repair-20261030/u501-before-after.png
