parkourlrc/pcb-yilv1982--duck-robot-89dbc81d6d/hardware/custom_hat/custom_hat.pdf

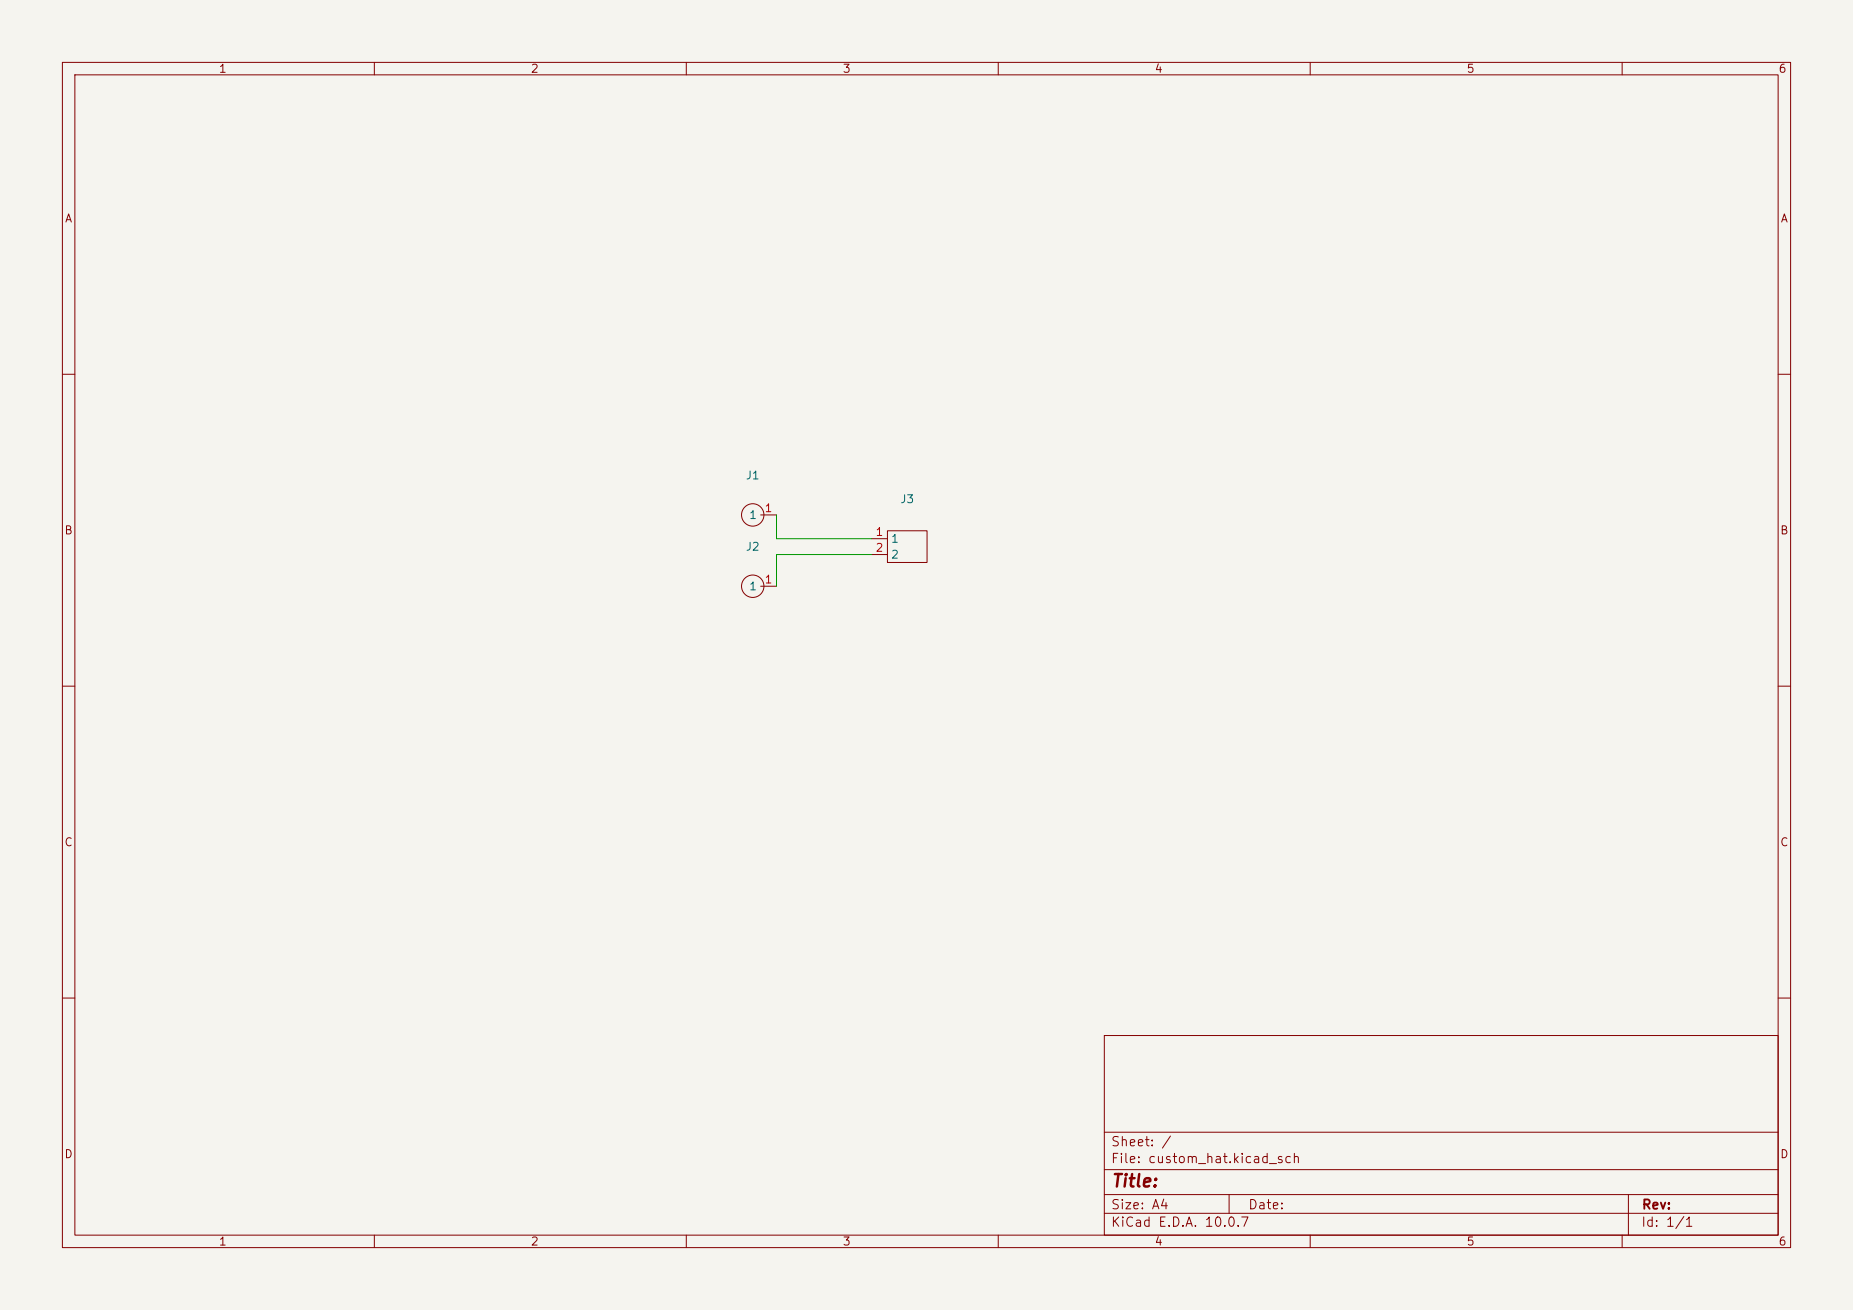
[picture p242: page 1]

Size: A4 | Rev:
KiCad E.D.A. 10.0.7 | Id: 1/1
