parkourlrc/pcb-yilv1982--duck-robot-89dbc81d6d/hardware/custom_hat/rev_b/review-output/schematic.pdf

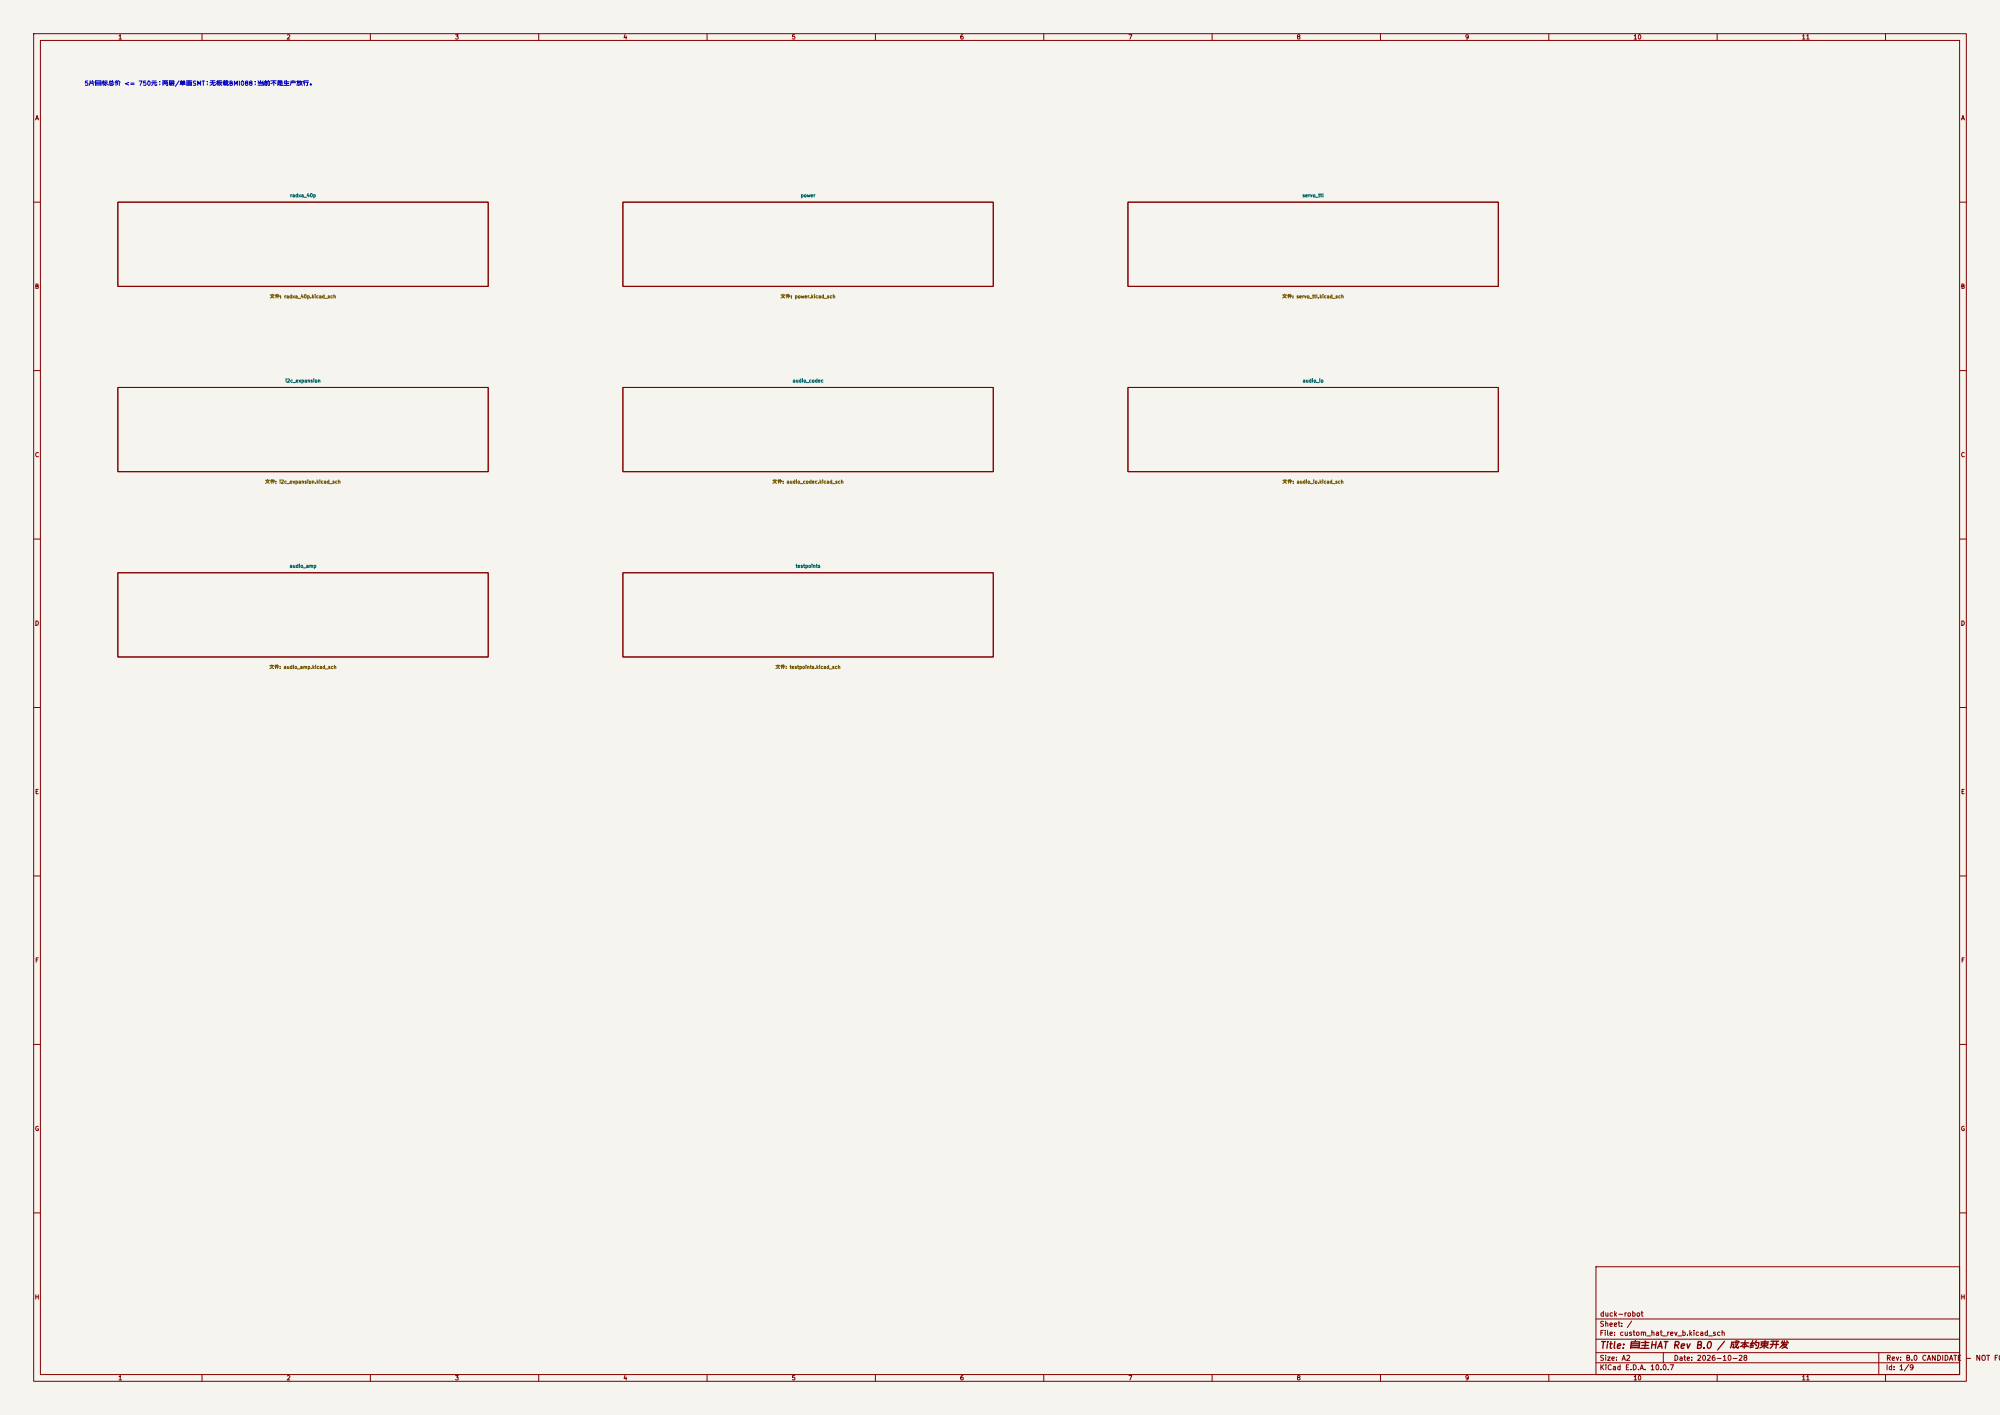
[picture p243: page 1]

duck-robot
Sheet: /
File: custom_hat_rev_b.kicad_sch
Title: 自主HAT Rev B.0 / 成本约束开发

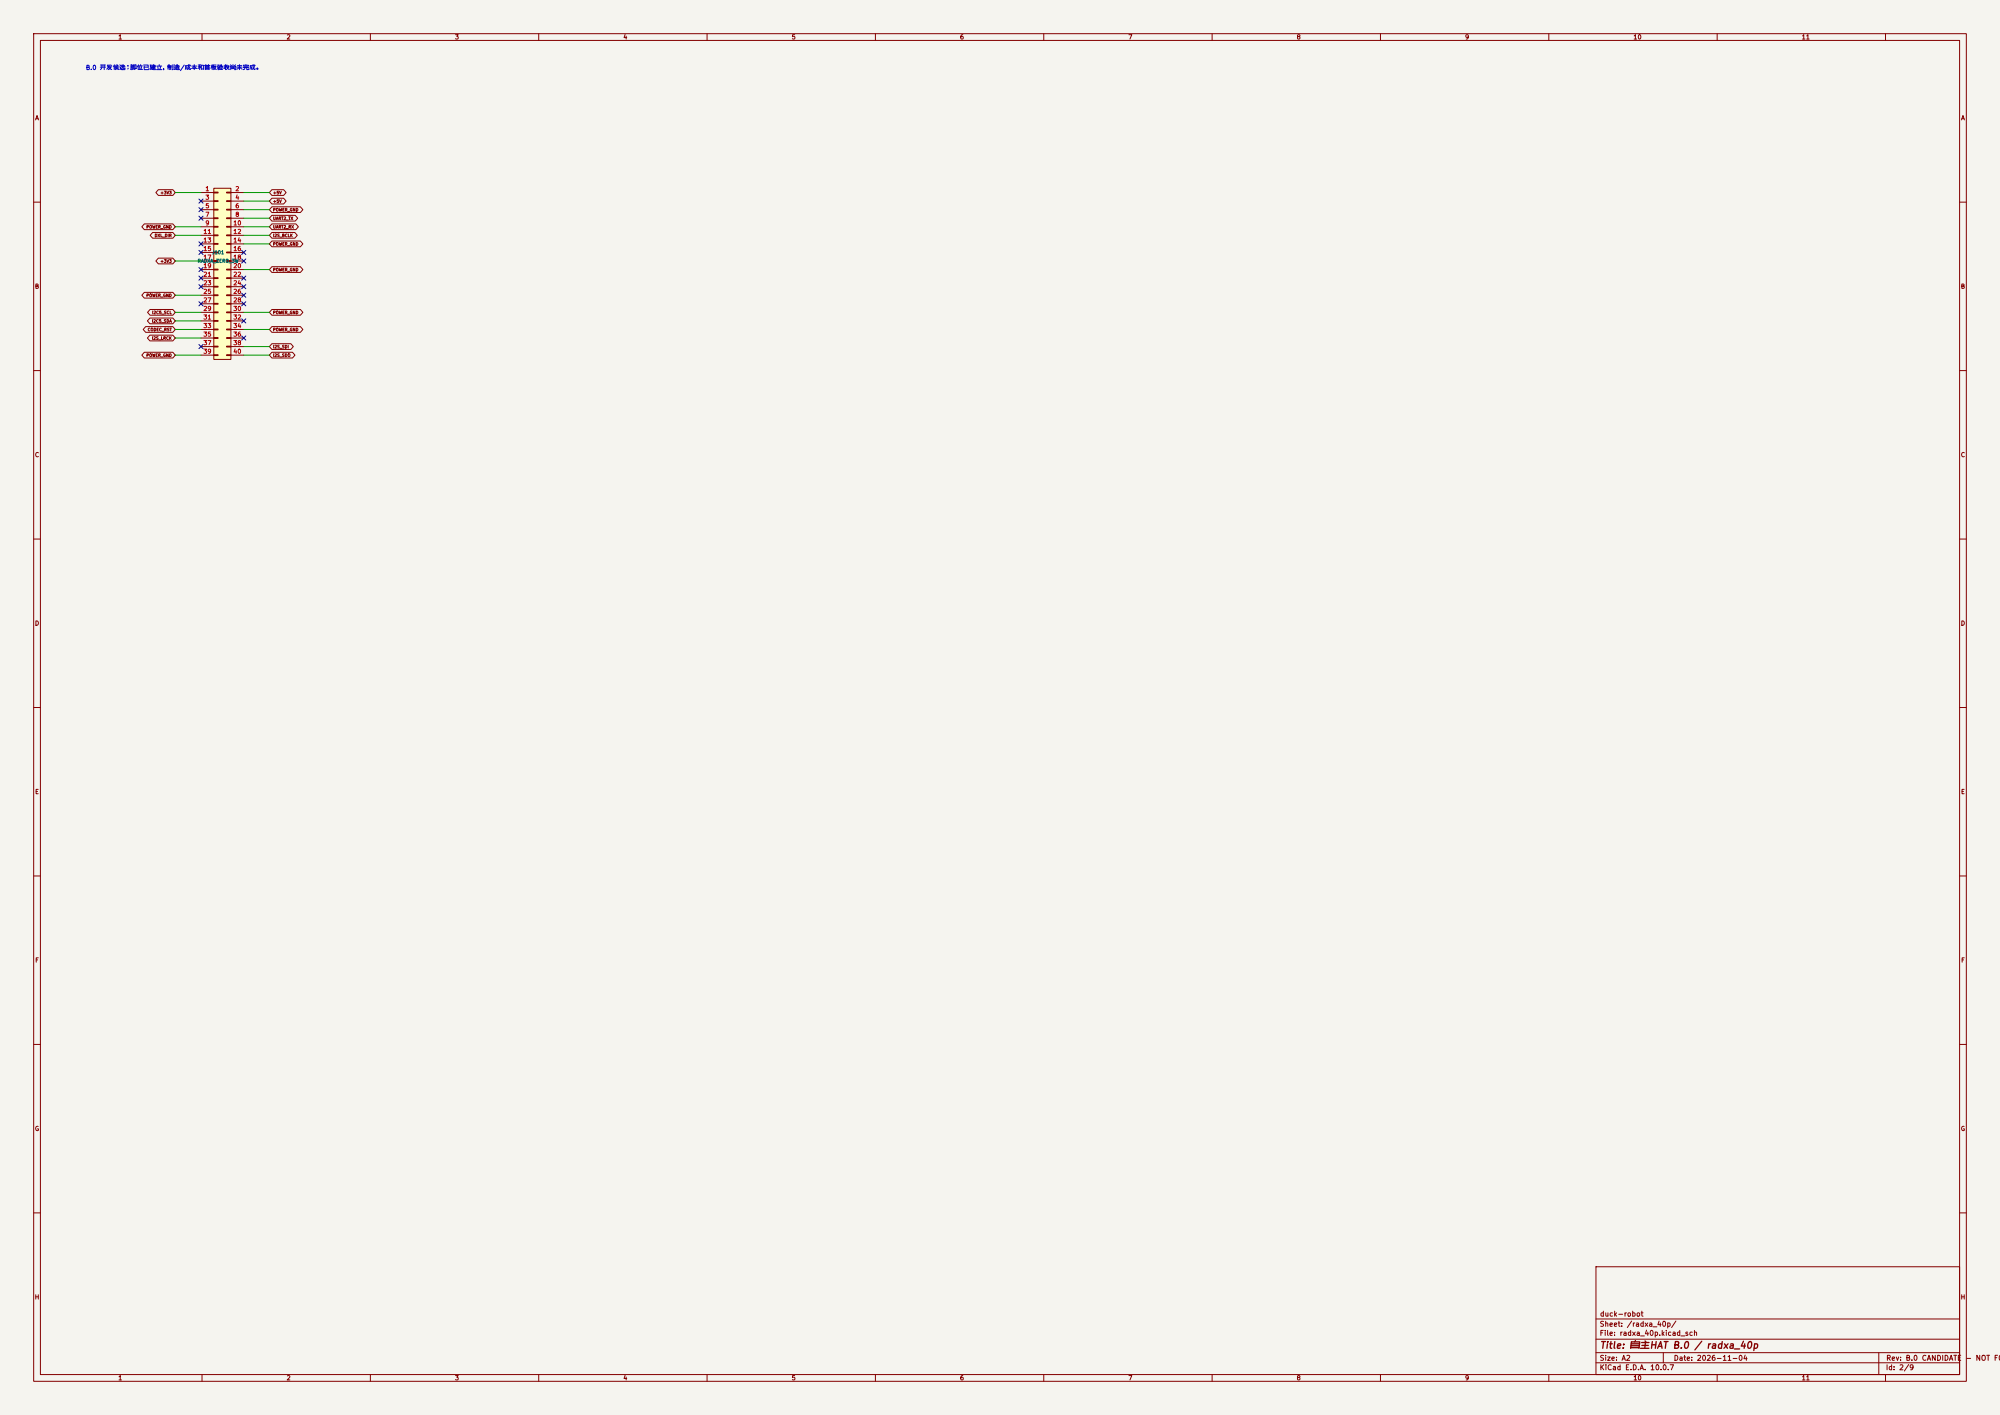
[picture p244: page 2]

I2S_LRCK B.0 开发候选；脚位已建立，制造/成本和首板验收尚未完成。

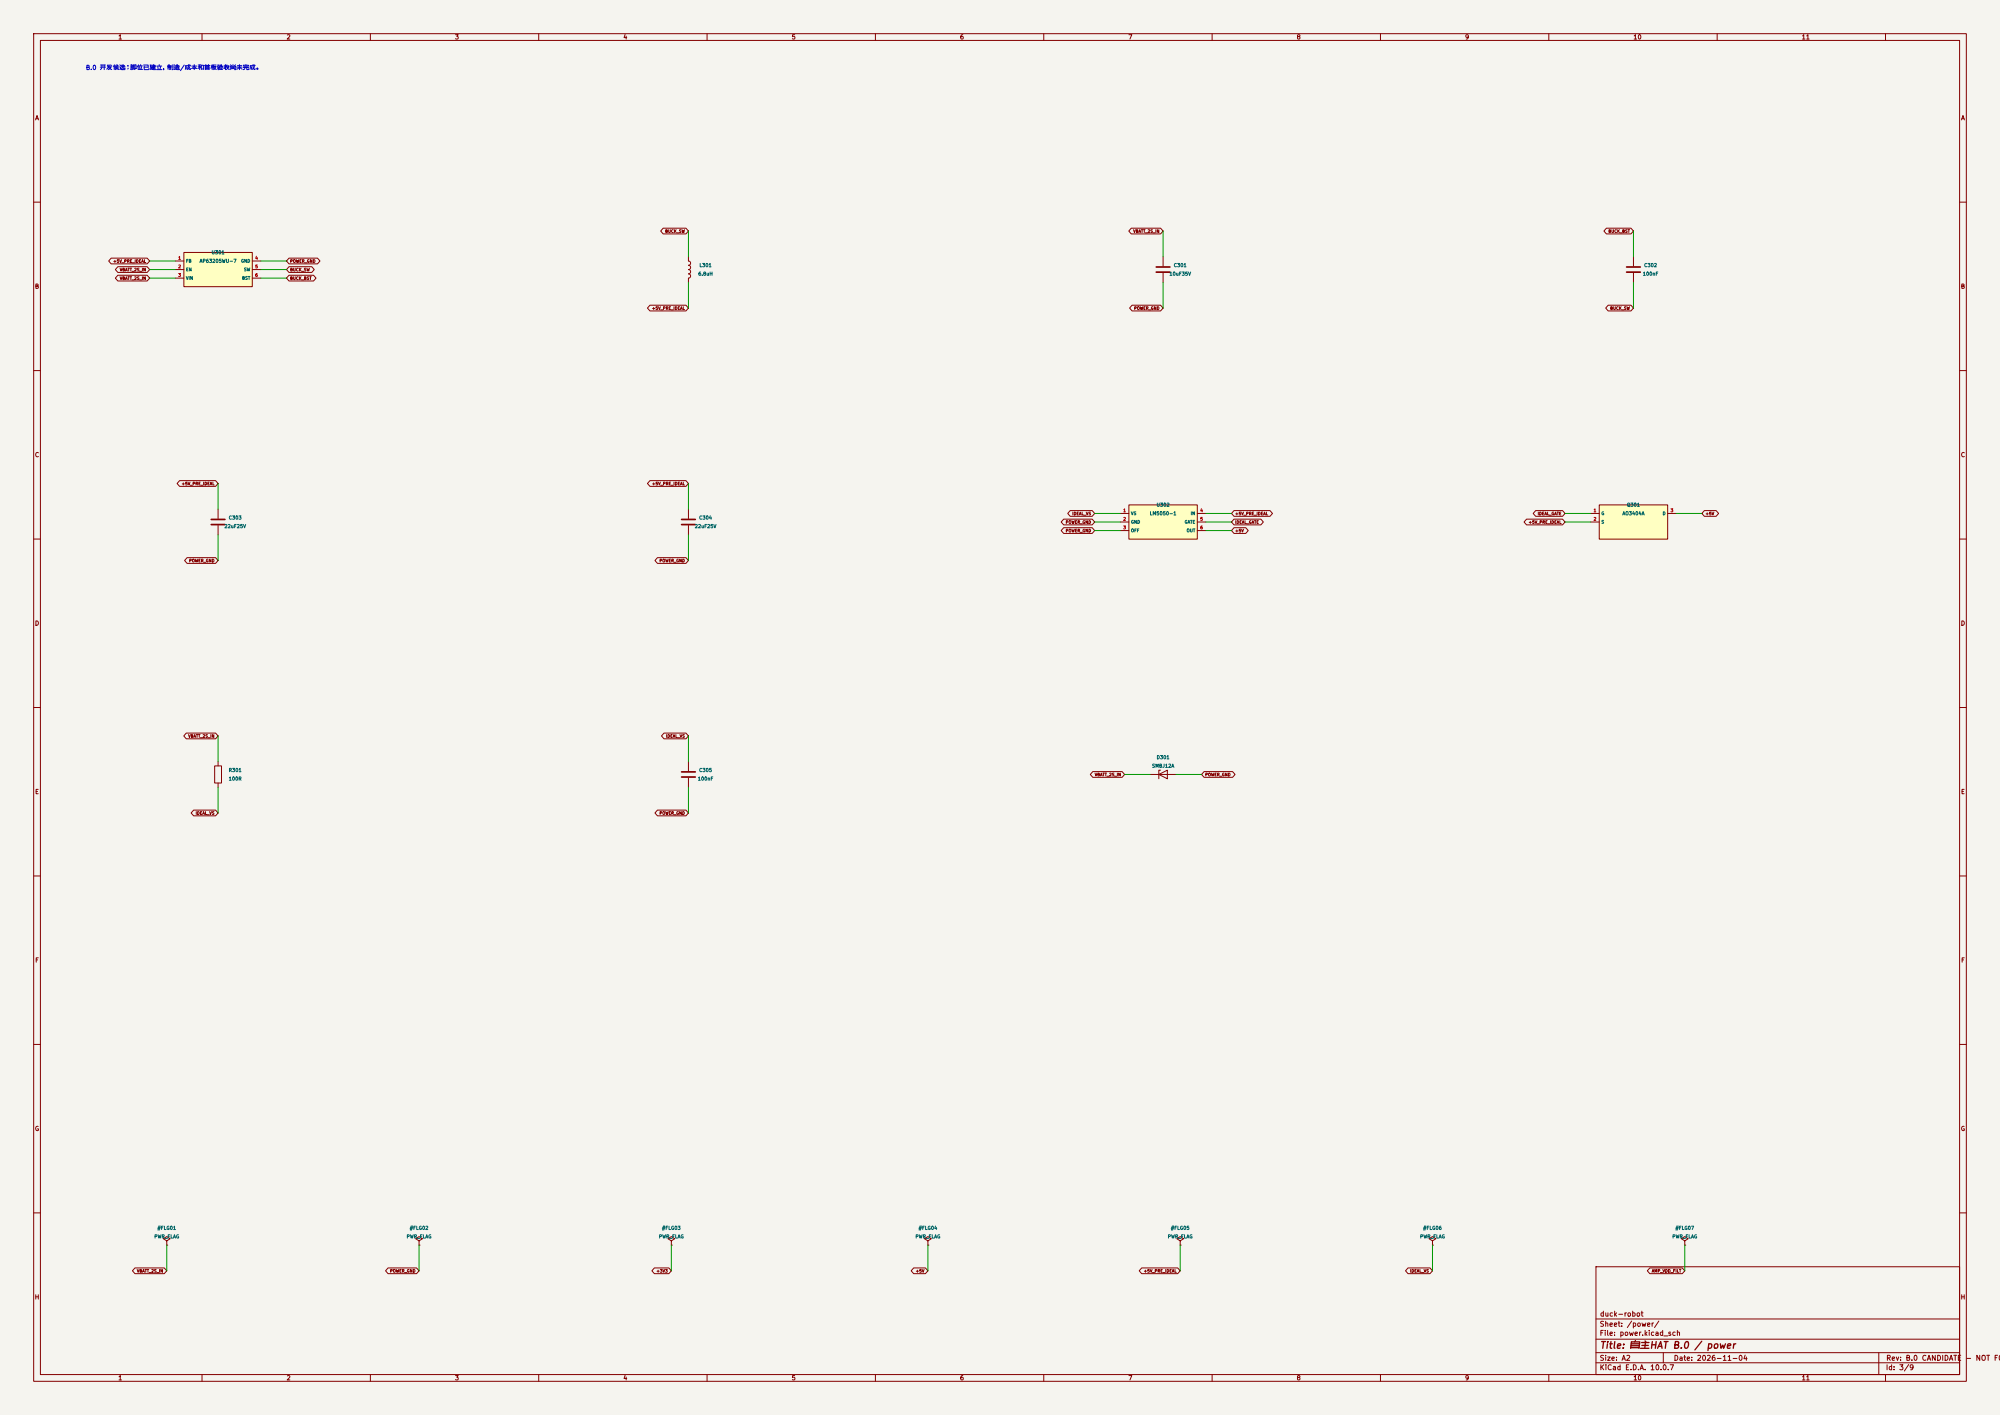
[picture p245: page 3]

B.0 开发候选；脚位已建立，制造/成本和首板验收尚未完成。

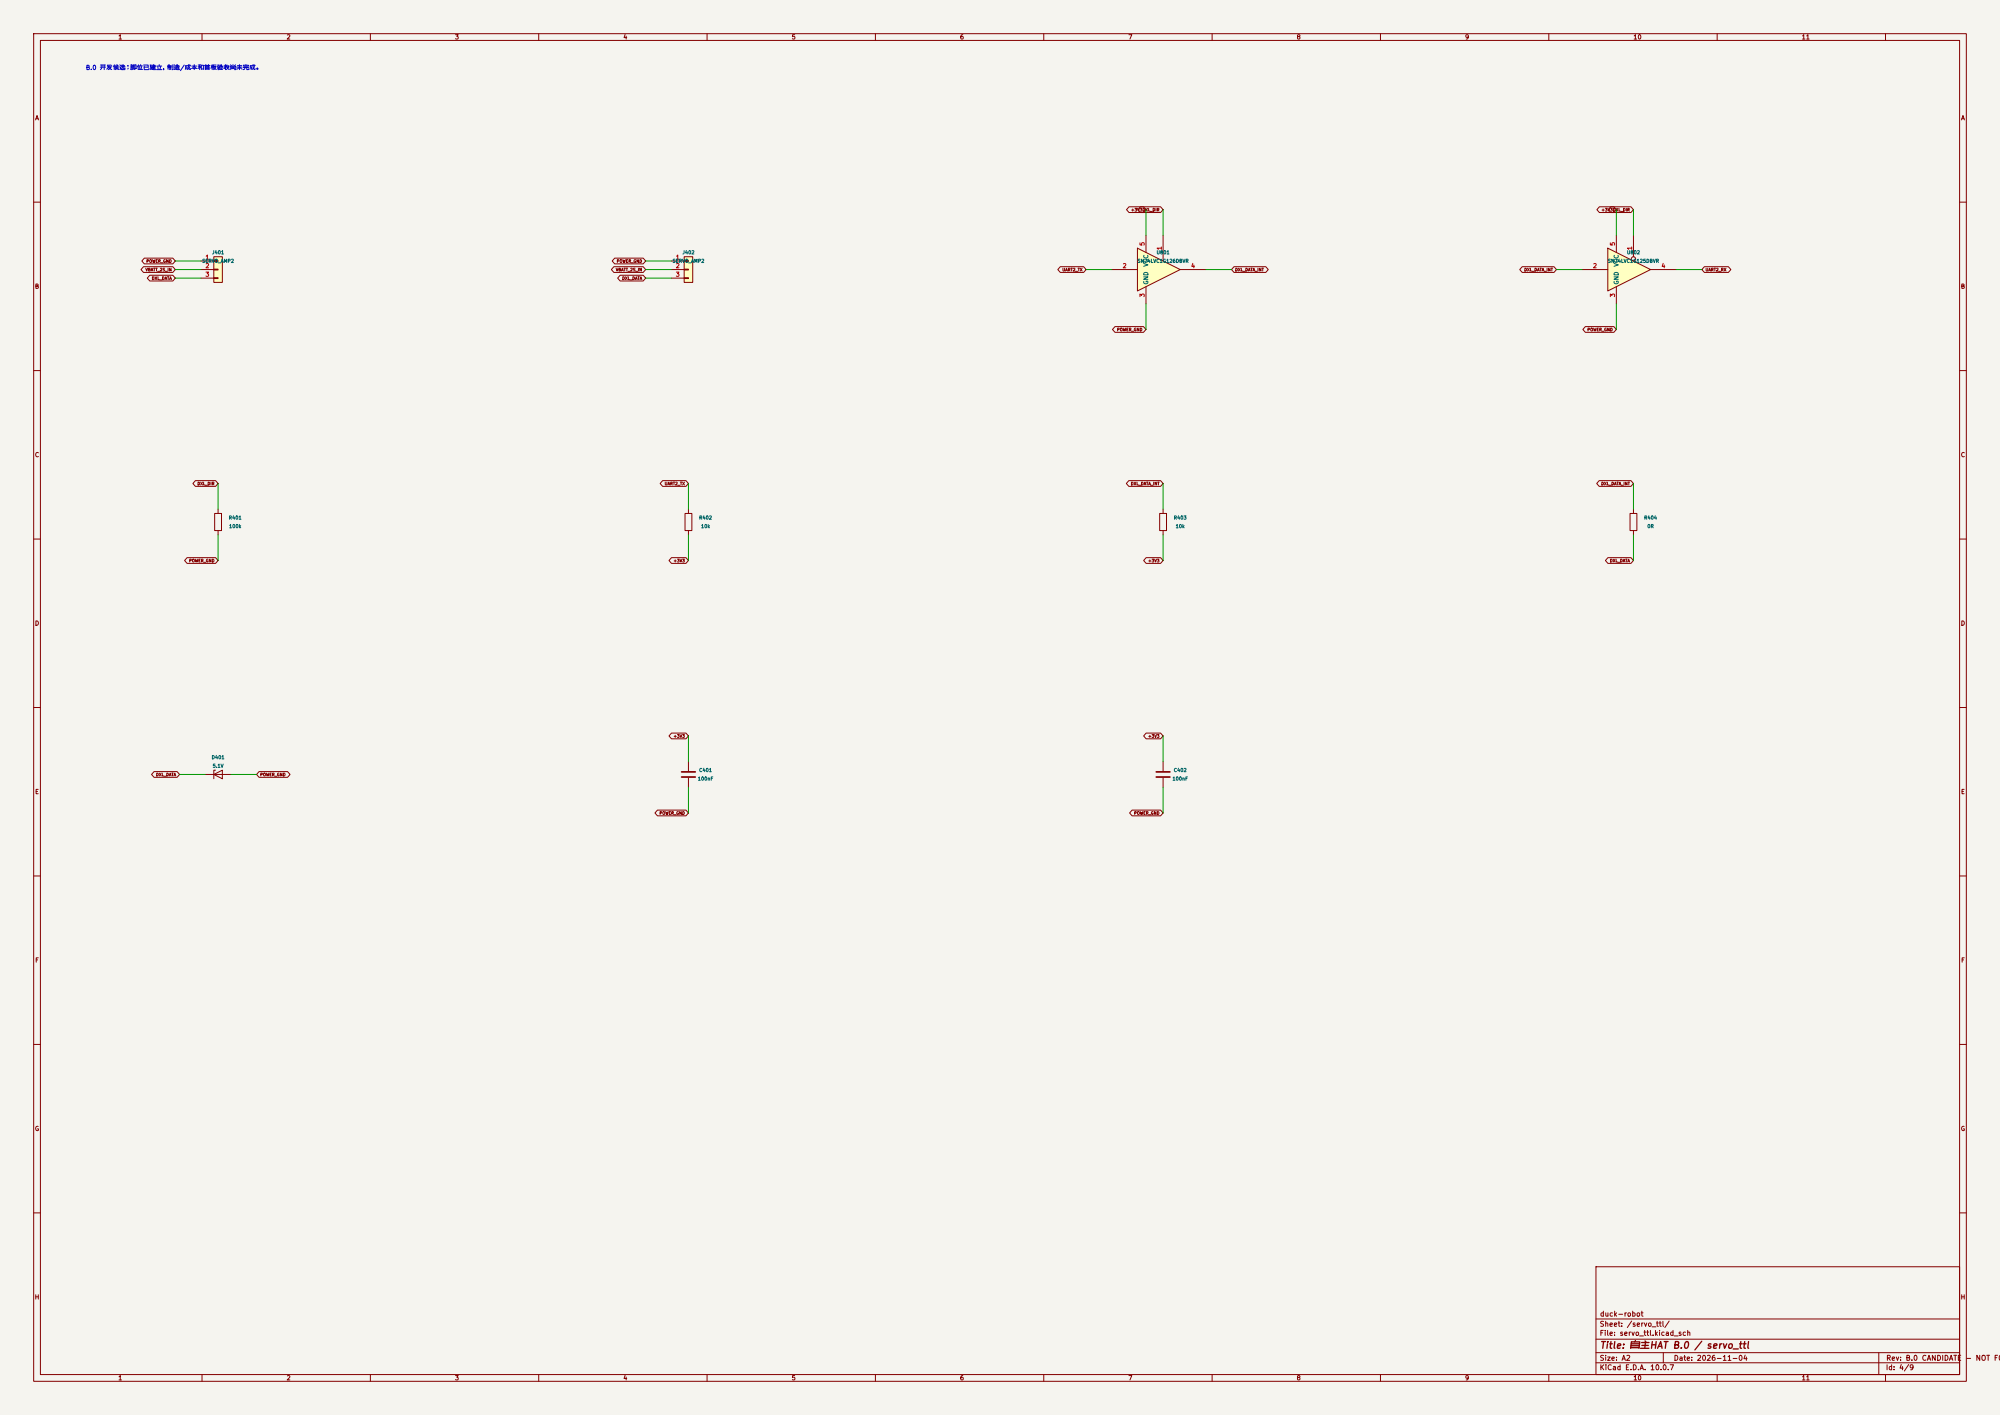
[picture p246: page 4]

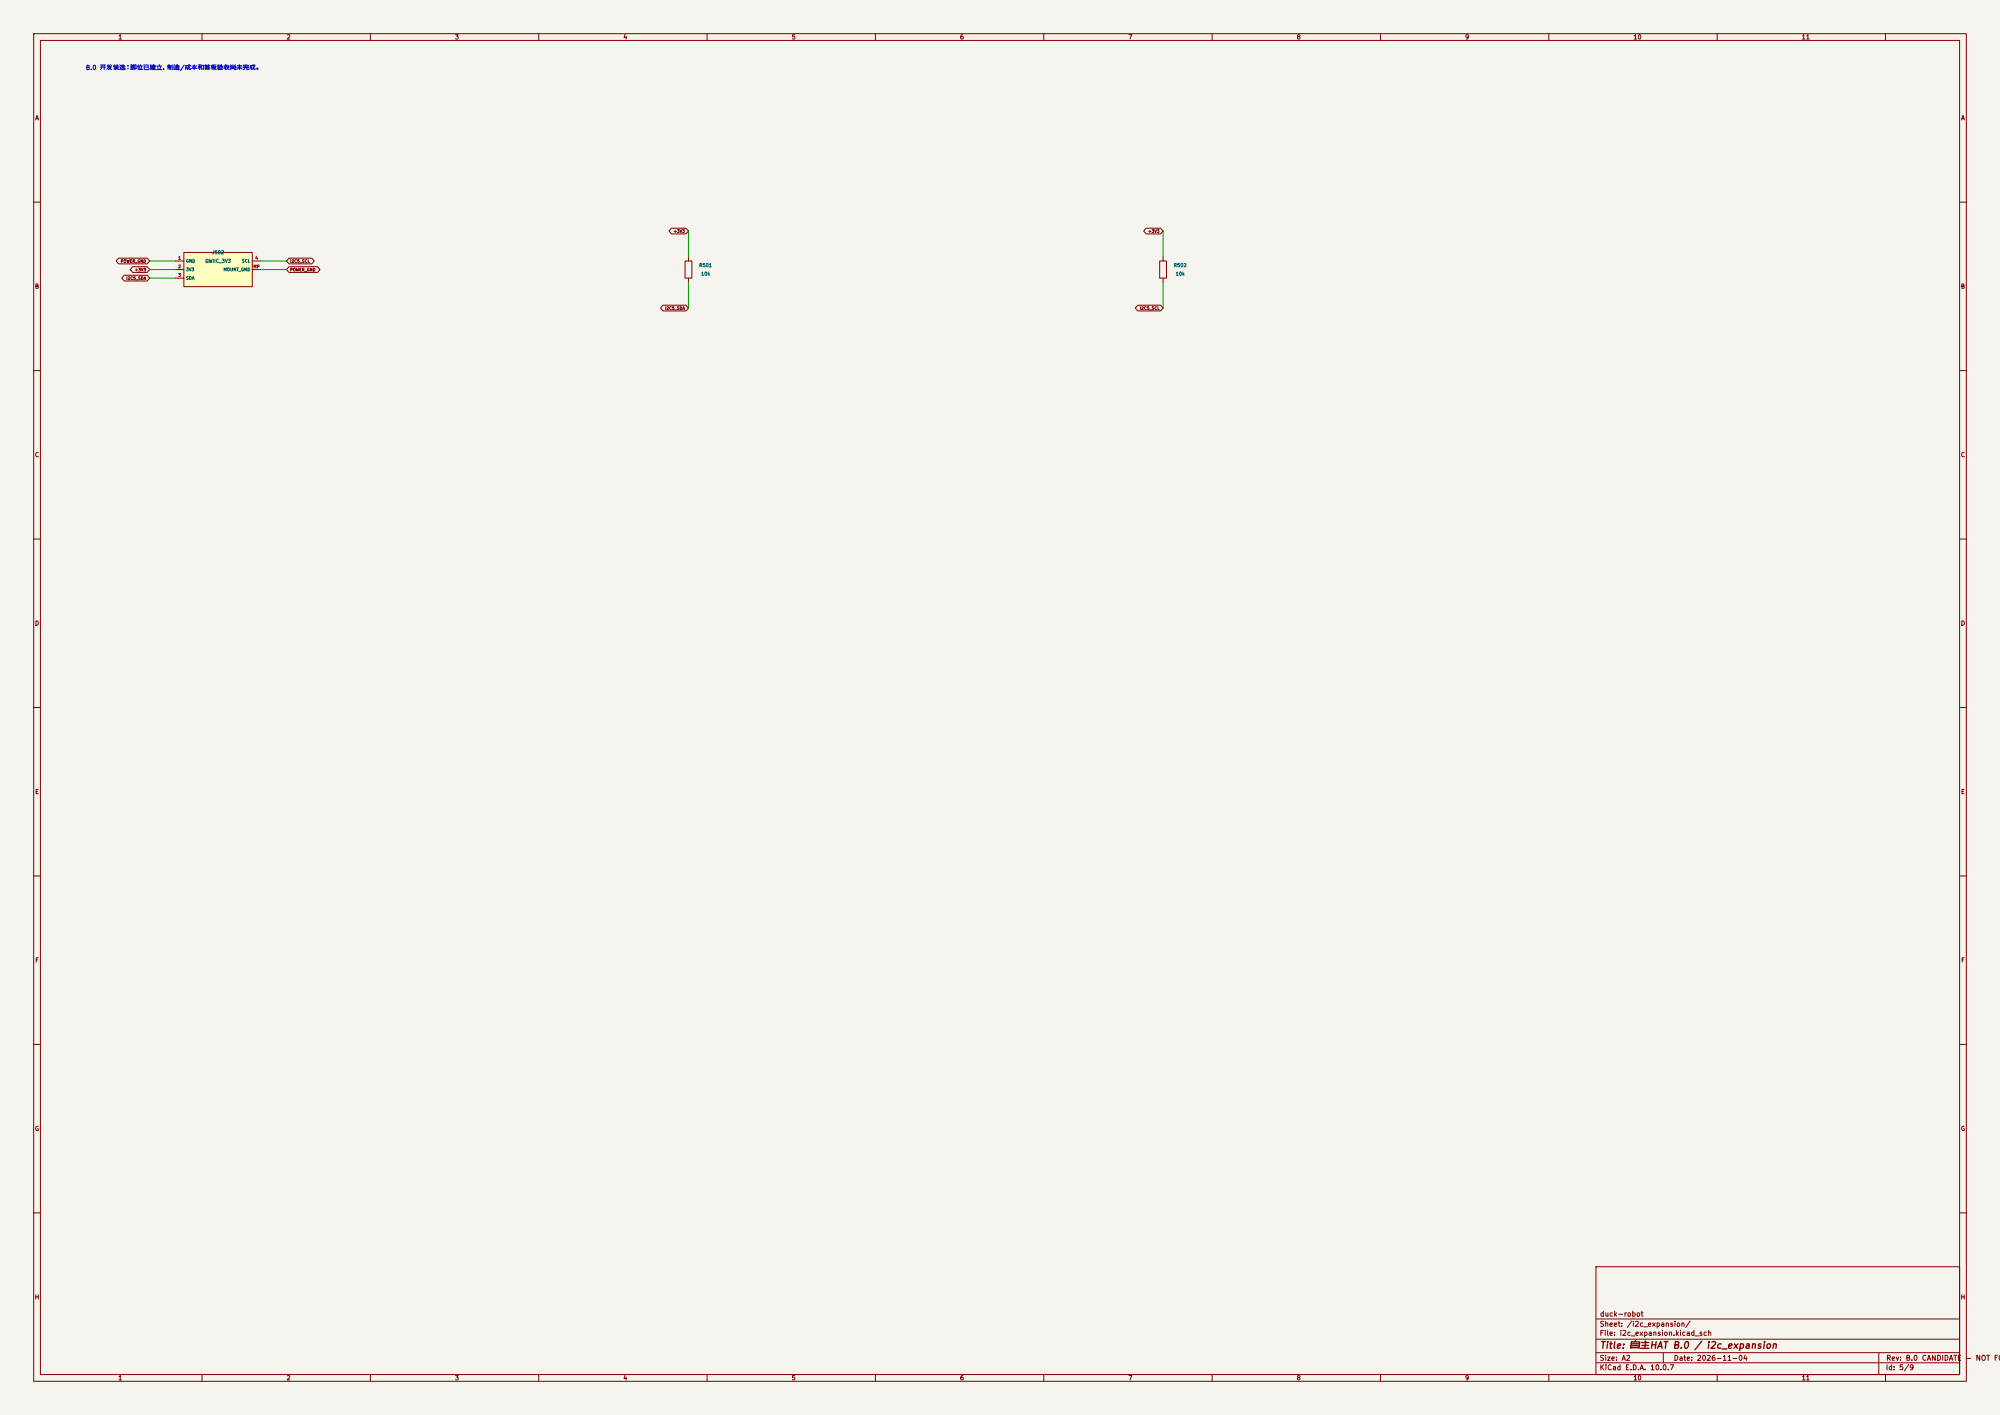
[picture p247: page 5]

I2C5_SCL B.0 开发候选；脚位已建立，制造/成本和首板验收尚未完成。

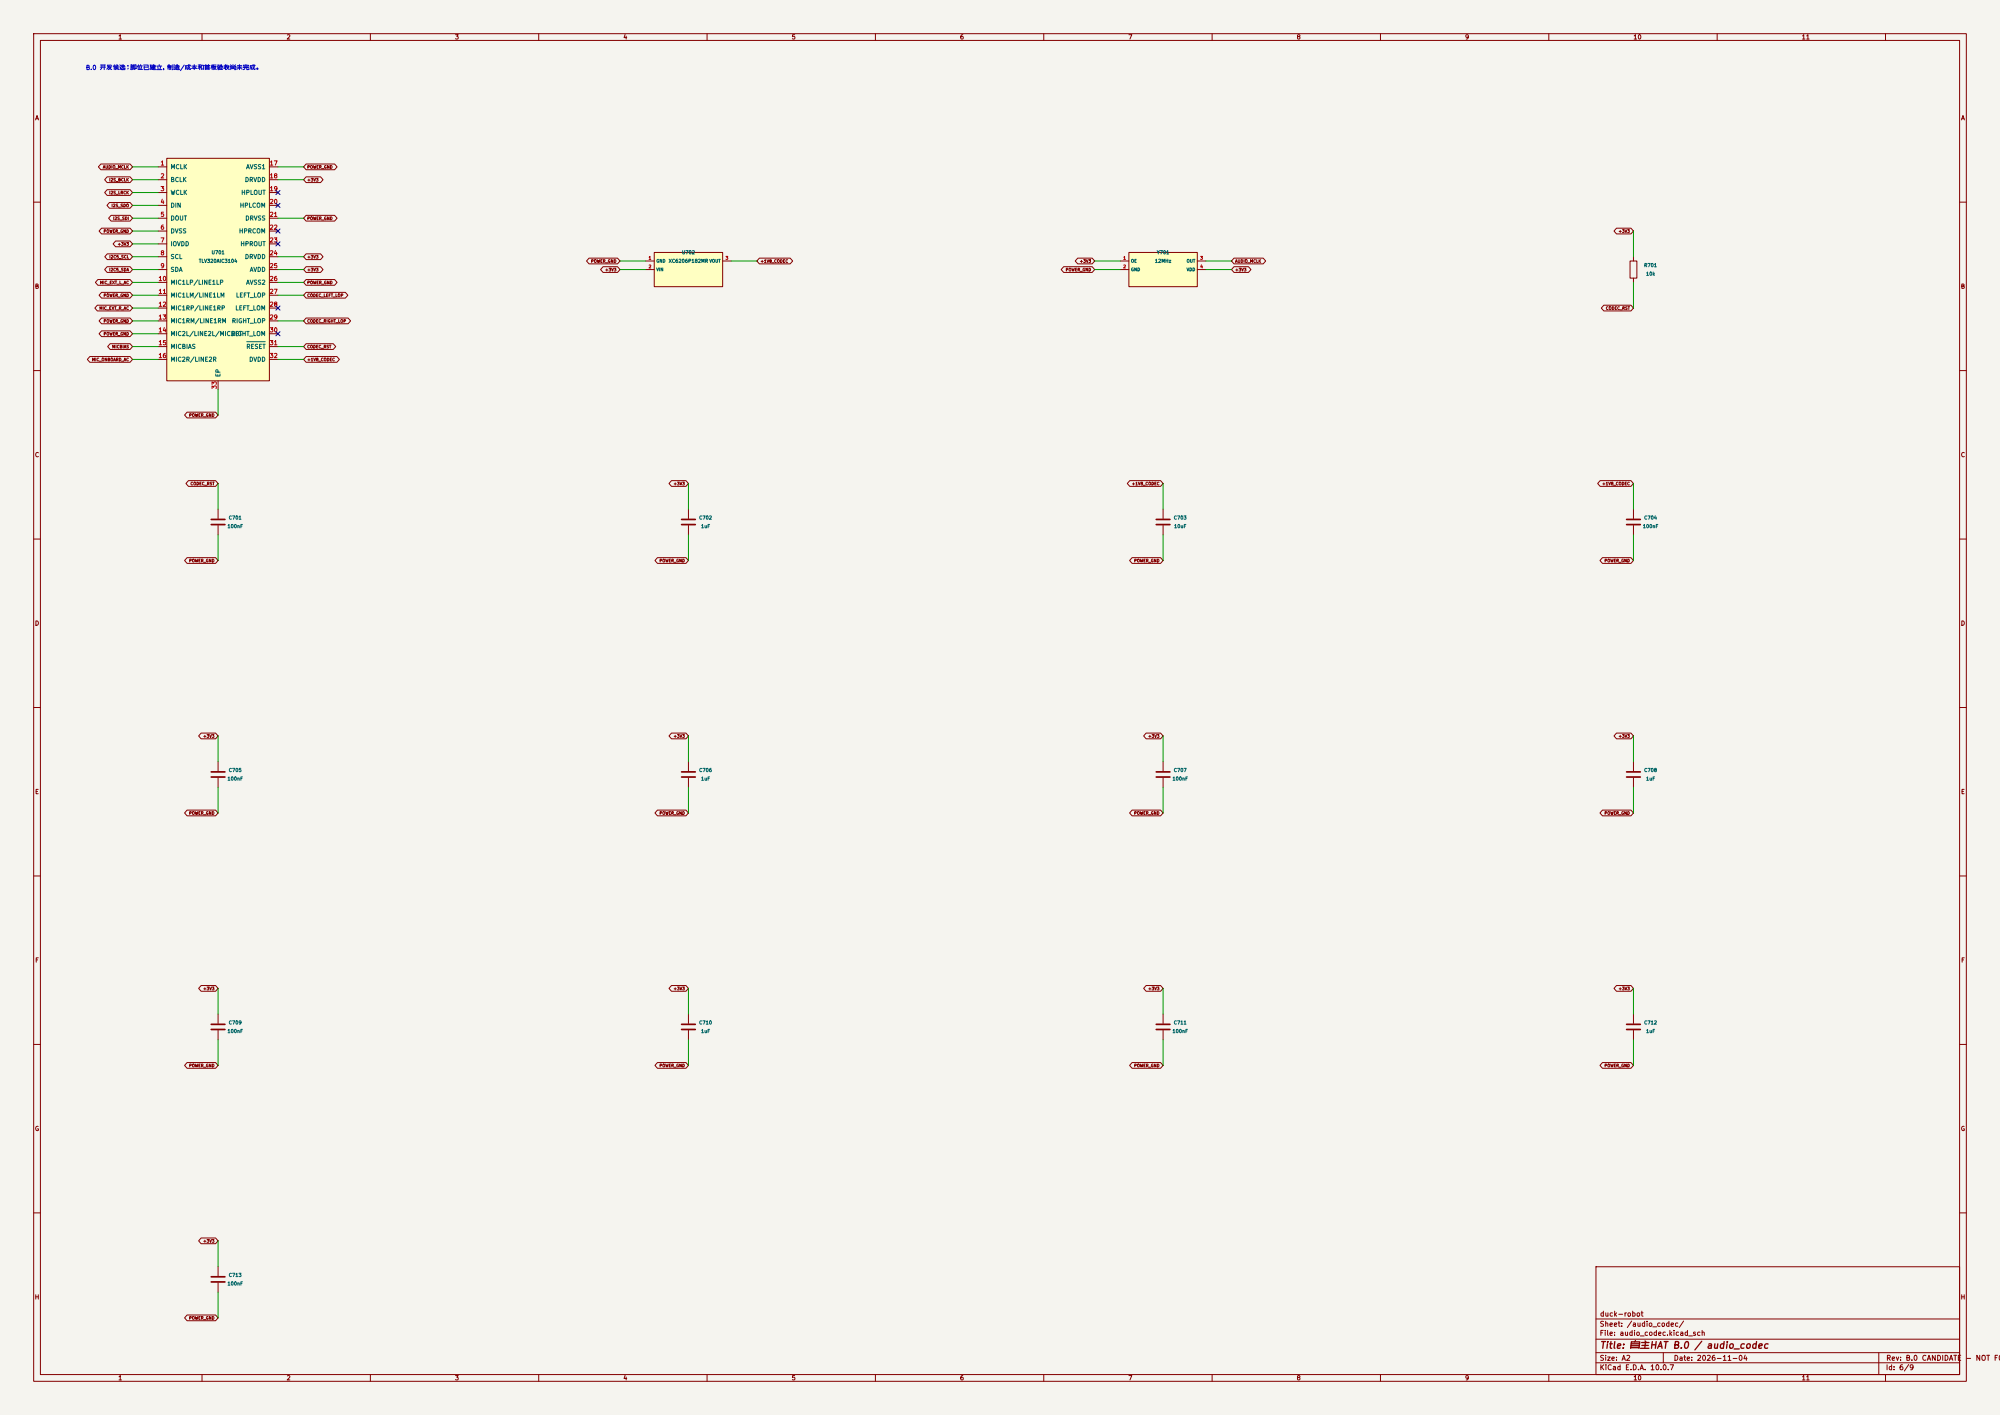
[picture p248: page 6]

AUDIO_MCLK B.0 开发候选；脚位已建立，制造/成本和首板验收尚未完成。

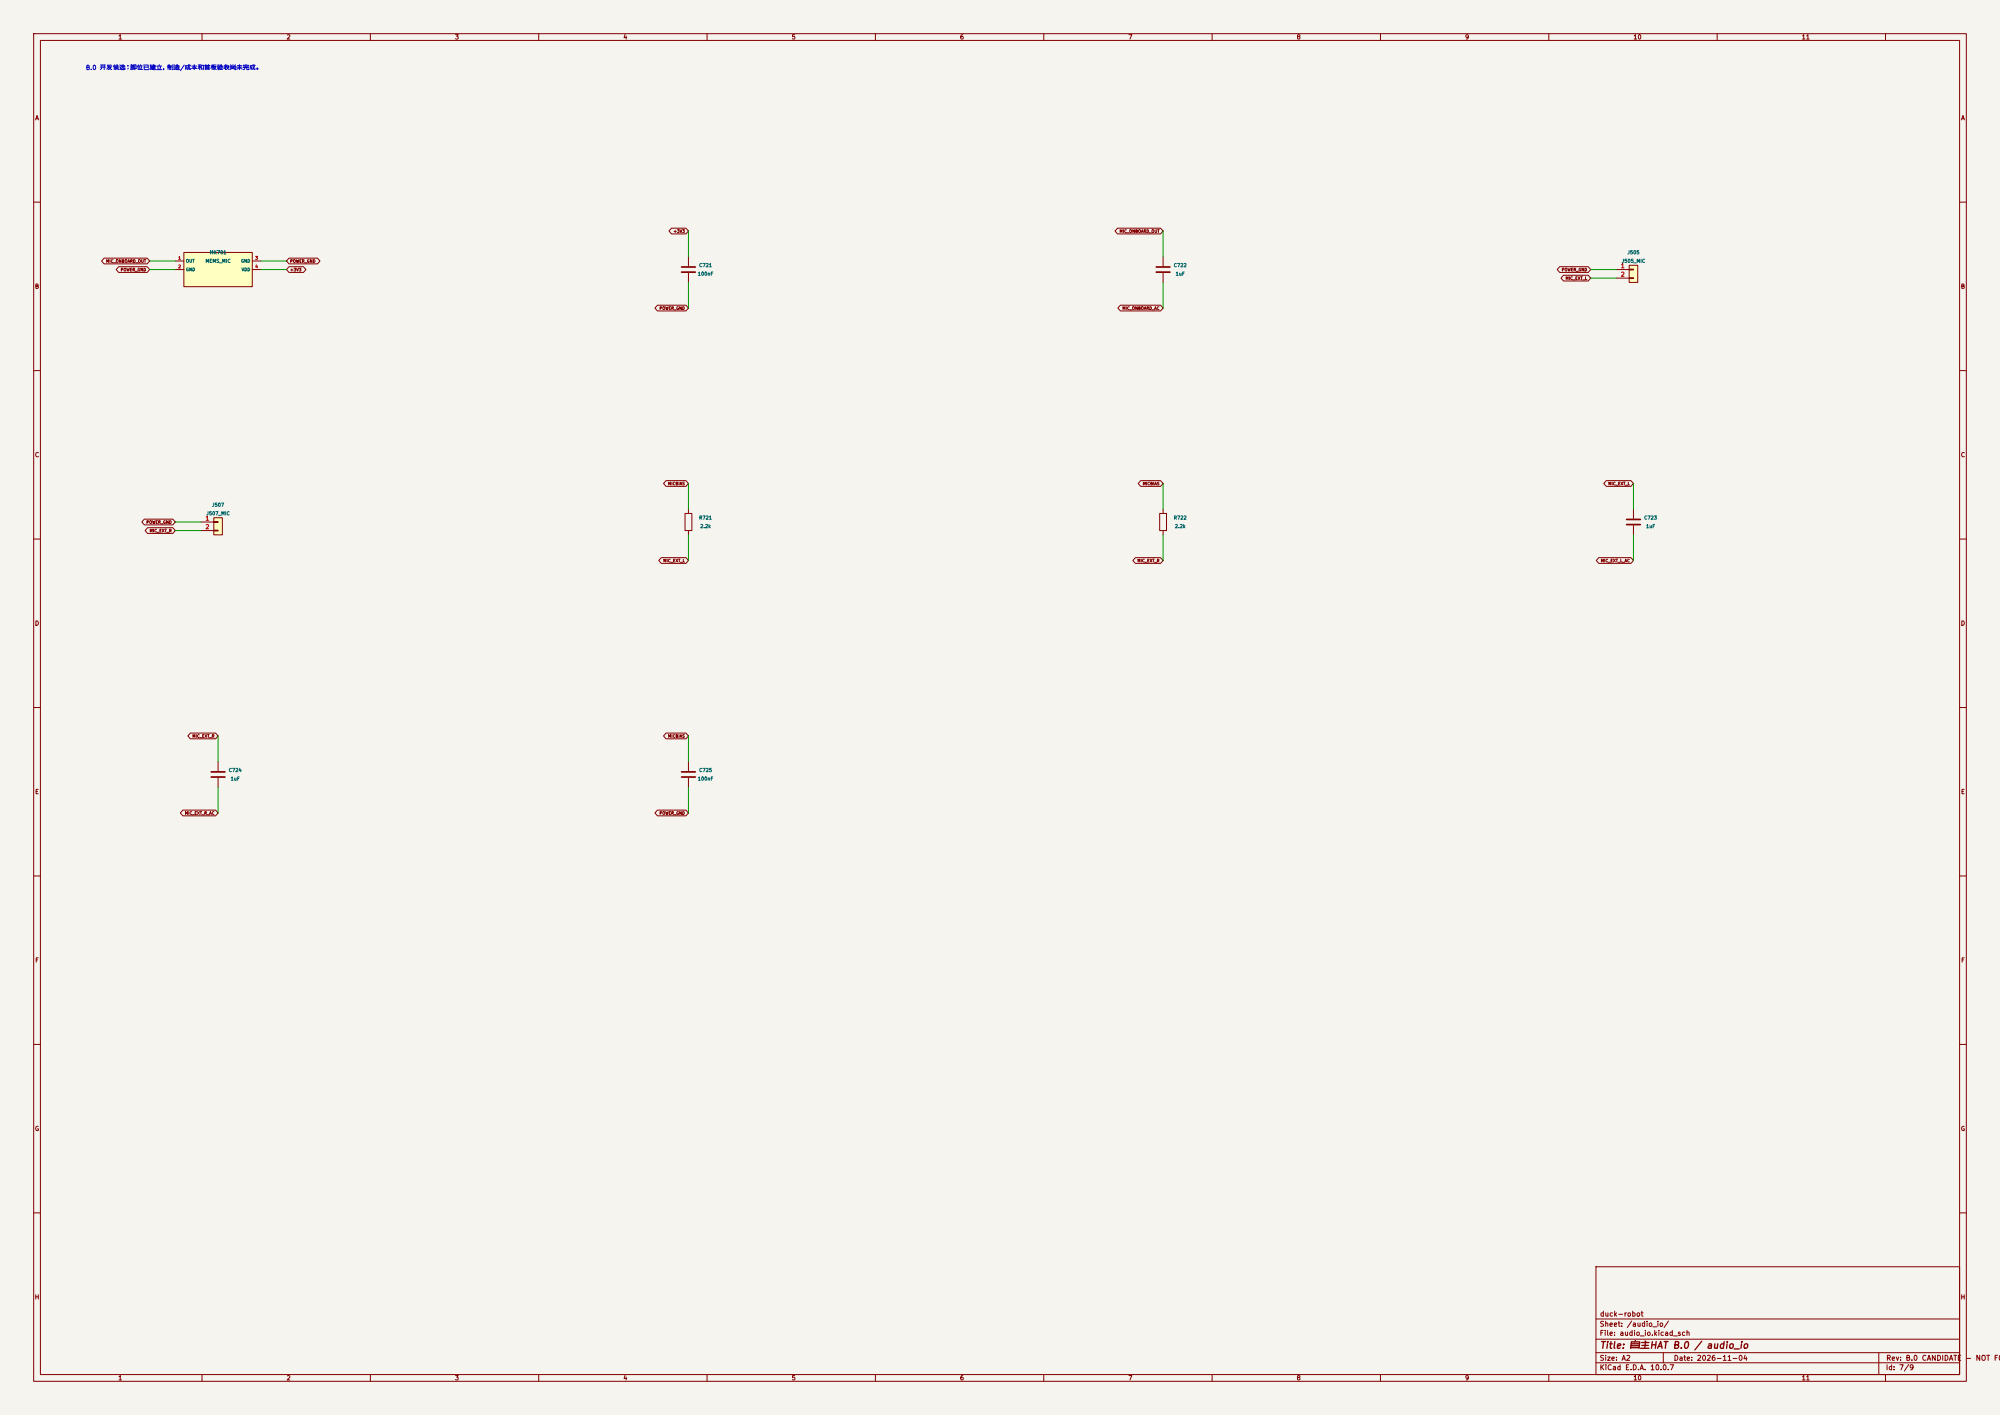
[picture p249: page 7]

B.0 开发候选；脚位已建立，制造/成本和首板验收尚未完成。

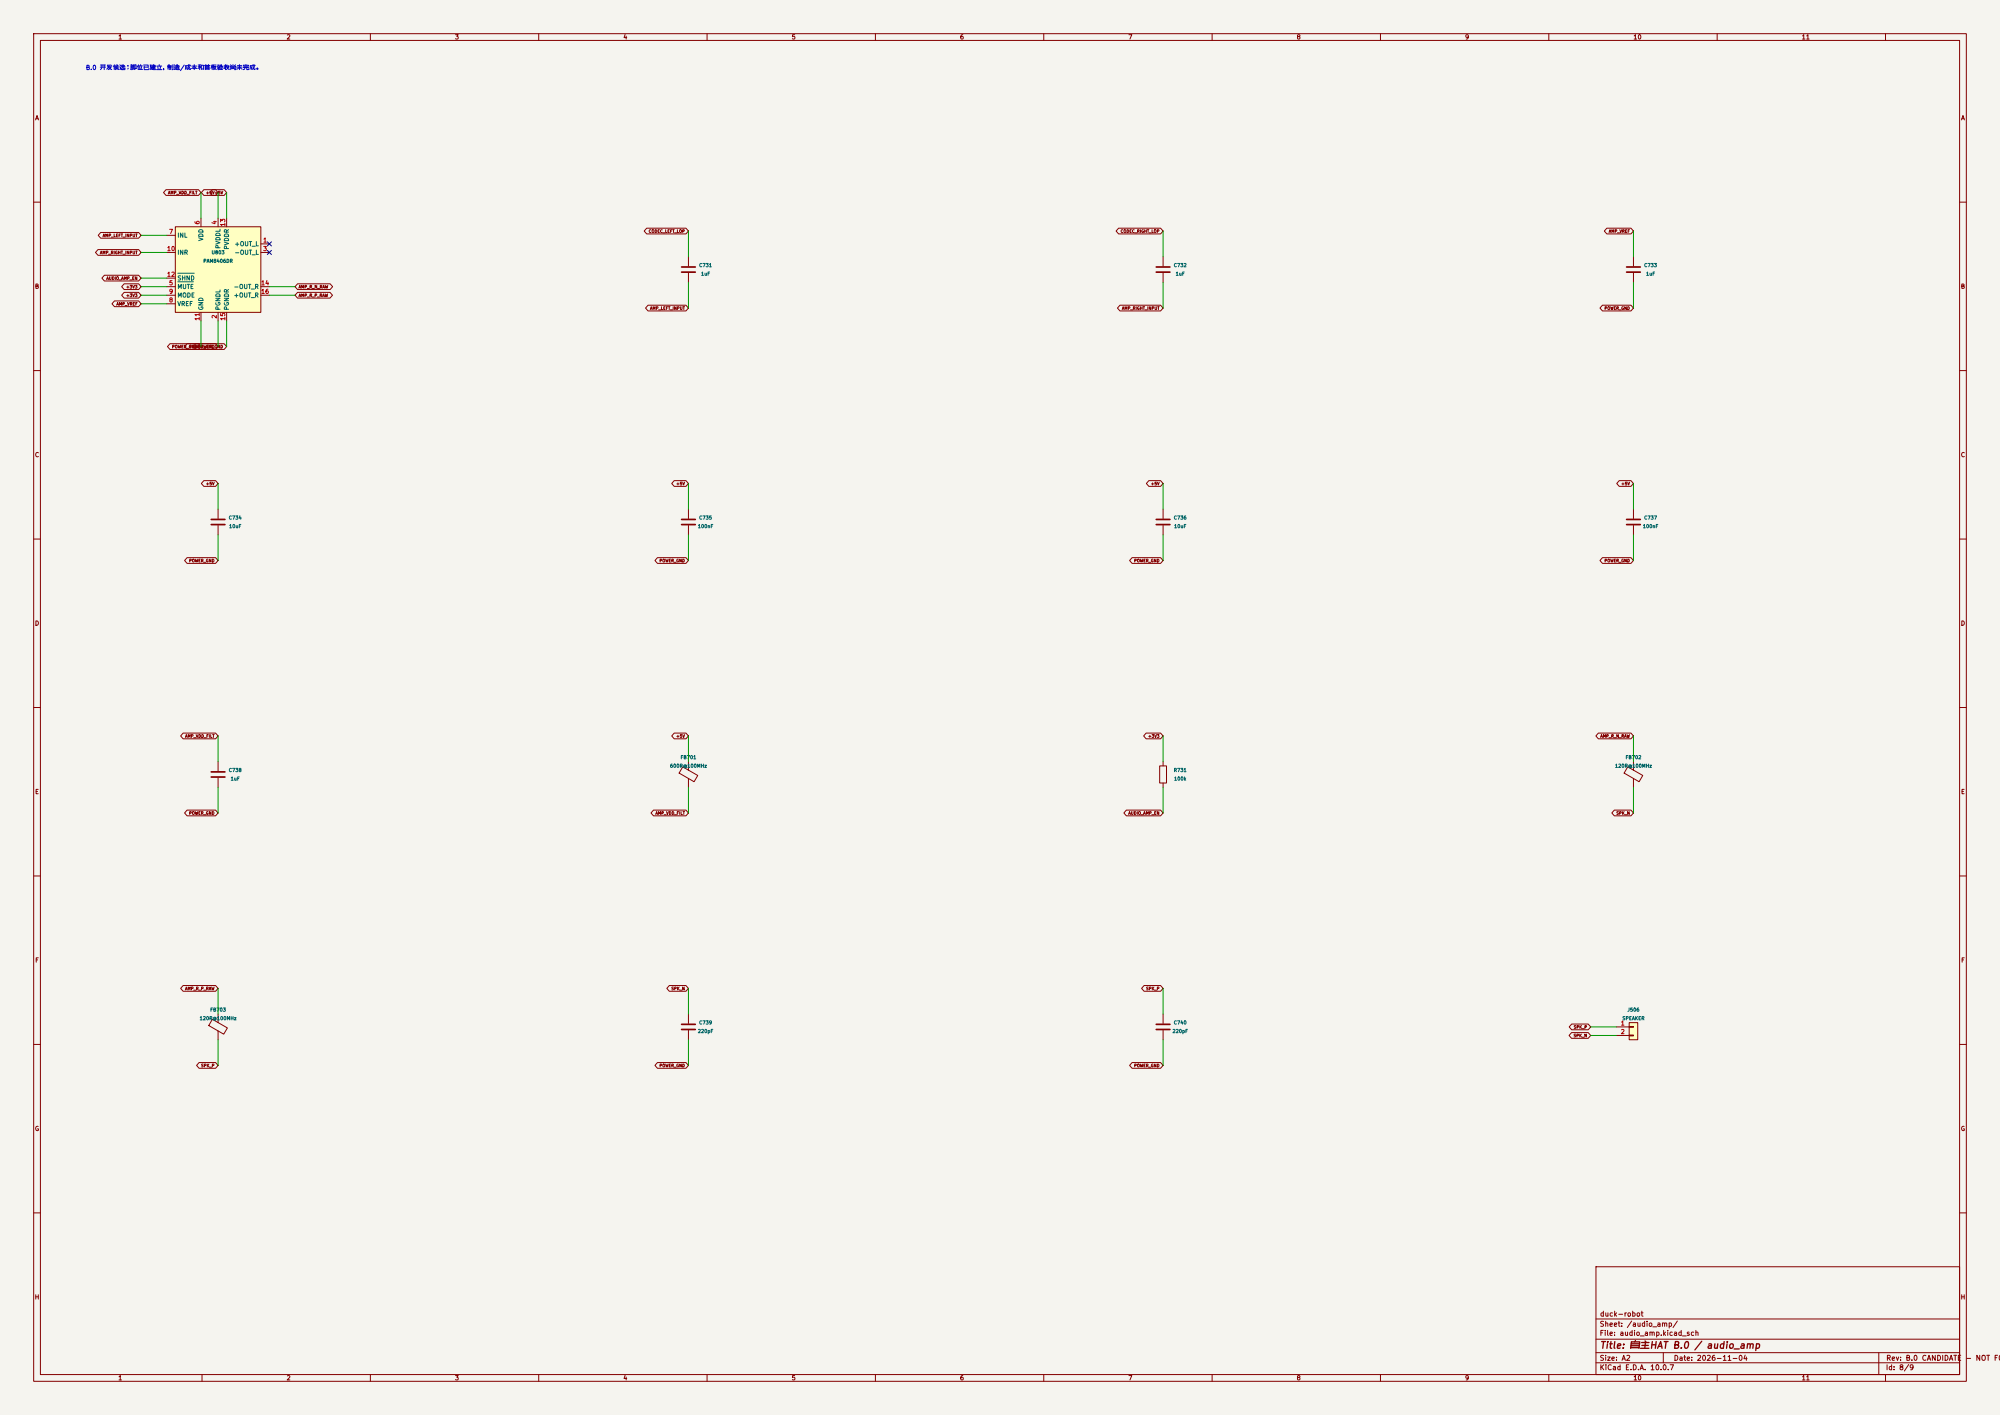
[picture p250: page 8]

B.0 开发候选；脚位已建立，制造/成本和首板验收尚未完成。

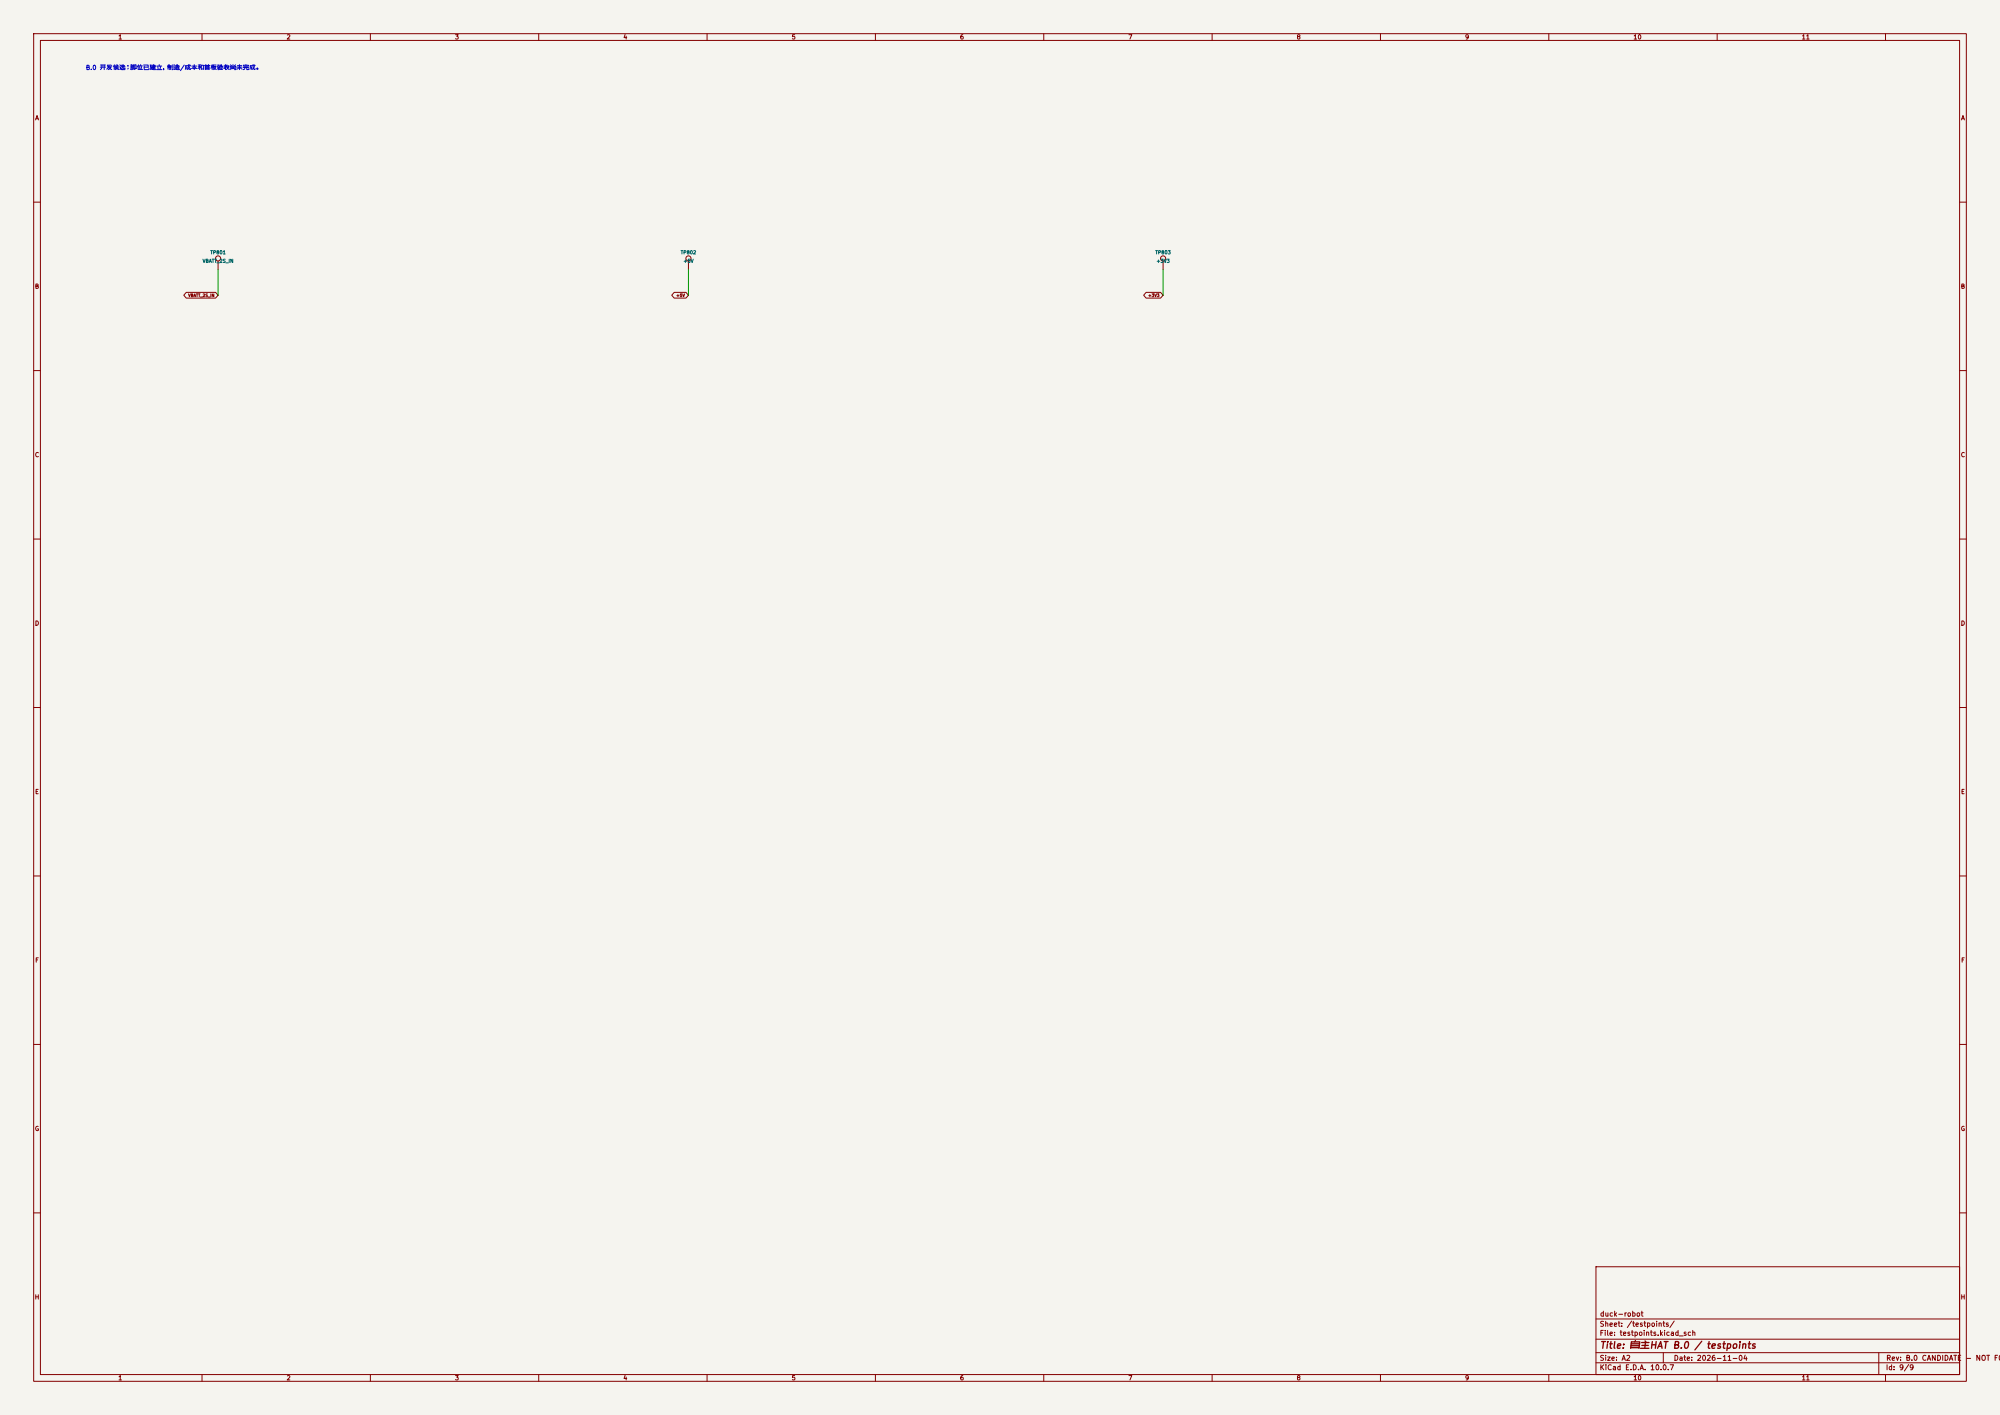
[picture p251: page 9]
