parkourlrc/pcb-yilv1982--duck-robot-89dbc81d6d/hardware/custom_hat/rev_a/rev_a.pdf

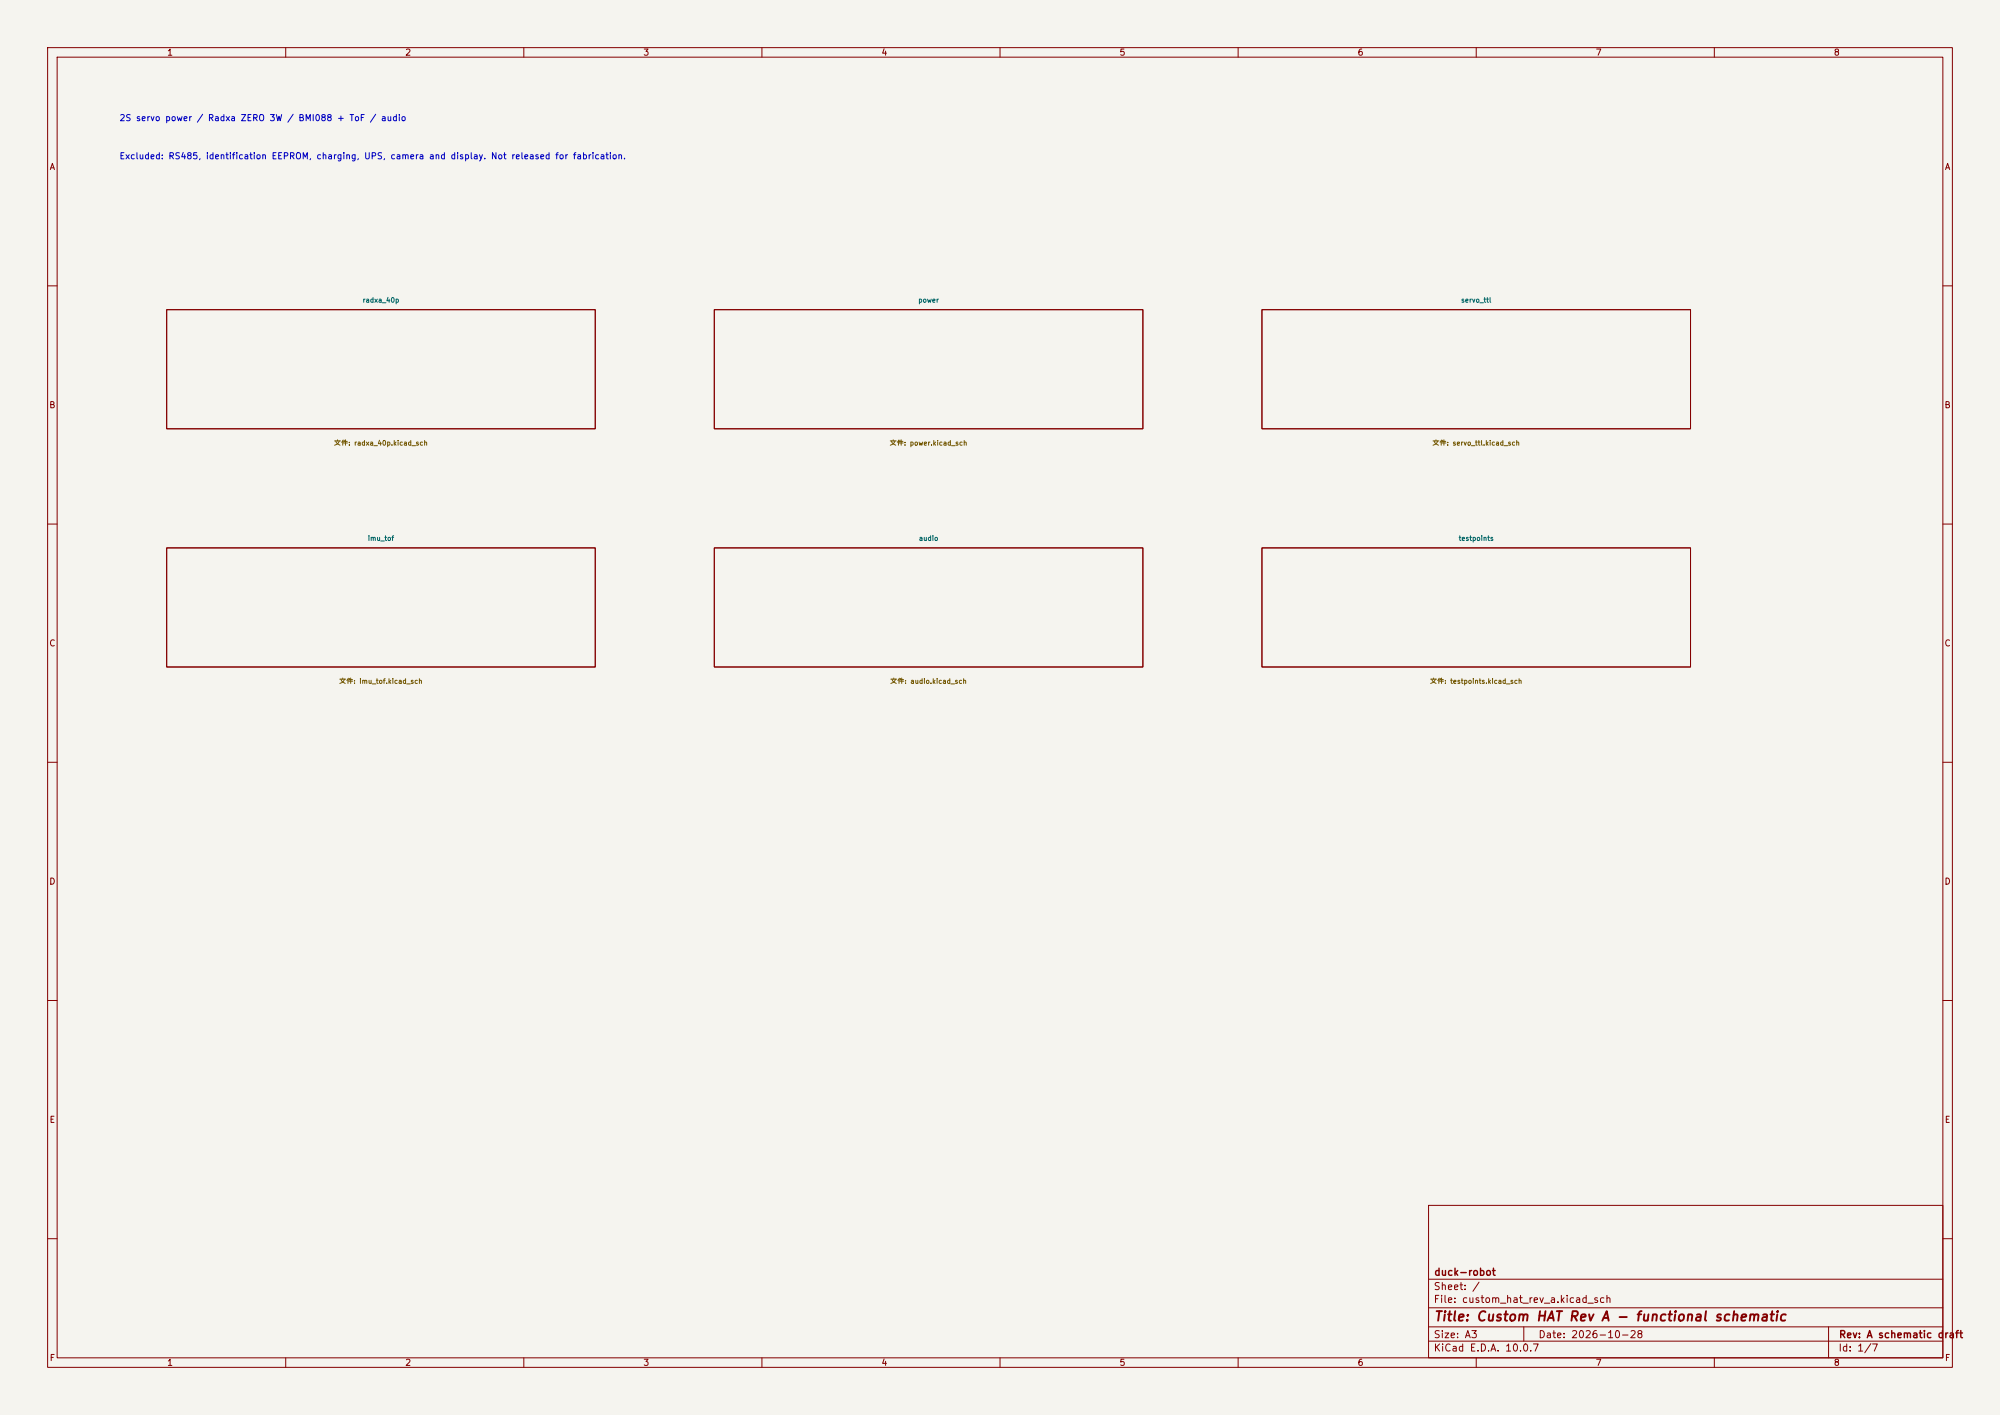
[picture p252: page 1]

2S servo power / Radxa ZERO 3W / BMI088 + ToF / audio

Excluded: RS485, identification EEPROM, charging, UPS, camera and display. Not released for fabrication.

duck-robot
Sheet: /
File: custom_hat_rev_a.kicad_sch
Title: Custom HAT Rev A - functional schematic

F Date: 2026-10-28

KiCad E.D.A. 10.0.7 | Id: 1/7

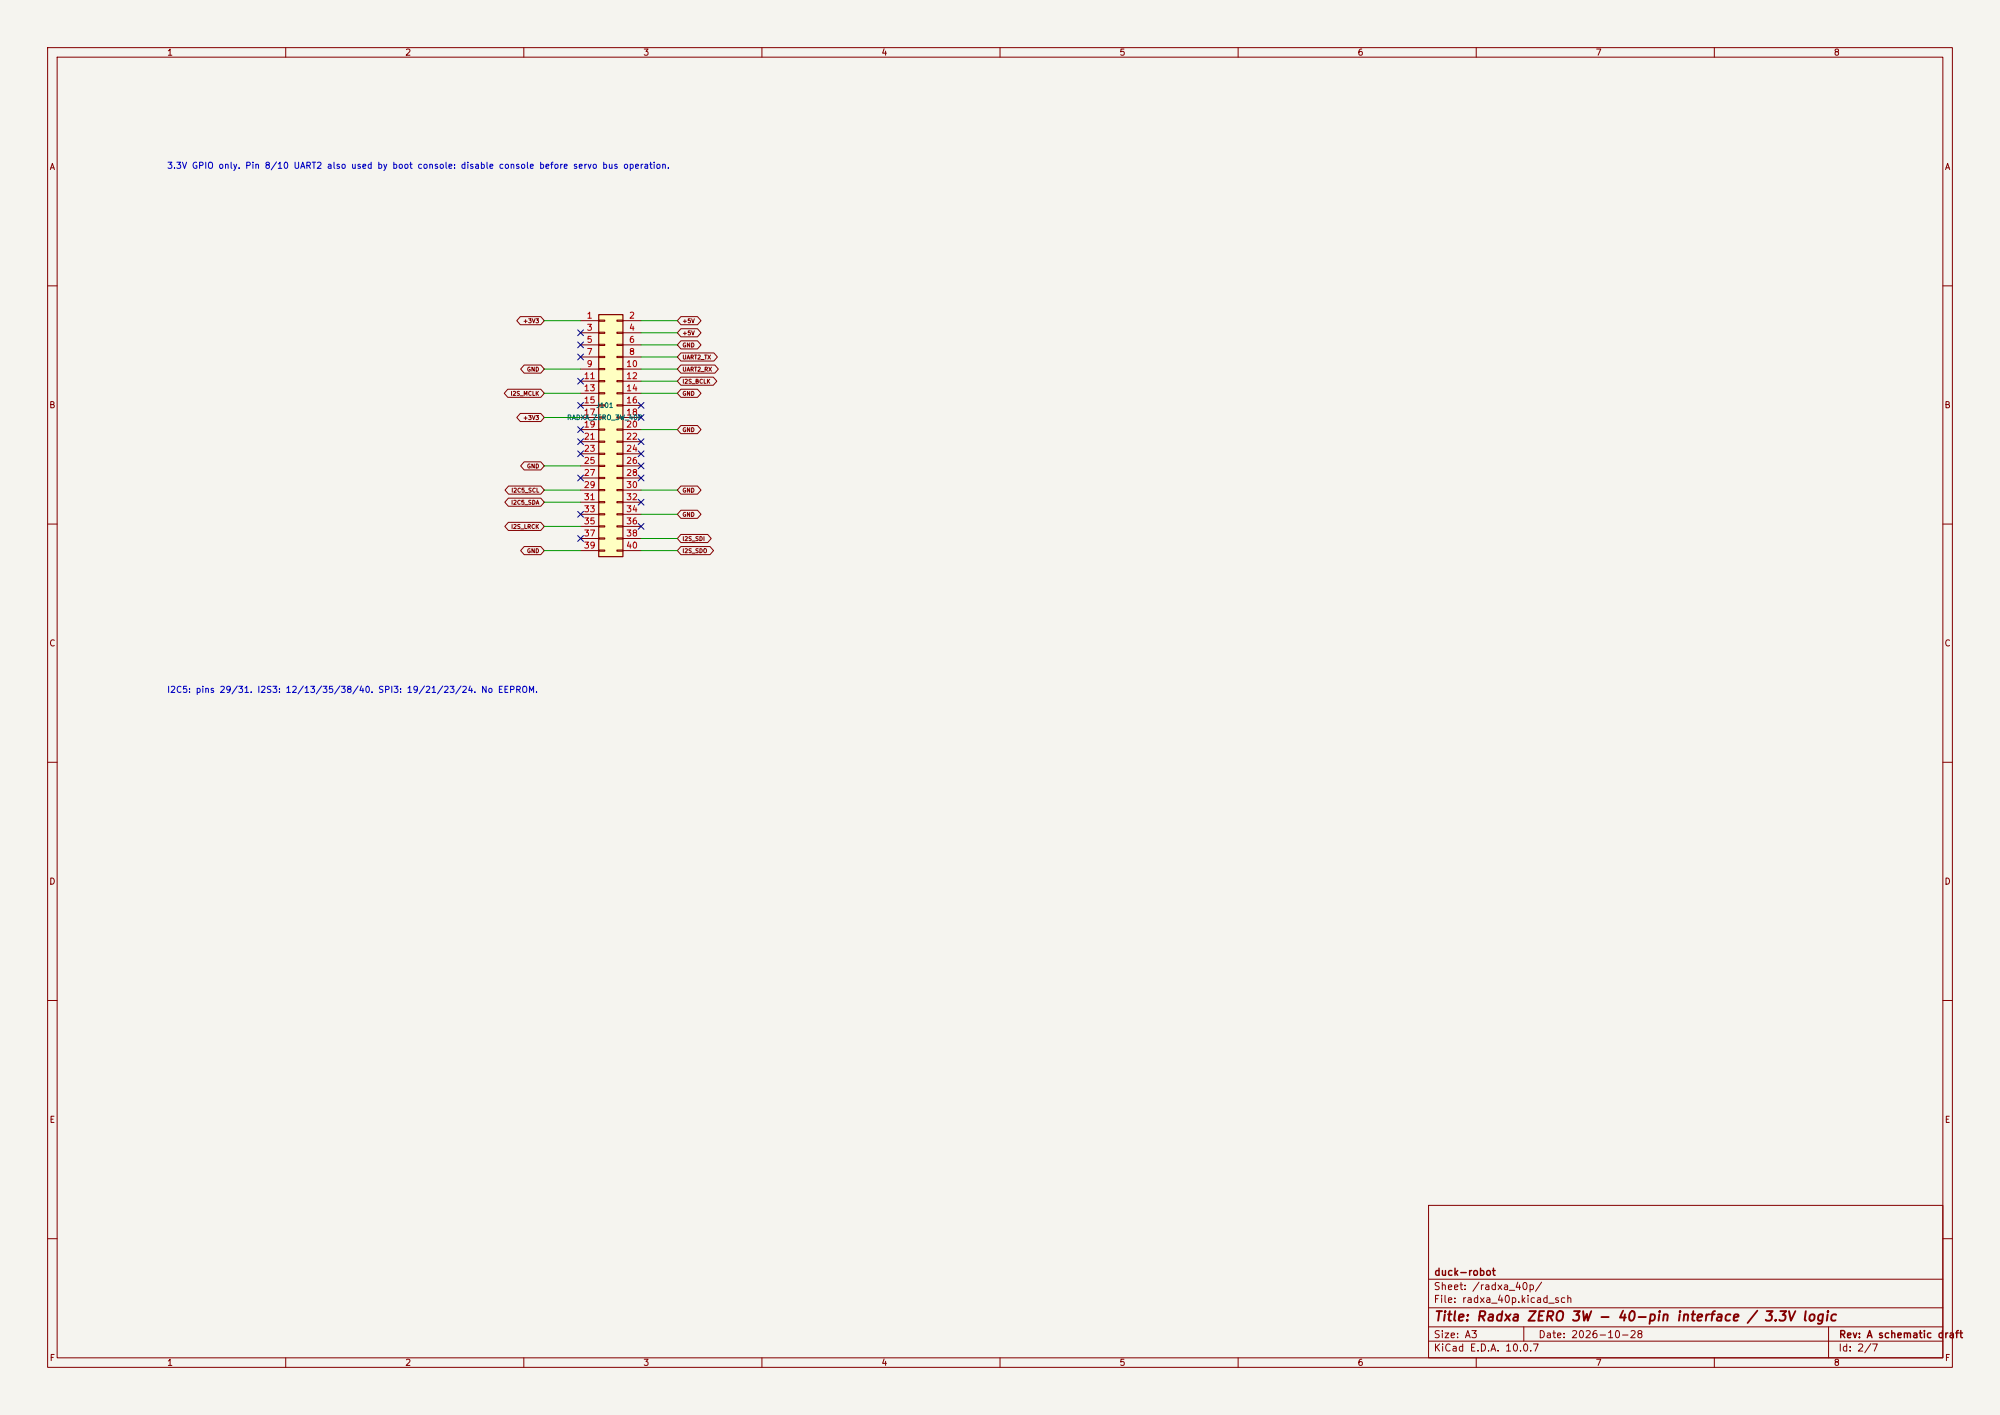
[picture p253: page 2]

GND 3.3V GPIO only. Pin 8/10 UART2 also used by boot console: disable console before servo bus operation.

duck-robot
Sheet: /radxa_40p/
File: radxa_40p.kicad_sch
Title: Radxa ZERO 3W - 40-pin interface / 3.3V logic

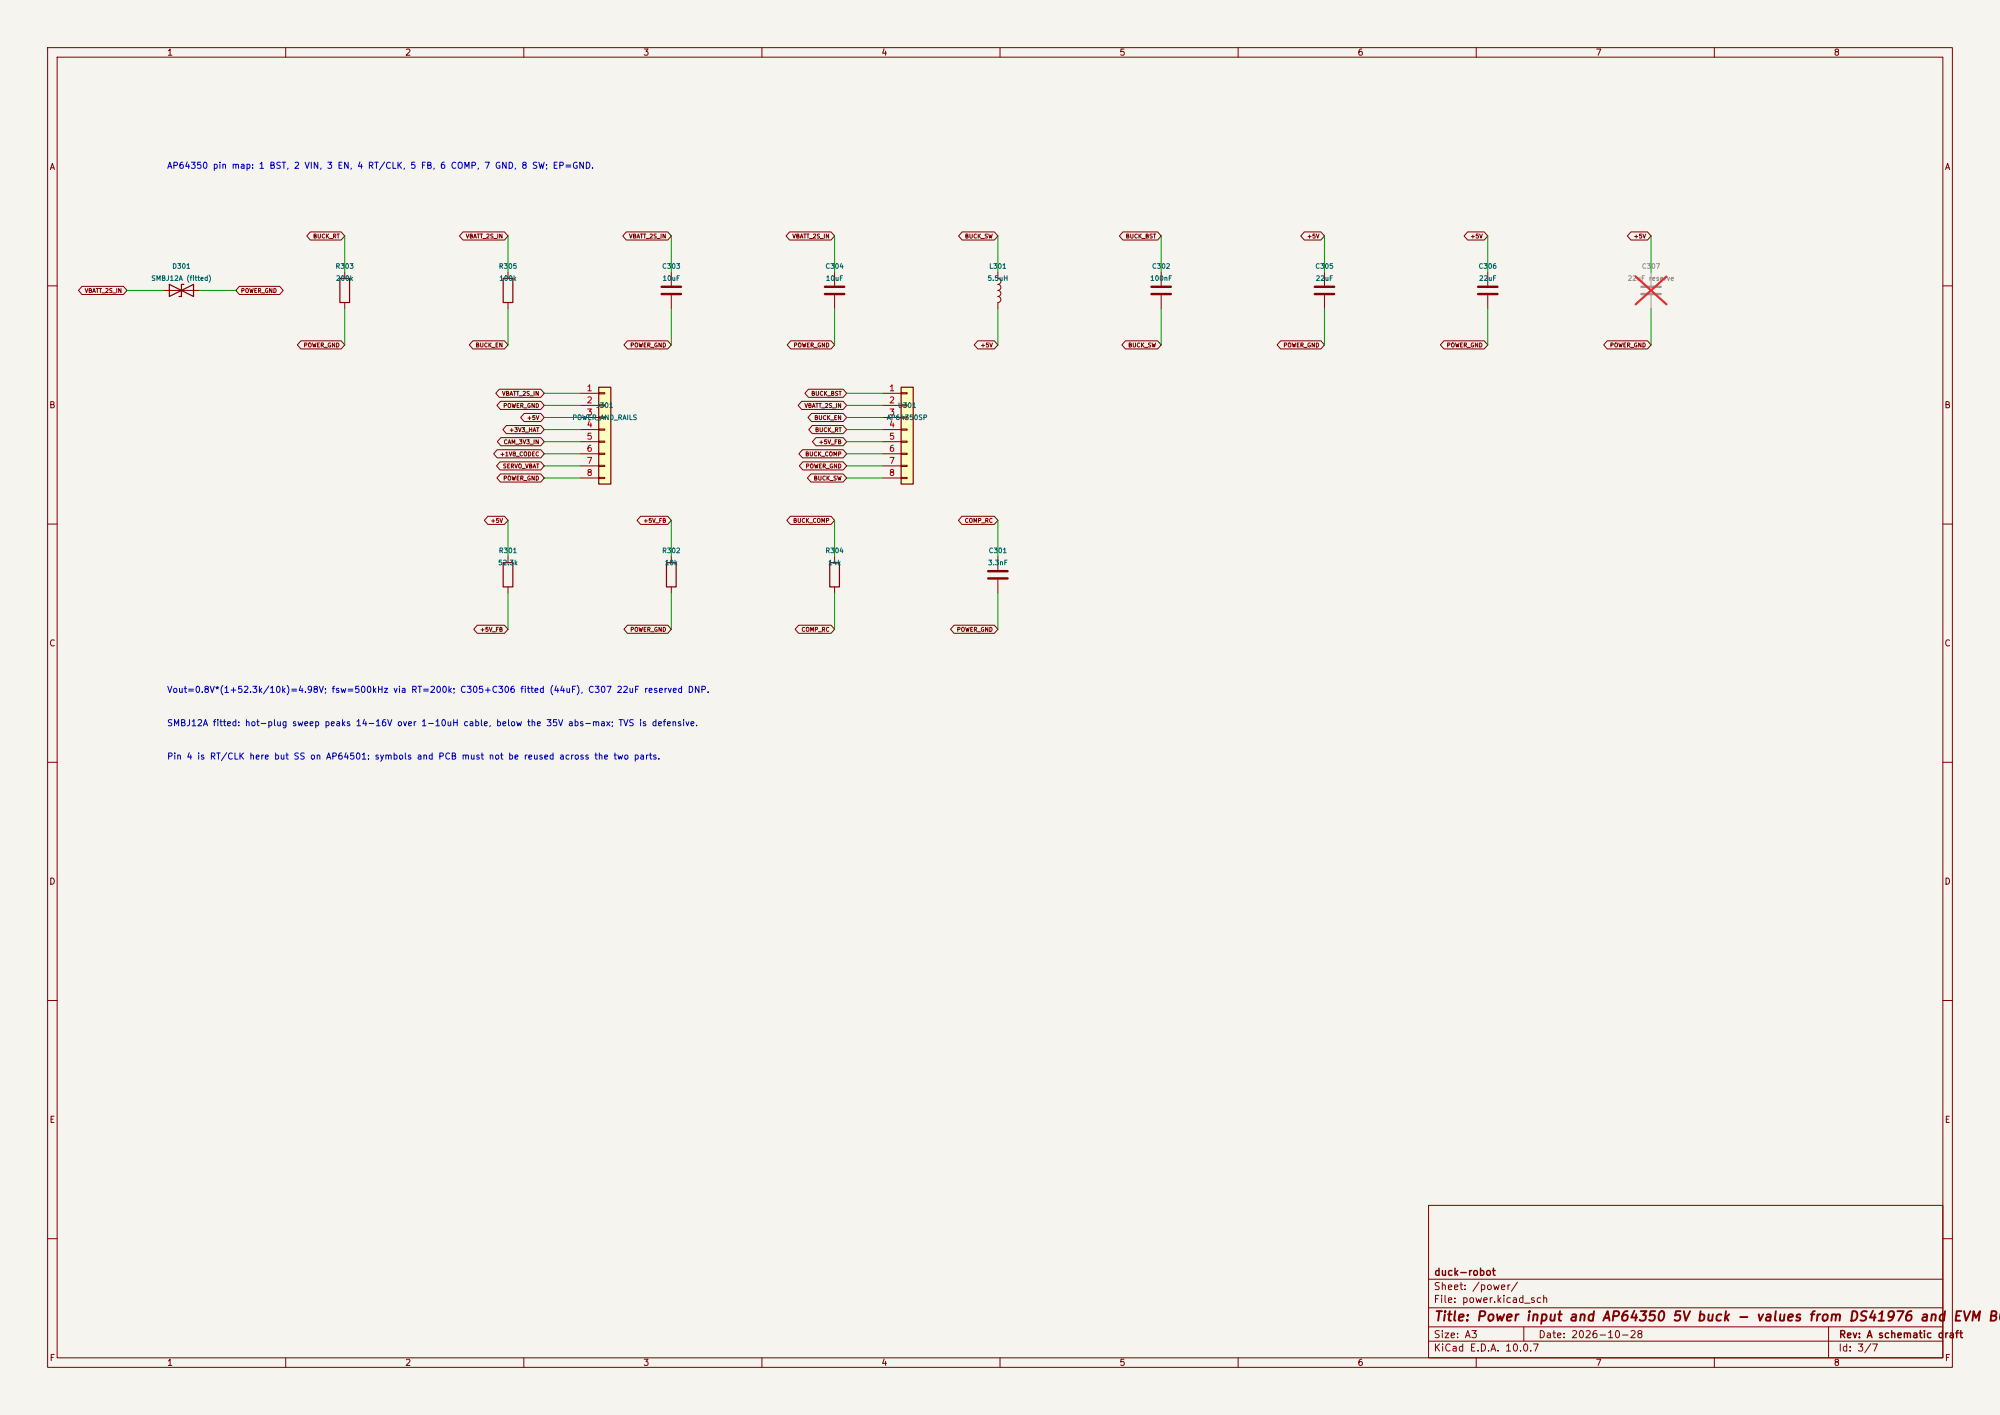
[picture p254: page 3]

Vout=0.8V*(1+52.3k/10k)=4.98V; fsw=500kHz via RT=200k; C305+C306 fitted (44uF), C307 22uF reserved DNP. SMBJ12A fitted: hot-plug sweep peaks 14-16V over 1-10uH cable, below the 35V abs-max; TVS is defensive.

duck-robot
Sheet: /power/
File: power.kicad_sch
Title: Power input and AP64350 5V buck - values from DS41976 and EVM BOM

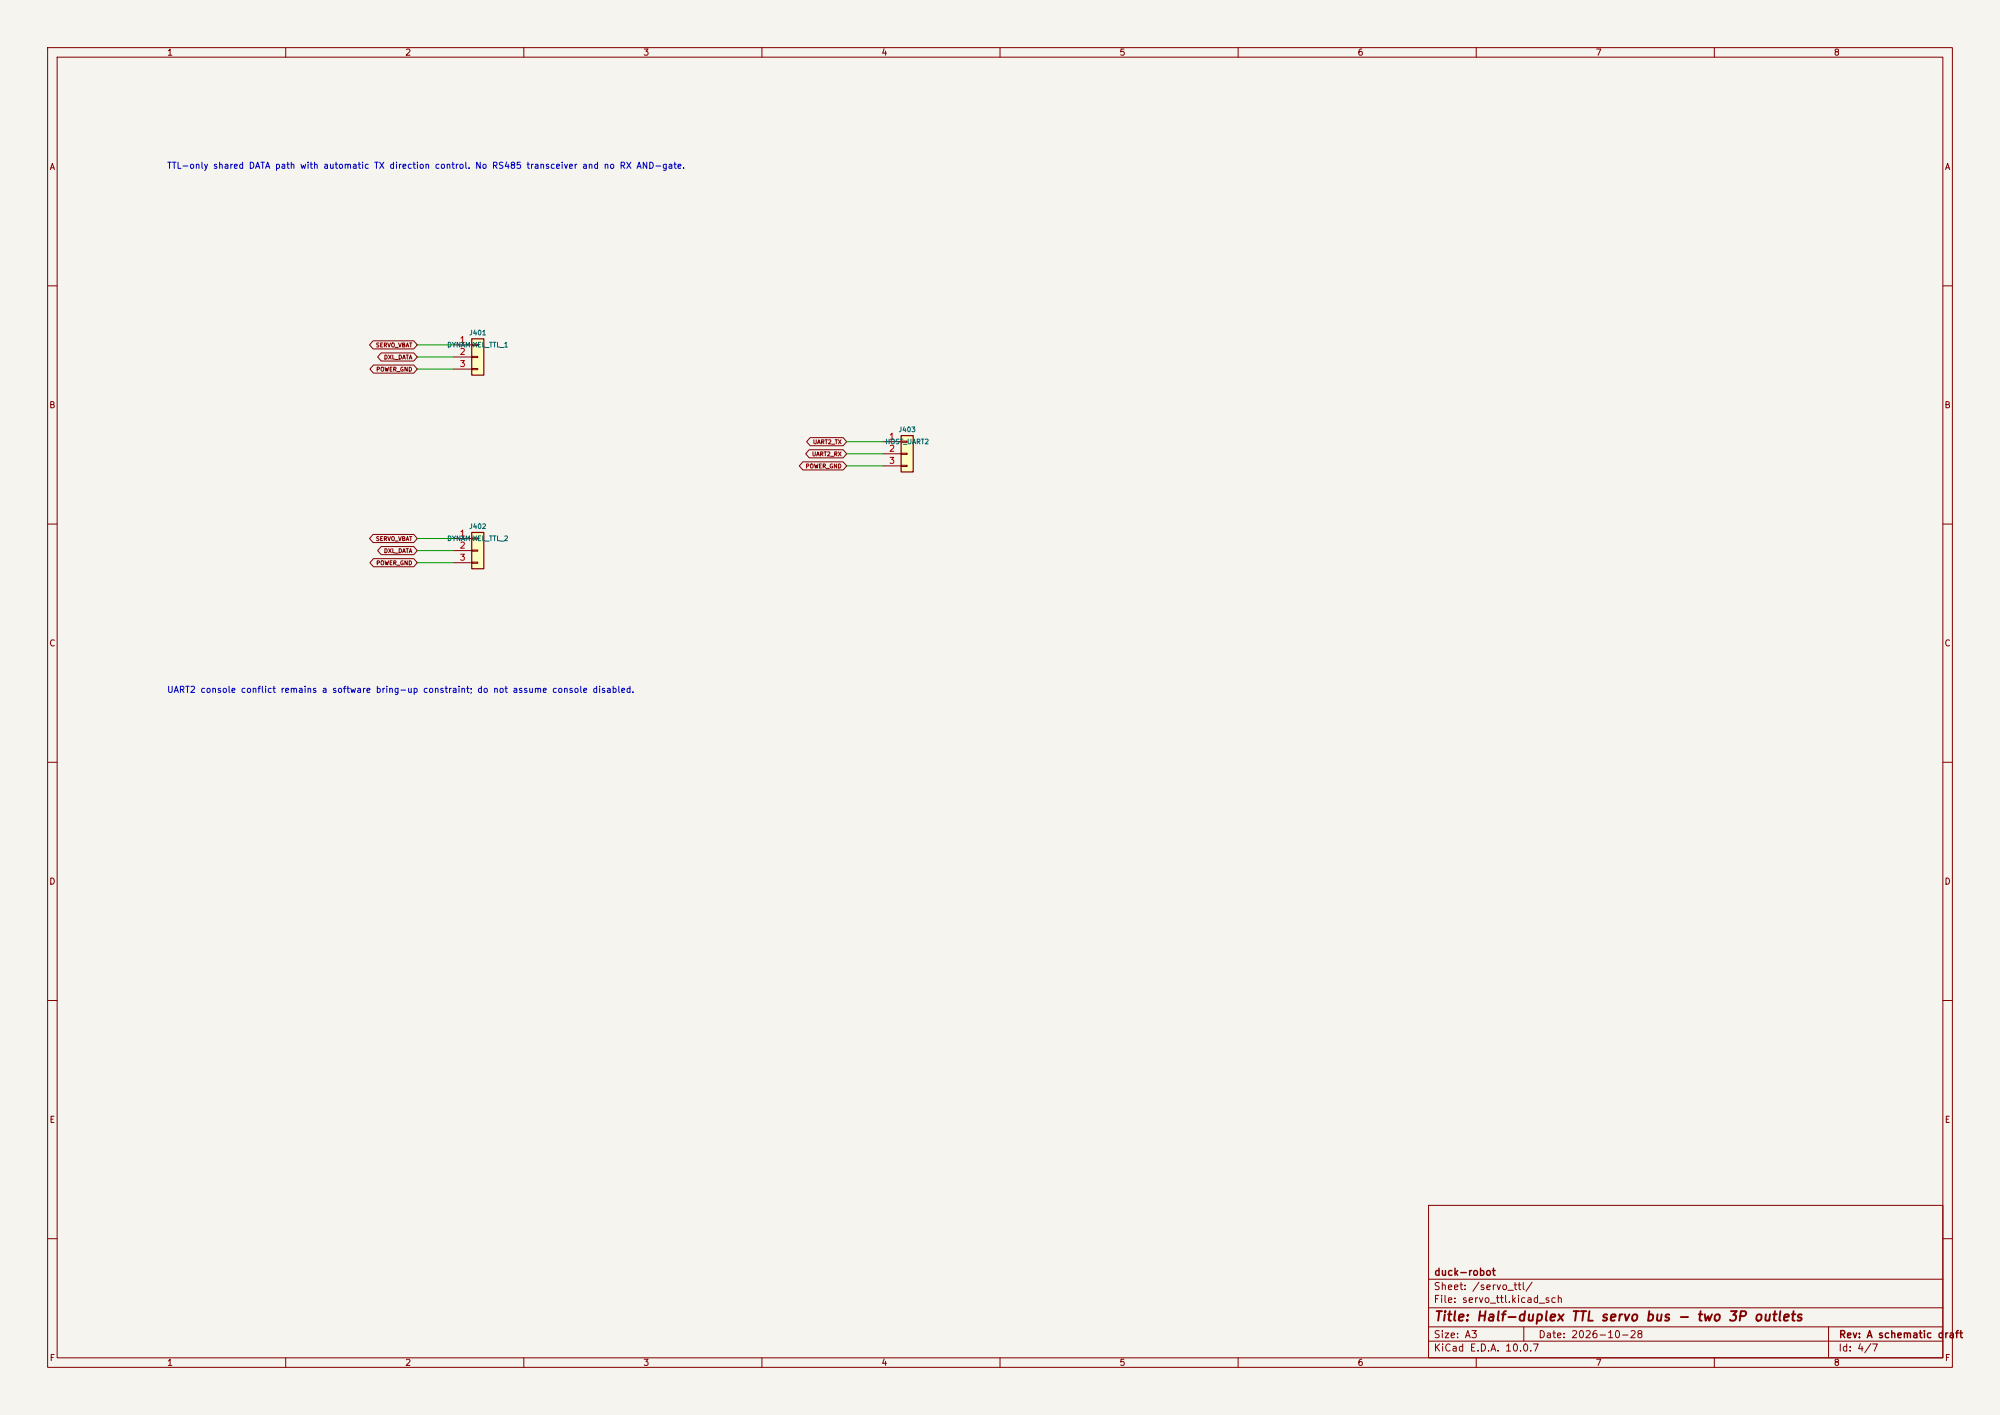
[picture p255: page 4]

duck-robot
Sheet: /servo_ttl/
File: servo_ttl.kicad_sch
Title: Half-duplex TTL servo bus - two 3P outlets

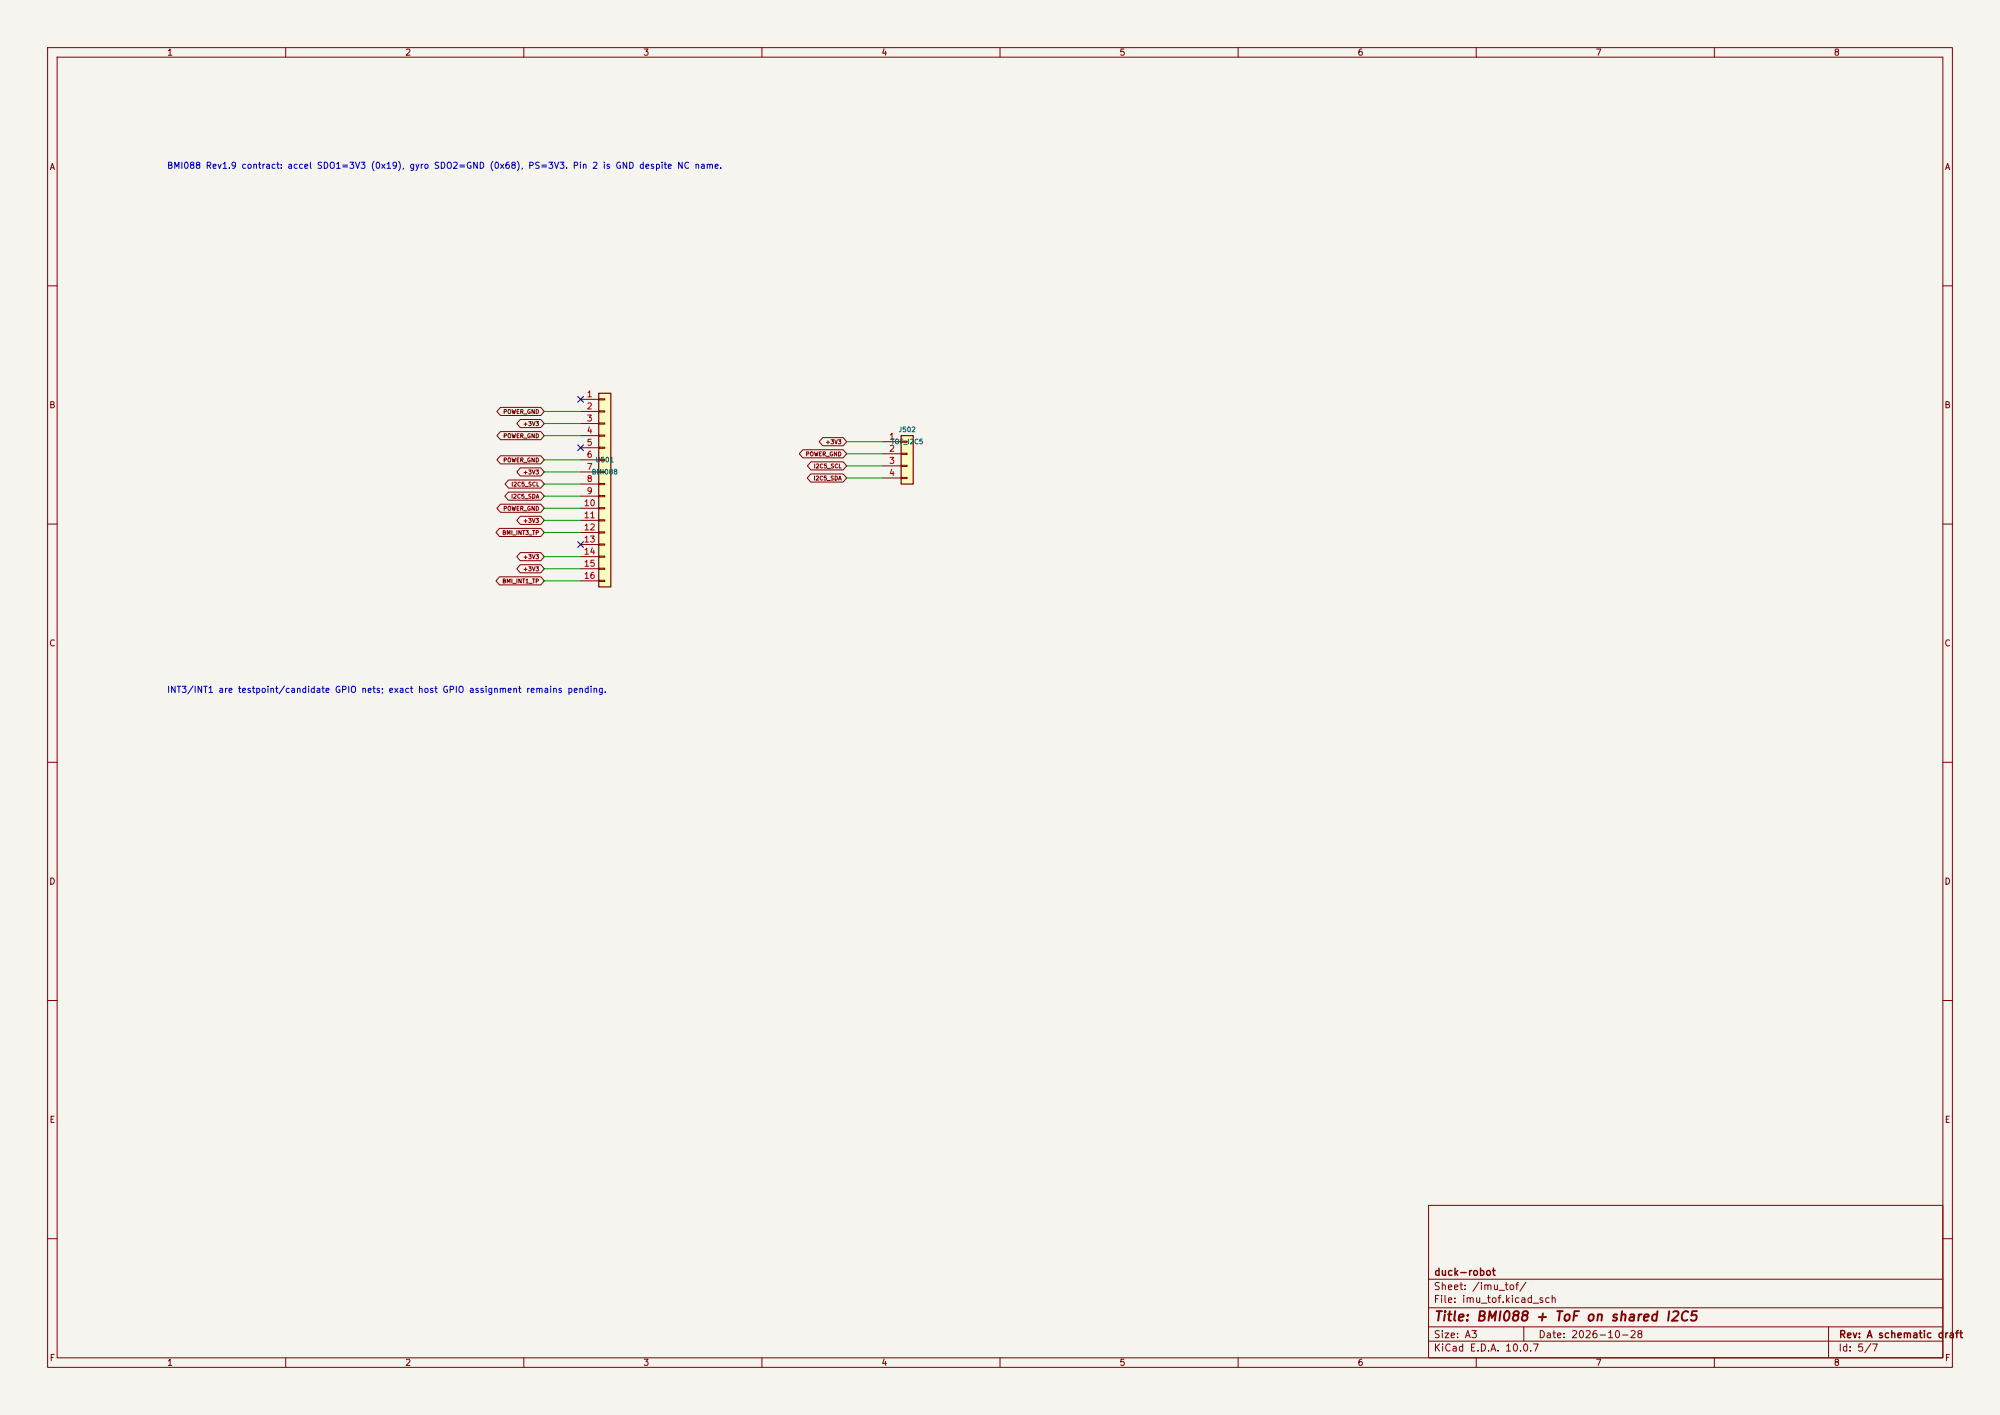
[picture p256: page 5]

I2C5_SDA BMI_INT1_TP BMI088 Rev1.9 contract: accel SDO1=3V3 (0x19), gyro SDO2=GND (0x68), PS=3V3. Pin 2 is GND despite NC name.

INT3/INT1 are testpoint/candidate GPIO nets; exact host GPIO assignment remains pending.

duck-robot
Sheet: /imu_tof/
File: imu_tof.kicad_sch
Title: BMI088 + ToF on shared I2C5

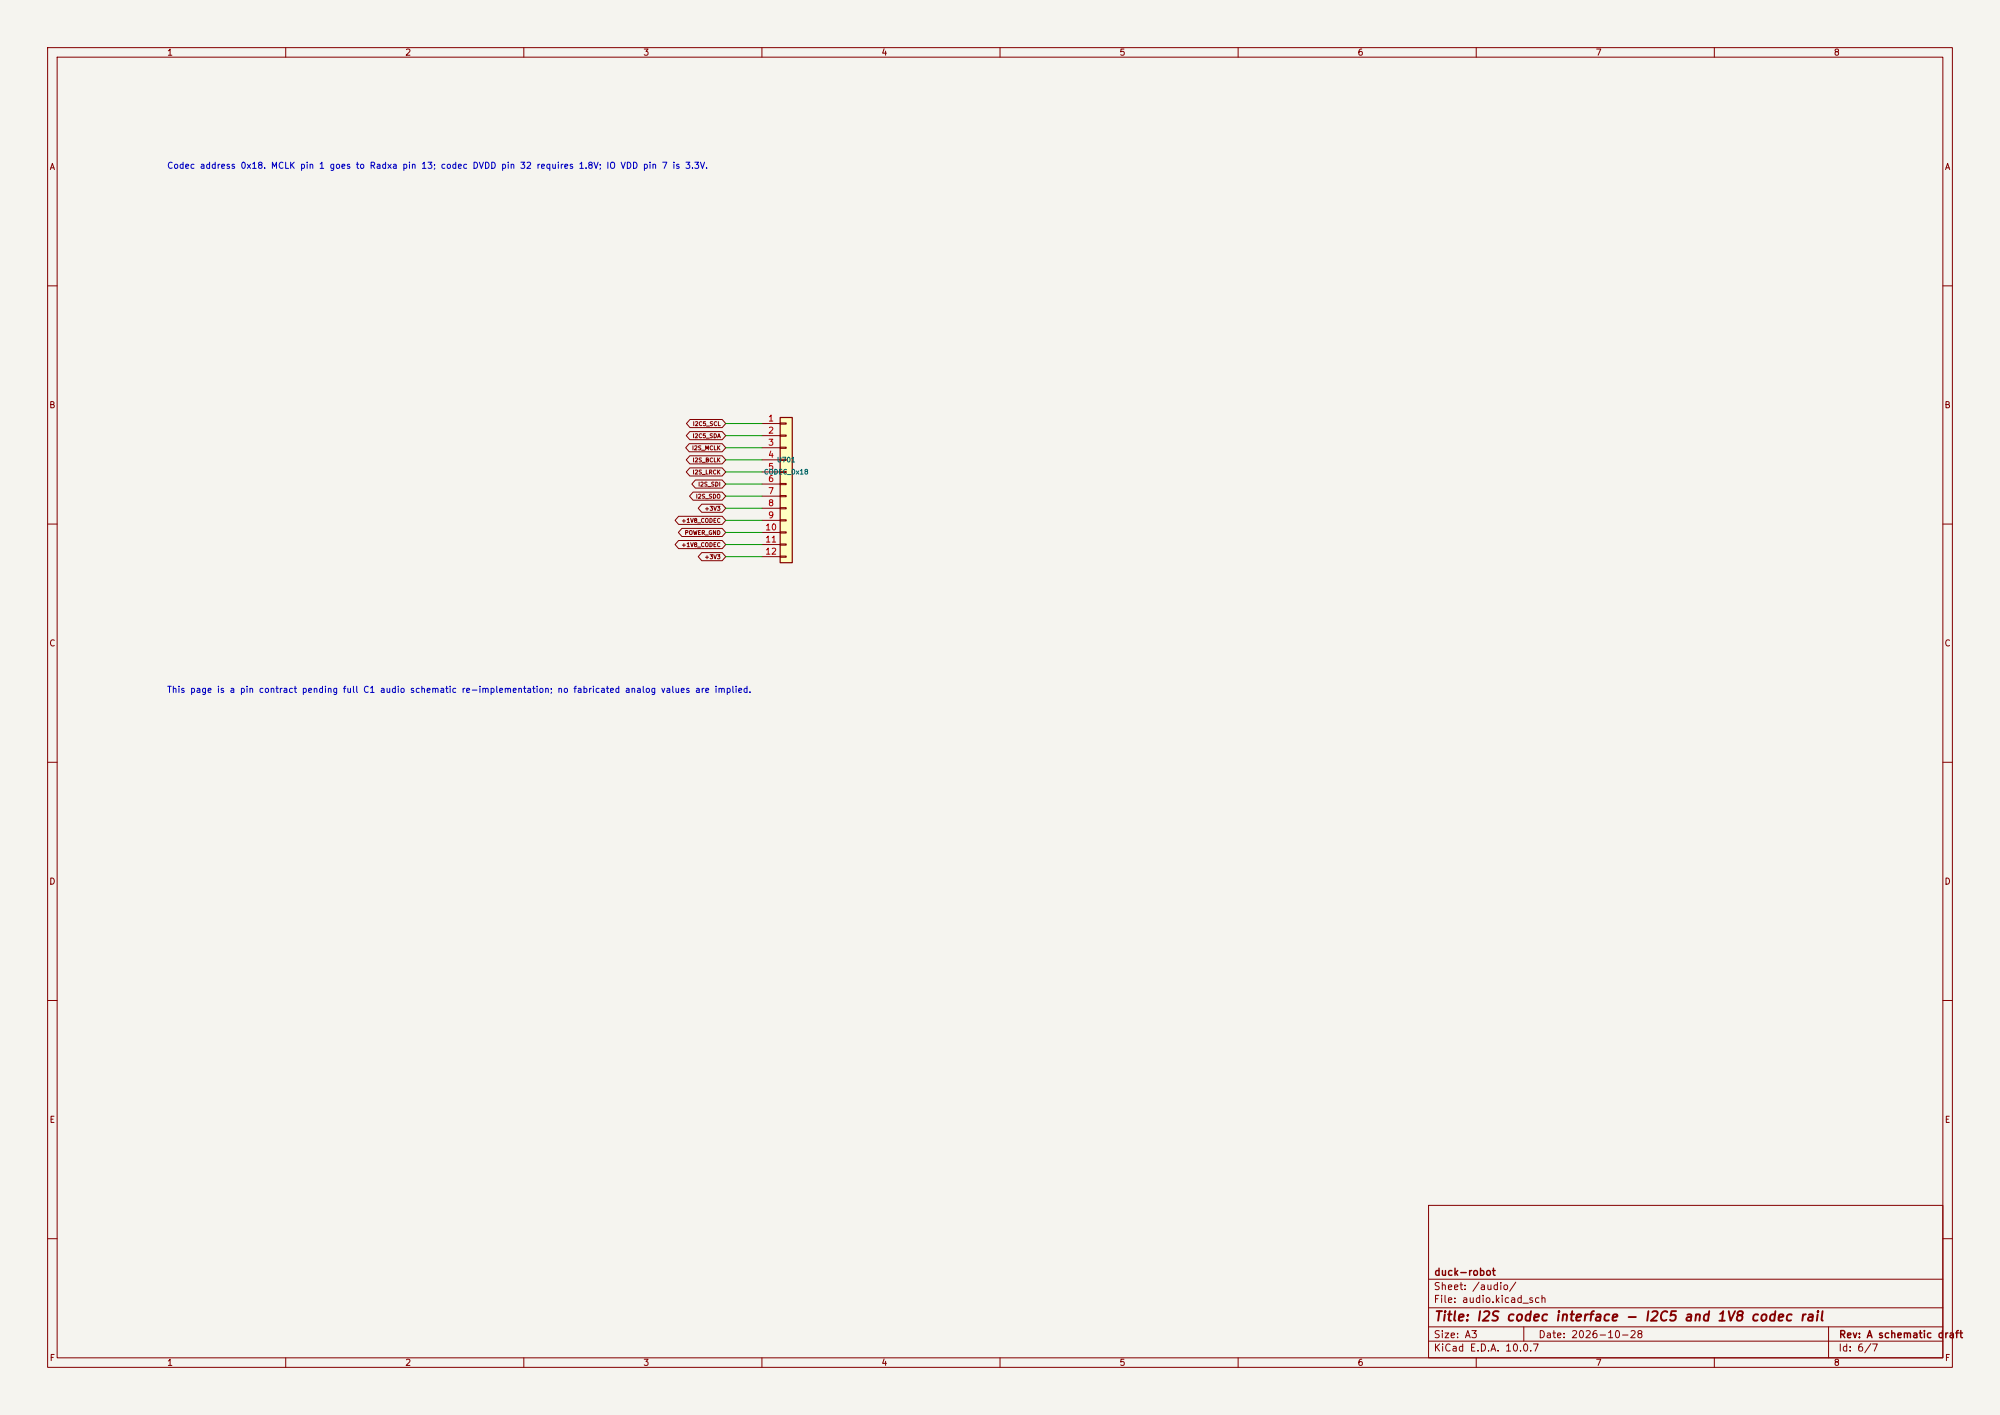
[picture p257: page 6]

POWER_GND +1V8_CODEC +3V3 Codec address 0x18. MCLK pin 1 goes to Radxa pin 13; codec DVDD pin 32 requires 1.8V; IO VDD pin 7 is 3.3V.

This page is a pin contract pending full C1 audio schematic re-implementation; no fabricated analog values are implied.

duck-robot
Sheet: /audio/
File: audio.kicad_sch
Title: I2S codec interface - I2C5 and 1V8 codec rail

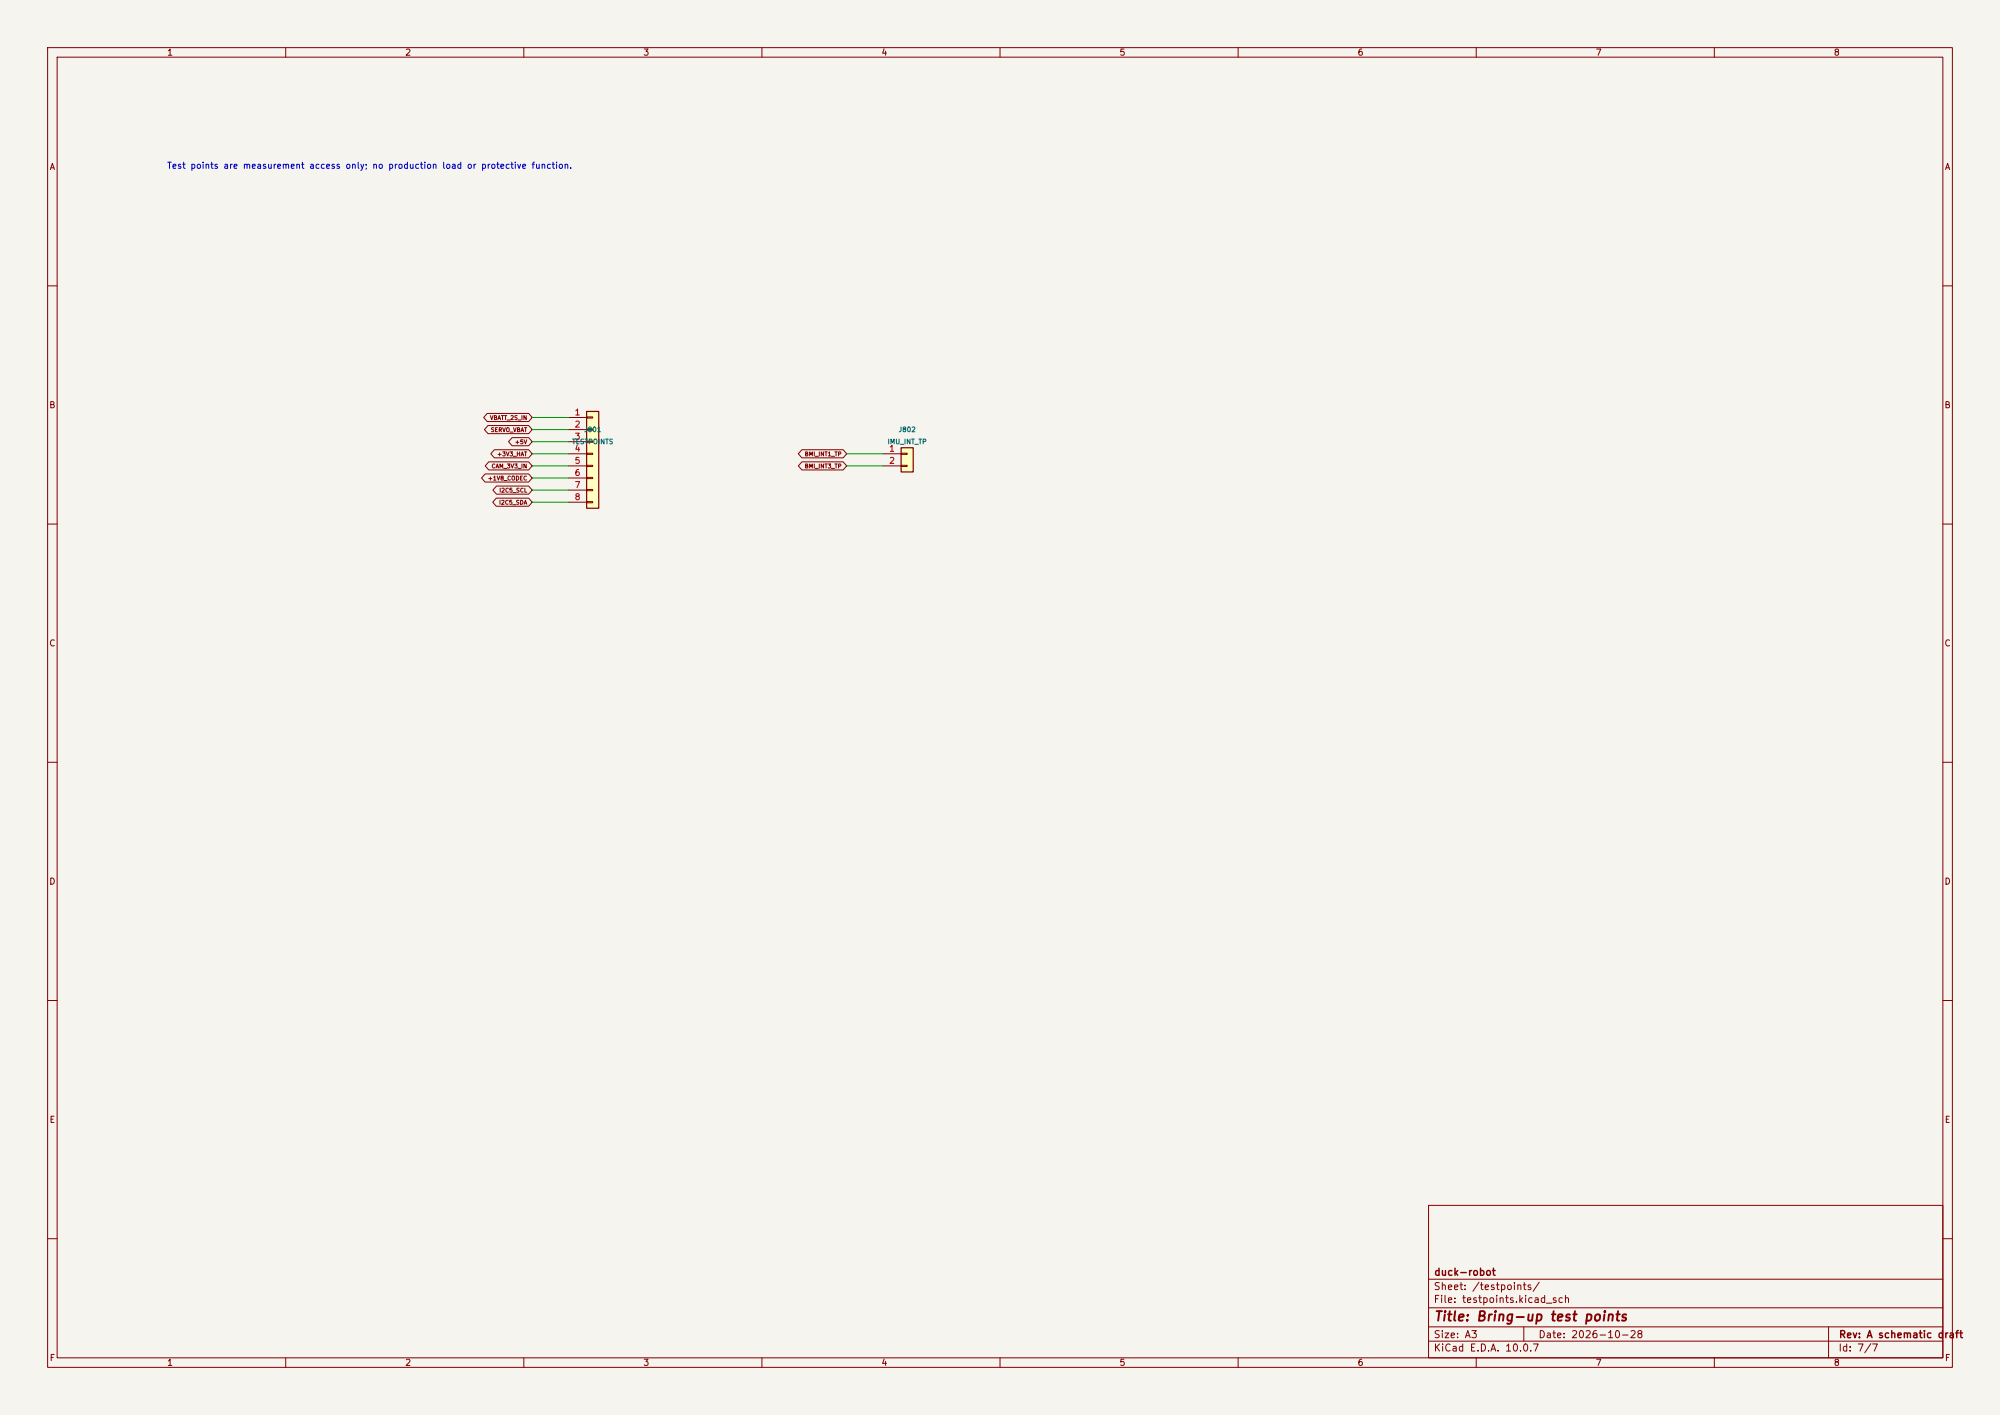
[picture p258: page 7]

Test points are measurement access only; no production load or protective function.

duck-robot
Sheet: /testpoints/
File: testpoints.kicad_sch
Title: Bring-up test points
