parkourlrc/pcb-yilv1982--duck-robot-89dbc81d6d/hardware/custom_hat/rev_a/rev_a_pcb.pdf

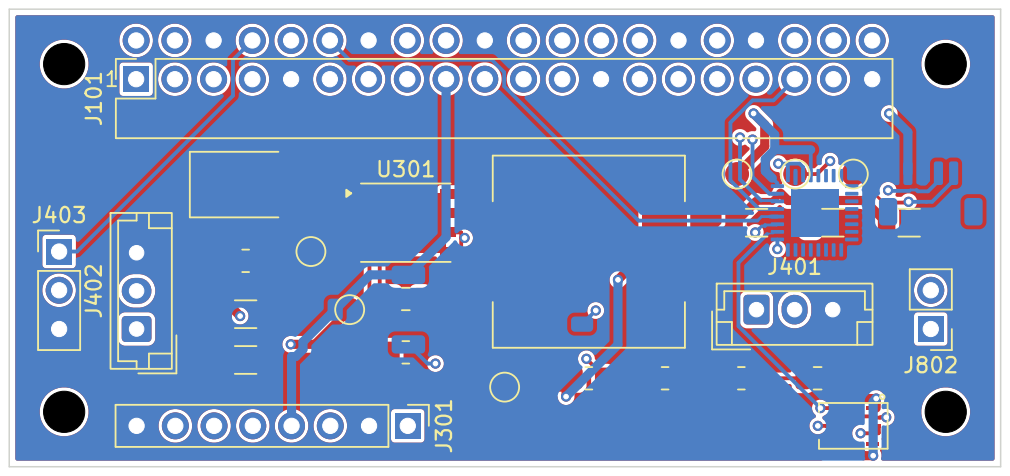
[picture p259: page 1]
