parkourlrc/pcb-yilv1982--duck-robot-89dbc81d6d/docs/references/扩展板电路仿真工具/metadata-repair-20261030/spice-work-utf8/decoupling_C305_C306_C323.cir

* Auto-generated testbench for decoupling analysis: +5V rail
* 3 capacitor(s) in parallel, series R-L-C model
* Model: ESR/ESL from pdn_impedance (package-based)

R_esr_C305 rail n_esr_0 6.4m
L_par_C305 n_esr_0 n_lpar_0 1.1n
C305 n_lpar_0 0 22u
R_esr_C306 rail n_esr_1 6.4m
L_par_C306 n_esr_1 n_lpar_1 1.1n
C306 n_lpar_1 0 22u
R_esr_C323 rail n_esr_2 15.8m
L_par_C323 n_esr_2 n_lpar_2 900p
C323 n_lpar_2 0 10u

* 1A AC current source into the rail node — V(rail) = Z(f)
IAC 0 rail DC 0 AC 1

.control
ac dec 200 100 100Meg
let z_mag = vm(rail)
meas ac z_min min z_mag
meas ac f_at_zmin when z_mag=z_min
meas ac z_at_1M find vm(rail) at=1Meg
meas ac z_at_100k find vm(rail) at=100k
echo "z_min=$&z_min f_at_zmin=$&f_at_zmin z_at_1M=$&z_at_1M z_at_100k=$&z_at_100k n_caps=3" > docs/references/hat-simulation-tools-20261029/metadata-repair-20261030/spice-work-utf8/decoupling_C305_C306_C323.out
quit
.endc

.end
