parkourlrc/pcb-yilv1982--duck-robot-89dbc81d6d/docs/references/扩展板电路仿真工具/metadata-repair-20261030/spice-work-utf8/decoupling_C308_C319_C320_C312_C313.cir

* Auto-generated testbench for decoupling analysis: +3V3 rail
* 6 capacitor(s) in parallel, series R-L-C model
* Model: ESR/ESL from pdn_impedance (package-based)

R_esr_C308 rail n_esr_0 50m
L_par_C308 n_esr_0 n_lpar_0 900p
C308 n_lpar_0 0 1u
R_esr_C319 rail n_esr_1 948.7m
L_par_C319 n_esr_1 n_lpar_1 500p
C319 n_lpar_1 0 100n
R_esr_C320 rail n_esr_2 948.7m
L_par_C320 n_esr_2 n_lpar_2 500p
C320 n_lpar_2 0 100n
R_esr_C312 rail n_esr_3 948.7m
L_par_C312 n_esr_3 n_lpar_3 500p
C312 n_lpar_3 0 100n
R_esr_C313 rail n_esr_4 300m
L_par_C313 n_esr_4 n_lpar_4 500p
C313 n_lpar_4 0 1u
R_esr_C315 rail n_esr_5 300m
L_par_C315 n_esr_5 n_lpar_5 500p
C315 n_lpar_5 0 1u

* 1A AC current source into the rail node — V(rail) = Z(f)
IAC 0 rail DC 0 AC 1

.control
ac dec 200 100 100Meg
let z_mag = vm(rail)
meas ac z_min min z_mag
meas ac f_at_zmin when z_mag=z_min
meas ac z_at_1M find vm(rail) at=1Meg
meas ac z_at_100k find vm(rail) at=100k
echo "z_min=$&z_min f_at_zmin=$&f_at_zmin z_at_1M=$&z_at_1M z_at_100k=$&z_at_100k n_caps=6" > docs/references/hat-simulation-tools-20261029/metadata-repair-20261030/spice-work-utf8/decoupling_C308_C319_C320_C312_C313.out
quit
.endc

.end
