parkourlrc/pcb-yilv1982--duck-robot-89dbc81d6d/docs/references/扩展板电路仿真工具/metadata-repair-20261030/spice-work-utf8/voltage-divider_R301_R302.cir

* Auto-generated testbench for voltage divider: R301/R302
* Expected Vout = 5.0 * 0.160514 = 0.8026 V
* Model: ideal passives (exact, unloaded)

VIN _5V 0 DC 5.0
R301 _5V _5V_FB 52.3k
R302 _5V_FB 0 10k

.control
op 
let vout_sim = v(_5V_FB)
let error_pct = abs(vout_sim - 0.80257) / 0.80257 * 100
echo "vout_sim=$&vout_sim error_pct=$&error_pct expected=0.80257" > docs/references/hat-simulation-tools-20261029/metadata-repair-20261030/spice-work-utf8/voltage-divider_R301_R302.out
quit
.endc

.end
