parkourlrc/pcb-yilv1982--duck-robot-89dbc81d6d/(list of files, drawings)

Other design files:
docs/references/hat-jlc-self-check-20261102/sources/pcb-capabilities-links.json
docs/references/hat-jlc-self-check-20261102/sources/pcb-capabilities-tables.json
docs/references/归档扩展板嘉立创规则自查/sources/pcb-capabilities-links.json
docs/references/归档扩展板嘉立创规则自查/sources/pcb-capabilities-tables.json
docs/references/归档扩展板机械适配复核/schematic-delta.json
docs/references/归档扩展板极性与装配资料/schematic-delta.json
docs/references/归档扩展板热焊盘回写/schematic-delta.json
docs/references/归档扩展板贴片与层叠复核/final/schematic-delta.json
docs/references/归档扩展板贴片与层叠复核/schematic-delta.json
docs/references/归档扩展板钢网与裸露焊盘/final/schematic-delta.json
docs/references/归档扩展板钢网与裸露焊盘/schematic-delta.json
docs/references/归档扩展板钢网分窗审查/schematic-delta.json
docs/references/归档扩展板音频芯片焊盘/schematic-delta.json
docs/references/惯性单元三版来源对比/pcb-source-check-20261026.json
docs/references/扩展板乙版降本/engineering-feedback/pcb-pad-evidence.json
docs/references/扩展板乙版降本/route-164054/custom_hat_rev_b.dsn
docs/references/扩展板乙版降本/route-170756/custom_hat_rev_b.dsn
docs/references/扩展板乙版降本/route-171730/custom_hat_rev_b.dsn
docs/references/扩展板乙版降本/route-171945/custom_hat_rev_b.dsn
docs/references/扩展板乙版降本/route-172535/custom_hat_rev_b.dsn
docs/references/扩展板乙版降本/route-172857/custom_hat_rev_b.dsn
docs/references/扩展板乙版降本/route-234520/custom_hat_rev_b.dsn
docs/references/扩展板双口惯性缺答复核/pcb-artifact-manifest.json
docs/references/扩展板电路仿真工具/amp-decoupling-20261031/schematic-delta.json
docs/references/扩展板电路仿真工具/amp-decoupling-20261031/schematic-wire-style-check.json
docs/references/扩展板电路仿真工具/annular-rings-20261031/schematic-delta.json
docs/references/扩展板电路仿真工具/board-marking-20261031/schematic-delta.json
docs/references/扩展板电路仿真工具/bom-passives-20261031/schematic-delta.json
docs/references/扩展板电路仿真工具/buck-control-20261031/schematic-delta.json
docs/references/扩展板电路仿真工具/buck-thermal-20261031/schematic-delta.json
docs/references/扩展板电路仿真工具/cap-vias-20261031/schematic-delta.json
docs/references/扩展板电路仿真工具/capacitor-upgrade-20261031/schematic-delta.json
docs/references/扩展板电路仿真工具/codec-pth-20261031/schematic-delta.json
docs/references/扩展板电路仿真工具/codec-reset-20261031/schematic-delta.json
docs/references/扩展板电路仿真工具/codec-reset-20261031/schematic-display-changes.json
docs/references/扩展板电路仿真工具/connectors-20261031/schematic-delta.json
docs/references/扩展板电路仿真工具/final-bom-20261031/schematic-delta.json
docs/references/扩展板电路仿真工具/five-volt-paths-20261031/schematic-delta.json
docs/references/扩展板电路仿真工具/i2c-pullups-20261031/schematic-delta.json
docs/references/扩展板电路仿真工具/i2s-reference-stitch-20261031/schematic-delta.json
docs/references/扩展板电路仿真工具/ldo-capacitors-20261031/schematic-delta.json
docs/references/扩展板电路仿真工具/manufacturer-rules-20261031/schematic-delta.json
docs/references/扩展板电路仿真工具/npth-clearance-20261031/schematic-delta.json
docs/references/扩展板电路仿真工具/power-acceptance-20261031/label-spacing/schematic-delta.json
docs/references/扩展板电路仿真工具/power-acceptance-20261031/schematic-delta.json
docs/references/扩展板电路仿真工具/power-paths-20261031/schematic-delta.json
docs/references/扩展板电路仿真工具/qwiic-pinout-20261031/schematic-delta.json
docs/references/扩展板电路仿真工具/qwiic-pinout-20261031/schematic-label-tidy.json
docs/references/扩展板电路仿真工具/ttl-bypass-20261031/schematic-delta.json
docs/references/扩展板邮票孔与电源修复/schematic-delta.json
hardware/custom_hat/candidates/freerouting-codec/custom_hat_rev_a.dsn
hardware/custom_hat/candidates/freerouting-u701/custom_hat_rev_a.dsn
hardware/custom_hat/rev_a/review-20261030-final/pcb-final.json
hardware/custom_hat/rev_a/route/custom_hat_rev_a.dsn
