parkourlrc/pcb-yilv1982--duck-robot-89dbc81d6d/docs/references/扩展板乙版降本/route-171945/custom_hat_rev_b.kicad_pcb

## KiCad design docs/references/扩展板乙版降本/route-171945/custom_hat_rev_b.kicad_pcb (2026-11-05)

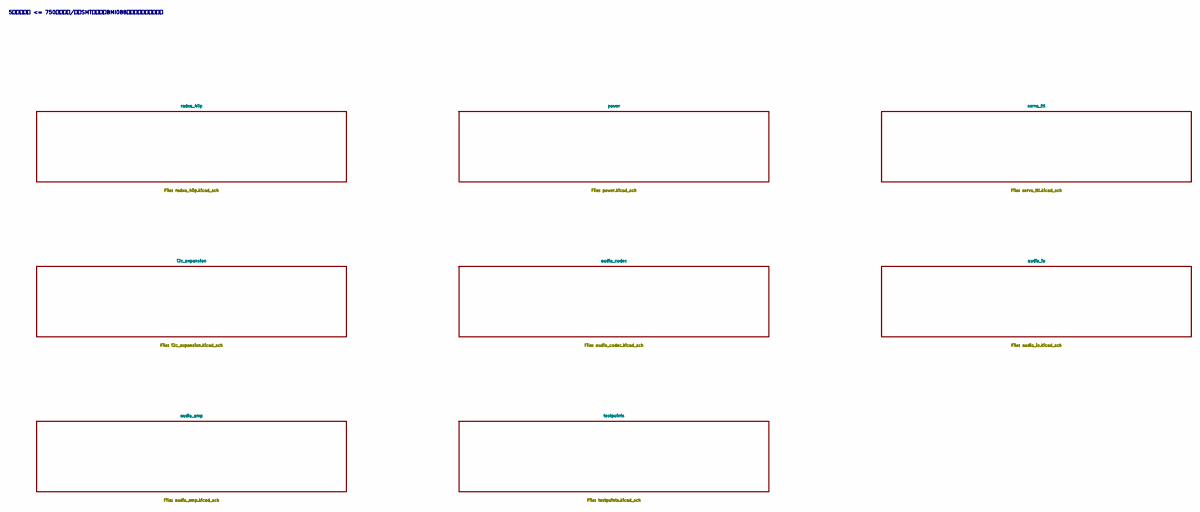
[picture p260: schematic custom_hat_rev_b.kicad_sch, 自主HAT Rev B.0 / 成本约束开发]

Notes on the sheet:
5片目标总价 <= 750元；两层/单面SMT；无板载BMI088；当前不是生产放行。

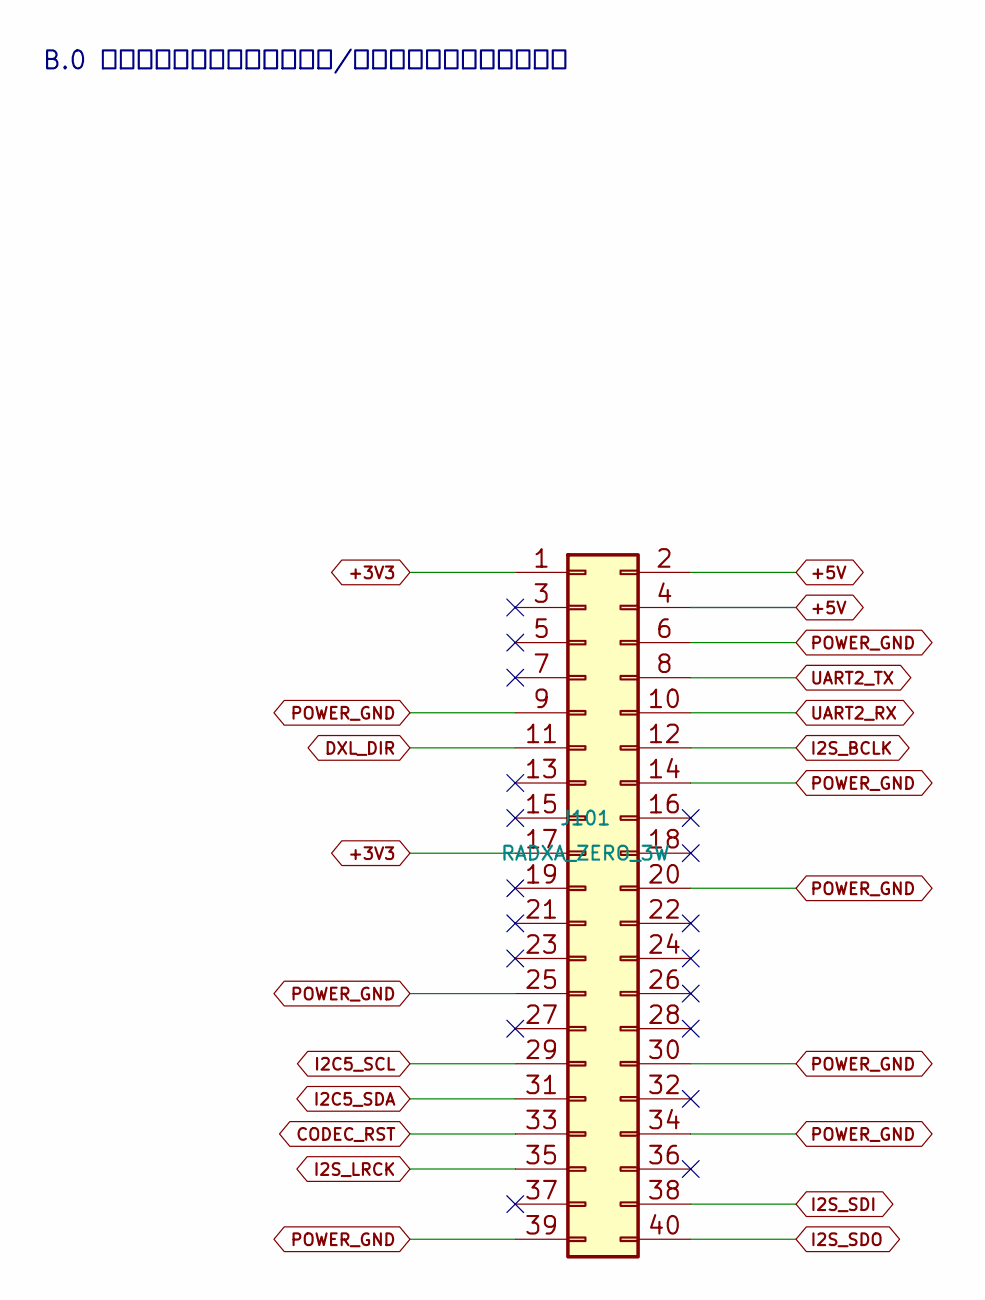
[picture p261: schematic radxa_40p.kicad_sch, 自主HAT B.0 / radxa_40p]

Parts:
J101: RADXA_ZERO_3W; Radxa40P_Zhouri_B; MPN 2.54-2*20; LCSC C2977589

Connections:
+3V3: J101.1, J101.17; also elsewhere on the board
+5V: J101.2, J101.4; also elsewhere on the board
CODEC_RST: J101.33; also elsewhere on the board
DXL_DIR: J101.11; also elsewhere on the board
I2C5_SCL: J101.29; also elsewhere on the board
I2C5_SDA: J101.31; also elsewhere on the board
I2S_BCLK: J101.12; also elsewhere on the board
I2S_LRCK: J101.35; also elsewhere on the board
I2S_SDI: J101.38; also elsewhere on the board
I2S_SDO: J101.40; also elsewhere on the board
POWER_GND: J101.6, J101.9, J101.14, J101.20, J101.25, J101.30, J101.34, J101.39; also elsewhere on the board
UART2_RX: J101.10; also elsewhere on the board
UART2_TX: J101.8; also elsewhere on the board

Notes on the sheet:
B.0 开发候选；脚位已建立，制造/成本和首板验收尚未完成。

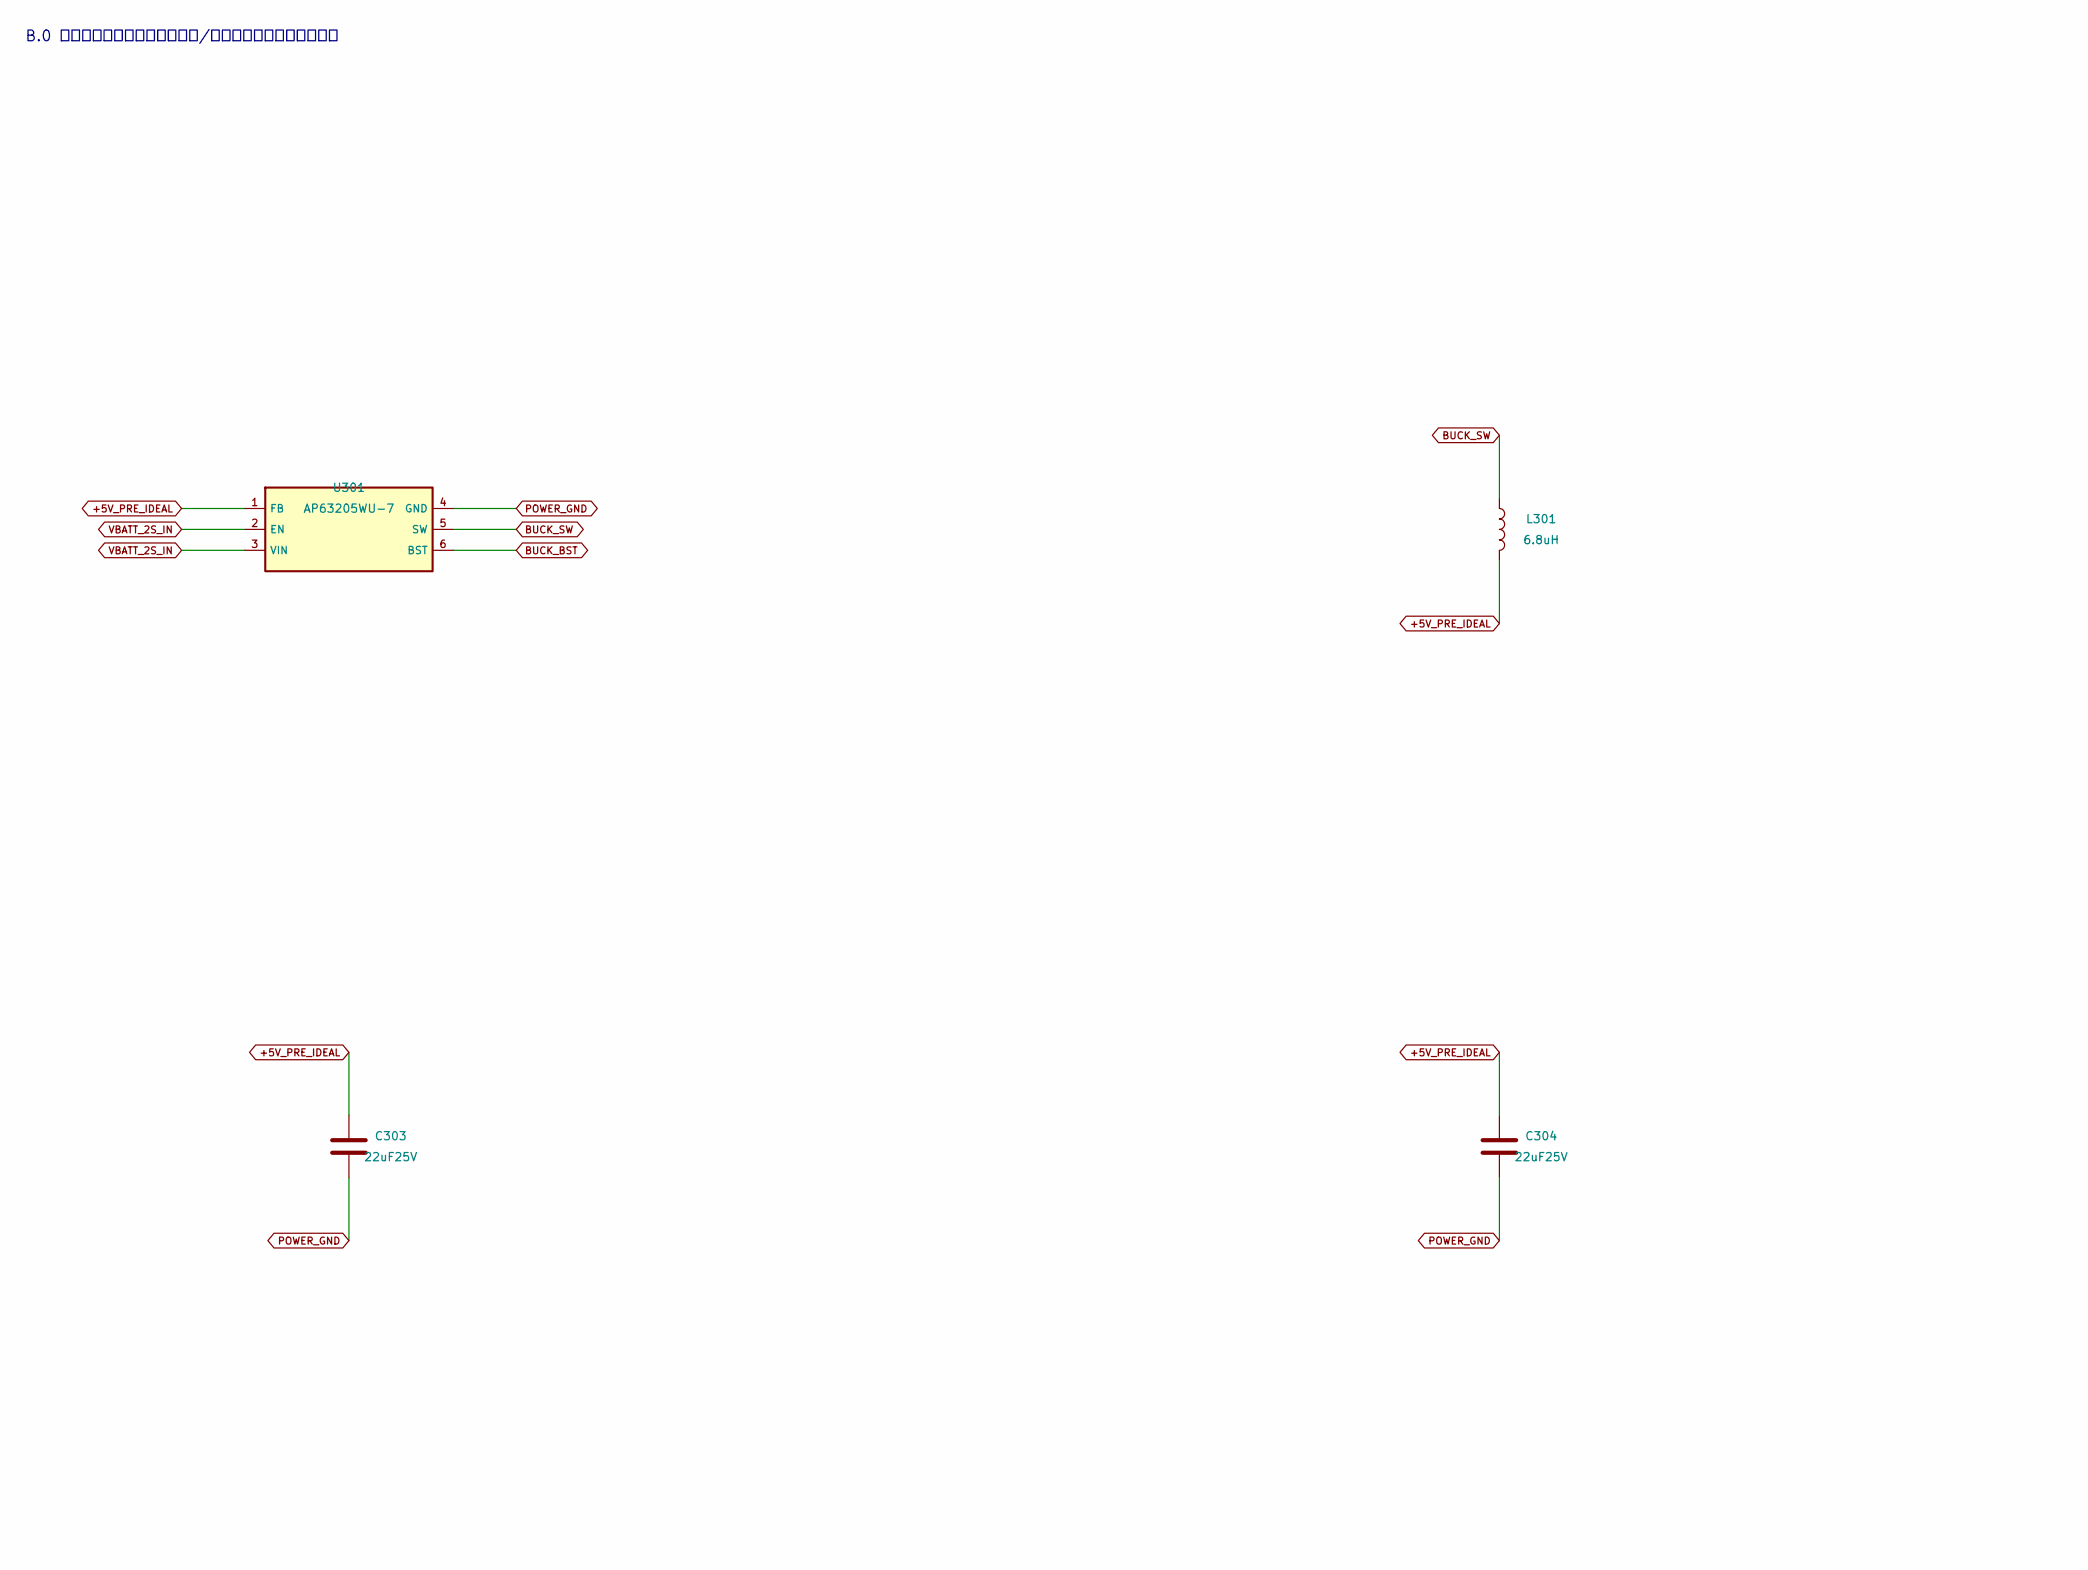
[picture p262: schematic power.kicad_sch, 自主HAT B.0 / power, part in row 1, column 1]

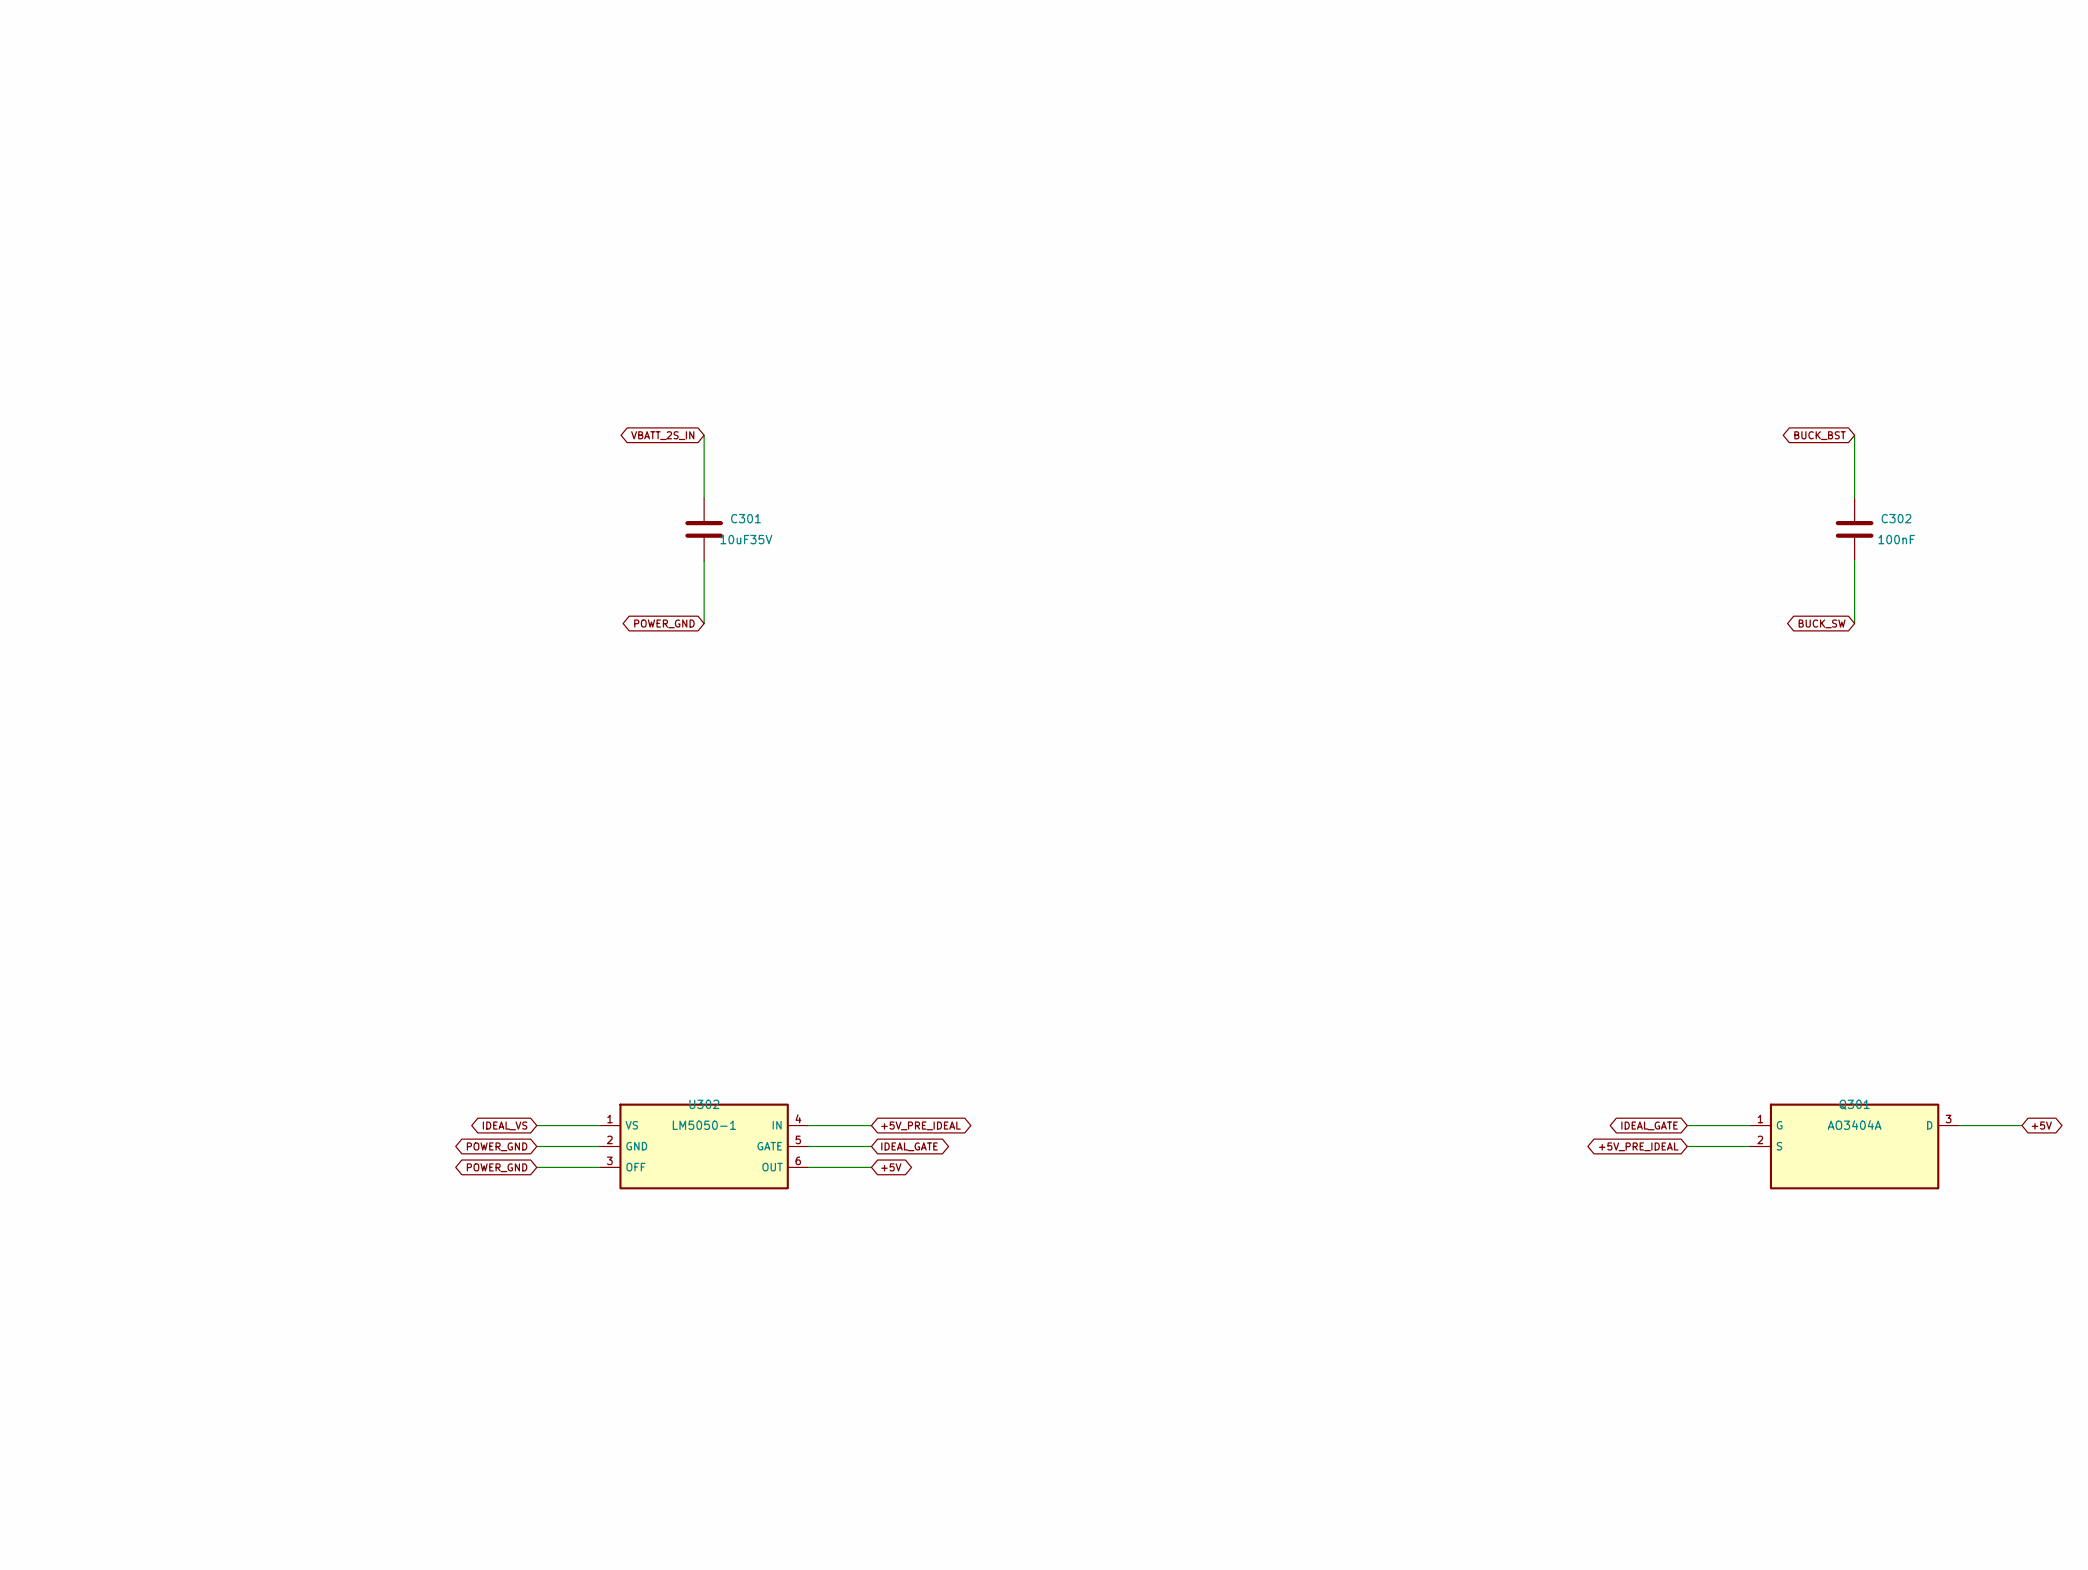
[picture p263: schematic power.kicad_sch, 自主HAT B.0 / power, part in row 1, column 2]

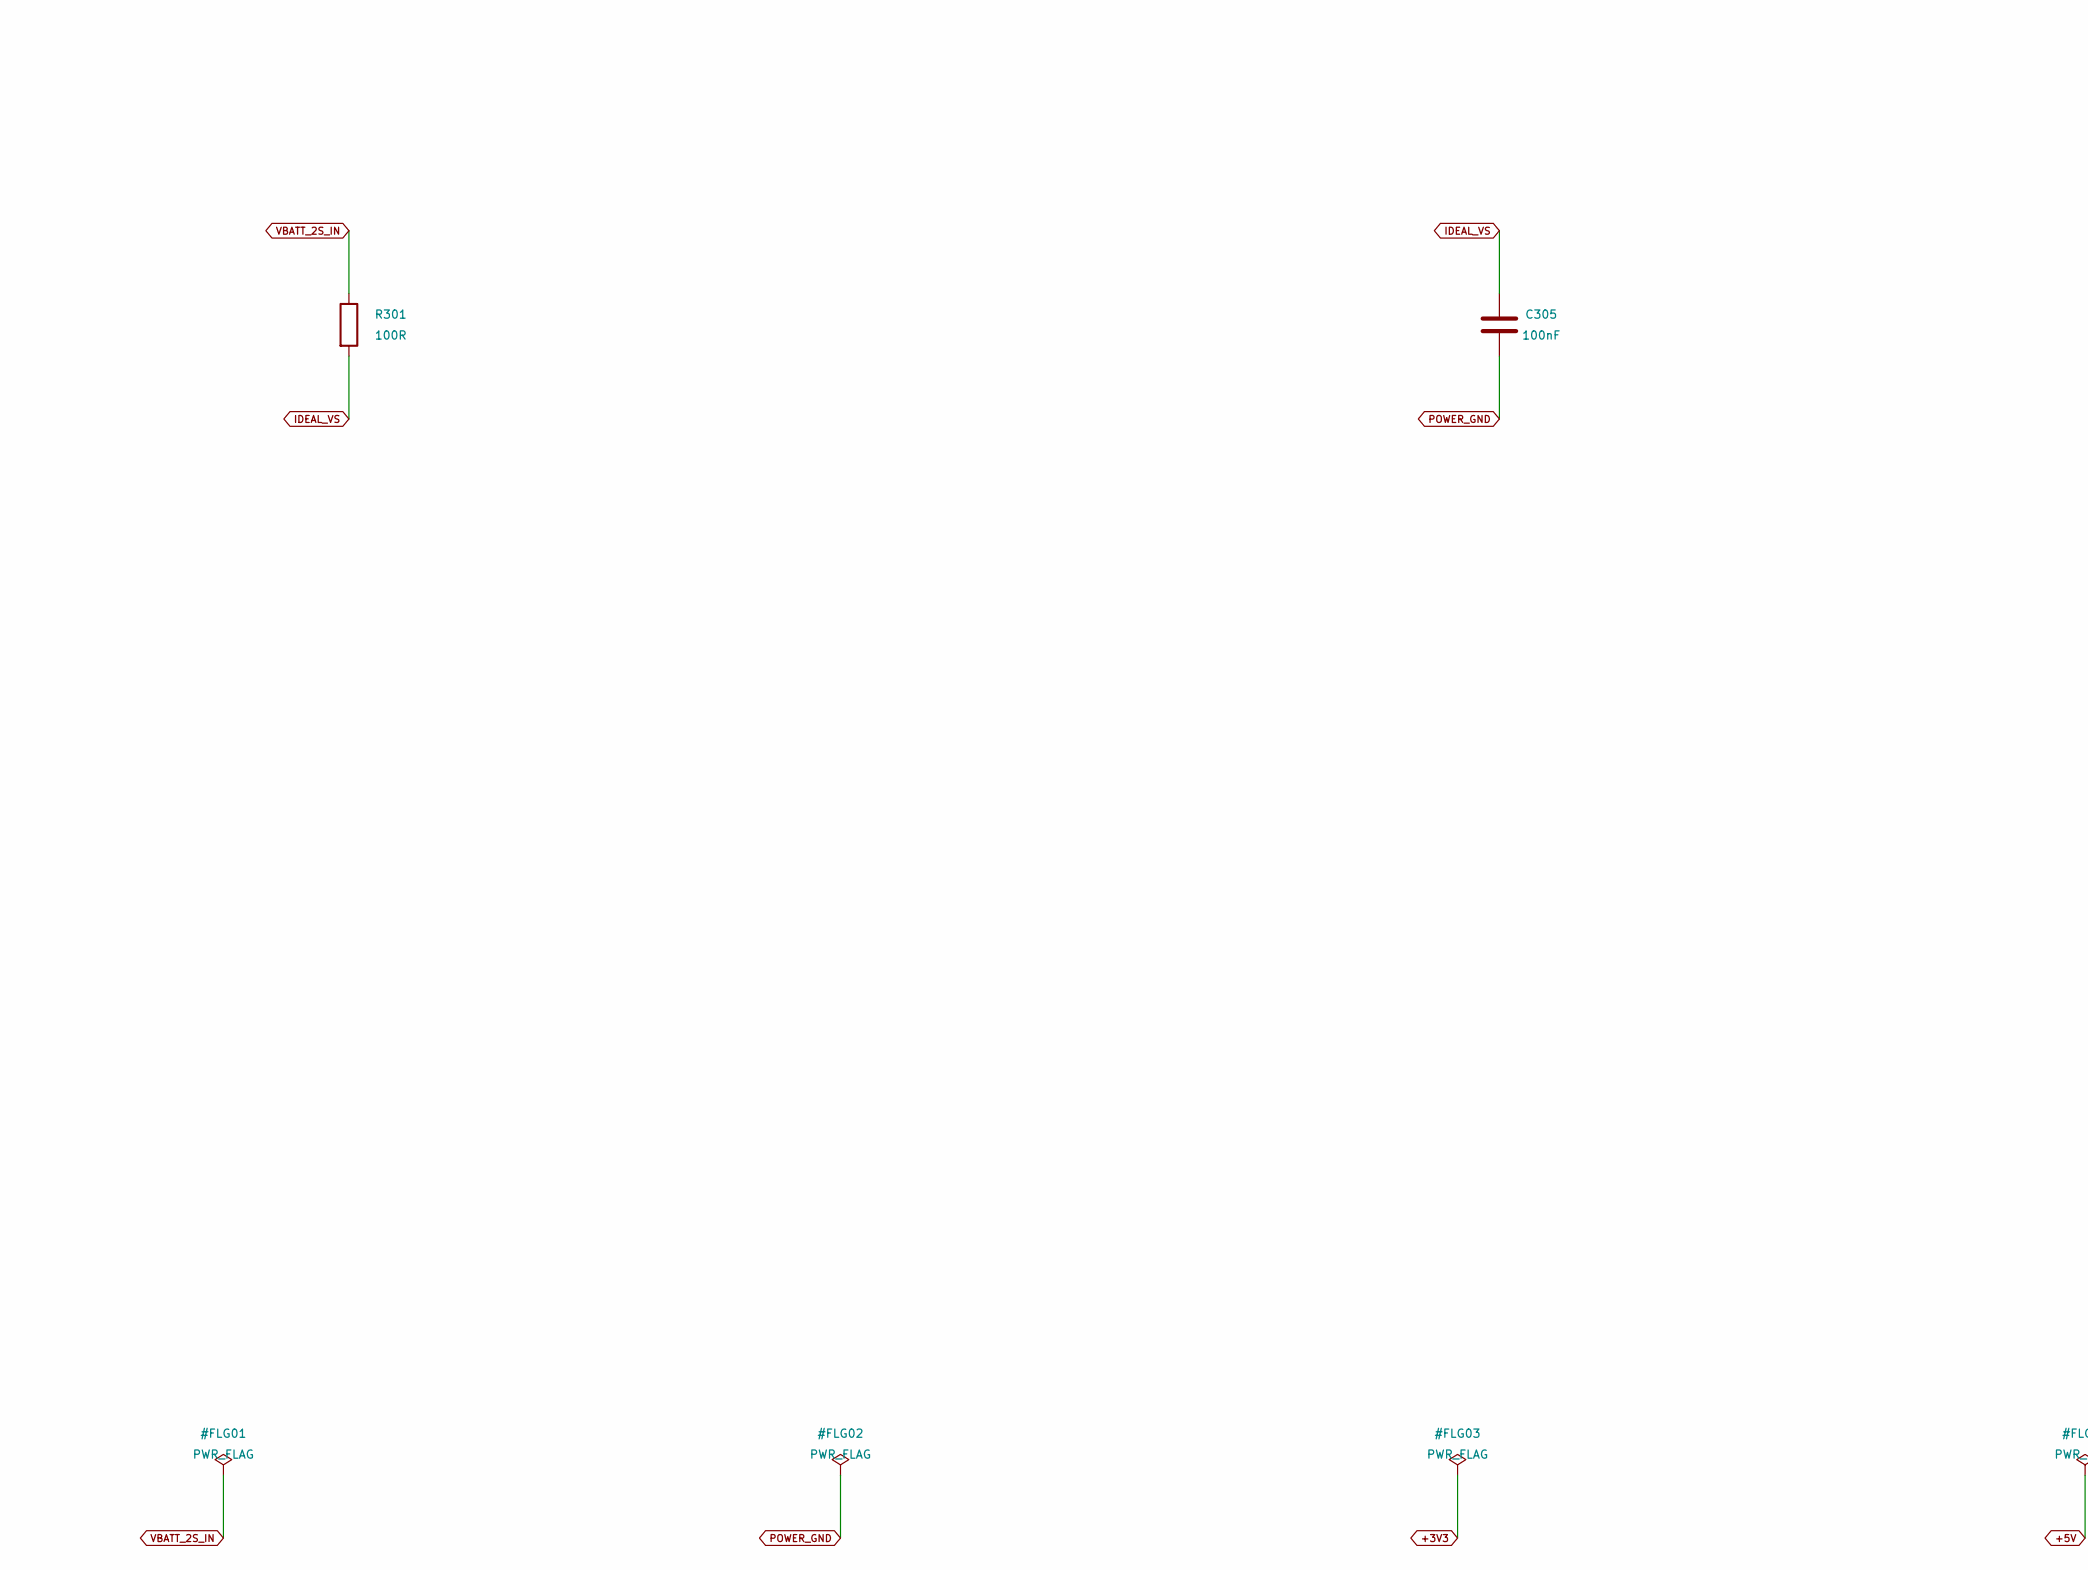
[picture p264: schematic power.kicad_sch, 自主HAT B.0 / power, part in row 2, column 1]

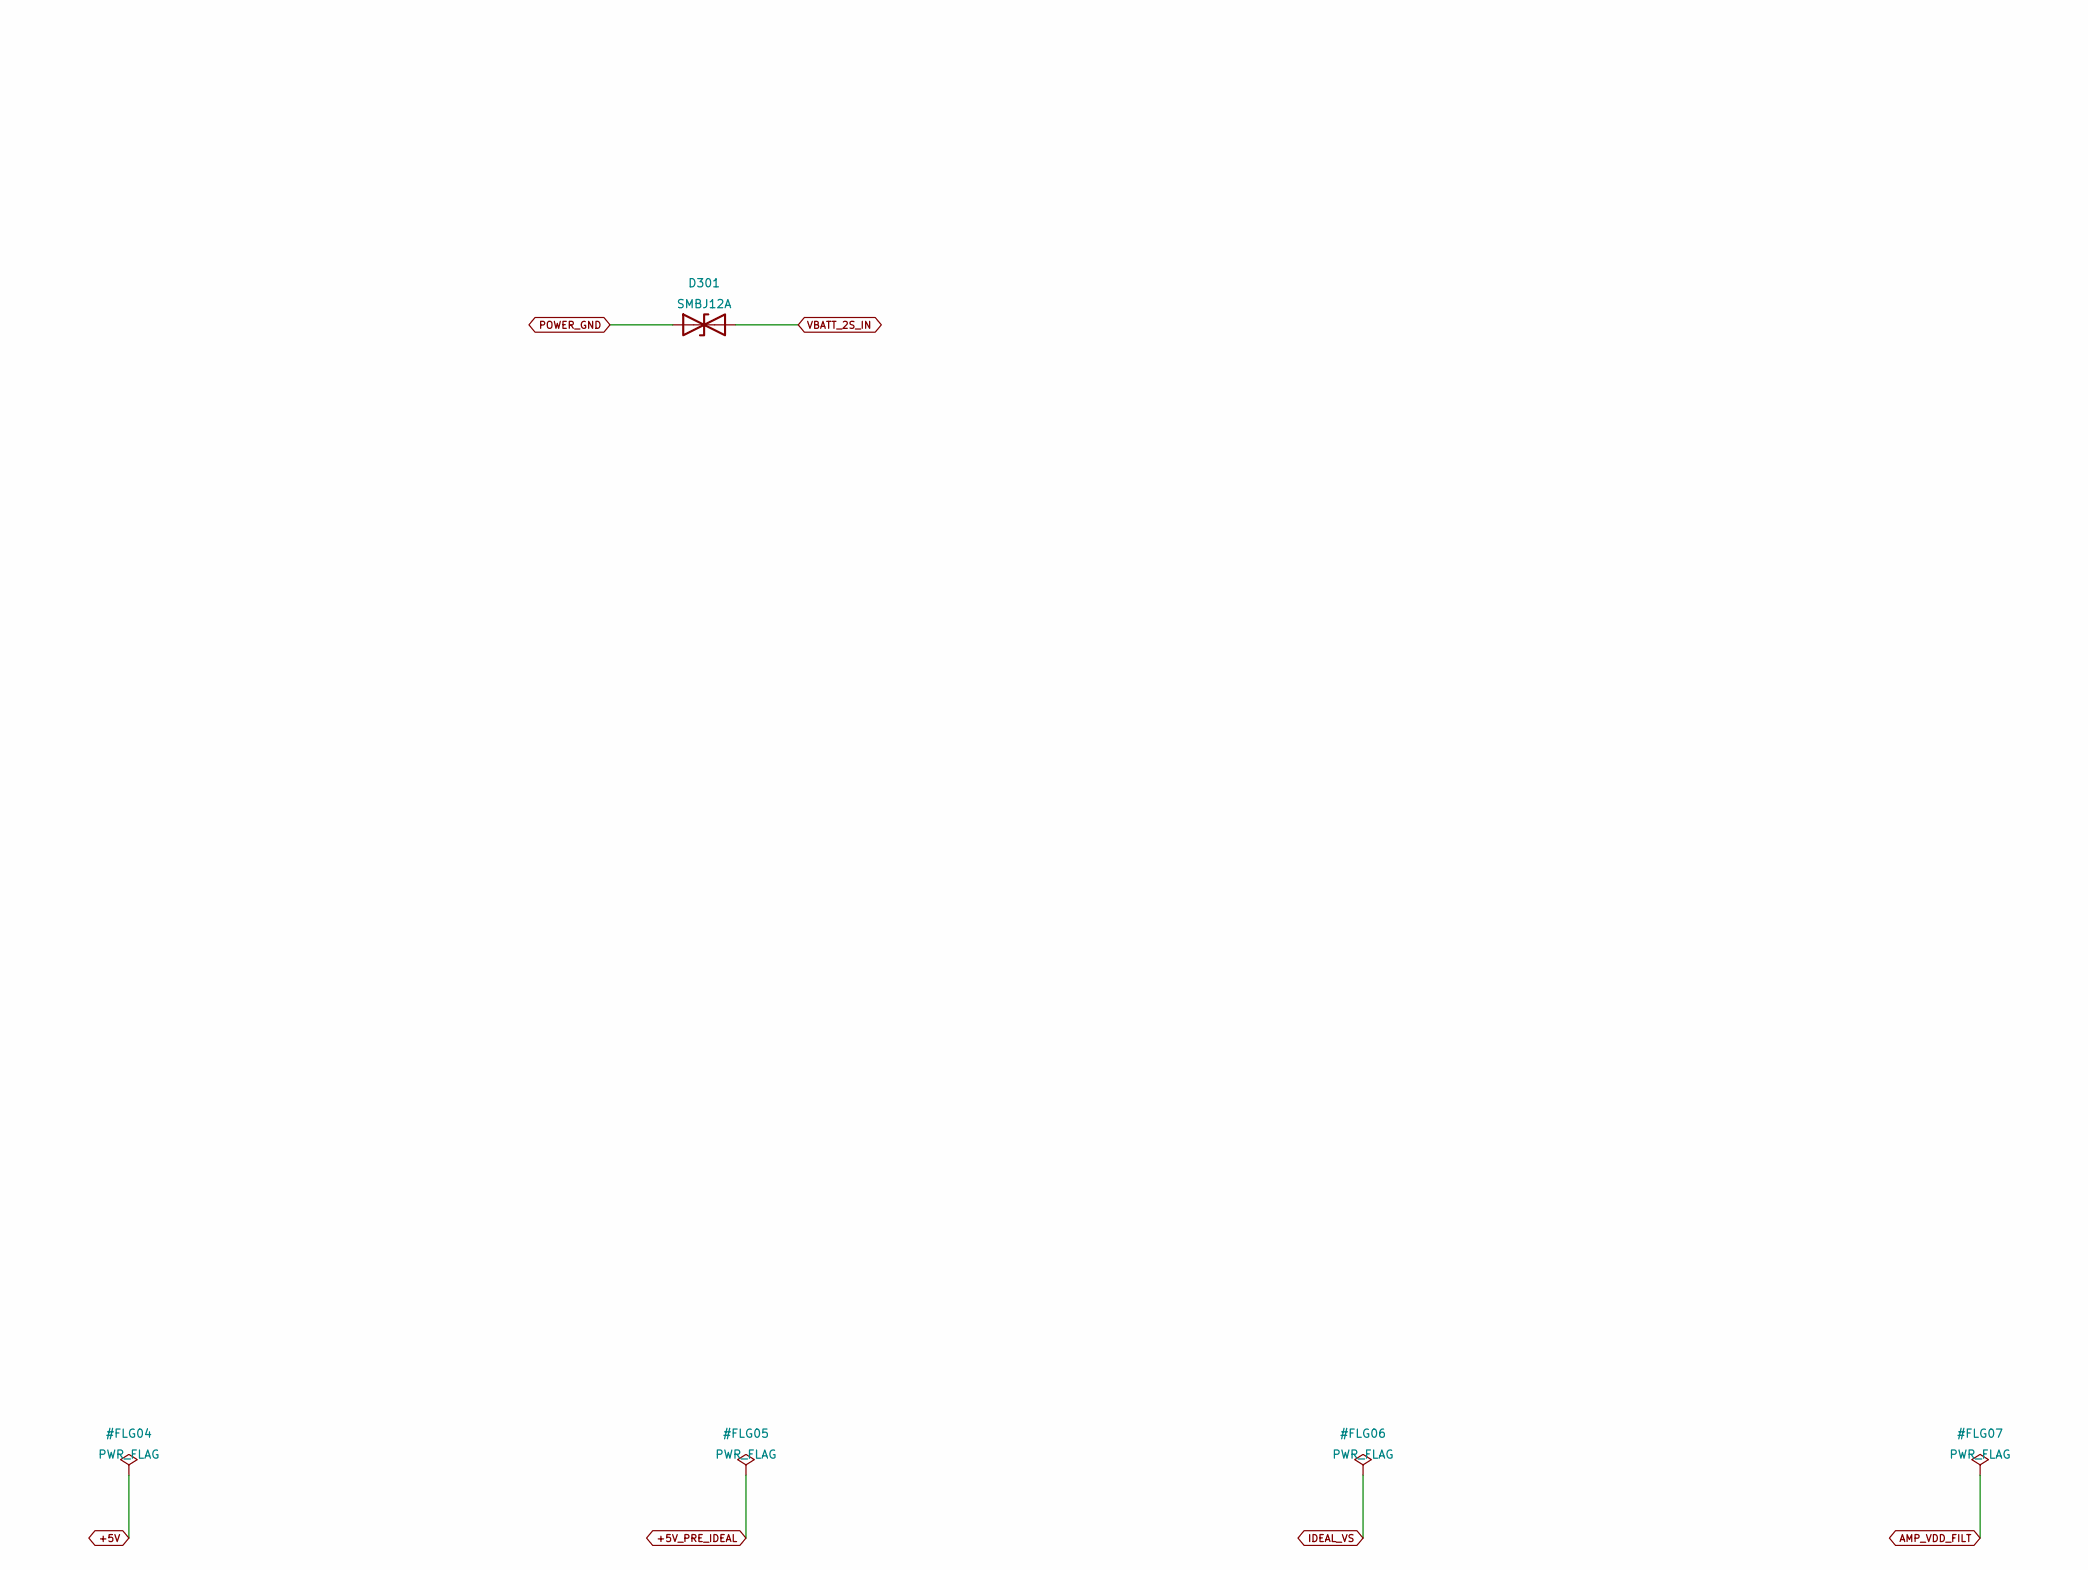
[picture p265: schematic power.kicad_sch, 自主HAT B.0 / power, part in row 2, column 2]

Parts:
C301: 10uF35V; C_1206_3216Metric; MPN C3216X7R1V106KT000E; LCSC C76666
C302, C305: 100nF; C_0603_1608Metric; MPN CC0603KRX7R9BB104; LCSC C14663
C303, C304: 22uF25V; C_1210_3225Metric; MPN GRM32ER71E226KE15L; LCSC C21397
D301: SMBJ12A; D_SMB; MPN SMBJ12A-E3/52; LCSC C1973121
L301: 6.8uH; L_Sunlord_SWPA6045S; MPN SWPA6045S6R8MT; LCSC C57254
Q301: AO3404A; SOT-23; MPN AO3404A; LCSC C30010
R301: 100R; R_0603_1608Metric; MPN 0603WAF1000T5E; LCSC C22775
U301: AP63205WU-7; TSOT-23-6; MPN AP63205WU-7; LCSC C2071056
U302: LM5050-1; TSOT-23-6; MPN LM5050MKX-1/NOPB; LCSC C473393

Connections:
+5V: Q301.3 (D), U302.6 (OUT); also elsewhere on the board
+5V_PRE_IDEAL: C303.1, C304.1, L301.2, Q301.2 (S), U301.1 (FB), U302.4 (IN)
BUCK_BST: C302.1, U301.6 (BST)
BUCK_SW: C302.2, L301.1, U301.5 (SW)
IDEAL_GATE: Q301.1 (G), U302.5 (GATE)
IDEAL_VS: C305.1, R301.2, U302.1 (VS)
POWER_GND: C301.2, C303.2, C304.2, C305.2, D301.1 (A1), U301.4 (GND), U302.2 (GND), U302.3 (OFF); also elsewhere on the board
VBATT_2S_IN: C301.1, D301.2 (A2), R301.1, U301.2 (EN), U301.3 (VIN); also elsewhere on the board

Notes on the sheet:
B.0 开发候选；脚位已建立，制造/成本和首板验收尚未完成。
