parkourlrc/pcb-yilv1982--duck-robot-89dbc81d6d/docs/references/扩展板乙版降本/route-171945/before-local-repair.kicad_pcb

## KiCad design docs/references/扩展板乙版降本/route-171945/custom_hat_rev_b.kicad_pcb (continued)

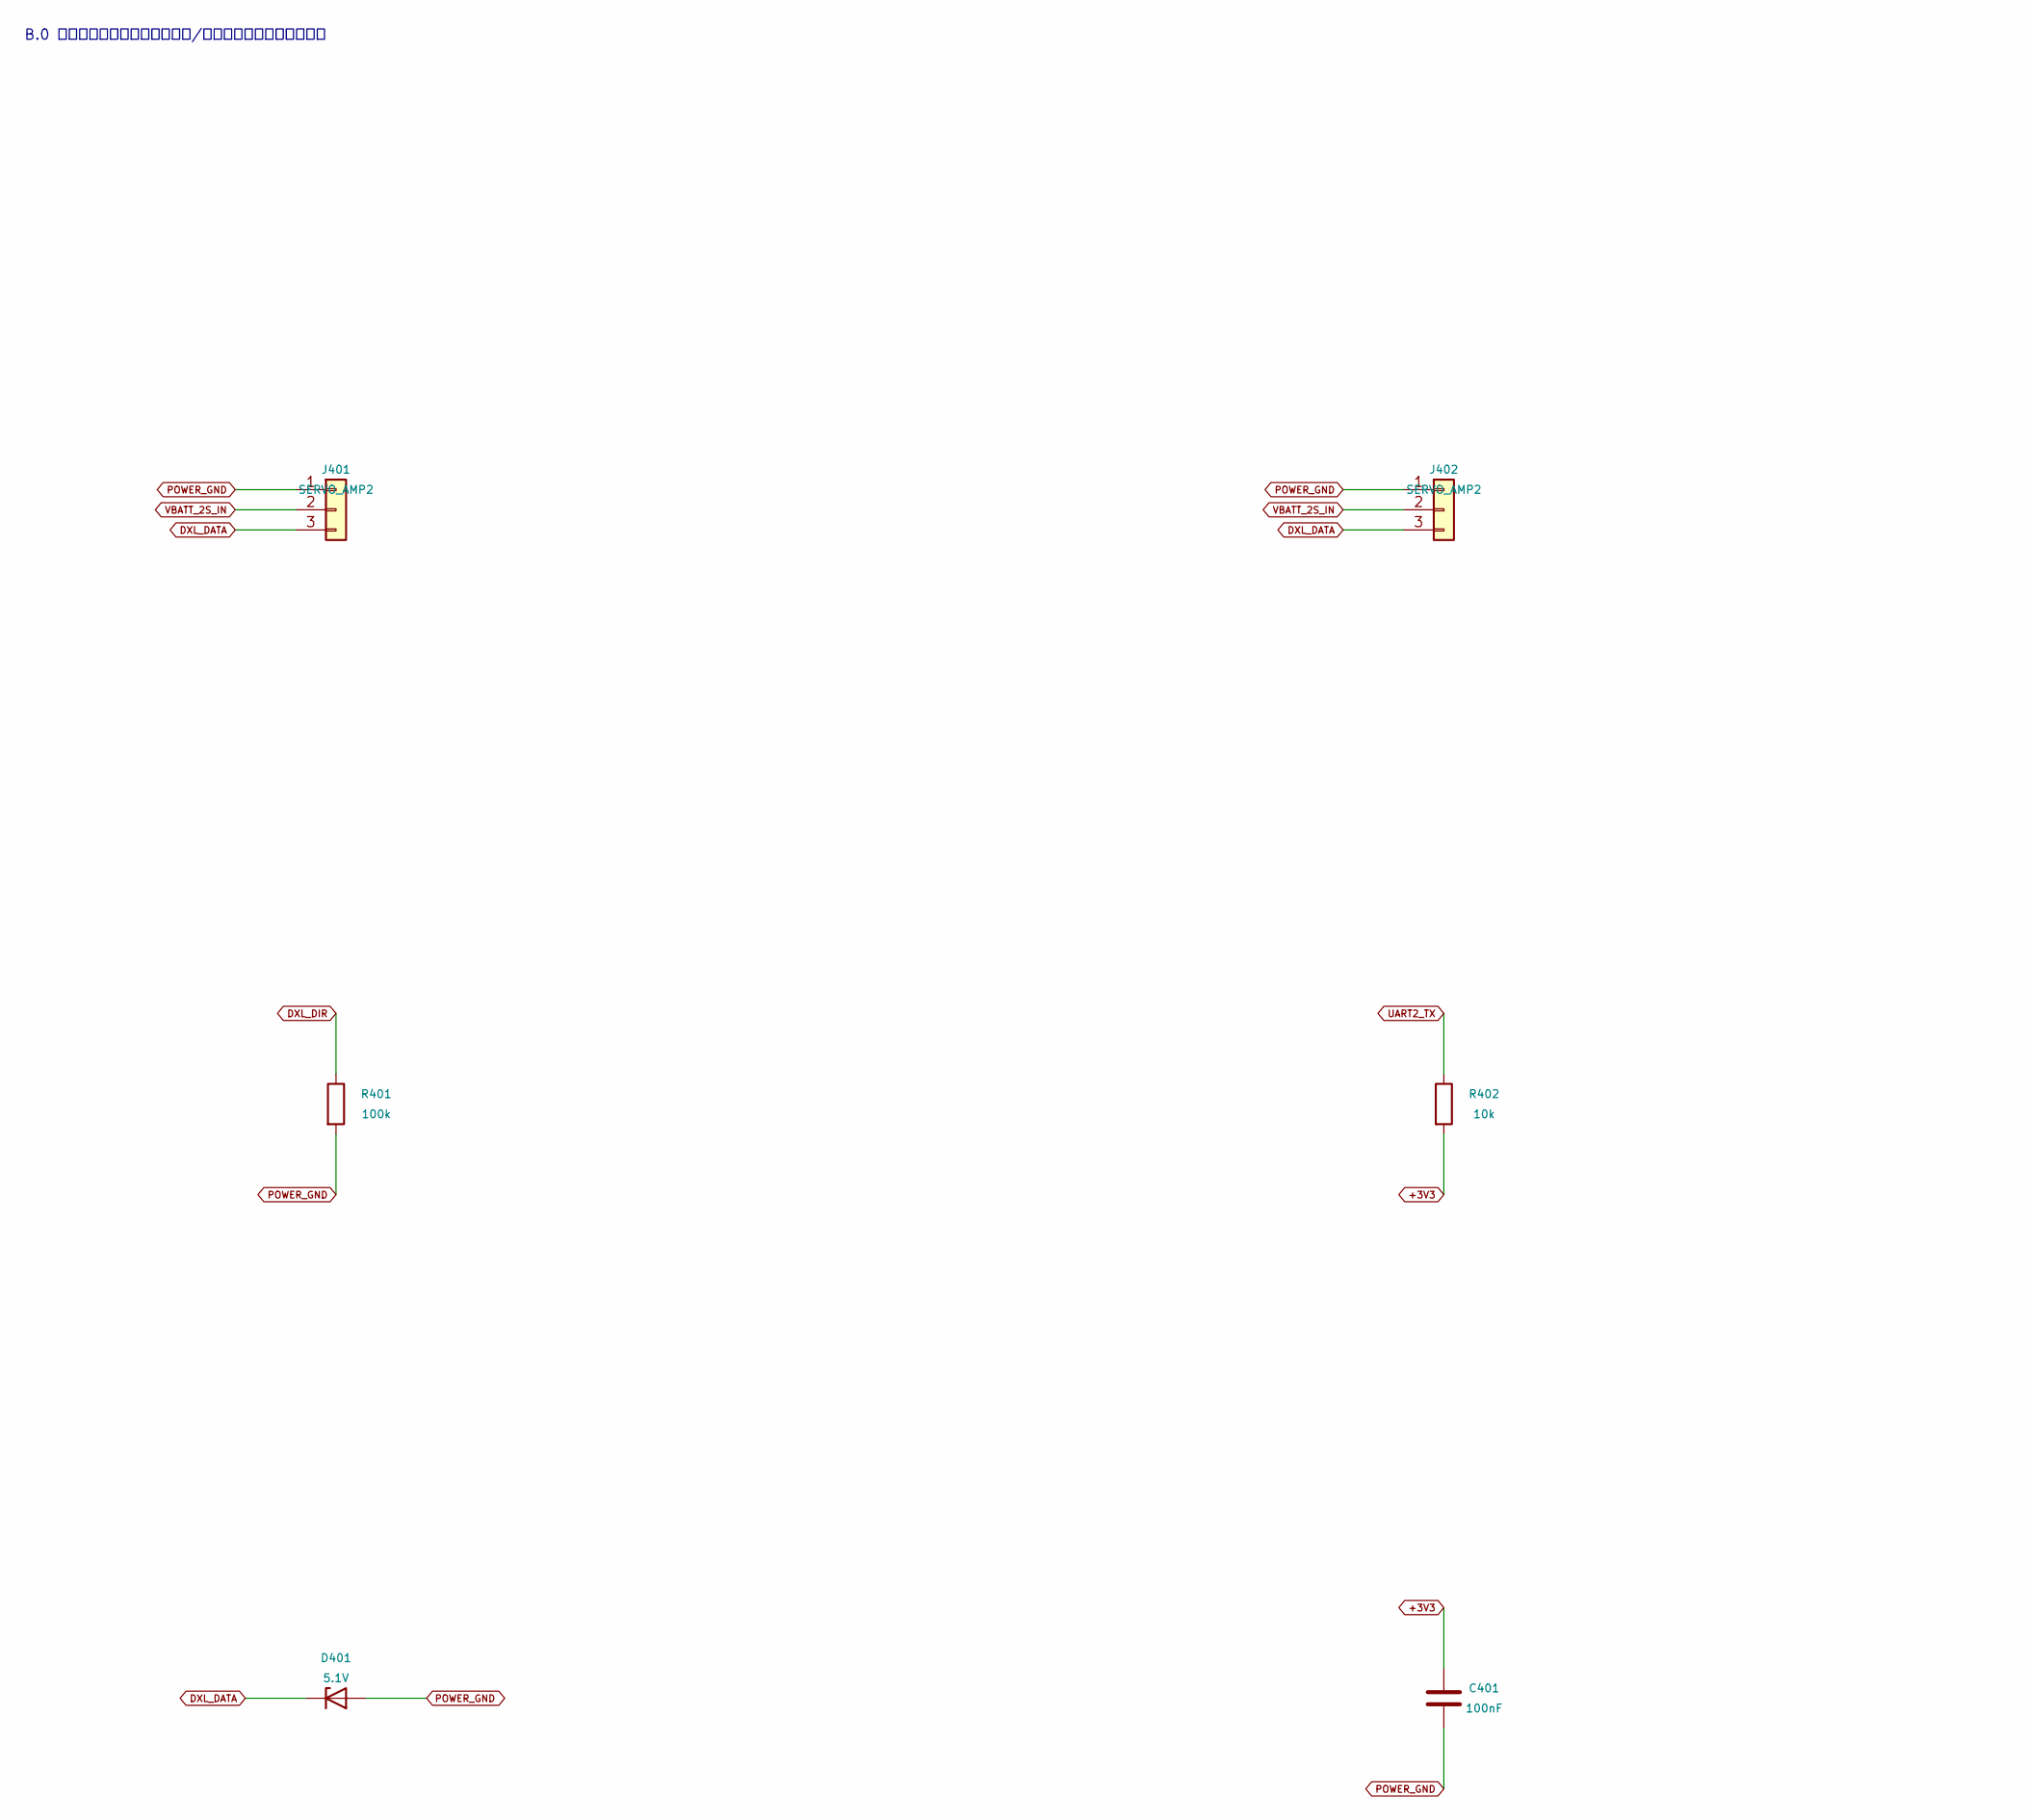
[picture p266: schematic servo_ttl.kicad_sch, 自主HAT B.0 / servo_ttl, part in row 1, column 1]

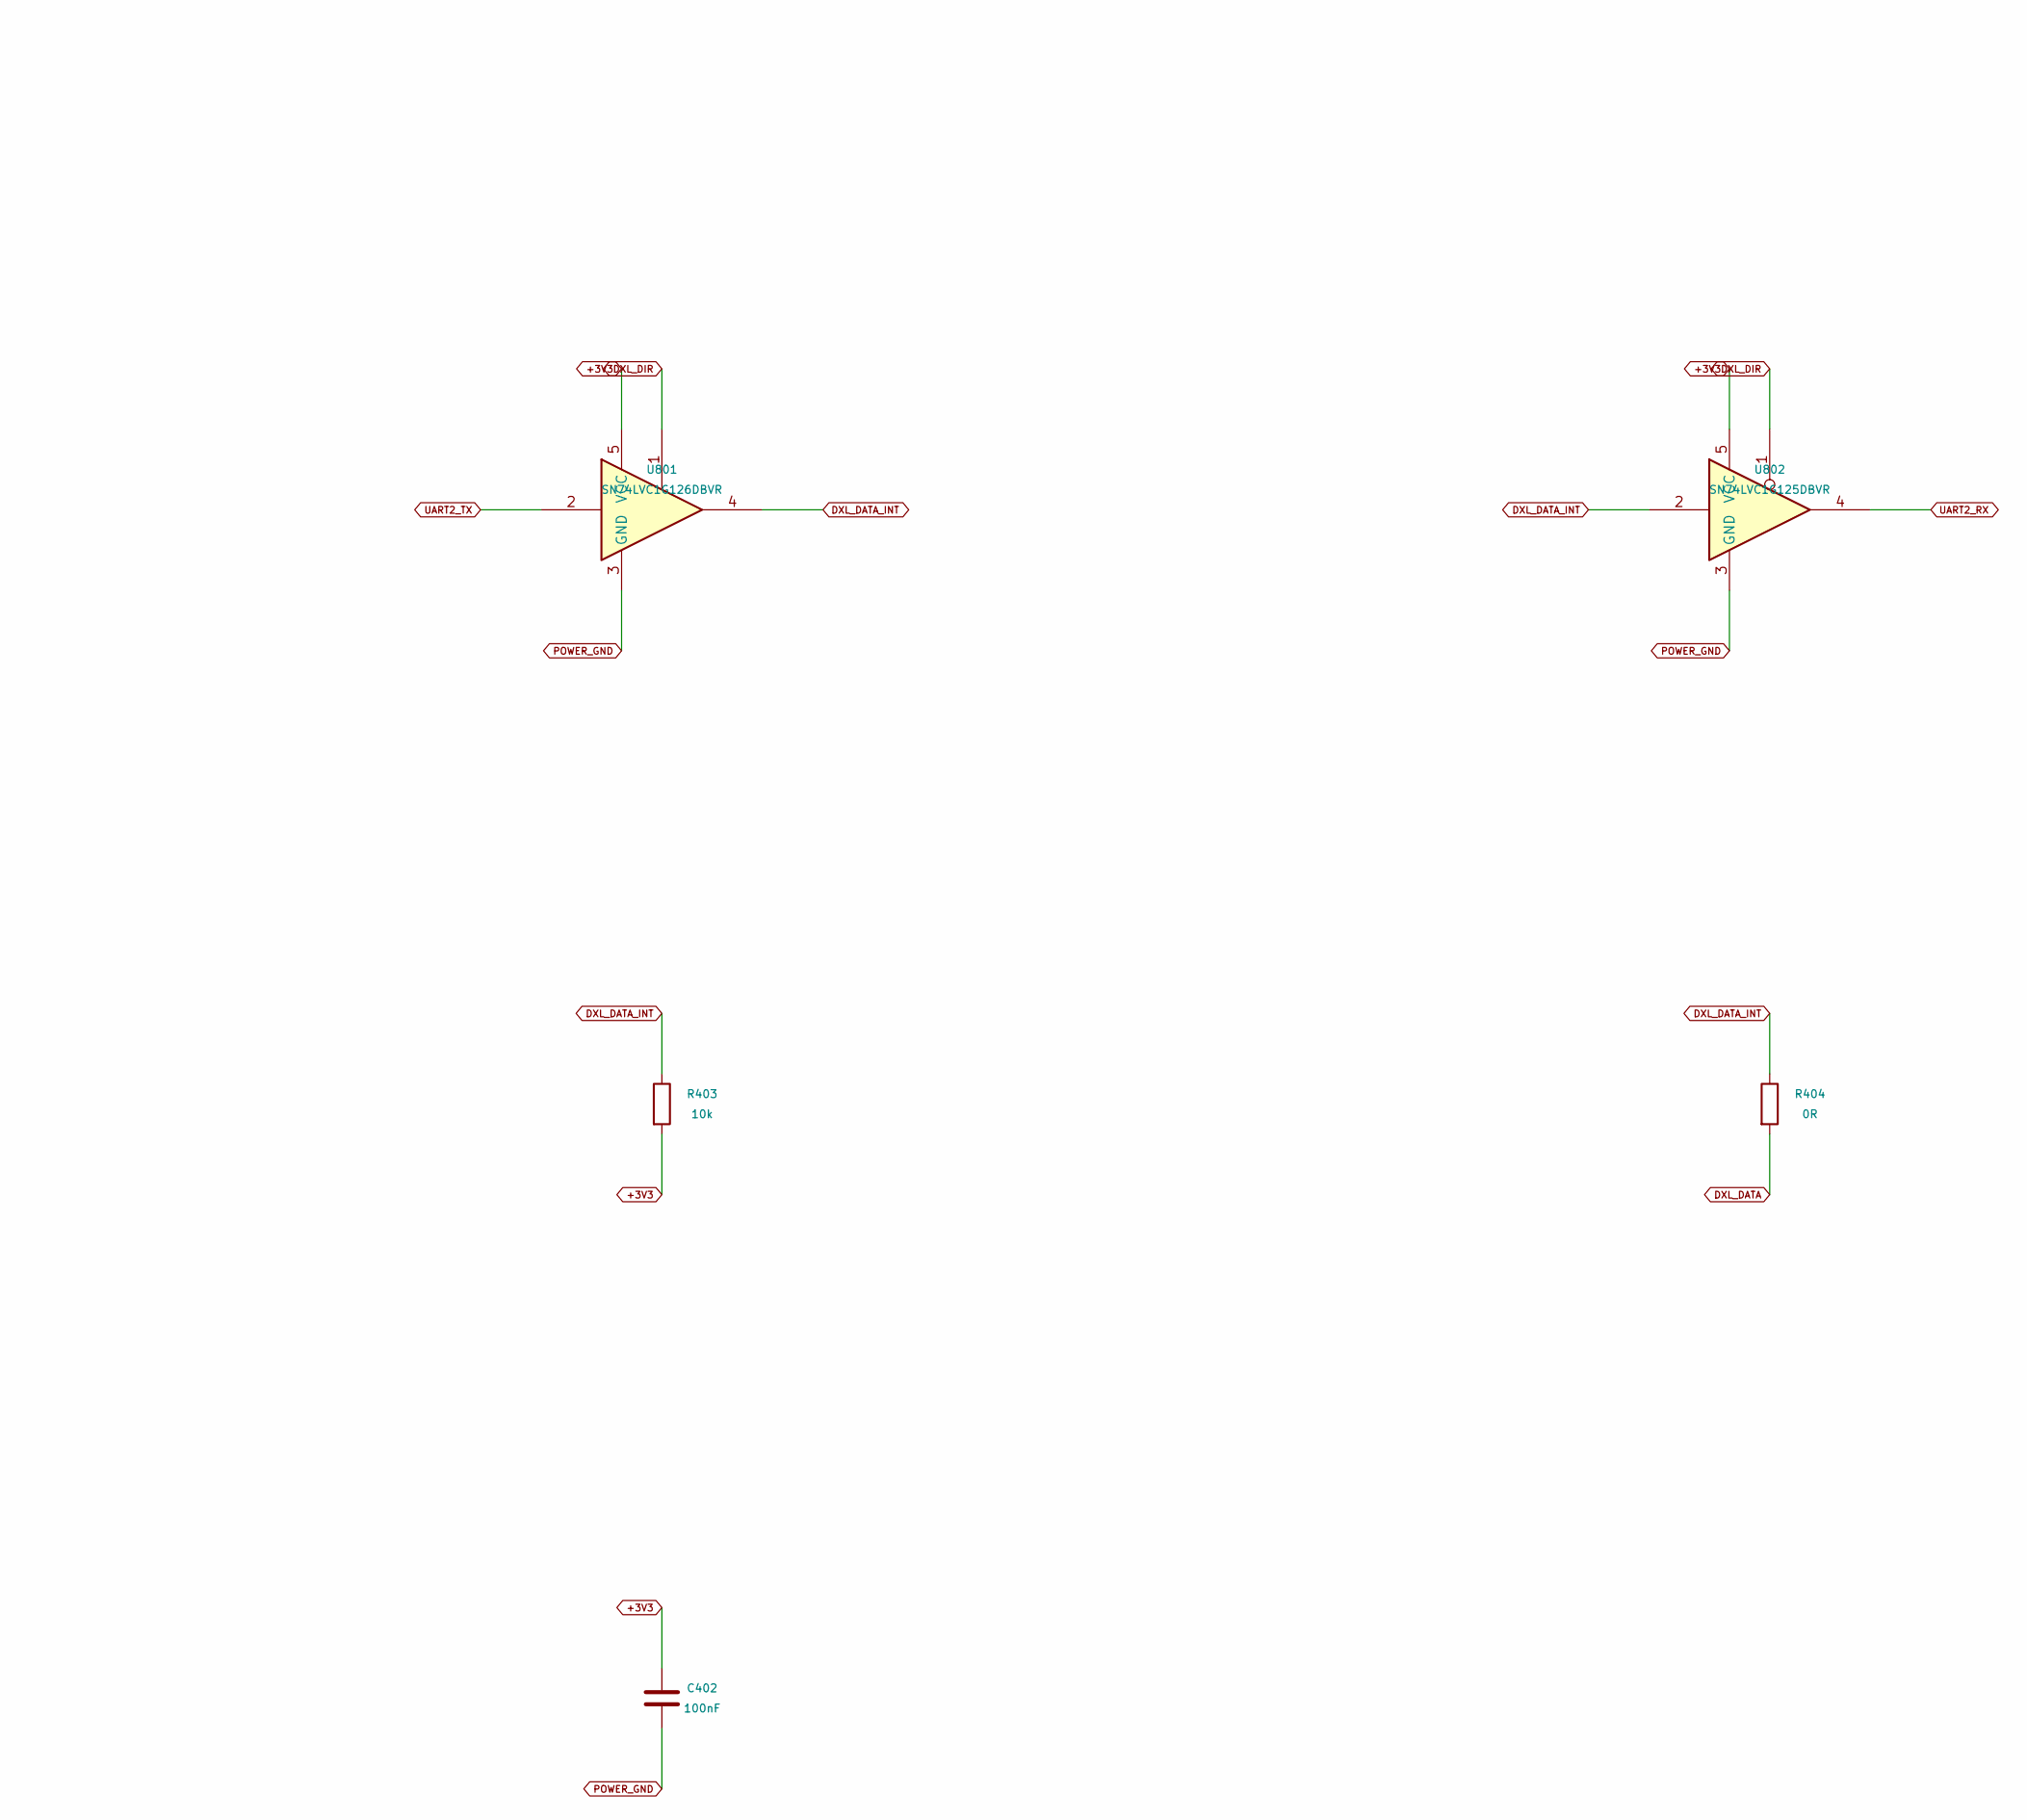
[picture p267: schematic servo_ttl.kicad_sch, 自主HAT B.0 / servo_ttl, part in row 1, column 2]

Parts:
C401, C402: 100nF; C_0603_1608Metric; MPN CC0603KRX7R9BB104; LCSC C14663
D401: 5.1V; D_SOD-323; MPN BZT52C5V1S-7-F; LCSC C151348
J401, J402: SERVO_AMP2; AMP2007_3P_B; MPN CNJMA2007WV-3P; LCSC C5151076
R401: 100k; R_0603_1608Metric; MPN 0603WAF1003T5E; LCSC C25803
R402, R403: 10k; R_0603_1608Metric; MPN 0603WAF1002T5E; LCSC C25804
R404: 0R; R_0603_1608Metric; MPN 0603WAF0000T5E; LCSC C21189
U801: SN74LVC1G126DBVR; SOT-23-5; MPN SN74LVC1G126DBVR; LCSC C7834
U802: SN74LVC1G125DBVR; SOT-23-5; MPN SN74LVC1G125DBVR; LCSC C23654

Connections:
+3V3: C401.1, C402.1, R402.2, R403.2, U801.5 (VCC), U802.5 (VCC); also elsewhere on the board
DXL_DATA: D401.1 (K), J401.3, J402.3, R404.2
DXL_DATA_INT: R403.1, R404.1, U801.4, U802.2
DXL_DIR: R401.1, U801.1, U802.1; also elsewhere on the board
POWER_GND: C401.2, C402.2, D401.2 (A), J401.1, J402.1, R401.2, U801.3 (GND), U802.3 (GND); also elsewhere on the board
UART2_RX: U802.4; also elsewhere on the board
UART2_TX: R402.1, U801.2; also elsewhere on the board
VBATT_2S_IN: J401.2, J402.2; also elsewhere on the board

Notes on the sheet:
B.0 开发候选；脚位已建立，制造/成本和首板验收尚未完成。

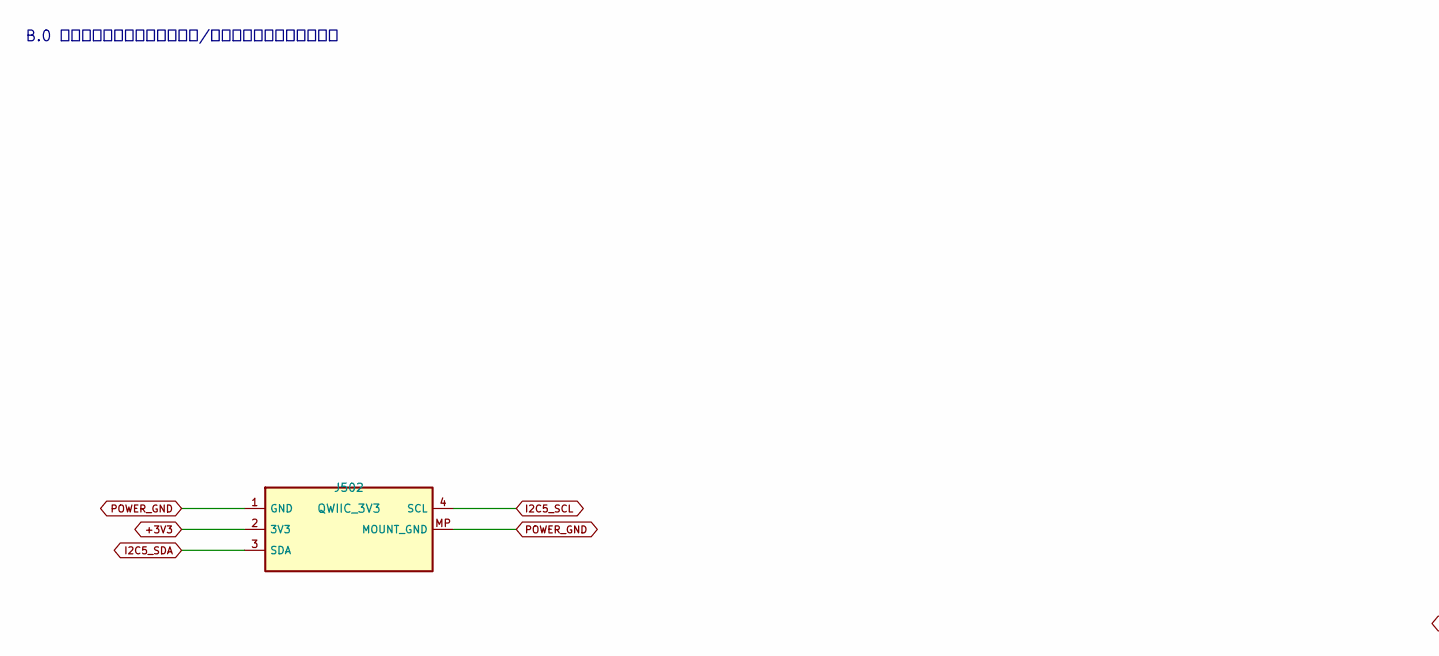
[picture p268: schematic i2c_expansion.kicad_sch, 自主HAT B.0 / i2c_expansion, part in row 1, column 1]

Parts:
J502: QWIIC_3V3; JST_SH_BM04B-SRSS-TB_1x04-1MP_P1.00mm_Vertical; MPN BM04B-SRSS-TB(LF)(SN); LCSC C160390
R501, R502: 10k; R_0603_1608Metric; MPN 0603WAF1002T5E; LCSC C25804

Connections:
+3V3: J502.2 (3V3), R501.1, R502.1; also elsewhere on the board
I2C5_SCL: J502.4 (SCL), R502.2; also elsewhere on the board
I2C5_SDA: J502.3 (SDA), R501.2; also elsewhere on the board
POWER_GND: J502.1 (GND), J502.MP (MOUNT_GND); also elsewhere on the board

Notes on the sheet:
B.0 开发候选；脚位已建立，制造/成本和首板验收尚未完成。
