parkourlrc/pcb-yilv1982--duck-robot-89dbc81d6d/docs/references/扩展板乙版降本/route-171945/before-local-repair.kicad_pcb

## KiCad design docs/references/扩展板乙版降本/route-171945/custom_hat_rev_b.kicad_pcb (continued)

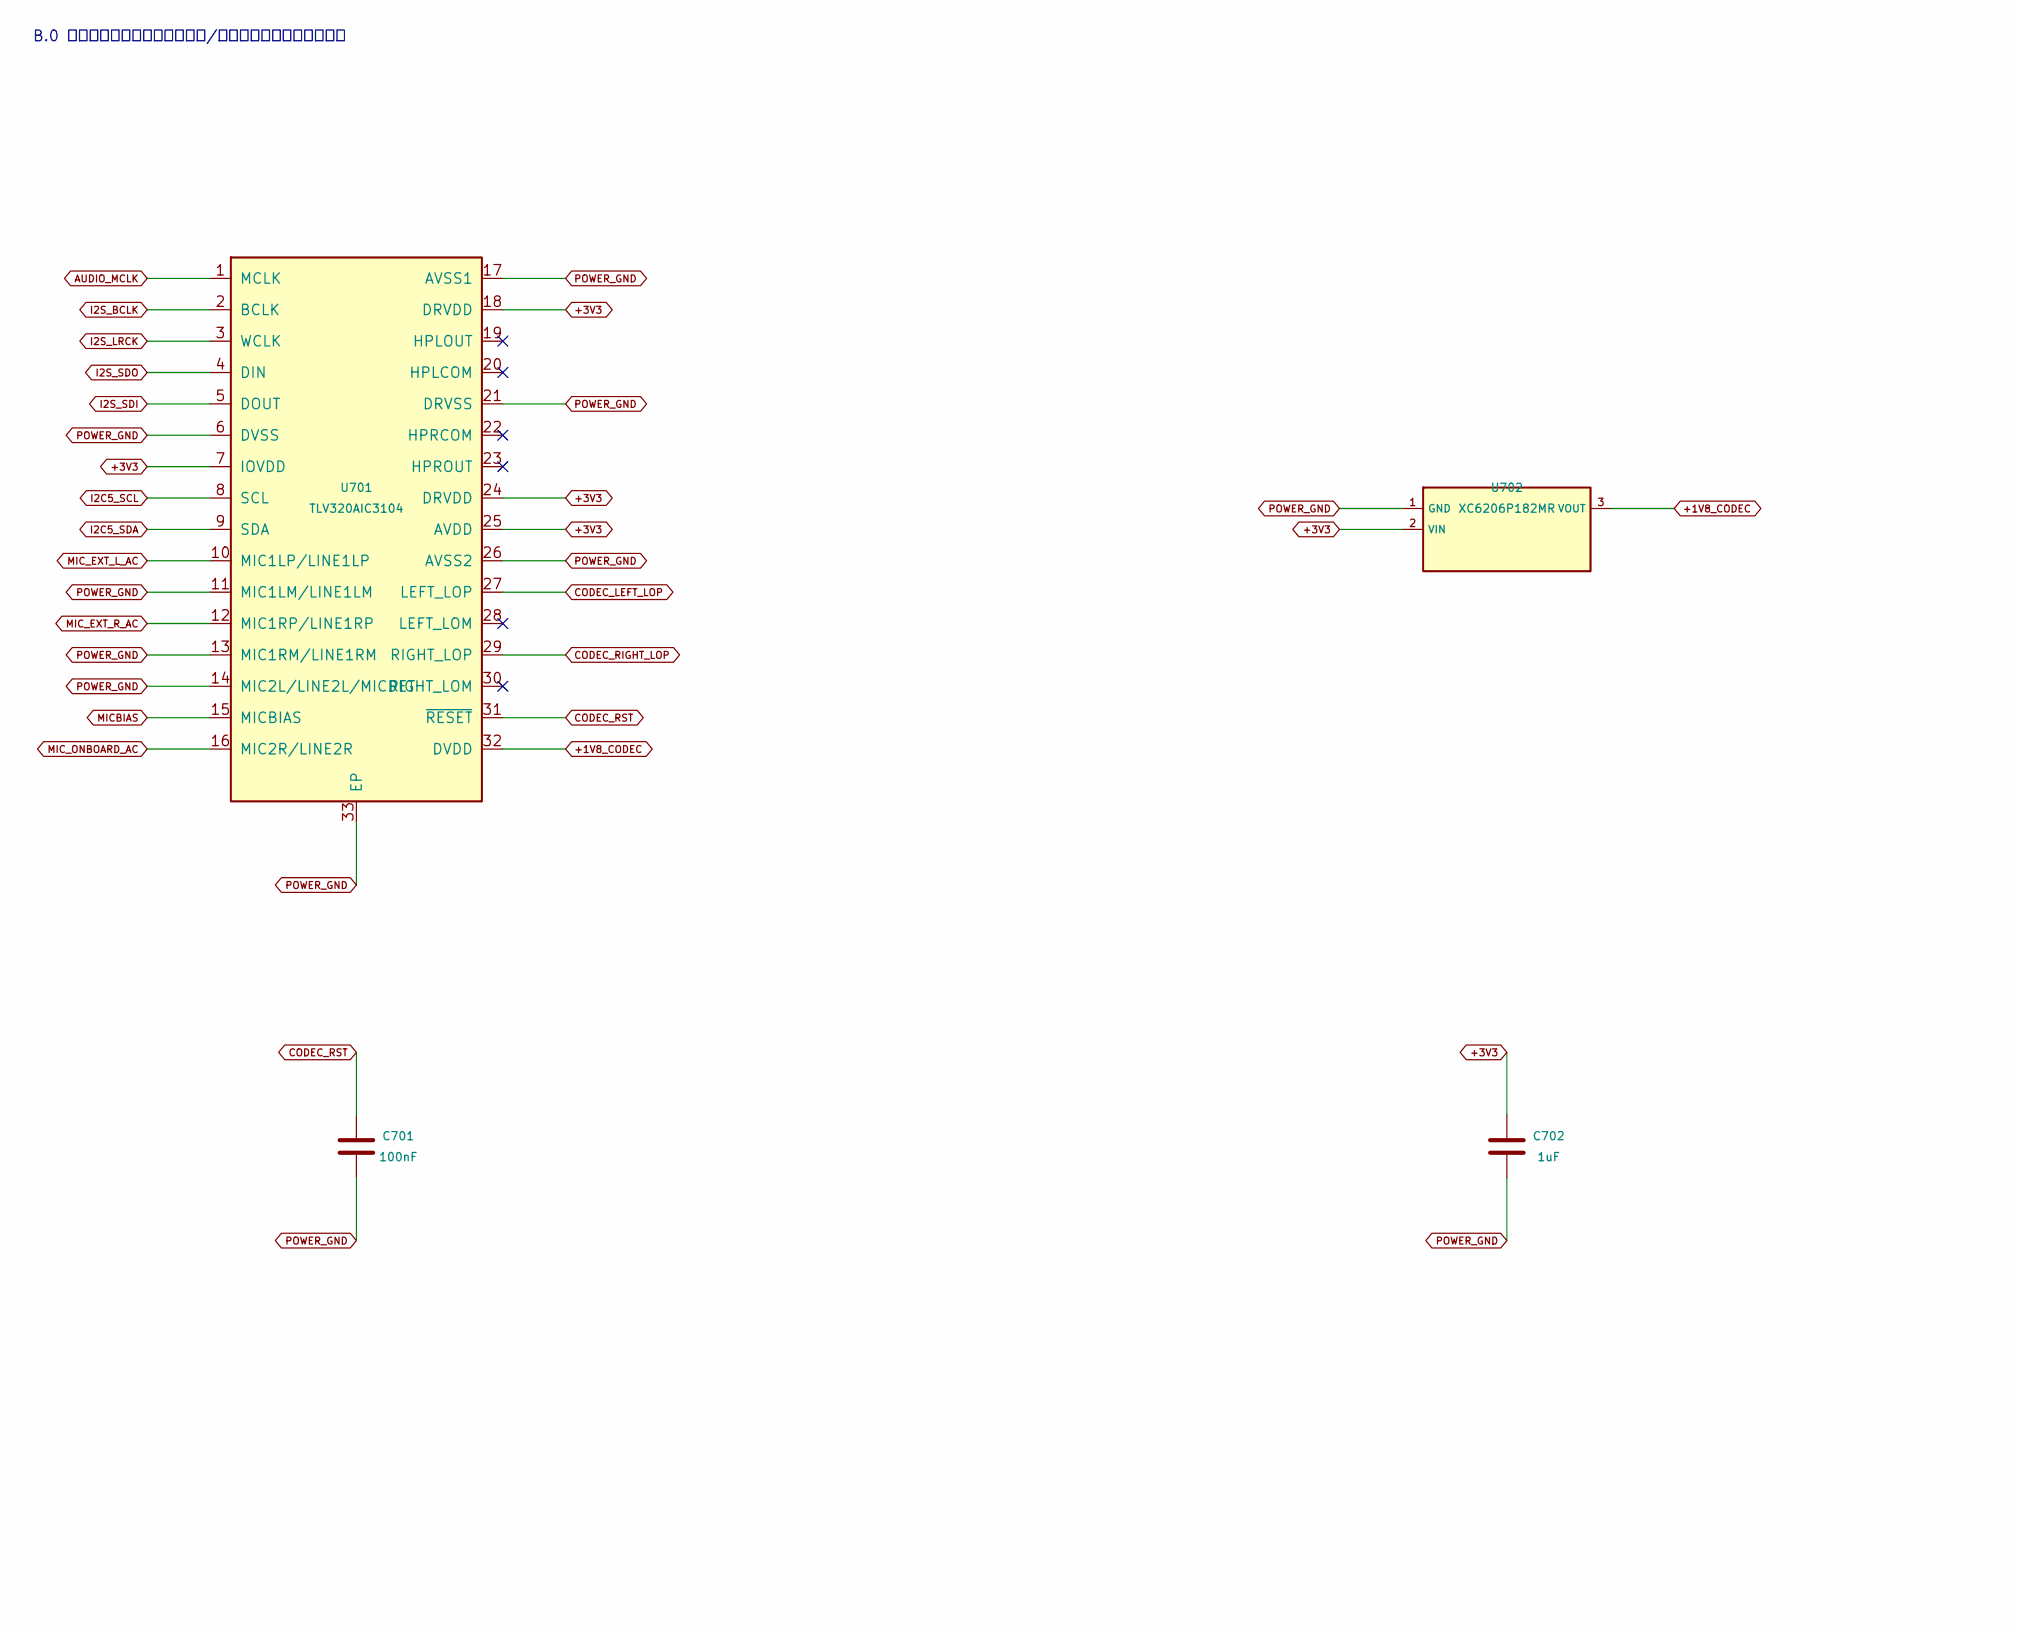
[picture p269: schematic audio_codec.kicad_sch, 自主HAT B.0 / audio_codec, part in row 1, column 1]

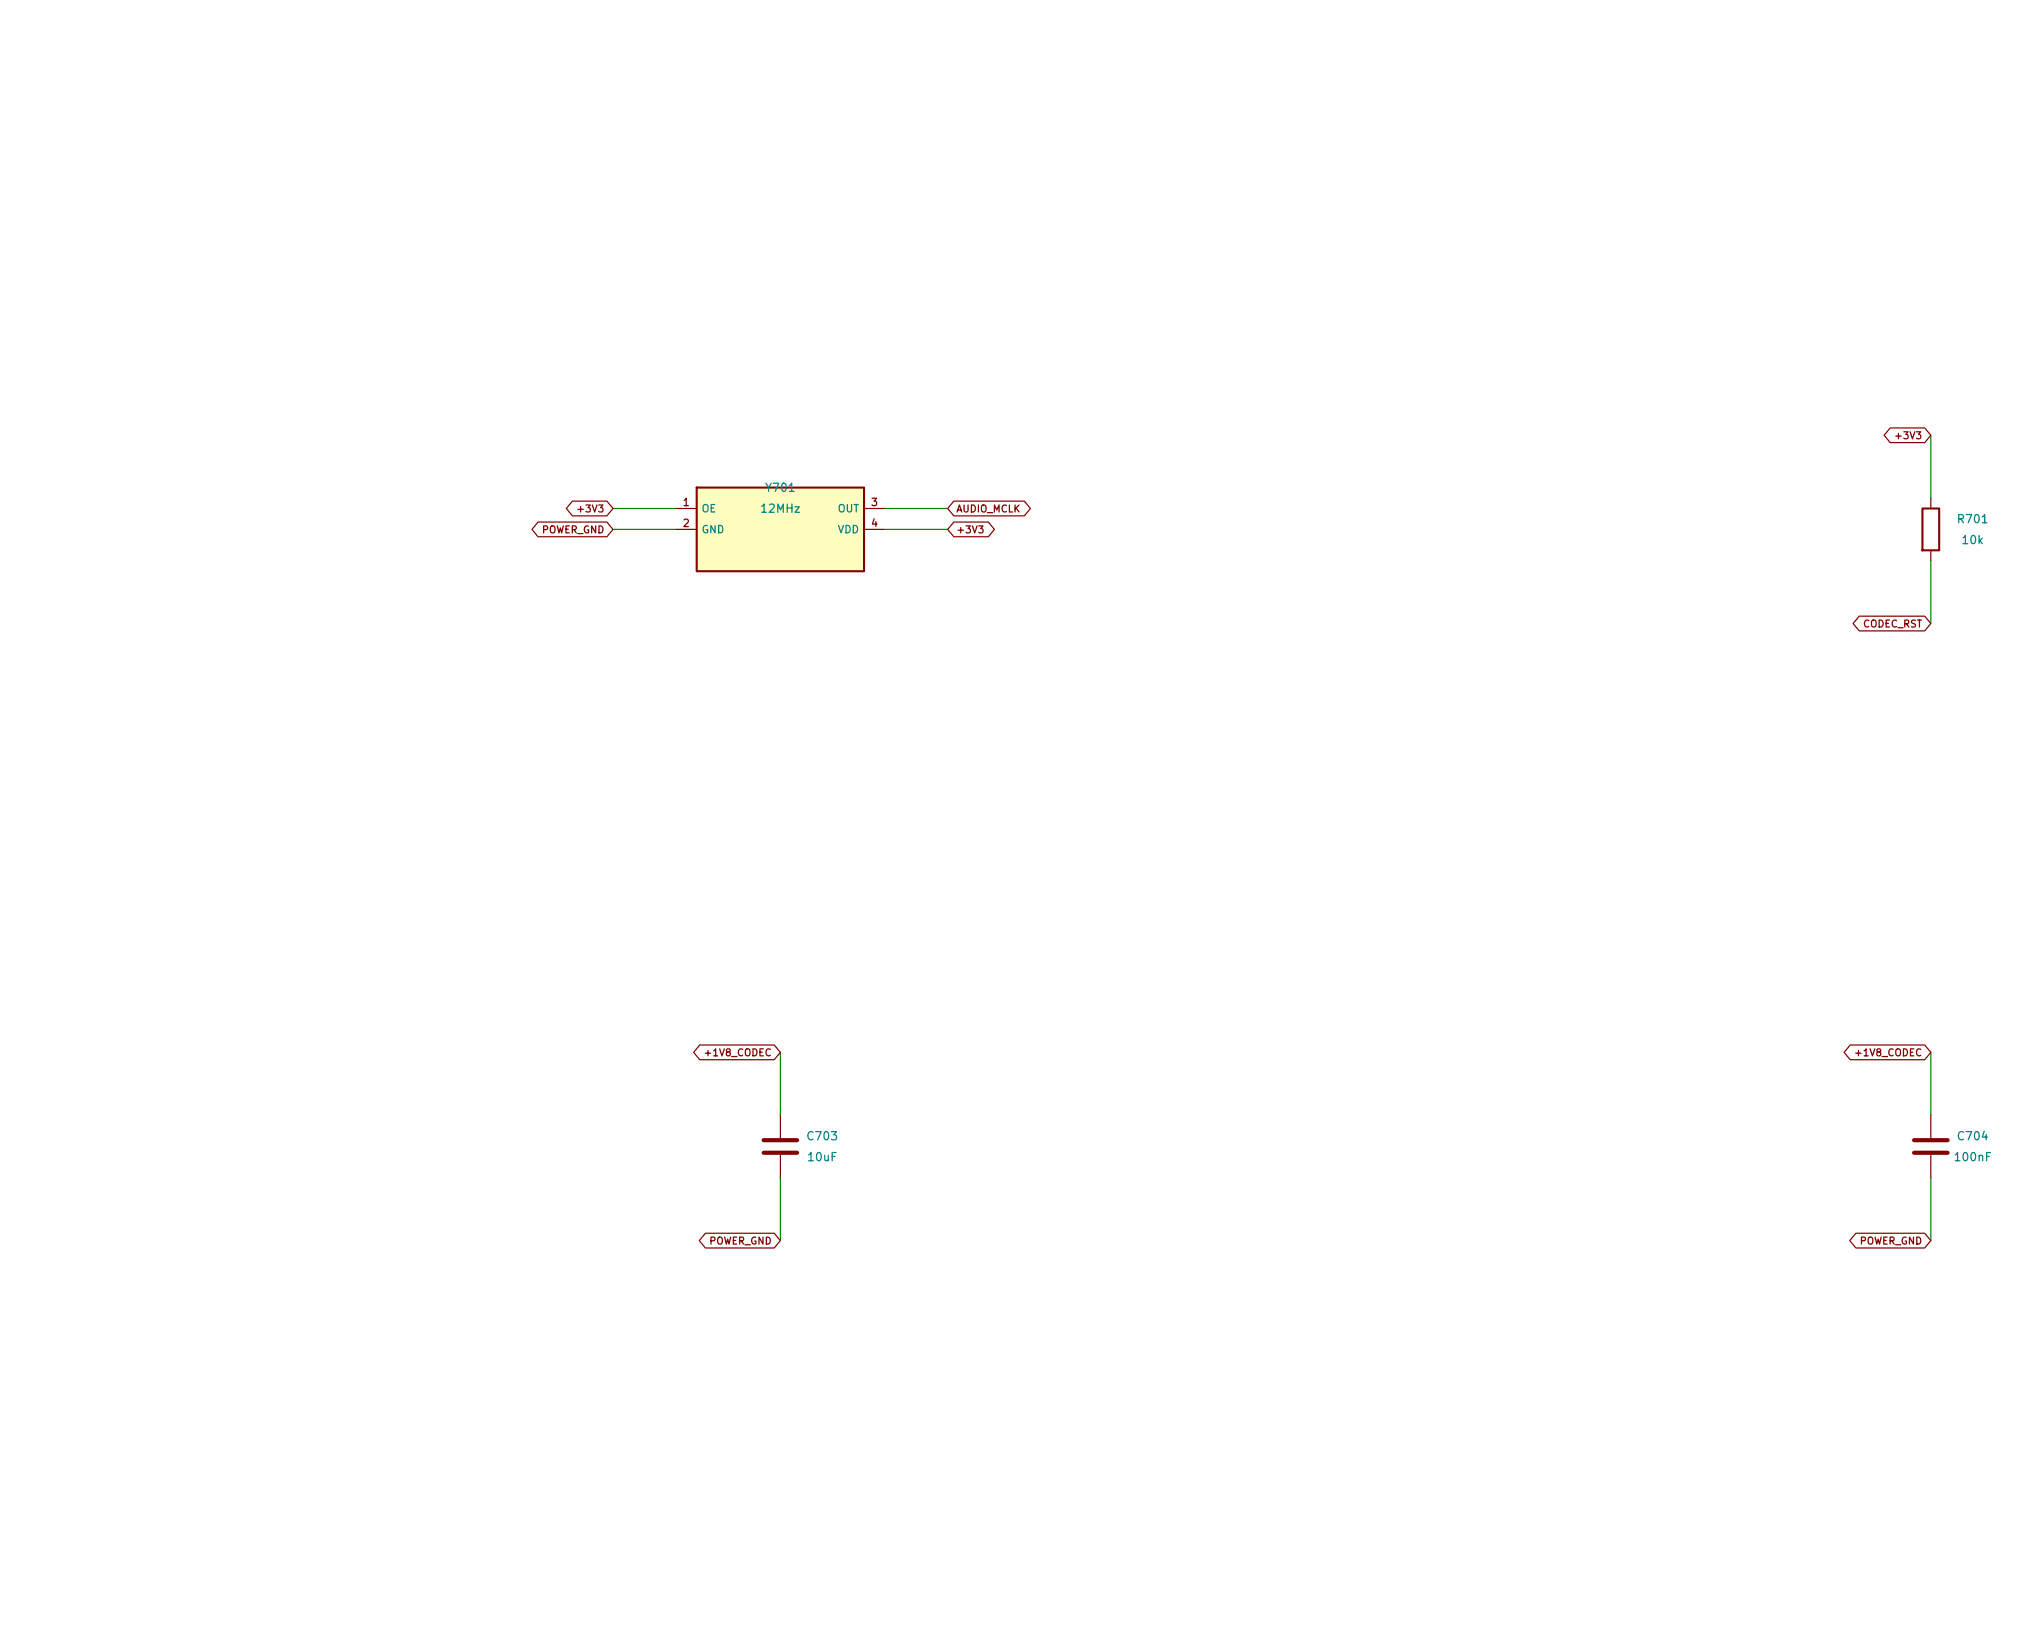
[picture p270: schematic audio_codec.kicad_sch, 自主HAT B.0 / audio_codec, part in row 1, column 2]

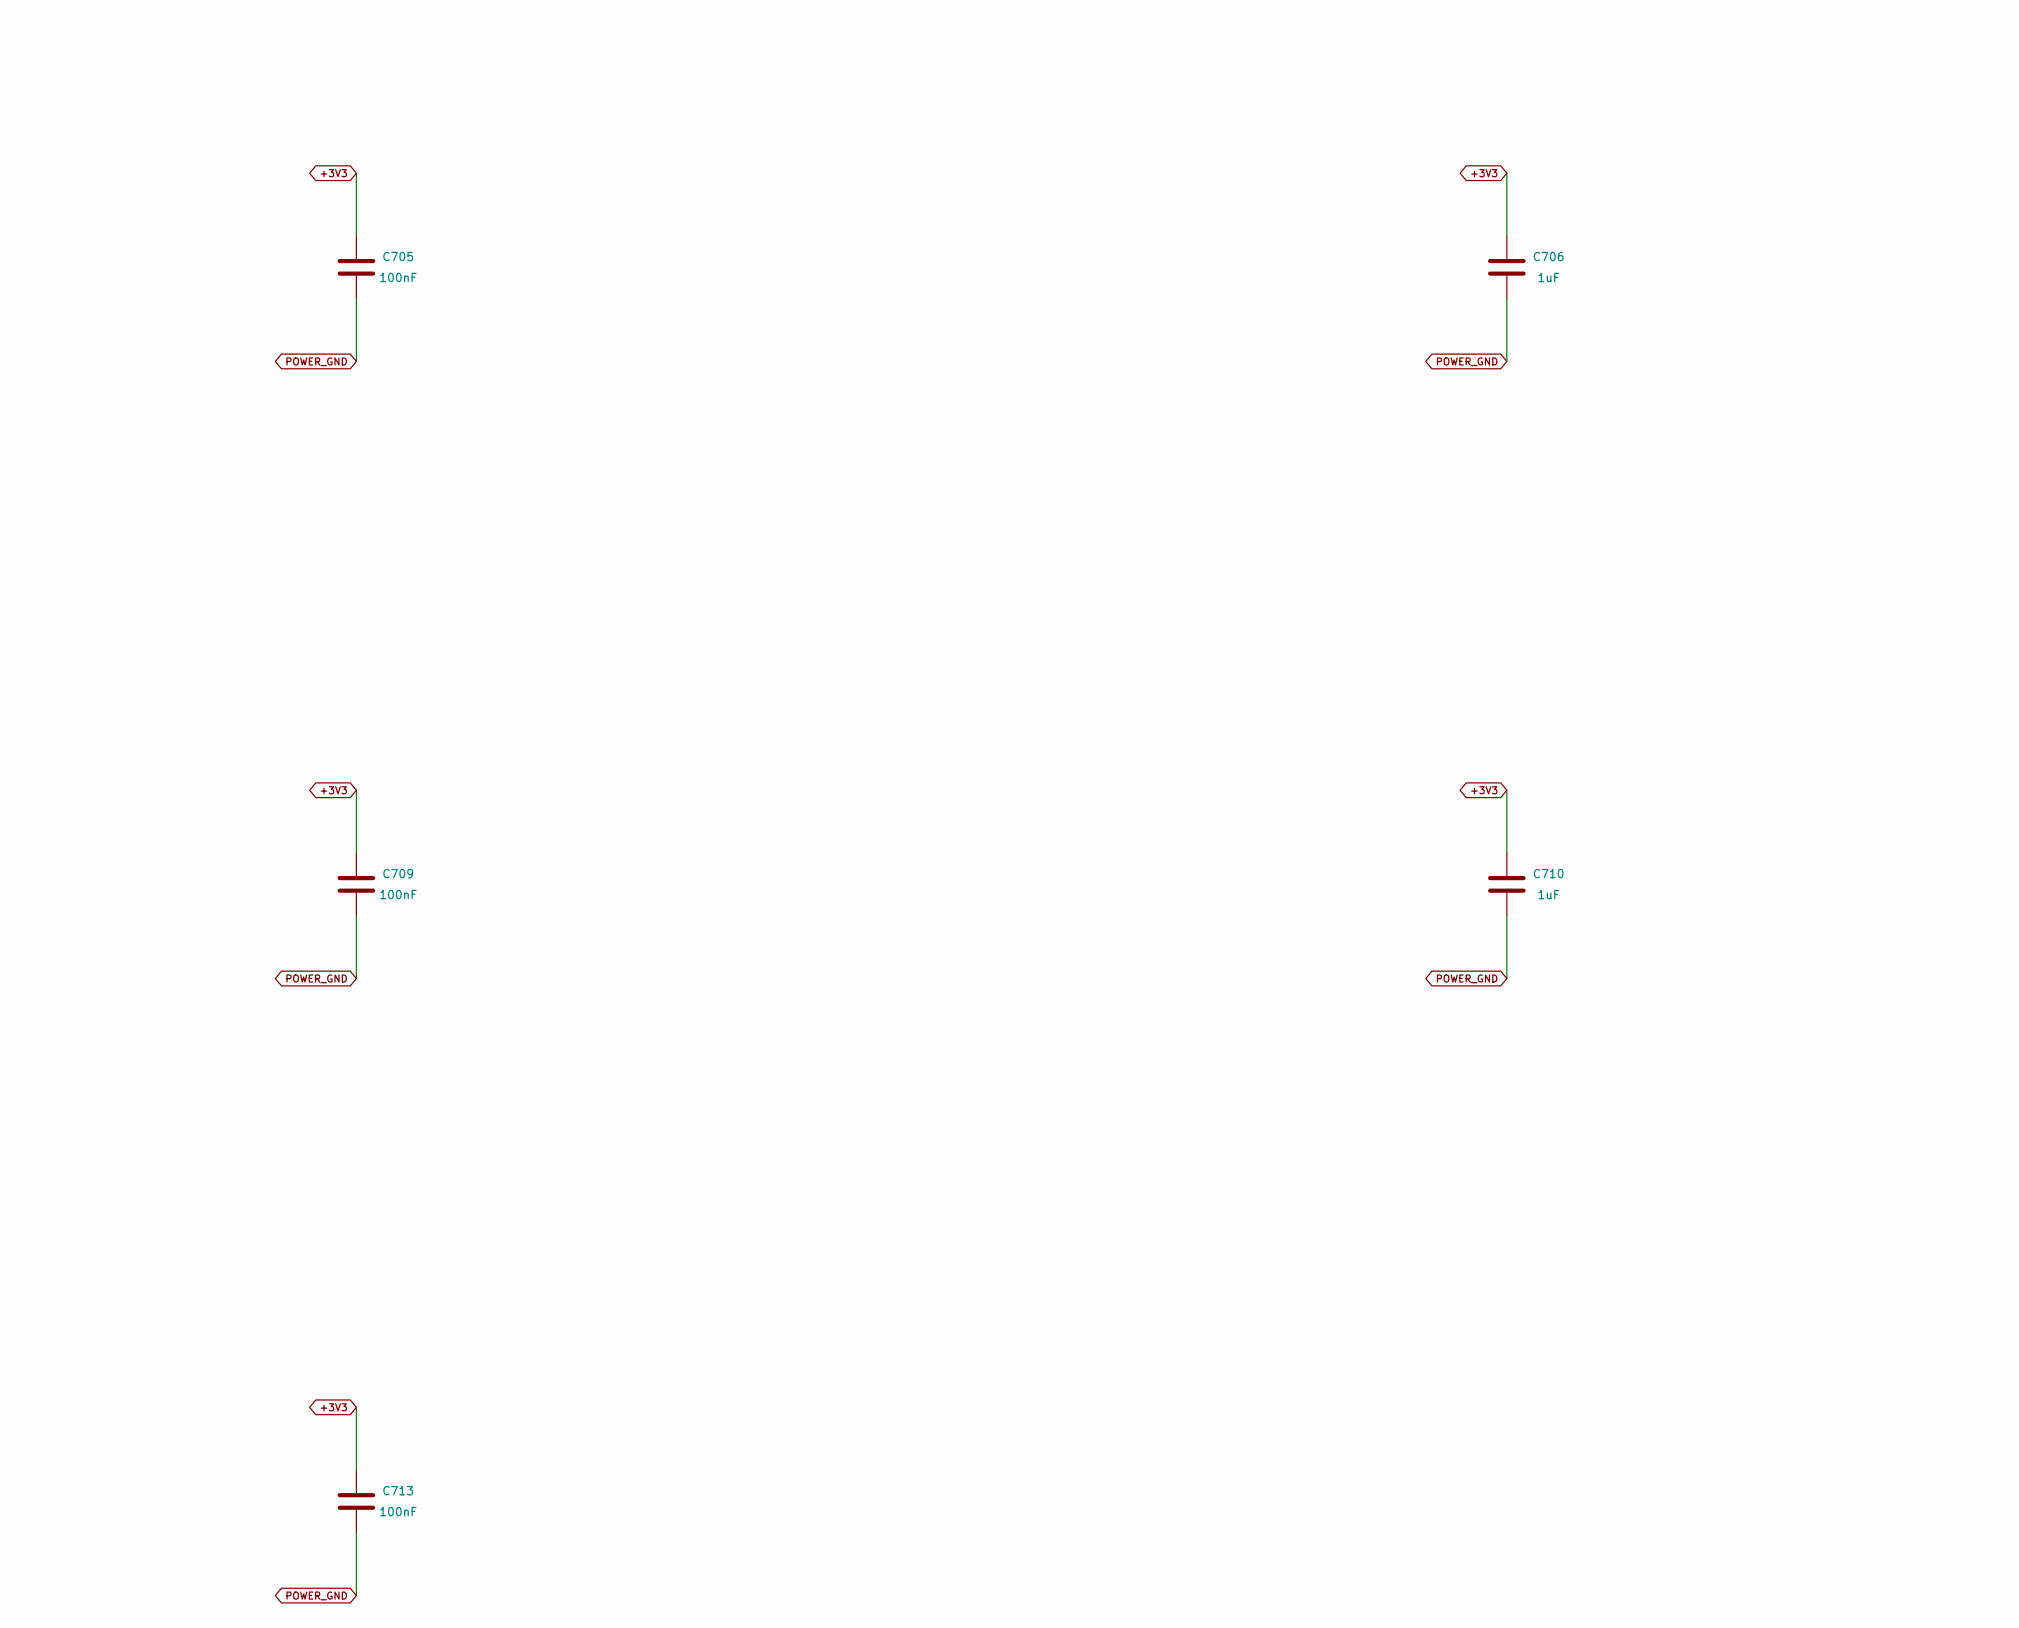
[picture p271: schematic audio_codec.kicad_sch, 自主HAT B.0 / audio_codec, part in row 2, column 1]

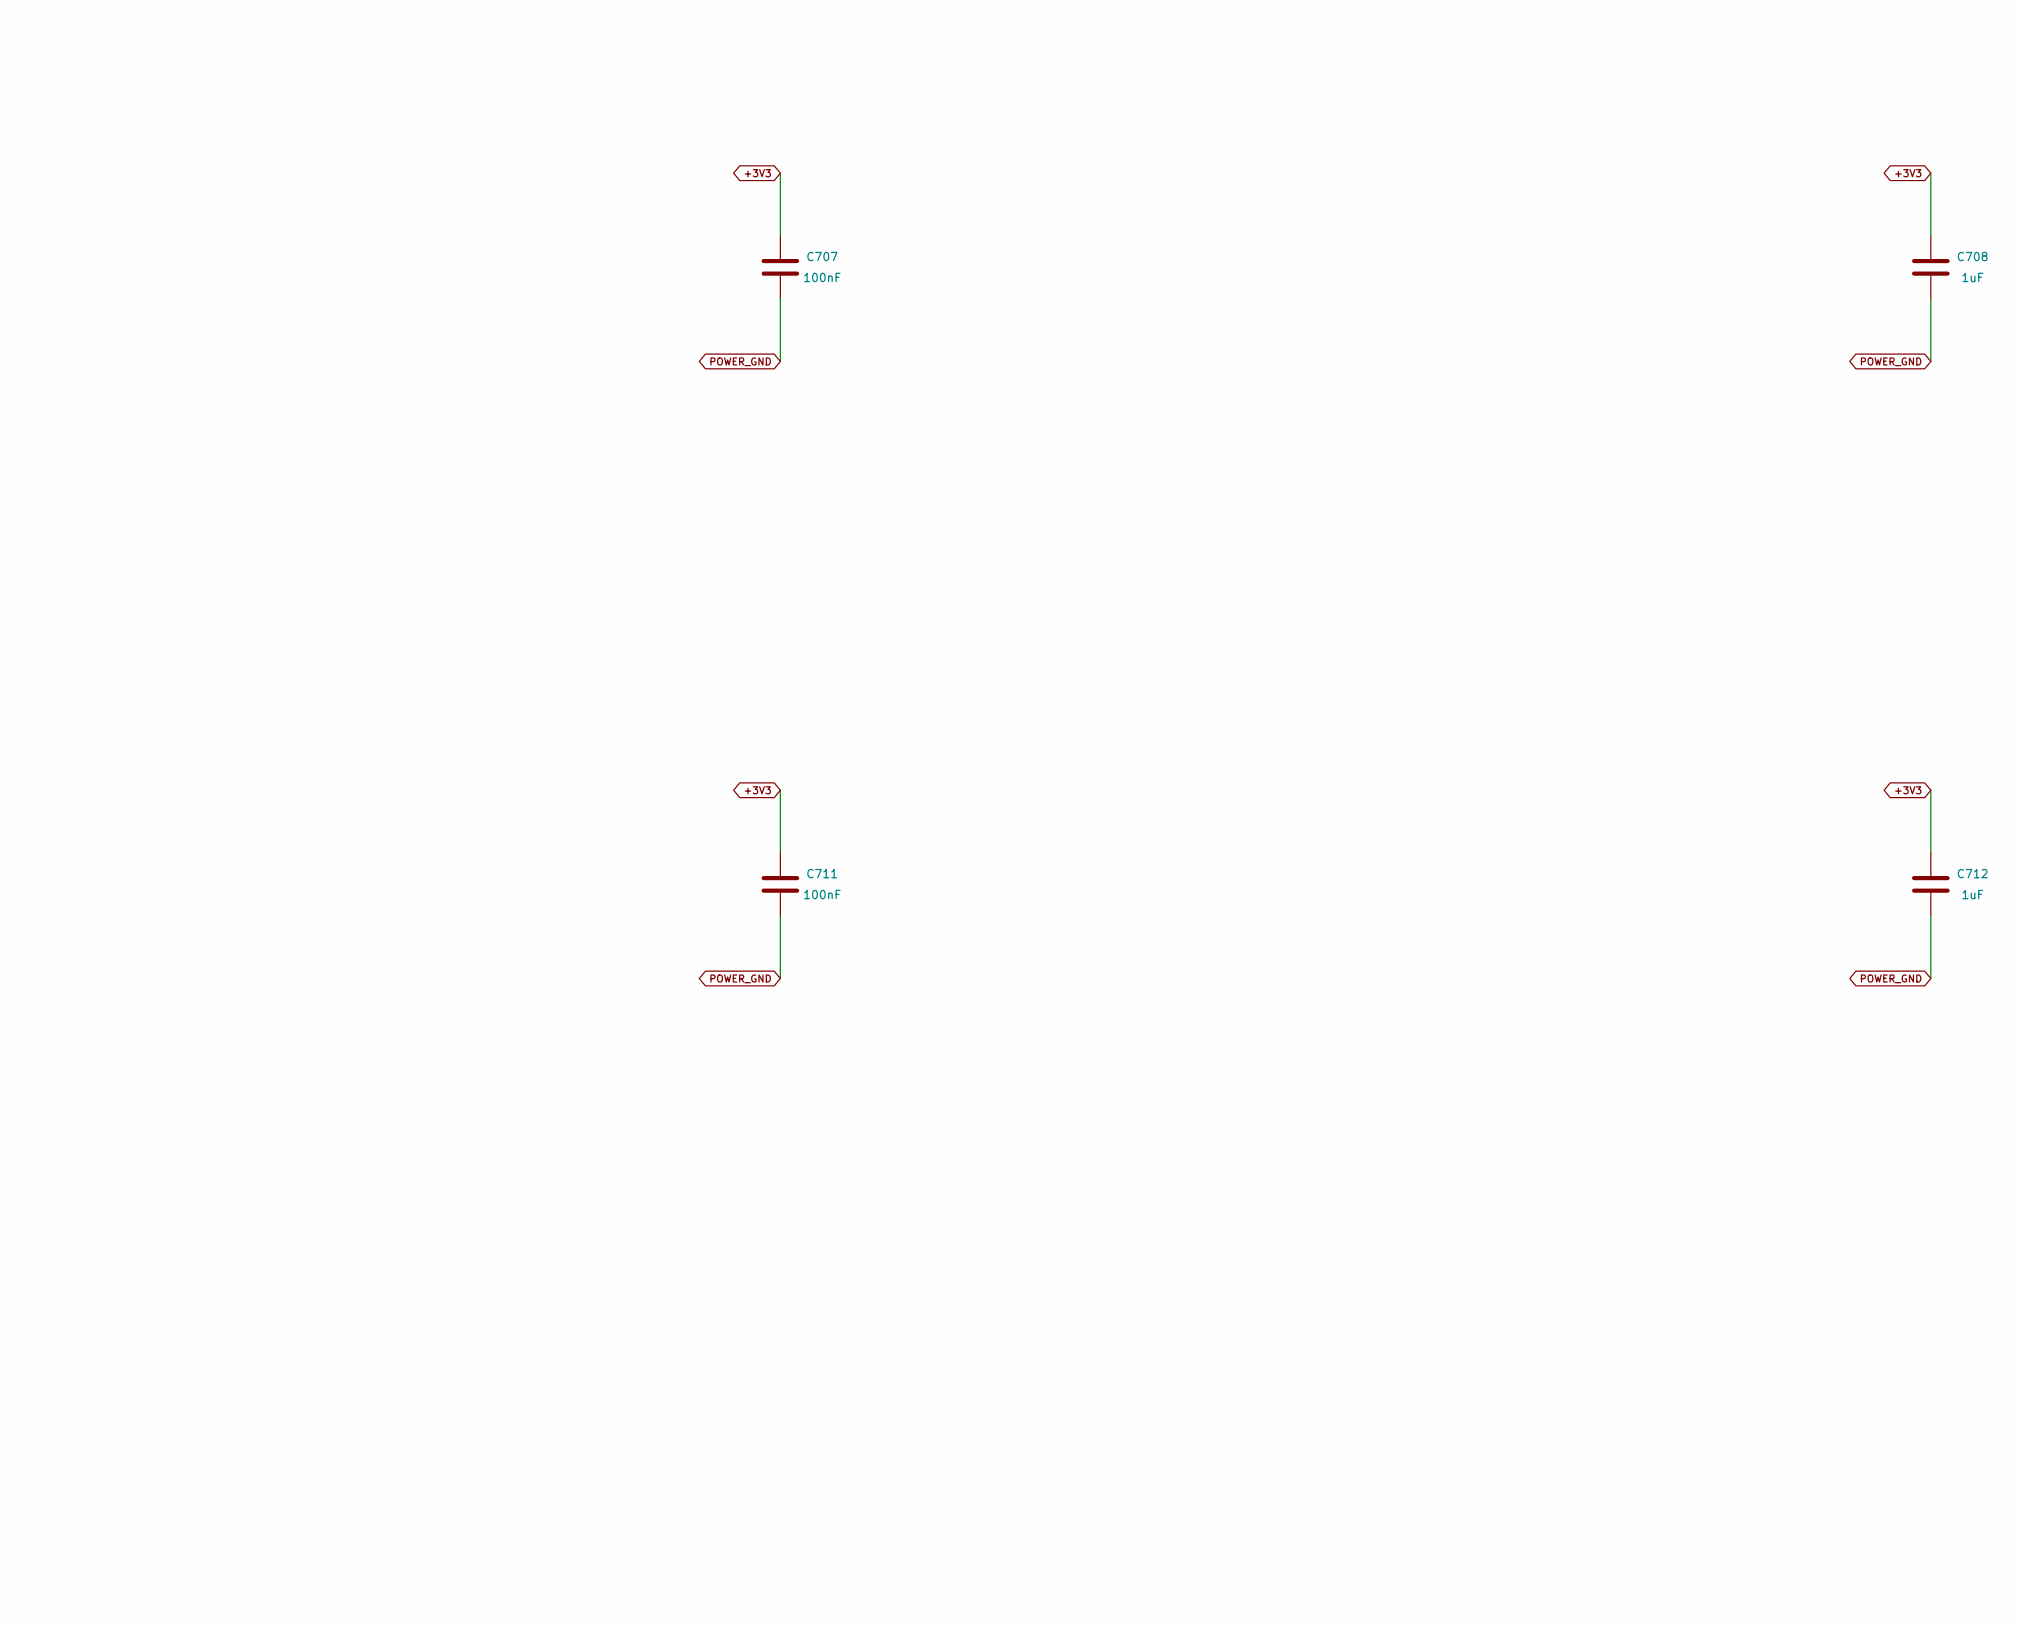
[picture p272: schematic audio_codec.kicad_sch, 自主HAT B.0 / audio_codec, part in row 2, column 2]

Parts:
C701, C704, C705, C707, C709, C711, C713: 100nF; C_0603_1608Metric; MPN CC0603KRX7R9BB104; LCSC C14663
C702, C706, C708, C710, C712: 1uF; C_0603_1608Metric; MPN CL10A105KB8NNNC; LCSC C15849
C703: 10uF; C_0603_1608Metric; MPN C1608X5R1A106KT000E; LCSC C76608
R701: 10k; R_0603_1608Metric; MPN 0603WAF1002T5E; LCSC C25804
U701: TLV320AIC3104; TI_RHB0032E_AIC3104_EP345; MPN TLV320AIC3104IRHBR; LCSC C181753
U702: XC6206P182MR; UMW_XC6206_SOT23_B; MPN XC6206P182MR; LCSC C347373
Y701: 12MHz; Oscillator_SMD_Abracon_ASDMB-4Pin_2.5x2.0mm; MPN OT3EL89CJI-111YLC-12M; LCSC C7425459

Connections:
+1V8_CODEC: C703.1, C704.1, U701.32 (DVDD), U702.3 (VOUT)
+3V3: C702.1, C705.1, C706.1, C707.1, C708.1, C709.1, C710.1, C711.1, C712.1, C713.1, R701.1, U701.7 (IOVDD), U701.18 (DRVDD), U701.24 (DRVDD), U701.25 (AVDD), U702.2 (VIN), Y701.1 (OE), Y701.4 (VDD); also elsewhere on the board
AUDIO_MCLK: U701.1 (MCLK), Y701.3 (OUT)
CODEC_LEFT_LOP: U701.27 (LEFT_LOP); also elsewhere on the board
CODEC_RIGHT_LOP: U701.29 (RIGHT_LOP); also elsewhere on the board
CODEC_RST: C701.1, R701.2, U701.31 (~RESET); also elsewhere on the board
I2C5_SCL: U701.8 (SCL); also elsewhere on the board
I2C5_SDA: U701.9 (SDA); also elsewhere on the board
I2S_BCLK: U701.2 (BCLK); also elsewhere on the board
I2S_LRCK: U701.3 (WCLK); also elsewhere on the board
I2S_SDI: U701.5 (DOUT); also elsewhere on the board
I2S_SDO: U701.4 (DIN); also elsewhere on the board
MICBIAS: U701.15 (MICBIAS); also elsewhere on the board
MIC_EXT_L_AC: U701.10 (MIC1LP/LINE1LP); also elsewhere on the board
MIC_EXT_R_AC: U701.12 (MIC1RP/LINE1RP); also elsewhere on the board
MIC_ONBOARD_AC: U701.16 (MIC2R/LINE2R); also elsewhere on the board
POWER_GND: C701.2, C702.2, C703.2, C704.2, C705.2, C706.2, C707.2, C708.2, C709.2, C710.2, C711.2, C712.2, C713.2, U701.6 (DVSS), U701.11 (MIC1LM/LINE1LM), U701.13 (MIC1RM/LINE1RM), U701.14 (MIC2L/LINE2L/MICDET), U701.17 (AVSS1), U701.21 (DRVSS), U701.26 (AVSS2), U701.33 (EP), U702.1 (GND), Y701.2 (GND); also elsewhere on the board

Notes on the sheet:
B.0 开发候选；脚位已建立，制造/成本和首板验收尚未完成。

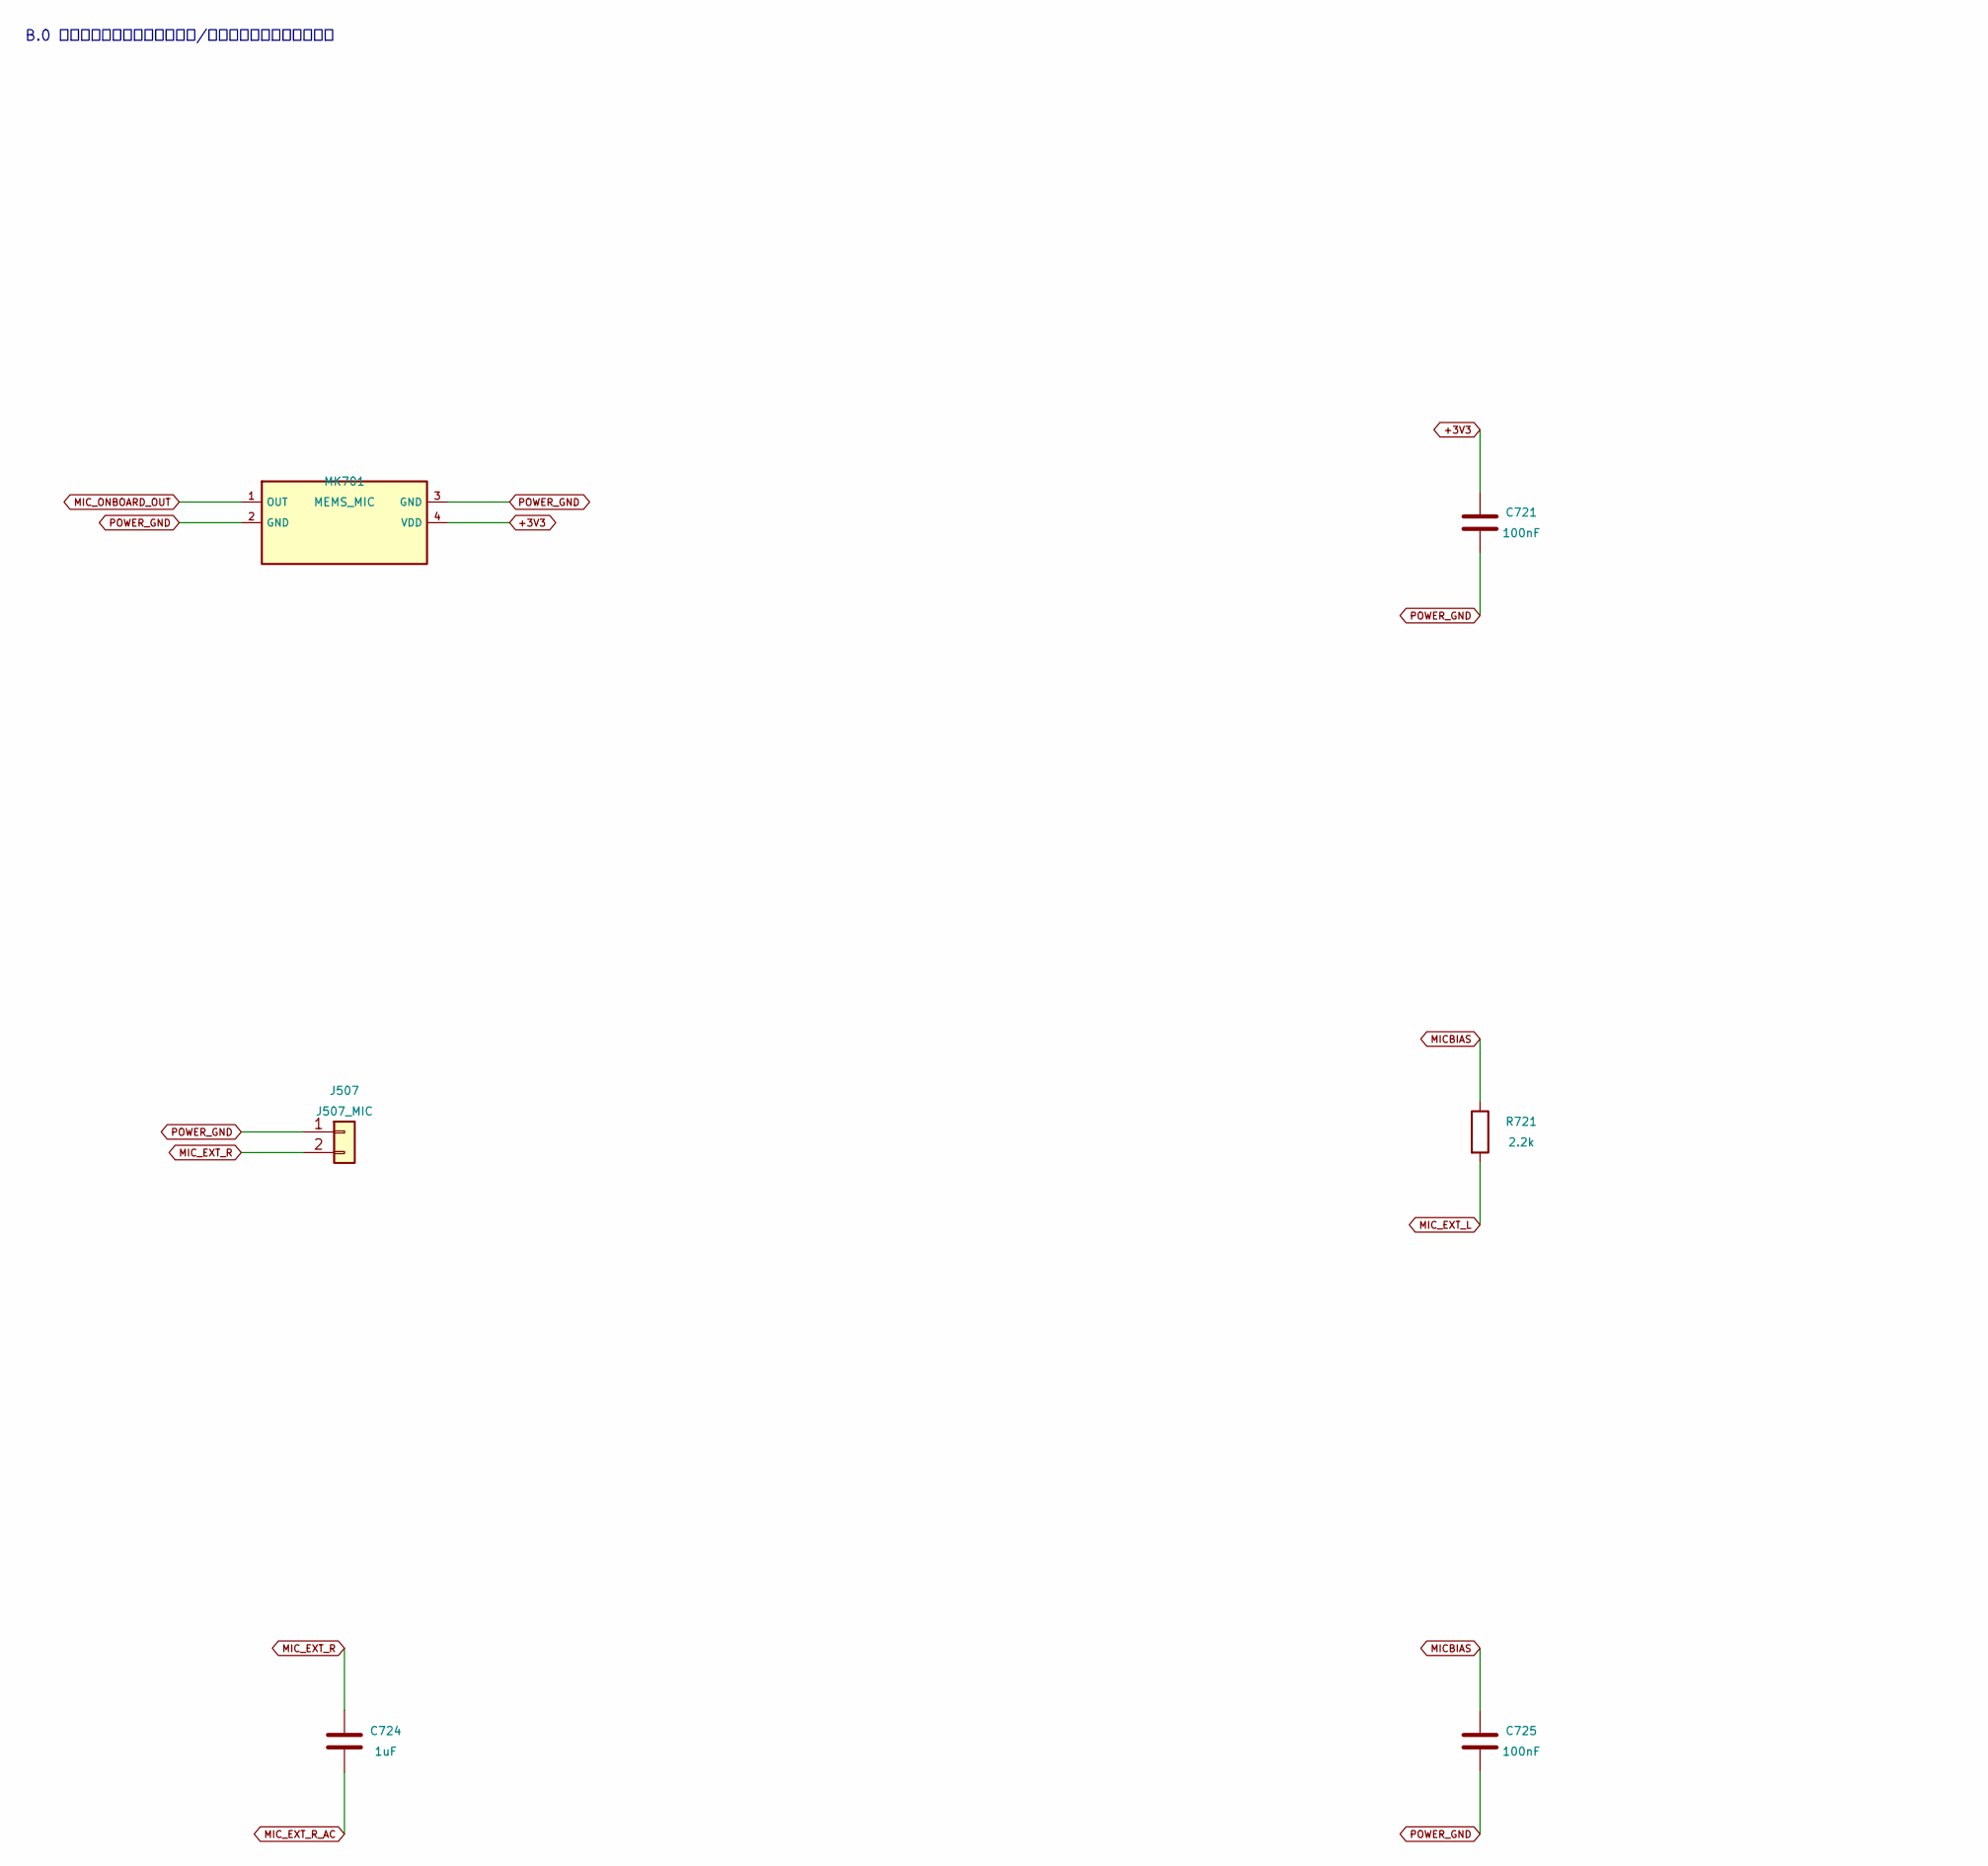
[picture p273: schematic audio_io.kicad_sch, 自主HAT B.0 / audio_io, part in row 1, column 1]

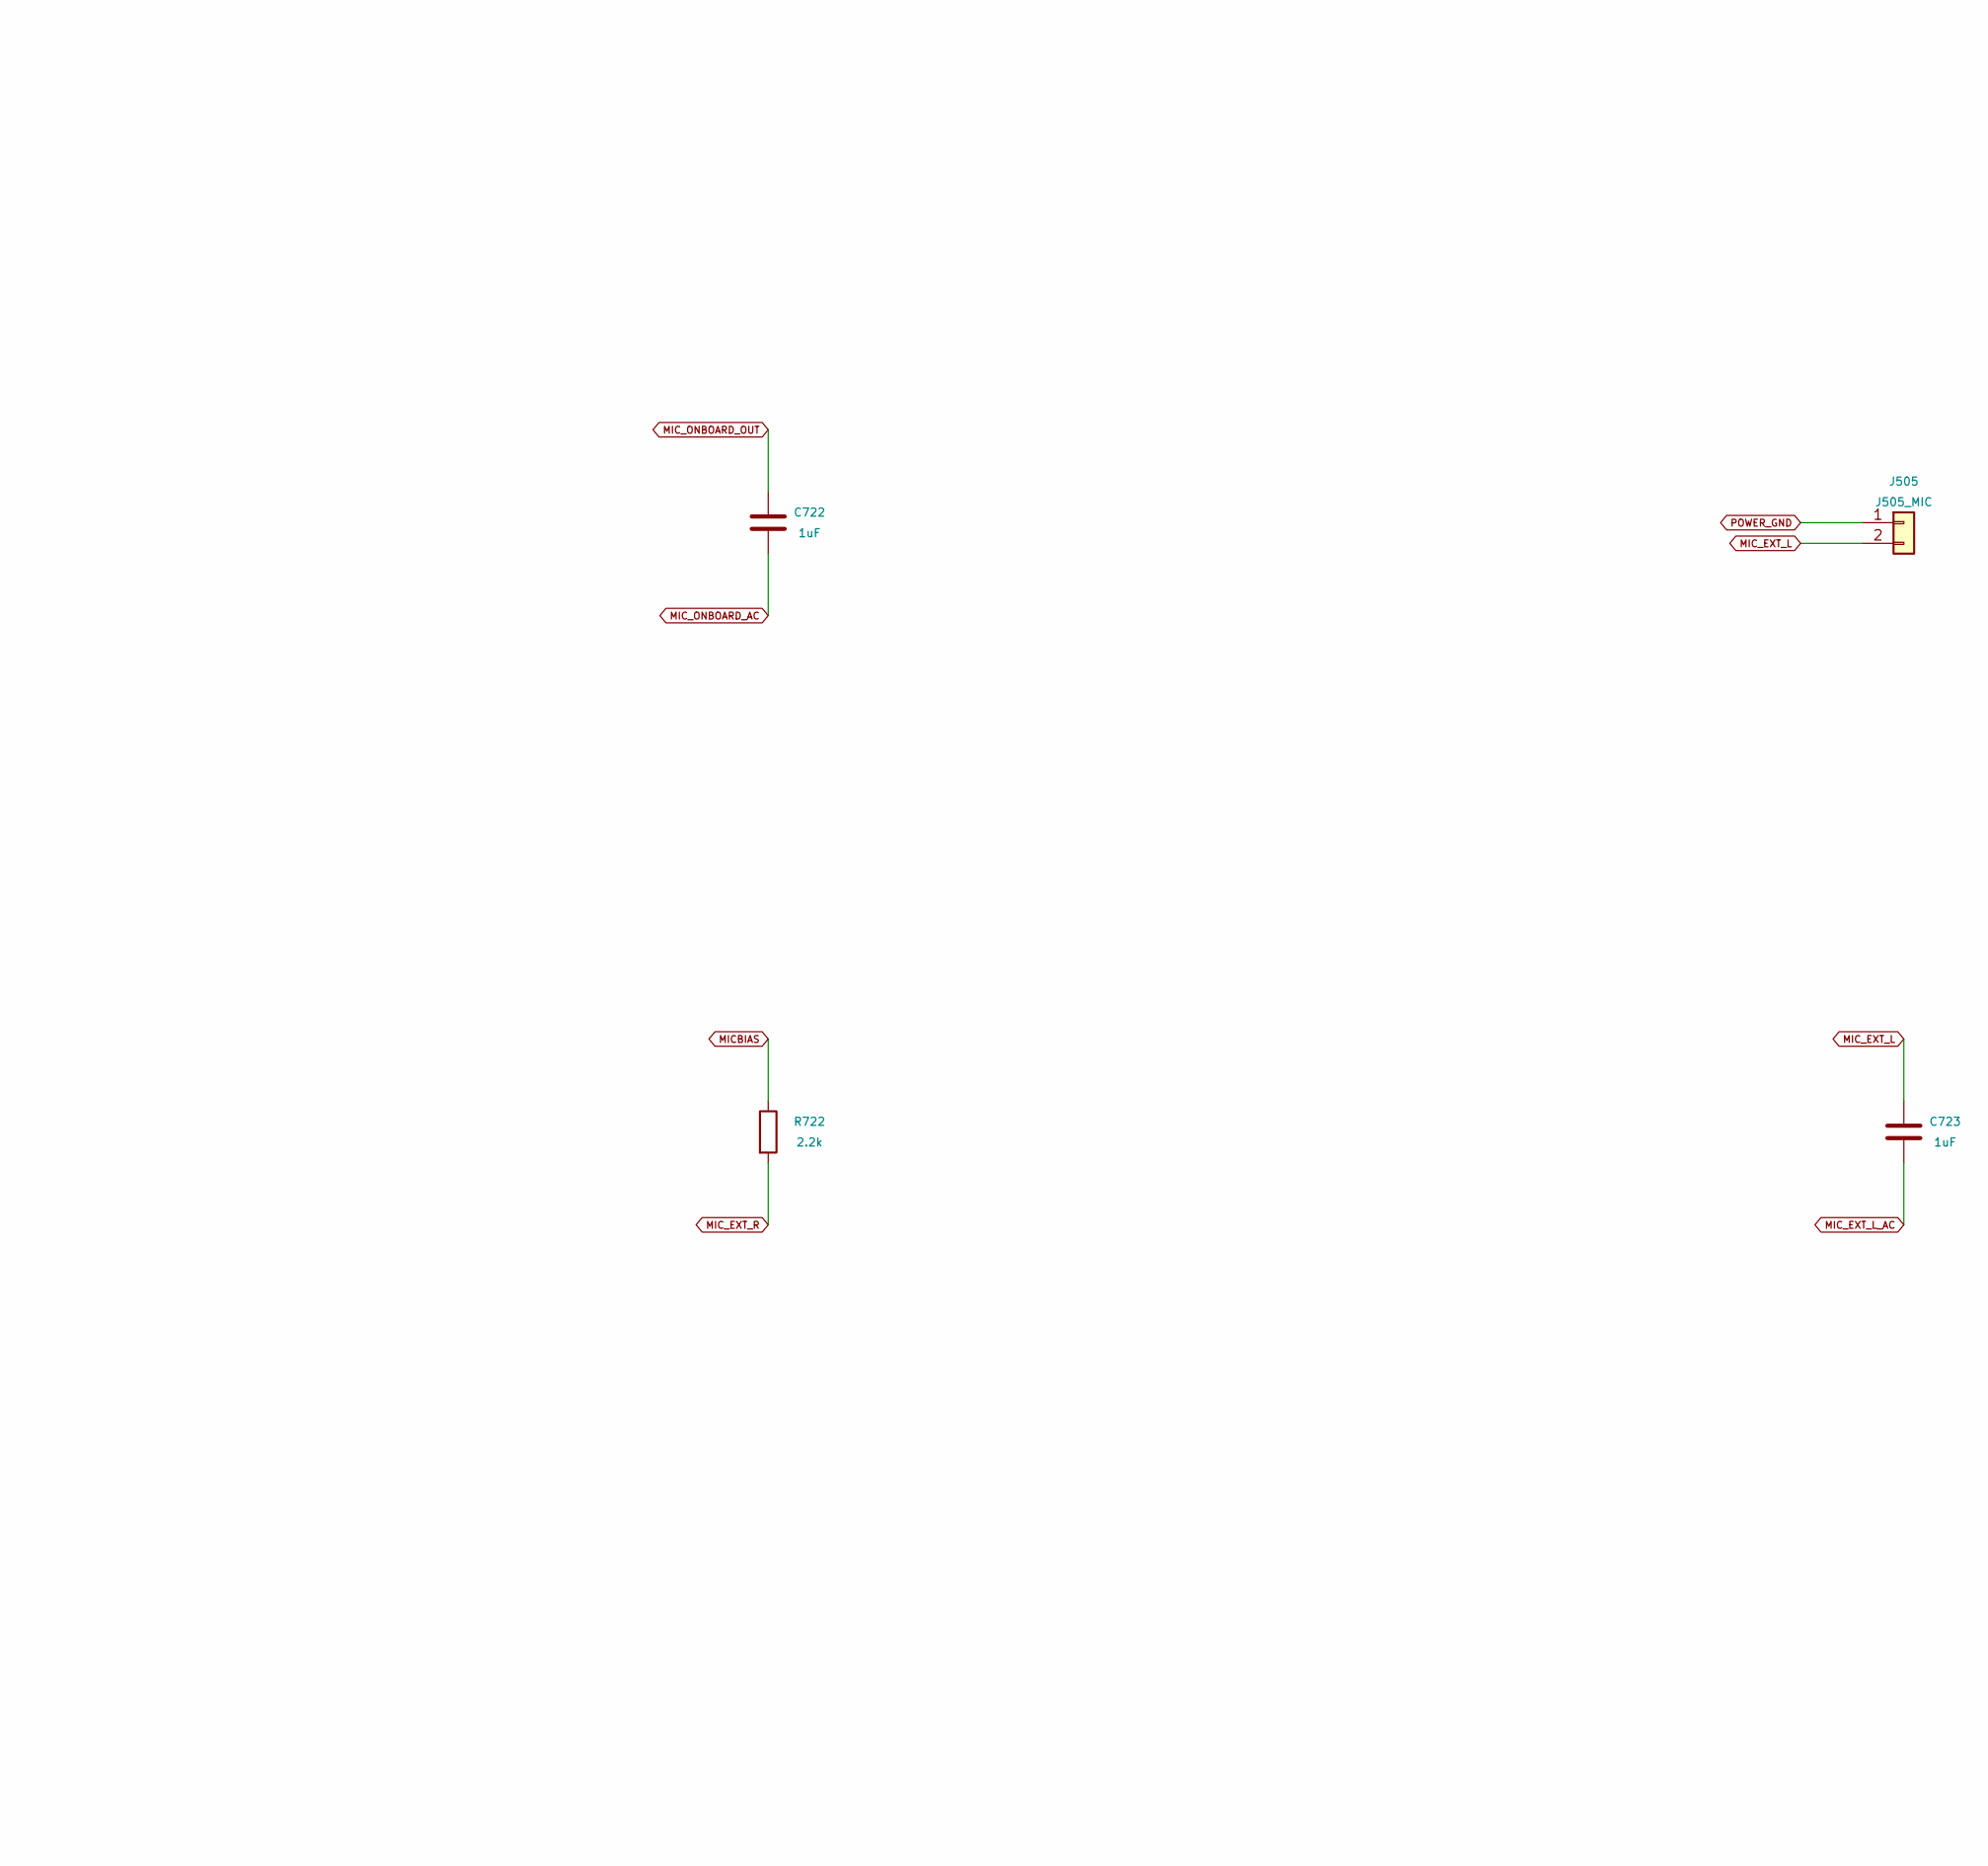
[picture p274: schematic audio_io.kicad_sch, 自主HAT B.0 / audio_io, part in row 1, column 2]

Parts:
C721, C725: 100nF; C_0603_1608Metric; MPN CC0603KRX7R9BB104; LCSC C14663
C722, C723, C724: 1uF; C_0603_1608Metric; MPN CL10A105KB8NNNC; LCSC C15849
J505: J505_MIC; A1251_2P_B; MPN A1251WV-2P; LCSC C5333427
J507: J507_MIC; A1251_2P_B; MPN A1251WV-2P; LCSC C5333427
MK701: MEMS_MIC; LMA2718_B; MPN LMA2718T421-OA5-2; LCSC C7587901
R721, R722: 2.2k; R_0603_1608Metric; MPN 0603WAF2201T5E; LCSC C4190

Connections:
+3V3: C721.1, MK701.4 (VDD); also elsewhere on the board
MICBIAS: C725.1, R721.1, R722.1; also elsewhere on the board
MIC_EXT_L: C723.1, J505.2, R721.2
MIC_EXT_L_AC: C723.2; also elsewhere on the board
MIC_EXT_R: C724.1, J507.2, R722.2
MIC_EXT_R_AC: C724.2; also elsewhere on the board
MIC_ONBOARD_AC: C722.2; also elsewhere on the board
MIC_ONBOARD_OUT: C722.1, MK701.1 (OUT)
POWER_GND: C721.2, C725.2, J505.1, J507.1, MK701.2 (GND), MK701.3 (GND); also elsewhere on the board

Notes on the sheet:
B.0 开发候选；脚位已建立，制造/成本和首板验收尚未完成。
