parkourlrc/pcb-yilv1982--duck-robot-89dbc81d6d/hardware/custom_hat/rev_a/custom_hat_rev_a.kicad_pcb

## KiCad design hardware/custom_hat/rev_a/custom_hat_rev_a.kicad_pcb (2026-11-05, an earlier design)

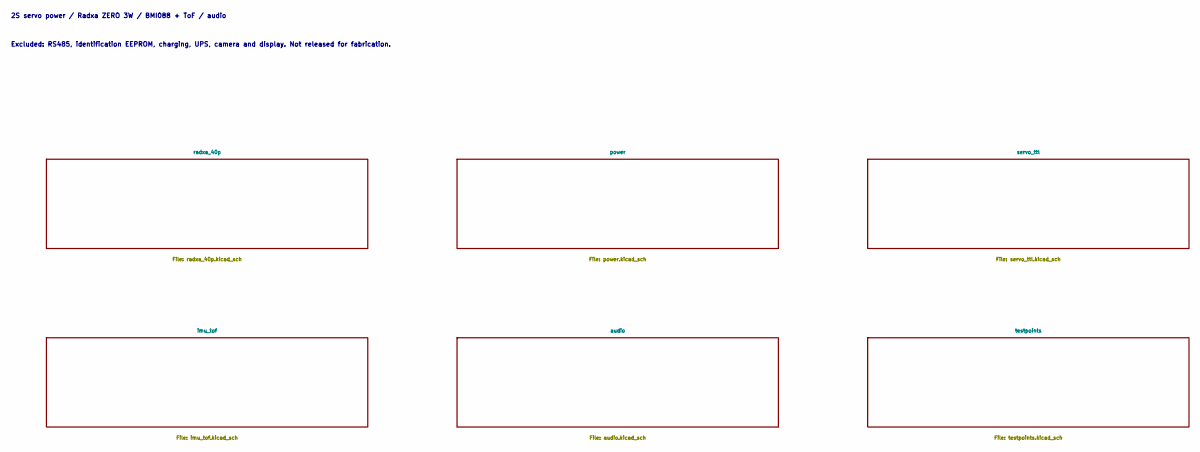
[picture p280: schematic custom_hat_rev_a.kicad_sch, Custom HAT Rev A - functional schematic]

Notes on the sheet:
2S servo power / Radxa ZERO 3W / BMI088 + ToF / audio
Excluded: RS485, identification EEPROM, charging, UPS, camera and display. Not released for fabrication.

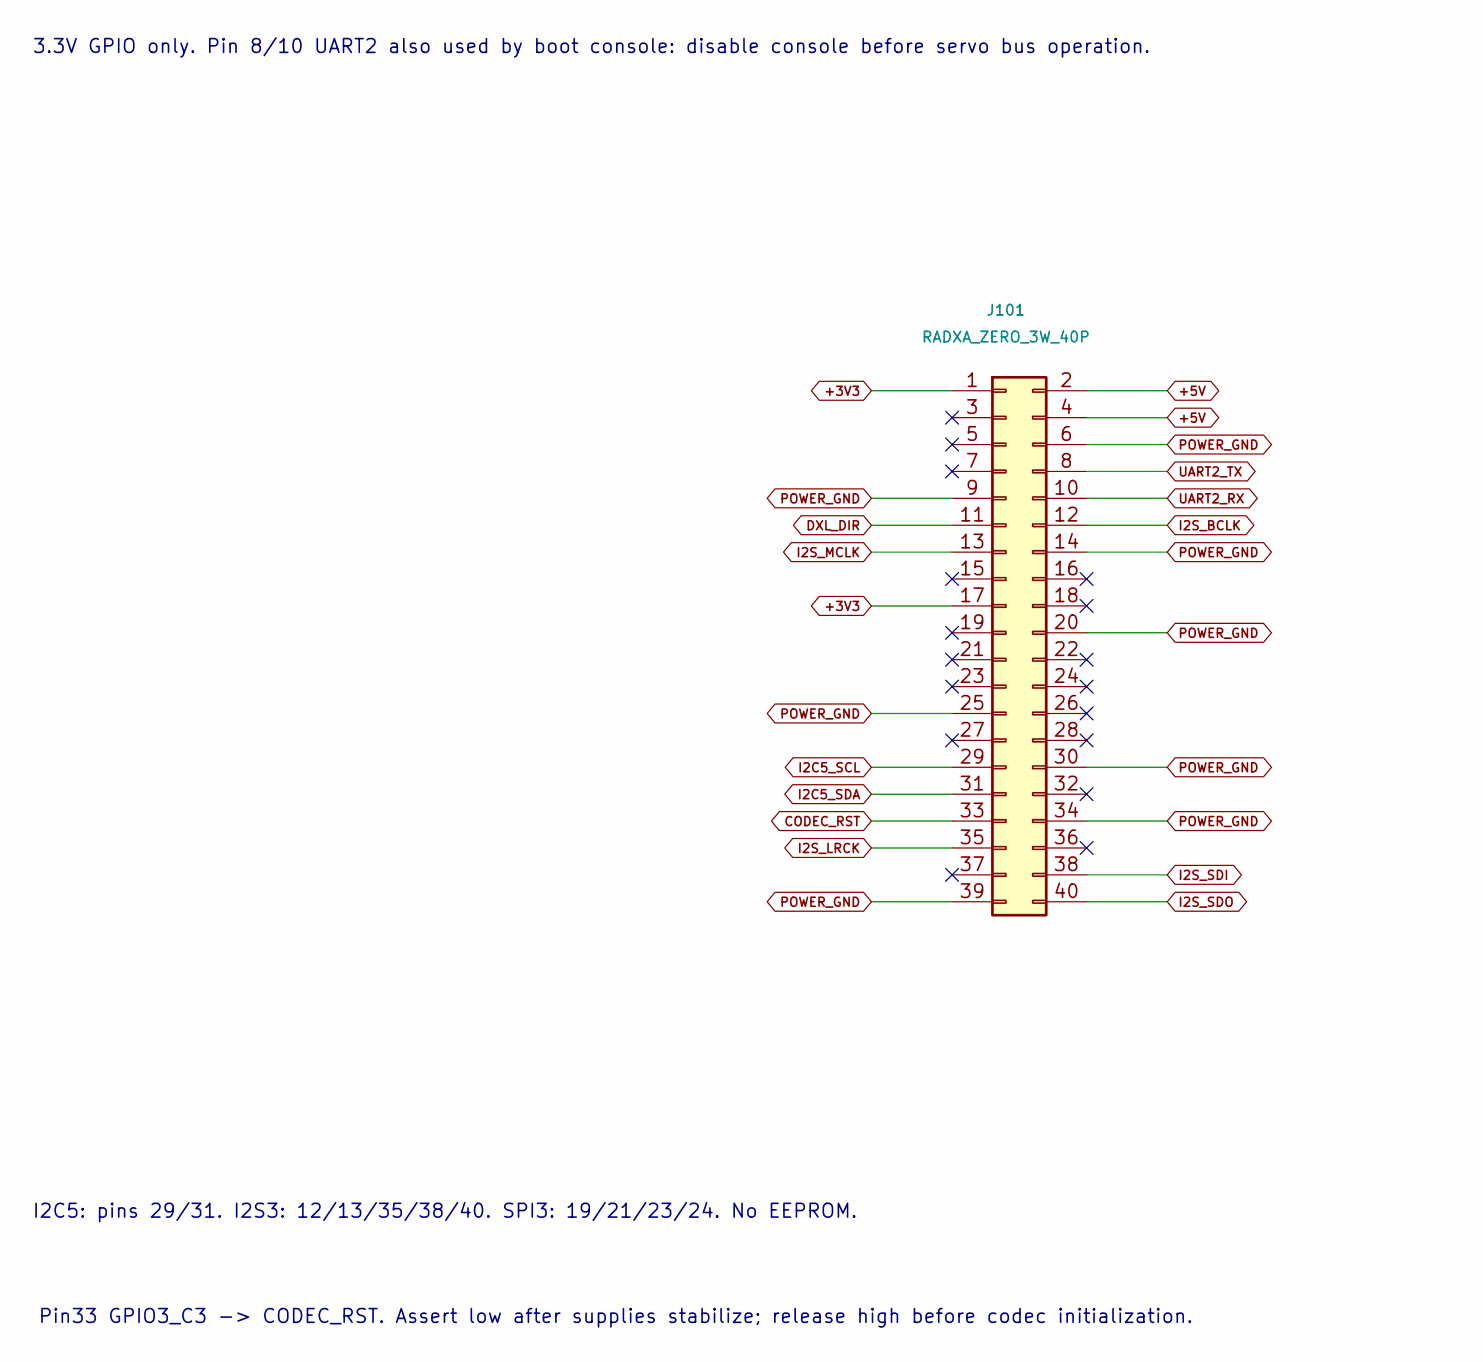
[picture p281: schematic radxa_40p.kicad_sch, Radxa ZERO 3W - 40-pin interface / 3.3V logic]

Parts:
J101: RADXA_ZERO_3W_40P; Radxa40P_Samtec_SSW120; MPN SSW-120-01-G-D

Connections:
+3V3: J101.1, J101.17; also elsewhere on the board
+5V: J101.2, J101.4; also elsewhere on the board
CODEC_RST: J101.33; also elsewhere on the board
DXL_DIR: J101.11; also elsewhere on the board
I2C5_SCL: J101.29; also elsewhere on the board
I2C5_SDA: J101.31; also elsewhere on the board
I2S_BCLK: J101.12; also elsewhere on the board
I2S_LRCK: J101.35; also elsewhere on the board
I2S_MCLK: J101.13; also elsewhere on the board
I2S_SDI: J101.38; also elsewhere on the board
I2S_SDO: J101.40; also elsewhere on the board
POWER_GND: J101.6, J101.9, J101.14, J101.20, J101.25, J101.30, J101.34, J101.39; also elsewhere on the board
UART2_RX: J101.10; also elsewhere on the board
UART2_TX: J101.8; also elsewhere on the board

Notes on the sheet:
3.3V GPIO only. Pin 8/10 UART2 also used by boot console: disable console before servo bus operation.
I2C5: pins 29/31. I2S3: 12/13/35/38/40. SPI3: 19/21/23/24. No EEPROM.
Pin33 GPIO3_C3 -> CODEC_RST. Assert low after supplies stabilize; release high before codec initialization.

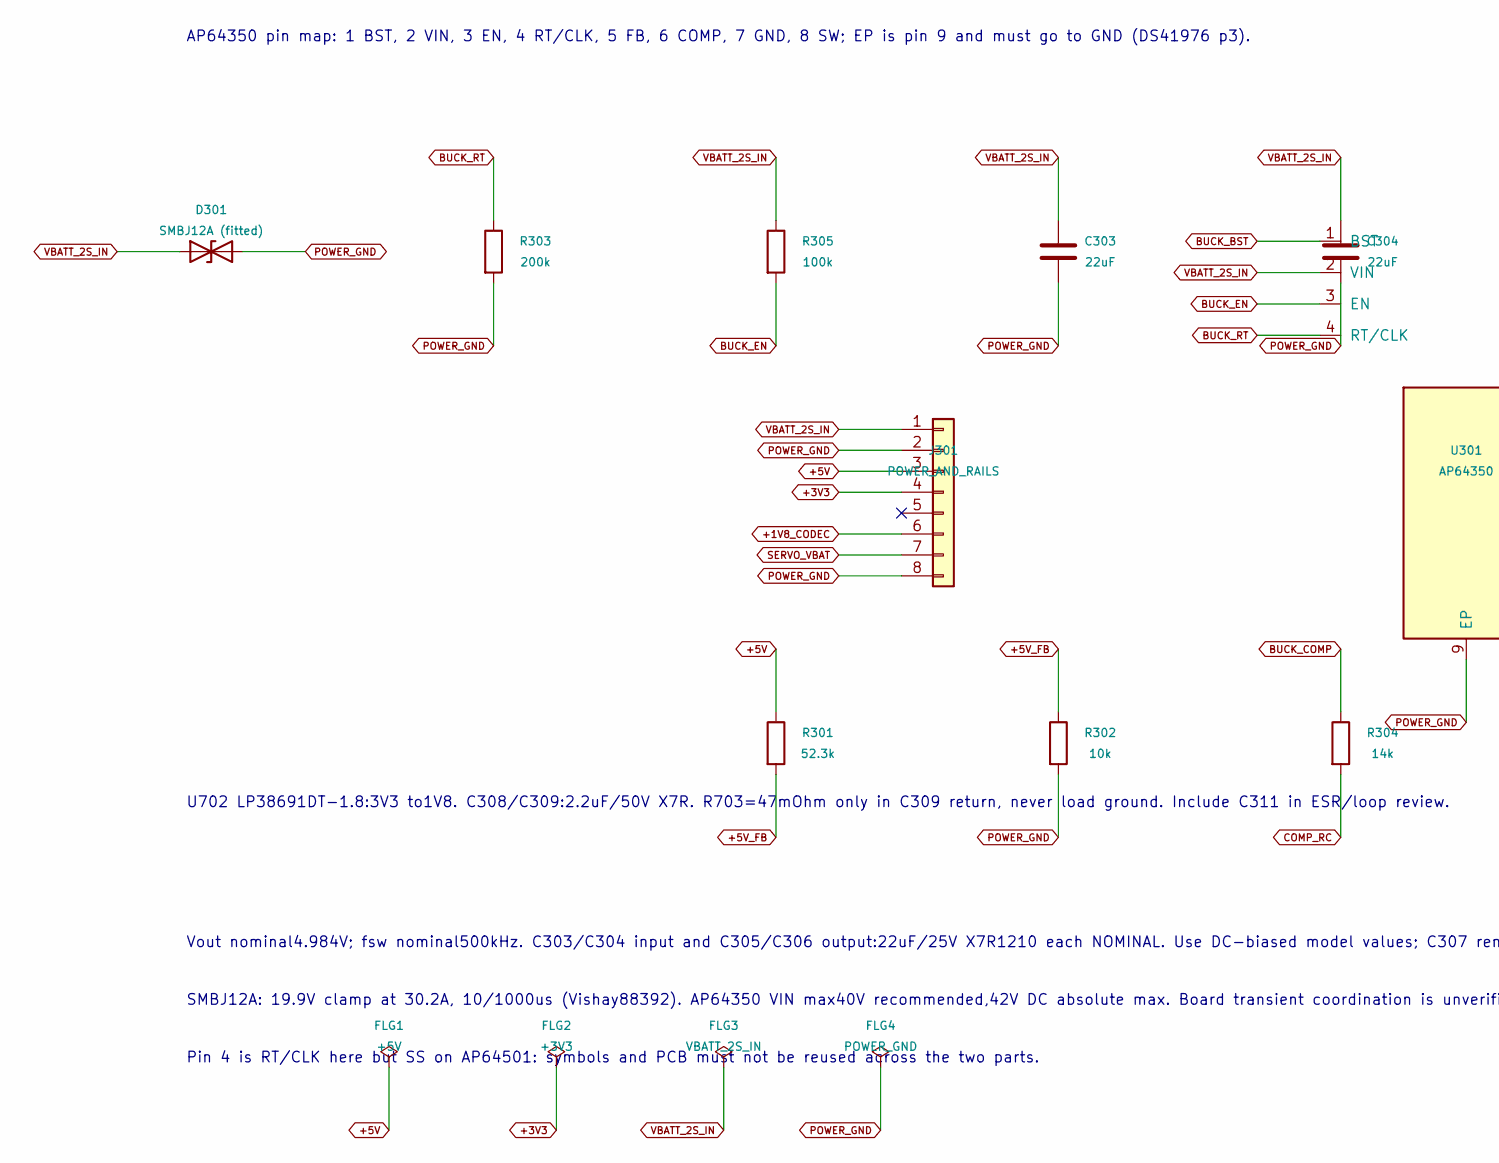
[picture p282: schematic power.kicad_sch, Power input and AP64350 5V buck - values from DS41976 and E…, part in row 1, column 1]

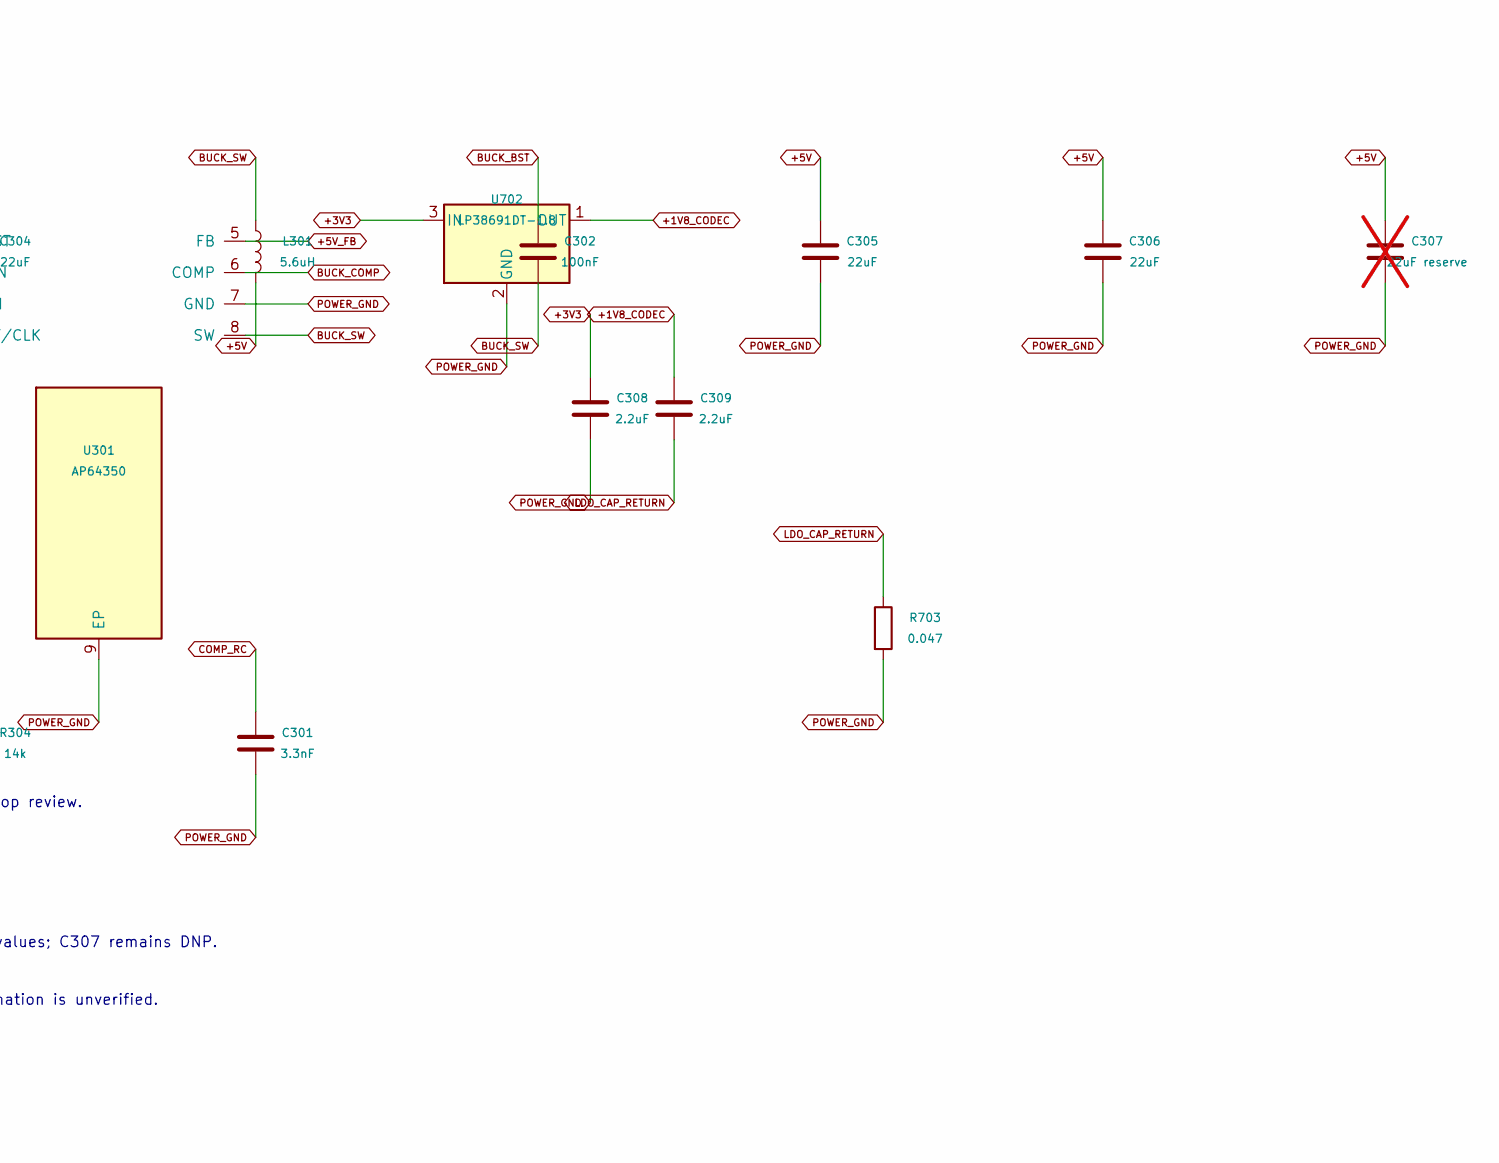
[picture p283: schematic power.kicad_sch, Power input and AP64350 5V buck - values from DS41976 and E…, part in row 1, column 2]

Parts:
C301: 3.3nF; C_0805_2012Metric; Voltage Rating 50V; Tolerance 5%; MPN 08055A332JAT2A
C302: 100nF; C_0805_2012Metric; Voltage Rating 50V; Tolerance 10%; MPN C0805C104K5RACTU
C303, C304, C305, C306: 22uF; C_1210_3225Metric; Voltage Rating 25V; Tolerance 10%; MPN C1210C226K3RACTU
C307: 22uF reserve; C_1206_3216Metric; Voltage Rating 16V; Tolerance 20%; MPN C1206C226M4PACTU; not fitted
C308: 2.2uF; C_0805_2012Metric; Voltage Rating 50V; Tolerance 10%; MPN C0805C225K5RACTU
C309: 2.2uF; C_0805_2012Metric_LDO_ClearSilk; Voltage Rating 50V; Tolerance 10%; MPN C0805C225K5RACTU
D301: SMBJ12A (fitted); D_SMB; Voltage Rating 12V VRWM; MPN SMBJ12A-E3/52
FLG1: +5V
FLG2: +3V3
FLG3: VBATT_2S_IN
FLG4: POWER_GND
J301: POWER_AND_RAILS; Samtec_TSW108_07; MPN TSW-108-07-G-S
L301: 5.6uH; IHLP4040DZ_5A_Above2u2; MPN IHLP4040DZER5R6M5A
R301: 52.3k; R_0805_2012Metric; MPN CRCW080552K3FKEA
R302: 10k; R_0805_2012Metric; MPN CRCW080510K0FKEA
R303: 200k; R_0805_2012Metric; MPN CRCW0805200KFKEA
R304: 14k; R_0805_2012Metric; MPN CRCW080514K0FKEA
R305: 100k; R_0805_2012Metric; MPN CRCW0805100KFKEA
R703: 0.047; Vishay_WSLP0603_Damping; Tolerance 1%; Power Rating 0.4W at70C; derate above70C; MPN WSLP0603R0470FEA
U301: AP64350; SO8EP_AP64350_Paste4_Project; MPN AP64350SP-13
U702: LP38691DT-1.8; TI_NDP0003B_LP38691_PasteGrid; MPN LP38691DT-1.8/NOPB

Connections:
+1V8_CODEC: C309.1, J301.6, U702.1 (OUT); also elsewhere on the board
+3V3: C308.1, FLG2.1, J301.4, U702.3 (IN); also elsewhere on the board
+5V: C305.1, C306.1, C307.1, FLG1.1, J301.3, L301.2, R301.1; also elsewhere on the board
+5V_FB: R301.2, R302.1, U301.5 (FB)
BUCK_BST: C302.1, U301.1 (BST)
BUCK_COMP: R304.1, U301.6 (COMP)
BUCK_EN: R305.2, U301.3 (EN)
BUCK_RT: R303.1, U301.4 (RT/CLK)
BUCK_SW: C302.2, L301.1, U301.8 (SW)
COMP_RC: C301.1, R304.2
LDO_CAP_RETURN: C309.2, R703.1
POWER_GND: C301.2, C303.2, C304.2, C305.2, C306.2, C307.2, C308.2, D301.2 (A2), FLG4.1, J301.2, J301.8, R302.2, R303.2, R703.2, U301.7 (GND), U301.9 (EP), U702.2 (GND); also elsewhere on the board
SERVO_VBAT: J301.7; also elsewhere on the board
VBATT_2S_IN: C303.1, C304.1, D301.1 (A1), FLG3.1, J301.1, R305.1, U301.2 (VIN); also elsewhere on the board

Notes on the sheet:
AP64350 pin map: 1 BST, 2 VIN, 3 EN, 4 RT/CLK, 5 FB, 6 COMP, 7 GND, 8 SW; EP is pin 9 and must go to GND (DS41976 p3).
Vout nominal4.984V; fsw nominal500kHz. C303/C304 input and C305/C306 output:22uF/25V X7R1210 each NOMINAL. Use DC-biased model values; C307 remains DNP.
U702 LP38691DT-1.8:3V3 to1V8. C308/C309:2.2uF/50V X7R. R703=47mOhm only in C309 return, never load ground. Include C311 in ESR/loop review.
SMBJ12A: 19.9V clamp at 30.2A, 10/1000us (Vishay88392). AP64350 VIN max40V recommended,42V DC absolute max. Board transient coordination is unverified.
Pin 4 is RT/CLK here but SS on AP64501: symbols and PCB must not be reused across the two parts.
