parkourlrc/pcb-yilv1982--duck-robot-89dbc81d6d/hardware/custom_hat/rev_a/custom_hat_rev_a.kicad_pcb

## KiCad design hardware/custom_hat/rev_a/custom_hat_rev_a.kicad_pcb (continued)

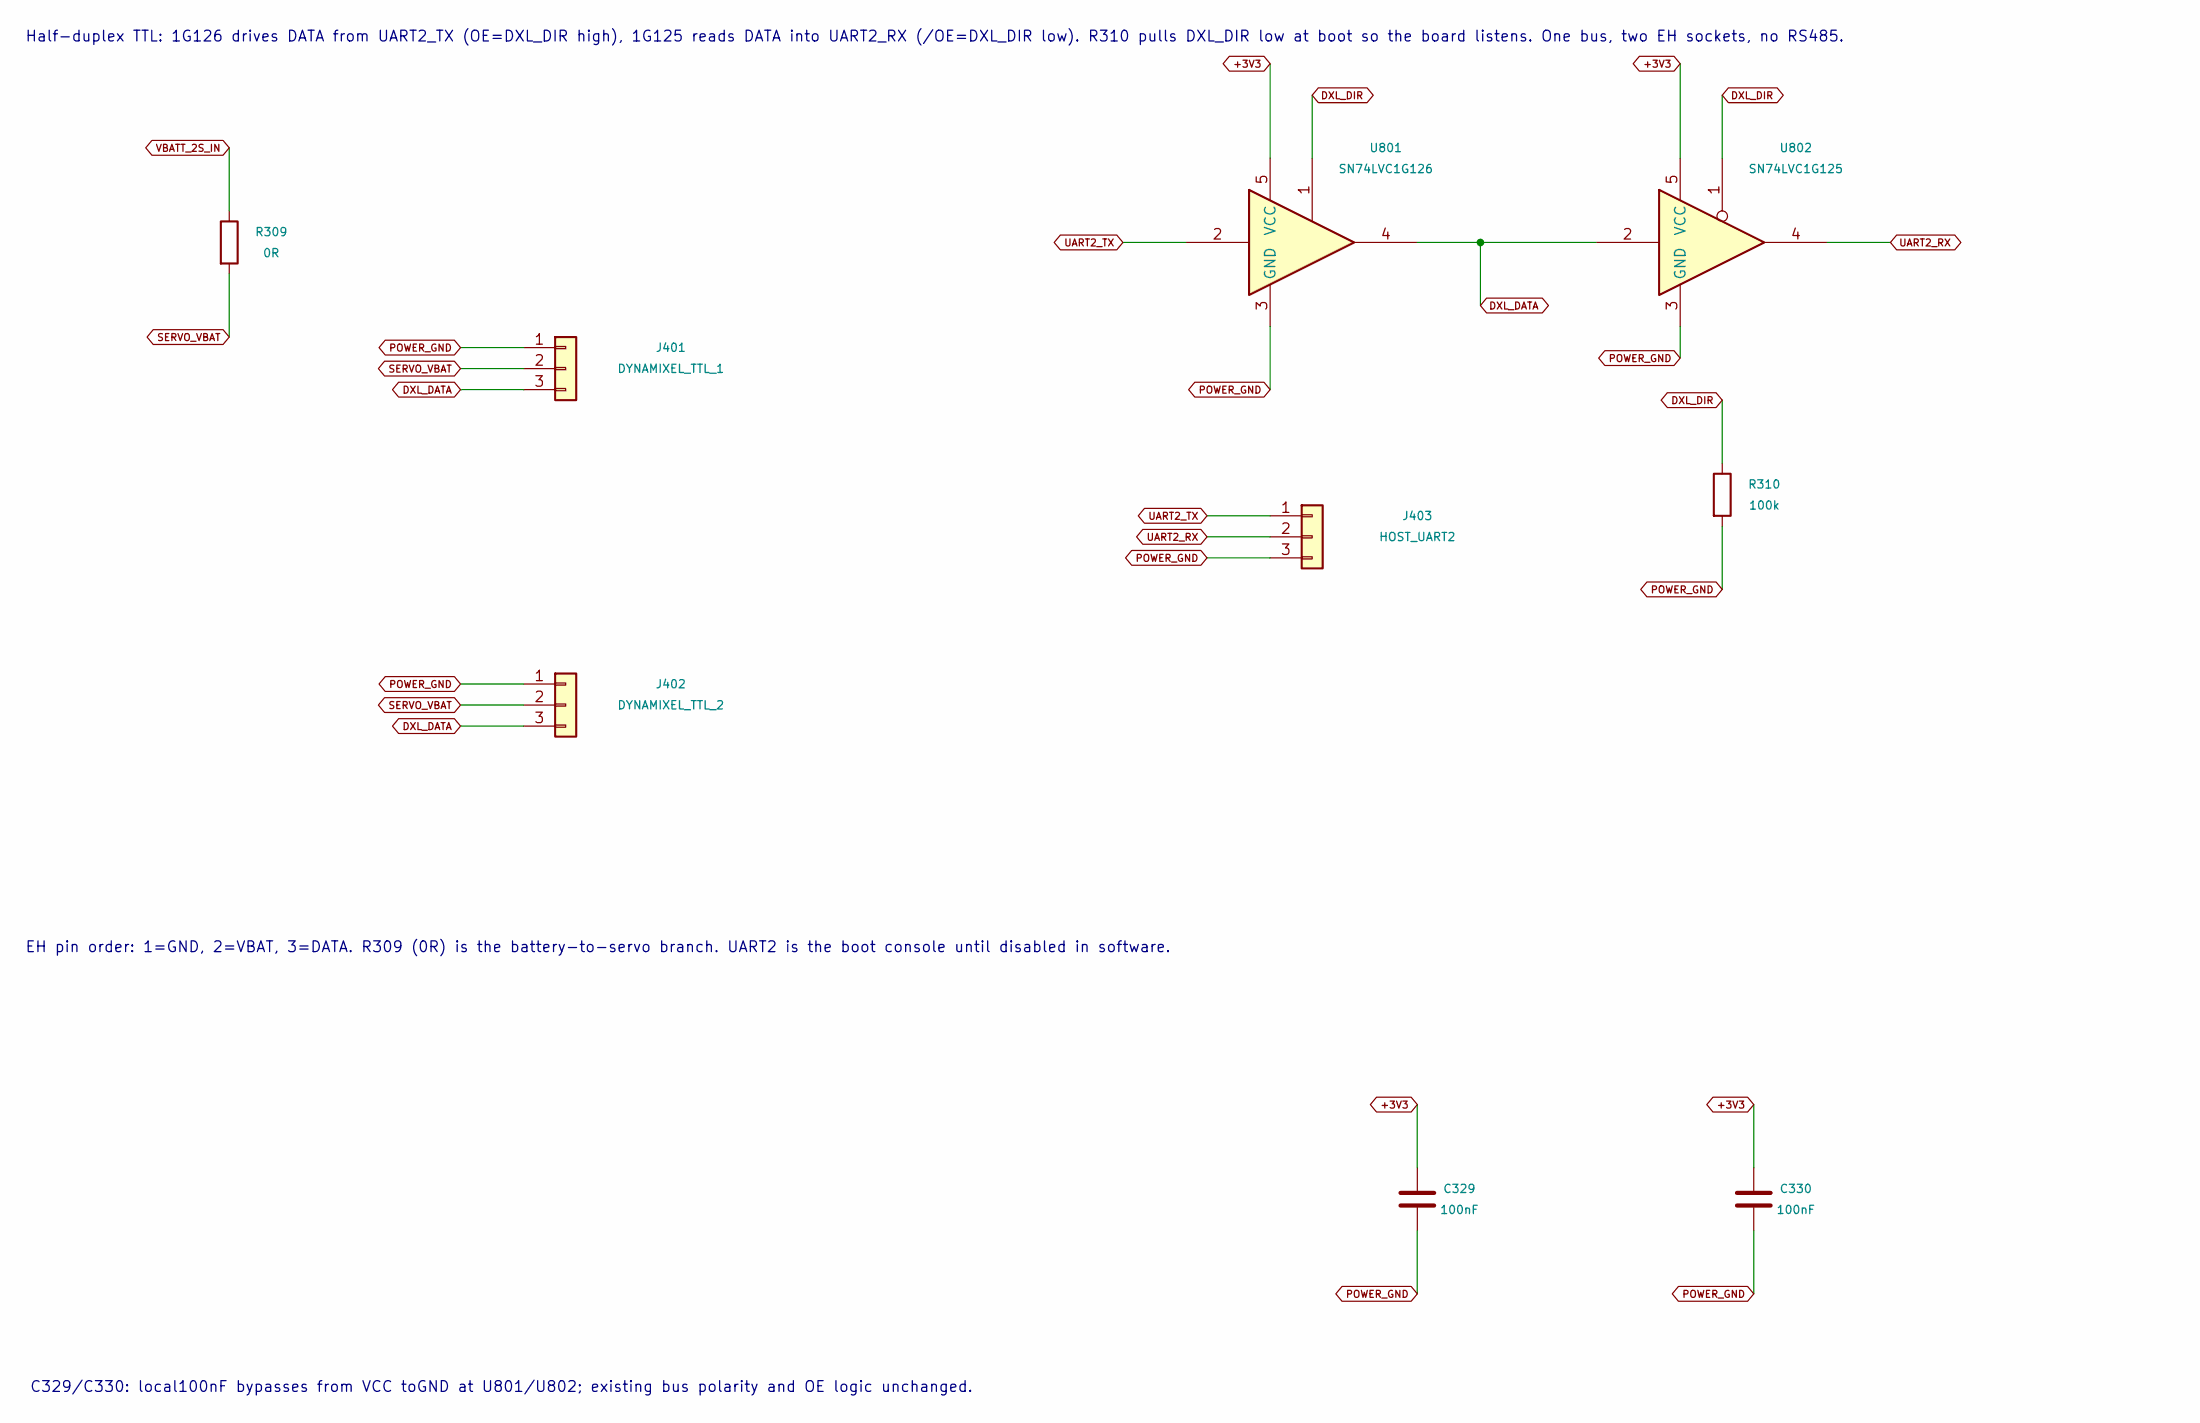
[picture p284: schematic servo_ttl.kicad_sch, Half-duplex TTL servo bus - two 3P outlets]

Parts:
C329, C330: 100nF; C_0402_1005Metric; Voltage Rating 25V; Tolerance 10%; MPN C0402C104K3RACTU
J401: DYNAMIXEL_TTL_1; JST_EH_B3B-EH-A_1x03_P2.50mm_Vertical; MPN B3B-EH-A(LF)(SN)
J402: DYNAMIXEL_TTL_2; JST_EH_B3B-EH-A_1x03_P2.50mm_Vertical; MPN B3B-EH-A(LF)(SN)
J403: HOST_UART2; Samtec_TSW103_07; MPN TSW-103-07-G-S
R309: 0R; Vishay_WSL1206_Jumper; MPN WSL120600000ZEA9
R310: 100k; R_0402_1005Metric; MPN CRCW0402100KFKED
U801: SN74LVC1G126; SOT-23-5; MPN SN74LVC1G126DBVR
U802: SN74LVC1G125; SOT-23-5; MPN SN74LVC1G125DBVT

Connections:
+3V3: C329.1, C330.1, U801.5 (VCC), U802.5 (VCC); also elsewhere on the board
DXL_DATA: J401.3, J402.3, U801.4, U802.2
DXL_DIR: R310.1, U801.1, U802.1; also elsewhere on the board
POWER_GND: C329.2, C330.2, J401.1, J402.1, J403.3, R310.2, U801.3 (GND), U802.3 (GND); also elsewhere on the board
SERVO_VBAT: J401.2, J402.2, R309.2; also elsewhere on the board
UART2_RX: J403.2, U802.4; also elsewhere on the board
UART2_TX: J403.1, U801.2; also elsewhere on the board
VBATT_2S_IN: R309.1; also elsewhere on the board

Notes on the sheet:
Half-duplex TTL: 1G126 drives DATA from UART2_TX (OE=DXL_DIR high), 1G125 reads DATA into UART2_RX (/OE=DXL_DIR low). R310 pulls DXL_DIR low at boot so the board listens. One bus, two EH sockets, no RS485.
EH pin order: 1=GND, 2=VBAT, 3=DATA. R309 (0R) is the battery-to-servo branch. UART2 is the boot console until disabled in software.
C329/C330: local100nF bypasses from VCC toGND at U801/U802; existing bus polarity and OE logic unchanged.

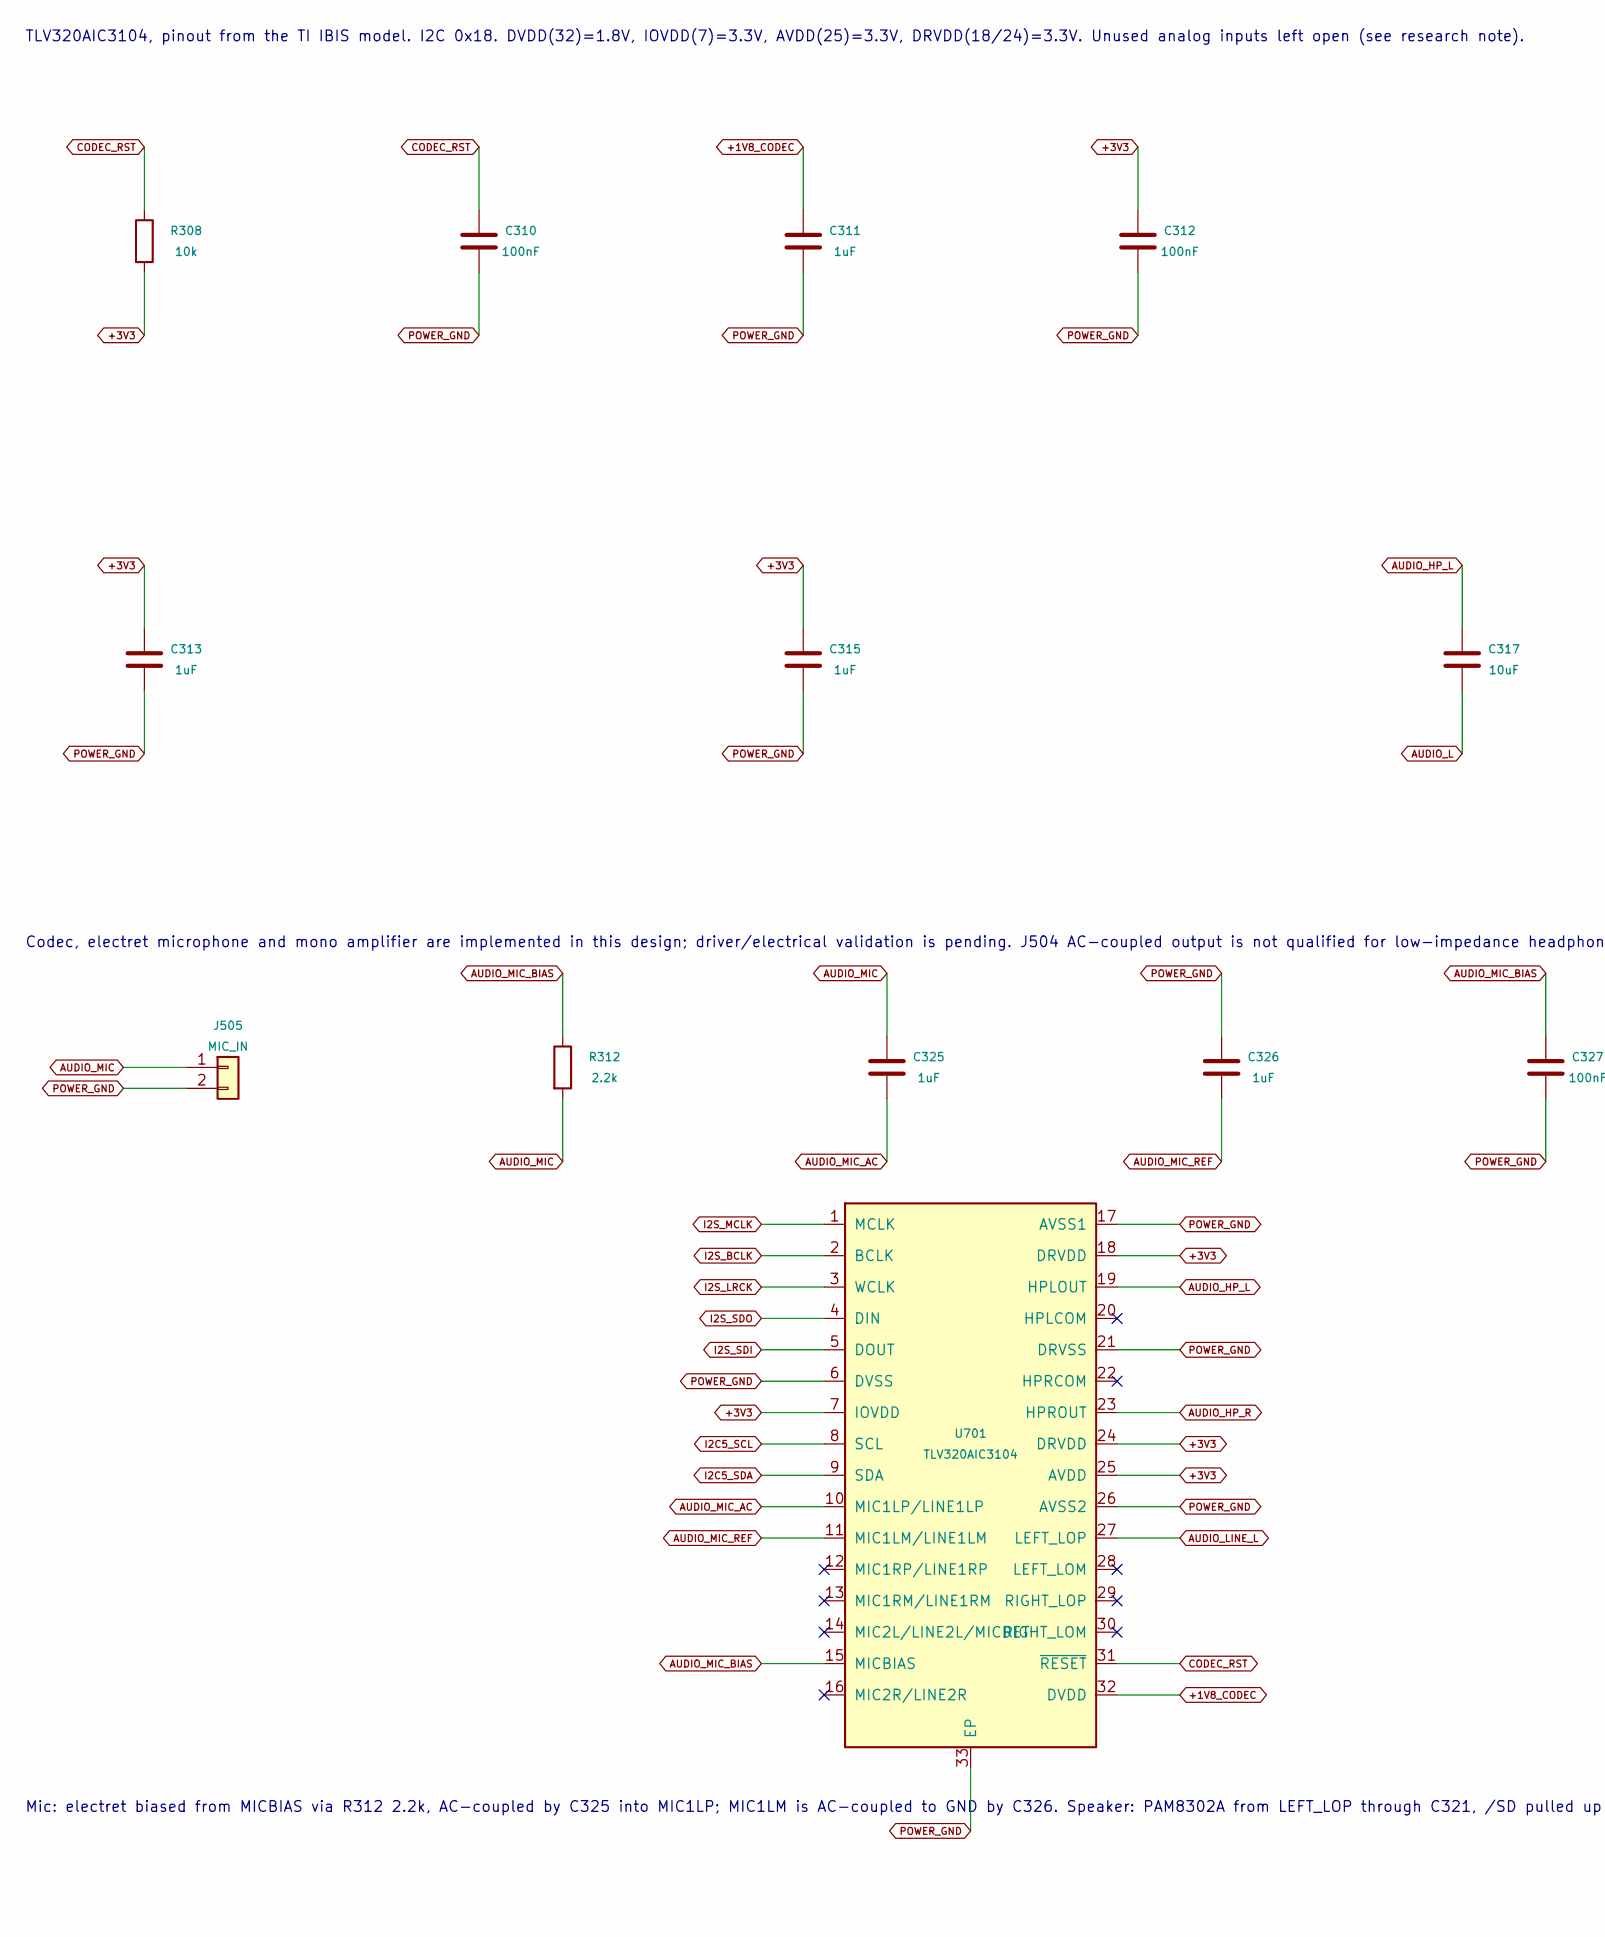
[picture p285: schematic audio.kicad_sch, I2S codec interface - I2C5 and 1V8 codec rail, part in row 1, column 1]

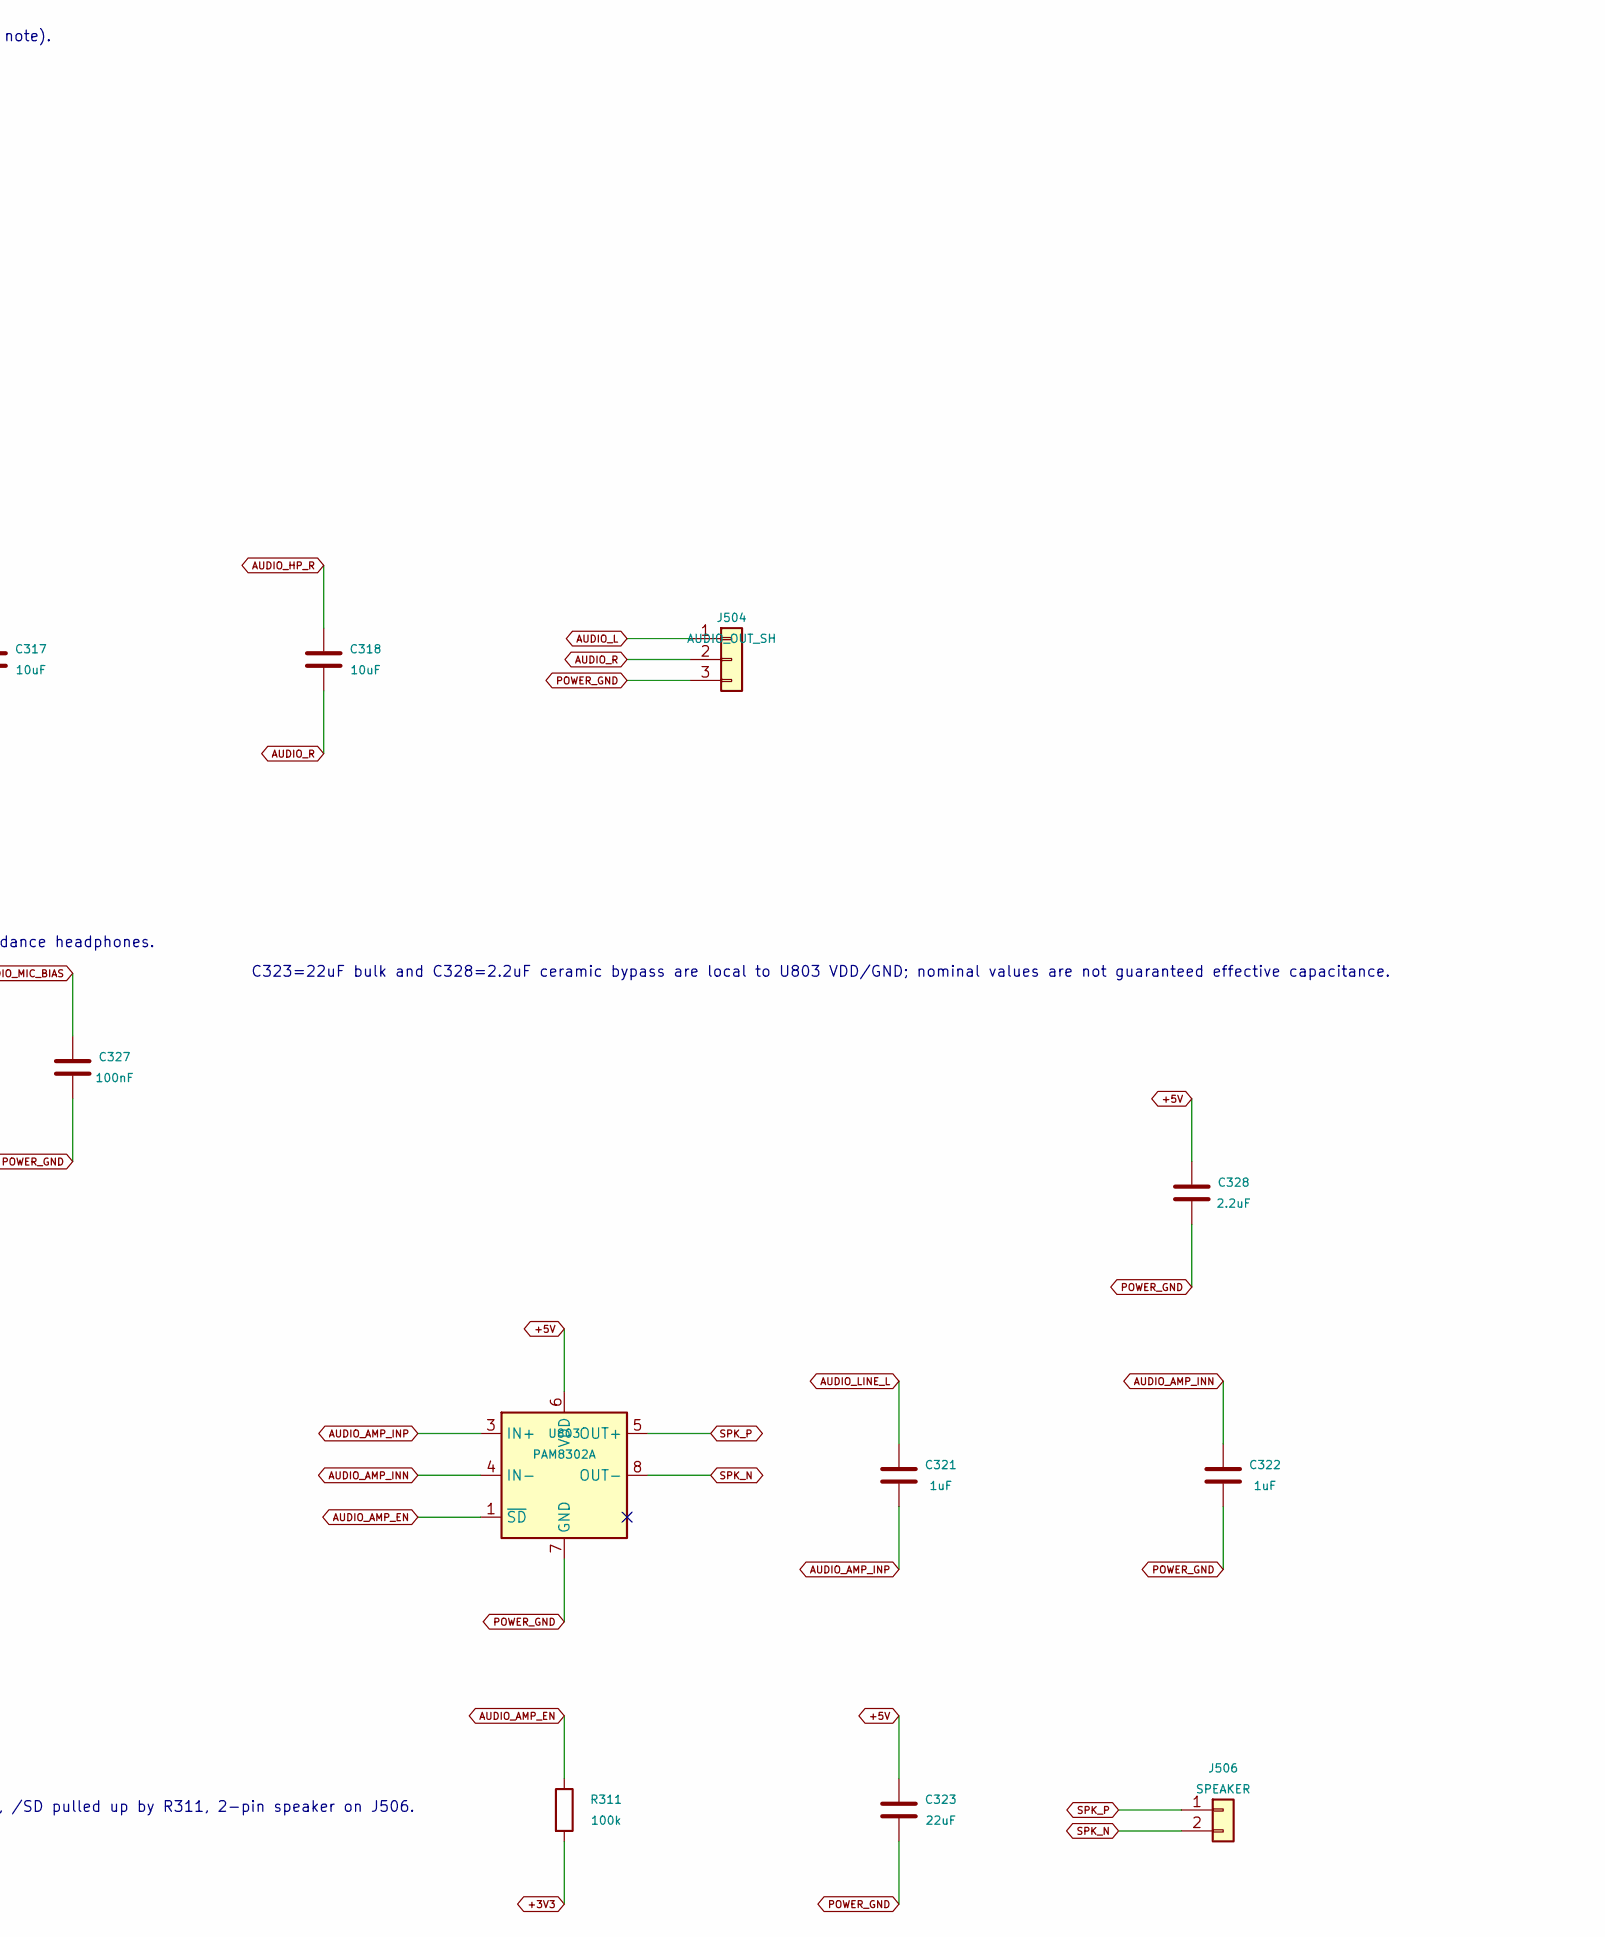
[picture p286: schematic audio.kicad_sch, I2S codec interface - I2C5 and 1V8 codec rail, part in row 1, column 2]

Parts:
C310, C312, C327: 100nF; C_0402_1005Metric; Voltage Rating 25V; Tolerance 10%; MPN C0402C104K3RACTU
C311, C313, C315, C321, C322, C325, C326: 1uF; C_0402_1005Metric; Voltage Rating 16V; Tolerance 10%; MPN C0402C105K4PACTU
C317, C318: 10uF; C_0402_1005Metric; Voltage Rating 6.3V; Tolerance 20%; MPN C0402C106M9PACTU
C323: 22uF; C_1210_3225Metric; Voltage Rating 25V; Tolerance 10%; MPN C1210C226K3RACTU
C328: 2.2uF; C_0805_2012Metric; Voltage Rating 50V; Tolerance 10%; MPN C0805C225K5RACTU
J504: AUDIO_OUT_SH; JST_SH_BM03B-SRSS-TB_1x03-1MP_P1.00mm_Vertical; MPN BM03B-SRSS-TB(LF)(SN)
J505: MIC_IN; JST_SH_BM02B-SRSS-TB_1x02-1MP_P1.00mm_Vertical; MPN BM02B-SRSS-TB(LF)(SN)
J506: SPEAKER; JST_SH_BM02B-SRSS-TB_1x02-1MP_P1.00mm_Vertical; MPN BM02B-SRSS-TB(LF)(SN)
R308: 10k; R_0402_1005Metric; MPN CRCW040210K0FKED
R311: 100k; R_0402_1005Metric; MPN CRCW0402100KFKED
R312: 2.2k; R_0402_1005Metric; MPN CRCW04022K20FKED
U701: TLV320AIC3104; TI_RHB0032E_AIC3104_EP345; MPN TLV320AIC3104IRHBR
U803: PAM8302A; SOIC-8_3.9x4.9mm_P1.27mm; MPN PAM8302AADCR

Connections:
+1V8_CODEC: C311.1, U701.32 (DVDD); also elsewhere on the board
+3V3: C312.1, C313.1, C315.1, R308.2, R311.2, U701.7 (IOVDD), U701.18 (DRVDD), U701.24 (DRVDD), U701.25 (AVDD); also elsewhere on the board
+5V: C323.1, C328.1, U803.6 (VDD); also elsewhere on the board
AUDIO_AMP_EN: R311.1, U803.1 (~SD)
AUDIO_AMP_INN: C322.1, U803.4 (IN-)
AUDIO_AMP_INP: C321.2, U803.3 (IN+)
AUDIO_HP_L: C317.1, U701.19 (HPLOUT)
AUDIO_HP_R: C318.1, U701.23 (HPROUT)
AUDIO_L: C317.2, J504.1
AUDIO_LINE_L: C321.1, U701.27 (LEFT_LOP)
AUDIO_MIC: C325.1, J505.1, R312.2
AUDIO_MIC_AC: C325.2, U701.10 (MIC1LP/LINE1LP)
AUDIO_MIC_BIAS: C327.1, R312.1, U701.15 (MICBIAS)
AUDIO_MIC_REF: C326.2, U701.11 (MIC1LM/LINE1LM)
AUDIO_R: C318.2, J504.2
CODEC_RST: C310.1, R308.1, U701.31 (~RESET); also elsewhere on the board
I2C5_SCL: U701.8 (SCL); also elsewhere on the board
I2C5_SDA: U701.9 (SDA); also elsewhere on the board
I2S_BCLK: U701.2 (BCLK); also elsewhere on the board
I2S_LRCK: U701.3 (WCLK); also elsewhere on the board
I2S_MCLK: U701.1 (MCLK); also elsewhere on the board
I2S_SDI: U701.5 (DOUT); also elsewhere on the board
I2S_SDO: U701.4 (DIN); also elsewhere on the board
POWER_GND: C310.2, C311.2, C312.2, C313.2, C315.2, C322.2, C323.2, C326.1, C327.2, C328.2, J504.3, J505.2, U701.6 (DVSS), U701.17 (AVSS1), U701.21 (DRVSS), U701.26 (AVSS2), U701.33 (EP), U803.7 (GND); also elsewhere on the board
SPK_N: J506.2, U803.8 (OUT-)
SPK_P: J506.1, U803.5 (OUT+)

Notes on the sheet:
Mic: electret biased from MICBIAS via R312 2.2k, AC-coupled by C325 into MIC1LP; MIC1LM is AC-coupled to GND by C326. Speaker: PAM8302A from LEFT_LOP through C321, /SD pulled up by R311, 2-pin speaker on J506.
TLV320AIC3104, pinout from the TI IBIS model. I2C 0x18. DVDD(32)=1.8V, IOVDD(7)=3.3V, AVDD(25)=3.3V, DRVDD(18/24)=3.3V. Unused analog inputs left open (see research note).
Codec, electret microphone and mono amplifier are implemented in this design; driver/electrical validation is pending. J504 AC-coupled output is not qualified for low-impedance headphones.
C323=22uF bulk and C328=2.2uF ceramic bypass are local to U803 VDD/GND; nominal values are not guaranteed effective capacitance.

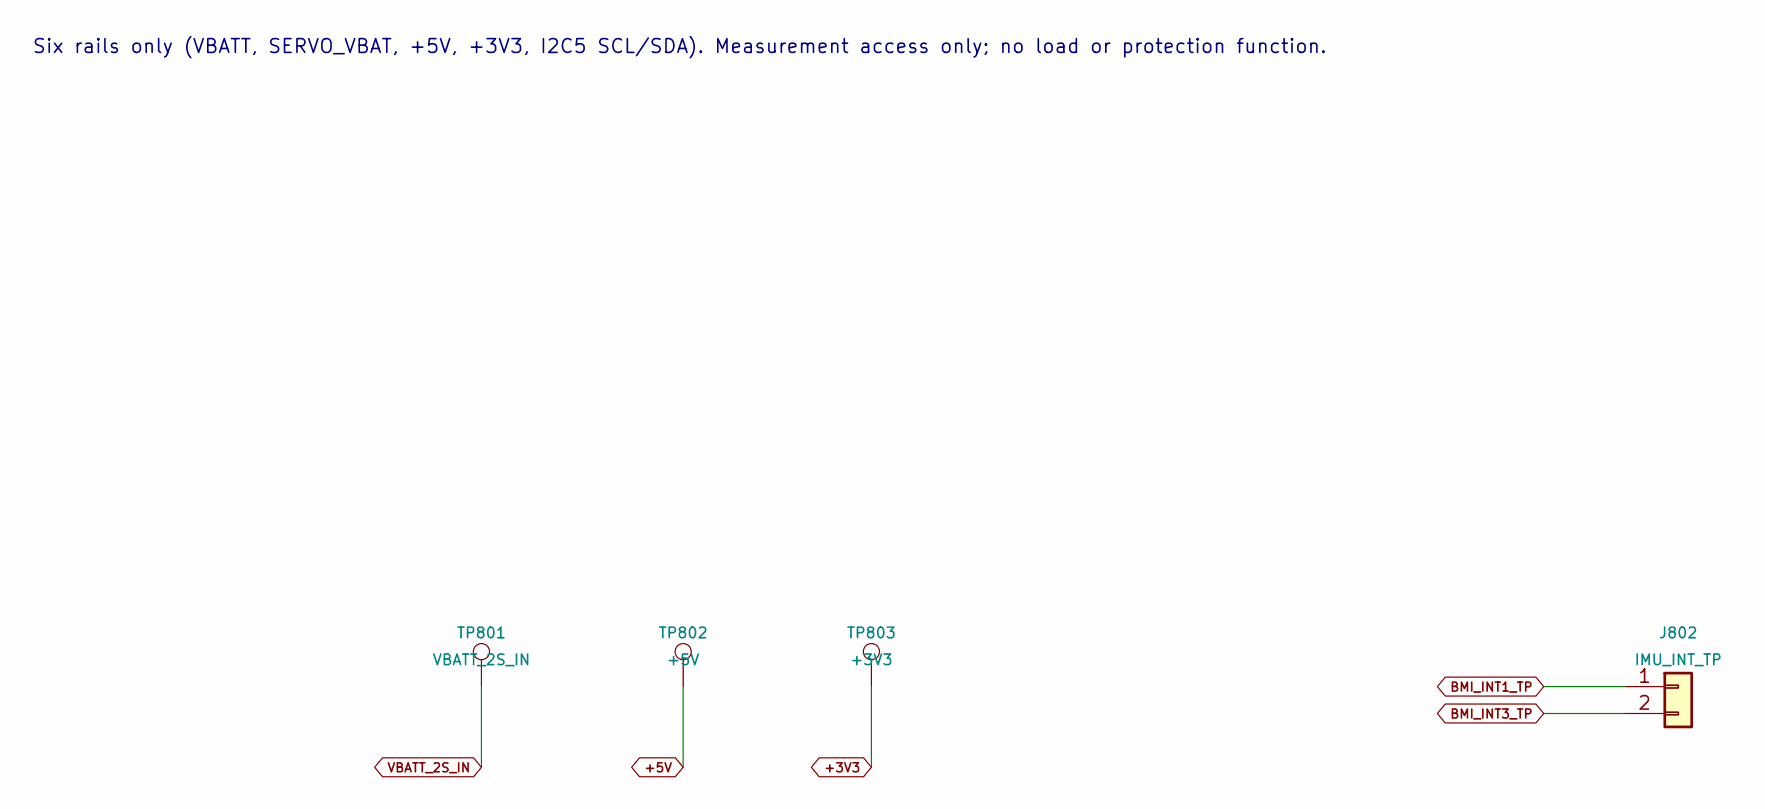
[picture p287: schematic testpoints.kicad_sch, Bring-up test points]

Parts:
J802: IMU_INT_TP; Samtec_TSW102_07; MPN TSW-102-07-G-S
TP801: VBATT_2S_IN; TestPoint_Pad_D1.5mm
TP802: +5V; TestPoint_Pad_D1.5mm
TP803: +3V3; TestPoint_Pad_D1.5mm

Connections:
+3V3: TP803.1; also elsewhere on the board
+5V: TP802.1; also elsewhere on the board
BMI_INT1_TP: J802.1; also elsewhere on the board
BMI_INT3_TP: J802.2; also elsewhere on the board
VBATT_2S_IN: TP801.1; also elsewhere on the board

Notes on the sheet:
Six rails only (VBATT, SERVO_VBAT, +5V, +3V3, I2C5 SCL/SDA). Measurement access only; no load or protection function.

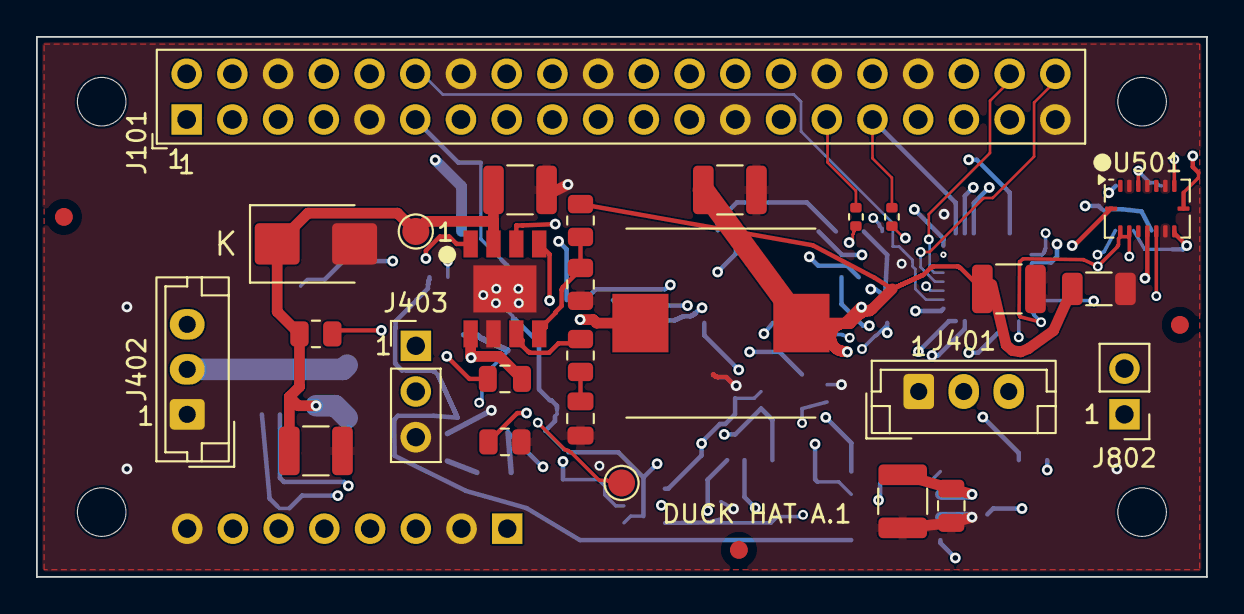
[picture p288: board custom_hat_rev_a.kicad_pcb from above]

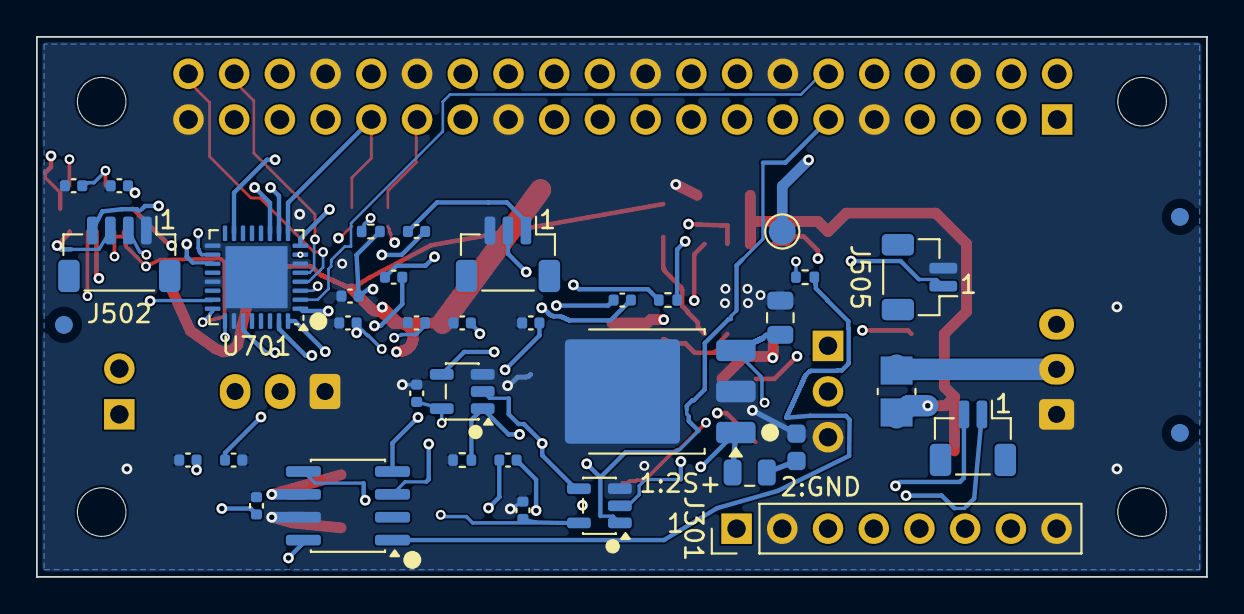
[picture p289: board custom_hat_rev_a.kicad_pcb from below]

Board: 4 copper layers, 65.0 x 30.0 mm, 72 parts (38 on the bottom side), 42 nets.

Other parts of the board:
C319, C320: 100nF; C_0402_1005Metric
FID1, FID2, FID3, FID4, FID5, FID6: Fiducial_1mm_Mask2mm
H1, H2: MountingHole_2.7mm_M2.5; MountingHole_2.7_M2.5_Head4.5
H3, H4: MountingHole_2.7mm_M2.5
J502: TOF_I2C5; JST_SH_BM04B-SRSS-TB_1x04-1MP_P1.00mm_Vertical
R501, R502: 4.7k; R_0402_1005Metric
U501: BMI088; Bosch_LGA-16_4.5x3mm_P0.5mm_LayoutBorder7x1y_ClockwisePinNu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

Their connections:
+3V3: C319.1, C320.1, J502.2, R501.1, R502.1, U501.3, U501.7, U501.11, U501.14, U501.15; also elsewhere on the board
BMI_INT1_TP: U501.16; also elsewhere on the board
BMI_INT3_TP: U501.12; also elsewhere on the board
I2C5_SCL: J502.4, R501.2, U501.8; also elsewhere on the board
I2C5_SDA: J502.3, R502.2, U501.9; also elsewhere on the board
POWER_GND: C319.2, C320.2, J502.1, U501.2, U501.4, U501.6, U501.10; also elsewhere on the board
