parkourlrc/pcb-yilv1982--duck-robot-89dbc81d6d/docs/schematics/pollen-hat-pcb-reference/c1-88d51fa/elec_RPI_Robot_HAT.kicad_pcb

## KiCad design docs/schematics/pollen-hat-pcb-reference/c1-88d51fa/elec_RPI_Robot_HAT.kicad_pcb (2026-10-27)

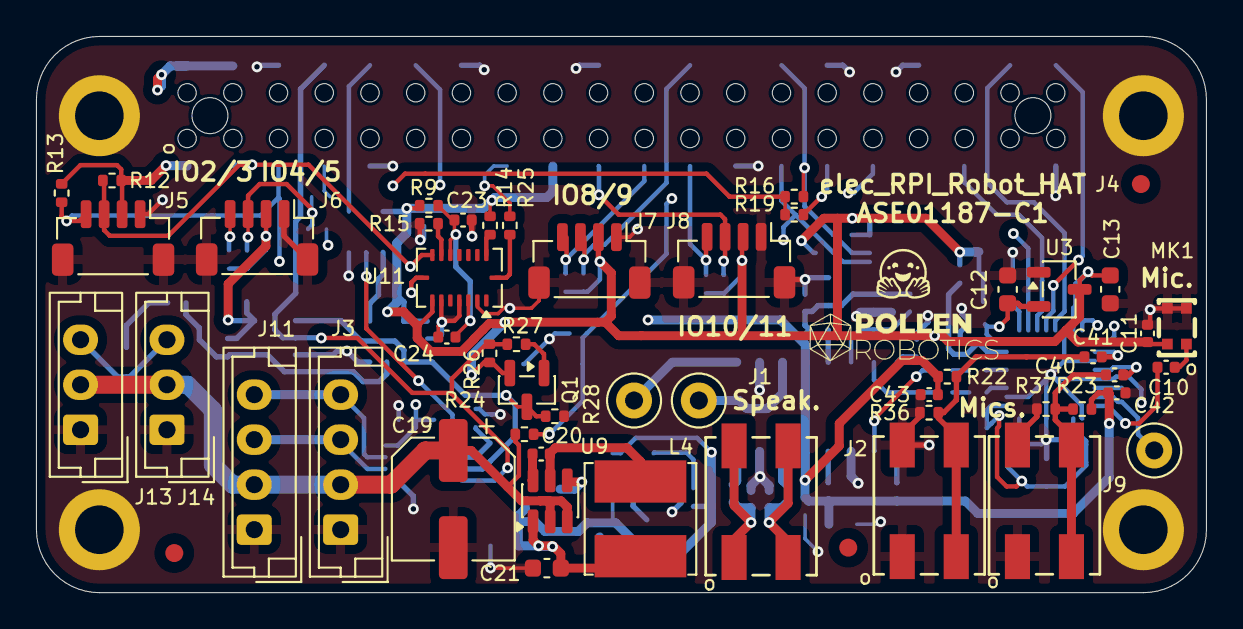
[picture p290: board elec_RPI_Robot_HAT.kicad_pcb from above]

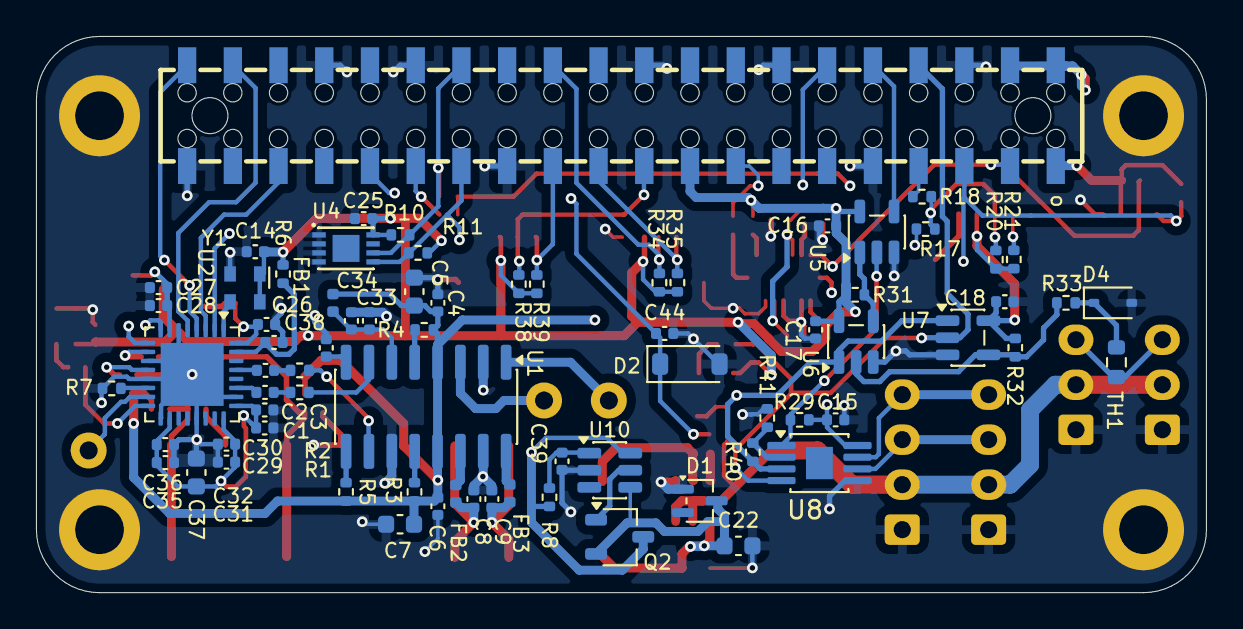
[picture p291: board elec_RPI_Robot_HAT.kicad_pcb from below]

Board: 4 copper layers, 65.0 x 30.9 mm, 127 parts (73 on the bottom side), 71 nets.

Parts:
C1, C2, C3, C4, C6, C10, C27, C29, C31, C33, C35, C40, C41, C42, C43: 1u; C_0402_1005Metric
C5, C7, C12, C13, C37: 10u; C_0603_1608Metric
C8, C9: 220n; C_0402_1005Metric
C11, C14, C15, C16, C17, C18, C26, C28, C30, C32, C36, C38: 100n; C_0402_1005Metric
C19: 10u 63V; CP_Elec_6.3x7.7
C20: 100n 50V; C_0402_1005Metric
C21, C22: 22u 6V3; C_0603_1608Metric
C23, C24, C39: 100n 6V3; C_0402_1005Metric
C25: DNP-100n; C_0402_1005Metric
C34, C44: 10n; C_0402_1005Metric
D1: BAT54W; SOT-323_SC-70
D2: 3V3 Zener Diode; D_SOD-123
D4: 5V1; D_SOD-323
FB1: 1.3A 600R@100MHz; L_0402_1005Metric
FB2, FB3: 2A - 120R@100MHz; L_0402_1005Metric
FID1, FID2, FID3: DNP Fiducial; Fiducial_1mm_Mask2mm
H2: Logo HF 2025; Logo_HF_2025
H3: DNP Logo Pollen 2021; Logo_Pollen_2021_sq
J1, J2, J9: Wago-2; Wago_2059-302_998-403
J3, J11: Dynamixel-4; JST_EH_B4B-EH-A_1x04_P2.50mm_Vertical
J4: Female Header 2x20 SMD; PinHeader_2x20_P2.54mm_Vertical_with_rasp_HAT_zero_SMD_conn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
J5, J6, J7, J8: JST SH; JST_SH_BM04B-SRSS-TB_1x04-1MP_P1.00mm_Vertical
J13, J14: Dynamixel-3; JST_EH_B3B-EH-A_1x03_P2.50mm_Vertical
L4: 6,8u 2A; L_Bourns_SRN6045TA
MK1: Microphone_MEMS; MIC-SMD_4P-L2.8-W1.9-P1.84-TL
Q1: MMBT3906; SOT-23
Q2: SI2312CDS-T1-GE3; TSOT-23
R1, R2, R6, R12, R13, R20, R21, R22, R23, R24, R26, R27, R29, R31, R32, R34, R35, R38, R39: 10k; R_0402_1005Metric
R3, R4, R5, R7, R9, R14, R15, R18, R19, R25, R40: 0R; R_0402_1005Metric
R8: 100R; R_0402_1005Metric
R10, R11: DNP-10k; R_0402_1005Metric
R16, R17, R41: DNP-0R; R_0402_1005Metric
R28: 20k; R_0402_1005Metric
R33: 150R; R_0402_1005Metric
R36, R37: DNP-1M; R_0402_1005Metric
TH1: 100R thermistor; R_0603_1608Metric
TP2, TP3, TP4: TestPoint; TestPoint_Loop_D2.50mm_Drill1.0mm_LowProfile
U1: PAM8406D; SOIC-16_3.9x9.9mm_P1.27mm
U2: TLV320AIC3104IRHBR; VQFN-32-1EP_5x5mm_P0.5mm_EP3.5x3.5mm
U3: XC6206P182MR; SOT-23-3
U4: DNP-CAT24C32HU4; TDFN-8_L3.0-W2.0-P0.50-BL-EP
U5: 74LVC1G08; SOT-23-5
U6: SN74LVC1G125DBV; SOT-23-5
U7: SN74LVC1G126DBVR; SOT-23-5
U8: SIT3088E; MSOP-8-1EP_3x3mm_P0.65mm_EP1.5x1.8mm
U9: AP63205; TSOT-23-6
U10: LM5050-1; TSOT-23-6
U11: BMI088; Bosch_LGA-16_4.5x3mm_P0.5mm_LayoutBorder7x1y_ClockwisePinNu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
Y1: 12 MHz; Oscillator_SMD_Abracon_ASDMB-4Pin_2.5x2.0mm

Connections:
+1V8: C12.1, C26.2, U2.32 (DVDD), U3.2 (VO)
+3V3: C11.2, C13.1, C14.2, C15.2, C16.2, C17.2, C18.2, C25.2, C27.2, C28.2, C29.2, C30.2, C31.2, C32.2, C35.2, C36.2, C37.1, J4.1, J4.17, J5.2, J6.2, J7.2, J8.2, MK1.4 (+), Q1.2 (E), R6.1, R9.2, R10.1, R11.1, R12.1, R13.1, R14.1, R20.1, R21.1, R26.2, R29.1, R31.1, R32.1, R34.1, R35.1, R38.1, R39.1, U2.7 (IOVDD), U2.18 (DRVDD), U2.24 (DRVDD), U2.25 (AVDD), U3.3 (VI), U4.8 (VCC), U5.5 (VCC), U6.5 (VCC), U7.5 (VCC), U8.8 (VCC), U11.7 (PS), Y1.1 (Tri-State), Y1.4 (VDD)
+5V: C4.1, C5.1, C6.1, C7.1, C42.2, C43.2, FB1.2, J4.2, J4.4, Q2.3 (D), R3.2, R4.2, R5.2, R8.1, R22.2, R23.2, U1.4 (PVDDL), U1.13 (PVDDR), U10.6 (OUT)
+BATT: C19.1, J3.2, J11.2, J13.2, J14.2, R24.2, U9.2 (EN), U9.3 (IN)
/Schematic/Audio/ID_SC: J4.28, R10.2, R16.1, U4.6 (SCL)
/Schematic/Audio/ID_SD: J4.27, R11.2, R17.1, U4.5 (SDA)
/Schematic/Audio/IO_02: J4.3, J5.3, R12.2, U2.9 (SDA), U11.9 (SDI/SDA)
/Schematic/Audio/IO_03: J4.5, J5.4, R13.2, U2.8 (SCL), U11.8 (SCK/SCL)
/Schematic/Audio/IO_04: J4.7, R18.1
/Schematic/Audio/IO_05: J4.29, R19.1
/Schematic/Audio/IO_06: C44.1, D2.1 (K), J4.31, R24.1
/Schematic/Audio/IO_08: J4.24, J7.3, R34.2
/Schematic/Audio/IO_09: J4.21, J7.4, R35.2
/Schematic/Audio/IO_10: J4.19, J8.3, R38.2
/Schematic/Audio/IO_11: J4.23, J8.4, R39.2
/Schematic/Audio/IO_14: J4.8, R26.1, R27.1, U7.2, U8.4 (DI)
/Schematic/Audio/IO_15: J4.10, U5.4
/Schematic/Audio/IO_18: J4.12, U2.2 (BCLK)
/Schematic/Audio/IO_19: J4.35, U2.3 (WCLK)
/Schematic/Audio/IO_20: J4.38, U2.5 (DOUT)
/Schematic/Audio/IO_21: J4.40, U2.4 (DIN)
/Schematic/Audio/IO_22: J4.15, R25.1
/Schematic/Dynamixel/Dynamixel_dir: Q1.3 (C), R28.2, R40.1, U6.1, U7.1, U8.3 (DE)
GND: C3.1, C4.2, C5.2, C6.2, C7.2, C8.2, C9.2, C11.1, C12.2, C13.2, C14.1, C15.1, C16.1, C17.1, C18.1, C19.2, C21.2, C22.2, C23.2, C24.1, C25.1, C26.1, C27.1, C28.1, C29.1, C30.1, C31.1, C32.1, C33.2, C34.2, C35.1, C36.1, C37.2, C38.1, C39.2, C42.1, C43.1, C44.2, D1.1 (A), D2.2 (A), D4.2 (A), J2.1, J3.1, J4.6, J4.9, J4.14, J4.20, J4.25, J4.30, J4.34, J4.39, J4.MP (MountPin), J5.1, J5.MP (MountPin), J6.1, J6.MP (MountPin), J7.1, J7.MP (MountPin), J8.1, J8.MP (MountPin), J9.1, J11.1, J13.1, J14.1, MK1.2 (-), MK1.3 (-), R7.1, R15.1, R28.1, R36.1, R37.1, R41.1, U1.2 (PGNDL), U1.11 (GND), U1.15 (PGNDR), U2.6 (DVSS), U2.11 (MIC1LM/LINE1LM), U2.13 (MIC1RM/LINE1RM), U2.17 (AVSS1), U2.21 (DRVSS), U2.26 (AVSS2), U2.33 (EP), U3.1 (GND), U4.1 (A0), U4.2 (A1), U4.3 (A2), U4.4 (GND), U5.3 (GND), U6.3 (GND), U7.3 (GND), U8.5 (GND), U9.4 (GND), U10.2 (GND), U11.2 (GNDA), U11.4 (GNDA), U11.6 (GNDIO), Y1.2 (GND)
unnamed: C1.2, R1.1
unnamed: C2.2, R2.1
unnamed: C10.1, MK1.1 (-)
unnamed: C21.1, C22.1, D1.3 (K), L4.1, Q2.2 (S), U9.1 (FB), U10.4 (IN)
unnamed: D4.1 (K), R33.2, TH1.1
unnamed: C9.1, FB3.2, J1.1
unnamed: C8.1, FB2.2, J1.2
unnamed: C41.2, J2.2, R22.1, R36.2
unnamed: J6.3, R17.2, R18.2, R20.2
unnamed: J6.4, R16.2, R19.2, R21.2
unnamed: C40.2, J9.2, R23.1, R37.2
unnamed: J3.3, J11.3, U8.6 (A)
unnamed: J3.4, J11.4, U8.7 (B)
unnamed: J13.3, J14.3, TH1.2
unnamed: Q1.1 (B), R27.2
unnamed: Q2.1 (G), U10.5 (GATE)
unnamed: R31.2, U5.1, U6.4
unnamed: R32.2, R33.1, U6.2, U7.4
unnamed: TP3.1, U1.1 (+OUT_L)
unnamed: FB3.1, U1.16 (+OUT_R)
unnamed: TP4.1, U1.3 (-OUT_L)
unnamed: FB2.1, U1.14 (-OUT_R)
unnamed: R1.2, U1.7 (INL)
unnamed: R2.2, U1.10 (INR)
unnamed: R5.1, U1.9 (MODE)
unnamed: C33.1, C34.1, FB1.1, U1.6 (VDD)
unnamed: C3.2, U1.8 (VREF)
unnamed: R4.1, U1.5 (~MUTE)
unnamed: R3.1, U1.12 (~SHND)
unnamed: C1.1, U2.27 (LEFT_LOP)
unnamed: U2.1 (MCLK), Y1.3 (OUT)
unnamed: C41.1, U2.10 (MIC1LP/LINE1LP)
unnamed: C40.1, U2.12 (MIC1RP/LINE1RP)
unnamed: R7.2, U2.14 (MIC2L/LINE2L/MICDET)
unnamed: C10.2, U2.16 (MIC2R/LINE2R)
unnamed: TP2.1, U2.15 (MICBIAS)
unnamed: C2.1, U2.29 (RIGHT_LOP)
unnamed: C38.2, R6.2, U2.31 (~RESET)
unnamed: R29.2, U5.2, U8.1 (RO)
unnamed: R40.2, R41.2, U8.2 (~RE)
unnamed: C20.1, U9.6 (BST)
unnamed: C20.2, L4.2, U9.5 (SW)
unnamed: C39.1, R8.2, U10.1 (VS)
unnamed: R25.2, U11.16 (INT1)
unnamed: R14.2, U11.15 (SDO1)
unnamed: R15.2, U11.10 (SDO2)
unnamed: C23.1, C24.2, R9.1, U11.3 (VDD), U11.11 (VDDIO)
