parkourlrc/pcb-yilv1982--duck-robot-89dbc81d6d/hardware/custom_hat/panels/a1-smt-2up-20261102-r4/hat_a1_smt_2up.kicad_pcb

## KiCad design hardware/custom_hat/panels/a1-smt-2up-20261102-r4/hat_a1_smt_2up.kicad_pcb (2026-11-05)

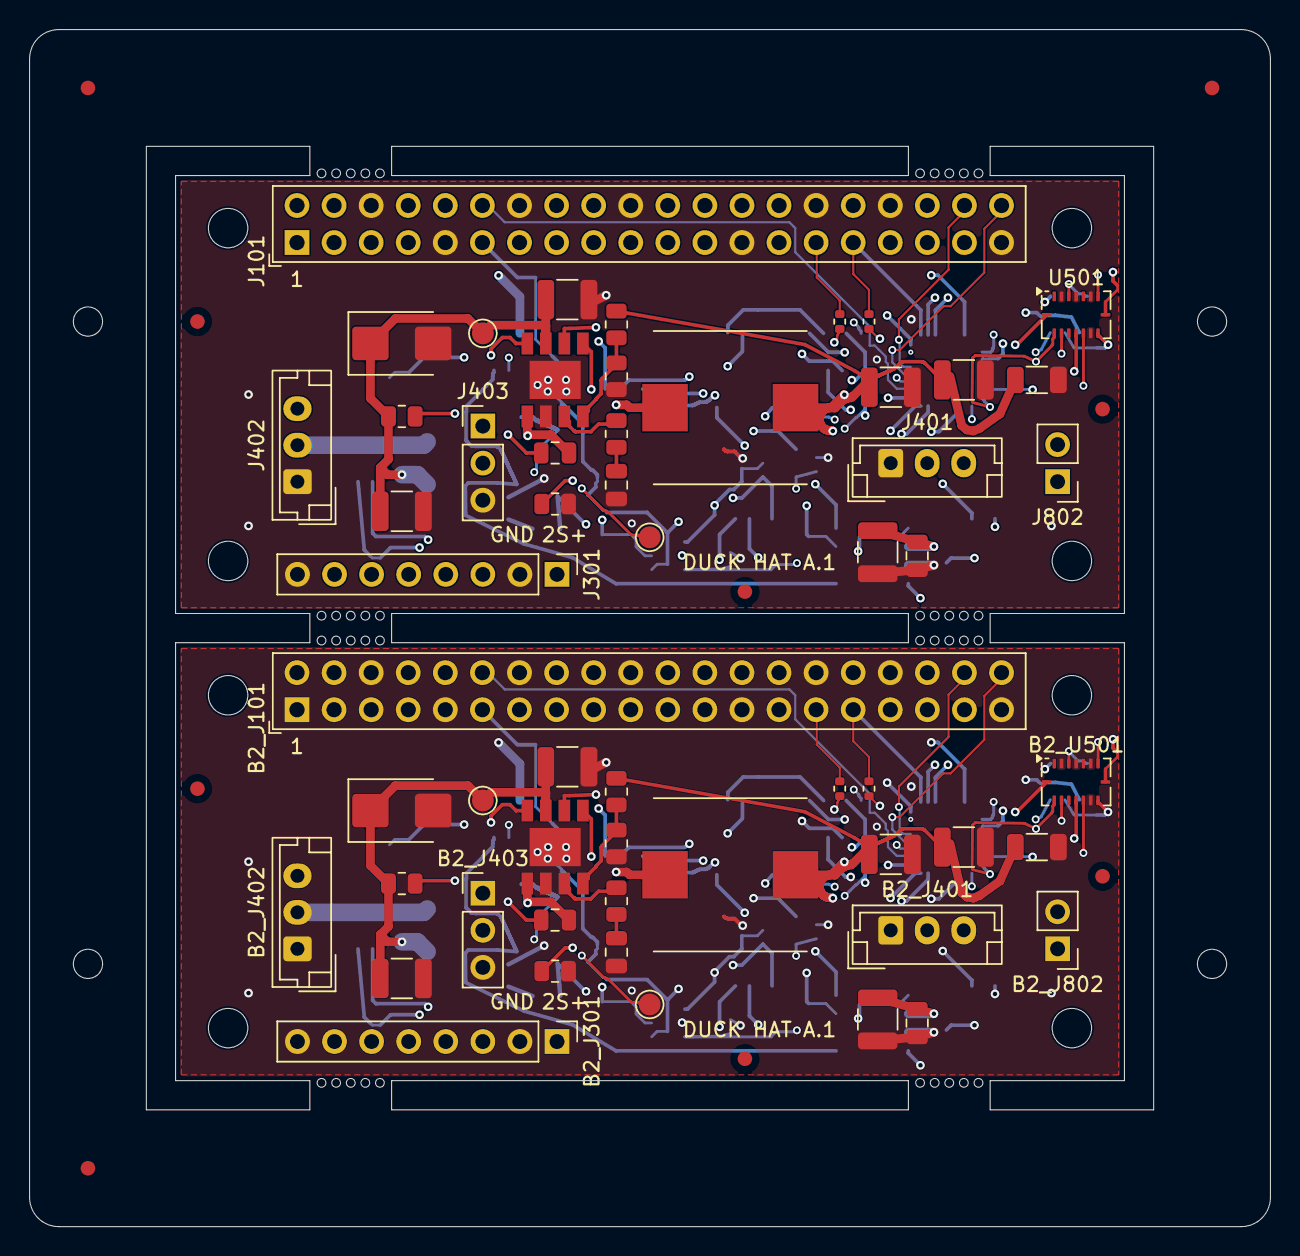
[picture p292: board hat_a1_smt_2up.kicad_pcb from above]

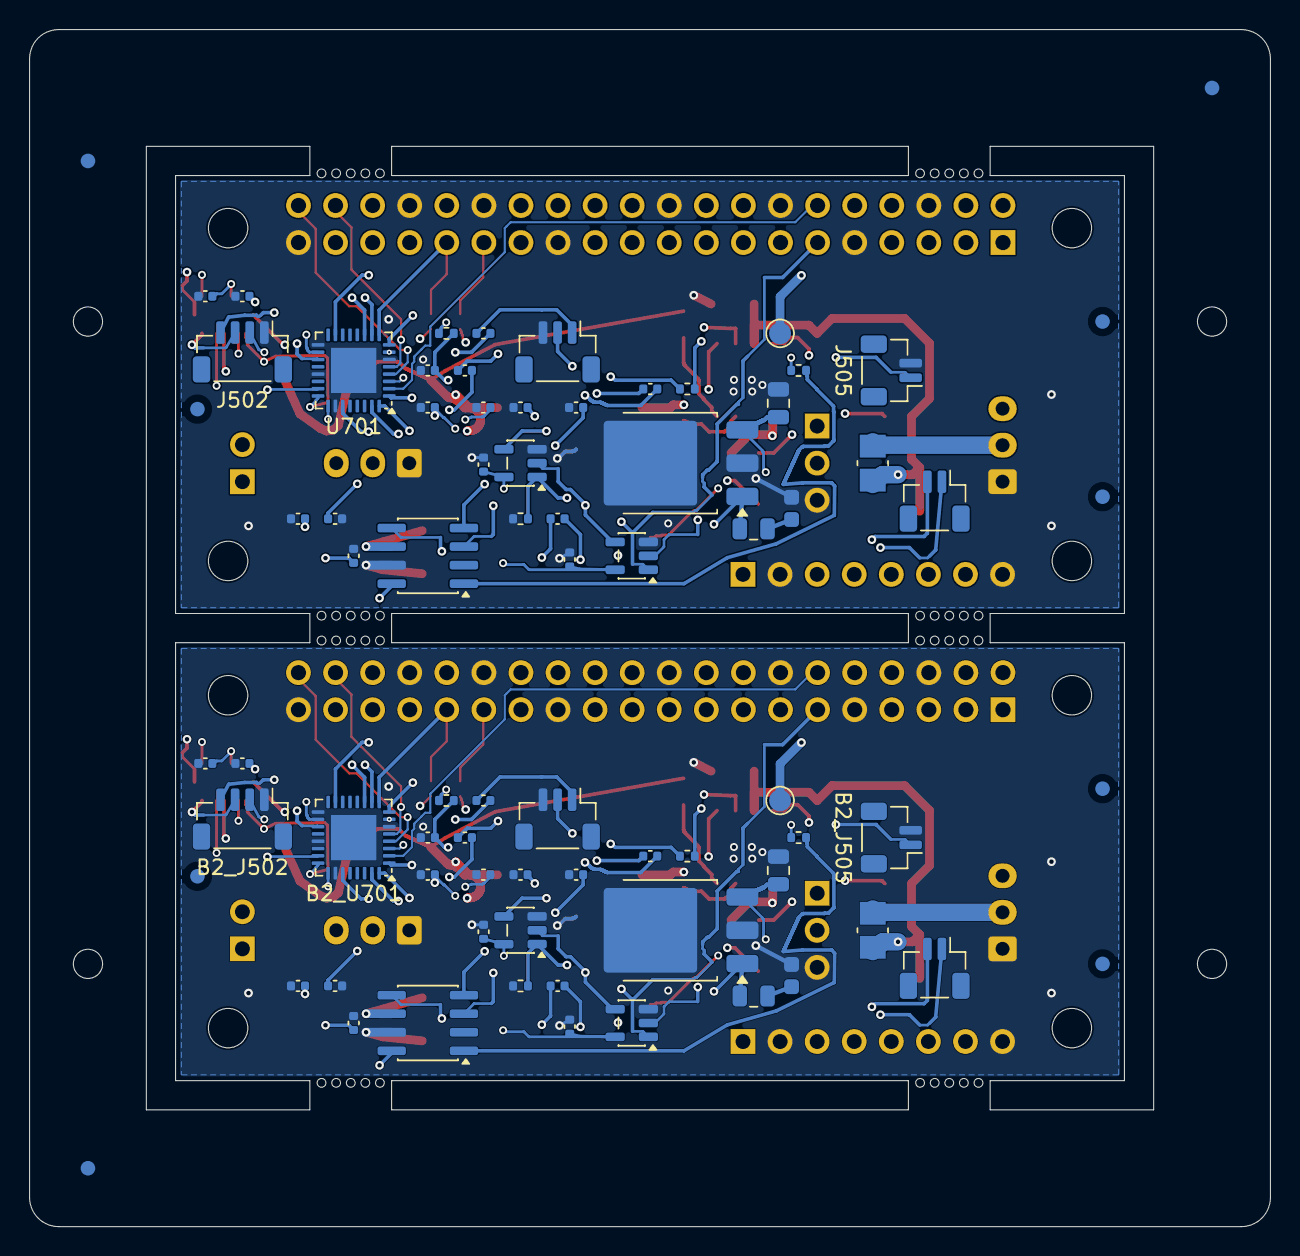
[picture p293: board hat_a1_smt_2up.kicad_pcb from below]

Board: 4 copper layers, 85.0 x 82.0 mm, 194 parts (77 on the bottom side), 84 nets.

Parts:
B2_C301: 3.3nF; C_0805_2012Metric
B2_C302: 100nF; C_0805_2012Metric
B2_C303, B2_C304, B2_C305, B2_C306, B2_C323: 22uF; C_1210_3225Metric
B2_C307: 22uF reserve; C_1206_3216Metric
B2_C308, B2_C328: 2.2uF; C_0805_2012Metric
B2_C309: 2.2uF; C_0805_2012Metric_LDO_ClearSilk
B2_C310, B2_C312, B2_C319, B2_C320, B2_C327, B2_C329, B2_C330: 100nF; C_0402_1005Metric
B2_C311, B2_C313, B2_C315, B2_C321, B2_C322, B2_C325, B2_C326: 1uF; C_0402_1005Metric
B2_C317, B2_C318: 10uF; C_0402_1005Metric
B2_D301: SMBJ12A (fitted); D_SMB
B2_FID1, B2_FID2, B2_FID3, B2_FID4, B2_FID5, B2_FID6: Fiducial_1mm_Mask2mm
B2_H1, B2_H2: MountingHole_2.7mm_M2.5; MountingHole_2.7_M2.5_Head4.5
B2_H3, B2_H4: MountingHole_2.7mm_M2.5
B2_J101: RADXA_ZERO_3W_40P; Radxa40P_Samtec_SSW120
B2_J301: POWER_AND_RAILS; Samtec_TSW108_07
B2_J401: DYNAMIXEL_TTL_1; JST_EH_B3B-EH-A_1x03_P2.50mm_Vertical
B2_J402: DYNAMIXEL_TTL_2; JST_EH_B3B-EH-A_1x03_P2.50mm_Vertical
B2_J403: HOST_UART2; Samtec_TSW103_07
B2_J502: TOF_I2C5; JST_SH_BM04B-SRSS-TB_1x04-1MP_P1.00mm_Vertical
B2_J504: AUDIO_OUT_SH; JST_SH_BM03B-SRSS-TB_1x03-1MP_P1.00mm_Vertical
B2_J505: MIC_IN; JST_SH_BM02B-SRSS-TB_1x02-1MP_P1.00mm_Vertical
B2_J506: SPEAKER; JST_SH_BM02B-SRSS-TB_1x02-1MP_P1.00mm_Vertical
B2_J802: IMU_INT_TP; Samtec_TSW102_07
B2_L301: 5.6uH; IHLP4040DZ_5A_Above2u2
B2_R301: 52.3k; R_0805_2012Metric
B2_R302: 10k; R_0805_2012Metric
B2_R303: 200k; R_0805_2012Metric
B2_R304: 14k; R_0805_2012Metric
B2_R305: 100k; R_0805_2012Metric
B2_R308: 10k; R_0402_1005Metric
B2_R309: 0R; Vishay_WSL1206_Jumper
B2_R310, B2_R311: 100k; R_0402_1005Metric
B2_R312: 2.2k; R_0402_1005Metric
B2_R501, B2_R502: 4.7k; R_0402_1005Metric
B2_R703: 0.047; Vishay_WSLP0603_Damping
B2_TP801: VBATT_2S_IN; TestPoint_Pad_D1.5mm
B2_TP802: +5V; TestPoint_Pad_D1.5mm
B2_TP803: +3V3; TestPoint_Pad_D1.5mm
B2_U301: AP64350; SO-8EP_AP64350
B2_U501: BMI088; Bosch_LGA-16_4.5x3mm_P0.5mm_LayoutBorder7x1y_ClockwisePinNu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
B2_U701: TLV320AIC3104; VQFN-32-1EP_5x5mm_P0.5mm_EP3.1x3.1mm
B2_U702: LP38691DT-1.8; TO-252-3_TabPin2
B2_U801: SN74LVC1G126; SOT-23-5
B2_U802: SN74LVC1G125; SOT-23-5
B2_U803: PAM8302A; SOIC-8_3.9x4.9mm_P1.27mm
C301: 3.3nF; C_0805_2012Metric
C302: 100nF; C_0805_2012Metric
C303, C304, C305, C306, C323: 22uF; C_1210_3225Metric
C307: 22uF reserve; C_1206_3216Metric
C308, C328: 2.2uF; C_0805_2012Metric
C309: 2.2uF; C_0805_2012Metric_LDO_ClearSilk
C310, C312, C319, C320, C327, C329, C330: 100nF; C_0402_1005Metric
C311, C313, C315, C321, C322, C325, C326: 1uF; C_0402_1005Metric
C317, C318: 10uF; C_0402_1005Metric
D301: SMBJ12A (fitted); D_SMB
FID1, FID2, FID3, FID4, FID5, FID6: Fiducial_1mm_Mask2mm
H1, H2: MountingHole_2.7mm_M2.5; MountingHole_2.7_M2.5_Head4.5
H3, H4: MountingHole_2.7mm_M2.5
J101: RADXA_ZERO_3W_40P; Radxa40P_Samtec_SSW120
J301: POWER_AND_RAILS; Samtec_TSW108_07
J401: DYNAMIXEL_TTL_1; JST_EH_B3B-EH-A_1x03_P2.50mm_Vertical
J402: DYNAMIXEL_TTL_2; JST_EH_B3B-EH-A_1x03_P2.50mm_Vertical
J403: HOST_UART2; Samtec_TSW103_07
J502: TOF_I2C5; JST_SH_BM04B-SRSS-TB_1x04-1MP_P1.00mm_Vertical
J504: AUDIO_OUT_SH; JST_SH_BM03B-SRSS-TB_1x03-1MP_P1.00mm_Vertical
J505: MIC_IN; JST_SH_BM02B-SRSS-TB_1x02-1MP_P1.00mm_Vertical
J506: SPEAKER; JST_SH_BM02B-SRSS-TB_1x02-1MP_P1.00mm_Vertical
J802: IMU_INT_TP; Samtec_TSW102_07
L301: 5.6uH; IHLP4040DZ_5A_Above2u2
MB1, MB2, MB3, MB4, MB5, MB6, MB7, MB8, MB9, MB10, MB11, MB12, MB13, MB14, MB15, MB16, MB17, MB18, MB19, MB20, MB21, MB22, MB23, MB24, MB25, MB26, MB27, MB28, MB29, MB30, MB31, MB32, MB33, MB34, MB35, MB36, MB37, MB38, MB39, MB40: Panel NPTH
PFID_B1, PFID_B2, PFID_B3: Panel fiducial 1mm/2mm
PFID_F1, PFID_F2, PFID_F3: Panel fiducial 1mm/2mm
PH1, PH2, PH3, PH4: Panel NPTH
R301: 52.3k; R_0805_2012Metric
R302: 10k; R_0805_2012Metric
R303: 200k; R_0805_2012Metric
R304: 14k; R_0805_2012Metric
R305: 100k; R_0805_2012Metric
R308: 10k; R_0402_1005Metric
R309: 0R; Vishay_WSL1206_Jumper
R310, R311: 100k; R_0402_1005Metric
R312: 2.2k; R_0402_1005Metric
R501, R502: 4.7k; R_0402_1005Metric
R703: 0.047; Vishay_WSLP0603_Damping
TP801: VBATT_2S_IN; TestPoint_Pad_D1.5mm
TP802: +5V; TestPoint_Pad_D1.5mm
TP803: +3V3; TestPoint_Pad_D1.5mm
U301: AP64350; SO-8EP_AP64350
U501: BMI088; Bosch_LGA-16_4.5x3mm_P0.5mm_LayoutBorder7x1y_ClockwisePinNu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
U701: TLV320AIC3104; VQFN-32-1EP_5x5mm_P0.5mm_EP3.1x3.1mm
U702: LP38691DT-1.8; TO-252-3_TabPin2
U801: SN74LVC1G126; SOT-23-5
U802: SN74LVC1G125; SOT-23-5
U803: PAM8302A; SOIC-8_3.9x4.9mm_P1.27mm

Connections:
+1V8_CODEC: C309.1, C311.1, J301.6, U701.32, U702.1
+3V3: C308.1, C312.1, C313.1, C315.1, C319.1, C320.1, C329.1, C330.1, J101.1, J101.17, J301.4, J502.2, R308.2, R311.2, R501.1, R502.1, TP803.1, U501.3, U501.7, U501.11, U501.14, U501.15, U701.7, U701.18, U701.24, U701.25, U702.3, U801.5, U802.5
+5V: C305.1, C306.1, C307.1, C323.1, C328.1, J101.2, J101.4, J301.3, L301.2, R301.1, TP802.1, U803.6
+5V_FB: R301.2, R302.1, U301.5
AUDIO_AMP_EN: R311.1, U803.1
AUDIO_AMP_INN: C322.1, U803.4
AUDIO_AMP_INP: C321.2, U803.3
AUDIO_HP_L: C317.1, U701.19
AUDIO_HP_R: C318.1, U701.23
AUDIO_L: C317.2, J504.1
AUDIO_LINE_L: C321.1, U701.27
AUDIO_MIC: C325.1, J505.1, R312.2
AUDIO_MIC_AC: C325.2, U701.10
AUDIO_MIC_BIAS: C327.1, R312.1, U701.15
AUDIO_MIC_REF: C326.2, U701.11
AUDIO_R: C318.2, J504.2
B2/+1V8_CODEC: B2_C309.1, B2_C311.1, B2_J301.6, B2_U701.32, B2_U702.1
B2/+3V3: B2_C308.1, B2_C312.1, B2_C313.1, B2_C315.1, B2_C319.1, B2_C320.1, B2_C329.1, B2_C330.1, B2_J101.1, B2_J101.17, B2_J301.4, B2_J502.2, B2_R308.2, B2_R311.2, B2_R501.1, B2_R502.1, B2_TP803.1, B2_U501.3, B2_U501.7, B2_U501.11, B2_U501.14, B2_U501.15, B2_U701.7, B2_U701.18, B2_U701.24, B2_U701.25, B2_U702.3, B2_U801.5, B2_U802.5
B2/+5V: B2_C305.1, B2_C306.1, B2_C307.1, B2_C323.1, B2_C328.1, B2_J101.2, B2_J101.4, B2_J301.3, B2_L301.2, B2_R301.1, B2_TP802.1, B2_U803.6
B2/+5V_FB: B2_R301.2, B2_R302.1, B2_U301.5
B2/AUDIO_AMP_EN: B2_R311.1, B2_U803.1
B2/AUDIO_AMP_INN: B2_C322.1, B2_U803.4
B2/AUDIO_AMP_INP: B2_C321.2, B2_U803.3
B2/AUDIO_HP_L: B2_C317.1, B2_U701.19
B2/AUDIO_HP_R: B2_C318.1, B2_U701.23
B2/AUDIO_L: B2_C317.2, B2_J504.1
B2/AUDIO_LINE_L: B2_C321.1, B2_U701.27
B2/AUDIO_MIC: B2_C325.1, B2_J505.1, B2_R312.2
B2/AUDIO_MIC_AC: B2_C325.2, B2_U701.10
B2/AUDIO_MIC_BIAS: B2_C327.1, B2_R312.1, B2_U701.15
B2/AUDIO_MIC_REF: B2_C326.2, B2_U701.11
B2/AUDIO_R: B2_C318.2, B2_J504.2
B2/BMI_INT1_TP: B2_J802.1, B2_U501.16
B2/BMI_INT3_TP: B2_J802.2, B2_U501.12
B2/BUCK_BST: B2_C302.1, B2_U301.1
B2/BUCK_COMP: B2_R304.1, B2_U301.6
B2/BUCK_EN: B2_R305.2, B2_U301.3
B2/BUCK_RT: B2_R303.1, B2_U301.4
B2/BUCK_SW: B2_C302.2, B2_L301.1, B2_U301.8
B2/CODEC_RST: B2_C310.1, B2_J101.33, B2_R308.1, B2_U701.31
B2/COMP_RC: B2_C301.1, B2_R304.2
B2/DXL_DATA: B2_J401.3, B2_J402.3, B2_U801.4, B2_U802.2
B2/DXL_DIR: B2_J101.11, B2_R310.1, B2_U801.1, B2_U802.1
B2/I2C5_SCL: B2_J101.29, B2_J502.4, B2_R501.2, B2_U501.8, B2_U701.8
B2/I2C5_SDA: B2_J101.31, B2_J502.3, B2_R502.2, B2_U501.9, B2_U701.9
B2/I2S_BCLK: B2_J101.12, B2_U701.2
B2/I2S_LRCK: B2_J101.35, B2_U701.3
B2/I2S_MCLK: B2_J101.13, B2_U701.1
B2/I2S_SDI: B2_J101.38, B2_U701.5
B2/I2S_SDO: B2_J101.40, B2_U701.4
B2/LDO_CAP_RETURN: B2_C309.2, B2_R703.1
B2/POWER_GND: B2_C301.2, B2_C303.2, B2_C304.2, B2_C305.2, B2_C306.2, B2_C307.2, B2_C308.2, B2_C310.2, B2_C311.2, B2_C312.2, B2_C313.2, B2_C315.2, B2_C319.2, B2_C320.2, B2_C322.2, B2_C323.2, B2_C326.1, B2_C327.2, B2_C328.2, B2_C329.2, B2_C330.2, B2_D301.2, B2_J101.6, B2_J101.9, B2_J101.14, B2_J101.20, B2_J101.25, B2_J101.30, B2_J101.34, B2_J101.39, B2_J301.2, B2_J301.8, B2_J401.1, B2_J402.1, B2_J403.3, B2_J502.1, B2_J504.3, B2_J505.2, B2_R302.2, B2_R303.2, B2_R310.2, B2_R703.2, B2_U301.7, B2_U301.9, B2_U501.2, B2_U501.4, B2_U501.6, B2_U501.10, B2_U701.6, B2_U701.17, B2_U701.21, B2_U701.26, B2_U701.33, B2_U702.2, B2_U801.3, B2_U802.3, B2_U803.7
B2/SERVO_VBAT: B2_J301.7, B2_J401.2, B2_J402.2, B2_R309.2
B2/SPK_N: B2_J506.2, B2_U803.8
B2/SPK_P: B2_J506.1, B2_U803.5
B2/UART2_RX: B2_J101.10, B2_J403.2, B2_U802.4
B2/UART2_TX: B2_J101.8, B2_J403.1, B2_U801.2
B2/VBATT_2S_IN: B2_C303.1, B2_C304.1, B2_D301.1, B2_J301.1, B2_R305.1, B2_R309.1, B2_TP801.1, B2_U301.2
BMI_INT1_TP: J802.1, U501.16
BMI_INT3_TP: J802.2, U501.12
BUCK_BST: C302.1, U301.1
BUCK_COMP: R304.1, U301.6
BUCK_EN: R305.2, U301.3
BUCK_RT: R303.1, U301.4
BUCK_SW: C302.2, L301.1, U301.8
CODEC_RST: C310.1, J101.33, R308.1, U701.31
COMP_RC: C301.1, R304.2
DXL_DATA: J401.3, J402.3, U801.4, U802.2
DXL_DIR: J101.11, R310.1, U801.1, U802.1
I2C5_SCL: J101.29, J502.4, R501.2, U501.8, U701.8
I2C5_SDA: J101.31, J502.3, R502.2, U501.9, U701.9
I2S_BCLK: J101.12, U701.2
I2S_LRCK: J101.35, U701.3
I2S_MCLK: J101.13, U701.1
I2S_SDI: J101.38, U701.5
I2S_SDO: J101.40, U701.4
LDO_CAP_RETURN: C309.2, R703.1
POWER_GND: C301.2, C303.2, C304.2, C305.2, C306.2, C307.2, C308.2, C310.2, C311.2, C312.2, C313.2, C315.2, C319.2, C320.2, C322.2, C323.2, C326.1, C327.2, C328.2, C329.2, C330.2, D301.2, J101.6, J101.9, J101.14, J101.20, J101.25, J101.30, J101.34, J101.39, J301.2, J301.8, J401.1, J402.1, J403.3, J502.1, J504.3, J505.2, R302.2, R303.2, R310.2, R703.2, U301.7, U301.9, U501.2, U501.4, U501.6, U501.10, U701.6, U701.17, U701.21, U701.26, U701.33, U702.2, U801.3, U802.3, U803.7
SERVO_VBAT: J301.7, J401.2, J402.2, R309.2
SPK_N: J506.2, U803.8
SPK_P: J506.1, U803.5
UART2_RX: J101.10, J403.2, U802.4
UART2_TX: J101.8, J403.1, U801.2
VBATT_2S_IN: C303.1, C304.1, D301.1, J301.1, R305.1, R309.1, TP801.1, U301.2
