parkourlrc/pcb-yilv1982--duck-robot-89dbc81d6d/docs/references/扩展板双口惯性缺答复核/sources/upstream-dynamixel.kicad_sch

## KiCad design docs/references/扩展板双口惯性缺答复核/sources/upstream-dynamixel.kicad_sch (2026-10-27)

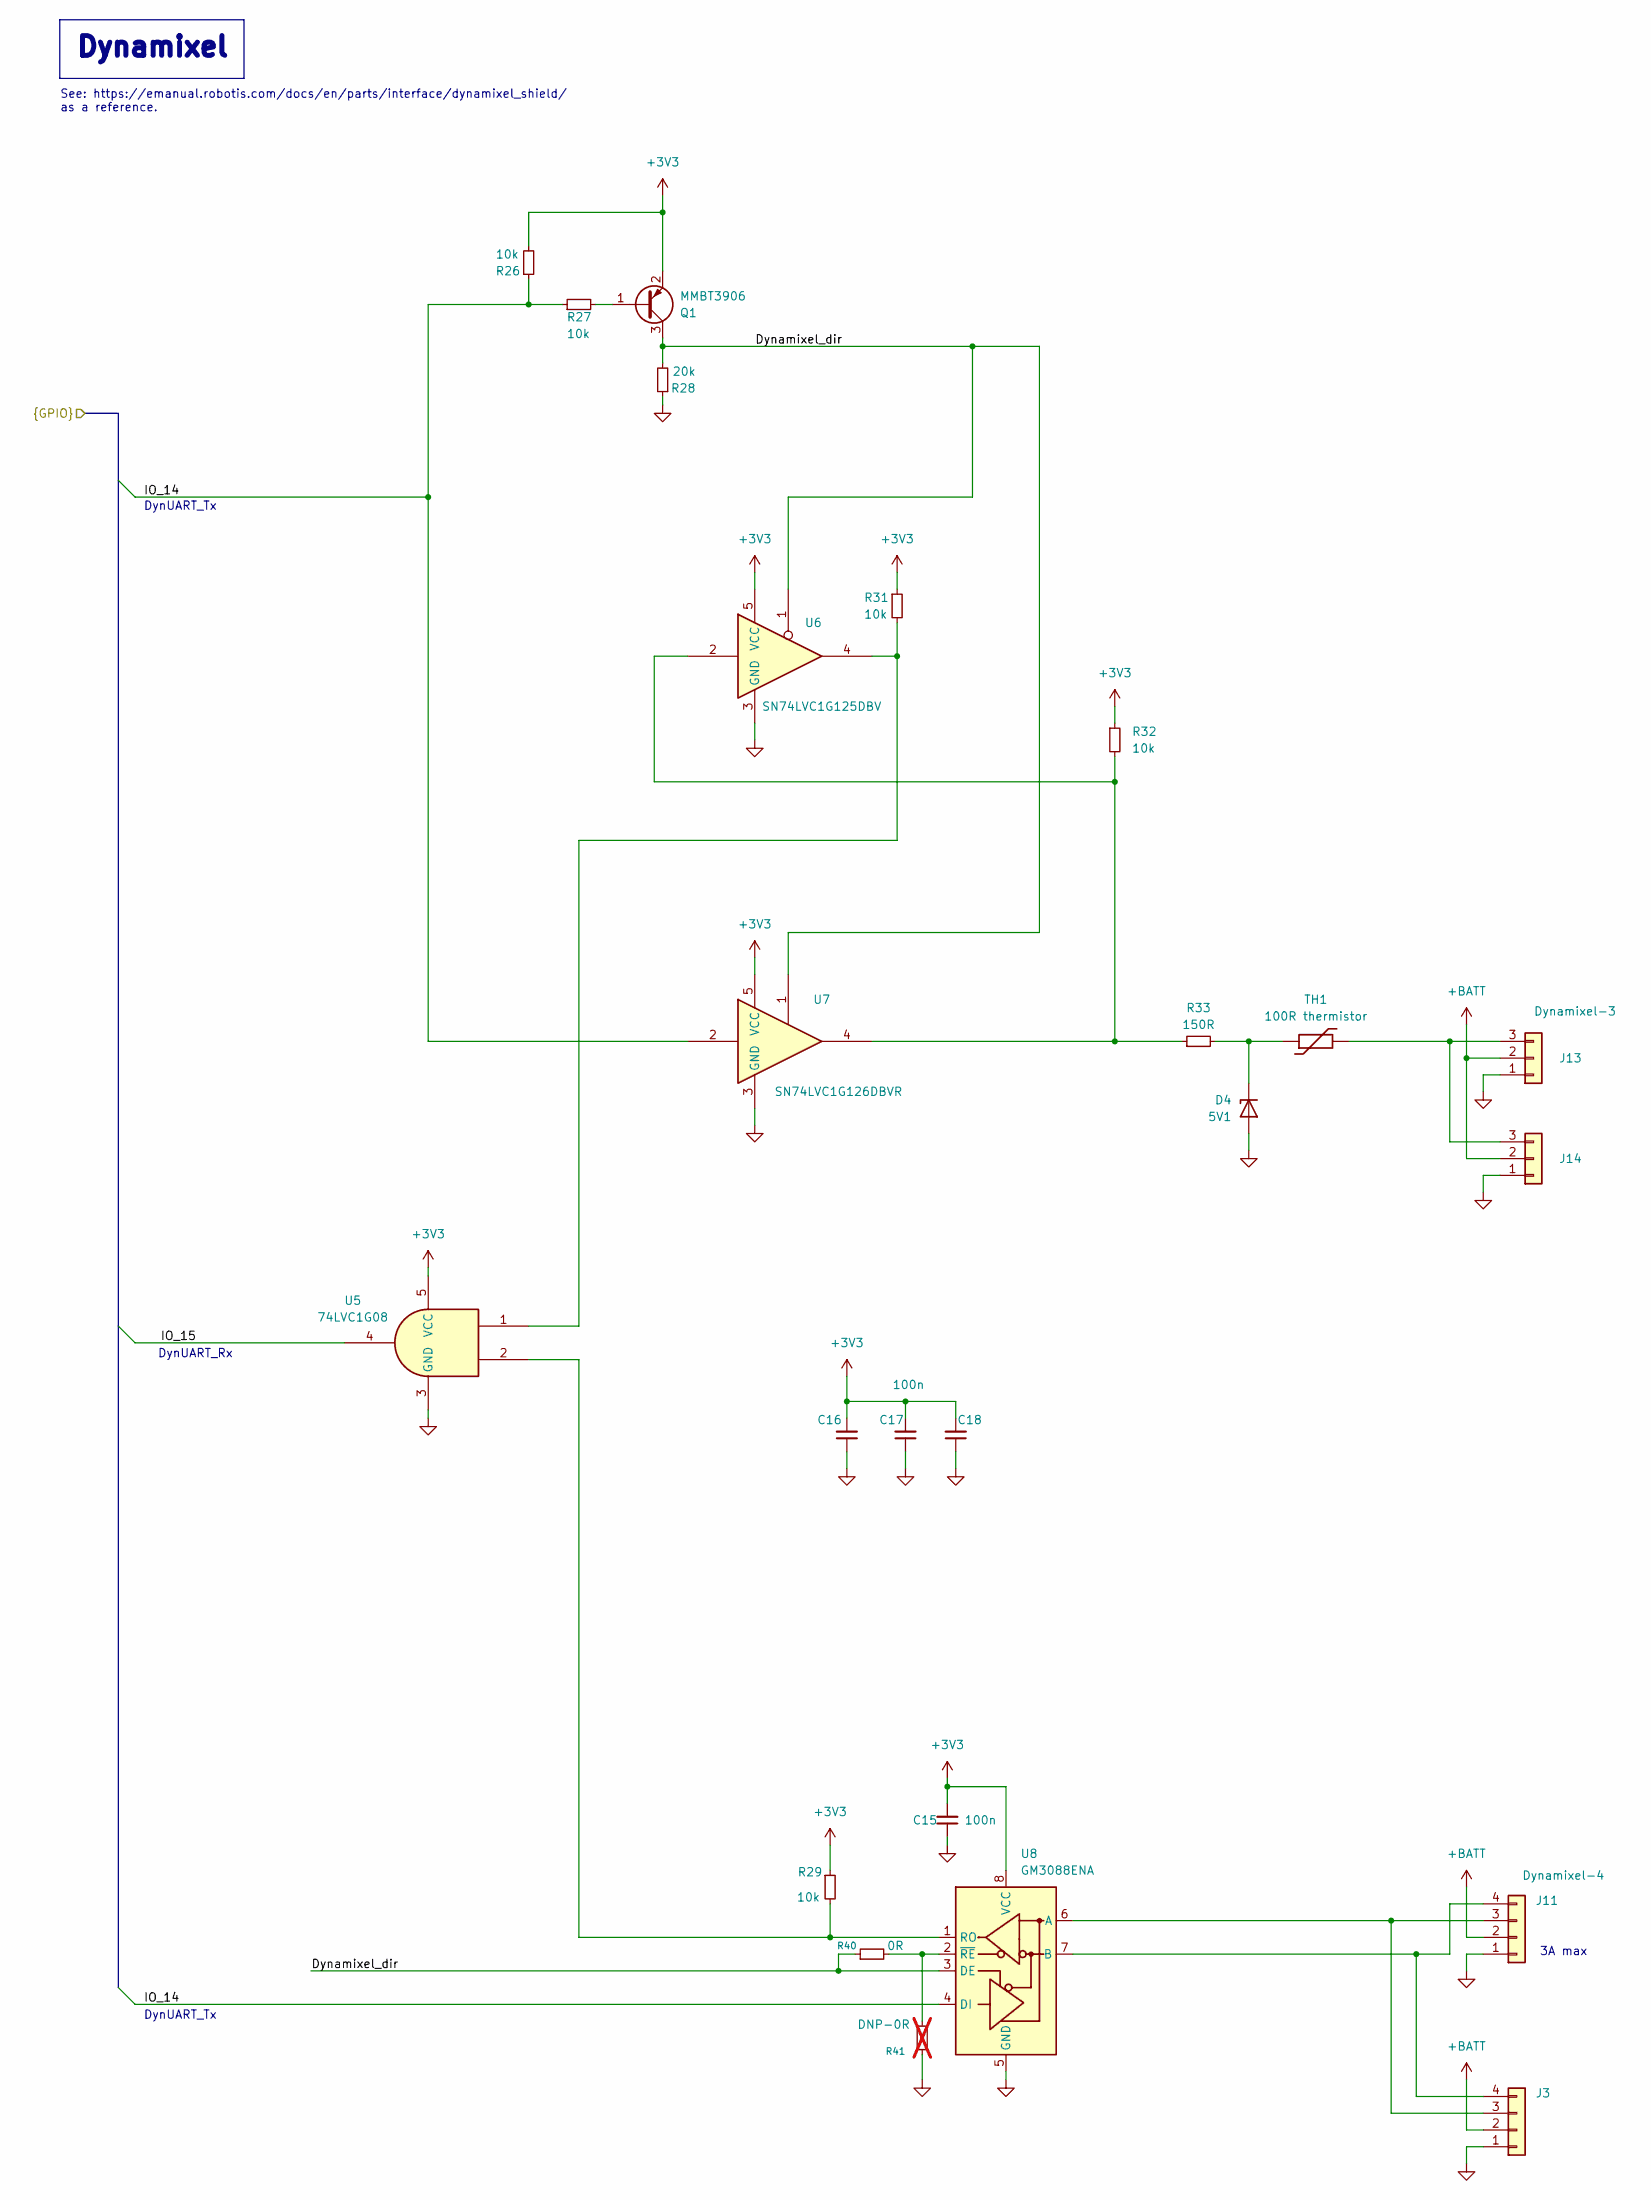
[picture p294: schematic upstream-dynamixel.kicad_sch]

Parts:
C15, C16, C17, C18: 100n; C_0402_1005Metric; LCSC Part C307331
D4: 5V1; D_SOD-323; LCSC Part C151348
J3, J11: Dynamixel-4; JST_EH_B4B-EH-A_1x04_P2.50mm_Vertical; LCSC Part C160258
J13, J14: Dynamixel-3; JST_EH_B3B-EH-A_1x03_P2.50mm_Vertical; LCSC Part C160259
Q1: MMBT3906; SOT-23; LCSC Part C727128
R26, R27, R29, R31, R32: 10k; R_0402_1005Metric; LCSC Part C25744
R28: 20k; R_0402_1005Metric; LCSC Part C25765
R33: 150R; R_0402_1005Metric; LCSC Part C2909321
R40: 0R; R_0402_1005Metric; LCSC Part C17168
R41: DNP-0R; R_0402_1005Metric; not fitted
TH1: 100R thermistor; R_0603_1608Metric; LCSC Part C913703
U5: 74LVC1G08; SOT-23-5; LCSC Part C7666
U6: SN74LVC1G125DBV; SOT-23-5; LCSC Part C23654
U7: SN74LVC1G126DBVR; SOT-23-5; LCSC Part C7834
U8: GM3088ENA; DFN-8-1EP_3x3mm_P0.65mm_EP1.2x2.15mm; LCSC Part C49423279

Connections:
+3V3: C15.2, C16.2, C17.2, C18.2, Q1.2 (E), R26.2, R29.1, R31.1, R32.1, U5.5 (VCC), U6.5 (VCC), U7.5 (VCC), U8.8 (VCC)
+BATT: J3.2, J11.2, J13.2, J14.2
Dynamixel_dir: Q1.3 (C), R28.2, R40.1, U6.1, U7.1, U8.3 (DE)
GND: C15.1, C16.1, C17.1, C18.1, D4.2 (A), J3.1, J11.1, J13.1, J14.1, R28.1, R41.1, U5.3 (GND), U6.3 (GND), U7.3 (GND), U8.5 (GND)
IO_14: R26.1, R27.1, U7.2, U8.4 (DI)
IO_15: U5.4
unnamed: D4.1 (K), R33.2, TH1.1
unnamed: J3.3, J11.3, U8.6 (A)
unnamed: J3.4, J11.4, U8.7 (B)
unnamed: J13.3, J14.3, TH1.2
unnamed: Q1.1 (B), R27.2
unnamed: R29.2, U5.2, U8.1 (RO)
unnamed: R31.2, U5.1, U6.4
unnamed: R32.2, R33.1, U6.2, U7.4
unnamed: R40.2, R41.2, U8.2 (~RE)

Notes on the sheet:
DynUART_Tx
DynUART_Rx
See: https://emanual.robotis.com/docs/en/parts/interface/dynamixel_shield/ as a reference.
3A max
Dynamixel
