parkourlrc/pcb-yilv1982--duck-robot-89dbc81d6d/docs/references/扩展板电路仿真工具/bom-passives-20261031/before-metadata/audio.kicad_sch

## KiCad design docs/references/扩展板电路仿真工具/bom-passives-20261031/before-metadata/audio.kicad_sch (2026-11-02)

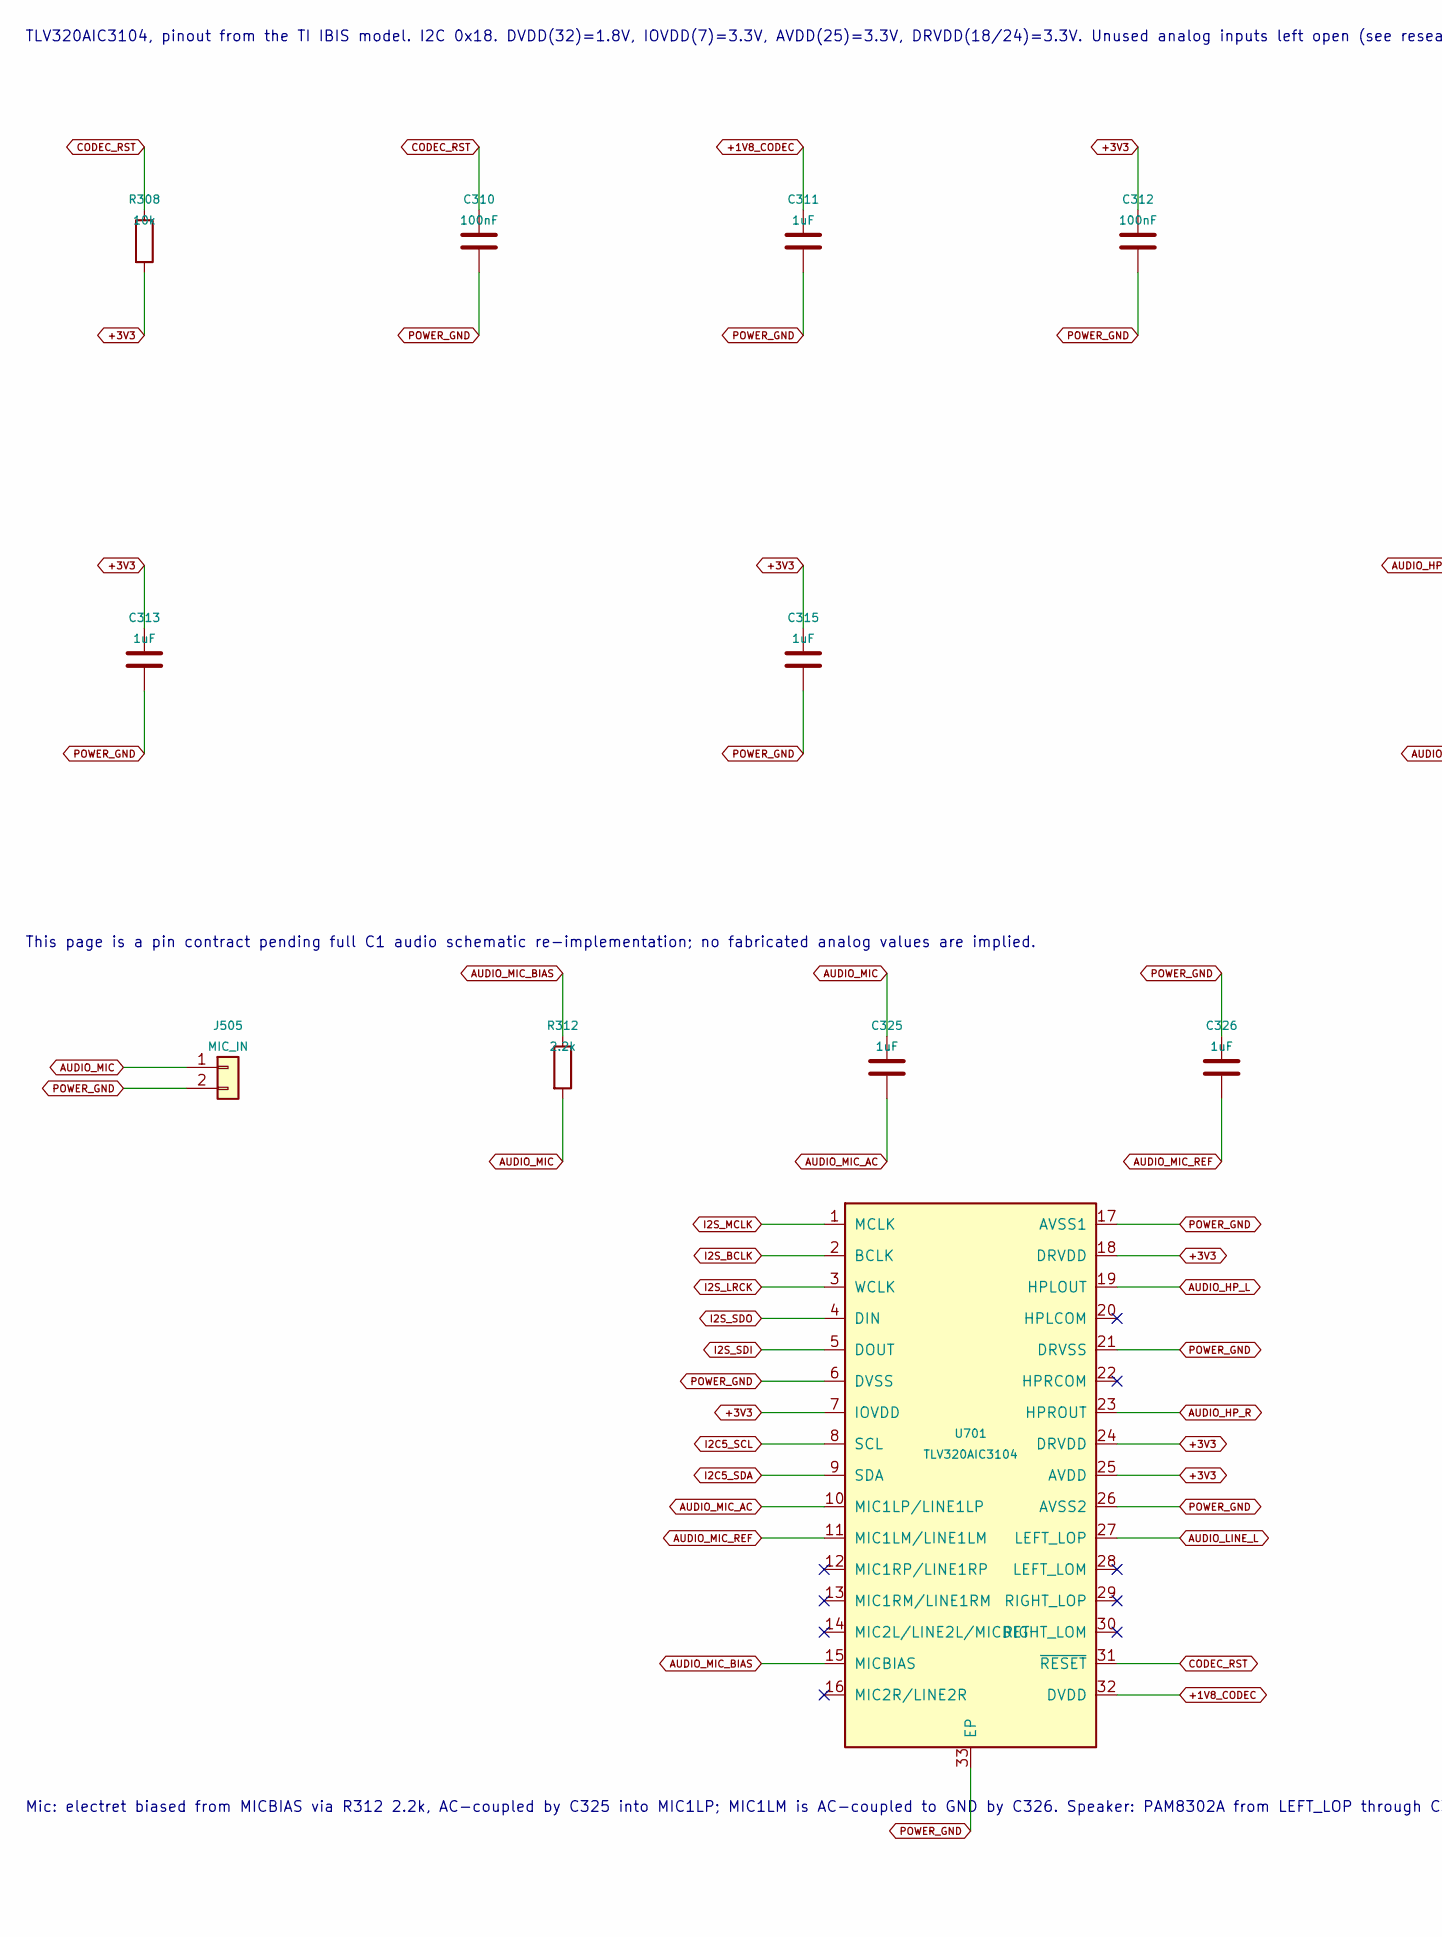
[picture p295: schematic audio.kicad_sch, part in row 1, column 1]

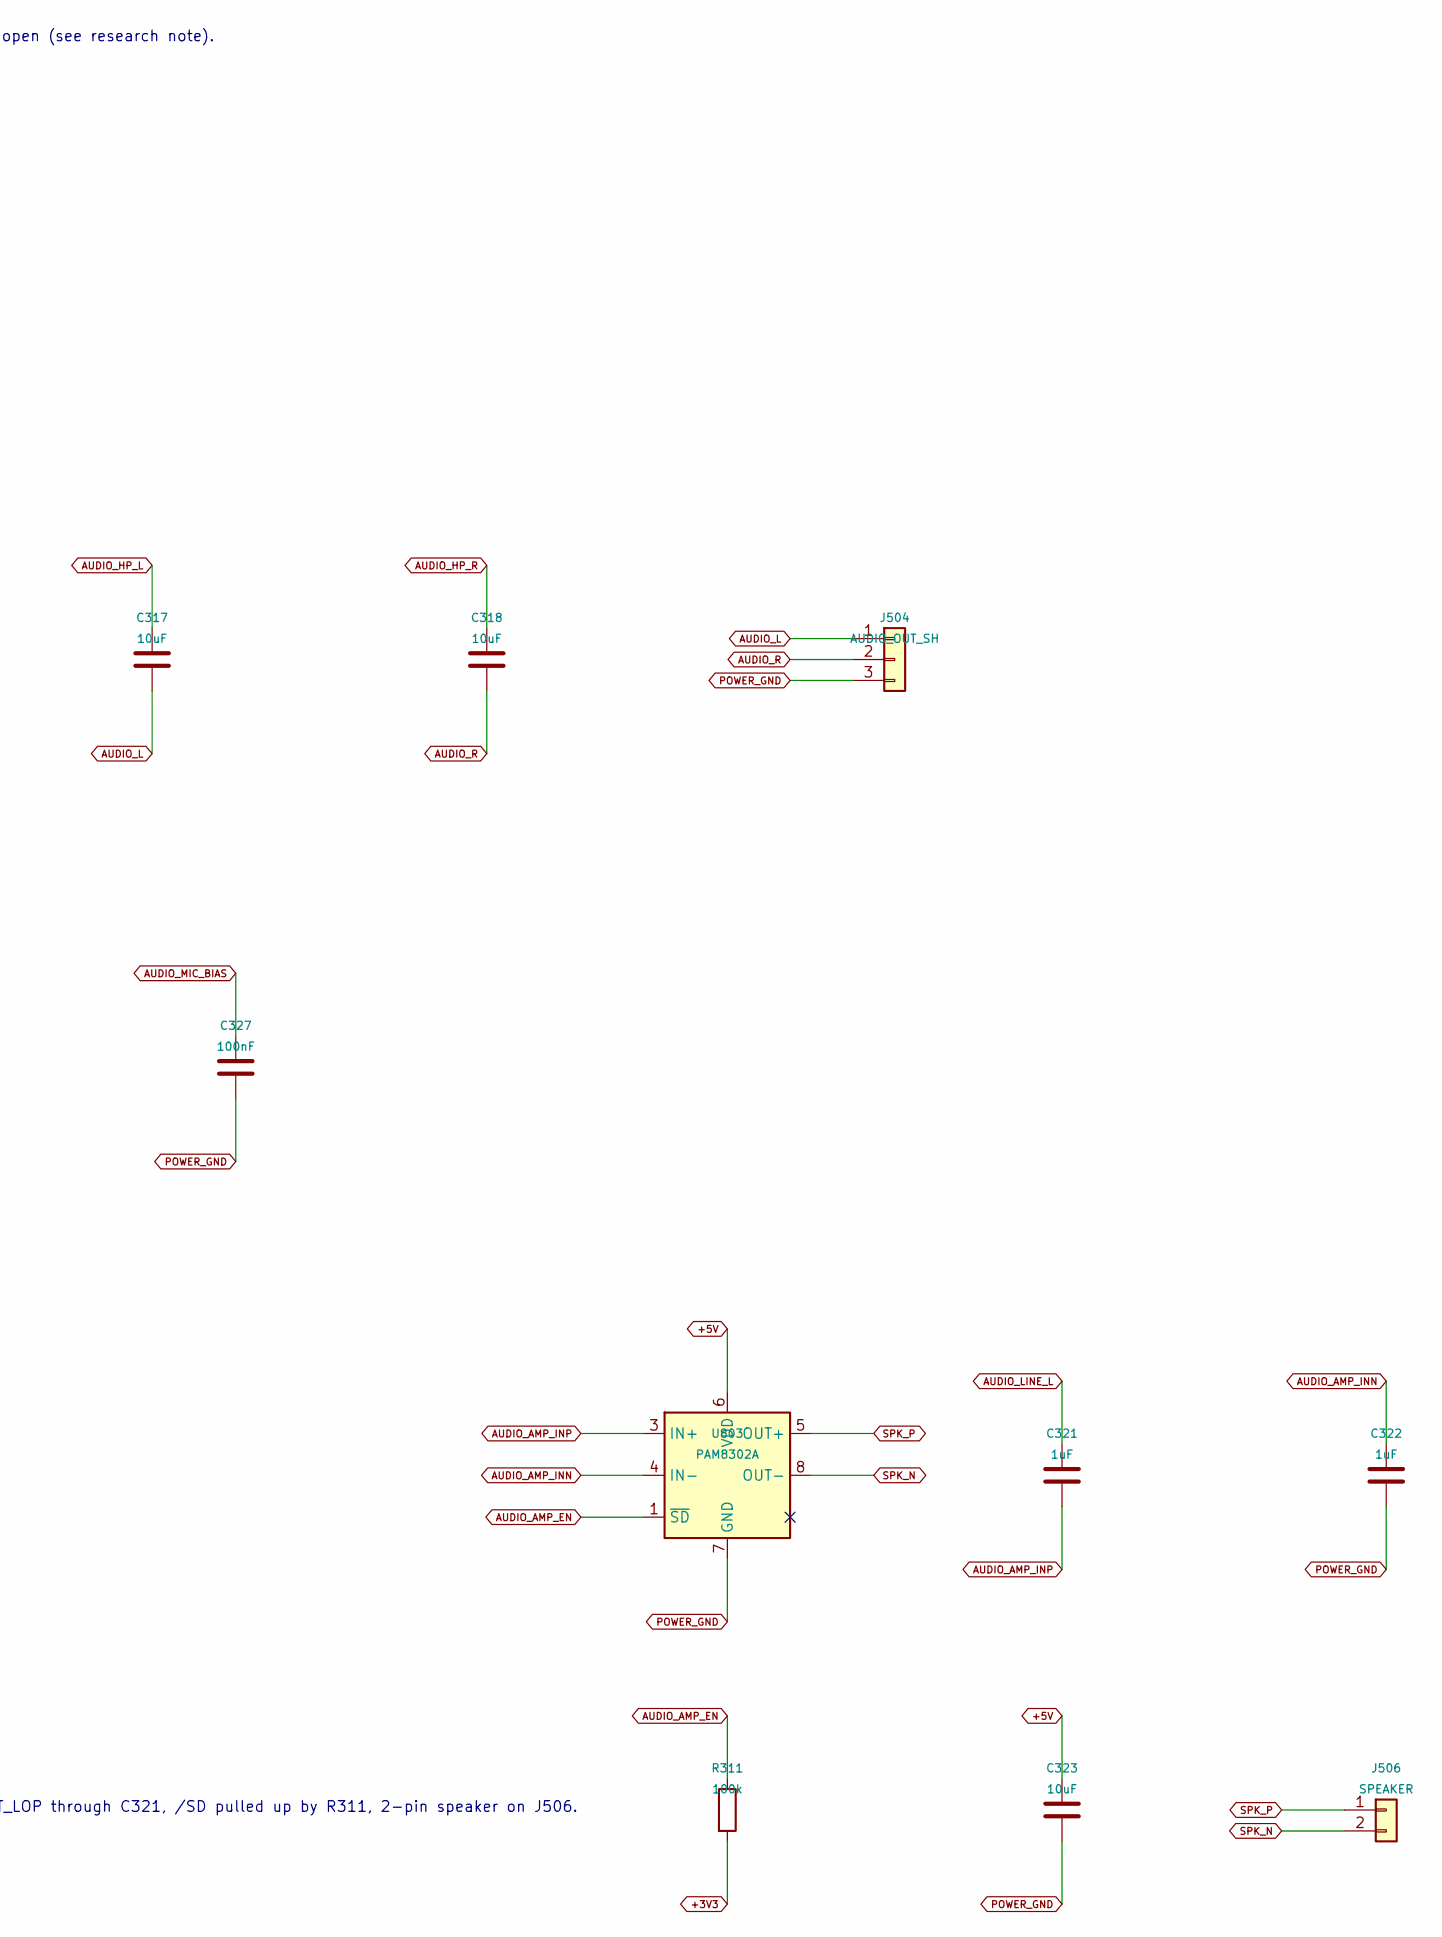
[picture p296: schematic audio.kicad_sch, part in row 1, column 2]

Parts:
C310, C312, C327: 100nF; C_0402_1005Metric
C311, C313, C315, C321, C322, C325, C326: 1uF; C_0402_1005Metric
C317, C318: 10uF; C_0402_1005Metric
C323: 10uF; C_0805_2012Metric
J504: AUDIO_OUT_SH; JST_SH_BM03B-SRSS-TB_1x03-1MP_P1.00mm_Vertical
J505: MIC_IN; JST_SH_BM02B-SRSS-TB_1x02-1MP_P1.00mm_Vertical
J506: SPEAKER; JST_SH_BM02B-SRSS-TB_1x02-1MP_P1.00mm_Vertical
R308: 10k; R_0402_1005Metric; MPN CRCW040210K0FKED
R311: 100k; R_0402_1005Metric; MPN CRCW0402100KFKED
R312: 2.2k; R_0402_1005Metric; MPN CRCW04022K20FKED
U701: TLV320AIC3104; VQFN-32-1EP_5x5mm_P0.5mm_EP3.1x3.1mm; MPN TLV320AIC3104IRHBR
U803: PAM8302A; SOIC-8_3.9x4.9mm_P1.27mm; MPN PAM8302AADCR

Connections:
+1V8_CODEC: C311.1, U701.32 (DVDD)
+3V3: C312.1, C313.1, C315.1, R308.2, R311.2, U701.7 (IOVDD), U701.18 (DRVDD), U701.24 (DRVDD), U701.25 (AVDD)
+5V: C323.1, U803.6 (VDD)
AUDIO_AMP_EN: R311.1, U803.1 (~SD)
AUDIO_AMP_INN: C322.1, U803.4 (IN-)
AUDIO_AMP_INP: C321.2, U803.3 (IN+)
AUDIO_HP_L: C317.1, U701.19 (HPLOUT)
AUDIO_HP_R: C318.1, U701.23 (HPROUT)
AUDIO_L: C317.2, J504.1
AUDIO_LINE_L: C321.1, U701.27 (LEFT_LOP)
AUDIO_MIC: C325.1, J505.1, R312.2
AUDIO_MIC_AC: C325.2, U701.10 (MIC1LP/LINE1LP)
AUDIO_MIC_BIAS: C327.1, R312.1, U701.15 (MICBIAS)
AUDIO_MIC_REF: C326.2, U701.11 (MIC1LM/LINE1LM)
AUDIO_R: C318.2, J504.2
CODEC_RST: C310.1, R308.1, U701.31 (~RESET)
I2C5_SCL: U701.8 (SCL)
I2C5_SDA: U701.9 (SDA)
I2S_BCLK: U701.2 (BCLK)
I2S_LRCK: U701.3 (WCLK)
I2S_MCLK: U701.1 (MCLK)
I2S_SDI: U701.5 (DOUT)
I2S_SDO: U701.4 (DIN)
POWER_GND: C310.2, C311.2, C312.2, C313.2, C315.2, C322.2, C323.2, C326.1, C327.2, J504.3, J505.2, U701.6 (DVSS), U701.17 (AVSS1), U701.21 (DRVSS), U701.26 (AVSS2), U701.33 (EP), U803.7 (GND)
SPK_N: J506.2, U803.8 (OUT-)
SPK_P: J506.1, U803.5 (OUT+)

Notes on the sheet:
Mic: electret biased from MICBIAS via R312 2.2k, AC-coupled by C325 into MIC1LP; MIC1LM is AC-coupled to GND by C326. Speaker: PAM8302A from LEFT_LOP through C321, /SD pulled up by R311, 2-pin speaker on J506.
TLV320AIC3104, pinout from the TI IBIS model. I2C 0x18. DVDD(32)=1.8V, IOVDD(7)=3.3V, AVDD(25)=3.3V, DRVDD(18/24)=3.3V. Unused analog inputs left open (see research note).
This page is a pin contract pending full C1 audio schematic re-implementation; no fabricated analog values are implied.
