parkourlrc/pcb-yilv1982--duck-robot-89dbc81d6d/docs/references/扩展板电路仿真工具/bom-passives-20261031/before-metadata/imu_tof.kicad_sch

## KiCad design docs/references/扩展板电路仿真工具/bom-passives-20261031/before-metadata/imu_tof.kicad_sch (2026-11-02)

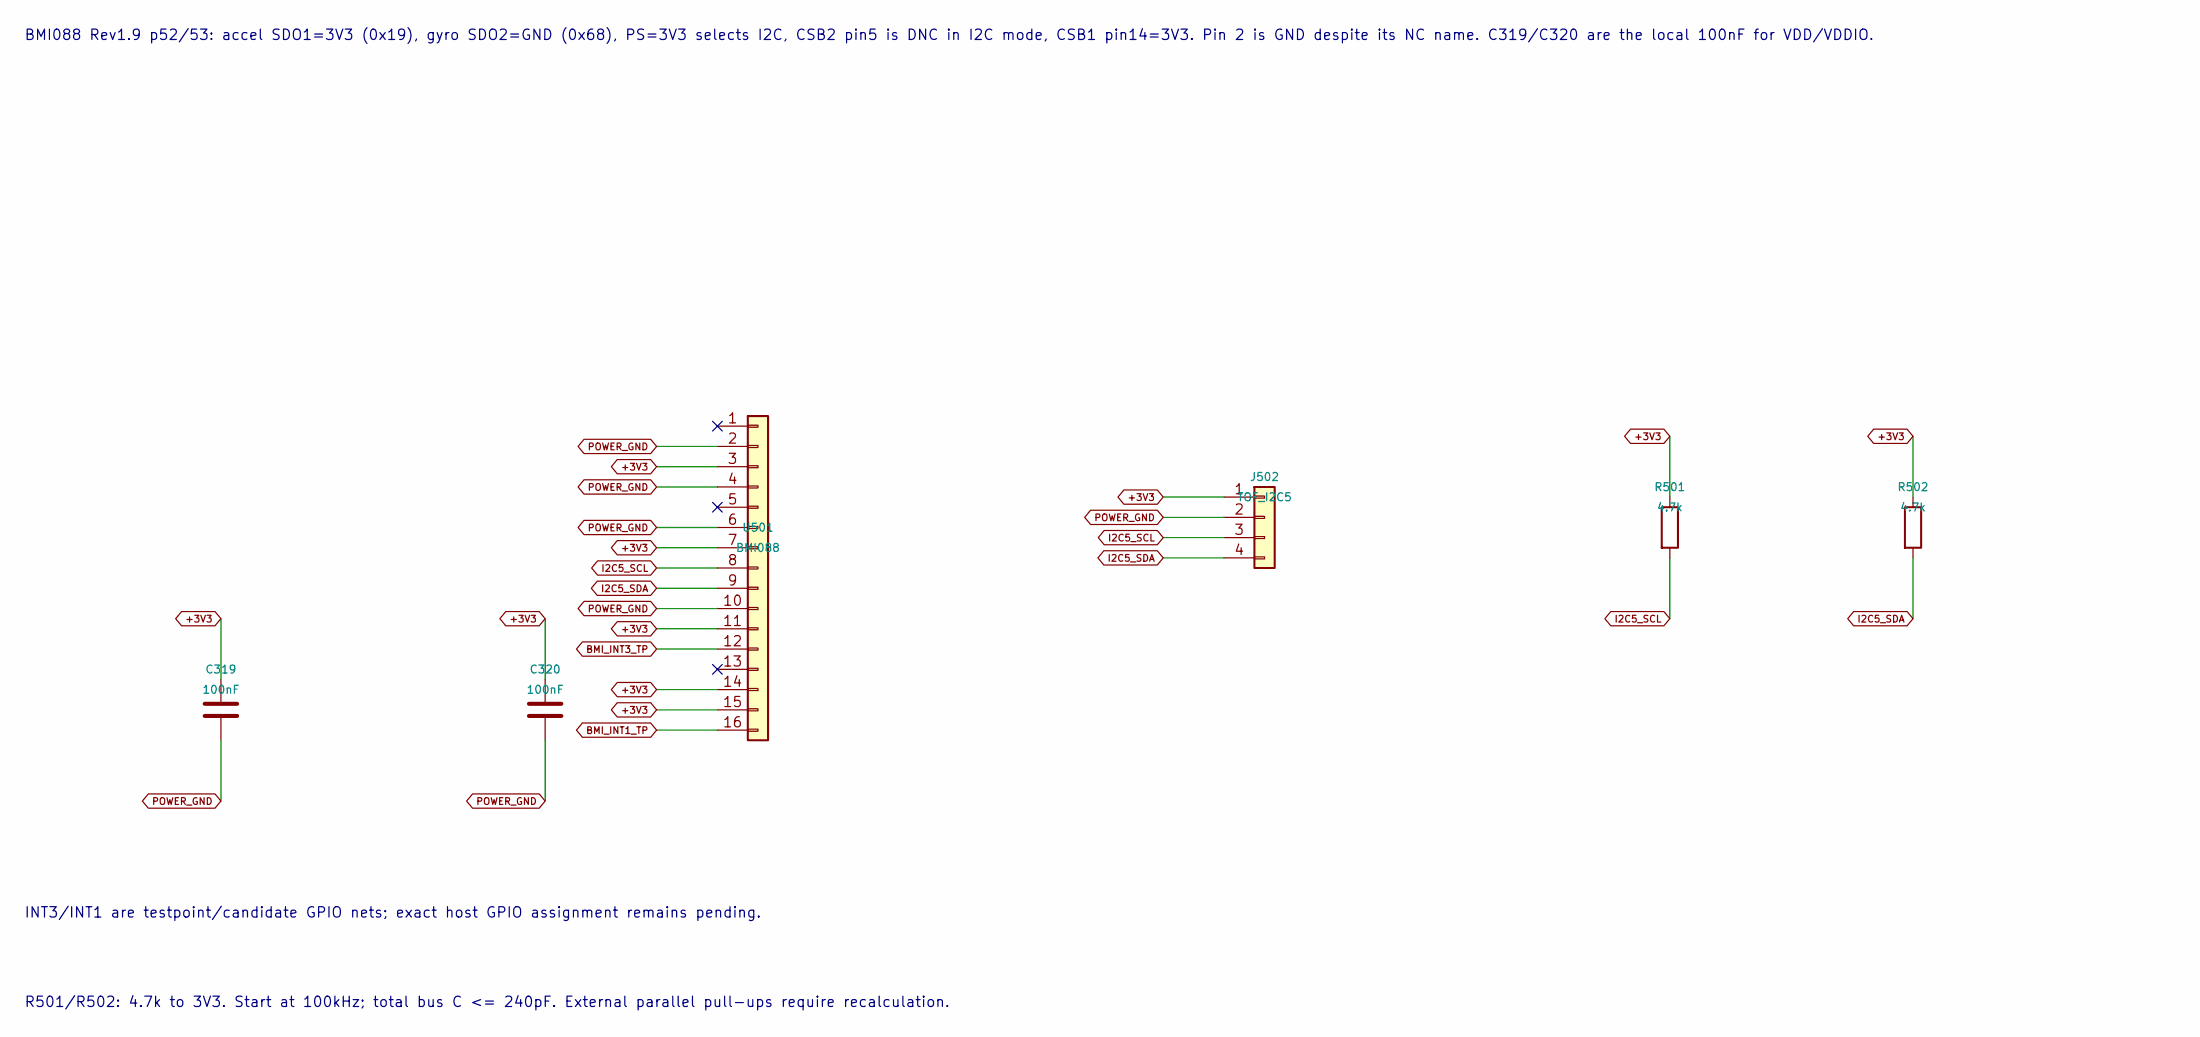
[picture p297: schematic imu_tof.kicad_sch]

Parts:
C319, C320: 100nF; C_0402_1005Metric
J502: TOF_I2C5; JST_SH_BM04B-SRSS-TB_1x04-1MP_P1.00mm_Vertical
R501, R502: 4.7k; R_0402_1005Metric; MPN CRCW04024K70FKED
U501: BMI088; Bosch_LGA-16_4.5x3mm_P0.5mm_LayoutBorder7x1y_ClockwisePinNu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; MPN BMI088

Connections:
+3V3: C319.1, C320.1, J502.1, R501.1, R502.1, U501.3, U501.7, U501.11, U501.14, U501.15
BMI_INT1_TP: U501.16
BMI_INT3_TP: U501.12
I2C5_SCL: J502.3, R501.2, U501.8
I2C5_SDA: J502.4, R502.2, U501.9
POWER_GND: C319.2, C320.2, J502.2, U501.2, U501.4, U501.6, U501.10

Notes on the sheet:
BMI088 Rev1.9 p52/53: accel SDO1=3V3 (0x19), gyro SDO2=GND (0x68), PS=3V3 selects I2C, CSB2 pin5 is DNC in I2C mode, CSB1 pin14=3V3. Pin 2 is GND despite its NC name. C319/C320 are the local 100nF for VDD/VDDIO.
INT3/INT1 are testpoint/candidate GPIO nets; exact host GPIO assignment remains pending.
R501/R502: 4.7k to 3V3. Start at 100kHz; total bus C <= 240pF. External parallel pull-ups require recalculation.
