parkourlrc/pcb-yilv1982--duck-robot-89dbc81d6d/docs/references/扩展板电路仿真工具/bom-passives-20261031/before-metadata/power.kicad_sch

## KiCad design docs/references/扩展板电路仿真工具/bom-passives-20261031/before-metadata/power.kicad_sch (2026-11-02)

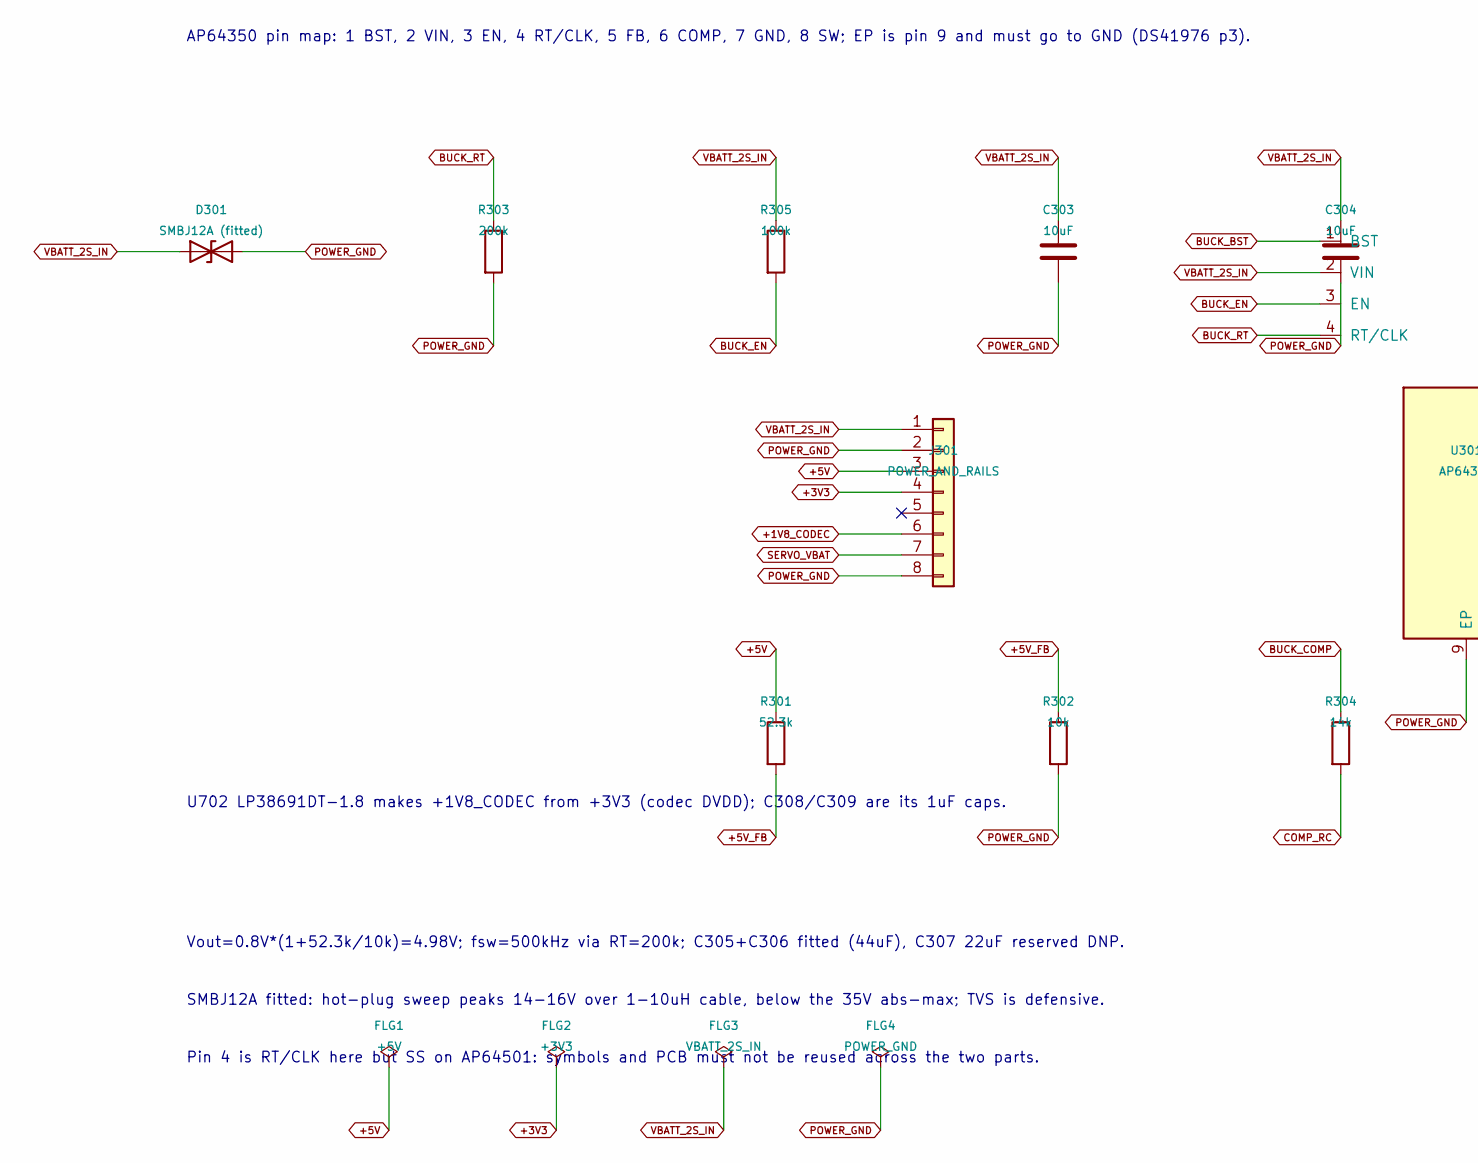
[picture p298: schematic power.kicad_sch, part in row 1, column 1]

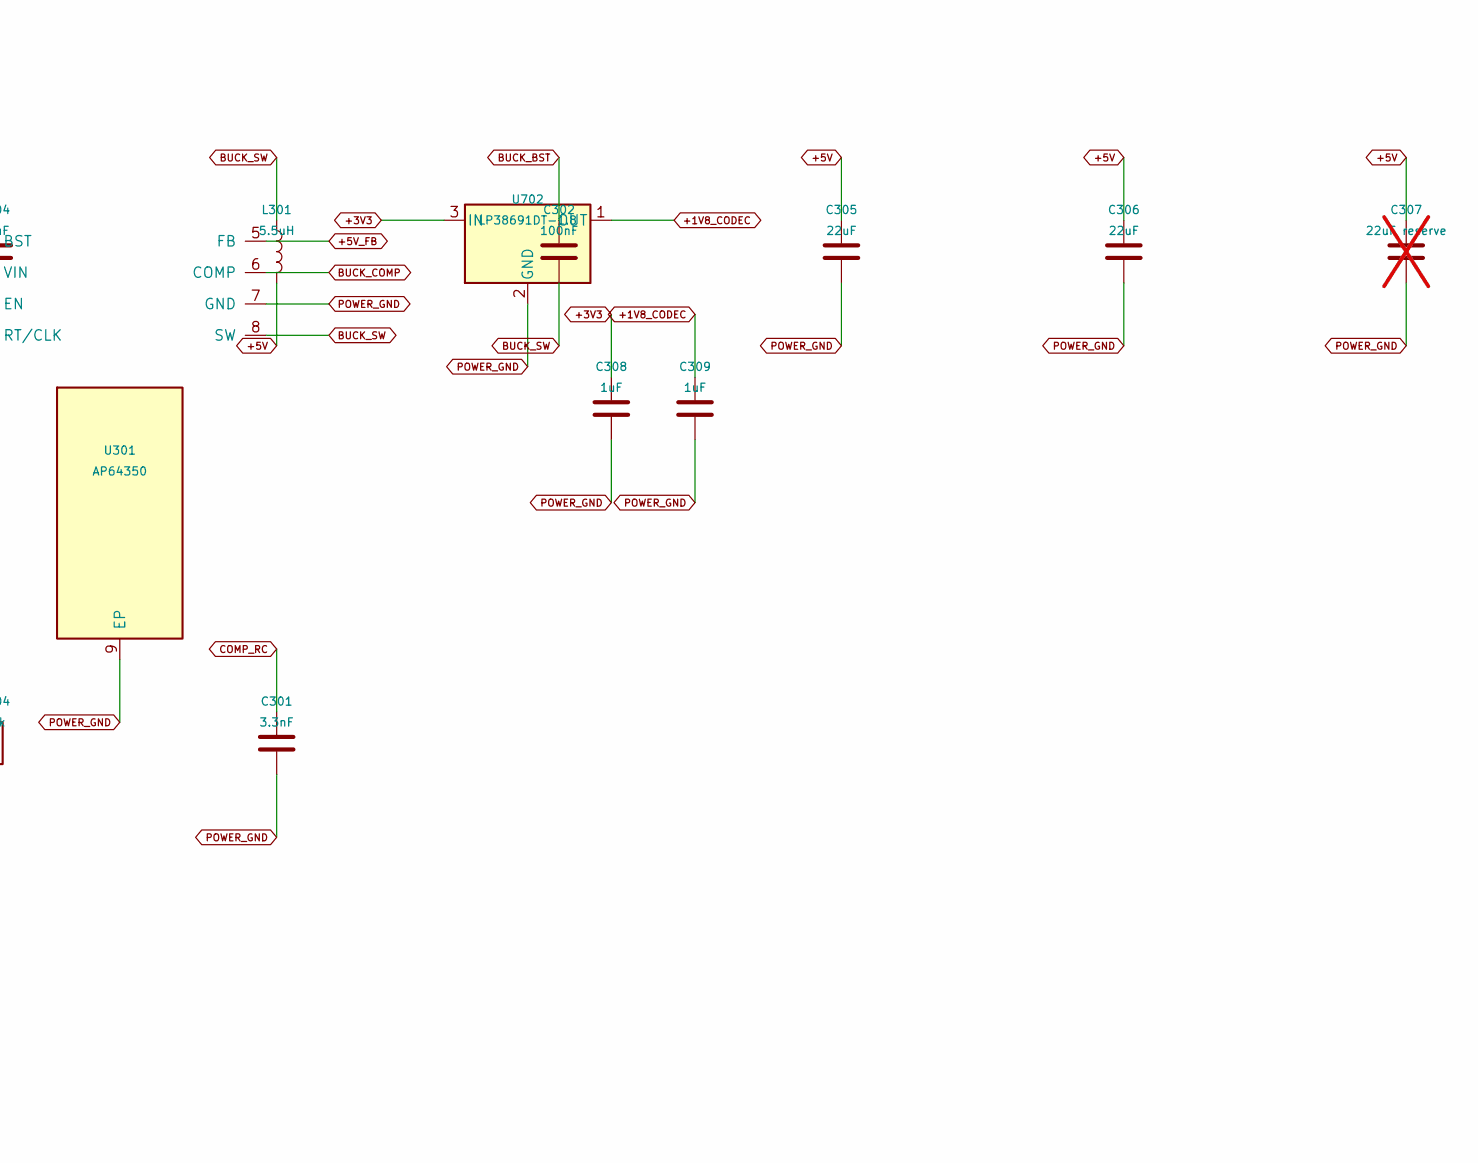
[picture p299: schematic power.kicad_sch, part in row 1, column 2]

Parts:
C301: 3.3nF; C_0805_2012Metric
C302: 100nF; C_0805_2012Metric
C303, C304: 10uF; C_1206_3216Metric
C305, C306: 22uF; C_1206_3216Metric
C307: 22uF reserve; C_1206_3216Metric; not fitted
C308, C309: 1uF; C_0805_2012Metric
D301: SMBJ12A (fitted); D_SMB
FLG1: +5V
FLG2: +3V3
FLG3: VBATT_2S_IN
FLG4: POWER_GND
J301: POWER_AND_RAILS; PinHeader_1x08_P2.54mm_Vertical
L301: 5.5uH; L_12x12mm_H8mm
R301: 52.3k; R_0805_2012Metric; MPN CRCW080552K3FKEA
R302: 10k; R_0805_2012Metric; MPN CRCW080510K0FKEA
R303: 200k; R_0805_2012Metric; MPN CRCW0805200KFKEA
R304: 14k; R_0805_2012Metric; MPN CRCW080514K0FKEA
R305: 100k; R_0805_2012Metric; MPN CRCW0805100KFKEA
U301: AP64350; SO-8EP_AP64350; MPN AP64350SP-13
U702: LP38691DT-1.8; TO-252-3_TabPin2; MPN LP38691DT-1.8/NOPB

Connections:
+1V8_CODEC: C309.1, J301.6, U702.1 (OUT)
+3V3: C308.1, FLG2.1, J301.4, U702.3 (IN)
+5V: C305.1, C306.1, C307.1, FLG1.1, J301.3, L301.2, R301.1
+5V_FB: R301.2, R302.1, U301.5 (FB)
BUCK_BST: C302.1, U301.1 (BST)
BUCK_COMP: R304.1, U301.6 (COMP)
BUCK_EN: R305.2, U301.3 (EN)
BUCK_RT: R303.1, U301.4 (RT/CLK)
BUCK_SW: C302.2, L301.1, U301.8 (SW)
COMP_RC: C301.1, R304.2
POWER_GND: C301.2, C303.2, C304.2, C305.2, C306.2, C307.2, C308.2, C309.2, D301.2 (A2), FLG4.1, J301.2, J301.8, R302.2, R303.2, U301.7 (GND), U301.9 (EP), U702.2 (GND)
SERVO_VBAT: J301.7
VBATT_2S_IN: C303.1, C304.1, D301.1 (A1), FLG3.1, J301.1, R305.1, U301.2 (VIN)

Notes on the sheet:
AP64350 pin map: 1 BST, 2 VIN, 3 EN, 4 RT/CLK, 5 FB, 6 COMP, 7 GND, 8 SW; EP is pin 9 and must go to GND (DS41976 p3).
Vout=0.8V*(1+52.3k/10k)=4.98V; fsw=500kHz via RT=200k; C305+C306 fitted (44uF), C307 22uF reserved DNP.
U702 LP38691DT-1.8 makes +1V8_CODEC from +3V3 (codec DVDD); C308/C309 are its 1uF caps.
SMBJ12A fitted: hot-plug sweep peaks 14-16V over 1-10uH cable, below the 35V abs-max; TVS is defensive.
Pin 4 is RT/CLK here but SS on AP64501: symbols and PCB must not be reused across the two parts.
