parkourlrc/pcb-yilv1982--duck-robot-89dbc81d6d/docs/references/扩展板电路仿真工具/final-bom-20261031/before-metadata/servo_ttl.kicad_sch

## KiCad design docs/references/扩展板电路仿真工具/final-bom-20261031/before-metadata/servo_ttl.kicad_sch (2026-11-02)

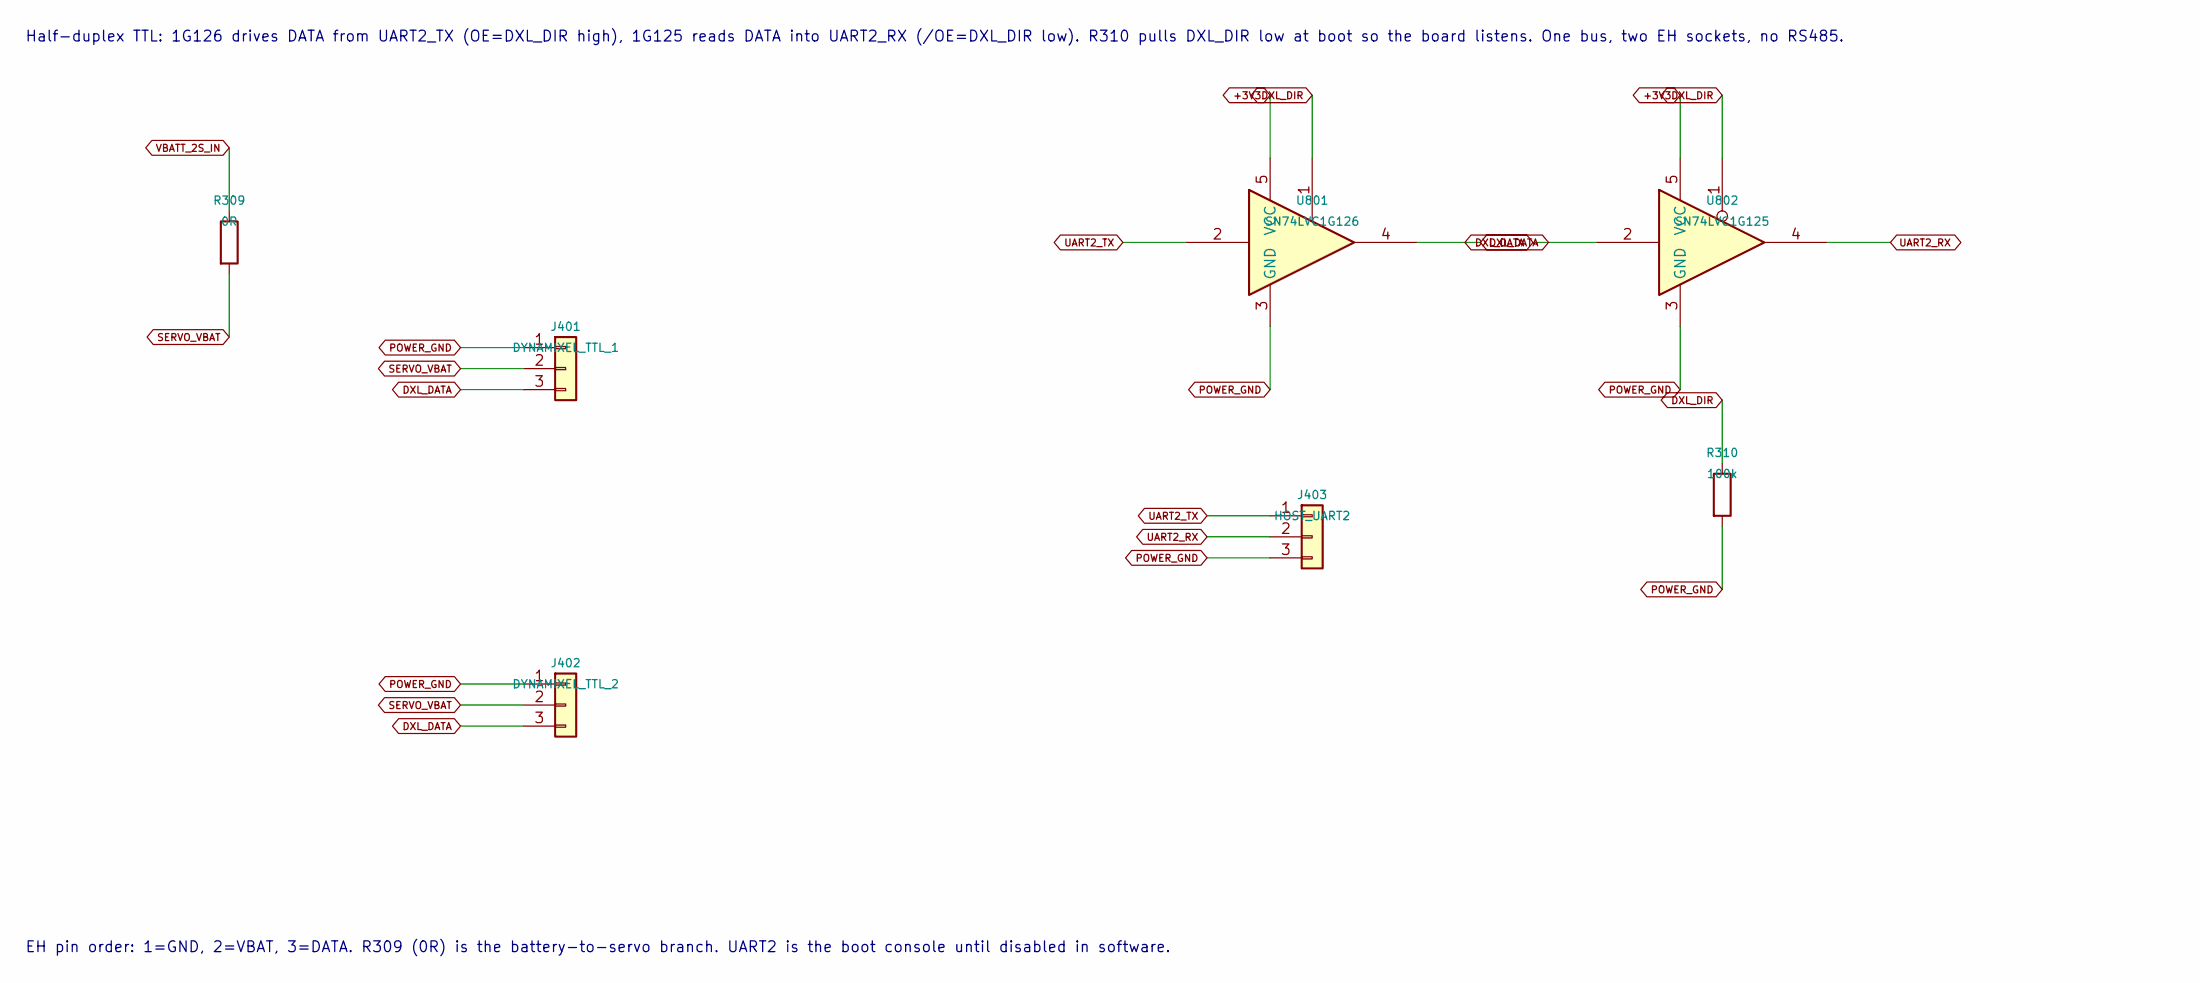
[picture p300: schematic servo_ttl.kicad_sch]

Parts:
J401: DYNAMIXEL_TTL_1; JST_EH_B3B-EH-A_1x03_P2.50mm_Vertical
J402: DYNAMIXEL_TTL_2; JST_EH_B3B-EH-A_1x03_P2.50mm_Vertical
J403: HOST_UART2; Samtec_TSW103_07; MPN TSW-103-07-G-S
R309: 0R; R_1206_3216Metric
R310: 100k; R_0402_1005Metric; MPN CRCW0402100KFKED
U801: SN74LVC1G126; SOT-23-5; MPN SN74LVC1G126DBVR
U802: SN74LVC1G125; SOT-23-5; MPN SN74LVC1G125DBVT

Connections:
+3V3: U801.5 (VCC), U802.5 (VCC)
DXL_DATA: J401.3, J402.3, U801.4, U802.2
DXL_DIR: R310.1, U801.1, U802.1
POWER_GND: J401.1, J402.1, J403.3, R310.2, U801.3 (GND), U802.3 (GND)
SERVO_VBAT: J401.2, J402.2, R309.2
UART2_RX: J403.2, U802.4
UART2_TX: J403.1, U801.2
VBATT_2S_IN: R309.1

Notes on the sheet:
Half-duplex TTL: 1G126 drives DATA from UART2_TX (OE=DXL_DIR high), 1G125 reads DATA into UART2_RX (/OE=DXL_DIR low). R310 pulls DXL_DIR low at boot so the board listens. One bus, two EH sockets, no RS485.
EH pin order: 1=GND, 2=VBAT, 3=DATA. R309 (0R) is the battery-to-servo branch. UART2 is the boot console until disabled in software.
