parkourlrc/pcb-yilv1982--duck-robot-89dbc81d6d/docs/references/扩展板电路仿真工具/manufacturer-rules-20261031/before-metadata/power.kicad_sch

## KiCad design docs/references/扩展板电路仿真工具/manufacturer-rules-20261031/before-metadata/power.kicad_sch (2026-11-02)



Parts:
C301: 3.3nF; C_0805_2012Metric; Voltage Rating 50V; Tolerance 5%; MPN 08055A332JAT2A
C302: 100nF; C_0805_2012Metric; Voltage Rating 50V; Tolerance 10%; MPN C0805C104K5RACTU
C303, C304, C305, C306: 22uF; C_1210_3225Metric; Voltage Rating 25V; Tolerance 10%; MPN C1210C226K3RACTU
C307: 22uF reserve; C_1206_3216Metric; Voltage Rating 16V; Tolerance 20%; MPN C1206C226M4PACTU; not fitted
C308, C309: 2.2uF; C_0805_2012Metric; Voltage Rating 50V; Tolerance 10%; MPN C0805C225K5RACTU
D301: SMBJ12A (fitted); D_SMB; Voltage Rating 12V VRWM; MPN SMBJ12A-E3/52
FLG1: +5V
FLG2: +3V3
FLG3: VBATT_2S_IN
FLG4: POWER_GND
J301: POWER_AND_RAILS; Samtec_TSW108_07; MPN TSW-108-07-G-S
L301: 5.6uH; IHLP4040DZ_5A_Above2u2; MPN IHLP4040DZER5R6M5A
R301: 52.3k; R_0805_2012Metric; MPN CRCW080552K3FKEA
R302: 10k; R_0805_2012Metric; MPN CRCW080510K0FKEA
R303: 200k; R_0805_2012Metric; MPN CRCW0805200KFKEA
R304: 14k; R_0805_2012Metric; MPN CRCW080514K0FKEA
R305: 100k; R_0805_2012Metric; MPN CRCW0805100KFKEA
R703: 0.047; Vishay_WSLP0603_Damping; Tolerance 1%; Power Rating 0.4W at70C; derate above70C; MPN WSLP0603R0470FEA
U301: AP64350; SO-8EP_AP64350; MPN AP64350SP-13
U702: LP38691DT-1.8; TO-252-3_TabPin2; MPN LP38691DT-1.8/NOPB

Connections:
+1V8_CODEC: C309.1, J301.6, U702.1 (OUT)
+3V3: C308.1, FLG2.1, J301.4, U702.3 (IN)
+5V: C305.1, C306.1, C307.1, FLG1.1, J301.3, L301.2, R301.1
+5V_FB: R301.2, R302.1, U301.5 (FB)
BUCK_BST: C302.1, U301.1 (BST)
BUCK_COMP: R304.1, U301.6 (COMP)
BUCK_EN: R305.2, U301.3 (EN)
BUCK_RT: R303.1, U301.4 (RT/CLK)
BUCK_SW: C302.2, L301.1, U301.8 (SW)
COMP_RC: C301.1, R304.2
LDO_CAP_RETURN: C309.2, R703.1
POWER_GND: C301.2, C303.2, C304.2, C305.2, C306.2, C307.2, C308.2, D301.2 (A2), FLG4.1, J301.2, J301.8, R302.2, R303.2, R703.2, U301.7 (GND), U301.9 (EP), U702.2 (GND)
SERVO_VBAT: J301.7
VBATT_2S_IN: C303.1, C304.1, D301.1 (A1), FLG3.1, J301.1, R305.1, U301.2 (VIN)

Notes on the sheet:
AP64350 pin map: 1 BST, 2 VIN, 3 EN, 4 RT/CLK, 5 FB, 6 COMP, 7 GND, 8 SW; EP is pin 9 and must go to GND (DS41976 p3).
Vout nominal4.984V; fsw nominal500kHz. C303/C304 input and C305/C306 output:22uF/25V X7R1210 each NOMINAL. Use DC-biased model values; C307 remains DNP.
U702 LP38691DT-1.8:3V3 to1V8. C308/C309:2.2uF/50V X7R. R703=47mOhm only in C309 return, never load ground. Include C311 in ESR/loop review.
SMBJ12A: 19.9V clamp at 30.2A, 10/1000us (Vishay88392). AP64350 VIN max40V recommended,42V DC absolute max. Board transient coordination is unverified.
Pin 4 is RT/CLK here but SS on AP64501: symbols and PCB must not be reused across the two parts.
