parkourlrc/pcb-yilv1982--duck-robot-89dbc81d6d/docs/references/扩展板电路仿真工具/metadata-repair-20261030/before-metadata/testpoints.kicad_sch

## KiCad design docs/references/扩展板电路仿真工具/metadata-repair-20261030/before-metadata/testpoints.kicad_sch (2026-10-30)


Parts:
J802: IMU_INT_TP; PinHeader_1x02_P2.54mm_Vertical
TP801: VBATT_2S_IN; TestPoint_Pad_D1.5mm
TP802: +5V; TestPoint_Pad_D1.5mm
TP803: +3V3; TestPoint_Pad_D1.5mm

Connections:
+3V3: TP803.1
+5V: TP802.1
BMI_INT1_TP: J802.1
BMI_INT3_TP: J802.2
VBATT_2S_IN: TP801.1

Notes on the sheet:
Six rails only (VBATT, SERVO_VBAT, +5V, +3V3, I2C5 SCL/SDA). Measurement access only; no load or protection function.
