parkourlrc/pcb-yilv1982--duck-robot-89dbc81d6d/hardware/custom_hat/scripts/generate_rev_a.py

import copy
import hashlib
import json
import math
import re
import uuid
from pathlib import Path

BASE = Path(__file__).resolve().parents[1]
OUT = BASE / "rev_a"
LIB = Path("C:/Users/yilv/AppData/Local/Programs/KiCad/10.0/share/kicad/symbols")
PROJECT = "custom_hat_rev_a"
NS = uuid.UUID("fe057346-2587-4c77-803f-d354cdb50eed")


class Quoted(str):
    pass


def parse(text):
    tokens = re.findall(r'"(?:\\.|[^"\\])*"|[()]|[^\s()]+', text)
    stack = [[]]
    for token in tokens:
        if token == "(":
            node = []
            stack[-1].append(node)
            stack.append(node)
        elif token == ")":
            stack.pop()
        elif token.startswith('"'):
            stack[-1].append(Quoted(json.loads(token)))
        else:
            stack[-1].append(token)
    return stack[0][0]


def dump(node, depth=0):
    if isinstance(node, Quoted):
        return json.dumps(str(node), ensure_ascii=False)
    if not isinstance(node, list):
        return str(node)
    if all(not isinstance(child, list) for child in node):
        return "(" + " ".join(dump(child) for child in node) + ")"
    return "(" + " ".join(dump(child) if not isinstance(child, list) else "\n" + "  " * (depth + 1) + dump(child, depth + 1) for child in node) + ")"


def q(value):
    return Quoted(str(value))


def uid(value):
    return q(uuid.uuid5(NS, value))


def children(node, key):
    return [child for child in node if isinstance(child, list) and child and child[0] == key]


def first(node, key):
    return next(iter(children(node, key)), None)


def effects(size=1.0, justify=None, hidden=False):
    value = ["effects", ["font", ["size", size, size]]]
    if justify:
        value.append(["justify", justify])
    if hidden:
        value.append(["hide", "yes"])
    return value


def prop(name, value, x, y, hidden=False):
    return ["property", q(name), q(value), ["at", x, y, 0], effects(hidden=hidden)]


LIB_CACHE = {}


def library_symbol(lib_id):
    library, name = lib_id.split(":", 1)
    if library not in LIB_CACHE:
        project_lib = OUT / (library + ".kicad_sym")
        path = project_lib if project_lib.exists() else (LIB / (library + ".kicad_sym"))
        LIB_CACHE[library] = parse(path.read_text(encoding="utf-8"))
    original = next(node for node in children(LIB_CACHE[library], "symbol") if node[1] == name)
    symbol = copy.deepcopy(original)
    extension = first(symbol, "extends")
    if extension:
        parent = library_symbol(library + ":" + extension[1])
        symbol.remove(extension)
        own_properties = {node[1] for node in children(symbol, "property")}
        for node in parent[2:]:
            if isinstance(node, list) and (node[0] != "property" or node[1] not in own_properties):
                symbol.append(copy.deepcopy(node))
    symbol[1] = q(lib_id)
    return symbol


class Sheet:
    def __init__(self, name, title):
        self.name = name
        self.id = uid("sheet:" + name)
        self.lib = ["lib_symbols"]
        self.tree = ["kicad_sch", ["version", "20250114"], ["generator", q("eeschema")], ["uuid", self.id], ["paper", q("A3")], ["title_block", ["title", q(title)], ["date", q("2026-10-28")], ["rev", q("A schematic draft")], ["company", q("duck-robot")]], self.lib]
        self.contract = []
        self.counter = 0

    def identity(self):
        self.counter += 1
        return uid(self.name + ":" + str(self.counter))

    def text(self, value, x, y, size=1.3):
        self.tree.append(["text", q(value), ["at", x, y, 0], effects(size, "left"), ["uuid", self.identity()]])

    def label(self, name, x, y, angle=0):
        self.tree.append(["global_label", q(name), ["shape", "bidirectional"], ["at", x, y, angle], effects(0.85, "left" if angle == 0 else "right"), ["uuid", self.identity()], prop("Intersheetrefs", "${INTERSHEET_REFS}", x, y, True)])

    def wire(self, start, end):
        self.tree.append(["wire", ["pts", ["xy", *start], ["xy", *end]], ["stroke", ["width", 0], ["type", "default"]], ["uuid", self.identity()]])

    def component(self, lib_id, reference, value, x, y, nets, footprint=None, dnp=False):
        # snap to the 1.27 mm connection grid so ERC does not flag off-grid pins
        x = round(x / 1.27) * 1.27
        y = round(y / 1.27) * 1.27
        symbol = library_symbol(lib_id)
        if not any(node[1] == lib_id for node in self.lib[1:]):
            self.lib.append(symbol)
        symbol_id = uid(self.name + ":" + reference)
        footprint_prop = next((node[2] for node in children(symbol, "property") if node[1] == "Footprint"), "")
        reference_position = (x + 5.08, y - 1.27) if lib_id in {"Device:C", "Device:R", "Device:L"} else (x, y - 5.08)
        value_position = (x + 5.08, y + 1.27) if lib_id in {"Device:C", "Device:R", "Device:L"} else (x, y - 2.54)
        instance = ["symbol", ["lib_id", q(lib_id)], ["at", x, y, 0], ["unit", 1], ["in_bom", "yes"], ["on_board", "yes"], ["dnp", "yes" if dnp else "no"], ["uuid", symbol_id], prop("Reference", reference, *reference_position), prop("Value", value, *value_position), prop("Footprint", footprint if footprint is not None else footprint_prop, x, y, True)]
        for sub in children(symbol, "symbol"):
            for pin in children(sub, "pin"):
                number = str(first(pin, "number")[1])
                pin_at = first(pin, "at")
                px, py = round(x + float(pin_at[1]), 4), round(y - float(pin_at[2]), 4)
                angle = float(pin_at[3])
                net = nets.get(number)
                instance.append(["pin", q(number), ["uuid", uid(self.name + ":" + reference + ":" + number)]])
                if net is None:
                    self.tree.append(["no_connect", ["at", px, py], ["uuid", self.identity()]])
                else:
                    end = (round(px - 7.62 * math.cos(math.radians(angle)), 4), round(py + 7.62 * math.sin(math.radians(angle)), 4))
                    self.wire((px, py), end)
                    self.label(net, *end, 0 if angle == 180 else 180)
                self.contract.append({"reference": reference, "pin": number, "net": net, "electrical_type": pin[1], "lib_id": lib_id})
        instance.append(["instances", ["project", q(PROJECT), ["path", q("/" + str(uid("root")) + "/" + str(self.id)), ["reference", q(reference)], ["unit", 1]]]])
        self.tree.append(instance)

    def save(self):
        self.tree.append(["embedded_fonts", "no"])
        (OUT / (self.name + ".kicad_sch")).write_text(dump(self.tree) + "\n", encoding="utf-8")
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
