parkourlrc/pcb-yilv1982--duck-robot-89dbc81d6d/hardware/custom_hat/scripts/build_pcb_rev_a.py

"""Build the Rev A PCB skeleton: outline, mounting holes, power block, staging.

Status: skeleton, nothing routed and nothing final:
- board outline is the Pi-Zero-class 65 x 30.9 mm used by the reference HAT;
- the four M2.5 holes follow the Pi Zero pattern (3.5 mm from each edge);
- J101 is placed so pad 1 sits at (8.37, 3.5) mm, i.e. a 40-pin header centred
  between the corner holes - this still needs checking against the Radxa Zero
  3W mechanical drawing;
- parts outside the power block are parked in a row above the board (staging),
  because the full HAT placement is not designed yet.

Run with KiCad's bundled Python.
"""
import json
from pathlib import Path

import math

import pcbnew

BASE = Path(__file__).resolve().parents[1]
OUT = BASE / "rev_a"
CONTRACT = OUT / "net-contract.json"
BOARD_FILE = OUT / "custom_hat_rev_a.kicad_pcb"
FPLIB = Path("C:/Users/yilv/AppData/Local/Programs/KiCad/10.0/share/kicad/footprints")
LOCAL_FPLIB = OUT

BOARD_W = 65.0
BOARD_H = 30.0
ORIGIN = (100.0, 100.0)

# Pi Zero class hole pattern, pending Radxa drawing check.
HOLES = [(3.6, 3.6), (61.4, 3.6), (3.6, 26.4), (61.4, 26.4)]

LAYOUT = {
    "J101": (8.32, 4.59, 90),
    "D301": (15.5, 11.5, 0),
    "R305": (15.5, 16.5, 0),
    "C303": (15.5, 20.0, 0),
    "C304": (15.5, 23.0, 0),
    "U301": (26.0, 14.0, 0),
    "L301": (38.0, 15.9, 0),
    "C302": (26.0, 19.0, 0),
    "R303": (26.0, 22.5, 0),
    "C305": (49.0, 14.0, 0),
    "C306": (54.0, 14.0, 0),
    "C307": (59.0, 14.0, 0),
    "R301": (38.0, 24.2, 0),
    "R302": (43.0, 24.2, 0),
    "R304": (48.0, 24.2, 0),
    "C301": (53.0, 24.2, 0),
}
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
