parkourlrc/pcb-yilv1982--duck-robot-89dbc81d6d/(commit log)

2026-10-25 feat: 阶段性同步 2026-10-22~10-25——servo-web 真机系列、总线风暴定案；radxa 静态 IP、DAPLink 抽检、IMU v0.3 下单准备
    - servo-web 板载部署/修复系列：IMU kit 状态位语义修复、IMU 分离 sync_read、总线监控与诊断脚本、ID 对齐与腿组回换（scripts/servo-web-*、imu200-*、servo-id-*），配套调研 docs/references/servo-web-*、servo-id-align-20261024、b-feetech-policy-deployment-20261024
    - 总线风暴供电调研定案与 10-24 接线补记（docs/references/bus-storm-power-20261025）
    - spec 开发流程与 specs 存档、real2sim2real 工具链计划、bench-tools/照片/供电文档勘误
    - radxa：DHCP 漂移遗留关闭（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
    [hls-headneck-revert-upstream.py, imu200-buffer-diagnostic.py, imu200-diag.py, imu200-instruction-compare.py, imu200-paired-diagnostic.py, imu200-protocol-diagnostic.py, imu200-raw-capture.py, imu200-timing-test.py]
2026-10-25 feat: imu_to_dxl v0.3（双口）Gerber 生产文件——用户经嘉立创EDA从 eprj2 的 imu_to_dxl_1 导出，本机解析验证：33×22mm、4×φ2.2@30×19、J1/J3 双 EH 共 6×φ1.0、双层全层套件+钻孔
2026-10-25 feat: imu_to_dxl v0.3 转 PCB+SMT 一体单——裸板单 85849959 用户取消；BOM(15行带C号)/CPL 归档，JLC 清理版 CPL 19 贴片件（去 3 DNP + 2 插件，J2 座改机贴）
    [imu_to_dxl_v03_bom_20261025.xlsx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]
2026-10-26 docs: IMU 真机丢包诊断 + 板②电源分析 + 双板身份定案
    - 新专题 imu-fw-v1-code-analysis-20261026：真机读 IMU(ID200) 100 次超时约 30 次的完整诊断——排除主机补丁缺陷/电压塌陷/解析路径，首选假说=出厂固件周期性总线盲区与 50Hz 拍频对撞；V1~V4 分级验证工作单落盘（v1 固件 A/B 对照前先 dump 备份原厂固件）
    - 新专题 imu-jyg9-power-5v-20261026：板②(jyg9 GD32 成品版)官方 0.2 BOM/原理图析毕——Buck=ETA2845S2G ≥6.5V 冷启动/≈5.93V 维持，5V 必不启动不损坏；EH 针序图纸确认；无反接保护警告；改板设计变更单定稿
    - 双板身份定案：板①=ScrapMeta v0.3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
2026-10-26 chore: 规则更新——git 默认远端改为 gitee（2026-10-26 用户指示）
    提交/推送/拉取默认只对 gitee 操作；origin(GitHub) 不再自动同步，仅用户明确要求同步 GitHub 时才操作；main 跟踪改为 gitee/main
2026-10-26 feat: 同步 10-25~10-26 单口 IMU 排障工作线——微雪台架两轮无字节、FT232H COM5/H1 定位、H1/H2/H3 调试焊盘核对、同类故障调研、miss 文案补丁
    - 微雪台架：USB-only 供电勘误、补 7.4V 后 IMU 0/180+0/40、独立舵机对照 253 扫描全无字节——微雪未证明正常，不判 IMU 坏；原始 JSONL/分析/脚本入库
    - FT232H：COM5 枚举、H1 定位标注图（scripts/annotate-imu-h1-location.py）、官方资料核实撤回 I2C 开关旧判断；调试计划 debug-plan-20261026 落盘
    - 单口板设计核对：jyg9 KiCad 0.2 工程来源、H1 UART/H2 SWD/H3 USB 焊盘（无 CH340 定案），撤回"只能从总线侧判断"旧指引；b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
    [pcb-source-check-20261026.json, waveshare-servo-ping-analysis-20261025.json]
2026-10-26 feat: 10-27 拔舵机对照定案板②无罪、回滚拆分补丁、链路审计与总线帧异步全量日志部署
    - 用户实测：IMU 在 HAT 第二口+舵机总线在线仅极少数成功；拔舵机端子后 30min 零丢失——B1 盲区拍频出局、B2 大幅降权，方向转舵机共线物理交互（E1 首选含 R31/R5 批次线索，E2 流量干扰次选）；四格接法×负载矩阵归档
    - 主控三层日志固化：拔前 2.5h 单播 PING 314/4247=7.4%，拔后 977/978=99.9%（bad_ck/bad_id/uart 全 0）；新线索 7 次舵机集体丢帧+2 次串口就绪无数据+2 次服务重启（板钟 13:36-14:17 集中）；R3 错位连锁分析勘误"总线级瞬断"解读
    - 数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
    [monitor-20261026.csv]
2026-10-26 feat: 建立 tools/servo-web 工程可部署副本——主控部署目录整包同步与来源差异说明
    - 用户指示：servo-web 后续会频繁修改，上游参考库（references/microduck-replica/tools/servo-web）保持只读原样，本工程 tools/ 下保留最新可部署副本
    - 从主控 ~/servo-web 打包拉取（2026-10-27，板钟 10-26 17:13 UTC）：60 文件——全部源码/测试、index.html、imu_bridge、model 2.8MB、poses、calib 28 份 EEPROM 校准快照；排除 logs/__pycache__/*.bak-*/.idmap-backup-*（板上保留）
    - SOURCE.md：来源、拉取时间、相对上游 v0.15.2 差异状态（read_states_with_imu 原始混读 + 总线帧异步日志补丁 + k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
2026-10-27 feat: 同步 10-27 HAT 共享总线与 SyncRead 受控实验系列——舵机支路接入触发缺答，10-26 首选假说被实测修正；servo-web 工作副本与 HAT 原理图参考入库
    - 四步受控 SyncRead 实验（独占）：舵机支路接入触发缺答，正常应答流量不是必要条件；拔舵机对照仅 IMU 在 HAT 第二口零丢失——定位转向舵机共线物理交互
    - 舵机总线接回后混读形态全量采集：IMU 混读槽 0 应答为零、R3 连锁错位逐帧坐实
    - HAT 双口原理图复核：共用 DATA 串阻存在设计差异，实物 V1.2 待核；hat-imu-shared-bus-20261027 专题（含 SN74LVC1G125/126 数据手册等来源）；kissqy HAT Rev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
    [ASE01187-C1_elec_RPI_Robot_HAT_BOM.csv, audio.kicad_sch, dynamixel.kicad_sch, elec_RPI_Robot_HAT.kicad_pcb, elec_RPI_Robot_HAT.kicad_sch, imu-poll-exp-20261027-one-servo.json, imu-poll-exp-20261027-servo-off.json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]
2026-10-27 docs: 记录 IMU 排障测量并标注通信器件位置
2026-10-27 docs: HAT R31 作者建议与电路分析——圈选件确认为 R31，实装阻值待核
    - 用户确认联系到 ScrapMeta 作者：转述称 HAT 存在影响飞特舵机的问题，圈选电阻'非 0Ω 则换下或短接'；用户已确认圈选件=HAT R31，橙圈照片+裁剪入库
    - kissqy 飞特版补充核查（固定 c5f015f9）：其 HAT R33=0Ω/TH1=100Ω PTC，IMU 时间线载 15 舵机 7 万余轮无错（上游自述未复现）；FT6 固件为 STM32G031 RevA，与本机 GD32 不可互刷
    - R31 电路作用分析：共用 DATA 串联电阻（U5 输出→A→R31→B→F1→CN11/12 pin3），V1.0 图值 1kΩ 不自动升级为本机 V1.2 实装值
    - 顺带发现并建档：feetech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
2026-10-30 feat: 自研 HAT 工作线入库——设计文件/布局候选/Rev A 归档与四项专题研究
    - hardware/custom_hat：audio/sensors/power 等分板原理图、candidates 139 份布局候选（kicad_pcb/pro/json，排除 *.kicad_prl 本地状态）、rev_a 归档、scripts；runs/与 .history/（内嵌 .git 的编辑器备份）入 .gitignore 不入库
    - 四个专题：hat-design-inventory-20261028（设计资产盘点）、hat-self-design-workflow-20261028（自设计工作流）、hat-simulation-tools-20261029（仿真工具尝试含 AP64350 cir）、kicad-agent-skills-20261030（KiCad agent 技能）
    - docs/specs/20261028-custom-hat：自研 HAT spec；4 个修复渲染脚本（i2s/j50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
    [148p6_111p8.kicad_pcb, 148p6_111p9.kicad_pcb, 148p6_112p0.kicad_pcb, 148p6_112p1.kicad_pcb, 148p6_112p2.kicad_pcb, 148p6_112p3.kicad_pcb, 148p7_111p8.kicad_pcb, 148p7_111p9.kicad_pcb]
2026-11-01 feat: 接入真机模型与网页起身并归档硬件排障记录
    同步 robotd、Studio 部署与标定配置、网页手柄和恢复补丁，保留单口 IMU 混合读取回滚及原始验收证据。
    归档两次行走摔倒日志、电压与电流可用性分析、示波器和硬件资料；更新项目状态与图片索引。
    提交前脱敏当前文档凭据；原始日志、下载摘录和补丁保留空白格式。未追加真机动作，历史提交未改写。
    [hold-home-servo-first-20261101-summary.json, hold-home-servo-first-20261101.json, mixed-sync-servo-web-capture-20261101.json, mixed-sync-servo-web-capture-legacy-20261101.json, servo-first-deployment-20261101.json, servo-first-source-manifest-20261101.json, servo-web-service-start-20261101.json]
2026-11-02 feat: HAT Rev A.1 送审资料与 10-31 专题研究入库（未送厂）
    - 新增 Rev A.1 工程（源 90f27091…）：J502 针序改为 GND/3V3/SDA/SCL、C307 DNP 钢网排除，附 27 份同版生产审查包与 release-review 送审 ZIP
    - 新增 10-30～11-02 HAT 专题研究与复核、音频路由/驱动适配软件包、首板草案、问题矩阵与照片索引更新
    - 用户确认 2026-10-31 尚未送厂、无新板实物；制造接受、供电条件与首板功能仍未验收，本提交不代表投板或上电放行
    - 排除 search-failure-CODEC_RST.json（87.8MB，超 Gitee 单文件 50MB 上限），原件保留在本地工作区
    [CAM-QUESTIONS.csv, after-plane-samples.csv, amp-after-plane-samples.csv, amp-before-plane-samples.csv, assembly-plan.csv, audio.kicad_sch, before-label-tidy-imu_tof.kicad_sch, before-plane-samples.csv]
2026-11-05 docs: 完成目录治理、里程碑与 PCB 全流程文档
    - docs/references 改纯中文专题名并补索引/旧名对照；PROGRESS 2026-10 及以前归档
    - 新增 software/ 并迁移 servo-web/robotd；补 HAT 版本与模型清单
    - 新增 M1–M8 里程碑与 PCB 需求驱动运行手册、项目模板
    - 更新 README/AGENTS/目录入口与全库引用
    - 含此前未提交的 HAT/照片/训练/资料增删，按用户“提交所有”一并记录
    [BOM.csv, after-plane-samples.csv, after.kicad_pcb, amp-after-plane-samples.csv, amp-before-plane-samples.csv, ankle_left.stl, ankle_right.stl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]
2026-11-07 feat: 完善自主训练平台与可视化工作台并归档验证记录
2026-11-08 feat: 归档步幅奖励实验与训练参数来源核对
    新增独立步幅实验工具、百轮基线和四组足部奖励对照证据，登记本机训练环境并修正HD-1910-C001参数适用性结论。
    提交检查：16个实验脚本语法通过，新增Markdown链接有效。保留原始日志与上游快照的空白格式，未重跑训练；四组dev9均未达标，下一轮航向提案待确认。
2026-11-09 docs: 补充训练数据提交范围与计算环境登记核对
2026-11-09 feat: 训练档案分级导入与三类复训入口
    - 档案体系：启动前统一登记任务/实验/运行；受管档案与大产物写入 Git 忽略的 training/artifacts/，training/records/ 保留脱敏任务、配置、流程与结果摘要，SQLite 索引可由耐久记录重建。
    - 参数与配方：experiment_config.py 统一 67 个字段及奖励目录供前后端同源使用；锁定物理、接口、网络、终止与验收规则，阶段覆盖按分段常数配方推进。
    - 训练入口：从零派生保留来源冻结运行时，接权重严格比对 transfer 合同并继承 rank0 actor/normalizer，原状态续训沿用已消费更新；旧 v1 通过外置适配器导入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
2026-11-09 fix: 统一训练来源换行并修正冻结清单哈希
2026-11-10 feat: 统一训练记录并迁移双足历史档案
    将训练平台收敛到 training/records，登记四组双足历史运行及冻结检查点，补充历史迁移与清理脚本、工作台入口和验证文档。
2026-11-10 feat: 更新训练节点标识并补充调研记录
    同步训练工作台与本机环境登记中的节点名称，补充八岐大蛇 V2 无线连接调研及索引。
2026-11-10 fix: 优化检查点回放加载并固化 WSL 环境规则
    - 回放首帧基线 61–81 s；定位为 /mnt/c（DrvFs/9p）导入依赖 42.8–49.6 s，WSL 原生 ext4 仅 8–9 s
    - WSL venv 迁移至 /root/venvs/duck-wsl；工作台与 play-mujoco 改用新路径并保留旧路径回退
    - replay_worker 增加 --idle-timeout（默认 300 s），回放完成后释放 GPU；控制文件按 UTF-8 BOM 容错
    - 训练流程第③步新增环境组装与登记强制规则及验收场景 7，训练记录要求引用环境登记
    - 本机验证：首帧冷 9.1 s、热 4.6–4.8 s；空闲 5 s 超时释放；BOM 控制生效；关闭后 GPU 0 MiB
    - 未改播放吞吐（约 0.37× 实时）与前端显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
2026-11-10 docs: 登记训练环境与启动前探测方案
    - 新增 20261110-训练环境登记 spec：需求、现状证据、每环境 GPU/docker/环境变量探测脚本方案、可用性映射与检查项；未编码。
    - spec 索引补入本任务。
    - 本机训练环境调研补充 4080-16g（公司工作机）现场实测：RTX 4080 16GB、WSL torch CUDA、两台 Spark 的 GB10/docker/env.sh；与 MSI-laptop 记录区分。
    - 训练档案实施记录追加 2026-11-10 工作台重启与历史列表为空的核对。
    未改前端、训练合同与本地连接配置；未启动训练。
2026-11-10 feat: 环境登记、启动自识别与启动前探测
    - 新增 identity.py / environment_probe.py / check_environment_probe.py：平台启动时按 hostname+GPU+WSL 发行版识别当前环境，删除 server.py 中写死的本机回退名；未登记本机显示“未登记主机”并拒绝本机训练。
    - 每个环境生成独立探测脚本到 training/.dashboard/probes/，检查 GPU、docker 与训练镜像、env.sh 变量、benchmark venv、work_root；启动时、每 60 秒、资源卡按钮及训练启动前执行，结果映射到既有资源卡徽章（就绪/不可用/离线）。
    - 环境名称为 desktop-4080-16G 与 laptop-5090-24G；本机连接配置仍在 Git 忽略的 tra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
2026-11-10 chore: 拆分训练工程与训练文档到 duck-robot-training
    - 移出 training/（训练代码、任务、模型、记录与产物归档）以及 8 个训练 spec、5 个训练 reference 专题、real2sim2real 计划与 A/B 训练文档。
    - AGENTS/README/PROGRESS/specs 与 references 索引改为指向新仓 gitee.com/yilv1982/duck-robot-training。
    - 新仓首提交 315f31e；本仓不再保留 training/，硬件、供电、固件与只读参考库未改。
    [ankle_left.stl, ankle_right.stl, banana_pcb_locker.stl, bearing_roll.stl, bottom_head_shell.stl, elec_rpi_robot_hat_pcb.stl, face_part.stl, foot_left.stl]
2026-11-10 chore: Studio 显示资产随训练拆分迁出
2026-11-10 docs: 修正训练拆分后的残留链接
